maledesm/gpr/redaccion/tesis_gpr_fmcw.pdf

## [Universidad]

### [Facultad / Departamento]

### Ingeniería Electrónica / Telecomunicaciones

## Procesamiento de Señales para Radar de Penetración Terrestre (GPR)

### Trabajo Final de Grado

Autor: [Nombre del Autor]

Director: [Nombre del Director]

2025

# Índice general

1. Fundamentos Teóricos | 1
2. Señal IF y Frecuencia de Batido | 4
2.5.2. Predicción teórica de f

∗

3. Arquitectura del Sistema | 12

i

ii | Índice general
4. Banco de Pruebas | 15
5. Caracterización del VCO | 18
6. Generador de Triangular Analógico | 35

Índice general | iii
7. Filtro Pasabajos | 49
7.3. Comparación normalizada: separar el efecto de la ganancia del efecto de la

### 8. Cables de RF: Retardo Eléctrico, Pérdidas y Calibración de Distancia 52

9. Procesamiento de la Señal de Batido | 67

iv | Índice general

Índice general | v
A. Valores de componentes: series comerciales, tolerancias y combinaciones 90
B. La transformada chirp-Z (CZT) — trabajo futuro | 93

vi | Índice general

# Índice de figuras

3.1. Diagrama en bloques del GPR FMCW, versión de un solo canal (alcance
de esta tesis). El PCM1808 es estéreo, así que el camino de hardware para
un segundo canal en cuadratura (mezclador IQ) ya existe y queda como
ampliación posible, sin implementar | 13
3.2. Principio de funcionamiento del FMCW para un blanco estático, sin efecto Doppler (script docs/principio_fmcw.py). Los valores de τ , Tm y B usados en la figura son adimensionales y se eligieron para que el dibujo se
lea bien, no para representar las magnitudes reales del sistema: en el radar real, τ/Tm es del orden de 10⁻⁷ para un blanco a 1 m, y a esa escala la

señal recibida se superpondría visualmente por completo a la transmitida. . 14

4.1. Primer banco de la cadena de RF: VCO, amplificador, atenuador y splitter
interconectados sobre una plaqueta de prueba rotulada a mano | 15
4.2. Banco de mediciones: fuente DC, generador de funciones, cadena de RF y
notebook con el software de análisis | 16
4.3. Banco de mediciones, vista general del puesto de trabajo | 17
5.1. Curva de sintonía medida del VCO: frecuencia de salida en función de la tensión de control Vin (antes del mapeo a la tensión real de sintonía Vosc, más alta, que entrega el amplificador que ataca al VCO). El rango sombreado indica los 0–3,00 V que efectivamente se usan para generar la rampa del
radar | 18
5.2. Linealización del barrido del VCO mediante predistorsión (script VCO/analisis_vco.py). Arriba: curva de sintonía medida con ajuste PCHIP (izq.) y sensibilidad
dF/dV punto a punto sin suavizar (der.). Abajo: rampa de tensión del DAC
con y sin predistorsión (izq.) y frecuencia resultante en función del tiempo
normalizado, comparada con la recta ideal (der.) | 21

vii

viii | Índice de figuras
5.3. Salida del DAC MCP4725 (rampa de sintonía del VCO), con y sin predistorsión, a PRF de 50 ms y 5 ms. Se indica el desvío RMS de cada rampa
respecto de la recta ideal | 22
5.4. Pantalla del analizador de espectro (Siglent SSA3032X, Max Hold, 0,8 a
3 GHz, RBW 1 MHz) con el VCO barrido por la triangular. De ∼ 1 a
∼2 GHz está la fundamental, el barrido útil del radar. A partir de ∼2 GHz aparece el segundo armónico, unos 8 dB por debajo. Medición del 2026-11-02. 24
5.5. Las tres trazas exportadas del analizador. En azul, la captura más llena.
Se marcan la banda de la fundamental, la del segundo armónico y la franja
de 15 MHz en la que se superponen. Las líneas punteadas son los extremos
que predice la curva estática del VCO para la triangular medida con el
osciloscopio | 25
5.6. (a) Frecuencia instantánea de la fundamental y de los armónicos 2 y 3 a lo largo de un período de la triangular, con la banda medida en Max Hold.
Es esquemática (barrido dibujado lineal entre los extremos medidos). En trazo grueso, el tramo cercano a los vértices de abajo donde el segundo armónico cae dentro de la banda útil. (b) Lo que llega a banda base para
la placa a 1 m: el batido y sus fantasmas en 2fb y 3fb. Niveles estimados
con una simulación del radar completo (mezclador multiplicador, segundo
armónico del Max Hold, tercero supuesto a −15 dBc) | 29
6.1. Estructura del generador. El oscilador entrega una triangular de 3,06 Vpp centrada en la referencia de 6 V; el restador la baja al rango 0–3 V que pide el VCO; el zener D1 protege al VCO ante una falla y el buffer de sync reduce la cuadrada del comparador a un nivel que tolera el ESP32-C3. Todo
el circuito se alimenta de una única rama de 12 V | 37
6.2. Esquemático completo (GPRv2/docs/PWM/pcb/triangular.kicad_sch). Las cinco unidades usadas se reparten entre dos TLC2274: U1 lleva el oscilador
y el sync, U2 la referencia y el restador. Las tres unidades sobrantes (U1D,
U2C y U2D) quedan como seguidores con la entrada no inversora a masa. . 37
6.3. Salida y sincronismo del generador con el modelo real del TLC2272, en tres
posiciones del potenciómetro (script GPRv2/docs/PWM/simulacion/graficar_triangular3.py). Izquierda: la triangular de salida junto con la cuadrada de sync, con los niveles extremos indicados. Derecha: el espectro de dos lados de la salida
—cada raya es un armónico, y la del centro es la componente continua—
comparado con la envolvente 1/f ² que corresponde a los armónicos impares
de una triangular ideal | 42

Índice de figuras | ix
6.4. Efecto de cada zener sobre la operación normal (scripts GPRv2/docs/PWM/simulacion/simular_zener.py y graficar_zener.py). Izquierda: el vértice superior de la triangular sin
zener, con el 1N4729A y con el 1N4728A. Derecha: la curva de conducción
inversa de los dos modelos, con la corriente que toma cada uno al pico de
la triangular | 44
6.5. Falla simulada: R9 abierta. Sin zener la salida se va a 10,06 V, con lo que
el amplificador satura contra sus 20 V de alimentación y el VCO queda 2 V
por encima de su máximo. Con el 1N4729A la salida se clava en 3,31 V,
que corresponden a 16,4 V en el VCO | 45
6.6. Placa del generador, 93 × 63 mm, una sola capa. Las dos vistas están en la misma orientación, mirando desde el lado de los componentes. En el cobre,
el negro es cobre y el blanco es el aislamiento: casi toda la superficie libre
es plano de masa | 46
6.7. Vista tridimensional de la placa (kicad-cli pcb render). Faltan los modelos 3D de la llave de encendido SW1 y del puente de cable JP1, cuyas huellas se dibujaron para este proyecto; el resto de los componentes se
muestra completo | 46
7.1. Respuesta en frecuencia del filtro activo, barrido senoidal con Vin = 3,11 Vpp,
en las dos posiciones del potenciómetro de ganancia. Arriba: respuesta absoluta, con las frecuencias de corte indicadas; el trazo se vuelve punteado
a partir de la zona con distorsión. Abajo: diferencia entre ambas curvas
normalizadas a su propia banda de paso | 50
8.1. Los dos caminos que llegan al mezclador. El del LO es corto y fijo —en este banco, una conexión directa de ≈ 5 cm—; el de RF incluye los cables
a las antenas más el trayecto por el aire. El mezclador solo puede medir la diferencia de retardo entre ambos, no el retardo absoluto de ninguno. . . . 53
8.2. Pérdida de inserción medida con el VNA. Izquierda: pérdida total |S21| tal como se mide, cable más sus dos conectores; el rizado fino es la interferencia entre los dos conectores. Derecha: atenuación por metro ajustada como a

√
f
por el origen, con los valores de catálogo superpuestos en punteado. Los
dos RG-213 y el RG-58 de 3 m caen sobre sus referencias de catálogo; el RG-58 de 2,6 m queda al doble y, a la izquierda, se curva hacia abajo en
vez de seguir la raíz | 59

x | Índice de figuras
8.3. Pérdida de retorno. Izquierda: |S11| en todo el barrido, con la escala de VSWR equivalente a la derecha y la banda del radar sombreada. Derecha: zoom de 1400 a 1600 MHz. El rizado no es ruido: es la interferencia entre
las reflexiones de los dos conectores, y su período vale ∆f = 1/(2τ ), con τ
el retardo medido de la fase. A cable más largo, rizado más apretado. . . . 60
8.4. Izquierda: respuesta al impulso de S11 complejo, en dB respecto del pico mayor. Cada pico es una reflexión, ubicada en su tiempo de ida y vuelta;
el triángulo marca 2τ tomado de la pendiente de fase de S21, y coincide con el eco del extremo en los cuatro cables. El RG-58 de 2,6 m (naranja) muestra además un pico a mitad de camino, en 12,6 ns. Derecha: retardo
de una vía contra el largo nominal. Los símbolos llenos son la pendiente de fase y los huecos, el rizado de |S11|; la recta es el VF 0,66 de catálogo. . . . 61
8.5. Lo que el cableado le cuesta al radar. Izquierda: offset de distancia doffset =
D/(2 VF) con el VF 0,66 de catálogo, según el coaxil neto D, con los dos juegos de cables marcados. Derecha: pérdida de un par de cables (TX más
RX) en el centro de la banda, 1462 MHz, en función del largo de cada uno,
con la atenuación por metro medida en cada cable. La recta del RG-58 de
2,6 m es la del cable dañado (Sección 8.6.5), no la de un RG-58 | 63
9.1. Cadena de procesamiento completa. En naranja lo que corre en la placa; en azul lo que corre en la PC. A la derecha de cada bloque, la sección donde
se describe | 69
9.2. Diezmado ×8 en tres etapas de semibanda. Cada etapa elimina todo lo que
se plegaría en la división por dos siguiente | 71
9.3. Sincronismo reconstruido. Los puntos son las lecturas de la triangular (sólo
∼ 19 por período); el triángulo continuo es el modelo ajustado, del que salen
los límites de rampa. Cada rampa de batido de 300 muestras se procesa
por separado, y las bajadas se invierten en el tiempo | 75
9.4. Coherente contra incoherente, en un bin con blanco (arriba) y en un bin
de ruido (abajo). En azul la señal de cada rampa; en rojo el ruido. En el promedio coherente el ruido se cancela parcialmente y el piso baja; en el incoherente las magnitudes son siempre positivas y el piso queda donde
estaba | 81
9.5. Espectro de una fila de N = 8 rampas con un blanco débil en 498 Hz (SNR
de −12 dB por muestra en cada rampa), según el criterio de promedio. La línea roja es el piso medio. Una realización; los valores de los títulos varían
entre corridas | 82

Índice de figuras | xi
9.6. Piso de ruido en función de la cantidad de rampas promediadas, sobre
300 realizaciones de ruido puro. Izquierda: nivel medio, referido al de una
rampa. Derecha: desvío del piso en dB a lo largo del espectro | 83
9.7. Formación de las filas del radargrama a partir de los perfiles de cada rampa.
En azul las subidas, en verde las bajadas invertidas; cada fila mezcla las dos. 84
9.8. Captura de vivo_rapido.py con una placa metálica a 90 cm, fondo conge-
lado, N = 8 rampas por fila (28/09/2026) | 88

# Índice de cuadros

1.1. Parámetros principales del sistema FMCW GPR (valores de referencia to-
mados de Huang2022) | | 2
1.2. Permitividad relativa de materiales constructivos típicos | | 3
2.1. Frecuencia de batido teórica f

∗
en aire libre (B = 1 GHz) para tres períodos de triangular. Recordar que Tc es el período completo: cada rampa dura
Tc/2 | 9
5.1. Caracterización medida del VCO: tensión de entrada Vin y frecuencia de
salida, 34 puntos cada 100 mV | 19
5.2. Predistorsión de la rampa contra remuestreo de la señal | 23
5.3. Lo medido en la salida del VCO en Max Hold (2026-11-02) | 25
5.4. Atenuación mínima del filtro en 2f, según la ecuación (5.13), con H2 =
−8 dBc | 32
5.5. Lo que se cuela por el borde de la rampa, según la frecuencia fs en la que
el filtro alcanza su atenuación. Banda medida, 988 a 1991 MHz. La cuarta
y la quinta columna son el nivel de esa parte del fantasma respecto del pico
del blanco | 33
6.1. Período en función de la posición del potenciómetro: la ecuación (6.2) contra la simulación del circuito completo con el modelo real del operacional. . 38
6.2. Candidatos considerados para los cinco operacionales | 40
6.3. Densidad de ruido de tensión de entrada de los modelos SPICE, en nV/

√
Hz,
comparada con el ruido térmico de las resistencias del lazo | 40
6.4. Períodos, niveles y contenido armónico simulados, en las tres posiciones del
potenciómetro | 43

xii

Índice de cuadros | xiii
7.1. Parámetros medidos del filtro activo en las dos posiciones del potenciómetro de ganancia (banda de paso: mediana entre 200 y 1750 Hz, puntos sin
distorsión) | 50
8.1. Factor de velocidad nominal según el dieléctrico del cable coaxil (valores de catálogo típicos). Los medidos en los cables del banco están en la Tabla 8.5. 54
8.2. Frecuencia de batido esperada para un blanco a d = 1 m, con y sin el aporte de los cables originales (D = 5,55 m, VF = 0,66). doffset = 4,20 m es constante; lo que cambia con Tc es a cuántos Hz equivale. La fila de 100 ms
es el Tc con el que mide el banco: 50 ms de subida y 50 de bajada | 55
8.3. Offset de distancia esperado con los cables nuevos (LTX = LRX = 1 m,
VF = 0,66 nominal) según la longitud que se elija para el cable al LO. . . . 57
8.4. Atenuación medida y de catálogo en la banda del radar. Los dos RG-213 difieren entre sí un 8 % y quedan a menos de un 15 % del catálogo con los conectores incluidos. El cable de 2,6 m atenúa el doble que su gemelo de
3 m, siendo el mismo tipo de cable | 59
8.5. Retardo medido de la pendiente de fase de S21. Las columnas de L y VF son
dos lecturas del mismo dato: fijando el VF de catálogo se despeja el largo eléctrico, y fijando el largo nominal se despeja el VF. La última columna
es el desvío rms de la fase respecto de un retardo puro | 61
8.6. Resumen comparativo entre el valor teórico (predicho por las ecuaciones
de este capítulo, a partir de las longitudes nominales y el VF de catálogo)
y el valor medido con el VNA a partir de la fase de S21, para ambos juegos
de cables | 64
9.1. Parámetros de la cadena de procesamiento en el banco de laboratorio (generador con Tc = 100 ms). Los valores medidos salen del encabezado de la
captura de la placa a 90 cm del 28/09/2026 | 68
9.2. Atenuación de los tonos que se pliegan sobre cada frecuencia de la salida,
a 48 kHz con M = 8 | 71
9.3. Etapas del procesamiento, con su ecuación y su implementación | 89

A.1. Rango que puede cubrir la salida del generador según la tolerancia de los resistores. El Monte Carlo (200 000 muestras, distribución uniforme dentro
de la banda) es lo que cabe esperar al armar placas; el peor caso recorre
las 2

12 esquinas y es la cota que no se puede superar. El valor nominal es

0,030 a 3,094 V | 91

xiv | Índice de cuadros

A.2. Desplazamiento del extremo superior de la salida por un error del 1 % en
cada resistencia, de a una por vez | 91
A.3. Valores que no existen en la serie E12 y cómo se armaron | 92
B.1. Parámetros de la CZT y su cálculo desde fstart, fend y fs | 95
B.2. Cálculo de los parámetros CZT para el ejemplo de referencia | 96

B.3. Resolución CZT para distintos valores de M (rango de zoom de 12 Hz). . . 96

B.4. Resumen del flujo de procesamiento GPR FMCW con CZT, propuesto para
cuando se implemente | 97

# Capítulo 1

# Fundamentos Teóricos

## 1.1. Principios de operación del GPR

El GPR es un sistema de teledetección electromagnética que emite energía de radiofrecuencia hacia el subsuelo y registra las reflexiones producidas en las interfases entre materiales de distinta permitividad eléctrica εr. La profundidad de penetración y la resolución en rango dependen de la frecuencia central y el ancho de banda del sistema.

### 1.1.1. Configuraciones de operación

Los radares GPR pueden clasificarse según su forma de modulación:

GPR de impulso: emite pulsos muy cortos de banda ultra ancha (UWB). Resolución en rango determinada por el ancho del pulso.

SFCW (Stepped-Frequency Continuous-Wave): barre el espectro en pasos discretos de frecuencia.

FMCW (Frequency-Modulated Continuous-Wave): barre el espectro de forma continua y lineal (chirp).

## 1.2. Sistema FMCW: parámetros fundamentales

Un sistema FMCW emite una señal cuya frecuencia instantánea varía linealmente en el tiempo, denominada chirp. Los parámetros principales se resumen en la Tabla 1.1.

1

2 | Capítulo 1. Fundamentos Teóricos

Cuadro 1.1: Parámetros principales del sistema FMCW GPR (valores de referencia tomados de Huang2022).

Símbolo Nombre | Definición | Valor de ref.
Tc | Período del chirp | — | 0,3 s
B | Ancho de banda | fmax − fmin | 1 GHz
fc | Frecuencia central | (fmax + fmin)/2 | 1,5 GHz
S | Tasa de barrido | B/Tc (diente de sierra) 3,33 GHz/s
c | Velocidad de la luz | — | 3 × 10⁸ m/s
εr | Permitividad relativa — | Dep. del material

La frecuencia instantánea transmitida es:

ftx(t) = fc −

B
2
+ S t, | 0 ≤ t ≤ Tc. | (1.1)

Advertencia sobre la convención de S y Tc. La ecuación (1.1) y la Tabla 1.1 corresponden a un chirp de diente de sierra, que es la modulación del sistema de referencia Huang2022: la frecuencia recorre todo el ancho de banda B en el período completo Tc, y por lo tanto S = B/Tc.

El sistema desarrollado en esta tesis usa en cambio modulación triangular, y mantiene a Tc como el período completo de la triangular. Cada rampa dura entonces Tc/2 y la tasa de barrido es el doble: S = 2B/Tc (se deduce en la ecuación (2.2)). De acá en adelante rige esa convención, y todas las expresiones del Capítulo 2 están escritas con ella. Es la fuente de error más fácil al comparar contra la bibliografía: un factor 2 en la frecuencia de batido y en el espesor estimado.

## 1.3. Propagación en medios estratificados

La velocidad de propagación de la onda electromagnética en un medio con permitividad relativa εr es:

v =

c
√
εr
. | (1.2)

Para los materiales de mayor interés práctico se indican valores típicos de εr en la Tabla 1.2.

1.3. Propagación en medios estratificados | 3

Cuadro 1.2: Permitividad relativa de materiales constructivos típicos.

Material | εr

√εr

Aire | 1,0 | 1,000
Asfalto seco | 4 − 7 | 2,00 − 2,65
Asfalto húmedo | 6 − 9 | 2,45 − 3,00
Concreto | 8 − 12 2,83 − 3,46
Pared (cemento) | 5 − 6 | 2,24 − 2,45
Hielo | 3,2 | 1,79

# Capítulo 2

# Señal IF y Frecuencia de Batido

## 2.1. Señal transmitida y frecuencia instantánea

La señal transmitida es un coseno cuya fase instantánea ϕ(t) está determinada por la frecuencia instantánea f(t):

stx(t) = A cos
ϕ(t)
, ϕ(t) = 2π

Z t

0

f(t

′

) dt′
. | (2.1)

En el radar FMCW con modulación triangular, la frecuencia instantánea varía linealmente en forma de diente triangular: asciende de fc − B/2 a fc + B/2 durante el primer semiperíodo Tc/2, y desciende simétricamente durante el segundo. La tasa de barrido (en módulo) es la misma en ambas ramas:

S =

B
Tc/2

=

2B
Tc
. | (2.2)

La frecuencia instantánea es, por tanto:

f(t) =

fc −

B
2
+ S t, | 0 ≤ t ≤

Tc
2

,

fc +

B
2

− S

t −

Tc
2
,
| Tc
| 2 < t ≤ Tc.

(2.3)

Dado que las dos ramas son simétricas y producen la misma frecuencia de batido (véase la Sección 2.4), el desarrollo analítico se realiza sobre la rampa ascendente (0 ≤ t ≤ Tc/2); los resultados son directamente aplicables a la rampa descendente por simetría.

Sustituyendo la rama ascendente de (2.3) en (2.1):

4

2.2. Señal recibida | 5

ϕ(t) = 2π

Z t

0

fc −

B
2

+ S t′

dt′ = 2π

fc −

B
2
t +

S
2

t

2

. | (2.4)

La señal transmitida durante la rampa ascendente es, entonces:

stx(t) = A cos
2π

fc −

B
2
t +

B
Tc

t

2

, 0 ≤ t ≤

Tc
2
. | (2.5)

Esta expresión muestra que la señal es un chirp lineal que parte de la frecuencia fc − B/2 y llega a fc + B/2 al cabo del semiperíodo.

## 2.2. Señal recibida

Un obstáculo ubicado a distancia d del radar produce una señal reflejada con retardo τd = 2d/c, donde c es la velocidad de propagación en el medio. Durante la rampa ascendente, la señal recibida es una réplica de (2.5) retrasada τd segundos. Definiendo τd ≪ Tc/2 (condición habitualmente satisfecha en GPR), la señal recibida válida en el intervalo τd ≤ t ≤ Tc/2 es:

Γ(t) = A

′

cos
2π

fc −

B
2

(t − τd) + B
Tc

(t − τd)

2

− θ
, | (2.6)

donde A′ absorbe la atenuación de propagación y θ una fase inicial arbitraria. La señal (2.6)

es estructuralmente idéntica a stx(t), pero con el argumento temporal desplazado por τd = 2d/c.

## 2.3. Proceso de desrampa (dechirp / mixing)

Al multiplicar stx(t) (ec. (2.5)) por Γ(t) (ec. (2.6)) y aplicar un filtro pasa-bajos, se obtiene la señal IF o señal de batido. Usando la identidad trigonométrica:

cos x · cos y =

1/2 h
cos(x − y) + cos(x + y)

i
, | (2.7)

el producto stx(t) · Γ(t) genera dos términos: uno de diferencia de fases (baja frecuencia, conservado por el filtro pasa-bajos) y uno de suma (alta frecuencia, eliminado). Definiendo τd = 2d/c por brevedad, las fases instantáneas son:

6 | Capítulo 2. Señal IF y Frecuencia de Batido

ψtx(t) = 2π

## hfc −

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
, | (2.8)

ψrx(t) = 2π

## hfc −

B
2
(t − τd) + B
Tc

(t − τd)

2

i
− θ. | (2.9)

El término de diferencia, tras el filtrado pasa-bajos, es:

x

′
(t) = A

∗

cosh
ψtx(t) − ψrx(t)

i
. | (2.10)

Calculando la diferencia de fases:

ψtx − ψrx = 2π

fc −

B
2
τd +

2πB
Tc

h
t

2 − (t − τd)

2

i
+ θ. | (2.11)

Desarrollando el binomio (t − τd)

2 = t

2 − 2τdt + τ

2
d

:

t

2 − (t − τd)

2 = 2τd t − τ

2
d
, | (2.12)

con lo que:

ψtx − ψrx = 2π

fc −

B
2
τd +

2B
Tc

τd t −

B
Tc

τ

2
d
+ θ. | (2.13)

La señal IF resultante es, por tanto:

x

′
(t) = A

∗

cos
2π

2B
Tc

τd t + 2π

fc −

B
2
τd −

2πB
Tc

τ

2
d − θ
, τd ≤ t ≤

Tc
2

. (2.14)

## 2.4. Frecuencia de batido

Identificando en (2.14) el coeficiente lineal en t, la frecuencia de batido de la rampa ascendente es:

f

+
b =

2B
Tc

τd =

2B
Tc

·

2d
c

=

4Bd
c Tc
. | (2.15)

Los términos restantes de (2.14) son puramente de fase (constantes respecto de t); agrupándolos en φ

∗
:

2.5. Prueba de validación con reflector metálico | 7

φ

∗ = 2π

fc −

B
2
τd −

2πB
Tc

τ

2
d + θ, | (2.16)

la señal IF adopta la forma compacta de tono sinusoidal puro:

x

′
(t) = A

∗

cos
2πf ⁺
b

t + φ

∗

, τd ≤ t ≤

Tc
2
. | (2.17)

### Rampa descendente: simetría del resultado

Durante la rampa descendente la tasa de barrido es −S = −2B/Tc. Repitiendo el mismo desarrollo con f(t) = fc + B/2−S(t−Tc/2) se obtiene una frecuencia de batido f

−
b = f

+
b
(el signo de S cancela con el cambio de signo del retardo relativo). En consecuencia, ambas ramas producen la misma frecuencia de batido en módulo:

f

∗ = f
+
b = f

−
b =

4Bd
c Tc
. | (2.18)

Cada semiperíodo puede procesarse de forma independiente con la FFT, y los espectros resultantes son equivalentes. En la práctica se puede promediar la magnitud de ambos para mejorar la relación señal a ruido. El signo negativo del coeficiente lineal en la rampa descendente no altera la frecuencia observable: para una señal real, cos(−2πf0t) y cos(2πf0t) producen el mismo pico espectral en |f0|. La diferencia de signo se absorbe en la fase inicial y no afecta la estimación de distancia.

## 2.5. Prueba de validación con reflector metálico

Antes de abordar escenarios con múltiples capas y materiales de permitividad desconocida, resulta conveniente realizar una prueba de validación en condiciones controladas. El caso más simple consiste en apuntar el radar a una plancha metálica plana ubicada a una distancia d conocida en aire libre.

### 2.5.1. Por qué es un caso ideal

Un metal conductor actúa como un reflector casi perfecto: su coeficiente de reflexión en módulo es |Γ| ≈ 1. Esto implica tres ventajas para la validación:

1. Reflexión única. Solo existe una interfase (aire–metal), por lo que la señal IF contiene una única frecuencia de batido f

∗
, sin ambigüedad.

8 | Capítulo 2. Señal IF y Frecuencia de Batido
2. Sin incertidumbre en εr. La propagación ocurre íntegramente en aire (εr = 1,
| cmedio = c), eliminando una variable desconocida.
3. Resultado verificable a priori. Conocida d, el valor teórico de f

∗
se puede
calcular antes de la medición y comparar directamente con el pico observado en el espectro.

### 2.5.2. Predicción teórica de f

∗

En aire libre (εr = 1), la ecuación (2.18) se simplifica a:

f

∗ =

4Bd
c Tc
, | (2.19)

e inversamente, la distancia estimada a partir de la frecuencia medida ˆf
∗
es:

ˆd =

c Tc

ˆf
∗
4B
. | (2.20)

El error absoluto de distancia queda:

∆d =

ˆd − d

. | (2.21)

### 2.5.3. Parámetros del sistema y frecuencias esperadas

El sistema opera con B = 1 GHz (barrido de 1 GHz a 2 GHz). El período de la triangular Tc, en cambio, no es un valor fijo del sistema: es un parámetro de la medición, que se ajusta según la profundidad de interés y las condiciones del ensayo, y que el firmware configura por consola. La constante del radar es, por lo tanto, función de Tc:

f

∗
d

=

4B
c Tc

=

4 × 10⁹
3 × 10⁸ Tc

=

13,3
Tc
[Hz/m], | Tc en segundos. | (2.22)

La Tabla 2.1 evalúa esa constante para tres valores representativos de Tc y para distancias típicas de un banco de prueba en interiores.

2.5. Prueba de validación con reflector metálico | 9

Cuadro 2.1: Frecuencia de batido teórica f

∗
en aire libre (B = 1 GHz) para tres períodos de triangular. Recordar que Tc es el período completo: cada rampa dura Tc/2.

f

∗
[Hz]

d [m] Tc = 10 ms Tc = 50 ms Tc = 300 ms

0,10 | 133 | 27 | 4,4
0,20 | 267 | 53 | 8,9
0,50 | 667 | 133 | 22,2
1,00 | 1333 | 267 | 44,4

Dos condiciones acotan la elección de Tc, una por arriba y otra por abajo:

Barridos lentos (Tc grande). La señal de batido tiene que quedar por encima del pasa-altos no desactivable del ADC PCM1808, cuyo corte combinado es de ≈ 1,2 Hz. Ya con Tc = 300 ms un blanco a 0,10 m cae en 4,4 Hz, sobre el faldón del filtro; con barridos de segundos el blanco cercano se pierde adentro del filtro y su fase queda distorsionada.

Barridos rápidos (Tc chico). Hace falta fs > 2f

∗
(Nyquist). Con Tc = 10 ms
y fs = 48 kHz el alcance máximo sin aliasing es de 18 m. Pero la señal no sale a 48 kHz: se diezma a 6000 sps, con banda limpia hasta 2400 Hz (Sección 9.2). A Tc = 10 ms eso son apenas 1,7 m aparentes, menos que el offset de los propios cables (Capítulo 8). Además, el sincronismo por software, que se reconstruye leyendo la triangular, no funciona por debajo de Tc ≈ 12 ms (Sección 9.3). Por eso el banco trabaja con Tc = 100 ms.

### 2.5.4. Procedimiento experimental propuesto

1. Colocar la antena del radar frente a la plancha metálica, con separación d medida con cinta métrica.
2. Verificar que no haya otros objetos reflectores en el campo de visión del radar (paredes, mesas, superficies metálicas laterales) para evitar reflexiones espurias.
3. Adquirir la señal IF durante al menos un período completo de la triangular Tc, muestreando a fs > 2f

∗
4. Calcular f

∗
teo con la ecuación (2.19) usando la d medida.
5. Aplicar la FFT sobre las muestras adquiridas e identificar el pico de mayor amplitud.
6. Calcular ˆd con la ecuación (2.20) y obtener ∆d con la ecuación (2.21).

10 | Capítulo 2. Señal IF y Frecuencia de Batido

### 2.5.5. Criterio de éxito

La resolución en rango teórica del sistema, determinada por el ancho de banda, es:

δd =

c
2B

=

3 × 10⁸
2 × 10⁹
= 0,15 m. | (2.23)

La prueba se considera exitosa si:

∆d < δd = 15 cm. | (2.24)

Aplicado sobre la ˆd cruda, este criterio falla por varios metros en el banco: los cables

coaxiles suman un retardo constante que la ecuación (2.19) no contempla. El Capítulo 8 deduce ese término, lo mide y muestra cómo se calibra. El criterio se aplica sobre la distancia ya calibrada.

## 2.6. Las dos reflexiones y el espesor de capa

Para una capa de material con espesor h y permitividad εr, existen dos reflexiones:

R1: reflexión en la superficie superior → retardo τ1 → frecuencia IF f1 = S τ1.

R2: reflexión en la superficie inferior → retardo τ2 → frecuencia IF f2 = S τ2.

El tiempo extra que tarda la onda en atravesar la capa (ida y vuelta) es:

τextra =

2h

√
εr
c
. | (2.25)

Combinando con fIF = S τ y la tasa de barrido de la triangular, S = 2B/Tc (ec. (2.2)):

∆f = f2 − f1 =

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
4B h√
εr
Tc c
. | (2.26)

Despejando h:

h =

Tc ∆f · c
4

√
εr · B

(2.27)

2.6. Las dos reflexiones y el espesor de capa | 11

### 2.6.1. Ejemplo numérico

Para Tc = 0,3 s, B = 1 GHz, un asfalto húmedo (√ | εr = 2,449) y un valor ∆f = 4,00 Hz

(valor de ejemplo):

h =

0,3 × 4,0 × 3 × 10⁸
4 × 2,449 × 1 × 10⁹

≈ 36,7 mm.

### 2.6.2. Corrección por separación de antenas

Cuando las antenas Tx y Rx están separadas una distancia D, la corrección geométrica es:

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
, | (2.28)

donde L es la distancia total dentro del material calculada con la ecuación (2.27). Si D = 0 se recupera h = L/2.

# Capítulo 3

# Arquitectura del Sistema

Antes de describir el banco de pruebas físico (Capítulo 4), se presenta la arquitectura completa del sistema implementado y se repasa, sobre un caso concreto de blanco estático, cómo los principios expuestos en el Capítulo 2 se traducen en la señal que efectivamente entrega el mezclador.

## 3.1. Diagrama en bloques

La Figura 3.1 resume la cadena completa, de un solo canal, que es el alcance de esta tesis.

La rampa de sintonía es una triangular de 0 a 3 V generada fuera del microcontrolador: hoy, un generador de funciones de laboratorio (Siglent SDG830); más adelante, la placa del generador analógico del Capítulo 6. En una primera versión la rampa la generaba el propio ESP32-C3 con un DAC MCP4725 por I²C, con una tabla de predistorsión para linearizar el VCO (Secciones 5.3 y 5.4). Esa solución se abandonó. La no linealidad del VCO se corrige ahora en el procesamiento (Sección 9.5).

El ESP32-C3 digitaliza la señal de batido por I²S, desde el PCM1808, y además lee la triangular por una entrada analógica (GPIO3, a través de un divisor ÷2). Con esas lecturas la PC reconstruye por software el sincronismo entre el barrido y el muestreo: el período y la fase de la triangular, y con ellos dónde empieza cada rampa (Sección 9.3). No hace falta una señal de sincronismo del generador.

En la rama de transmisión, la triangular se amplifica, sintoniza el VCO (banda 1–2 GHz), se atenúa 3 dB y se divide en un splitter: una salida excita la antena transmisora y la otra actúa como oscilador local (LO) del mezclador. En la rama de recepción, el eco captado por la antena receptora se amplifica con un LNA y se mezcla con el LO. El mezclador entrega, además de la señal de batido fbeat buscada, un término de suma en torno a 2fc

12

3.2. Principio de funcionamiento: FMCW sin efecto Doppler | 13

(varios GHz); el pasa-bajos que sigue rechaza ese término de suma¹ y la señal resultante

se digitaliza en el PCM1808.

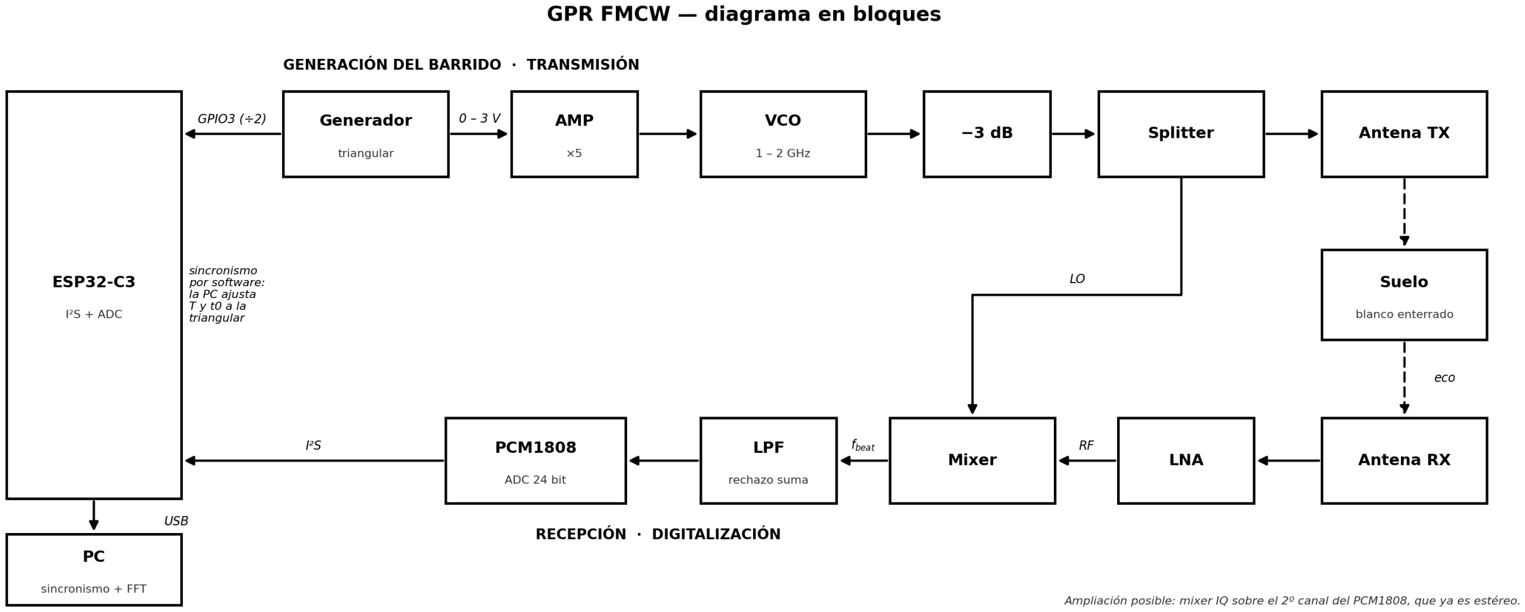
[picture p13: figure]

Figura 3.1: Diagrama en bloques del GPR FMCW, versión de un solo canal (alcance de esta tesis). El PCM1808 es estéreo, así que el camino de hardware para un segundo canal en cuadratura (mezclador IQ) ya existe y queda como ampliación posible, sin implementar.

## 3.2. Principio de funcionamiento: FMCW sin efecto

## Doppler

El GPR no se desplaza respecto del suelo durante una medición, por lo que, a diferencia del radar automotriz, no hay efecto Doppler que desplace en frecuencia la señal recibida. Como se estableció en la Sección 2.4, esto tiene una consecuencia directa: las ramas ascendente y descendente de la triangular producen la misma frecuencia de batido, así que una sola rampa alcanza para estimar distancia (no hace falta la asimetría subida/bajada que en radar automotriz se usa para despejar velocidad).

La Figura 3.2 ilustra este principio en tres paneles alineados en el tiempo: (a) la frecuencia instantánea transmitida y recibida, con el retardo τ y la frecuencia de batido fbeat marcados; (b) la diferencia de frecuencias entre ambas señales, mostrando que vale lo mismo en el tramo de subida que en el de bajada; y (c) la tensión a la salida del mezclador, que oscila a fbeat salvo en los vértices de la triangular, donde el retardo hace que ftx y frx crucen y la diferencia caiga momentáneamente a cero.

1No debe confundirse con el filtro antialiasing del muestreo: ese ya está resuelto internamente por

el PCM1808 (filtro analógico interno a 1,3 MHz más el sobremuestreo 64× de su modulador ∆Σ), ver docs/PCM1808_hardware.md.

14 | Capítulo 3. Arquitectura del Sistema


Figura 3.2: Principio de funcionamiento del FMCW para un blanco estático, sin efecto Doppler (script docs/principio_fmcw.py). Los valores de τ , Tm y B usados en la figura son adimensionales y se eligieron para que el dibujo se lea bien, no para representar las magnitudes reales del sistema: en el radar real, τ/Tm es del orden de 10⁻⁷ para un blanco a 1 m, y a esa escala la señal recibida se superpondría visualmente por completo a la transmitida.

# Capítulo 4

# Banco de Pruebas

## 4.1. Cadena de RF

La Figura 4.1 muestra la primera versión armada de la cadena de RF sobre una plaqueta de prueba, con los bloques rotulados a mano: VCO, amplificador, atenuador, splitter y la etapa de mezcla hacia la antena transmisora.


Figura 4.1: Primer banco de la cadena de RF: VCO, amplificador, atenuador y splitter interconectados sobre una plaqueta de prueba rotulada a mano.

15

16 | Capítulo 4. Banco de Pruebas

## 4.2. Banco de mediciones

Las Figuras 4.2 y 4.3 muestran el banco completo de mediciones: fuente DC, generador de funciones, la cadena de RF de la Figura 4.1 y la notebook corriendo el software de adquisición/análisis (el trazo verde es la señal capturada y el azul su espectro).

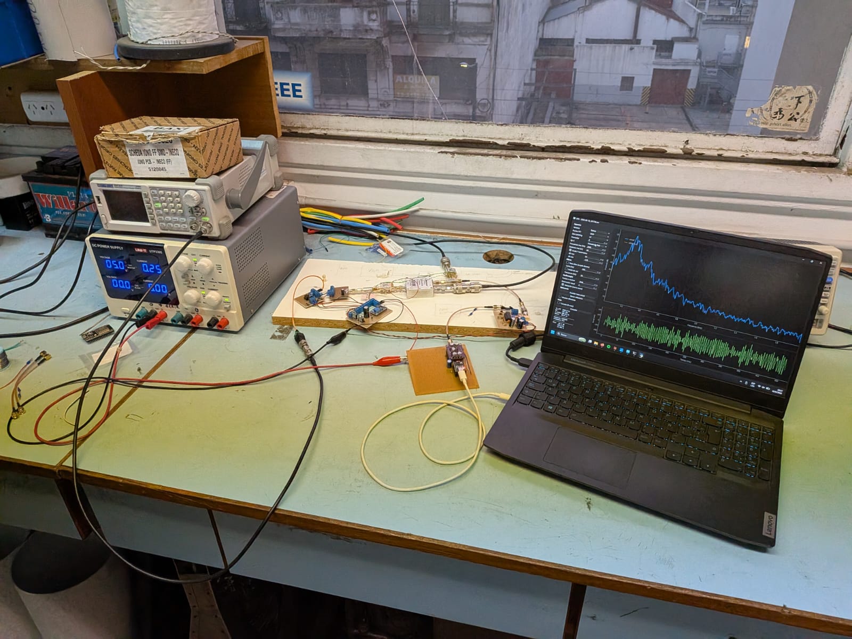
[picture p14: figure]

Figura 4.2: Banco de mediciones: fuente DC, generador de funciones, cadena de RF y notebook con el software de análisis.

4.2. Banco de mediciones | 17

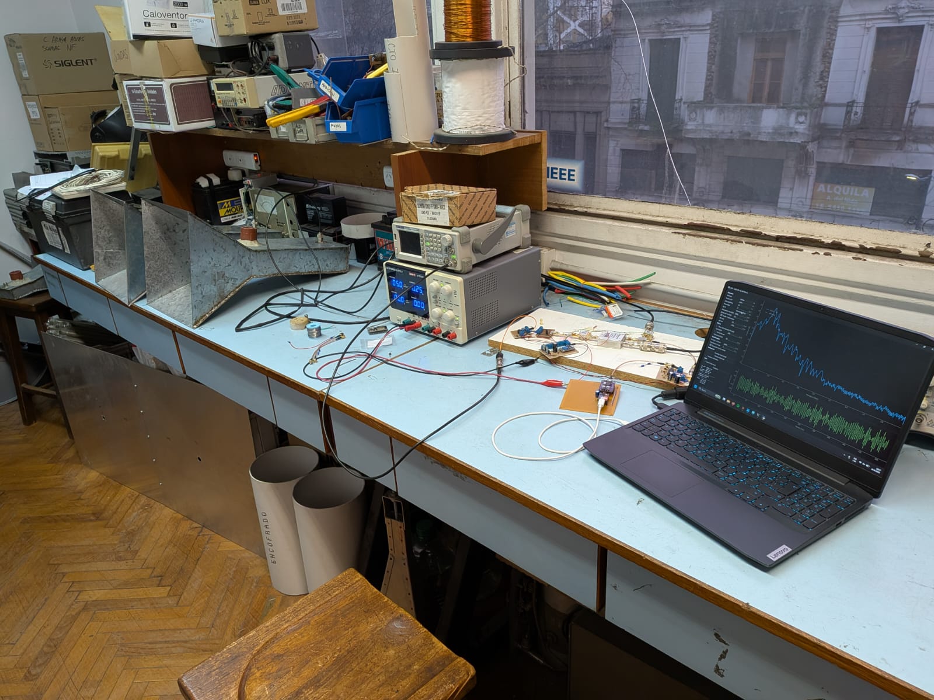
[picture p15: figure]

Figura 4.3: Banco de mediciones, vista general del puesto de trabajo.

# Capítulo 5

# Caracterización del VCO

## 5.1. Curva de sintonía del VCO

El VCO se caracterizó punto a punto, barriendo la tensión de control Vin de 0 a 3,321 V en pasos de 100 mV (34 puntos) y midiendo la frecuencia de salida con un analizador de espectro (precisión de 1 MHz). La Figura 5.1 muestra la curva resultante junto con la sensibilidad dF/dV .


Figura 5.1: Curva de sintonía medida del VCO: frecuencia de salida en función de la tensión de control Vin (antes del mapeo a la tensión real de sintonía Vosc, más alta, que entrega el amplificador que ataca al VCO). El rango sombreado indica los 0–3,00 V que efectivamente se usan para generar la rampa del radar.

En el rango medido completo (0,002 a 3,321 V) la frecuencia va de 943 a 2042 MHz. La

18

5.2. Tabla de valores medidos | 19

sensibilidad dF/dV no es constante: varía entre 167 y 468 MHz/V (relación 2,8 a 1 entre el extremo más y menos sensible), lo cual es la razón por la que una rampa de tensión lineal no produce una rampa de frecuencia lineal. Cómo se corrige se trata en la Sección 5.5.

Para no exceder el rango seguro de operación del VCO ni del amplificador, el rango de tensión que efectivamente se usa para generar la rampa del radar se acotó a Vin ∈ [0,00, 3,00] V, lo que corresponde a una banda de 943 a 1982 MHz (BW = 1039 MHz).

## 5.2. Tabla de valores medidos

La Tabla 5.1 lista los 34 puntos medidos.

Cuadro 5.1: Caracterización medida del VCO: tensión de entrada Vin y frecuencia de salida, 34 puntos cada 100 mV.

Vin [V] f [MHz] | Vin [V] f [MHz]
0,002 | 943 | 1,710 | 1609
0,101 | 987 | 1,811 | 1650
0,201 | 1028 | 1,912 | 1688
0,303 | 1066 | 2,018 | 1725
0,403 | 1102 | 2,120 | 1757
0,502 | 1138 | 2,222 | 1787
0,604 | 1175 | 2,325 | 1815
0,705 | 1215 | 2,426 | 1842
0,807 | 1259 | 2,528 | 1868
0,908 | 1299 | 2,628 | 1893
1,007 | 1335 | 2,730 | 1917
1,105 | 1373 | 2,828 | 1941
1,206 | 1409 | 2,926 | 1964
1,309 | 1448 | 3,024 | 1987
1,410 | 1487 | 3,123 | 2006
1,510 | 1526 | 3,221 | 2025
1,611 | 1569 | 3,321 | 2042

Para el último punto del barrido (Vin = 3,321 V) se midió una tensión de 16,490 V a la entrada del VCO (tras el amplificador que ataca al VCO), que se encuentra dentro del rango de funcionamiento del dispositivo (hasta 20 V).

20 | Capítulo 5. Caracterización del VCO

## 5.3. Primera solución: predistorsión con DAC (en desuso)

Esta sección y la siguiente documentan una solución que ya no se usa. En la primera versión del banco, el propio ESP32-C3 generaba la rampa de sintonía con un DAC MCP4725 por I²C, y la no linealidad del VCO se compensaba en esa rampa. El banco actual sintoniza el VCO con una triangular externa, lineal en tensión, y corrige la no linealidad en el procesamiento (Sección 5.5). Se conservan porque la inversión de la curva medida y su verificación siguen siendo válidas, y porque explican la elección de la solución actual.

Como se señaló en la Sección 5.1, la sensibilidad dF/dV del VCO no es constante. En un radar FMCW la frecuencia de batido es proporcional a dF/dt, de modo que si la rampa de tensión es lineal en el tiempo pero dF/dV no lo es, la frecuencia tampoco barre linealmente: el eco de un único blanco puntual queda repartido sobre todo el rango de pendientes en lugar de concentrarse en una única frecuencia de batido, y el pico de distancia se ensancha.

Para corregirlo se invierte la curva medida: en vez de recorrer la tensión linealmente, se recorre la frecuencia linealmente y se calcula, para cada instante, qué tensión hace falta. La inversión se hace ajustando la curva de 34 puntos (Tabla 5.1) con un interpolador PCHIP (Piecewise Cubic Hermite Interpolating Polynomial) tanto en el sentido V →F como en su inversa F →V ; se eligió PCHIP en lugar de un spline cúbico porque preserva la monotonía de los datos medidos sin generar oscilaciones entre puntos que no están respaldadas por una medición. La tabla resultante (1024 entradas, cuantizadas a los 12 bits del DAC MCP4725) se calcula una única vez de forma offline con el script VCO/analisis_vco.py y se vuelca al firmware como tabla_vco.h, de modo que el ESP32-C3 solo indexa la tabla en tiempo de ejecución sin necesidad de punto flotante.

La Figura 5.2 resume el procedimiento y su resultado: arriba a la izquierda, la curva medida con el ajuste PCHIP superpuesto y el rango efectivamente usado (0 a 3 V) sombreado; arriba a la derecha, la sensibilidad punto a punto dF/dV ; abajo a la izquierda, la rampa de tensión que efectivamente entrega el DAC con y sin predistorsión; abajo a la derecha, la frecuencia resultante en función del tiempo, comparada con la recta ideal.

5.3. Primera solución: predistorsión con DAC (en desuso) | 21

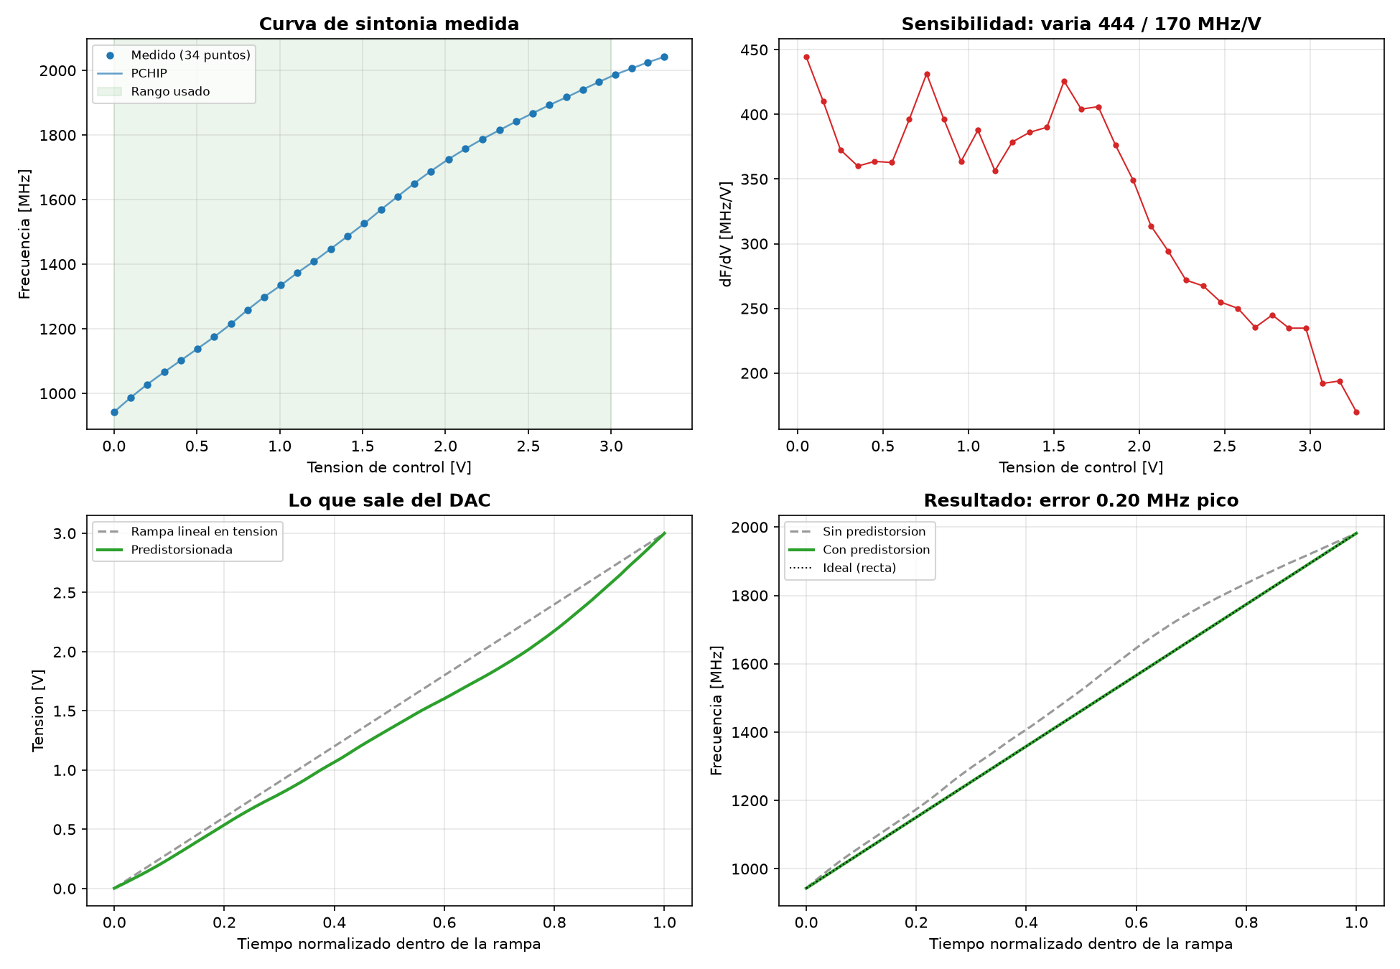
[picture p16: figure]

Figura 5.2: Linealización del barrido del VCO mediante predistorsión (script VCO/analisis_vco.py). Arriba: curva de sintonía medida con ajuste PCHIP (izq.) y sensibilidad dF/dV punto a punto sin suavizar (der.). Abajo: rampa de tensión del DAC con y sin predistorsión (izq.) y frecuencia resultante en función del tiempo normalizado, comparada con la recta ideal (der.).

Sobre el rango útil Vin ∈ [0,002, 3,000] V (943 a 1982 MHz, BW = 1039 MHz, consistente con la Sección 5.1), sin predistorsión la pendiente dF/dt varía entre 0,68 y 1,29 veces su valor medio: un blanco puntual a 1 m se desparramaría, por este efecto, entre aproximadamente 0,68 y 1,29 m. Con predistorsión, dF/dt queda acotado entre 0,991 y 1,010 veces el promedio (variación de apenas ±1 %), con un error de frecuencia residual de 0,20 MHz pico (0,08 MHz rms), equivalente al 0,020 % del ancho de banda. El escalón de tensión del DAC de 12 bits (3,300 V/4095 ≈ 0,806 mV) equivale típicamente a 0,27 MHz, valor que fija el piso de resolución de la tabla.

Nota sobre la sensibilidad graficada: el panel superior derecho de la Figura 5.2 usa la derivada cruda punto a punto (444 a 170 MHz/V), distinta de la sensibilidad ya reportada en la Sección 5.1 (167 a 468 MHz/V), que se calculó suavizando con un filtro Savitzky– Golay sobre la curva PCHIP (script VCO/grafico_vco.py). La derivada cruda arrastra la cuantización de la medición (frecuencia redondeada a 1 MHz, pasos de 100 mV) y por eso exagera el rango de sensibilidad; ambos cálculos coinciden en lo cualitativo (la sensibilidad varía fuertemente y no es constante), pero difieren en el valor puntual según el método de derivación utilizado.

22 | Capítulo 5. Caracterización del VCO

## 5.4. Rampa del DAC medida, con y sin predistorsión

## (en desuso)

Se capturó con el osciloscopio la salida real del DAC MCP4725 (la rampa de sintonía del VCO), con la predistorsión activada y desactivada, y a dos frecuencias de repetición de la rampa (PRF) de 50 ms y 5 ms. La Figura 5.3 muestra las cuatro capturas.

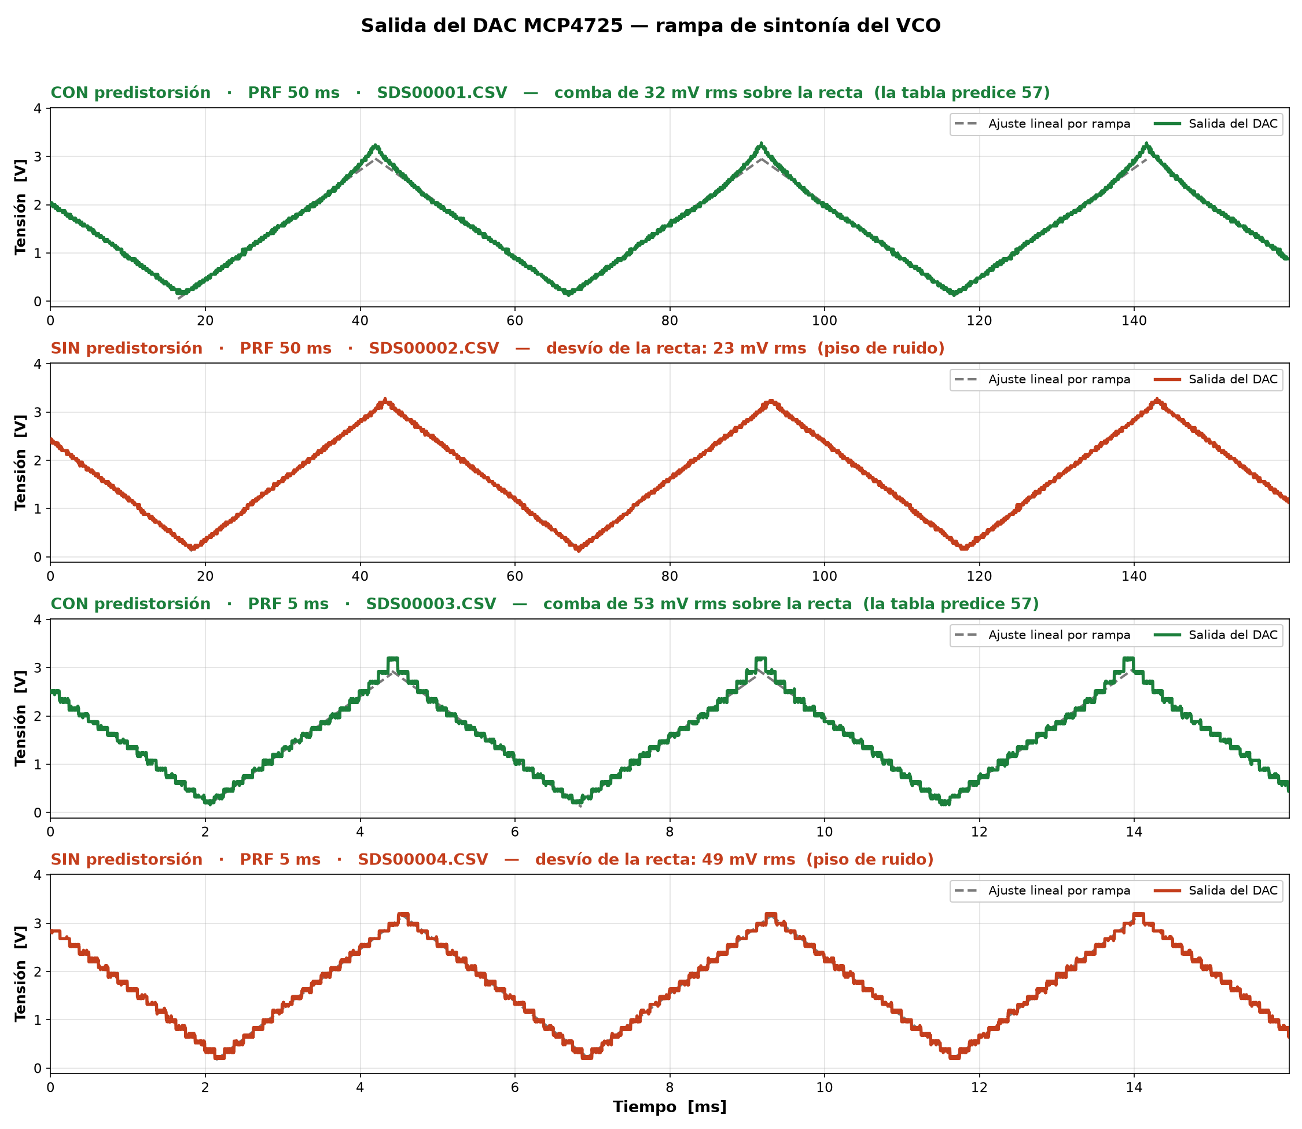
[picture p17: figure]

Figura 5.3: Salida del DAC MCP4725 (rampa de sintonía del VCO), con y sin predistorsión, a PRF de 50 ms y 5 ms. Se indica el desvío RMS de cada rampa respecto de la recta ideal.

Sin predistorsión, la rampa de tensión es lineal por construcción pero —dado que dF/dV no es constante— produce una rampa de frecuencia no lineal. Con predistorsión, la tabla invertida (tabla_vco.h, generada por VCO/analisis_vco.py) corrige esto, y la comba resultante sobre la rampa de tensión (los 32–53 mV rms medidos según la captura) es consistente con lo que predice la tabla (57 mV rms), dentro del ruido de cuantización del osciloscopio.

5.5. Solución actual: corrección en el procesamiento | 23

## 5.5. Solución actual: corrección en el procesamiento

Hay dos formas de que el eco de un blanco puntual caiga en una única frecuencia de batido a pesar de la curva del VCO:

1. Linealizar el barrido (predistorsión): deformar la rampa de tensión para que la frecuencia transmitida crezca linealmente con el tiempo. Es lo que hacía el DAC de las secciones anteriores.
2. Linealizar el muestreo (remuestreo): dejar que el barrido sea no lineal, con una rampa de tensión lineal, y tomar las muestras del batido a intervalos iguales de frecuencia en lugar de intervalos iguales de tiempo. Se hace en la PC, interpolando la señal digitalizada sobre la variable θ(t) =

f(t) − f(0)
/α0.

Las dos usan la misma curva medida de la Tabla 5.1, y en las dos el resultado es un tono puro de frecuencia α0τ (Sección 9.5). El banco actual usa la segunda. La Tabla 5.2 resume por qué.

Cuadro 5.2: Predistorsión de la rampa contra remuestreo de la señal.

Predistorsión (DAC) | Remuestreo en θ (actual)
Dónde se corrige | en el hardware, antes de
transmitir

en el software, después de digitalizar
Quién genera la
rampa

el ESP32-C3, escalón por
escalón por I²C

cualquier generador de
triangular
Resolución de la
rampa

escalones de 0,8 mV
(∼ 0,27 MHz) y tasa limitada por el bus

continua, sin escalones

Carga del
microcontrolador
genera la rampa y digitaliza | sólo digitaliza (y lee la triangular)

Cambiar la curva
del VCO

regenerar la tabla y reflashear cambiar el archivo de la curva en la PC

Supuesto
principal
la tabla invertida es exacta | la rampa de tensión es lineal y va de 0 a 3 V

El supuesto del remuestreo es una rampa de tensión lineal con el rango completo de 0 a 3 V. Si la triangular se recorta o no llega a los extremos, el mapa θ ya no corresponde al barrido real y las distancias salen escaladas. Por eso el programa de adquisición vigila en todo momento la fracción de lecturas de la triangular que tocan los rieles del ADC. Ese chequeo detectó una vez una resistencia suelta del divisor de GPIO3.

24 | Capítulo 5. Caracterización del VCO

## 5.6. Distorsión armónica del VCO

Todo lo anterior trata al VCO como una fuente de un solo tono cuya frecuencia sigue la curva F(V ). Un oscilador real no entrega una sinusoide pura: su salida trae además componentes en el doble, el triple, etc. de la frecuencia instantánea. Esta sección mide esos armónicos, desarrolla qué producen a la salida del mezclador y en qué frecuencia de batido aparecen, y de ahí saca los requisitos de un filtro de RF que los elimine antes de que lleguen al mezclador. El diseño de ese filtro queda para una sección posterior.

### 5.6.1. Medición con el analizador de espectro

Se observó la salida del VCO barrido por el generador de triangular propio (Capítulo 6, versión con LM324, Tc ≈ 100 ms) con un analizador de espectro Siglent SSA3032X, de 0,8 a 3 GHz, con RBW de 1 MHz, atenuador interno de 50 dB y la traza en Max Hold. La Figura 5.4 es la pantalla del analizador y la Figura 5.5, las trazas exportadas y procesadas.

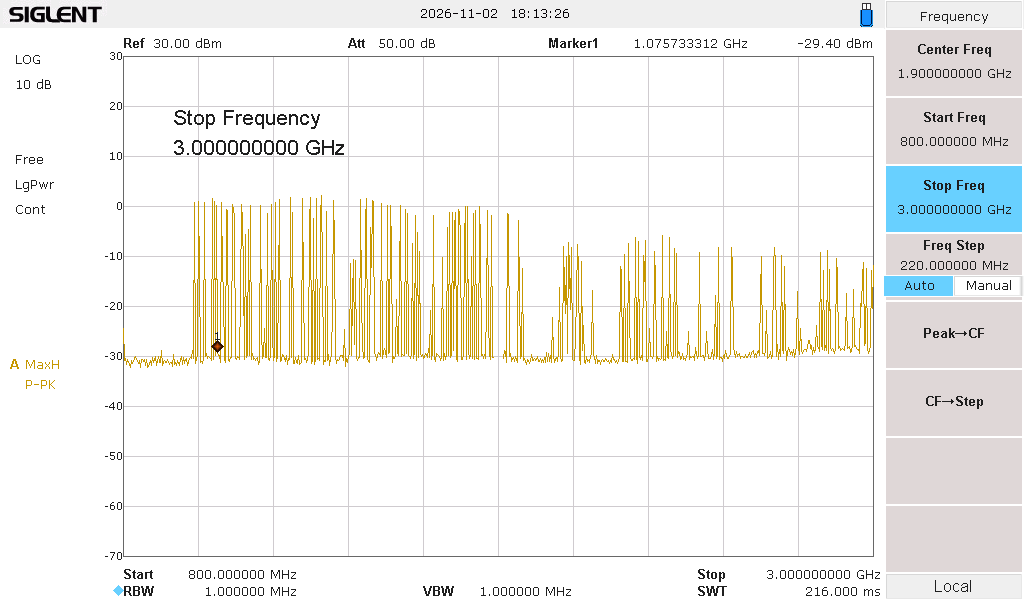
[picture p18: figure]

Figura 5.4: Pantalla del analizador de espectro (Siglent SSA3032X, Max Hold, 0,8 a 3 GHz, RBW 1 MHz) con el VCO barrido por la triangular. De ∼1 a ∼2 GHz está la fundamental, el barrido útil del radar. A partir de ∼2 GHz aparece el segundo armónico, unos 8 dB por debajo. Medición del 2026-11-02.

5.6. Distorsión armónica del VCO | 25

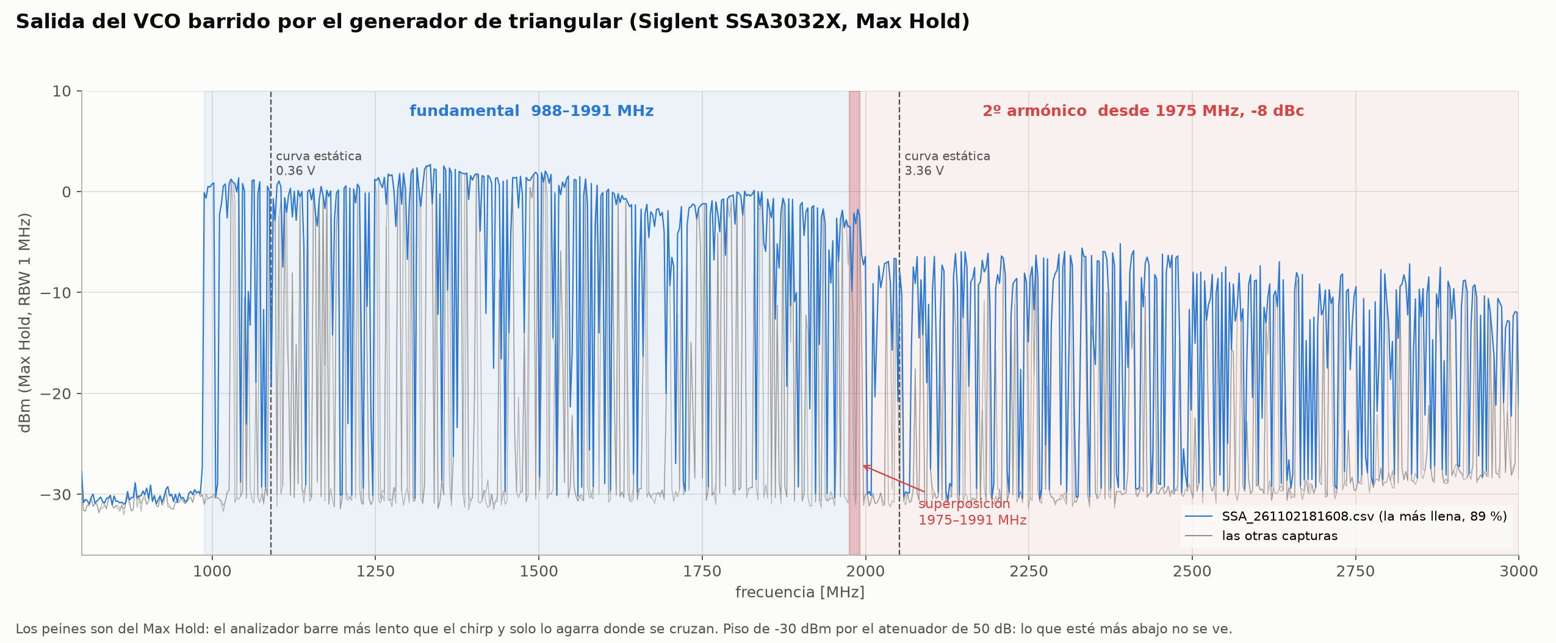
[picture p19: figure]

Figura 5.5: Las tres trazas exportadas del analizador. En azul, la captura más llena. Se marcan la banda de la fundamental, la del segundo armónico y la franja de 15 MHz en la que se superponen. Las líneas punteadas son los extremos que predice la curva estática del VCO para la triangular medida con el osciloscopio.

Cómo leer el Max Hold. El analizador barre 2,2 GHz en 216 ms y el VCO barre 1 GHz en 50 ms. En cada barrido el analizador encuentra al chirp sólo en los puntos donde los dos barridos se cruzan, y el Max Hold va acumulando esos cruces. Por eso la traza tiene forma de peine y se va llenando de a poco. Lo que muestra es la envolvente de todo lo que el VCO emitió a lo largo de muchos períodos, no lo que emite en un instante. Esto importa en la Sección 5.6.5.

Los resultados se resumen en la Tabla 5.3.

Cuadro 5.3: Lo medido en la salida del VCO en Max Hold (2026-11-02).

Fundamental | fmin = 988 a fmax = 1991 MHz en la captura más
| llena (1029 a 1991 en las otras dos), ∼0 a
| +2 dBm en pantalla
Segundo armónico | desde 2fmin = 1976 MHz, a −8/−9 dBc (−6 a
| −12 según la frecuencia)
Superposición | 2fmin < fmax por 15 MHz en la captura más llena;
| en las otras dos, 2fmin = 2058 MHz y no se
| superponen
Tercer armónico | 3f(t) va de 2,96 a 5,97 GHz: fuera del span, sin
| medir
Piso de la medición | −30 dBm (por el atenuador de 50 dB): lo que esté
| por debajo de ∼−32 dBc no se ve

La banda medida es más baja y más angosta que la que predice la curva estática para la triangular medida con el osciloscopio (0,36 a 3,36 V → 1089 a 2052 MHz). Arriba la frecuencia se planta en 1991 MHz, que en la curva estática corresponde a 3,02 V: lo más

26 | Capítulo 5. Caracterización del VCO

probable es que sature el amplificador que ataca al VCO. Esa diferencia no cambia el análisis que sigue, pero sí los números del filtro, que dependen de fmin y fmax.

### 5.6.2. La señal del VCO con armónicos

Con la fase instantánea ψ(t) = 2π

R t
0

f(u) du de la Sección 9.5, la salida del VCO se escribe como una suma de armónicos:

sVCO(t) = X

n≥1

an cos
n ψ(t) + βn
, | (5.1)

donde an es la amplitud del armónico n y βn una fase fija. Se define el nivel relativo de cada armónico respecto de la fundamental,

Hn = 20 log10

an
a1
[dBc], | (5.2)

que según la Tabla 5.3 vale H2 ≈ −8 dBc.

La frecuencia instantánea del armónico n es la derivada de su fase:

fn(t) = 1
2π

d
dt

h
n ψ(t)

i
= n f(t). | (5.3)

Cada armónico es otro chirp: arranca en nfmin, termina en nfmax y barre con una pendiente n veces mayor. Es decir, si en un instante el VCO está en una frecuencia f, en ese mismo instante emite también 2f, 3f, etc. Mientras la fundamental barre de ∼ 1 a ∼2 GHz:

el segundo armónico barre de ∼ 2 a ∼ 4 GHz (con la banda medida, de 1976 a 3982 MHz);

el tercer armónico barre de ∼3 a ∼6 GHz (de 2964 a 5973 MHz).

Por ejemplo, cuando la fundamental pasa por 1,5 GHz, el VCO emite a la vez 3 GHz y 4,5 GHz. La Figura 5.6a dibuja los tres chirps a lo largo de un período de la triangular.

Como el splitter divide la señal después del VCO, el LO y la antena transmisora llevan los mismos armónicos. El eco que vuelve de un blanco con retardo total τ (aire más cables, ecuación (8.1)) es
sRX(t) = X

n≥1

gn an cos
n ψ(t − τ ) + βn + γn
, | (5.4)

donde gn y γn son la ganancia y la fase de todo el camino de recepción (cables, bocinas, blanco, LNA) evaluados en la frecuencia del armónico n. No hay motivo para que gn sea

5.6. Distorsión armónica del VCO | 27

igual a g1: las bocinas, los cables y el LNA están pensados para la banda de 1 a 2 GHz, no para 2 a 6 GHz.

### 5.6.3. Qué sale del mezclador

Se modela el mezclador como un multiplicador ideal: su salida es el producto del LO por la señal de RF. Con (5.1) en el LO y (5.4) en RF, el producto es una doble suma: cada armónico m del LO se multiplica con cada armónico n del eco,

sLO(t) sRX(t) = X

m≥1

X

n≥1

am gn an
2
cos

m ψ(t) − n ψ(t − τ ) + . . .

+ cos

m ψ(t) + n ψ(t − τ ) + . . .

,

(5.5)

donde los puntos suspensivos agrupan las fases fijas βm, βn y γn. Para ver qué término llega a la señal digitalizada alcanza con mirar la frecuencia instantánea de cada uno. Usando f(t − τ ) ≈ f(t) − f

′
(t) τ (porque τ , decenas de nanosegundos, es despreciable frente a la escala en que cambia f):

Términos de suma. Frecuencia mf(t) + nf(t − τ ) ≈ (m + n)f(t): de 2 a varios GHz. Los elimina el pasabajos que sigue al mezclador (Capítulo 7), igual que el término de suma de la fundamental en la Sección 2.3.

Términos de diferencia con m ̸= n. Frecuencia

mf(t) − nf(t − τ ) ≈ (m − n) f(t) + n f ′
(t) τ. | (5.6)

Como f(t) ≥ fmin ≈ 1 GHz, esto vale al menos |m−n| ×1 GHz: también los elimina el pasabajos. Para que un término cruzado cayera en banda base haría falta que mf(t) ≈ nf(t − τ ), por ejemplo que la frecuencia del eco fuese el doble que la del LO. Con la banda medida eso exige un retardo de medio barrido (∼25 ms, miles de kilómetros): no ocurre.

Términos de diferencia con m = n. Acá la parte en f(t) se cancela y queda

n f(t) − n f(t − τ ) ≈ n f′
(t) τ. | (5.7)

Es n veces el batido de la fundamental. Cae en banda base, pasa el pasabajos y el PCM1808 lo digitaliza junto con la señal buscada.

La conclusión es que el único producto de los armónicos que llega a la señal digitalizada es el de cada armónico del LO con el mismo armónico del eco: el

28 | Capítulo 5. Caracterización del VCO

segundo con el segundo, el tercero con el tercero. Ninguna mezcla cruzada (la fundamental de uno con el armónico del otro) sobrevive.

### 5.6.4. Dónde cae: el fantasma en nfb

Con la notación de la Sección 9.5, la fase del término m = n es n veces la del batido de la fundamental, ecuación (9.16):

∆ψn(t) = n ψ(t) − n ψ(t − τ ) ≈ n · 2π τ f(t). | (5.8)

Al remuestrear en θ, con f(t) = f(0) + α0θ, queda

xn(θ) = a

2
n

gn
2

cos
2π n α0τ θ + φn
, | fb,n = n fb = n α0τ. | (5.9)

Tres consecuencias:

1. Frecuencia. Cada eco deja, además de su pico en fb, un pico en 2fb, otro en 3fb, etc. Como fb es proporcional al retardo total, el fantasma del armónico n es indistinguible de un blanco real con retardo nτ . En distancia, con el offset de los cables de la ecuación (8.4), un blanco en d deja un fantasma en
ˆdn = n (d + doffset) − doffset, | (5.10)

o sea, el offset de los cables también se multiplica por n.

2. Forma. El remuestreo en θ corrige al fantasma igual que a la fundamental: si la curva del VCO es la correcta, el fantasma es un tono puro y da un pico angosto. No se desparrama por la banda, sino que aparece como un blanco más. Si la curva tiene error, el error de fase del fantasma es n veces el de la fundamental y el pico se ensancha más.
3. Nivel. Respecto del batido de la fundamental, la amplitud del fantasma es (an/a1)

2
(gn/g1).
En dB:
Rn = 2Hn + ∆Gn, ∆Gn = 20 log10

gn
g1
. | (5.11)

El armónico cuenta dos veces, porque está en el LO y en el eco. Con H2 = −8 dBc el fantasma del segundo armónico queda en −16 dB + ∆G2.

Ejemplo numérico. En las mediciones de la placa del 2026-09-28 (Tc = 100 ms, 138,5 Hz/m), la placa a 1 m da su batido en fb ≈ 509 Hz, que corresponde a 3,68 m de distancia aparente

5.6. Distorsión armónica del VCO | 29

sin calibrar (1 m de aire más ∼2,7 m de cables, bocinas y retardo interno). Su fantasma del segundo armónico cae en 2fb ≈ 1018 Hz (7,35 m aparentes, o ∼4,7 m ya calibrado según la ecuación (5.10)), y el del tercero, en 3fb ≈ 1527 Hz. Los dos caen dentro de la banda que el firmware digitaliza limpia (0 a 2400 Hz, Sección 9.2). La Figura 5.6 resume las dos caras del problema: en (a), dónde están los armónicos en RF; en (b), dónde aparecen después del mezclador.

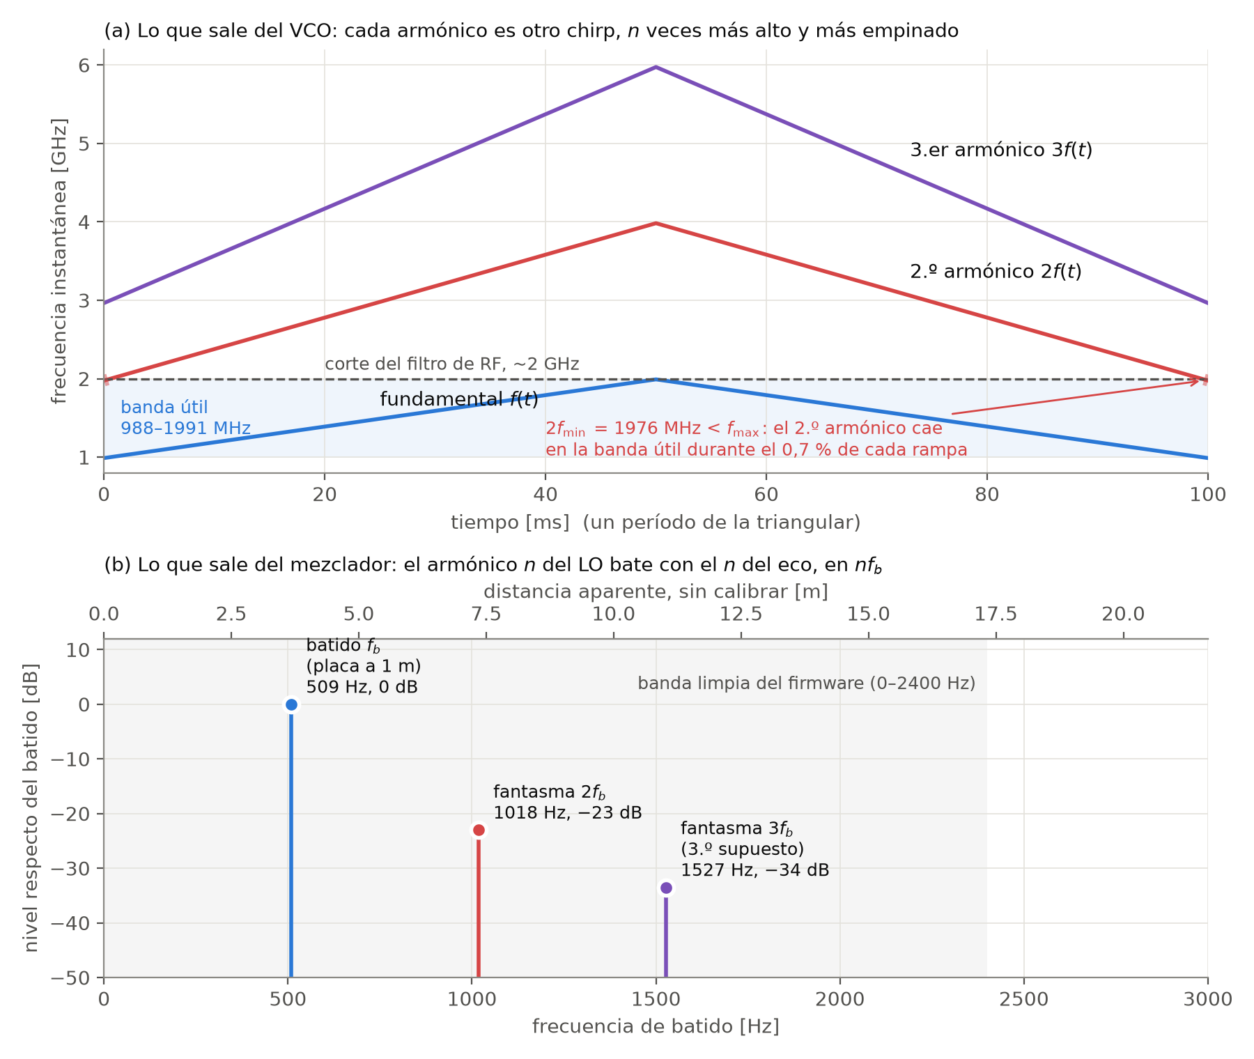
[picture p20: figure]

Figura 5.6: (a) Frecuencia instantánea de la fundamental y de los armónicos 2 y 3 a lo largo de un período de la triangular, con la banda medida en Max Hold. Es esquemática (barrido dibujado lineal entre los extremos medidos). En trazo grueso, el tramo cercano a los vértices de abajo donde el segundo armónico cae dentro de la banda útil. (b) Lo que llega a banda base para la placa a 1 m: el batido y sus fantasmas en 2fb y 3fb. Niveles estimados con una simulación del radar completo (mezclador multiplicador, segundo armónico del Max Hold, tercero supuesto a −15 dBc).

### 5.6.5. Que se superpongan en el espectro no es el problema

Mirando la Figura 5.4 es tentador pensar que el problema está en la franja de ∼ 2 GHz donde el segundo armónico “pisa” la fundamental. Pero el Max Hold muestra la envolvente

30 | Capítulo 5. Caracterización del VCO

de muchos períodos, no un instante. En la franja de superposición, el segundo armónico corresponde al vértice de abajo de la triangular (f(t) ≈ fmin, principio y final de cada rampa) y la fundamental, al vértice de arriba (f(t) ≈ fmax, mitad del período). Ocurren en instantes distintos, separados medio período, y por la Sección 5.6.3 su producto (m = 1, n = 2) no cae en banda base.

El fantasma existe aunque no haya ninguna superposición: aparece siempre que el LO y el eco lleven el mismo armónico. Bajar la banda para que 2fmin quede por encima de fmax no lo saca. Lo que la superposición sí determina es si un filtro puede separar la fundamental de su armónico (Sección 5.6.7).

### 5.6.6. Por qué no se puede corregir en banda base

El fantasma de un eco en fb cae en 2fb, que es justamente la frecuencia de un blanco real al doble de retardo. Un filtro en banda base no puede separarlos, porque están en la misma banda: quitar 2fb es quitar también los blancos que estén ahí. En un GPR esto es especialmente grave. El eco más fuerte suele ser el acoplamiento directo entre antenas o la reflexión en la superficie del suelo. Su fantasma aparece, 20 a 25 dB por debajo, como una interfase enterrada que no existe, y puede tapar o imitar un eco real a esa profundidad.

Restarlo por software es posible en principio, porque su posición se conoce (ecuación (5.10)). Su nivel y su fase, en cambio, dependen de gn y γn, que cambian con el blanco y con el armado. La salida limpia es que los armónicos no lleguen al mezclador: un filtro pasabajos de RF que corte a partir de ∼2 GHz.

### 5.6.7. Requisitos del filtro de RF

Dónde va. Antes del splitter, a la salida del VCO (o del amplificador de RF, si éste genera sus propios armónicos), de manera que el LO y la antena transmisora reciban la señal ya filtrada. Hay dos razones:

Su retardo se cancela. Un filtro cerca de su corte tiene un retardo de grupo τg(f) de varios nanosegundos que cambia con la frecuencia. Antes del splitter ese retardo es común a los dos caminos, y el mezclador sólo ve la diferencia: lo que sobrevive es 2π τg(f) f

′

(t) τ , del orden de 10⁻⁵
rad. Si el filtro estuviera sólo en el camino de transmisión, τg(f(t)) se sumaría al retardo de los cables, el retardo total variaría a lo largo del barrido y el pico se ensancharía.

Cuenta dos veces. Con el filtro antes del splitter, el armónico se atenúa en el LO

5.6. Distorsión armónica del VCO | 31

y en el eco. Si An es la atenuación del filtro en nf, la ecuación (5.11) pasa a

Rn = 2 (Hn − An) + ∆Gn. | (5.12)

Alcanza con que uno de los dos lados esté limpio. Por la Sección 5.6.3, el producto que molesta exige el armónico n en el LO y en el eco. Un mezclador conmutado genera internamente armónicos de su LO aunque el LO sea puro, pero éstos no tienen con qué batir en banda base si el eco no trae armónicos.

Cuánto tiene que atenuar. El punto de partida es el nivel del fantasma con el filtro puesto, que se acaba de escribir:

R2 = 2 (H2 − A2) + ∆G2.

Hay tres datos que entran en esa cuenta, y no todos tienen el mismo respaldo:

H2 = −8 dBc: el nivel del segundo armónico a la salida del VCO. Medido (Tabla 5.3).

∆G2: cuánto mejor o peor que a f pasa la señal a 2f por el camino de recepción (cables, bocinas, blanco, LNA). No está medido. Lo más pesimista es ∆G2 = 0, o sea que el camino trate a 2f igual que a f. Una simulación del radar completo da ∆G2 ≈ −7 dB, pendiente de verificar.

Robj: hasta dónde se quiere bajar el fantasma. Es una elección, no un dato. Se usan dos referencias: el piso de ruido de las capturas actuales, ∼ −45 dB respecto del pico (más abajo el fantasma ya no se distingue del ruido), y −60 dB, un margen pensado para cuando el eco más fuerte sea la superficie del suelo y haya que ver ecos enterrados mucho más débiles.

Sin filtro (A2 = 0), el fantasma queda en R2 = 2(−8) + ∆G2 = −16 dB + ∆G2. Lo que falta para llegar a Robj lo tiene que poner el filtro, y como su atenuación cuenta dos veces, alcanza con la mitad. Pidiendo R2 ≤ Robj y despejando:

A2 ≥

(2H2 + ∆G2) − Robj
2

= H2 +

∆G2 − Robj
2
. | (5.13)

Por ejemplo, con ∆G2 = −7 dB y Robj = −60 dB: sin filtro el fantasma está en −23 dB, faltan 37 dB, y el filtro tiene que poner la mitad, 18,5 dB. La Tabla 5.4 da los cuatro casos.

32 | Capítulo 5. Caracterización del VCO

Cuadro 5.4: Atenuación mínima del filtro en 2f, según la ecuación (5.13), con H2 = −8 dBc.

| Robj = −45 dB | Robj = −60 dB
(piso de las capturas) (margen para GPR)
∆G2 = 0 (pesimista) | 14,5 dB | 22 dB
∆G2 = −7 dB (simulación) | 11 dB | 18,5 dB

Cada dB de error en ∆G2 mueve el requisito sólo medio dB, porque el filtro cuenta dos veces. Diseñando para el caso pesimista, ∼20 a 22 dB en 2f cubren los dos objetivos. El tercer armónico arranca en 2,96 GHz, una vez y media el corte: atenuarlo es fácil, pero su nivel no está medido y hay que medirlo para cerrar este número.

La banda de transición. El filtro tiene que dejar pasar hasta fmax y rechazar desde 2fmin. Con la banda medida, 2fmin = 1976 MHz está por debajo de fmax = 1991 MHz: no hay banda de transición, sino 15 MHz de superposición. Ningún filtro separa del todo la fundamental de su segundo armónico con este barrido.

Correr la banda (subir fmin hasta que 2fmin quede por encima de fmax) no es una opción práctica: el VCO, el splitter, las bocinas y el resto de la cadena de RF están elegidos para la banda de 1 a 2 GHz, y achicarla cuesta resolución en distancia (c/2B). Lo más sencillo es aceptar un tramo contaminado de la rampa, y se puede, porque ese tramo cae donde la ventana de Hann casi no pesa.

Paso 1: qué tramo de la rampa queda contaminado. Ningún filtro real pasa de “deja pasar todo” a “atenúa A2” de golpe: necesita un margen de frecuencia para caer. Se llama fs a la frecuencia en la que el filtro ya alcanzó la atenuación A2 que pide la Tabla 5.4. El segundo armónico está en 2f(t), así que el filtro lo atenúa lo suficiente sólo cuando 2f(t) ≥ fs. Mientras f(t) < fs/2, el armónico pasa sin atenuar del todo. Eso ocurre únicamente al principio de la rampa, cuando el VCO está en la parte baja del barrido, y dura una fracción de la rampa

xs =

fs/2 − fmin
B
. | (5.14)

Por ejemplo, si el filtro llega a su atenuación en fs = 2,2 GHz, el armónico pasa mientras f(t) < 1,1 GHz, y la fracción es (1100 − 988)/1003 ≈ 11 % de la rampa.

Paso 2: cuánto pesa ese tramo. Antes de la FFT, cada rampa se multiplica por la ventana de Hann (Sección 9.6), que vale cero en los bordes y uno en el centro. El tramo contaminado está justo en un borde, donde la ventana casi anula la señal. Además,

5.6. Distorsión armónica del VCO | 33

la ventana se aplica sobre θ, que es lineal en la frecuencia, así que la fracción xs en frecuencia es exactamente la fracción de la ventana. La parte de la amplitud del fantasma que aporta ese tramo es el área de la ventana sobre él, dividida por el área total:

ρ(xs) =

R xs
0

sin²
(πu) du
R 1
0

sin²
(πu) du

= xs −

sin(2πxs)
2π
. | (5.15)

Con fs = 2,2 GHz da ρ ≈ 0,009, o sea −41 dB: el 11 % de la rampa aporta menos del 1 % del fantasma, porque en ese tramo la ventana vale entre 0 y 0,1. La cuenta es pesimista, porque supone que ese tramo no tiene ninguna atenuación, cuando en realidad el filtro ya lo está atenuando en parte.

Paso 3: dónde queda el fantasma. Lo que se cuela por el borde está ρ por debajo del fantasma sin filtro, que es 2H2 + ∆G2: −23 dB con la simulación y −16 dB en el caso pesimista. Con fs = 2,2 GHz queda en −23 − 41 = −64 dB, o −16 − 41 = −57 dB. La Tabla 5.5 repite la cuenta para varios fs.

Cuadro 5.5: Lo que se cuela por el borde de la rampa, según la frecuencia fs en la que el filtro alcanza su atenuación. Banda medida, 988 a 1991 MHz. La cuarta y la quinta columna son el nivel de esa parte del fantasma respecto del pico del blanco.

fs | tramo sin peso con Hann | fantasma | fantasma
atenuar | 20 log10 ρ | (∆G2 = −7 dB) (∆G2 = 0)
2,0 GHz (ideal) | 1 % | −111 dB | — | —
2,1 GHz | 6 % | −56 dB | −79 dB | −72 dB
2,2 GHz | 11 % | −41 dB | −64 dB | −57 dB
2,3 GHz | 16 % | −32 dB | −55 dB | −48 dB
2,5 GHz | 26 % | −20 dB | −43 dB | −36 dB

Cuanto más lento cae el filtro, más rampa queda contaminada y más fantasma se cuela. Para el objetivo de −60 dB, el filtro tiene que alcanzar su atenuación en ∼2,2 GHz con el ∆G2 de la simulación, o en ∼2,15 GHz en el caso pesimista.

Resumen: lo que se le pide al filtro. El fantasma que queda tiene dos partes: la del cuerpo de la rampa, que el filtro atenúa A2 (Tabla 5.4), y la del borde, que se cuela pero pesa poco (Tabla 5.5). Se pide que cada una quede, por separado, debajo del objetivo. Redondeando hacia el lado seguro:

pasabajos de RF que deje pasar hasta 2 GHz y atenúe al menos 22 dB a partir de 2,15 GHz.

Es una transición de un 8 % (2,15/1,99 ≈ 1,08): pide un filtro empinado, pero realizable,

34 | Capítulo 5. Caracterización del VCO

y gracias a la ventana de Hann no hace falta resignar ancho de banda. El diseño se trata aparte.

Para el diseño quedan además estos requisitos:

Banda de paso plana. Un rizado de amplitud en la banda de paso es una modulación de amplitud de la rampa y sube los lóbulos laterales del pico. La simulación muestra que los ±2 dB de rizado de la propia fundamental ya los llevan de −31 a −23 dB.

Pérdida de inserción baja, porque el filtro está antes del splitter y su pérdida se resta a la potencia transmitida y al nivel de LO que necesita el mezclador.

Adaptación a 50 Ω en la banda de paso, para no agregar reflexiones entre el VCO y el splitter.

Una advertencia: no todo 2fb viene de la RF. Una alinealidad en banda base (el amplificador del pasabajos post-mezclador, que en el Capítulo 7 ya mostró distorsión a amplitudes altas, o el propio PCM1808) también genera armónicos del batido en 2fb, 3fb, y el filtro de RF no los saca. Se distinguen atenuando el camino de recepción: el fantasma que viene de la RF mantiene su nivel relativo (la ecuación (5.11) no depende de la amplitud del eco), mientras que el de una alinealidad de segundo orden baja 1 dB por cada dB de atenuación. Para lo mismo sirve conectar la salida de TX con la entrada de RX por un cable y un atenuador, sin antenas. Así hay un único retardo, y todo pico en 2fb o 3fb es un fantasma puro.

Lo que falta medir para cerrar los números de esta sección: el segundo y el tercer armónico hasta ∼6 GHz, a la salida del VCO, del amplificador de RF y en la entrada LO del mezclador, con un atenuador externo para bajar el piso de −32 dBc. Eso reemplaza el ∆G2 estimado y el tercer armónico supuesto por valores medidos.

# Capítulo 6

# Generador de Triangular Analógico

La rampa de tensión que sintoniza el VCO (Capítulo 5) la venía entregando un generador de funciones de laboratorio. Este capítulo describe el circuito analógico que lo reemplaza: un oscilador de onda triangular construido con dos operacionales cuádruples, con el período ajustable mediante un potenciómetro de precisión, salida acotada al rango 0–3 V que admite el VCO y una onda cuadrada de sincronismo para el ESP32-C3. Se documentan el diseño, la elección de los componentes, la verificación por simulación y la placa impresa. Al cierre de este capítulo la placa está diseñada y verificada, pero todavía no armada: las mediciones sobre el circuito físico quedan pendientes (Sección 6.7).

## 6.1. Motivación y requisitos

El generador de funciones empleado hasta ahora (Siglent SDG830) impone dos limitaciones sobre el banco, y la segunda pesa tanto como la primera.

La primera es que no entrega una señal de sincronismo: su salida de sincronismo no funciona en este banco. Sin una referencia que marque dónde empieza cada rampa no se sabe qué tramo de la señal digitalizada corresponde a cada barrido, y eso hace falta para cortar las rampas y para la corrección de no linealidad del VCO. Mientras tanto, el problema se resolvió por software: el ESP32-C3 lee la propia triangular por GPIO3 y la PC ajusta su período y su fase (Sección 9.3). Ese camino funciona, pero depende de un ajuste estadístico sobre ∼ 19 lecturas por período y del ADC del microcontrolador, que tiene un offset alternante sin resolver. Una onda cuadrada de sincronismo da la misma información de forma directa, flanco por flanco.

La segunda es que ata el banco a la red eléctrica. Un GPR que no puede salir del laboratorio no sirve para medir sobre un terreno. El objetivo es que todo el instrumento se alimente de un powerbank, a través de una fuente elevadora seguida de un regulador

35

36 | Capítulo 6. Generador de Triangular Analógico

lineal que deja disponibles los 12 V de este generador y los 20 V del amplificador que ataca al VCO.

Sobre esa base, los requisitos del generador son:

Salida triangular de 0 a 3 V, con una tolerancia de ±50 mV en los extremos, que es el rango de tensión de control útil del VCO establecido en la Sección 5.1.

Período de repetición (Tprf) ajustable entre 20 y 200 ms, con un potenciómetro de precisión montado en el panel.

Siempre triangular: la forma de onda no debe cambiar al mover la frecuencia, a diferencia de un generador de funciones donde es fácil dejar seleccionada otra.

Onda cuadrada de sincronismo en fase con la triangular, compatible con una entrada digital del ESP32-C3.

Cuando estos requisitos entran en conflicto, el orden de prioridades es: linealidad de la rampa (es lo que determina que el eco de un blanco puntual caiga en una única frecuencia de batido), luego ruido, luego vértices bien definidos, luego estabilidad de la amplitud y por último rango de frecuencia.

## 6.2. Topología

El circuito parte de la topología clásica de oscilador de triangular —comparador de Schmitt realimentando un integrador— adaptada a alimentación simple de 12 V, y le agrega dos etapas de acondicionamiento. La Figura 6.1 resume la estructura y la Figura 6.2 es el esquemático completo.

6.2. Topología | 37

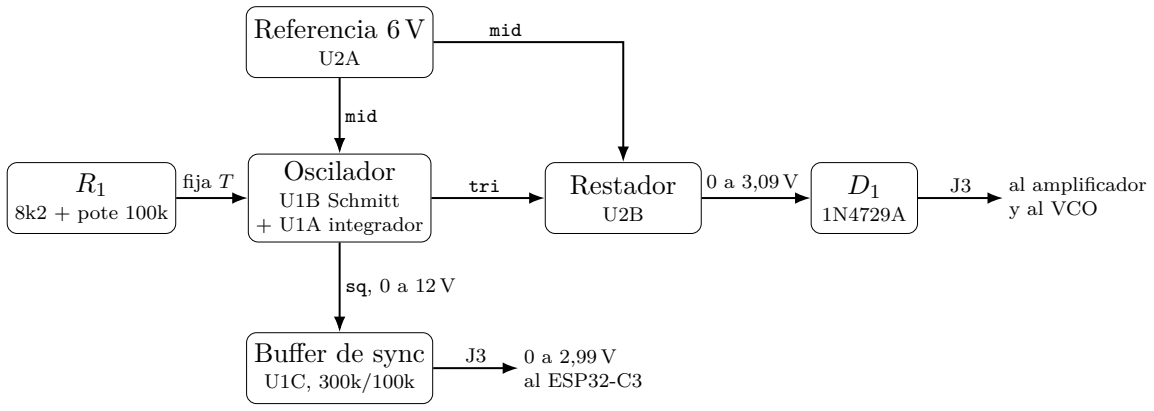
[picture p21: figure]
8k2 + pote 100k; Oscilador; U1B Schmitt + U1A integrador; Restador; Referencia 6 V; Buffer de sync; fija T; tri; al amplificador; y al VCO; mid; al ESP32-C3

Figura 6.1: Estructura del generador. El oscilador entrega una triangular de 3,06 Vpp centrada en la referencia de 6 V; el restador la baja al rango 0–3 V que pide el VCO; el zener D1 protege al VCO ante una falla y el buffer de sync reduce la cuadrada del comparador a un nivel que tolera el ESP32-C3. Todo el circuito se alimenta de una única
rama de 12 V. 1 | 2 | 3 | 4 | 5 | 6
1 | 2 | 3 | 4 | 5 | 6

AB

C

D

AB

C

D Date:

KiCad E.D.A. 10.0.6

Size: A4 | Rev: Id: 1/1

Title: Generador de triangular 4-53 Hz

File: triangular.kicad_sch

Sheet: /

FIUBA - Tesis GPRv2

Circuito de GPRv2/docs/PWM/triangular3.asc, con TLC2274 ⁺¹²V | 1

2

J2
12 V GND

R1

8k2

1
2
3

J3
Salida +

12 -

13

14 U1D

# TLC2274 +12VC2

10u 25V R15

6k8 R2

47k | GND
GND | GND

R3

12k | 1
2

3 RV1
100k lineal | JP1 Puente R9
100k | 8 -

9 +

10 U2C

TLC2274 ⁺

5 -

6

7 U1B

TLC2274

1

2

3

SW1
LP-SW-213CI | GND | +

12 -

13

14 U2D

TLC2274 GND

D1

1N4729A R14

82k R4

100k ⁺12V | R7
100k | GND

C4
100n GND
GND | +12V C3

100n 1
2
3

J1Pote 100k (Bourns 3590) 1 -

2 +

3 | U1A
TLC2274 | +12V GNDV+

4 V- 11 U1E

TLC2274 | V+ 4 V- 11 U2E
TLC2274 ⁺12V | GND ⁺12V | GND +

5 -

6

7 U2B

TLC2274 | +12V R6
100k | D2 LED rojo 5x5 R17
2k2 +12V C1
2.2u | GND

R8

100k R10

680k 1 -

2 +

3 U2A

TLC2274 R5
100k GND

R13
15k GND

R16

150k | 8 -

9 +

10 U1C

TLC2274 R11

150k | R12
| 100k
inv | pote

tri

inv mid

sq

pote | mid
tri | mid

salida

sync

sq

salida

tri mid

sync Referencia de 6 V: U2A

Alimentacion 12 V y desacople

Oscilador: U1B Schmitt + U1A integrador | RV1 o J1, no los dos: RV1 para probar, J1 + Bourns 3590S con cables en la caja
Sync para el ESP32: U1C (12 V -> 3 V) | C3 pegado a U1 y C4 pegado a U2, entre la pata 4 y la 11. Salida al amplificador del VCO y al ESP32

U1D, U2C y U2D sobran: seguidores con la + a GND

GPRv2 - Generador de triangular 4-53 Hz, 0 a 3,1 V (triangular3.asc) Resistencias: pelicula metalica 1 %, todas de la serie E12. Con 5 % la salida puede

ir de -0,65 a 3,67 V; con 1 %, de -0,10 a 3,22 V. Combinaciones en serie: R9+R13 = 115k, R10+R14+R15 = 768k8, R11+R16 = 300k. J1: 1 = extremo del pote, 2 = cursor, 3 = otro extremo (2 y 3 unidos en la placa).

U1, U2: TLC2274 DIP-14 (el simbolo es el del cuadruple estandar, mismo patillaje). Los sobrantes van
como seguidor con la + a GND: el rango de entrada del TLC227x incluye GND y la salida queda en 0 V. D1 (1N4729A, 3,6 V): protege al VCO (18 V max; amplificador x4,95 alimentado con 20 V). En falla limita la

salida a ~3,3 V (16,4 V en el VCO). A 3,09 V toma 0,24 mA. NO usar el 1N4728A: recorta la punta. SW1: llave palanca SPDT (LP-SW-213CI), encendido: comun (medio) a J2, un extremo a +12V. Patas a 4 mm

(confirmar con la pieza). D2 + R17: LED rojo de encendido, 2k2 -> ~4,5 mA. | Restador: U2B. salida = tri - 6 V + 1,56 V

R4

100k ⁺12V | +12V GND | U1E

TLC2274 V+

4 V- 11 U2E
TLC2274 V+

4 V- 11 +12V GND +12VD2

LED rojo 5x5 R17

2k2 | C4
100n GND | +12V C3
100n +12V | GND ⁺12VC2

10u 25V GND

R15

6k8 ⁺12V | GND

R5
100k GND

R13
15k GND

R16

150k R12

100k GND

D1
1N4729A GND

Figura 6.2: Esquemático completo (GPRv2/docs/PWM/pcb/triangular.kicad_sch). Las cinco unidades usadas se reparten entre dos TLC2274: U1 lleva el oscilador y el sync, U2 la referencia y el restador. Las tres unidades sobrantes (U1D, U2C y U2D) quedan como seguidores con la entrada no inversora a masa.

38 | Capítulo 6. Generador de Triangular Analógico

### 6.2.1. El oscilador

U1B funciona como comparador con histéresis: su entrada no inversora recibe la triangular a través de R3 y su propia salida a través de R2, y conmuta cuando esa suma cruza la referencia mid. U1A integra la salida cuadrada de U1B sobre C1 con la corriente que fija R1.

Igualando a cero la corriente en la entrada no inversora de U1B se obtienen los dos umbrales de conmutación, y de ahí la amplitud de la triangular:

Vpp =

R3
R2

Vcc =

12 kΩ
47 kΩ
- 12 V = 3,064 V. | (6.1)

La corriente que carga a C1 es (Vcc/2)/R1, constante, de modo que la rampa es lineal por construcción. Combinando la pendiente resultante con la amplitud de la ecuación (6.1), el período queda:

T = 4

R3
R2
R1C1. | (6.2)

Dos observaciones sobre la ecuación (6.2). La primera es que T no depende de la tensión de alimentación: Vcc fija la amplitud y la corriente de carga en la misma proporción, y se cancela. La segunda es que T es proporcional a R1, así que el período es lineal con la posición del potenciómetro, que es la propiedad que hace cómodo el ajuste de panel.

Con R1 = 8,2 kΩ+ potenciómetro de 100 kΩ y C1 = 2,2 µF, la Tabla 6.1 compara la ecuación (6.2) con la simulación del circuito completo. El acuerdo es mejor que el 1 % en todo el recorrido, y el rango 18,6–243,5 ms cubre con holgura los 20 a 200 ms pedidos.

Cuadro 6.1: Período en función de la posición del potenciómetro: la ecuación (6.2) contra la simulación del circuito completo con el modelo real del operacional.

Posición | R1 | T calculado T simulado | Desvío
0 | 8,2 kΩ | 18,42 ms | 18,58 ms | −0,85 %
0,5 | 58,2 kΩ | 130,76 ms | 131,08 ms | −0,24 %
1 | 108,2 kΩ | 243,10 ms | 243,46 ms | −0,15 %

C1 es de película metálica, no electrolítico. Con la alimentación simple, la tensión sobre C1 se invierte en cada semiperíodo (±1,5 V), lo que ya descarta un electrolítico polarizado; y con el potenciómetro al máximo la corriente de carga es de apenas (Vcc/2)/R1 = 55,5 µA, comparable a la corriente de fuga de un electrolítico, que se sumaría a la de carga y curvaría la rampa.

6.3. Elección del operacional | 39

### 6.2.2. El restador

La triangular del oscilador queda centrada en 6 V, y el VCO pide 0 a 3 V. U2B resuelve las dos cosas a la vez: resta la referencia y suma un offset fijo, de modo que

Vsal = Vtri − 6 V + 1,56 V. | (6.3)

El detalle importante es de dónde sale ese offset de 1,56 V: no de una referencia de tensión aparte, sino de los mismos 12 V de alimentación, a través de R′
10. Como la amplitud de
la triangular (ecuación (6.1)) y la referencia de 6 V también son proporcionales a Vcc, toda la salida escala con la alimentación: una fuente que esté un 5 % baja corre los extremos un 5 %, pero no descentra la señal ni la saca de forma. Para una fuente elevadora alimentada por batería, cuya tensión de salida no es de precisión, esa propiedad vale más que un offset absolutamente estable.

Imponer ganancia unitaria sobre Vtri y el offset buscado fija dos combinaciones de resis-
tencias que no existen en la serie E12 y se arman en serie: R′ | 9 = R9 + R13 = 115 kΩ y
R′
10 = R10 + R14 + R15 = 768,8 kΩ. Las dos quedan a menos del 0,05 % del valor ideal. El criterio completo, junto con el análisis de tolerancias que justifica usar resistencias al 1 %, está en el Apéndice A.

### 6.2.3. El sincronismo

La salida del comparador U1B conmuta entre los rieles, es decir entre 0 y casi 12 V, que el ESP32-C3 no tolera en ningún pin. U1C la toma a través de un divisor R′
11/R12 =
300 kΩ/100 kΩ, que la reduce a un cuarto, y la repite con impedancia baja. La carga total sobre el comparador es de 400 kΩ, suficientemente alta como para no alterar los umbrales de la ecuación (6.1).

El nivel alto resultante es de 2,99 V en la simulación, cómodo frente al umbral de entrada en alto del GPIO, que la hoja de datos del ESP32-C3 ubica en 0,75 VDD = 2,48 V.

## 6.3. Elección del operacional

El circuito necesita cinco unidades con salida rail-to-rail —la triangular tiene que llegar a 3 V desde una alimentación simple, y la cuadrada de sync debe bajar a 0 V—, alimentación simple de 12 V y encapsulado DIP, para poder montarlo sobre zócalos en una placa de una sola capa. La Tabla 6.2 resume los candidatos evaluados.

40 | Capítulo 6. Generador de Triangular Analógico

Cuadro 6.2: Candidatos considerados para los cinco operacionales.

Operacional Encapsulado Rail-to-rail Resolución

TL072 | DIP-8 | no | Descartado: no llega a los rieles
LMC6482 | DIP-8 | sí | Descartado: el modelo no converge
OPA2171 | solo SOIC | sí | Descartado: no se consigue en DIP
TLC2262 | DIP-8 | sí | Descartado: más ruidoso (ver abajo)
TLC2274 | DIP-14 | sí | Elegido

El TLC2274 es la versión cuádruple del TLC2272: mismo operacional, mismo modelo SPICE. Dos integrados cubren las cinco unidades necesarias, y las tres que sobran se dejan como seguidores con la entrada no inversora a masa; como el rango de entrada en modo común del TLC227x incluye masa, esas salidas quedan en 0 V y no hace falta llevarles la referencia de 6 V, lo que evita cruzar la placa con una pista más.

El reparto de unidades entre los dos integrados no es arbitrario: U1 lleva el oscilador y el sync, U2 la referencia y el restador. Agrupar por función mantiene cortas las conexiones de cada lazo y es lo que hace posible rutear todo el circuito en una sola capa (Sección 6.6).

### 6.3.1. Ruido: por qué no el TLC2262

El TLC2262 cumple todos los requisitos formales, así que la comparación se resolvió por ruido. En lugar de citar las hojas de datos se midió la densidad de ruido de entrada de cada modelo SPICE, con un análisis .noise sobre un seguidor de ganancia unitaria alimentado con los mismos 12 V del circuito (script GPRv2/docs/PWM/simulacion/ruido_opamp.py). Los resultados están en la Tabla 6.3.

Cuadro 6.3: Densidad de ruido de tensión de entrada de los modelos SPICE, en nV/

√
Hz,
comparada con el ruido térmico de las resistencias del lazo.

10 Hz 50 Hz 100 Hz 1 kHz 10 kHz

TLC2272 / TLC2274 | 51,0 | 24,0 | 17,9 | 9,7 | 8,4
TLC2262 | 41,8 | 22,9 | 19,2 | 15,2 | 14,7
√
4kT R, R = 100 kΩ 40,7 (independiente de la frecuencia)

A 1 kHz la diferencia es clara y favorece al TLC2274, que es 1,6 veces menos ruidoso, y esa es la razón por la que se lo eligió sobre el TLC2262. Conviene, sin embargo, ser explícito sobre el alcance real de esa ventaja: en la banda en la que trabaja este circuito (4 a 54 Hz de fundamental, y sus primeros armónicos) los dos modelos quedan a menos del 10 % uno del otro, y ambos son del mismo orden que el ruido térmico de las resistencias de 100 kΩ del lazo, que es lo que en la práctica domina. La elección del TLC2274 está bien

6.4. Resultados de simulación | 41

hecha, pero lo que la vuelve decisiva es el encapsulado cuádruple en DIP, no el margen de ruido.

## 6.4. Resultados de simulación

El circuito se simuló en LTspice en tres etapas sucesivas, una por archivo: primero la topología desnuda (triangular.asc), después con la salida acondicionada y el sync usando un operacional ideal (triangular2.asc), y finalmente con el modelo real del TLC2272 (triangular3.asc). Ese modelo del fabricante sólo converge en este lazo con integración gear y arranque en rampa de las fuentes (.options method=gear y la opción startup

del .tran).

Además, el script pcb/simular_kicad.py exporta el netlist del esquemático de KiCad con kicad-cli y lo simula en LTspice, de modo que lo que se verifica es el circuito que efectivamente está dibujado en la placa y no una copia aparte que podría haber quedado desactualizada. Los números de esta sección salen de esa corrida.

42 | Capítulo 6. Generador de Triangular Analógico

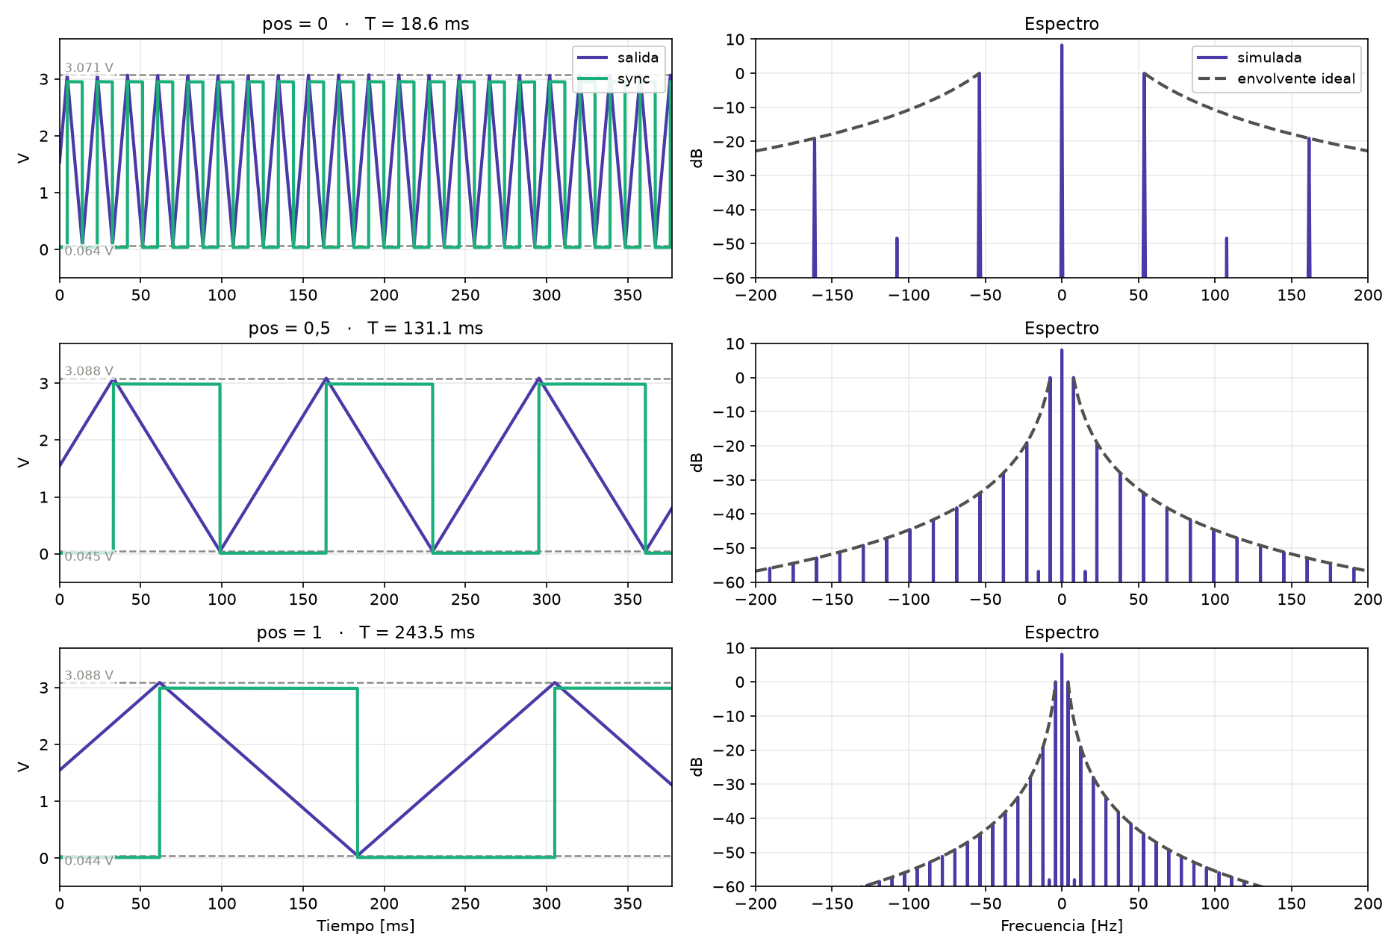
[picture p22: figure]

Figura | 6.3: | Salida | y | sincronismo | del | generador | con | el | mode-
lo | real | del | TLC2272, | en | tres | posiciones | del | potenciómetro | (script
GPRv2/docs/PWM/simulacion/graficar_triangular3.py). Izquierda: la triangular de salida junto con la cuadrada de sync, con los niveles extremos indicados. Derecha: el espectro de dos lados de la salida —cada raya es un armónico, y la del centro es la componente continua— comparado con la envolvente 1/f ² que corresponde a los armónicos impares de una triangular ideal.

La Tabla 6.4 reúne los valores medidos sobre la simulación. La salida cubre el rango pedido en las tres posiciones y los extremos se mantienen dentro de la tolerancia de ±50 mV respecto de 0 y 3 V.

6.5. Protección del VCO | 43

Cuadro 6.4: Períodos, niveles y contenido armónico simulados, en las tres posiciones del potenciómetro.

Posición del potenciómetro | 0 | 0,5 | 1
Período | 18,58 ms | 131,08 ms 243,46 ms
Frecuencia | 53,82 Hz | 7,63 Hz | 4,11 Hz
Salida, mínimo | 0,062 V | 0,041 V | 0,040 V
Salida, máximo | 3,078 V | 3,089 V | 3,090 V
Sync, nivel bajo | 0,036 V | 0,010 V | 0,009 V
Sync, nivel alto | 2,952 V | 2,987 V | 2,989 V

2

o armónico | −48,3 dB −56,8 dB | −58,0 dB
3
er armónico | −19,1 dB −19,1 dB | −19,1 dB
5
o armónico | −28,0 dB −28,0 dB | −28,0 dB

Los armónicos impares valen exactamente lo que predice una triangular ideal (1/9 = −19,08 dB y 1/25 = −27,96 dB), lo cual confirma que la rampa es lineal: cualquier curvatura apreciable se manifestaría como una desviación en esos valores.

Los armónicos pares, en cambio, son el indicador interesante, porque en una triangular perfectamente simétrica valen cero. Con el operacional ideal el segundo armónico queda en −93,7 dB, es decir en el piso numérico; con el modelo real del TLC2272 sube a −48,3 dB en la posición más rápida. Esa asimetría es el efecto del slew rate y del retardo finitos del operacional en los vértices, y se atenúa al bajar la frecuencia: −58,0 dB en la posición más lenta, donde los vértices ocupan una fracción mucho menor del período. Como el radar opera en la zona lenta del rango, el efecto es despreciable.

## 6.5. Protección del VCO

El VCO admite hasta 18 V en su entrada de sintonía, y el amplificador intermedio, caracterizado en la Sección 5.1 como Vosc = 4,949 Vin + 0,055, se alimenta con 20 V. La salida del generador no puede entonces superar

Vin,máx =

18 − 0,055
4,949
= 3,63 V, | (6.4)

contra los 3,09 V de operación normal. El margen es de apenas medio volt, y una sola resistencia abierta alcanza para perderlo: el diodo zener D1, conectado entre la salida y masa, es la protección.

La elección del zener es más delicada de lo que parece, porque el codo de conducción de un zener de baja tensión es blando. La Figura 6.4 compara los dos candidatos.

44 | Capítulo 6. Generador de Triangular Analógico

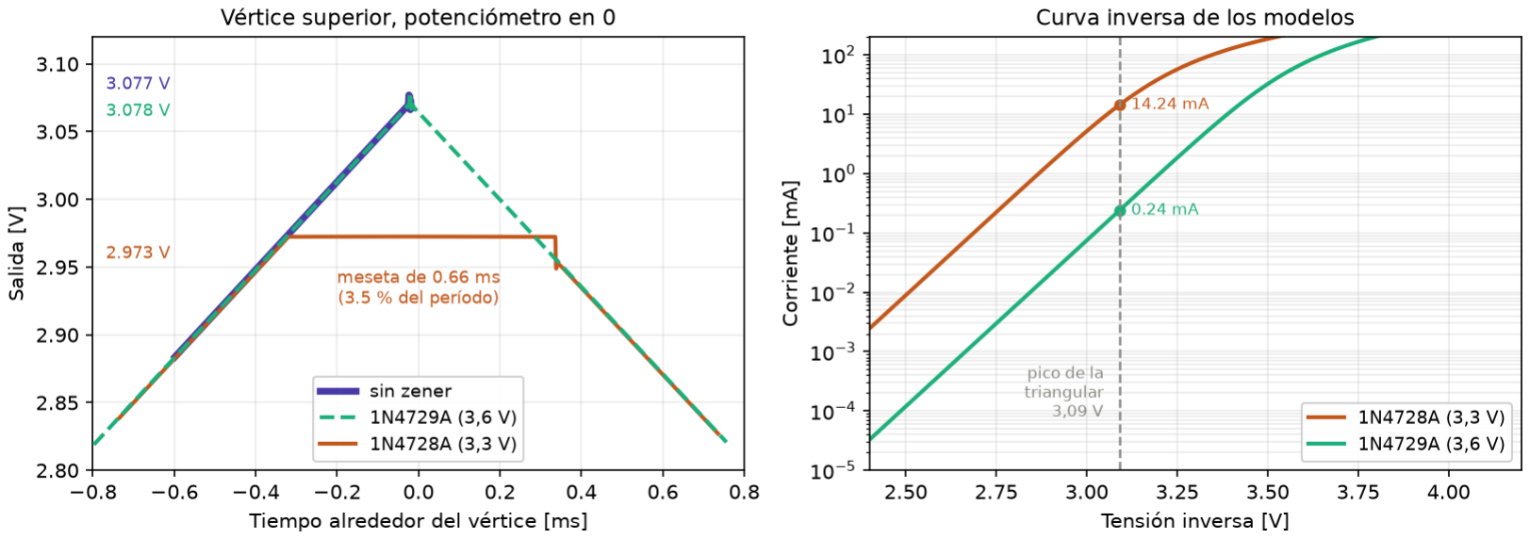
[picture p23: figure]

Figura | 6.4: | Efecto | de | cada | zener | sobre | la | operación | normal | (scripts
GPRv2/docs/PWM/simulacion/simular_zener.py | y graficar_zener.py). Izquier-
da: el vértice superior de la triangular sin zener, con el 1N4729A y con el 1N4728A. Derecha: la curva de conducción inversa de los dos modelos, con la corriente que toma cada uno al pico de la triangular.

El 1N4728A (3,3 V nominales) no sirve. A los 3,09 V del pico ya conduce 14,2 mA, y en la simulación recorta el vértice: lo achata a 2,973 V, es decir 104,5 mV por debajo del pico real, y deja una meseta de 0,66 ms que ocupa el 3,5 % del período. Sobre la prioridad número uno del circuito, que es la linealidad de la rampa, eso es inaceptable.

El 1N4729A (3,6 V) toma 0,24 mA al mismo pico y no altera la señal: la diferencia entre la corrida con zener y la corrida sin zener es de menos de 2 mV, dentro del ruido numérico de la simulación.

La Figura 6.5 muestra que, pese a esa suavidad, el 1N4729A cumple su función. La falla simulada es la apertura de R9, que suelta el divisor de la entrada no inversora del restador.

6.6. Implementación en placa impresa | 45

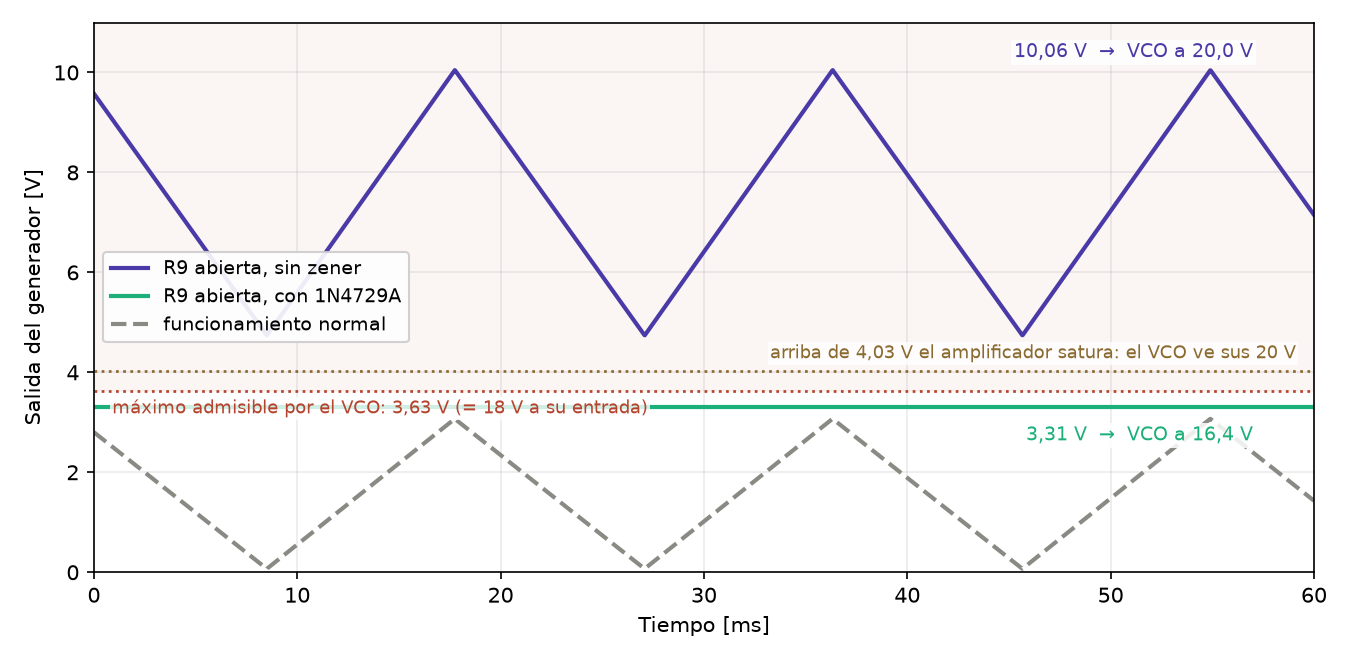
[picture p24: figure]

Figura 6.5: Falla simulada: R9 abierta. Sin zener la salida se va a 10,06 V, con lo que el amplificador satura contra sus 20 V de alimentación y el VCO queda 2 V por encima de su máximo. Con el 1N4729A la salida se clava en 3,31 V, que corresponden a 16,4 V en el VCO.

Sin protección, la salida pasa a oscilar entre 4,73 y 10,06 V; el amplificador satura contra su alimentación y el VCO recibe los 20 V completos, por encima de los 18 V que tolera. Con el 1N4729A la salida se clava en 3,31 V —equivalentes a 16,4 V en el VCO— porque el operacional no puede entregar más de 3,71 mA contra el zener en conducción. Considerando la tolerancia del ±5 % de la tensión de zener, el nivel de sujeción va de 15,6 a 17,2 V en el VCO: siempre por debajo del límite.

## 6.6. Implementación en placa impresa

La placa se diseñó en KiCad 10, de una sola capa de cobre (B.Cu) y 93 × 63 mm, para poder fabricarla por métodos caseros. Las Figuras 6.6 y 6.7 muestran el resultado.

46 | Capítulo 6. Generador de Triangular Analógico

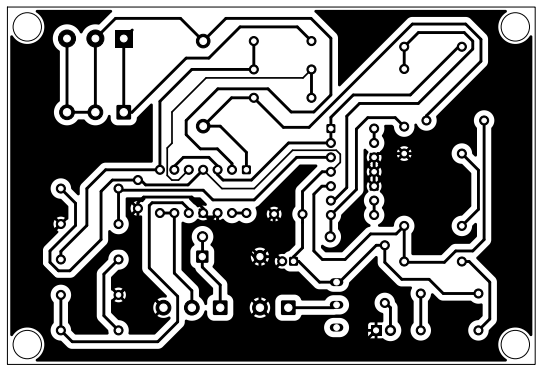
[picture p25: figure]
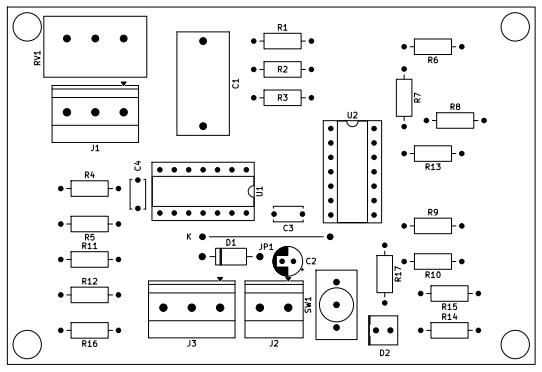
[picture p26: figure]
SW¹

(a) Cobre (B.Cu) y contorno. | C4 | R9 R1
(b) Serigrafía y contorno.

Figura 6.6: Placa del generador, 93 × 63 mm, una sola capa. Las dos vistas están en la misma orientación, mirando desde el lado de los componentes. En el cobre, el negro es cobre y el blanco es el aislamiento: casi toda la superficie libre es plano de masa.

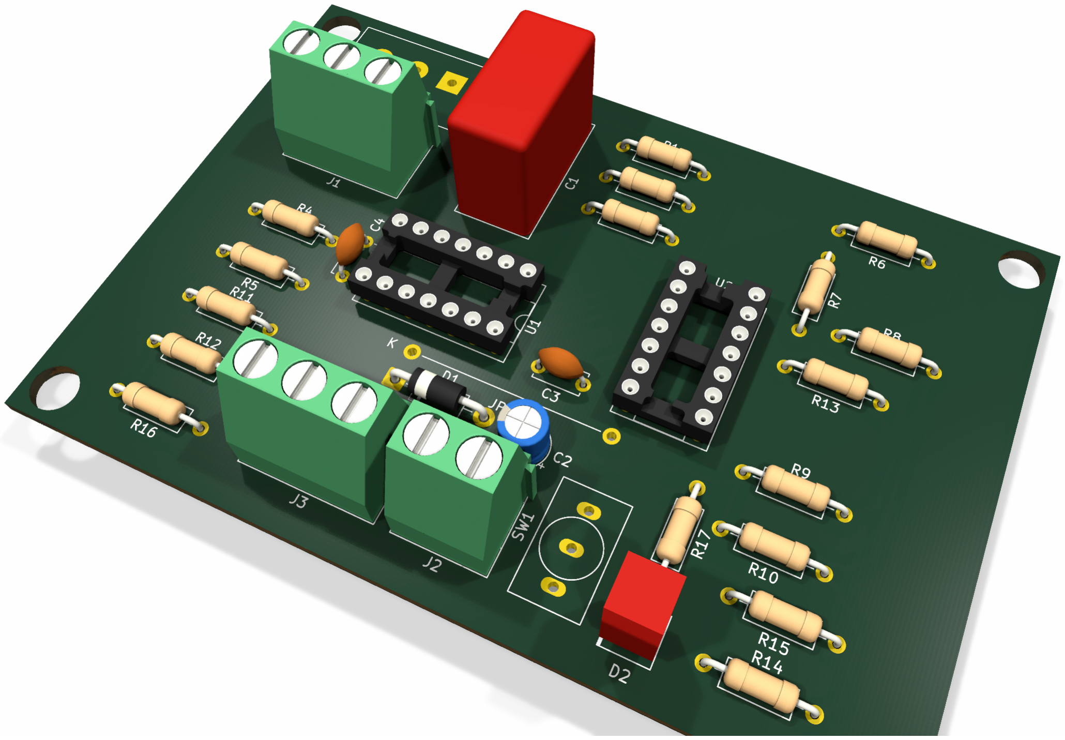
[picture p27: figure]

Figura 6.7: Vista tridimensional de la placa (kicad-cli pcb render). Faltan los modelos 3D de la llave de encendido SW1 y del puente de cable JP1, cuyas huellas se dibujaron para este proyecto; el resto de los componentes se muestra completo.

Las pistas son de 0,508 mm (20 mil) salvo dieciséis tramos de 0,3 mm que pasan entre patas de los zócalos; suman 1279 mm de cobre, sin ninguna vía. La superficie restante es un plano de masa con 1 mm de separación a los pads, alivios térmicos y ancho mínimo de relleno de 0,5 mm. JP1 es un puente de cable de 22,5 mm que resuelve el único cruce que no se pudo evitar, y va en la salida, antes del zener. Las conexiones al exterior salen por tres borneras: J1 al potenciómetro de panel, J2 a los 12 V y J3 a la salida, el sync y masa.

6.6. Implementación en placa impresa | 47

El encendido corta los 12 V con una llave de palanca SPDT y un LED rojo en serie con 2,2 kΩ (≈ 4,7 mA) como indicador. Se evaluó la alternativa de cortar la salida y el sync con una llave de dos circuitos, y se descartó: cortando la alimentación, cualquier patillaje de la llave deja el circuito en un estado seguro, lo cual importa porque las llaves disponibles no tienen hoja de datos confiable.

### 6.6.1. Verificación

El diseño se verificó por cuatro caminos independientes:

ERC y DRC de KiCad: sin errores, sin conexiones faltantes y sin discrepancias de paridad contra el esquemático. La única advertencia que queda es que la huella del potenciómetro RV1 difiere de la copia en la biblioteca, porque se la editó a propósito para que el eje quede fuera del borde de la placa.

Comparación automática contra el netlist de LTspice: se contrastó componente a componente el PCB contra triangular3.asc, y los 19 elementos encontraron su par exacto. El procedimiento se validó introduciendo errores a propósito y comprobando que los detectara.

Simulación del esquemático de KiCad (simular_kicad.py), que reproduce los mismos períodos y niveles de la Tabla 6.4.

Revisión de las redes de los pads, una por una, contra el circuito.

Quedan dos limitaciones conocidas, ambas aceptadas a conciencia. La primera es que la separación mínima entre cobre de redes distintas es de 0,304 mm, en dos lugares (junto al pad 6 de U1 y al pad 3 de U2); supera la regla de diseño de 0,2 mm, pero es ajustada para fabricación casera. La segunda es que los capacitores de desacople no quedaron pegados a las patas de alimentación: C4 está a 11,6 mm de la de U1 y C3 a 9,0 mm de la de U2. No se pudo mejorar sin agregar una segunda capa, y a las frecuencias de este circuito, con un ancho de banda de ganancia unitaria de 2,2 MHz, no debería tener consecuencias.

Vale registrar un error de diseño que el flujo de verificación sí atrapó: un relleno de zona que había quedado sin recalcular después de mover una pista dejó el plano de masa tocando una pista de +12 V, es decir un cortocircuito franco de la alimentación. El DRC no lo reportó hasta que se volvió a rellenar la zona. La lección operativa es que el DRC se corre sobre el relleno actualizado, no sobre el dibujo.

Por último, una advertencia sobre el alcance de todo lo anterior: el modelo del TLC2272 usa la tensión de offset típica (0,17 mV), no la máxima de hoja de datos (2,5 mV). Los

48 | Capítulo 6. Generador de Triangular Analógico

niveles simulados de la Tabla 6.4 son, en ese sentido, optimistas, y es una de las cosas que la medición sobre la placa armada tiene que confirmar.

## 6.7. Mediciones pendientes

La placa está diseñada y verificada, pero no construida. Las mediciones que restan, y que completarán este capítulo, son:

Período en función de la posición del potenciómetro, para confirmar tanto el rango 18,6–243,5 ms como la linealidad que predice la ecuación (6.2).

Niveles extremos de la salida y del sync, contra la Tabla 6.4, con atención al corrimiento que puede introducir la tensión de offset real de los operacionales.

Linealidad de la rampa, midiendo la desviación respecto de la recta ideal, que es el parámetro de mayor prioridad del circuito.

Espectro de la salida, para contrastar el contenido armónico medido con el simulado, en particular los armónicos pares.

Separación entre patas de la llave de encendido, que se tomó de un modelo parecido y hay que confirmar con la pieza en mano antes de fabricar la placa.

# Capítulo 7

# Filtro Pasabajos

## 7.1. Objetivo y método de medición

Como ejercicio de práctica independiente del resto de la cadena de RF, se caracterizó un filtro activo pasabajos con una etapa de ganancia ajustable mediante potenciómetro, barriendo con un generador de funciones senoidal y midiendo la tensión pico a pico de entrada y de salida en dos posiciones del potenciómetro (G = 1 y G = 2) a lo largo de un barrido logarítmico en frecuencia. La excitación de entrada se mantuvo aproximadamente constante en 3,113 ± 0,045 Vpp (1,5 % de dispersión) a lo largo de todo el barrido. Se registraron 52 puntos para G = 2 y 24 para G = 1.

En cada punto el operador anotó el nivel de distorsión observado en el osciloscopio (sin distorsión / poca distorsión / mucha distorsión / ruido), porque la tensión pico a pico de una onda distorsionada no es la amplitud de su componente fundamental: un punto con distorsión visible no representa la función transferencia lineal del filtro y debe excluirse del ajuste cuantitativo. Con este criterio, los datos se consideran válidos (sin distorsión) hasta 1750 Hz; por encima de esa frecuencia (zona sombreada y trazo punteado en la Figura 7.1) las mediciones existen pero no deben leerse como respuesta lineal del filtro.

## 7.2. Respuesta en frecuencia

La ganancia en banda de paso se calculó como la mediana de 20 log10(Vpp,out/Vpp,in) sobre los puntos válidos entre 200 y 1750 Hz; las frecuencias de corte a −3 dB se obtuvieron interpolando en escala logarítmica de frecuencia el cruce con (ganancia de banda de paso −3 dB). Los resultados se resumen en la Tabla 7.1 y en la Figura 7.1.

49

50 | Capítulo 7. Filtro Pasabajos

Cuadro 7.1: Parámetros medidos del filtro activo en las dos posiciones del potenciómetro de ganancia (banda de paso: mediana entre 200 y 1750 Hz, puntos sin distorsión).

| G = 1 | G = 2

Ganancia en banda de paso −0,17 dB (×0,981) +6,51 dB (×2,115)
Corte inferior (−3 dB) | 19,3 Hz | 18,6 Hz
Corte superior (−3 dB)* | 20,3 kHz | 17,5 kHz

*Ambos valores de corte superior caen dentro de la zona confirmada sin distorsión solo

hasta 1750 Hz (Sección 7.1); como se discute en la Sección 7.3, deben interpretarse como cota inferior del ancho de banda real del filtro y no como su valor exacto.

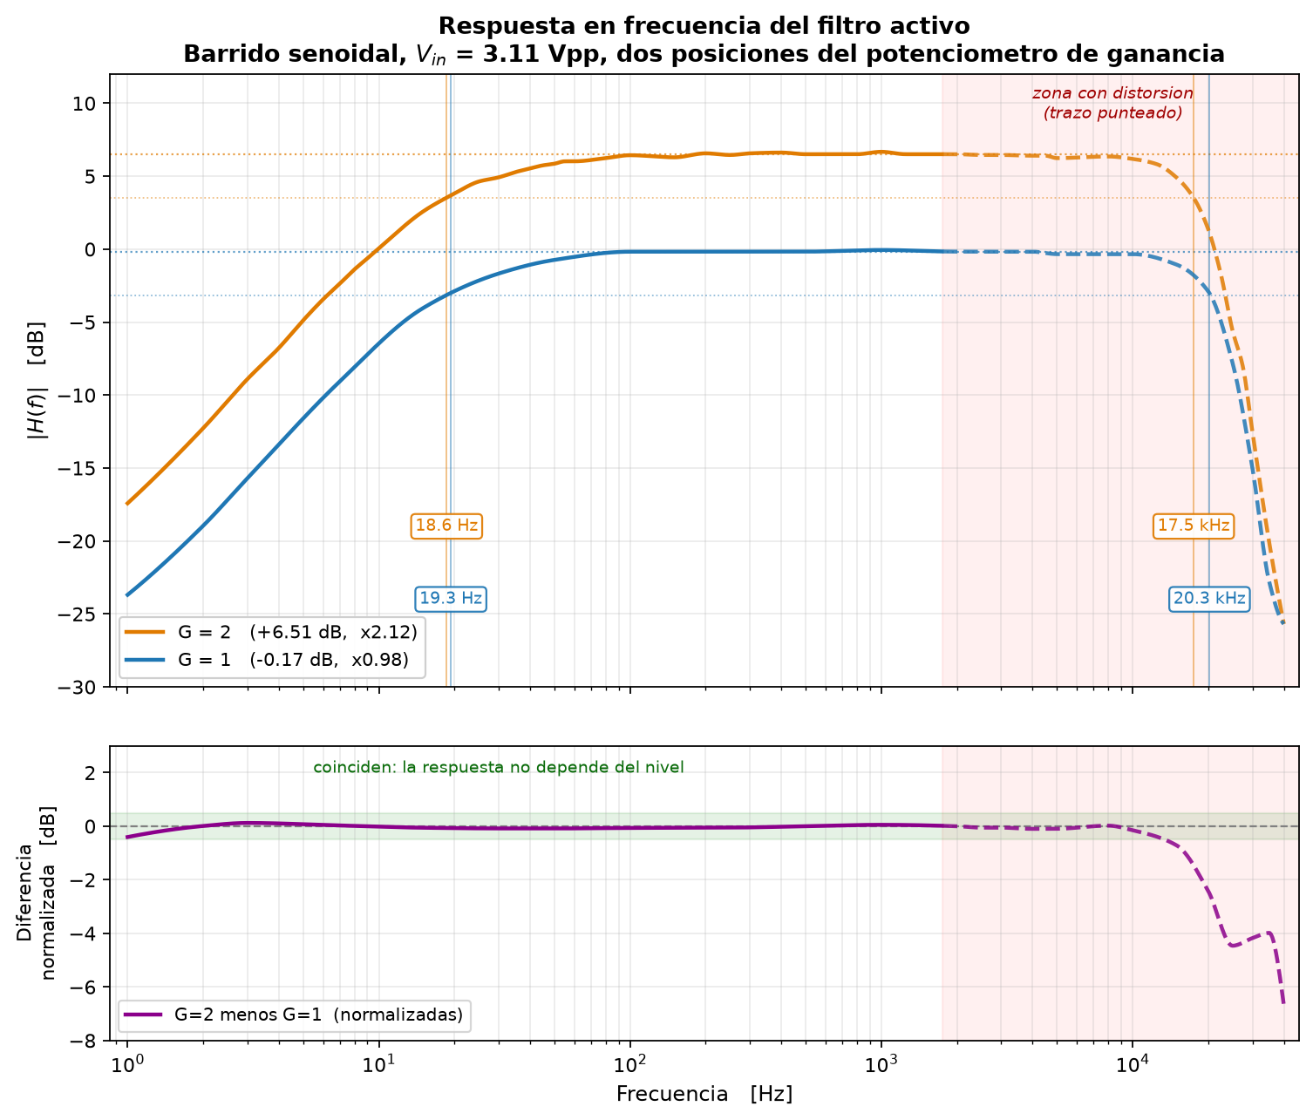
[picture p28: figure]

Figura 7.1: Respuesta en frecuencia del filtro activo, barrido senoidal con Vin = 3,11 Vpp, en las dos posiciones del potenciómetro de ganancia. Arriba: respuesta absoluta, con las frecuencias de corte indicadas; el trazo se vuelve punteado a partir de la zona con distorsión. Abajo: diferencia entre ambas curvas normalizadas a su propia banda de paso.

La ganancia adicional que aporta el potenciómetro entre las posiciones G = 1 y G = 2 es de 6,68 dB (×2,157).

7.3. Comparación normalizada: separar el efecto de la ganancia del efecto de la amplitud51

## 7.3. Comparación normalizada: separar el efecto de

## la ganancia del efecto de la amplitud

Si el filtro fuese lineal, normalizar cada curva a su propia banda de paso debería hacer que ambas coincidan exactamente: el potenciómetro escala la ganancia global pero no debería mover la posición de los polos del filtro. El panel inferior de la Figura 7.1 muestra que, en efecto, entre 1 Hz y 10 kHz ambas curvas normalizadas coinciden dentro de 0,40 dB.

Por encima de 15 kHz, sin embargo, divergen hasta 6,68 dB —exactamente la ganancia que aporta el potenciómetro—. Esta divergencia ocurre precisamente en la zona ya identificada como distorsionada (por encima de 1750 Hz, Sección 7.1), donde la tensión pico a pico medida deja de representar la amplitud de la componente fundamental. La interpretación consistente con los datos es que ese flanco superior depende del nivel de señal (la posición G = 2, con más del doble de amplitud de salida, entra antes en una zona no lineal del circuito o de la medición) y no de la respuesta propia del filtro. En consecuencia, el ancho de banda real del filtro es mayor que los ∼20 kHz medidos en G = 1, que a su vez ya es, por lo dicho arriba, una cota inferior.

# Capítulo 8

Cables de RF: Retardo Eléctrico,

# Pérdidas y Calibración de Distancia

En una prueba de banco con un blanco metálico a una distancia d conocida (Sección 2.5), la frecuencia de batido medida resultó sistemáticamente mayor que la predicha por la ecuación (2.19): un blanco a 1 m producía una f

∗
compatible con un blanco a varios metros. Este capítulo muestra que el desvío no es un error del modelo de la Sección 2.4 sino un término que faltaba: el retardo eléctrico de los cables coaxiles que conectan el splitter con las antenas. Se deduce ese término a partir de la misma ecuación de propagación ya usada en la Sección 1.2 (ecuación (1.2)), se cuantifica su efecto sobre la distancia estimada y el alcance no ambiguo, y se compara el juego de cables original contra uno nuevo, más corto, caracterizando ambos con un analizador de redes.

## 8.1. El mezclador ve una diferencia de retardo, no

## una distancia

El mezclador de un radar FMCW homodino no tiene forma de saber cuánto del retardo que ve entre sus dos entradas (RF y LO) proviene del trayecto por el aire hacia el blanco y cuánto proviene del cableado que llega hasta él. Ambos caminos comparten el mismo splitter de salida del VCO, pero después divergen:

Camino del LO (corto): splitter → cable de longitud LLO → entrada LO del mezclador. En el banco de esta tesis ese tramo no es un cable: el splitter y el mezclador van conectados directamente, con unos 5 cm de unión, de modo que LLO ≈ 0 (Sección 8.3.1).

Camino de RF (largo): splitter → cable de longitud LTX → antena transmisora

52

8.2. Velocidad de propagación en el cable: el factor de velocidad | 53

→ trayecto por el aire (ida y vuelta 2d) → antena receptora → cable de longitud LRX → LNA → entrada RF del mezclador.

Se conserva LLO en la formulación aunque en este montaje valga casi cero, porque es el término sobre el que se actúa si se quiere cancelar el offset por diseño (Sección 8.6).

La Figura 8.1 esquematiza ambos caminos. El retardo total que ve el mezclador es la suma del retardo eléctrico en los cables más el retardo de propagación por el aire:

τtotal =

LTX + LRX − LLO
vp
| | {z | }
| τcables

+

2d
c
|{z}
τblanco
, | (8.1)

donde vp es la velocidad de propagación dentro del dieléctrico del cable coaxil. Conviene definir el desbalance neto de cableado

D = LTX + LRX − LLO, | (8.2)

que es la magnitud relevante: no importan las longitudes absolutas de cada tramo, sino cuánto más largo es el camino de RF que el del LO. Si D = 0 (cables perfectamente balanceados) el término de cables desaparece y el mezclador mide únicamente τblanco, que es la situación que asume implícitamente la ecuación (2.19).

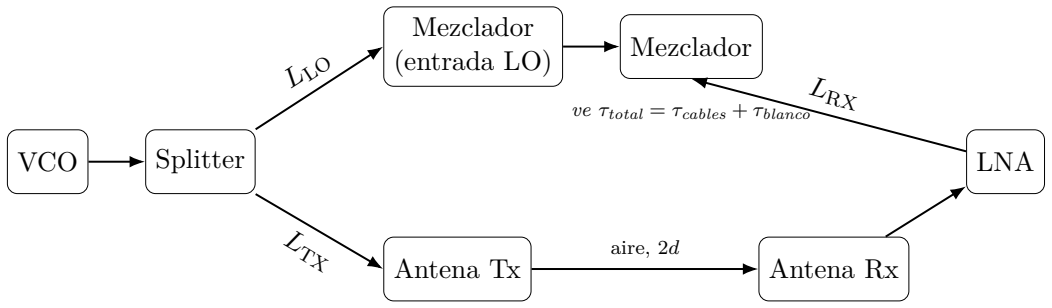
[picture p29: figure]
VCO; Splitter; Mezclador (entrada LO); Antena Tx; Antena Rx; LNA; Mezclador; LLO; LTX; aire, 2d; LRX; ve τtotal = τcables + τblanco

Figura 8.1: Los dos caminos que llegan al mezclador. El del LO es corto y fijo —en este banco, una conexión directa de ≈ 5 cm—; el de RF incluye los cables a las antenas más el trayecto por el aire. El mezclador solo puede medir la diferencia de retardo entre ambos, no el retardo absoluto de ninguno.

## 8.2. Velocidad de propagación en el cable: el factor

## de velocidad

La ecuación (1.2), ya usada para la propagación en el suelo, se aplica sin cambios al dieléctrico interno del cable coaxil: vp = c/√εr,cable. En cables de RF esta razón se expresa

54 Capítulo 8. Cables de RF: Retardo Eléctrico, Pérdidas y Calibración de Distancia

habitualmente como el factor de velocidad VF = vp/c = 1/

| √εr,cable, que el fabricante

especifica en la hoja de datos. La Tabla 8.1 resume valores nominales típicos según el dieléctrico.

Cuadro 8.1: Factor de velocidad nominal según el dieléctrico del cable coaxil (valores de catálogo típicos). Los medidos en los cables del banco están en la Tabla 8.5.

Dieléctrico | Cables típicos | VF
Polietileno sólido | RG-58, RG-213 ≈ 0,66
PTFE (teflón) sólido | Semirrígido | ≈ 0,70
Polietileno espumado | RG-8X espuma | ≈ 0,78

El cable es más lento que el aire. Con VF = 0,66, un metro de cable tarda lo mismo que 1/0,66 ≈ 1,52 m de aire: es la razón por la que el retardo de los cables pesa más de lo que la intuición geométrica sugiere.

## 8.3. Retardo neto y distancia aparente

Identificando en la ecuación (8.1) el término de cables y sustituyéndolo en la ecuación (2.18) (usando S = 2B/Tc, Sección 1.2), la frecuencia de batido medida es

f

∗
medido = S τtotal =

4Bd
c Tc
| {z }
f

∗(d), ec. (2.19)

+

2B
Tc

·

D
VF · c
| | {z | }
| foffset
. | (8.3)

Aplicando la inversión de la ecuación (2.20) a f

∗
medido, el offset en frecuencia se traduce en un offset constante en la distancia estimada, independiente de Tc y de d:
ˆd = d + doffset, | doffset =

D
2 VF
. | (8.4)

Es un corrimiento aditivo, no un factor de escala: la pendiente de ˆd respecto de d sigue

siendo 1. Esto explica una observación del banco que a primera vista resulta contraintuitiva: al acercar o alejar el blanco, la frecuencia de batido bajaba o subía exactamente como predice la ecuación (2.19) —el sistema medía bien— pero el valor absoluto de ˆd estaba

corrido por una constante ajena al blanco.

8.3. Retardo neto y distancia aparente | 55

### 8.3.1. Ejemplo numérico

Con los cables originales del banco —dos RG-58 desparejos, LTX = 3 m y LRX = 2,6 m— y VF = 0,66 (polietileno sólido, Tabla 8.1).

En este montaje el camino del LO no lleva cable: el splitter y el mezclador van conectados directamente, con unos 5 cm de unión. Ese tramo aporta 0,25 ns, es decir 3,8 cm de distancia aparente —bastante menos que la resolución de 14,4 cm del radar—, así que LLO es despreciable y D ≈ LTX + LRX = 5,55 m:

doffset =

5,55
2 × 0,66

≈ 4,20 m.

Que LLO sea despreciable es una mala noticia, no una simplificación afortunada: es el único término de la ecuación (8.2) que resta, y no está restando nada. Todo el cable de antena se paga entero.

Nótese además que esa ecuación solo pide la suma LTX +LRX: que los dos cables de antena sean de distinto largo no agrega ningún término. El desbalance que importa es el que hay entre el camino de RF y el del LO, no el que hay entre TX y RX.

Este offset es constante en distancia pero, al pasar por foffset = S D/(VF c), depende de Tc porque S depende de Tc. La Tabla 8.2 evalúa foffset y la f

∗
medido total esperada para un blanco a d = 1 m, con B = 1 GHz.

Cuadro 8.2: Frecuencia de batido esperada para un blanco a d = 1 m, con y sin el aporte de los cables originales (D = 5,55 m, VF = 0,66). doffset = 4,20 m es constante; lo que cambia con Tc es a cuántos Hz equivale. La fila de 100 ms es el Tc con el que mide el banco: 50 ms de subida y 50 de bajada.

Tc f

∗
(d = 1 m) | foffset | f

∗
medido
80 ms | 167 Hz | 701 Hz 868 Hz
100 ms | 133 Hz | 561 Hz 694 Hz
160 ms | 83 Hz | 351 Hz 434 Hz

La fila de Tc = 80 ms es la que se comparó contra el banco: el modelo predice 868 Hz para un blanco a 1 m, y lo observado en la medición superaba los 800 Hz. El acuerdo no debe leerse como más fino de lo que es: la tabla usa el VF de catálogo, y con el retardo medido con el analizador de redes el offset de este juego baja a 3,86 m (Sección 8.6.7). Pero deja el orden de magnitud fuera de discusión: el aporte de los cables es varias veces el del blanco.

56 Capítulo 8. Cables de RF: Retardo Eléctrico, Pérdidas y Calibración de Distancia

## 8.4. Corrección: calibración con un punto de distan-

## cia conocida

Como doffset es un corrido de origen y no una escala, alcanza con un único punto de calibración: colocar un blanco a una distancia dreal conocida, medir la ˆd cruda que entrega

el sistema, y restar:

d

medido

offset | = ˆd − dreal. | (8.5)

Con dos o más puntos a distancias distintas puede además ajustarse por cuadrados mínimos una recta ˆd = a dreal +b, lo que sirve como verificación: si el modelo de este capítulo

es correcto, a debe dar ≈ 1 y b debe coincidir con el doffset predicho por la ecuación (8.4) a partir de las longitudes de cable medidas físicamente. Un valor de a alejado de 1 señala que el problema no está en los cables sino en otro parámetro del sistema (por ejemplo, un Tc mal configurado respecto del que efectivamente entrega el generador).

## 8.5. Pérdidas de inserción: lo que los cables cuestan

## aparte del retardo

El retardo de los cables puede anularse por diseño, agregándole al camino del LO tanto cable como suman LTX + LRX para que D = 0 en la ecuación (8.2). La atenuación de los cables, en cambio, no se cancela nunca: cada tramo atenúa la señal que lo atraviesa sin importar cuánto midan los otros —y esa maniobra, de hecho, agrega atenuación en el LO en vez de quitarla. Un coaxil atenúa más cuanto:

más alta es la frecuencia (la pérdida por efecto pelicular en el conductor crece aproximadamente con √
f, y la pérdida en el dieléctrico crece aproximadamente en forma lineal con f);

más largo es el tramo (la atenuación en dB es proporcional a la longitud);

menor es el diámetro del conductor central y peor el dieléctrico (por eso el RG-213, con un conductor más grueso que el RG-58, atenúa menos por metro a igual frecuencia).

Esta pérdida golpea al sistema en dos lugares distintos de la cadena de la Figura 8.1: la atenuación de LTX resta potencia efectivamente radiada, y la de LRX resta señal a la entrada del LNA antes de que se amplifique, empeorando directamente la figura de ruido

8.6. Caracterización: cables originales vs. cables nuevos | 57

de toda la cadena. Acortar los cables reduce el retardo (Sección 8.3) y la atenuación al mismo tiempo: a diferencia de la elección de Tc (Capítulo 2), acá no hay dos efectos en sentidos opuestos que haya que balancear. El valor exacto de atenuación en la banda de 943 a 1982 MHz depende del cable concreto y se mide, no se supone: está en la Sección 8.6.2.

## 8.6. Caracterización: cables originales vs. cables nue-

## vos

Se armó un segundo juego de dos cables de 1 m en RG-213 para reemplazar los originales (RG-58 de 3 m y 2,6 m).

Por qué 1 m y no menos. El retardo mejora cuanto más corto sea el cable, así que el largo lo termina fijando un límite mecánico, no eléctrico: el RG-213 tiene 10 mm de diámetro y un radio de curvatura mínimo del orden de 75 mm, y por debajo de 1 m el tramo deja de tener juego suficiente para llegar a las antenas sin forzar los conectores ni tironear del montaje al mover el banco. Un cable más fino admitiría tramos más cortos, pero atenúa el doble por metro (Sección 8.6.2): 1 m de RG-213 es el punto donde las dos exigencias se cruzan.

Con Dnuevo = 2 × 1,0 − LLO, el offset de distancia cae de los 4,20 m del juego original a 1,48 m. La Tabla 8.3 muestra cuánto más se podría bajar interviniendo el camino del LO, que hoy es una conexión directa (LLO ≈ 5 cm) y es el único grado de libertad que queda una vez fijado el largo de los cables de antena.

Cuadro 8.3: Offset de distancia esperado con los cables nuevos (LTX = LRX = 1 m, VF = 0,66 nominal) según la longitud que se elija para el cable al LO.

LLO | Dnuevo | doffset

0,05 m (hoy) 1,95 m 1,48 m
0,5 m | 1,50 m 1,14 m
1,0 m | 1,00 m 0,76 m
2,0 m | 0 | 0

La última fila es la única que anula el offset de raíz, y no exige cables cortos sino emparejados: alcanza con darle al LO tanto cable como suman TX y RX. El costo es la atenuación que ese tramo le agrega al LO —unos 0,7 dB a 1,5 GHz con RG-213—, que el mezclador puede necesitar para conmutar bien.

Ojo con el signo si se toma ese camino. Alargar el LO es la única maniobra de este capítulo que puede pasarse de largo: si LLO terminara siendo mayor que LTX + LRX, D se vuelve negativo y con él doffset, y un blanco aparecería más cerca de lo que está en

58 Capítulo 8. Cables de RF: Retardo Eléctrico, Pérdidas y Calibración de Distancia

realidad en vez de más lejos. El error no es más grave que el actual —sigue siendo un offset constante, corregible con un punto de calibración— pero es mucho más confuso de diagnosticar, porque contradice la intuición de que “los cables alejan”. Conviene entonces cortar ese tramo con medida y no de más.

### 8.6.1. Procedimiento

1. Pérdida de inserción (S21) con el VNA. Hecho — Sección 8.6.2, Figura 8.2. Se barrió de 500 MHz a 2,5 GHz, más ancho que la banda del radar, para poder ajustar el modelo de atenuación sobre un tramo largo.
2. Retardo de grupo con el VNA. Hecho — Sección 8.6.4, Figura 8.4. El retardo sale de la pendiente de la fase de S21, con los cuatro parámetros S guardados en Touchstone (.s2p). Los largos físicos, medidos con cinta, coinciden aproximadamente con los nominales.
3. Calibración de un punto en el radar. Pendiente, ver Sección 8.6.8.
4. Espectro de batido, mismo blanco, los dos juegos de cables. Pendiente, ver Sección 8.6.8.

Los dos primeros pasos caracterizan los cables solos, con el analizador de redes, y son los que se reportan en lo que sigue. Los dos últimos miden el efecto de los cables sobre el radar completo.

### 8.6.2. Resultados: pérdida de inserción (VNA)

Se midieron los cuatro cables con un analizador de redes Agilent N9923A (FieldFox), de 500 a 2500 MHz en 801 puntos: los dos RG-58 del juego original (3 m y 2,6 m, uno por antena) y los dos RG-213 nuevos de 1 m, que se llaman A y B en lo que sigue. El equipo se calibró en dos puertos completos con QuickCal (IFBW = 1 kHz, promedio de 4 barridos) y cada cable se guardó con sus cuatro parámetros S en magnitud y fase. Una primera tanda de mediciones había exportado solo magnitud; con ella se estimó el retardo a partir del rizado de |S11|, y ese valor se conserva en la Figura 8.4 para comparar los dos métodos.

Los cables son recíprocos dentro de la medición: |S21| y |S12| difieren menos de 0,02 dB en los cuatro, que es una verificación de la calibración.

La Figura 8.2 muestra la pérdida de inserción. El panel izquierdo es lo que entrega el equipo: la pérdida total del conjunto cable más sus dos conectores. El derecho la normaliza por el largo, ajustando el modelo α(f) = a

√
f forzado por el origen, que es la forma que impone la pérdida por efecto pelicular descrita en la Sección 8.5.

8.6. Caracterización: cables originales vs. cables nuevos | 59

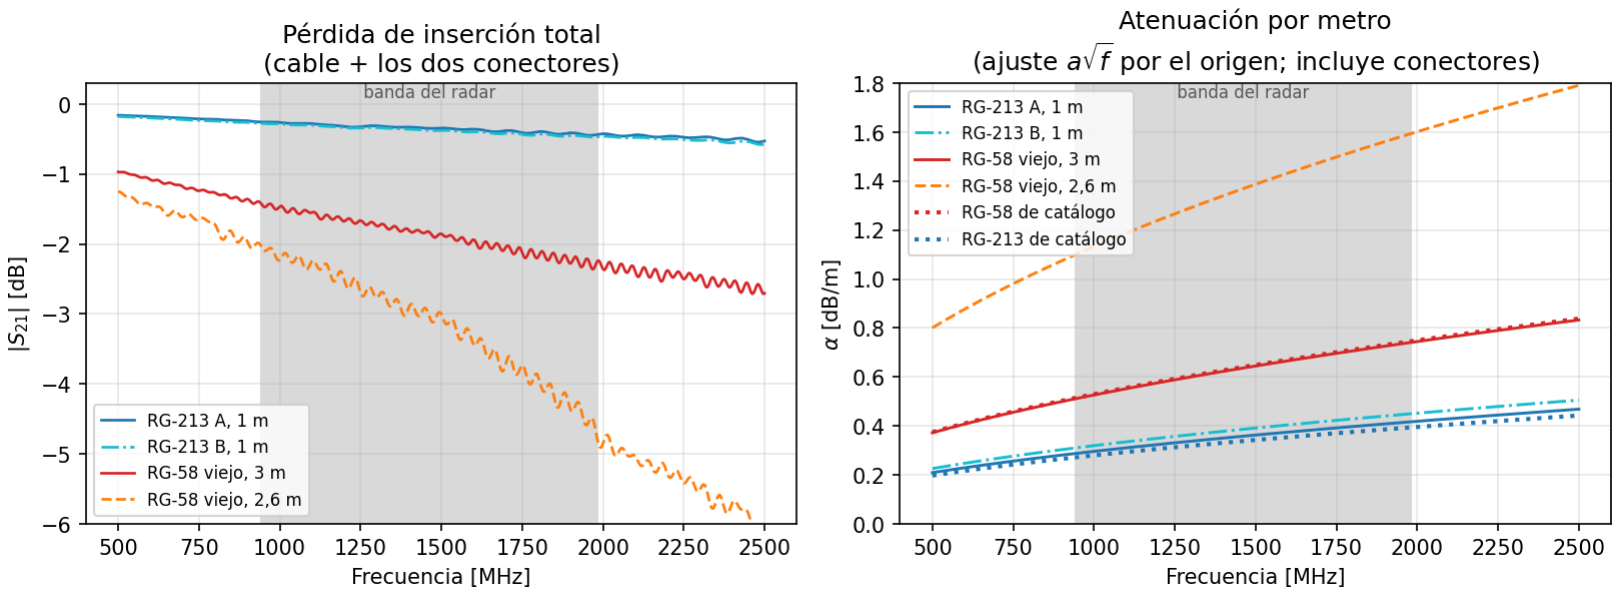
[picture p30: figure]

Figura 8.2: Pérdida de inserción medida con el VNA. Izquierda: pérdida total |S21| tal como se mide, cable más sus dos conectores; el rizado fino es la interferencia entre los dos conectores. Derecha: atenuación por metro ajustada como a

√
f por el origen, con los
valores de catálogo superpuestos en punteado. Los dos RG-213 y el RG-58 de 3 m caen sobre sus referencias de catálogo; el RG-58 de 2,6 m queda al doble y, a la izquierda, se curva hacia abajo en vez de seguir la raíz.

Por qué el ajuste se fuerza por el origen. Se probó primero con a

√
f + b, esperando
que el término constante b se quedara con lo que no depende del largo: los dos conectores y el desadaptado. No funciona. En una banda de apenas 500 a 2500 MHz, √
f y la constante
están demasiado correlacionadas para separarse, y b salió negativo en los cuatro cables (−0,15 en los dos RG-213, −0,48 en el RG-58 de 3 m y −3,43 dB en el de 2,6 m), lo que como pérdida de conector no existe: lo que hacía era absorber la desviación respecto de la raíz e inflarle a al cable. Forzado por el origen los números caen sobre el catálogo, como se ve en la figura. Queda dicho lo que el ajuste no hace: la pérdida de los conectores sigue adentro de α, repartida en el largo del cable. Separarla exige medir dos largos del mismo tipo de cable y restar.

Cuadro 8.4: Atenuación medida y de catálogo en la banda del radar. Los dos RG-213 difieren entre sí un 8 % y quedan a menos de un 15 % del catálogo con los conectores incluidos. El cable de 2,6 m atenúa el doble que su gemelo de 3 m, siendo el mismo tipo de cable.

Cable | α @ 1 GHz | Catálogo | α @ 1,46 GHz Total @ 1,46 GHz
RG-213 A, 1 m | 0,296 dB/m 0,28 dB/m | 0,358 dB/m | 0,36 dB
RG-213 B, 1 m | 0,320 dB/m 0,28 dB/m | 0,387 dB/m | 0,39 dB
RG-58 viejo, 3 m | 0,527 dB/m 0,53 dB/m | 0,637 dB/m | 1,91 dB
RG-58 viejo, 2,6 m 1,132 dB/m 0,53 dB/m | 1,369 dB/m | 3,56 dB

El cable de 2,6 m se supone en mal estado, por las tres razones que se reúnen en la Sección 8.6.5. Se lo grafica porque es uno de los dos cables que efectivamente estuvieron

60 Capítulo 8. Cables de RF: Retardo Eléctrico, Pérdidas y Calibración de Distancia

en el banco, pero no se lo usa para caracterizar al RG-58: para eso sirve el de 3 m, que sí se comporta como su hoja de datos.

### 8.6.3. Resultados: adaptación y pérdida de retorno

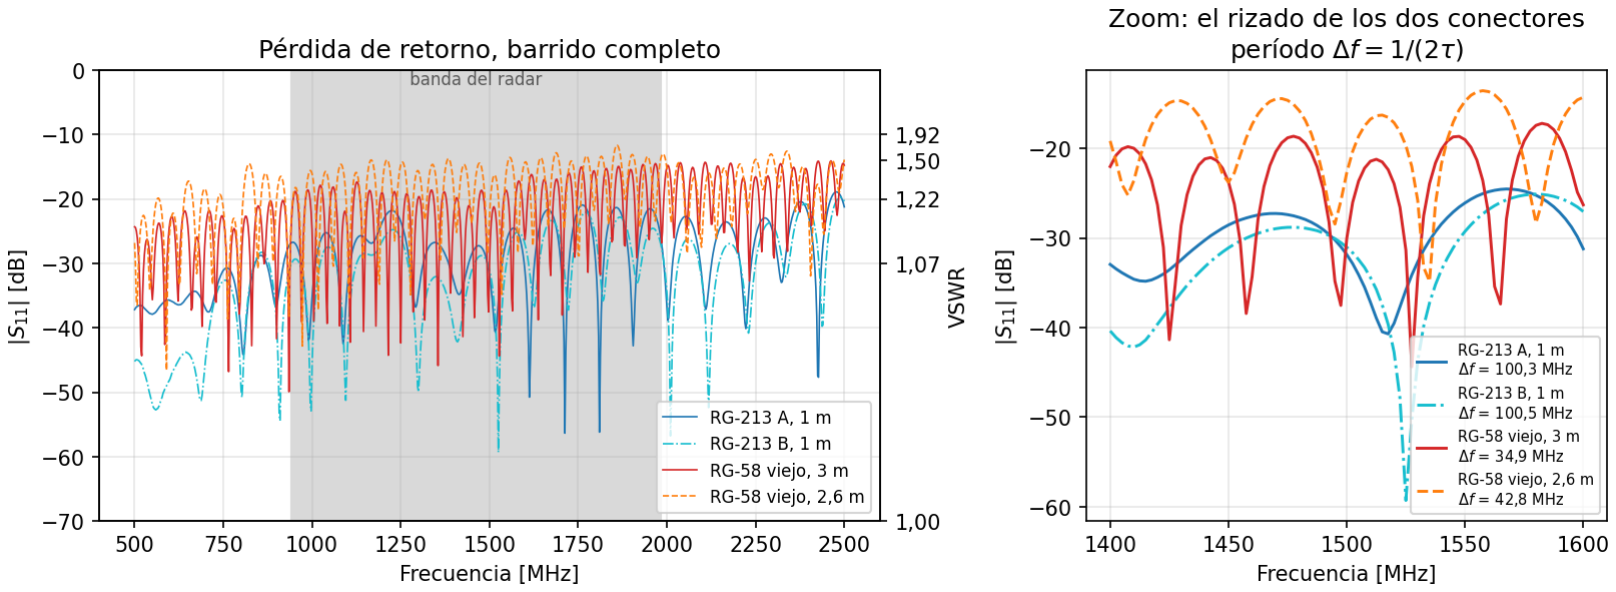
[picture p31: figure]

Figura 8.3: Pérdida de retorno. Izquierda: |S11| en todo el barrido, con la escala de VSWR equivalente a la derecha y la banda del radar sombreada. Derecha: zoom de 1400 a 1600 MHz. El rizado no es ruido: es la interferencia entre las reflexiones de los dos conectores, y su período vale ∆f = 1/(2τ ), con τ el retardo medido de la fase. A cable más largo, rizado más apretado.

Los dos RG-213 quedan por debajo de VSWR 1,20 en toda la banda del radar, y el RG-58 de 3 m por debajo de 1,46. El de 2,6 m llega a 1,71 (|S11| = −11,7 dB): es el peor de los cuatro, aunque sigue sin ser un desadaptado grave.

Los períodos del zoom cierran con el retardo que se mide por otro camino en la sección siguiente: 100 MHz en los cables de 1 m corresponden a τ = 5,0 ns, y 34,9 MHz en el de 3 m a 14,3 ns. El rizado contiene el retardo, y fue lo que permitió estimarlo en la primera tanda de mediciones, cuando todavía no se tenía la fase.

### 8.6.4. Resultados: retardo y VF real

Con la fase de S21 el retardo se mide directo: un cable ideal es un retardo puro, S21 = |S21| e

−jωτ , así que la fase desenrollada es una recta en ω y su pendiente, cambiada de

signo, es τ . Se ajustó esa recta sobre todo el barrido, de 500 a 2500 MHz. El desvío rms de la fase respecto de la recta indica cuánto se aparta el cable de un retardo puro, y resulta útil para diagnosticarlo.

Con S11 en magnitud y fase se puede además calcular la respuesta al impulso del cable: la transformada inversa de S11(f) muestra cada discontinuidad como un pico en su tiempo

8.6. Caracterización: cables originales vs. cables nuevos | 61

de ida y vuelta. Es el modo “dominio del tiempo” de un VNA, hecho fuera del equipo. Como el barrido es de banda pasante (500 a 2500 MHz) y se aplica ventana de Hann, la resolución es de un poco más de 1/BW = 0,5 ns de ida y vuelta.

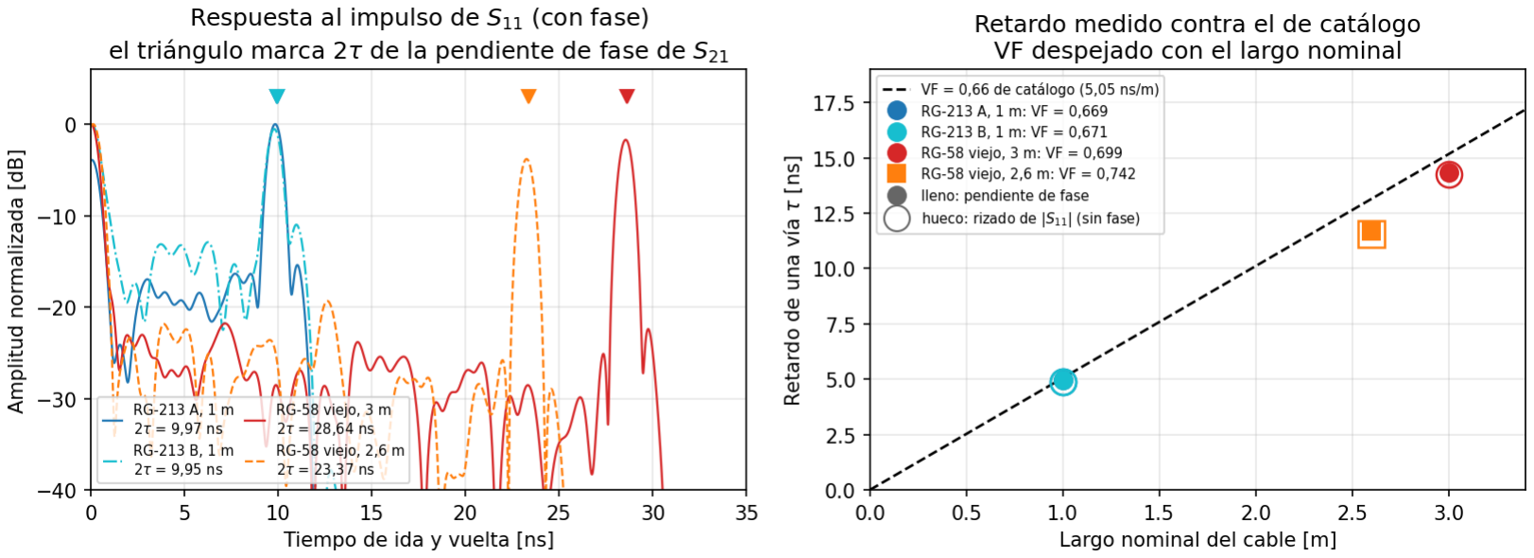
[picture p32: figure]

Figura 8.4: Izquierda: respuesta al impulso de S11 complejo, en dB respecto del pico mayor. Cada pico es una reflexión, ubicada en su tiempo de ida y vuelta; el triángulo marca 2τ tomado de la pendiente de fase de S21, y coincide con el eco del extremo en los cuatro cables. El RG-58 de 2,6 m (naranja) muestra además un pico a mitad de camino, en 12,6 ns. Derecha: retardo de una vía contra el largo nominal. Los símbolos llenos son la pendiente de fase y los huecos, el rizado de |S11|; la recta es el VF 0,66 de catálogo.

Los dos métodos coinciden. El eco del extremo cae exactamente donde lo pone la pendiente de fase, obtenida de otro parámetro (S21 y no S11), y el retardo del rizado difiere del de fase entre 0,05 y 0,12 ns, siempre dentro de la resolución de ±0,25 ns que se le había asignado a ese método. La diferencia está en la precisión: el ajuste de fase usa las 801 muestras y no depende de dónde cae un bin de la FFT.

Cuadro 8.5: Retardo medido de la pendiente de fase de S21. Las columnas de L y VF son dos lecturas del mismo dato: fijando el VF de catálogo se despeja el largo eléctrico, y fijando el largo nominal se despeja el VF. La última columna es el desvío rms de la fase respecto de un retardo puro.

Cable | τ | ns/m L si VF = 0,66 VF si L nominal Desvío de fase
RG-213 A, 1 m | 4,983 ns | 4,98 | 0,99 m | 0,669 | 0,09◦
RG-213 B, 1 m | 4,975 ns | 4,98 | 0,98 m | 0,671 | 0,08◦
RG-58 viejo, 3 m | 14,319 ns | 4,77 | 2,83 m | 0,699 | 0,37◦
RG-58 viejo, 2,6 m 11,686 ns | 4,49 | 2,31 m | 0,742 | 1,78◦

Los RG-213 confirman el catálogo. Los dos dan VF 0,67, a 1,5 % del 0,66 nominal, y difieren entre sí apenas 8 ps. Una diferencia de 1,5 % en un cable de 1 m son 1,5 cm de largo, que es del orden del error de medir el cable con cinta y de dónde se toma el plano de referencia de los conectores. Con fase, el primer valor que se había despejado del rizado (0,684) resulta ser error del método.

62 Capítulo 8. Cables de RF: Retardo Eléctrico, Pérdidas y Calibración de Distancia

Los RG-58 viejos dan más rápidos: 0,699 el de 3 m y 0,742 el de 2,6 m. Medidos con cinta, los dos cables tienen aproximadamente su largo nominal, así que la diferencia no se explica por el largo: para ajustarse al catálogo, el de 3 m tendría que medir unos 17 cm menos. En ese cable es probable que el dieléctrico no sea exactamente el del RG-58 de catálogo. El valor del de 2,6 m no es físico para polietileno sólido y se trata en la sección siguiente. Aun así, todos los cálculos de diseño de este capítulo siguen usando el VF nominal 0,66: es el valor que se conoce sin medir, y el offset real del banco se corrige igual con la calibración de la Sección 8.4.

### 8.6.5. El cable de 2,6 m: por qué se lo supone en mal estado

El cable de 2,6 m es uno de los dos que estuvieron en el banco, del lado de RX, y se sospechaba de él antes de medirlo. Las mediciones muestran tres indicios independientes, cada uno en un parámetro distinto:

1. Atenúa el doble de lo que le corresponde, y no con la forma de un cable. Da 1,13 dB/m a 1 GHz contra los 0,53 del catálogo y los 0,527 que midió su gemelo de 3 m (Tabla 8.4). Aun siendo 40 cm más corto, pierde 3,56 dB en el centro de la banda contra 1,91. Además, la pérdida no crece como √
f: en la Figura 8.2 la
curva se dobla hacia abajo, y el ajuste libre a

√
f + b necesita un término constante de −3,43 dB para seguirla, siete veces el del RG-58 sano. El efecto pelicular y el dieléctrico por sí solos no dan esa forma.
2. Es el peor adaptado de los cuatro. |S11| llega a −11,7 dB (VSWR 1,71) en la banda del radar, contra −14,5 dB del RG-58 de 3 m y −21 dB de los RG-213 (Figura 8.3). Refleja más en sus extremos, que es lo que se espera de un conector mal armado o flojo.
3. Su retardo no es el de un cable sano. La fase de S21 se aparta 1,78◦
rms de un
retardo puro, cinco veces más que el RG-58 de 3 m y veinte veces más que los RG-213 (Tabla 8.5). El VF que se despeja, 0,742, no es posible en polietileno sólido. Y en la respuesta al impulso (Figura 8.4) aparece una reflexión dentro del cable, unos 15 dB por debajo del eco del extremo. Esa reflexión se ve desde los dos puertos: en 12,63 ns desde el puerto 1 y en 10,77 ns desde el puerto 2. Las dos lecturas suman 23,40 ns, igual a los 2τ = 23,37 ns del cable, así que no es un artefacto de la transformada: es un punto físico, a unos 1,4 m de un extremo y 1,2 m del otro.

Los dos primeros indicios son compatibles con un conector en mal estado, que era la hipótesis inicial. El tercero sugiere que el daño no está solo en los extremos: una discontinuidad a mitad del cable puede ser un aplastamiento, un doblez por debajo del radio mínimo o

8.6. Caracterización: cables originales vs. cables nuevos | 63

un empalme. Conviene no sobreinterpretarlo. El RG-58 de 3 m, que en todo lo demás se comporta bien, muestra un par de reflexiones internas del mismo tipo, unos 5 dB más débiles respecto de su propio eco del extremo. Además, una reflexión chica no alcanza para explicar por sí sola los 1,9 dB que pierde de más en el centro de la banda: un daño con pérdida puede reflejar poco.

La conclusión práctica es la misma en cualquier caso: el cable de 2,6 m no representa al RG-58 y no conviene volver a usarlo en el banco. Que el defecto esté en un conector o en el cable solo decide si vale la pena rearmarlo.

### 8.6.6. Consecuencias para el radar

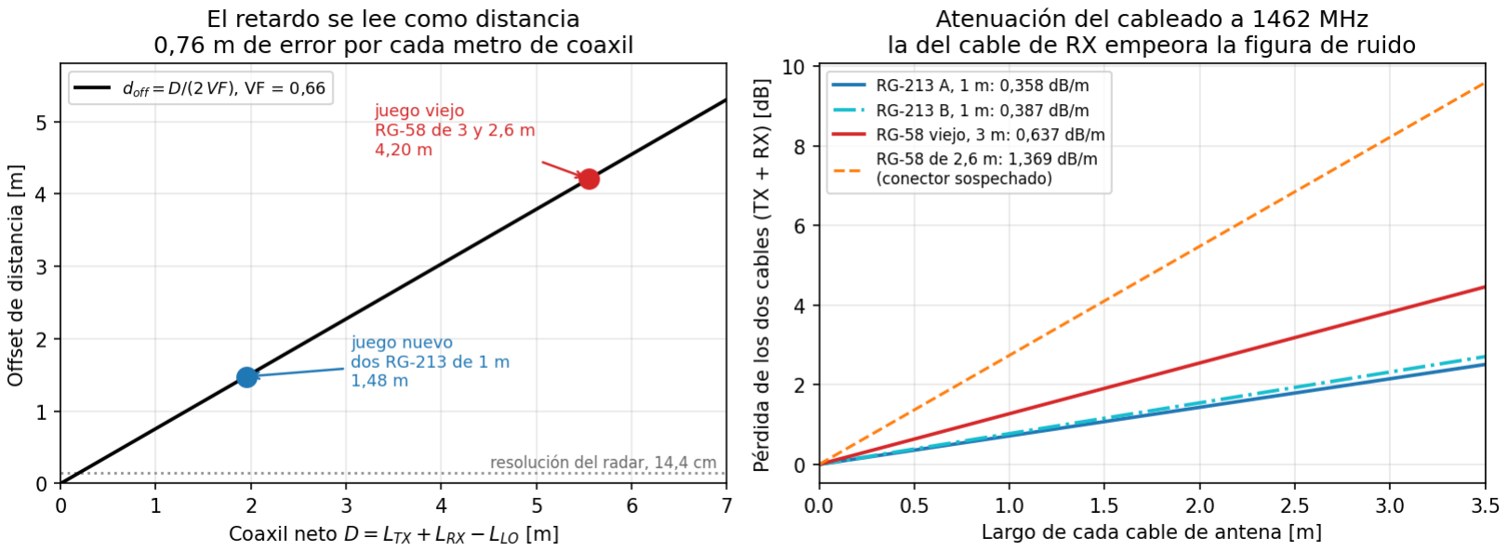
[picture p33: figure]

Figura 8.5: Lo que el cableado le cuesta al radar. Izquierda: offset de distancia doffset = D/(2 VF) con el VF 0,66 de catálogo, según el coaxil neto D, con los dos juegos de cables marcados. Derecha: pérdida de un par de cables (TX más RX) en el centro de la banda, 1462 MHz, en función del largo de cada uno, con la atenuación por metro medida en cada cable. La recta del RG-58 de 2,6 m es la del cable dañado (Sección 8.6.5), no la de un RG-58.

Los dos costos se leen por separado. En retardo, cambiar los RG-58 de 3 y 2,6 m por los dos RG-213 de 1 m baja el offset de 4,20 m a 1,48 m con los valores de catálogo, o de 3,86 m a 1,45 m con los retardos medidos (Tabla 8.6). Sigue siendo diez veces la resolución de 14,4 cm, así que acortar los cables no reemplaza a la calibración de la Sección 8.4: solo la vuelve una corrección más chica. Lo único que anula el offset de raíz es emparejar el LO (Tabla 8.3).

En atenuación, el par original costaba 5,5 dB a 1,46 GHz contra los 0,75 dB del par nuevo. De esos 4,7 dB recuperados, sin embargo, solo una parte es mérito del RG-213: dos RG-58 sanos de esos largos habrían costado 3,6 dB, así que 1,9 dB los estaba perdiendo el cable de 2,6 m en mal estado y se habrían recuperado con solo reemplazarlo. La mitad de la mejora cae delante del LNA, donde se descuenta uno a uno de la figura de ruido de

64 Capítulo 8. Cables de RF: Retardo Eléctrico, Pérdidas y Calibración de Distancia

toda la cadena.

### 8.6.7. Comparación teoría vs. práctica: tabla resumen

Cuadro 8.6: Resumen comparativo entre el valor teórico (predicho por las ecuaciones de este capítulo, a partir de las longitudes nominales y el VF de catálogo) y el valor medido con el VNA a partir de la fase de S21, para ambos juegos de cables.

Juego original (2 RG-58) Juego nuevo (2 RG-213)

| Teoría | Medido | Teoría | Medido
VF | 0,66* | 0,70 / 0,74† | 0,66* | 0,67†
τTX + τRX [ns] | 28,3 | 26,0 | 10,1 | 9,96
LTX + LRX [m] | 5,60 | 5,15 | 2,00 | 1,97
doffset [m]§ | 4,20 | 3,86 | 1,48 | 1,45
Pérdida del par @ 1,46 GHz [dB] 3,59 | 5,47‡ | 0,68 | 0,75

*Valor nominal de catálogo (Tabla 8.1), que es el que se usa en todos los cálculos de diseño de

este capítulo.
†Despejado del retardo de fase suponiendo el largo nominal de cada cable, que coincide aproxi-

madamente con el medido con cinta; en el juego original, 3 m y 2,6 m por separado. Para diseño se sigue usando el nominal — ver Sección 8.6.4.
‡
Incluye el cable de 2,6 m en mal estado (Sección 8.6.5), que por sí solo aporta 3,56 dB de los 5,47. Dos RG-58 sanos de esos largos habrían costado 3,6 dB, extrapolando el α medido del cable de 3 m.
§El camino del LO es una conexión directa de ≈ 5 cm, que aporta 0,25 ns: se lo resta en las

dos columnas, pero equivale a 3,8 cm y no cambia ninguna conclusión. La columna “medido” no depende, entonces, de ningún valor supuesto.

El offset medido no depende de suponer nada, y eso lo hace el número más sólido de la tabla: sale de multiplicar el retardo de fase por c0/2, sin pasar por el factor de velocidad ni por el largo de cinta métrica. En el juego nuevo da 1,45 m contra 1,48 m de la ecuación (8.4), un 2 % de diferencia. En el original da 3,86 m contra 4,20, un 8 % menos.

El del juego original cierra además con una estimación completamente independiente, hecha en el banco antes de tener el VNA: con Tc = 80 ms, una placa a 1 m daba algo más de 800 Hz, de donde el offset resultaba ≈ 3,6 m. Tres caminos que no comparten ni el instrumento ni el método —la ecuación, el VNA y el propio radar— caen dentro de un 15 %, con los dos valores experimentales por debajo del teórico y a un 7 % entre sí.

La diferencia entre los dos juegos está en los cables, no en la ecuación. Los RG-213 miden el VF de catálogo (Tabla 8.5), y con ellos teoría y medición coinciden. Los RG-58 viejos miden más rápidos que el nominal, y el de 2,6 m bastante más, por el daño descripto en la Sección 8.6.5. Por eso con ese juego la teoría queda alta. El largo no es la causa: medidos con cinta, los cables tienen aproximadamente su largo nominal.

8.7. Conclusiones del capítulo | 65

### 8.6.8. Mediciones pendientes con el radar

Todo lo anterior caracteriza los cables solos, con el analizador de redes. Faltan los dos pasos del procedimiento que miden su efecto sobre el radar completo, y que requieren el banco armado con cada juego de cables:

Calibración de un punto con cada juego. Repetir el procedimiento de la Sección 8.4 con un blanco a distancia conocida, con los cables originales y con los nuevos, y comparar el d

medido
offset contra la columna “medido” de la Tabla 8.6. Con dos puntos a distancias distintas, verificar además que la pendiente dé ≈ 1.

Espectro de batido con el mismo blanco. Con un blanco fijo a la misma distancia, capturar el espectro con cada juego de cables y reportar la posición del pico, su ancho a −3 dB y el piso de ruido.

En esa segunda comparación se superponen dos efectos que conviene no confundir. Acortar el cable corre el pico, por el menor retardo (Sección 8.3). Y al reducir la atenuación puede subir la relación señal a ruido, por la menor pérdida antes del LNA (Sección 8.5). El primero se lee en el eje de frecuencia y el segundo en el de amplitud, así que la comparación debe reportarlos por separado y no como un único número. Con los valores medidos, se espera que el pico se corra unos 2,4 m de distancia aparente y que la señal suba del orden de 4,7 dB, de los cuales 1,9 se deben a haber sacado el cable dañado.

## 8.7. Conclusiones del capítulo

Un radar FMCW mide diferencias de retardo, no distancias. Los cables de antena se suman al retardo del blanco como un offset constante, doffset = D/(2 VF), que no cambia la pendiente ni la resolución. Es lo que explica el desvío observado en la prueba de validación.

El offset está medido sin suponer nada. Con la fase de S21 da 3,86 m para el juego original y 1,45 m para el nuevo, a menos de un 8 % y un 2 % del modelo con valores de catálogo.

Los cables nuevos mejoran las dos cosas a la vez. Bajan el offset de 3,86 a 1,45 m y recuperan 4,7 dB de pérdida, la mitad delante del LNA.

Acortar no alcanza para dejar de calibrar. El offset de los cables nuevos sigue siendo diez veces la resolución. Hace falta un punto de calibración, o emparejar el camino del LO para anularlo de raíz.

66 Capítulo 8. Cables de RF: Retardo Eléctrico, Pérdidas y Calibración de Distancia

El RG-58 de 2,6 m está dañado y no debe volver al banco. Solo ese cable explicaba 1,9 dB de pérdida.

# Capítulo 9

# Procesamiento de la Señal de Batido

Los capítulos anteriores llegan hasta la salida del mezclador: una tensión que, para cada blanco, oscila a una frecuencia de batido proporcional a su distancia (ecuación (2.18)). Este capítulo describe todo lo que pasa desde que esa tensión se digitaliza hasta que aparece como una fila del radargrama y una distancia en pantalla. Es el núcleo del procesamiento del sistema.

La cadena está repartida en dos lugares. En el microcontrolador (firmware/adquisicion/ adquisicion.ino) se muestrea, se filtra y se diezma la señal, y se lee la triangular del

generador. En la PC (analisis/vivo_rapido.py y analisis/proceso_rapido.py) se reconstruye el sincronismo, se cortan las rampas, se corrige la no linealidad del VCO, se calcula el espectro de cada rampa y se promedian varias rampas para formar cada fila.

Cada etapa se presenta con su fundamento matemático, su implementación y lo que se verificó de ella. La Tabla 9.1 reúne los valores numéricos que se usan a lo largo del capítulo.

67

68 | Capítulo 9. Procesamiento de la Señal de Batido

Cuadro 9.1: Parámetros de la cadena de procesamiento en el banco de laboratorio (generador con Tc = 100 ms). Los valores medidos salen del encabezado de la captura de la placa a 90 cm del 28/09/2026.

Símbolo | Magnitud | Valor
Tc | Período de la triangular (medido) | 99,986 ms
Tr = Tc/2 | Duración de una rampa | 49,993 ms
FADC | Muestreo del PCM1808 | 48 000 sps
M | Factor de diezmado | 8
Fs | Muestreo de salida | 6000 sps
n | Muestras por rampa (TrFs) | 300
NFFT | Largo de la FFT (relleno ×8) | 2400
B | Ancho de banda barrido (curva del VCO) | 1039,6 MHz
α0 = B/Tr | Pendiente del barrido | 2,079 × 10¹⁰ Hz/s
2α0/c | Frecuencia de batido por metro | 138,6 Hz/m
δd = c/(2B) Resolución en distancia | 14,4 cm
dmax | Alcance no ambiguo (Fs/2) | 21,6 m aparentes
N | Rampas por fila (por defecto) | 8 (0,4 s)

La pendiente α0 es la misma tasa de barrido S = 2B/Tc del Capítulo 2: como cada rampa dura Tr = Tc/2, α0 = B/Tr = 2B/Tc. En el código se la llama alpha0, y así se la nombra en este capítulo.

## 9.1. Visión general de la cadena

La Figura 9.1 muestra la cadena completa. Hay dos flujos de datos que viajan juntos por el mismo puerto USB:

El batido: 6000 muestras por segundo, ya filtradas y diezmadas en la placa. Es la señal que se mide.

La triangular: una lectura del ADC del ESP32-C3 por cada bloque de DMA, unas 187,5 por segundo. No se mide nada con ella: sirve para saber dónde empieza cada rampa, o sea para reconstruir el sincronismo.

En la PC, un hilo dedicado vacía el puerto y separa los dos flujos. El hilo del gráfico, cada 200 ms, toma todas las rampas completas que llegaron, las procesa en lote y redibuja.

9.1. Visión general de la cadena | 69

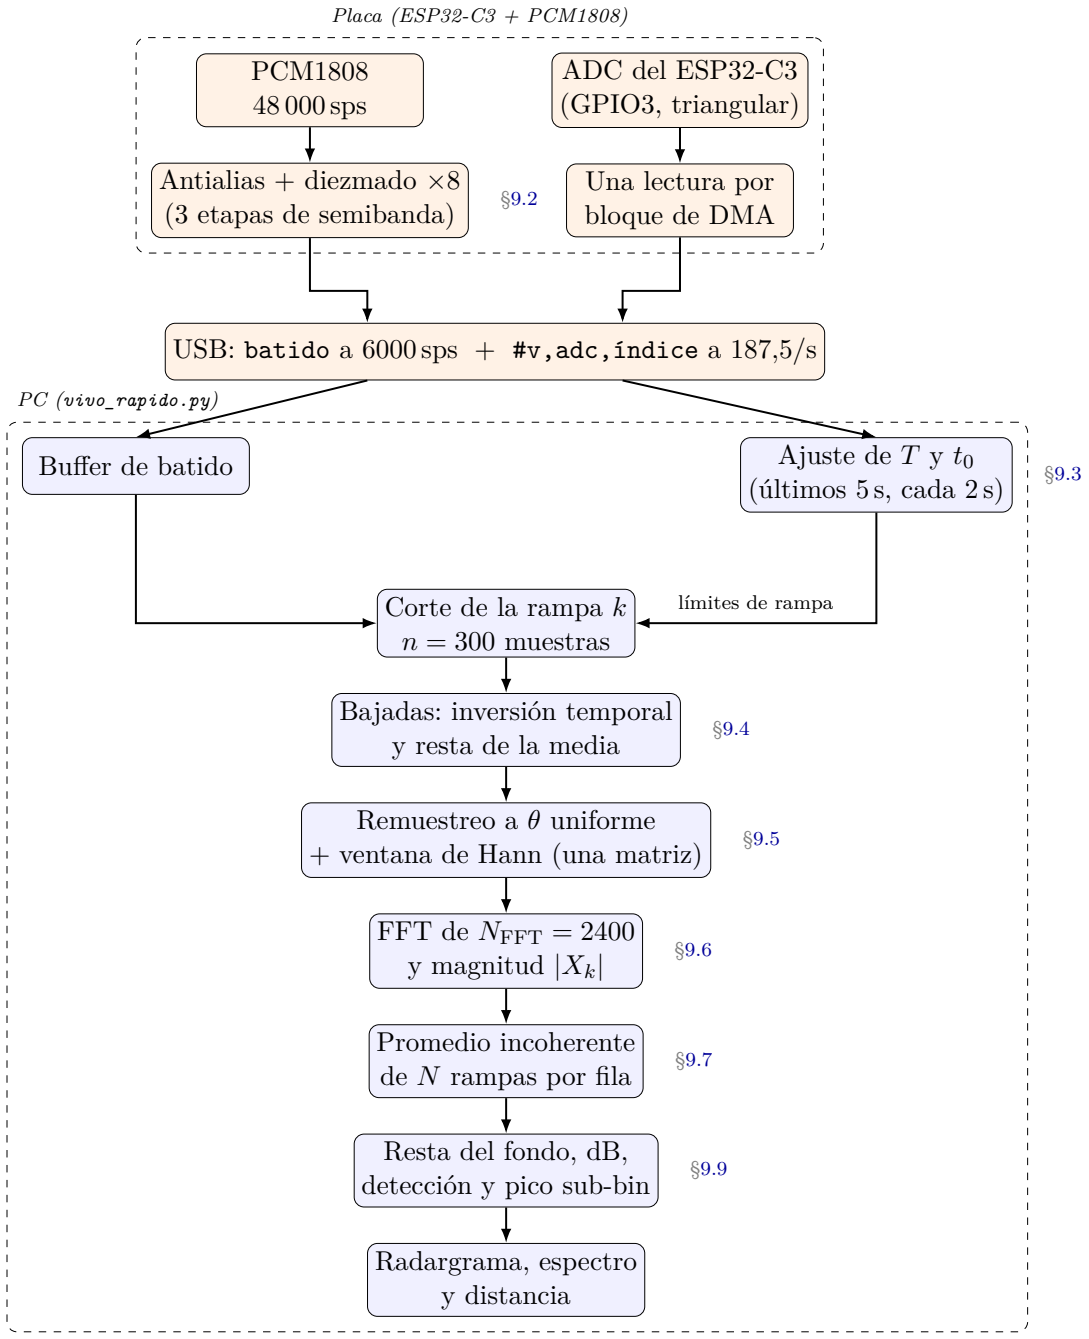
[picture p34: figure]
PCM1808 48 000 sps; Antialias + diezmado ×8 (3 etapas de semibanda); ADC del ESP32-C3 (GPIO3, triangular); Una lectura por bloque de DMA; Buffer de batido; Ajuste de T y t0; (últimos 5 s, cada 2 s); Corte de la rampa k n = 300 muestras; límites de rampa; Bajadas: inversión temporal y resta de la media; Remuestreo a θ uniforme + ventana de Hann (una matriz); FFT de NFFT = 2400 y magnitud |Xk|; Promedio incoherente de N rampas por fila; Resta del fondo, dB, detección y pico sub-bin; Radargrama, espectro y distancia; Placa (ESP32-C3 + PCM1808); PC (vivo_rapido.py)

USB: batido a 6000 sps + #v,adc,índice a 187,5/s

Figura 9.1: Cadena de procesamiento completa. En naranja lo que corre en la placa; en azul lo que corre en la PC. A la derecha de cada bloque, la sección donde se describe.

70 | Capítulo 9. Procesamiento de la Señal de Batido

## 9.2. Adquisición: sobremuestreo y diezmado

### 9.2.1. El problema del aliasing

Muestrear a Fs sólo representa sin ambigüedad las frecuencias por debajo de Fs/2. Cualquier componente por encima se pliega: una frecuencia f > Fs/2 aparece en |f − kFs| para el k que la lleva a [0, Fs/2]. En un radar FMCW eso es especialmente grave, porque la frecuencia es la distancia: un tono plegado se ve exactamente igual que un blanco real a una distancia que no existe.

Para una rampa de 50 ms alcanza con Fs = 6000 sps: con 138,6 Hz/m, el Nyquist de 3000 Hz corresponde a 21,6 m aparentes, holgadamente más allá de cualquier blanco del banco. Pero muestrear directamente a 6000 sps exigiría un filtro antialias analógico que dejara pasar hasta ∼ 2,5 kHz y eliminara todo por encima de 3 kHz: una transición de pocos cientos de hertz, que en analógico es cara, sensible a tolerancias y con mucha distorsión de fase.

### 9.2.2. La solución: muestrear rápido y filtrar en digital

El PCM1808 muestrea a FADC = 48 000 sps, ocho veces más de lo necesario (sobremuestreo). A esa tasa el Nyquist está en 24 kHz y el antialias analógico es trivial; de hecho ya lo resuelve internamente el propio PCM1808, con su filtro analógico y el sobremuestreo 64× de su modulador ∆Σ (Sección 3.1). Después, el ESP32-C3 hace en digital el filtrado abrupto que en analógico era difícil y recién entonces reduce la tasa (diezmado).

Diezmar por M es quedarse con una de cada M muestras de la señal ya filtrada:

y[m] = X

i

h[i] x[Mm − i], | (9.1)

y su espectro es la suma de M copias desplazadas del espectro filtrado Crochiere1983, Proakis2006:

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
j(ω−2πk)/M
X
e

j(ω−2πk)/M
. | (9.2)

Las copias con k ̸= 0 son el aliasing. Desaparecen sólo si H(e jω) ≈ 0 para |ω| > π/M: el

filtro h es el antialias, y su calidad decide cuánto se pliega.

### 9.2.3. Por qué el promedio simple no alcanza

La primera versión del firmware diezmaba promediando M muestras, que es un filtro h[i] = 1/M de respuesta |H(e

jω)| = |sin(Mω/2)/(M sin(ω/2))|. Sus lóbulos laterales caen

9.2. Adquisición: sobremuestreo y diezmado | 71

muy despacio: un tono de 5 kHz se plegaba sobre 1 kHz de la salida atenuado apenas 14 dB. En la captura del banco había energía hasta el Nyquist mismo, que es justamente la firma de algo plegándose.

### 9.2.4. Cascada de filtros de semibanda

El firmware actual divide por 8 en tres etapas de ×2 (Figura 9.2), cada una con un filtro de semibanda de L = 31 coeficientes. Un filtro de semibanda es un FIR simétrico que corta exactamente en la mitad de su Nyquist y cuya respuesta cumple

H

e

jω
+ H
e

j(π−ω)

= 1 | (9.3)

(en fase cero). En el dominio del tiempo eso equivale a que el coeficiente central vale 1/2 y todos los coeficientes pares respecto del centro son cero, salvo el central: de los 31, 14 son ceros exactos Crochiere1983. Además, como cada etapa descarta la mitad de sus salidas, sólo se calculan las que se conservan. El costo total es de ∼ 1,3 millones de multiplicaciones por segundo, alrededor del 7 % del microcontrolador.

x[n] | Hsb | ↓ 2 | Hsb | ↓ 2 | Hsb | ↓ 2 | y[m]

48 k

24 k | 12 k
| | | | | | | 6 k

Figura 9.2: Diezmado ×8 en tres etapas de semibanda. Cada etapa elimina todo lo que se plegaría en la división por dos siguiente.

La Tabla 9.2 compara el rechazo de las dos soluciones para tonos que caerían plegados sobre la banda útil.

Cuadro 9.2: Atenuación de los tonos que se pliegan sobre cada frecuencia de la salida, a 48 kHz con M = 8.

Frecuencia de salida Promedio de 8 Cascada de semibanda

500 Hz | −20,7 dB | −90,5 dB
1000 Hz | −14,2 dB | −87,4 dB
2000 Hz | −7,6 dB | −71,1 dB

Por encima de 2400 Hz el rechazo se degrada: es la banda de transición de la última etapa, simétrica alrededor de 3000 Hz por la propiedad (9.3). La banda limpia va de 0 a 2400 Hz, que a 138,6 Hz/m son 17,3 m aparentes. El rizado en esa banda es de 0,004 dB y la ganancia en continua es exactamente 1: los coeficientes están en formato Q30 y suman 2

30 exacto. El código del filtro se verificó compilándolo con gcc contra una referencia en

Python, con coincidencia bit a bit.

72 | Capítulo 9. Procesamiento de la Señal de Batido

### 9.2.5. Ganancia de relación señal a ruido

El sobremuestreo tiene además un beneficio de ruido. Si el ruido que llega al ADC es blanco hasta 24 kHz, su potencia se reparte en FADC/2; el filtro conserva sólo Fs/2 de ese ancho y descarta el resto en lugar de plegarlo sobre la banda. La mejora es

∆SNR = 10 log10

FADC
Fs
= 10 log10 8 ≈ 9 dB. | (9.4)

Esta cuenta vale para el ruido de banda ancha. El ruido que ya está dentro de la banda útil no cambia.

### 9.2.6. El precio: retardo de grupo

Un FIR simétrico de L coeficientes retrasa la señal (L − 1)/2 muestras de su propia entrada. Referido a 48 kHz, la cascada retrasa

τFIR = 15 (1 + 2 + 4) = 15 (M − 1) = 105 muestras = 2,19 ms ≈ 13 muestras de salida. (9.5)
Eso importa para el sincronismo: la triangular se lee en tiempo real, pero la muestra de batido que sale en ese instante corresponde a 2,2 ms antes. Sin compensarlo, los límites de rampa quedan corridos un 4,4 % de una rampa de 50 ms. El firmware suma ese retardo al índice que emite con cada lectura de la triangular y lo informa con la línea # retardo

= 13 muestras.

## 9.3. Sincronismo a partir de la triangular

### 9.3.1. Qué hace falta y qué hay

La FFT de la Sección 9.6 se aplica a una rampa por vez. Para cortarlas hay que saber en qué muestra de batido empieza cada una: eso es el sincronismo. El generador de laboratorio tiene una salida de sincronismo, pero no entrega señal en este banco. En su lugar, la propia triangular que sintoniza el VCO se lleva, a través de un divisor 4,7 kΩ/4,7 kΩ, al ADC del ESP32-C3 en GPIO3.

El firmware lee ese pin una vez por bloque de DMA, de 256 muestras a 48 kHz, o sea 187,5 lecturas por segundo, y emite #v,<adc>,<índice>. El índice es la muestra de batido que corresponde a ese instante, ya corregida por el retardo del filtro. Así las dos señales quedan en la misma escala de tiempo.

Con Tc = 100 ms eso da apenas ∼ 19 lecturas por período: muy pocas para ubicar cada

9.3. Sincronismo a partir de la triangular | 73

vértice de forma individual. Por eso el sincronismo no se detecta vértice por vértice, sino que se ajusta un modelo a muchos períodos a la vez.

### 9.3.2. Modelo y ajuste

Se modela la triangular leída como

v(t) = A Λ

t − t0
T
+ ¯v + ruido, | (9.6)

donde Λ(u) es la onda triangular de período 1 con mínimo en u = 0, T es el período completo y t0 el instante de un mínimo, o sea el comienzo de una subida. Λ es par, y su serie de Fourier tiene sólo armónicos impares:

Λ(u) = 1
2

−

4
π

2

X

k impar

cos(2πku)
k

2

. | (9.7)

El ajuste tiene dos pasos.

### 1. Búsqueda gruesa del período, sin suponer nada. Las lecturas se interpolan a

una grilla uniforme, se les resta la media y se calcula su FFT con ventana de Hann. El período es la inversa del máximo espectral entre 1/200 ms y 1/12 ms (buscar_periodo()). No hay riesgo de engancharse en un armónico: por (9.7) la triangular no tiene segundo armónico y el tercero tiene 1/9 de la amplitud del primero.

Este paso existe por un error que ya ocurrió. Una versión anterior buscaba sólo ±25 % alrededor del período nominal; el período real quedaba afuera y el ajuste devolvía un submúltiplo estable, preciso y falso.

### 2. Refinamiento del período y la fase. Se maximiza la magnitud del primer armónico

S(T) = X

i

vi − v¯
e
−j2πti/T | (9.8)

sobre las lecturas (ti

, vi) de los últimos 5 s, unos 50 períodos. El período que maximiza |S(T)| es el que pone en fase a todos los períodos de la ventana a la vez. Primero se recorre una grilla de ±1 % alrededor del valor anterior (±10 % alrededor de la búsqueda gruesa, la primera vez), con cuatro puntos por lóbulo principal; el lóbulo mide ∼ 1/Nper en valor relativo. Después se refina con sección áurea dentro de ±1 paso de la grilla.

Con el período fijado, la fase sale del argumento de S. Reemplazando el modelo (9.6)

74 | Capítulo 9. Procesamiento de la Señal de Batido

en (9.8) y conservando el primer armónico de (9.7):

S(T) ≈

Nlect
2

A c1 e

−j2πt0/T , | c1 = −

4
π

2

< 0, | (9.9)

y como c1 es negativo,

arg S = π −

2πt0
T

=⇒ t0 =

T
2π
π − arg S
m´od T. | (9.10)

El signo importa. Invertirlo devuelve T − t0 en lugar de t0, o sea toma la bajada por subida, y no se nota en ningún otro número porque el período sale bien igual.

Por qué un ajuste global. Ajustar un solo período a 50 períodos usa toda la ventana como brazo de palanca: el error de T se reparte entre todas las lecturas en vez de depender de un vértice. Sobre triangulares sintéticas a 100 ms, el período sale con un error de ∼ 17 ppm y el vértice con ∼ 12 µs, contra 167 µs de una muestra de batido. El ajuste vectorizado tarda 4 ms contra 105 ms de la versión original, y da el mismo período dentro de 5 ppm.

Por qué se rehace cada 2 s. El inicio de la rampa k se calcula multiplicando el período por k, así que un error residual δT produce un error de límite que crece linealmente desde el último ajuste:

δtk = δt0 + k

δT
2
. | (9.11)

Medido con 200 ppm de deriva de reloj, el error de límite es de 9 µs (0,05 % de la rampa) con reajuste cada 2 s, y de 1095 µs (5,4 %) a los 60 s sin reajuste.

### 9.3.3. Límites de rampa

Con T y t0, la rampa k empieza en la muestra

mk = roundt0 + k

T
2
Fs

, n = round

T
2

Fs

= 300, | (9.12)

con k par para las subidas y k impar para las bajadas (Figura 9.3). El largo n tiene histéresis: se cambia sólo si T Fs/2 se aleja más de 0,6 muestras del valor vigente, para que todos los perfiles tengan el mismo largo.

9.4. Formación de cada rampa | 75

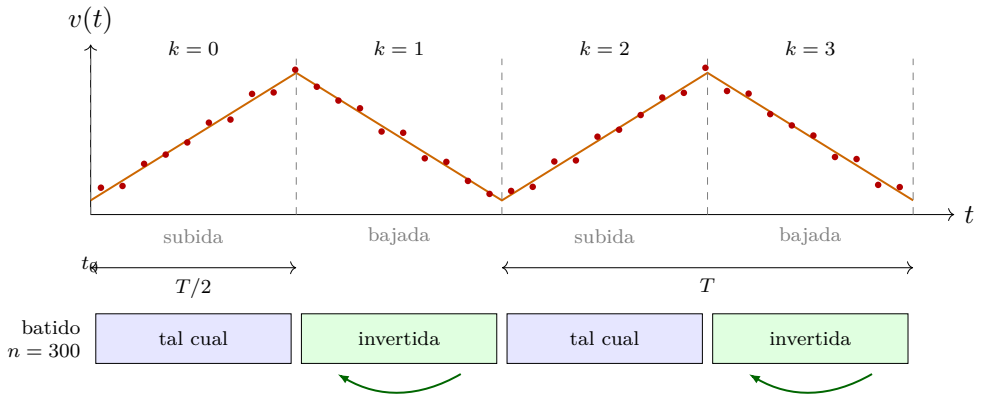
[picture p35: figure]
subida; bajada; tal cual; invertida; invertida batido

Figura 9.3: Sincronismo reconstruido. Los puntos son las lecturas de la triangular (sólo ∼ 19 por período); el triángulo continuo es el modelo ajustado, del que salen los límites de rampa. Cada rampa de batido de 300 muestras se procesa por separado, y las bajadas se invierten en el tiempo.

### 9.3.4. Un defecto del ADC que no afecta

Las lecturas de la triangular muestran un offset aditivo de ±390 cuentas que alterna al azar entre dos estados: en la vista plegada del programa se ven dos triángulos paralelos. Se investigó y se descartó que fuera un error de sincronismo. Para el ajuste es tolerable: el offset es simétrico, así que no sesga la fase de (9.10), y sólo infla la amplitud pico a pico que informa el panel.

## 9.4. Formación de cada rampa

Para cada k se toman las n = 300 muestras xk[m] = x[mk + m], m = 0, . . . , n − 1, del buffer de batido.

### 9.4.1. Inversión de las bajadas

En la bajada la frecuencia del VCO recorre la banda al revés. Leída hacia atrás en el tiempo,
xk[m] ← xk[n − 1 − m] | (k impar), | (9.13)

la bajada se convierte en una subida: la frecuencia instantánea vuelve a crecer con m y se le puede aplicar la misma corrección del VCO (Sección 9.5). Como se mostró en la Sección 2.4, la frecuencia de batido de la bajada es la misma que la de la subida, f

−
| | b = f + b .

Invertir el tiempo no la cambia: sólo cambia la fase inicial del tono, que en el promedio incoherente se descarta.

76 | Capítulo 9. Procesamiento de la Señal de Batido

Aprovechar las dos mitades del triángulo duplica la cantidad de rampas útiles: 20 por segundo en lugar de 10.

Esta operación supone que el VCO barre la misma curva al subir y al bajar, es decir, que no tiene histéresis. No se verificó en forma independiente; una forma de hacerlo es comparar el espectro promediado sólo de subidas con el promediado sólo de bajadas.

### 9.4.2. Resta de la media

A cada rampa se le resta su valor medio:

x˜k[m] = xk[m] −

1
n

nX⁻¹

i=0

xk[i]. | (9.14)

La continua (offset del PCM1808 y del mezclador) es mucho mayor que el batido. Sin restarla, después de la ventana aparece como un pico enorme en 0 Hz cuyos lóbulos tapan los primeros bins. La resta se hace en doble precisión: el PCM1808 entrega 24 bits, y restar una continua grande en simple precisión se comería los bits menos significativos del batido.

## 9.5. Corrección de la no linealidad del VCO

### 9.5.1. Por qué hace falta

La ecuación (2.18) supone que la frecuencia transmitida crece linealmente con el tiempo. El VCO no es lineal: su curva frecuencia contra tensión F(V ), medida en el Capítulo 5, es curva. Con una rampa de tensión lineal,

V (t) = Vmin + (Vmax − Vmin)

t
Tr

, f(t) = F

V (t)
, | (9.15)

la frecuencia transmitida f(t) no es una recta.

Para ver qué le hace eso al batido, conviene escribir la fase de la señal transmitida, ψ(t) = 2π

R t
0

f(u) du. El mezclador entrega la diferencia entre la fase de la señal y la de su eco retrasado τ :

∆ψ(t) = ψ(t) − ψ(t − τ ) = 2π

Z t

t−τ

f(u) du ≈ 2π τ f(t), | (9.16)

donde la aproximación vale porque τ (decenas de nanosegundos) es despreciable frente a la escala en que cambia f(t) (milisegundos). La frecuencia instantánea del batido es

9.5. Corrección de la no linealidad del VCO | 77

entonces
fbeat(t) = 1
2π

d∆ψ
dt = τ f′
| (t). | (9.17)

Si f

′
(t) fuera constante e igual a α0, el batido sería un tono puro de frecuencia α0τ . Con un VCO no lineal, f

′
(t) cambia a lo largo de la rampa: el batido es él mismo un chirp, su energía se reparte en varios bins y el pico se ensancha y se corre.

### 9.5.2. El cambio de variable θ

La ecuación (9.16) sugiere la solución: el batido es lineal en f(t), no en t. Se define una nueva variable

θ(t) = f(t) − f(0)
α0

, α0 =

B
Tr
= | F(Vmax) − F(Vmin)
| Tr
| , | (9.18)

que tiene unidades de tiempo y recorre [0, Tr] como t, pero avanza al ritmo de la frecuencia real. Despejando f(t) = f(0) + α0θ y reemplazando en (9.16):

x(θ) = A cos
2π α0τ θ + φ
| | (9.19)

En la variable θ, el batido vuelve a ser un tono puro de frecuencia fb = α0τ , la misma de (2.15), sea cual sea la forma de la curva del VCO. Ésta es la idea de las técnicas de

corrección por remuestreo de la literatura de FMCW Stove1992, HALFMCWnolin.

### 9.5.3. Remuestreo

Las muestras llegan equiespaciadas en t, o sea no equiespaciadas en θ. Como la curva del VCO y la rampa de tensión son conocidas, el mapa θ(tm) se calcula una sola vez, y la señal se interpola a una grilla uniforme de n puntos:

¯θj = θ0 + j ∆θ, ∆θ =

θn−1 − θ0
n − 1
, | j = 0, . . . , n − 1. | (9.20)

La frecuencia de muestreo efectiva en θ es

Fθ =

1
∆θ

=

n − 1

θn−1 − θ0

≈ 5993,4 sps, | (9.21)

distinta de Fs porque θ no termina exactamente en Tr. Usar Fs, o n/(θn−1 − θ0), en lugar de (9.21) escalaba todas las distancias un 0,27 % y un 0,83 %, respectivamente.

La interpolación es un spline cúbico con condición not-a-knot. Se probaron otros interpoladores (lineal, gaussiano, Lanczos) sobre señal limpia y el error contra el resultado analítico fue el mismo, de −8,2 a −8,4 dB: con pocas muestras por rampa el límite es la

78 | Capítulo 9. Procesamiento de la Señal de Batido

información disponible, no el método. Los interpoladores que suavizan mejoran la relación pico/piso pero pueden perder blancos, así que se conservó el cúbico, que es el que menos filtra.

### 9.5.4. El remuestreo como una matriz

La grilla θ no cambia de una rampa a otra. Un spline cúbico sobre nodos fijos es una operación lineal sobre los valores de la señal, así que existe una matriz M ∈ R

n×n
tal que
yk = Mx˜k. | (9.22)
La columna i de M es el spline que interpola el vector canónico ei | , así que la matriz
se obtiene interpolando la identidad. Se calcula una vez por cada largo de rampa. La ventana de la FFT (Sección 9.6), que es multiplicar cada muestra de salida por w[j], se pliega adentro: Mw = diag(w)M. Todas las rampas de un refresco se apilan como filas de una matriz y el remuestreo con ventana es un solo producto de matrices. El resultado coincide con el de scipy.interpolate.interp1d con error relativo de 6 × 10⁻¹⁶, y es 22

veces más rápido.

## 9.6. Ventana y transformada de Fourier

### 9.6.1. La transformada de cada rampa

Cada rampa remuestreada se ventanea y se transforma:

Xk[ℓ] =

nX⁻¹

j=0

w[j] yk[j] e

−j2πℓj/NFFT , ℓ = 0, . . . ,

NFFT
2
, | (9.23)

con NFFT = 2400 ≥ 8n (relleno con ceros ×8) y la ventana de Hann de n puntos,

w[j] = 1
2

1 − cos

2πj
n − 1
. | (9.24)

La FFT se hace sobre una sola rampa de 50 ms: una subida, o una bajada ya invertida. Nunca sobre el período completo de 100 ms. Hay tres razones:

1. La resolución en distancia no depende de la duración de la ventana sino del ancho de banda barrido (ver más abajo). Un período completo barre la misma banda dos veces, no el doble de banda.

9.6. Ventana y transformada de Fourier | 79
2. En el vértice la fase del batido no continúa suavemente; una FFT que cruza el vértice mezcla dos tramos y genera lóbulos espurios.
3. El mapa θ está definido para un único barrido de Vmin a Vmax.

Lo que sí se aprovecha de las dos mitades es su promedio (Sección 9.7).

### 9.6.2. Eje de frecuencia y de distancia

El bin ℓ corresponde a la frecuencia y a la distancia aparente

fℓ = ℓ

Fθ

NFFT

, dℓ =

c fℓ
2α0
, | (9.25)

que es la inversa de (2.15). Con los valores de la Tabla 9.1, el paso de la grilla es de 2,5 Hz = 1,8 cm.

### 9.6.3. Resolución y relleno con ceros

Ese paso de 1,8 cm no es la resolución. Sin relleno, los bins estarían separados Fθ/n ≈ 20 Hz, que en distancia es

δd =

c
2α0

·

Fθ
n

≈

c
2α0Tr

=

c
2B
= 14,4 cm. | (9.26)

La resolución la fija sólo el ancho de banda barrido. El relleno con ceros evalúa la misma transformada de tiempo discreto en más puntos: interpola, pero no separa dos blancos que estén más cerca que δd. Se usa porque con 300 muestras el espectro sin relleno sale en escalones gruesos y no se ve la forma de los picos. Por la misma razón, diezmar a 6000 sps no cuesta resolución: sólo fija el alcance no ambiguo.

### 9.6.4. La ventana de Hann

Una rampa cortada abruptamente equivale a multiplicar el tono por un rectángulo, cuyo espectro tiene lóbulos laterales a sólo −13 dB: el eco fuerte del acoplamiento directo entre antenas taparía a un blanco débil cercano. La ventana de Hann baja el primer lóbulo lateral a −31 dB, y los siguientes caen a razón de 18 dB por octava. A cambio ensancha el lóbulo principal (ancho de banda equivalente de ruido de 1,5 bins) Harris1978.

80 | Capítulo 9. Procesamiento de la Señal de Batido

### 9.6.5. Se conserva la magnitud

De cada rampa se guarda sólo
| Pk[ℓ] =
Xk[ℓ]
, | (9.27)

un vector de 1201 números al que se llama perfil: cuánta señal vuelve desde cada distancia en esa rampa. La fase de Xk[ℓ] se calcula pero se descarta. Esa decisión define el tipo de promedio de la sección siguiente.

## 9.7. Integración de rampas: promedio incoherente

Una rampa sola es ruidosa: en la Figura 9.5 (arriba) el pico de un blanco débil apenas se distingue del ruido. Para estabilizar el espectro se combinan varias rampas. Hay dos formas de hacerlo, y la diferencia está en cuándo se descarta la fase.

### 9.7.1. Definiciones

Sean Kr las N rampas consecutivas que forman la fila r del radargrama. El promedio incoherente, que es el que usa el sistema, promedia las magnitudes:

Rr[ℓ] = 1
N

X

k∈Kr

Xk[ℓ]

| (9.28)

El promedio coherente, en cambio, promedia los complejos y saca la magnitud al final:

Cr[ℓ] =

1
N

X

k∈Kr

Xk[ℓ]

. | (9.29)

Por linealidad de la FFT, (9.29) es lo mismo que promediar las rampas en el tiempo antes de transformar (el stacking de la literatura de GPR Daniels2004).

### 9.7.2. Modelo estadístico

En el bin del blanco, la FFT de la rampa k es la suma de un fasor de señal y uno de ruido:

Xk = s ejϕk + ηk, | ηk ∼ CN (0, σ²
), | (9.30)

con ηk independiente entre rampas. En un bin sin blanco sólo está ηk.

9.7. Integración de rampas: promedio incoherente | 81

Coherente. Si la fase ϕk se repite de una rampa a otra, los fasores de señal apuntan todos igual y se suman en amplitud; los de ruido apuntan al azar y se suman en potencia (Figura 9.4, izquierda):

1
N

X

k

Xk = s ejϕ + ¯η, Var(¯η) = σ

2
N
. | (9.31)

La señal queda igual y la potencia del ruido baja N veces: la relación señal a ruido mejora un factor N, 10 log10 N dB Richards2014, Skolnik2001. El piso de ruido baja.

Incoherente. Al tomar el módulo de cada rampa antes de sumar, el ruido ya no puede cancelarse: todos los términos son positivos (Figura 9.4, derecha). En un bin de ruido, |ηk| sigue una distribución de Rayleigh con

E|η| = σ

√
π
2

, Var|η| = σ

2

1 −

π
4
, | (9.32)

y el promedio de N valores conserva la media y divide el desvío por √
N. El piso de ruido
no baja: queda al mismo nivel, pero se vuelve más parejo. Como lo que decide si un pico se distingue es cuánto sobresale de las fluctuaciones del piso, la detectabilidad igual mejora, aunque menos que con la integración coherente: del orden de √
N para valores
grandes de N Richards2014.

Coherente
se suman complejos

bin con blanco: la señal suma ×N

bin de ruido: se cancela
en parte, crece como √
N

Incoherente
se suman magnitudes

bin con blanco: suma ×N

bin de ruido: no se cancela, también suma ×N

Figura 9.4: Coherente contra incoherente, en un bin con blanco (arriba) y en un bin de ruido (abajo). En azul la señal de cada rampa; en rojo el ruido. En el promedio coherente el ruido se cancela parcialmente y el piso baja; en el incoherente las magnitudes son siempre positivas y el piso queda donde estaba.

### 9.7.3. Verificación numérica

Las dos figuras siguientes salen de una simulación de Monte Carlo con la misma cadena de la Sección 9.6: 300 muestras, Hann, NFFT = 2400, y un tono de 498 Hz (el de la placa a 90 cm) con ruido blanco gaussiano. Las genera docs/promedio_rampas.py.

La Figura 9.5 muestra una fila de N = 8 rampas con los distintos criterios, todo referido

82 | Capítulo 9. Procesamiento de la Señal de Batido

al piso de ruido de una rampa. El promedio incoherente deja el piso en ∼ 0 dB y reduce su dispersión de 5,3 a 1,5 dB: el pico, que en una rampa sola compite con fluctuaciones de ruido de altura parecida, queda claramente aislado. El coherente baja el piso 9 dB, pero el piso que queda fluctúa igual que el de una rampa.

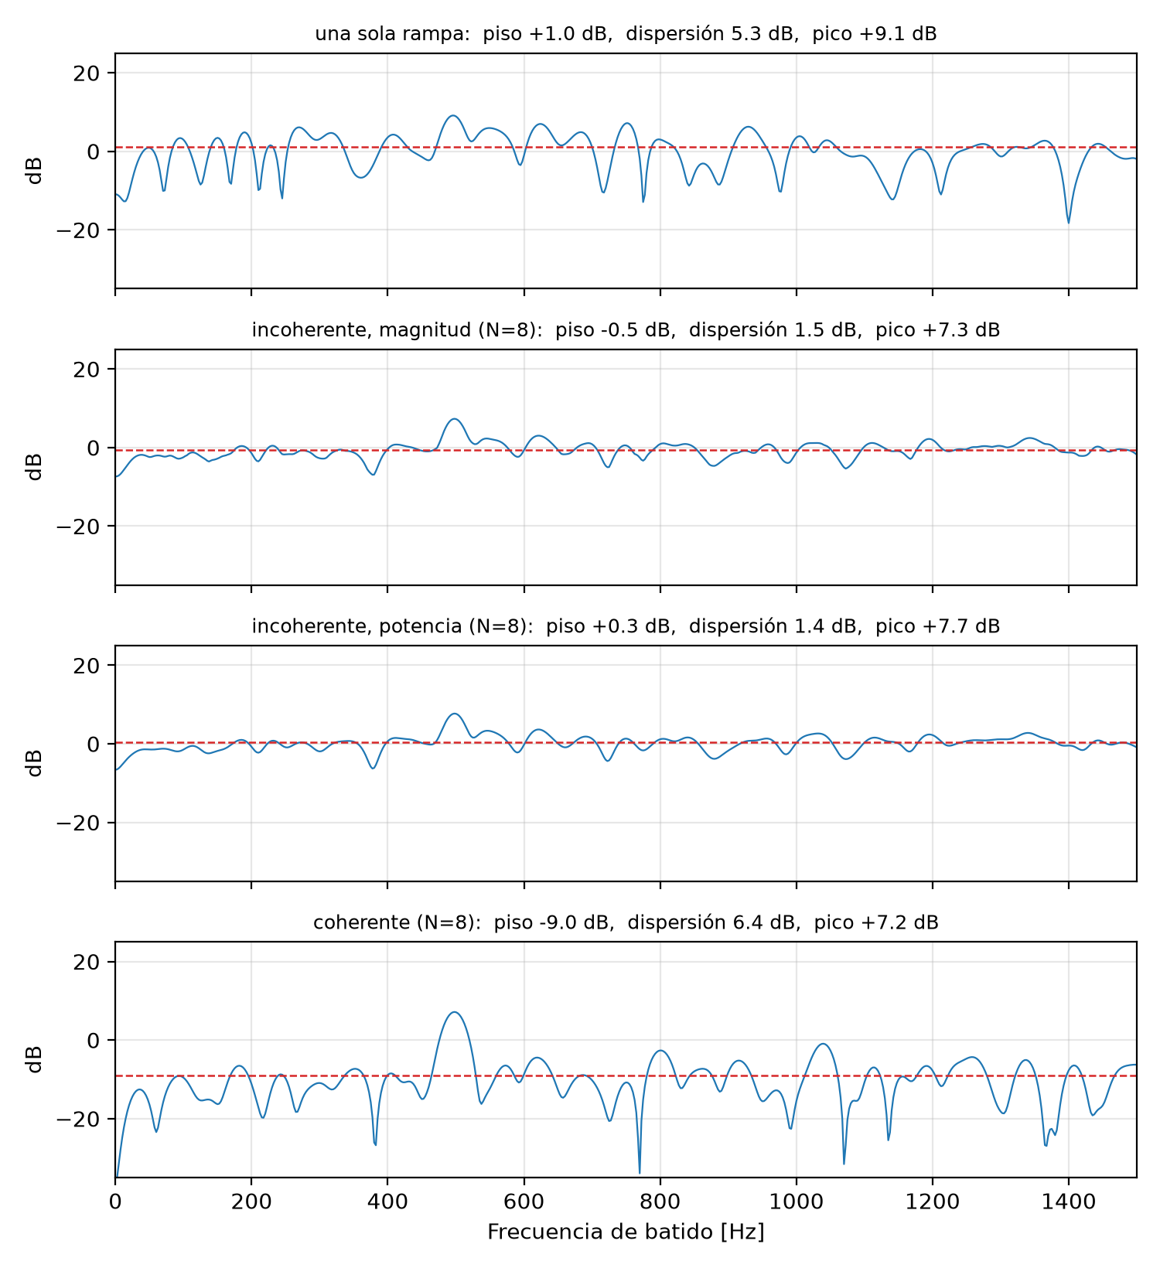
[picture p36: figure]

Figura 9.5: Espectro de una fila de N = 8 rampas con un blanco débil en 498 Hz (SNR de −12 dB por muestra en cada rampa), según el criterio de promedio. La línea roja es el piso medio. Una realización; los valores de los títulos varían entre corridas.

La Figura 9.6 separa las dos cosas que cambian con N: el nivel medio del piso y su dispersión. El coherente sigue exactamente la recta −10 log10 N y no reduce la dispersión; el incoherente reduce la dispersión como 1/

√
N y no mueve el nivel, salvo un sesgo de hasta −1,05 dB cuando se promedia magnitud (Sección 9.8).

9.7. Integración de rampas: promedio incoherente | 83

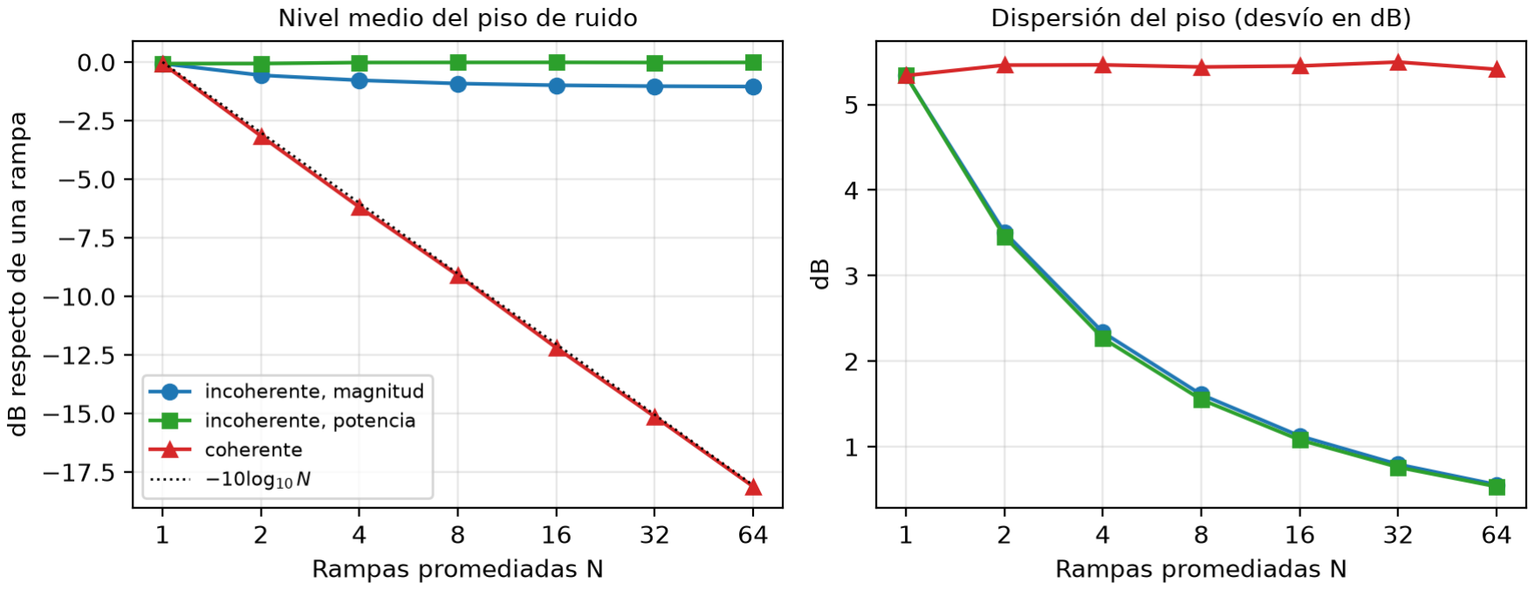
[picture p37: figure]

Figura 9.6: Piso de ruido en función de la cantidad de rampas promediadas, sobre 300 realizaciones de ruido puro. Izquierda: nivel medio, referido al de una rampa. Derecha: desvío del piso en dB a lo largo del espectro.

### 9.7.4. Por qué el sistema usa el promedio incoherente

La integración coherente rinde más, pero exige que la fase del eco se repita de una rampa a otra, y en este banco eso no está garantizado:

El sincronismo se reconstruye por software (Sección 9.3). Su error, de ∼ 10 µs, equivale a ∼ 2

- de fase a 500 Hz: pequeño, pero no medido sobre el banco real.

La repetibilidad del VCO entre barridos no está medida. La fase del batido es 2πf(0)τ + . . . (ecuación (9.16)): una variación de f(0) de una rampa a otra, por ruido de la triangular o deriva térmica del VCO, rota la fase del eco.

Subidas y bajadas tienen distinta fase. Al invertir la bajada, el tono conserva la frecuencia pero no la fase. Un promedio coherente debería hacerse por separado para cada dirección.

Robustez. Si la fase no se repite, el promedio coherente pierde señal: en el límite de fases al azar, el eco también se cancela. El incoherente nunca pierde la señal.

Por eso se adopta el promedio incoherente: es el método estándar cuando no se puede asegurar la coherencia de fase entre barridos Richards2014, y el que ya se anticipaba en la Sección 2.4 para combinar subidas y bajadas. Verificar la estabilidad de fase sobre una captura cruda y, si se confirma, pasar a un promedio coherente por dirección, queda como trabajo futuro: se ganarían ∼ 9 dB de piso con N = 8.

84 | Capítulo 9. Procesamiento de la Señal de Batido

### 9.7.5. Dónde se promedia

El promedio (9.28) se usa en dos lugares, con dos N distintos:

| Cada fila del radargrama: N rampas consecutivas. N lo elige el usuario en el
| cuadro rampas/col; vale 8 por defecto, una fila cada 0,4 s. El radargrama tiene la
| fila más nueva abajo y el tiempo hacia arriba (Figura 9.7). El espectro de la captura
CSV es la última fila.
| El perfil para el pico y la calibración: las rampas de los últimos 2 s, unas 40.

En memoria se guardan los perfiles de una rampa, no las filas, así que cambiar N reagrupa todo lo que está en pantalla. Si la ventana pide más de 900 filas, que no entrarían en los píxeles del gráfico, N se agranda automáticamente y el panel lo informa como agrupado efectivo.

P0 | P1 | P2 | P3 | P4 | P5 | P6 | P7 | P8 | P9 | P10 | P11 | P12 | P13 | P14 | P15

R0 = 1
8

P7
k=0 Pk | R1 = 1
| 8

P15
k=8 Pk
- · · perfiles de una rampa

cada fila: N = 8 rampas,
0,4 s
(4 subidas y 4 bajadas)

Figura 9.7: Formación de las filas del radargrama a partir de los perfiles de cada rampa. En azul las subidas, en verde las bajadas invertidas; cada fila mezcla las dos.

## 9.8. Magnitud o potencia

Dentro del promedio incoherente queda una elección: qué se promedia. Hay tres opciones habituales:

lineal (magnitud): 1
N

P
k
|Xk|, | (9.33)
cuadrática (potencia): | 1
N

P
k

|Xk|

2
, | (9.34)
logarítmica: | 1
N

P

k 20 log10|Xk|. | (9.35)

El sistema usa la lineal y convierte a decibeles después del promedio, con 20 log10. Los criterios para elegir dependen de para qué se usa el resultado.

### 9.8.1. Para detectar y ubicar el pico, da lo mismo

En la teoría de detección con integración incoherente, el detector lineal (suma de |Xk|) y el cuadrático (suma de |Xk|

2
) difieren normalmente en menos de 0,2 dB de rendimiento. El cuadrático es algo mejor con relación señal a ruido baja y el lineal con relación alta

9.8. Magnitud o potencia | 85

Richards2014, Skolnik2001. Además, la posición del máximo es la misma con cualquiera de los tres criterios, porque las tres operaciones son monótonas. Para la función principal del radar, estimar distancias, la elección no pesa.

### 9.8.2. Para medir niveles, la potencia es la correcta

Cuando lo que interesa es un nivel (el piso de ruido, la energía de la puerta de detección, la comparación con la simulación o entre capturas), los tres criterios no dan lo mismo.

La potencia es el estimador sin sesgo. Promediar |Xk|

2
es el periodograma promediado de Bartlett y Welch, el estimador estándar de la densidad espectral de potencia Welch1967, Proakis2006: su valor esperado es la potencia verdadera, y su varianza baja aproximadamente N veces.

La magnitud subestima el ruido. Por (9.32), para un bin de ruido
E|η|

2

E|η|

2

=

π
4

=⇒ 10 log10

π
4
= −1,05 dB. | (9.36)

Un tono fuerte casi no fluctúa y no sufre ese sesgo. El resultado es que, promediando magnitudes, la relación pico/piso sale hasta 1,05 dB más optimista que la real. El sesgo crece con N: es nulo con una rampa, porque |X|

2 de una sola rampa ya es potencia, y vale −0,92 dB con N = 8 (Figura 9.6).

El promedio en decibeles subestima más. Promediar en escala logarítmica subestima la potencia del ruido en 10 log10(e) γ = 2,51 dB, con γ la constante de Euler. Es el error clásico de los analizadores de espectro con promedio de video en escala logarítmica KeysightAN150. El sistema no promedia en decibeles.

La potencia es aditiva. Para señal y ruido no correlacionados, E|s + η|

2 = |s|

2 + σ

2
Esa propiedad es la que da sentido estadístico a restar un fondo, o un piso de ruido, de un espectro promediado. Las magnitudes no se suman así.

Los tres sesgos se verificaron con la simulación de Monte Carlo: dio −1,05 dB y −2,50 dB, contra −1,05 y −2,51 dB teóricos.

86 | Capítulo 9. Procesamiento de la Señal de Batido

### 9.8.3. Qué implica para el sistema

Las distancias no se ven afectadas. El pico, la traza del radargrama y la calibración no cambian con el criterio.

Los niveles de ruido en pantalla están ∼ 1 dB por debajo de su valor verdadero, y la relación pico/piso ∼ 1 dB por encima.

La puerta de detección mezcla los criterios: calcula la energía como suma de cuadrados (Sección 9.9), pero de magnitudes ya promediadas en lineal.

La comparación con la simulación se hace sobre curvas normalizadas a su propio máximo (columna db_norm de la CSV de captura), y un sesgo constante del piso no cambia la posición ni la forma de los picos.

Pasar a un promedio de potencia, mostrado con 10 log10, es un cambio menor en el código que dejaría todos los niveles sin sesgo. Mientras no se haga, los niveles absolutos de ruido que se informen deben corregirse por el sesgo (9.36).

## 9.9. Sustracción del fondo y detección

### 9.9.1. Fondo congelado

Sin ningún blanco, la pantalla no queda vacía: el acoplamiento directo entre antenas, la pared del laboratorio y el resto de la sala producen ecos fijos. Con la sala vacía, el botón medir fondo promedia 3 s de perfiles y guarda

F[ℓ] = 1
K

X

k

Pk[ℓ]. | (9.37)

Desde ese momento, a cada fila se le resta el fondo, con piso en cero:

Dr[ℓ] = m´ax
Rr[ℓ] − F[ℓ], 0
. | (9.38)

La referencia de 0 dB pasa a ser el pico del fondo en la zona útil, fija, en vez del máximo de la pantalla. Esto evita que, sin blanco, el propio fondo suba a 0 dB y aparezca un pico donde no hay nada.

La resta (9.38) es entre magnitudes, porque es lo único que se guarda. Una resta de complejos cancelaría un eco fijo de forma exacta; una resta de magnitudes lo atenúa, pero no puede separar un blanco del fondo cuando caen en el mismo bin con fases que se restan. Es una limitación aceptada de la integración incoherente.

9.9. Sustracción del fondo y detección | 87

### 9.9.2. Puerta de detección

Se declara que hay un blanco sólo si la energía actual, en la zona por encima de la distancia mínima dign, supera a la del fondo en un margen:

E =

X

ℓ≥ℓ0

R[ℓ]

2
, 10 log10

E
EF
≥ margen (6 dB). | (9.39)

Si no se cumple, el programa informa sin blanco en vez de una distancia. Antes de agregar la puerta, con la sala vacía el sistema informaba igual la distancia del eco más fuerte del fondo.

### 9.9.3. Fondo automático (MTI)

Como alternativa, el fondo puede estimarse de forma continua con un promedio exponencial:
F ← F + a
P¯ − F
, | a = 1 − e
−∆t/τMTI , | τMTI = 30 s, | (9.40)

donde P¯ es el promedio de las rampas del último refresco y ∆t su duración. Es un filtro

pasaaltos en el tiempo lento: lo que no se mueve termina adentro de F y desaparece, y lo que aparece o se mueve resalta durante ∼ τMTI. Con el fondo automático la puerta compara la energía del residuo m´ax(R−F, 0) contra la del fondo, porque la energía cruda coincide con la del fondo por construcción.

### 9.9.4. Distancia del pico

El pico se busca en el perfil de los últimos 2 s, con el fondo ya restado, a partir de dign (0,3 m): por debajo está el acoplamiento directo, que es lo más fuerte de todo el espectro. Sobre el bin del máximo, ℓ

∗
, y sus dos vecinos se ajusta una parábola en decibeles Jacobsen2007:
δ =

1
2

a − c
a − 2b + c

,

ˆd = dℓ
∗ + δ ∆d, | (9.41)

con a, b, c los niveles en dB de los bins ℓ

∗ − 1, ℓ

∗ y ℓ

∗ + 1, ∆d el paso de la grilla y

|δ| ≤ 1/2. Se usa la escala en dB porque, cerca del máximo, el lóbulo principal de la ventana de Hann es casi una parábola en dB. Sobre tonos sintéticos, el error de posición baja de 0,22 bins a prácticamente cero. Esto no cambia la resolución, que sigue siendo c/(2B): mejora la precisión con que se ubica el centro de un pico ya resuelto, que es lo que hace repetible un punto de calibración.

Finalmente, la distancia aparente se lleva a distancia real con la calibración afín del Capítulo 8, dreal = a

ˆd + b, donde b es el offset de los cables y a debe dar ≈ 1.

88 | Capítulo 9. Procesamiento de la Señal de Batido

## 9.10. Ejemplo: placa a 90 cm

La Figura 9.8 es una captura del programa con una placa metálica a 90 cm y el fondo congelado. Arriba, el radargrama: 50 filas de N = 8 rampas (0,4 s cada una) que cubren 20 s, con la frecuencia de batido en el eje horizontal. La traza roja es el pico de cada fila. Abajo, el espectro de la última fila en dB sobre el fondo; el pico está en 498 Hz, que por (9.25) son 3,59 m aparentes: 0,9 m de aire más el offset de cables y bocinas. La energía supera al fondo en 8,2 dB, por encima del margen de 6 dB, así que la puerta declara blanco. A la derecha, el panel con el estado completo de la cadena (período ajustado, Fθ, B, α0, resolución) y la triangular plegada sobre el período ajustado.

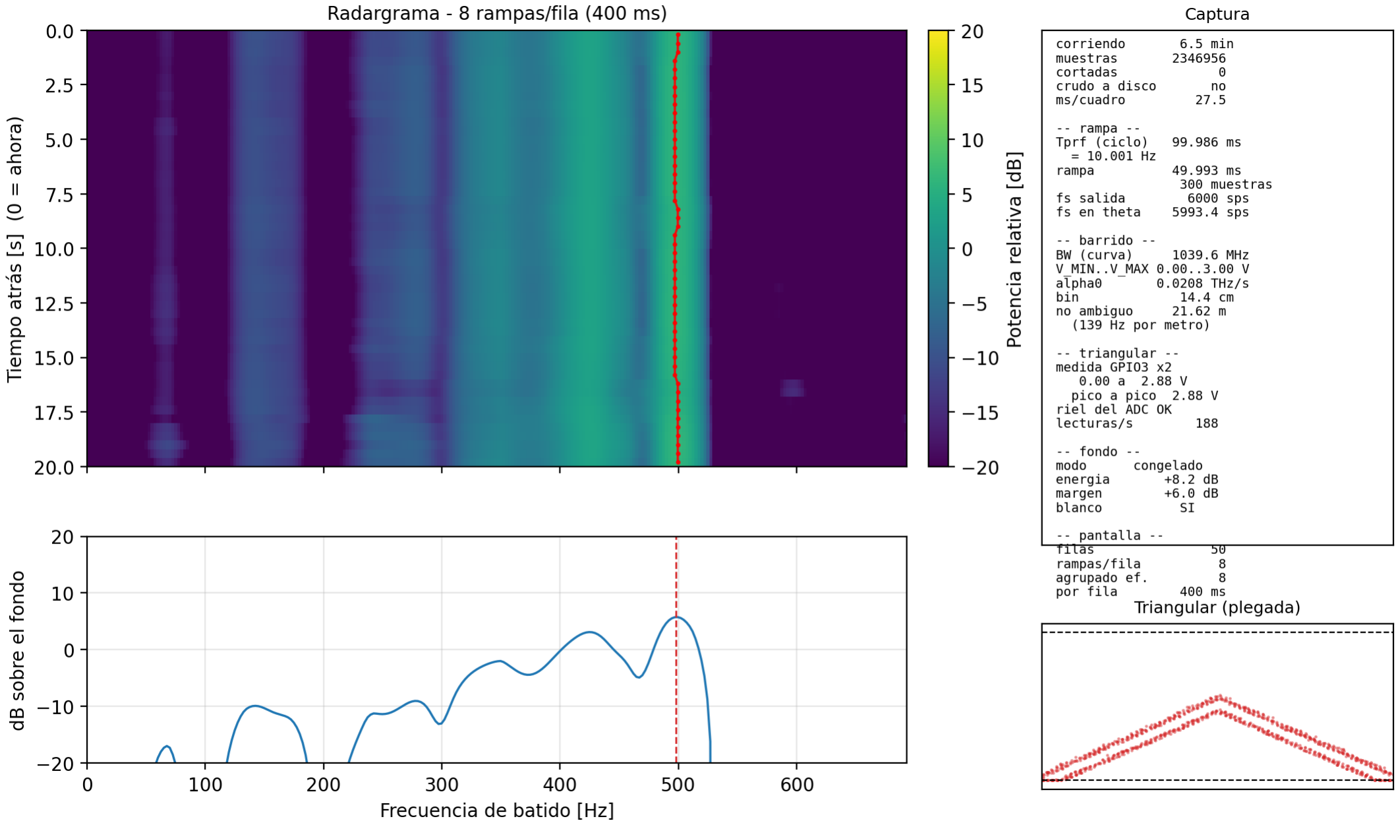
[picture p38: figure]

Figura 9.8: Captura de vivo_rapido.py con una placa metálica a 90 cm, fondo congelado, N = 8 rampas por fila (28/09/2026).

9.11. Resumen de la cadena | 89

## 9.11. Resumen de la cadena

Cuadro 9.3: Etapas del procesamiento, con su ecuación y su implementación.

Etapa | Operación | Dónde
Diezmado | semibanda ×3, 48 k → 6 k, ec. (9.1) | adquisicion.ino (firmware)
Sincronismo | máx. de |S(T)| y fase,
| ecs. (9.8)–(9.10) | ajustar_triangular_
| | rapido()
Corte de rampas | ec. (9.12), bajadas invertidas | Vivo.procesar()
Resta de la media | x˜ = x − x¯ | Vivo.procesar()
Corrección del VCO | remuestreo a θ uniforme,
| ecs. (9.18)–(9.21) | Remuestreador
Ventana y FFT | Hann, NFFT = 2400, ec. (9.23) | espectros()
Perfil | Pk = |Xk|, ec. (9.27) | espectros()
Promedio | incoherente, en magnitud,
| ec. (9.28) | Vivo.matriz()
Fondo | ec. (9.38) o MTI | Vivo.matriz()
Pico | parábola en dB, ec. (9.41) | pico_parabolico()
Distancia | ec. (9.25) y calibración afín | Calibracion

## 9.12. Conclusiones del capítulo

El sincronismo existe y es de software. Se reconstruye ajustando un período y una fase a ∼ 50 períodos de la triangular leída por GPIO3. El error en el límite de rampa queda en ∼ 10 µs, menos de una décima de muestra.

Cada FFT es de una sola rampa de 50 ms, subida o bajada invertida. Las dos mitades del triángulo duplican las rampas útiles, 20 por segundo.

El remuestreo en θ convierte el batido de un VCO no lineal en un tono puro (ec. (9.19)), y es el que permite que el pico tenga el ancho que le corresponde por la resolución, c/(2B) = 14,4 cm.

Las rampas se integran de forma incoherente. El piso de ruido no baja, pero su dispersión cae como 1/

√
N (de 5,3 a 1,6 dB con N = 8). Se eligió así porque la coherencia de fase entre barridos no está garantizada en este banco. El promedio coherente rendiría ∼ 9 dB más con N = 8, y queda como trabajo futuro una vez verificada la estabilidad de fase.

Se promedia magnitud, no potencia. Para ubicar picos es indistinto (diferencia menor a 0,2 dB en detección y ninguna en posición); para medir niveles, el piso queda ∼ 1 dB subestimado.

# Apéndice A

# Valores de componentes: series

# comerciales, tolerancias y

# combinaciones

Este apéndice reúne, circuito por circuito, cómo se eligieron los valores de resistencias y capacitores: qué serie comercial se usó, qué tolerancia hace falta y por qué, y cómo se armaron los valores que no existen en catálogo. Se irá completando a medida que se construyan las demás etapas del instrumento.

## A.1. Generador de triangular

El circuito del Capítulo 6 se armó íntegramente con la serie E12 (los doce valores por década de las resistencias comunes), en película metálica al 1 %. Esta sección justifica esa tolerancia y detalla las tres combinaciones en serie que hicieron falta.

### A.1.1. Por qué el 1 %

Las tolerancias de los resistores se propagan a la salida por tres caminos a la vez: la amplitud de la triangular depende de R3/R2, la referencia de R5/(R4 +R5), y la ganancia y el offset del restador de las cinco resistencias que lo rodean. Para cuantificar el efecto conjunto se propagó la tolerancia de cada resistencia física —las de las combinaciones en serie por separado, que es como están en la placa— por las ecuaciones del circuito, sin intervención del operacional (script GPRv2/docs/PWM/simulacion/tolerancias.py). Los resultados están en la Tabla A.1.

90

A.1. Generador de triangular | 91

Cuadro A.1: Rango que puede cubrir la salida del generador según la tolerancia de los resistores. El Monte Carlo (200 000 muestras, distribución uniforme dentro de la banda) es lo que cabe esperar al armar placas; el peor caso recorre las 2

12 esquinas y es la cota
que no se puede superar. El valor nominal es 0,030 a 3,094 V.
| Tolerancia 5 % | Tolerancia 1 %
Monte Carlo | −0,57 a +3,67 V −0,09 a +3,22 V
Peor caso | −0,78 a +3,88 V −0,13 a +3,25 V
Placas con el extremo inferior bajo 0 V | 43 % | 19 %

Con resistores al 5 % la salida puede llegar a 3,88 V en el peor caso, por encima de los 3,63 V que tolera el VCO (ecuación (6.4)): la protección del zener dejaría de ser un seguro contra fallas para pasar a actuar en operación normal, recortando la rampa. Al 1 % el peor caso queda en 3,25 V, con margen suficiente.

Obsérvese que en ninguna de las dos variantes se evita que el extremo inferior caiga por debajo de 0 V en una fracción apreciable de las placas. Esto no es un problema: la salida no puede ser negativa porque el operacional no lo permite —simplemente se apoya en el riel—, y el efecto es un achatamiento de algunos milivoltios en el vértice inferior, en una zona del rango del VCO que de todos modos no se usa. El extremo que importa es el superior, y es el que la tolerancia del 1 % protege.

La Tabla A.2 muestra cuánto mueve el extremo superior cada resistencia por separado. R9 y R8, las dos que fijan la ganancia del restador, concentran el efecto: entre las dos explican más de la mitad de la dispersión.

Cuadro A.2: Desplazamiento del extremo superior de la salida por un error del 1 % en cada resistencia, de a una por vez.

| R9 | R8 | R2 | R3 | R6 | R7

Desplazamiento 34,6 30,0 15,5 15,3 14,7 14,5 mV

| R10 | R4 | R5 | R13 | R14 | R15
Desplazamiento | 8,6 | 7,7 | 7,7 | 5,2 | 1,0 | 0,1 mV
A.1.2. | Combinaciones en serie

Tres de los valores que pide el diseño no existen en la serie E12 y se armaron sumando resistencias en serie. La Tabla A.3 las lista con su desvío respecto del valor ideal; las tres quedan muy por debajo de la tolerancia del 1 % de los propios componentes, de modo que la aproximación no agrega error apreciable.

92 Apéndice A. Valores de componentes: series comerciales, tolerancias y combinaciones

Cuadro A.3: Valores que no existen en la serie E12 y cómo se armaron.

| Combinación | Resultado | Ideal | Desvío

R′
9 | R9 + R13 = 100k + 15k | 115 kΩ | 114,96 kΩ +0,04 %
R′
10 | R10 + R14 + R15 = 680k + 82k + 6k8 | 768,8 kΩ | 768,5 kΩ | +0,04 %
R′
11 | R11 + R16 = 150k + 150k | 300 kΩ | 300 kΩ | exacto

Los dos primeros salen de imponer simultáneamente ganancia unitaria sobre la triangular y el offset de la ecuación (6.3), lo que para R8 = 100 kΩ da

R

′
10 =

Vcc R8

Voff

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
. | (A.1)

El tercero, R′
11, es el brazo alto del divisor del sincronismo, y sale de pedir que la cuadrada de 12 V se reduzca a un cuarto sin cargar apreciablemente al comparador.

### A.1.3. Capacitores

C1, el capacitor del integrador, es de 2,2 µF de película metálica. La razón es doble y está desarrollada en la Sección 6.2.1: la tensión sobre él se invierte en cada semiperíodo, lo que descarta un electrolítico polarizado; y la corriente de carga baja hasta 55,5 µA con el potenciómetro al máximo, del mismo orden que la corriente de fuga de un electrolítico, que se sumaría a la de carga y curvaría la rampa justo en la posición donde más importa.

El desacople es convencional: C2 de 10 µF electrolítico a la entrada de alimentación, más C3 y C4 de 100 nF cerámicos, uno por cada integrado.

# Apéndice B

# La transformada chirp-Z (CZT) —

# trabajo futuro

Este capítulo queda como apéndice de referencia teórica para una etapa posterior de la tesis. Todavía no se implementó ni se validó experimentalmente sobre el banco de pruebas: la separación de reflexiones cercanas (espesor de capa) se está resolviendo por ahora con la

FFT estándar. Se deja documentado acá porque es la técnica que se evaluará más adelante para mejorar esa resolución, no porque el resto de la tesis dependa de ella.

## B.1. Limitación de resolución del FFT

La resolución frecuencial de la DFT calculada sobre N muestras a frecuencia de muestreo fs es:

∆fFFT =

fs
N
[Hz]. | (B.1)

En el sistema de referencia Huang2022: fs = 100 Hz, N = fs · Tc = 30 muestras, lo que da:

∆fFFT =

100
30

≈ 3,33 Hz/bin.

Si la diferencia real entre los picos es ∆f = 4 Hz, el FFT apenas puede distinguirla, con un error de espesor que puede superar los 20 mm.

Aumentar N exigiría una mayor frecuencia de muestreo (hardware más costoso), sin beneficio real dado que las frecuencias IF son bajas (< 60 Hz). La CZT es una alternativa para resolver este problema sin modificar el hardware, a evaluar más adelante.

93

94 | Apéndice B. La transformada chirp-Z (CZT) — trabajo futuro
B.2. | Conceptos fundamentales de la CZT

La transformada-Z de una secuencia x[n] de longitud N, evaluada en M puntos dispuestos sobre un arco del plano complejo, es:

XCZT[k] =

N

X⁻¹

n=0

x[n] z

−n
k
, | k = 0, 1, . . . , M − 1, | (B.2)

con los puntos de evaluación:

zk = A0 W⁻k
0
, | (B.3)

donde:

A0 = e

j ωstart = e

j 2πfstart/fs
, | (B.4)

W0 = e

−j ∆ω = e

−j 2π(fend−fstart)/(fs(M−1))
. | (B.5)

La resolución espectral resultante es:

∆fCZT =

fend − fstart
M − 1
[Hz]. | (B.6)

### Caso especial: CZT ≡ DFT

Si A0 = 1 y W0 = e

−j2π/N , la CZT cubre el círculo unitario completo con N puntos

igualmente espaciados y su resultado es idéntico al DFT estándar. El FFT convencional es un caso particular de la CZT.

B.3. Tabla de parámetros CZT | 95
B.3. | Tabla de parámetros CZT

Cuadro B.1: Parámetros de la CZT y su cálculo desde fstart, fend y fs.

Símbolo Significado | Cálculo
A0 | Punto de inicio en el
| plano z | A0 = e j 2πfstart/fs
W0 | Paso entre muestras (mó-
| dulo 1) | W0 = e −j 2π(fend−fstart)/(fs(M−1))
∆ω | Paso angular | ∆ω = 2π(fend−fstart)/(fs(M−1))
M | Número de puntos del
| zoom | Elegido por el usuario (potencia
| | de 2 recomendada)
k | Índice de salida | k = 0, 1, . . . , M − 1
B.4. | Implementación eficiente: algoritmo de Blues-

## tein

El cálculo directo de la ecuación (B.2) tiene complejidad O(N · M). El algoritmo de Bluestein reduce esto a O((N + M) log(N + M)) mediante la identidad algebraica:

k · n =

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
(k − n)

2
2
, | (B.7)

que convierte la suma del CZT en una convolución implementable con FFT. Los pasos son los siguientes:

1. Pre-multiplicación: y[n] = x[n] · A

−n
0
- W

n

2/2
0

2. Definición del filtro:

h[k] = W

−k

2/2
0
, | k = 0, . . . , M − 1; | h[L − N + 1 . . . L − 1] = W

−(N−k)

2/2
| | 0

3. Convolución vía FFT:

G = IFFT
FFT(y, L) · FFT(h, L)
,

donde L es la potencia de 2 más próxima superior a M + N − 1.

4. Post-multiplicación: XCZT[k] = G[k] · W

k

2/2
0

, k = 0, . . . , M − 1.

5. Eje de frecuencias:

f[k] = fstart + k ·

fend − fstart
M − 1
. | (B.8)

96 | Apéndice B. La transformada chirp-Z (CZT) — trabajo futuro
B.4.1. | Ejemplo numérico

N = 30 muestras, fs = 100 Hz, zoom: fstart = 3 Hz, fend = 15 Hz, M = 512 puntos.

Cuadro B.2: Cálculo de los parámetros CZT para el ejemplo de referencia.

Cálculo Resultado

ωstart | 2π × 3/100 = 0,18850 rad
ωend | 2π × 15/100 = 0,94248 rad
∆ω | (0,94248 − 0,18850)/511 = 0,001476 rad/muestra
∆fCZT | (15 − 3)/511 ≈ 0,0235 Hz/bin
∆fFFT | 100/30 ≈ 3,33 Hz/bin (142× peor)
A0 | cos(0,18850) + j sin(0,18850)
W0 | e

−j 0,001476
L | 2

⌈log2

(512+30−1)⌉ = 2¹⁰ = 1024

B.5. | Guía de selección de parámetros
B.5.1. | Rango de zoom [fstart, fend]
1. Calcular el FFT completo para identificar la región de interés.
2. Estimar el rango esperado de ∆f con la inversa de la ecuación (2.27):

∆fmax =

4

√
εr B hmax
Tc c

, ∆fmin =

4

√
εr B hmin
Tc c
. | (B.9)
3. Agregar un margen del 30–50 % a cada lado.

### B.5.2. Número de puntos M

Cuadro B.3: Resolución CZT para distintos valores de M (rango de zoom de 12 Hz).

M | ∆fCZT | Uso recomendado
128 | ≈ 0,094 Hz | Exploración rápida, capas gruesas (> 15 cm)
512 | ≈ 0,024 Hz | Balance calidad/velocidad, uso general
2048 | ≈ 0,006 Hz | Alta precisión, capas delgadas (< 5 cm)
8192 ≈ 0,0015 Hz Máxima resolución, verificación crítica

Regla práctica: ∆fCZT < ∆freal/5.

B.6. Flujo completo del algoritmo (a futuro) | 97
B.6. | Flujo completo del algoritmo (a futuro)

Cuadro B.4: Resumen del flujo de procesamiento GPR FMCW con CZT, propuesto para cuando se implemente.

# Etapa | Descripción

1 | Emisión del chirp | El radar barre de fc − B/2 a fc + B/2
| | en tiempo Tc/2 (media triangular).
2 | Reflexiones | R1 y R2 llegan con retardos τ1, τ2.
3 | Mezcla (mixer) | stx×srx + LPF → señal IF con f1 = Sτ1
| | y f2 = Sτ2.
4 | Muestreo IF | Se digitaliza la señal IF con N muestras
| | a fs Hz.
5 | FFT (referencia) | Espectro de baja resolución; puede no
| | separar f1 de f2.
6 | Definir zoom CZT | Elegir [fstart, fend] y M.
7 | Calcular A0, W0, ∆ω Ec. (B.4)–(B.5).
8 | Bluestein | Pre-mult. → convolución FFT → post-
| | mult. → magnitud.
9 | Detección de picos | Identificar f1 y f2 en el espectro CZT.
10 Calcular espesor | ∆f = f2 − f1 → ec. (2.27).
