maledesm/gpr/redaccion/figuras/software/bloques_firmware.pdf

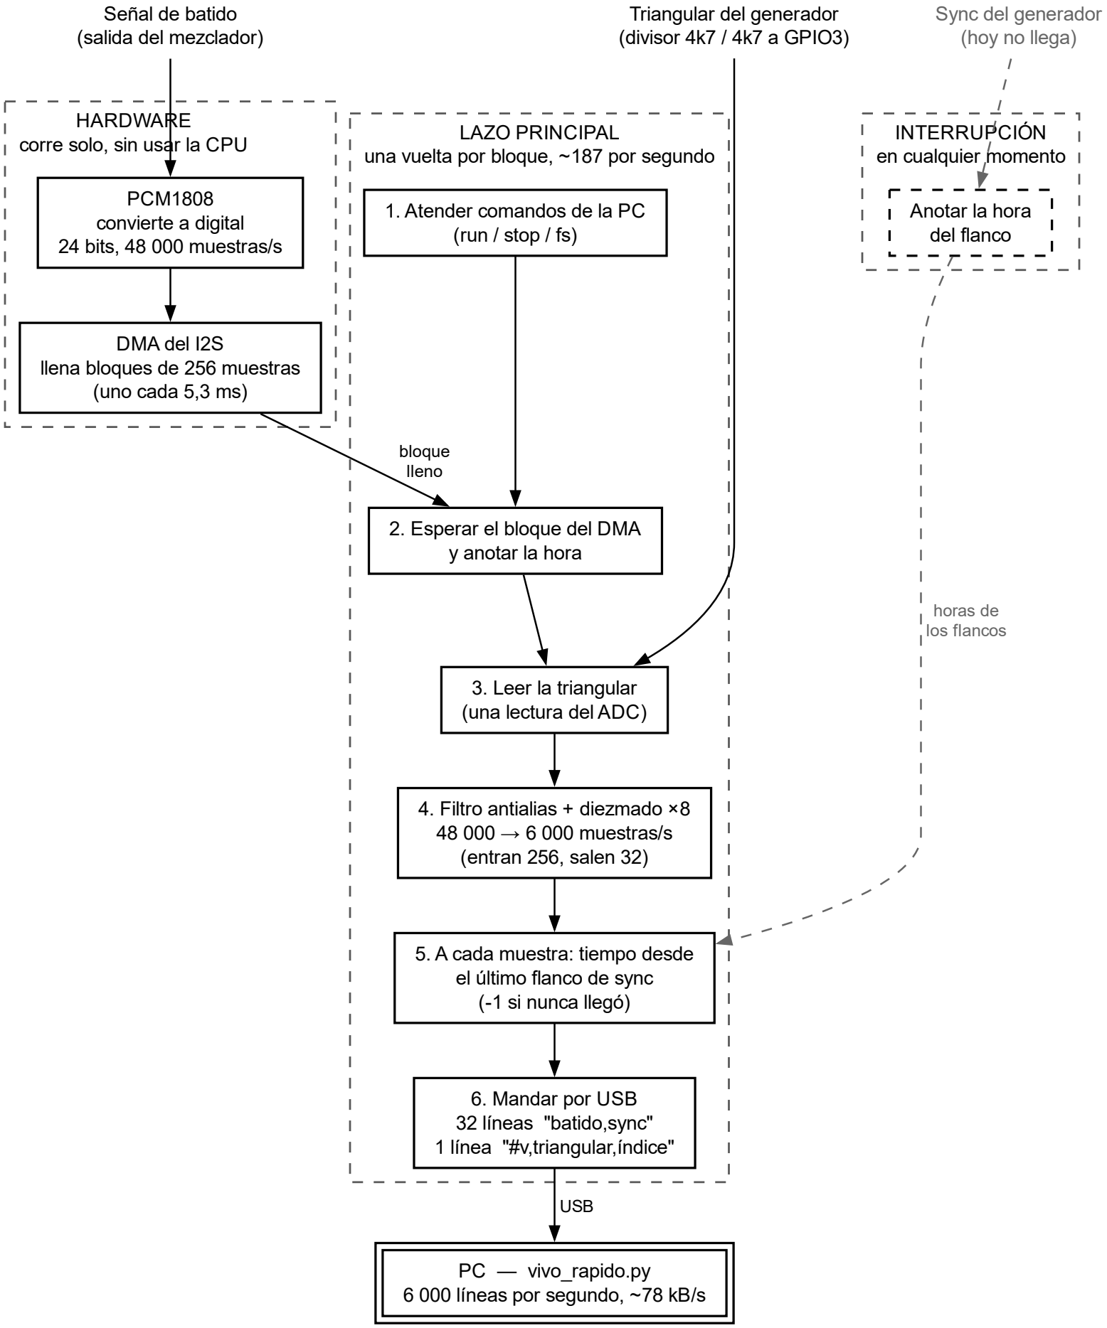
[picture p39: figure]
HARDWARE; una vuelta por bloque, ~187 por segundo; INTERRUPCIÓN en cualquier momento; Señal de batido (salida del mezclador); PCM1808 convierte a digital 24 bits, 48 000 muestras/s; Triangular del generador (divisor 4k7 / 4k7 a GPIO3); 3. Leer la triangular (una lectura del ADC); Sync del generador (hoy no llega); Anotar la hora del flanco; DMA del I2S llena bloques de 256 muestras (uno cada 5,3 ms); 2. Esperar el bloque del DMA y anotar la hora; bloque lleno; 1. Atender comandos de la PC (run / stop / fs); 4. Filtro antialias + diezmado ×8 48 000 → 6 000 muestras/s (entran 256, salen 32)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

corre solo, sin usar la CPU | LAZO PRINCIPAL
