maledesm/gpr/redaccion/tesis_gpr_fmcw.tex

%============================================================
%  TESIS DE GRADO EN INGENIERÍA ELECTRÓNICA / TELECOMUNICACIONES
%  Título provisional: Procesamiento de señales para radar de
%  penetración terrestre (GPR) tipo FMCW
%============================================================

\documentclass[12pt, a4paper, twoside]{report}

%------------------------------------------------------------
% PAQUETES
%------------------------------------------------------------
\usepackage[utf8]{inputenc}
\usepackage[T1]{fontenc}
\usepackage[spanish]{babel}
\usepackage{lmodern}

% Márgenes (IRAM / normas universitarias argentinas)
\usepackage[
  top=2.5cm, bottom=2.5cm,
  inner=3.0cm, outer=2.0cm
]{geometry}

% Matemáticas
\usepackage{amsmath, amssymb, amsfonts}
\usepackage{bm}           % vectores en negrita

% Tablas
\usepackage{booktabs}
\usepackage{array}
\usepackage{longtable}
\usepackage{multirow}

% Figuras
\usepackage{graphicx}
\usepackage{float}
\usepackage{caption}
\usepackage{subcaption}
\usepackage{tikz}
\usetikzlibrary{arrows.meta, positioning, fit, calc, decorations.pathreplacing, babel}

% Colores y código fuente
\usepackage{xcolor}
\usepackage{listings}

% Hipervínculos (debe ir casi al final)
\usepackage[
  colorlinks=true,
  linkcolor=blue!60!black,
  citecolor=green!50!black,
  urlcolor=blue!70!black
]{hyperref}

% Bibliografía
\usepackage[
  backend=biber,
  style=ieee,
  sorting=none
]{biblatex}
\addbibresource{referencias.bib}

% Encabezados y pies de página
\usepackage{fancyhdr}
\pagestyle{fancy}
\fancyhf{}
\fancyhead[LE,RO]{\thepage}
\fancyhead[RE]{\nouppercase{\leftmark}}
\fancyhead[LO]{\nouppercase{\rightmark}}
\renewcommand{\headrulewidth}{0.4pt}

% Espaciado
\usepackage{setspace}
\onehalfspacing

% Párrafos sin sangría, con espacio entre ellos
\setlength{\parindent}{0pt}
\setlength{\parskip}{6pt}

%------------------------------------------------------------
% DATOS DE LA TESIS  (modificar según corresponda)
%------------------------------------------------------------
\newcommand{\TituloTesis}{Procesamiento de Señales para Radar de
Penetración Terrestre (GPR)}
\newcommand{\Autor}{[Nombre del Autor]}
\newcommand{\Director}{[Nombre del Director]}
\newcommand{\Institucion}{[Universidad]}
\newcommand{\Facultad}{[Facultad / Departamento]}
\newcommand{\Carrera}{Ingeniería Electrónica / Telecomunicaciones}
\newcommand{\AnioTesis}{2025}

%------------------------------------------------------------
% CONFIGURACIÓN DE LISTINGS (código MATLAB/Python)
%------------------------------------------------------------
\lstset{
  basicstyle=\ttfamily\small,
  keywordstyle=\color{blue}\bfseries,
  commentstyle=\color{gray}\itshape,
  stringstyle=\color{orange!70!black},
  numbers=left,
  numberstyle=\tiny\color{gray},
  stepnumber=1,
  numbersep=8pt,
  frame=single,
  rulecolor=\color{black!30},
  breaklines=true,
  captionpos=b,
  tabsize=4
}

%============================================================
\begin{document}

%============================================================
%  PORTADA
%============================================================
\begin{titlepage}
  \centering
  \vspace*{1.5cm}

  {\Large \textbf{\Institucion}}\\[0.4cm]
  {\large \Facultad}\\[0.4cm]
  {\large \Carrera}

  \vspace{1.5cm}
  \rule{\linewidth}{0.5pt}\\[0.4cm]
  {\LARGE \textbf{\TituloTesis}}\\[0.2cm]
  \rule{\linewidth}{0.5pt}

  \vspace{1.5cm}
  {\large Trabajo Final de Grado}

  \vfill

  \begin{tabular}{rl}
    \textbf{Autor:}    & \Autor    \\[4pt]
    \textbf{Director:} & \Director \\
  \end{tabular}

  \vspace{1.5cm}
  {\large \AnioTesis}
\end{titlepage}

%============================================================
%  PÁGINAS PRELIMINARES
%============================================================
\pagenumbering{roman}

%------------------------------------------------------------
% Índices
%------------------------------------------------------------
\tableofcontents
\clearpage
\listoffigures
\clearpage
\listoftables
\clearpage

%============================================================
%  CUERPO PRINCIPAL
%============================================================
\pagenumbering{arabic}

%============================================================
\chapter{Fundamentos Teóricos}
\label{ch:fundamentos}
%============================================================

\section{Principios de operación del GPR}

El GPR es un sistema de teledetección electromagnética que emite
energía de radiofrecuencia hacia el subsuelo y registra las reflexiones
producidas en las interfases entre materiales de distinta permitividad
eléctrica $\varepsilon_r$. La profundidad de penetración y la resolución
en rango dependen de la frecuencia central y el ancho de banda del sistema.

\subsection{Configuraciones de operación}

Los radares GPR pueden clasificarse según su forma de modulación:

\begin{itemize}
  \item \textbf{GPR de impulso:} emite pulsos muy cortos de banda ultra
    ancha (UWB). Resolución en rango determinada por el ancho del
    pulso.
  \item \textbf{SFCW} (\textit{Stepped-Frequency Continuous-Wave}): barre
    el espectro en pasos discretos de frecuencia.
  \item \textbf{FMCW} (\textit{Frequency-Modulated Continuous-Wave}): barre
    el espectro de forma continua y lineal (chirp).
\end{itemize}

\section{Sistema FMCW: parámetros fundamentales}
\label{sec:parametros_fmcw}

Un sistema FMCW emite una señal cuya frecuencia instantánea varía
linealmente en el tiempo, denominada \textit{chirp}. Los parámetros
principales se resumen en la Tabla~\ref{tab:parametros}.

\begin{table}[H]
  \centering
  \caption{Parámetros principales del sistema FMCW GPR
  (valores de referencia tomados de~\cite{Huang2022}).}
  \label{tab:parametros}
  \begin{tabular}{clll}
    \toprule
    \textbf{Símbolo} & \textbf{Nombre} & \textbf{Definición} & \textbf{Valor de ref.}\\
    \midrule
    $T_c$  & Período del chirp     & —                      & $0{,}3\,\text{s}$          \\
    $B$    & Ancho de banda        & $f_\text{max} - f_\text{min}$ & $1\,\text{GHz}$      \\
    $f_c$  & Frecuencia central    & $(f_\text{max}+f_\text{min})/2$ & $1{,}5\,\text{GHz}$\\
    $S$    & Tasa de barrido       & $B/T_c$ (diente de sierra) & $3{,}33\,\text{GHz/s}$ \\
    $c$    & Velocidad de la luz   & —                      & $3\times10^8\,\text{m/s}$  \\
    $\varepsilon_r$ & Permitividad relativa & — & Dep.\ del material        \\
    \bottomrule
  \end{tabular}
\end{table}

La frecuencia instantánea transmitida es:

\begin{equation}
  f_\text{tx}(t) = f_c - \frac{B}{2} + S\,t,
  \qquad 0 \leq t \leq T_c.
  \label{eq:f_tx}
\end{equation}

\paragraph{Advertencia sobre la convención de $S$ y $T_c$.}
La ecuación~\eqref{eq:f_tx} y la Tabla~\ref{tab:parametros} corresponden a un
chirp de \textbf{diente de sierra}, que es la modulación del sistema de
referencia~\cite{Huang2022}: la frecuencia recorre todo el ancho de banda $B$
en el período completo $T_c$, y por lo tanto $S = B/T_c$.

El sistema desarrollado en esta tesis usa en cambio modulación
\textbf{triangular}, y mantiene a $T_c$ como el \emph{período completo} de la
triangular. Cada rampa dura entonces $T_c/2$ y la tasa de barrido es el doble:
$S = 2B/T_c$ (se deduce en la ecuación~\eqref{eq:sweep_rate}). \textbf{De acá en
adelante rige esa convención}, y todas las expresiones del
Capítulo~\ref{ch:senal_if} están escritas con ella. Es la fuente de error más
fácil al comparar contra la bibliografía: un factor 2 en la frecuencia de batido
y en el espesor estimado.

\section{Propagación en medios estratificados}

La velocidad de propagación de la onda electromagnética en un medio
con permitividad relativa $\varepsilon_r$ es:

\begin{equation}
  v = \frac{c}{\sqrt{\varepsilon_r}}.
  \label{eq:velocidad_medio}
\end{equation}

Para los materiales de mayor interés práctico se indican valores
típicos de $\varepsilon_r$ en la Tabla~\ref{tab:epsilon}.

\begin{table}[H]
  \centering
  \caption{Permitividad relativa de materiales constructivos típicos.}
  \label{tab:epsilon}
  \begin{tabular}{lcc}
    \toprule
    \textbf{Material}    & $\boldsymbol{\varepsilon_r}$ & $\boldsymbol{\sqrt{\varepsilon_r}}$ \\
    \midrule
    Aire                 & $1{,}0$       & $1{,}000$ \\
    Asfalto seco         & $4 - 7$       & $2{,}00 - 2{,}65$ \\
    Asfalto húmedo       & $6 - 9$       & $2{,}45 - 3{,}00$ \\
    Concreto             & $8 - 12$      & $2{,}83 - 3{,}46$ \\
    Pared (cemento)      & $5 - 6$       & $2{,}24 - 2{,}45$ \\
    Hielo                & $3{,}2$       & $1{,}79$ \\
    \bottomrule
  \end{tabular}
\end{table}

%============================================================
\chapter{Señal IF y Frecuencia de Batido}
\label{ch:senal_if}
%============================================================

\section{Señal transmitida y frecuencia instantánea}
\label{sec:fi_inst}

La señal transmitida es un coseno cuya fase instantánea $\phi(t)$
está determinada por la frecuencia instantánea $f(t)$:

\begin{equation}
  s_\text{tx}(t) = A\cos\!\bigl(\phi(t)\bigr),
  \qquad
  \phi(t) = 2\pi\int_0^t f(t')\,dt'.
  \label{eq:stx_general}
\end{equation}

En el radar FMCW con modulación triangular, la frecuencia
instantánea varía linealmente en forma de diente triangular: asciende
de $f_c - B/2$ a $f_c + B/2$ durante el primer semiperíodo
$T_c/2$, y desciende simétricamente durante el segundo. La tasa de
barrido (en módulo) es la misma en ambas ramas:

\begin{equation}
  S \;=\; \frac{B}{T_c/2} \;=\; \frac{2B}{T_c}.
  \label{eq:sweep_rate}
\end{equation}

La frecuencia instantánea es, por tanto:

\begin{equation}
  f(t) =
  \begin{cases}
    \displaystyle f_c - \frac{B}{2} + S\,t,
    & 0 \leq t \leq \dfrac{T_c}{2}, \\[10pt]
    \displaystyle f_c + \frac{B}{2} - S\!\left(t - \frac{T_c}{2}\right),
    & \dfrac{T_c}{2} < t \leq T_c.
  \end{cases}
  \label{eq:f_inst}
\end{equation}

Dado que las dos ramas son simétricas y producen la misma frecuencia
de batido (véase la Sección~\ref{sec:beat_freq}), el desarrollo
analítico se realiza sobre la \textbf{rampa ascendente}
($0 \leq t \leq T_c/2$); los resultados son directamente aplicables
a la rampa descendente por simetría.

Sustituyendo la rama ascendente de~\eqref{eq:f_inst}
en~\eqref{eq:stx_general}:

\begin{equation}
  \phi(t) = 2\pi\int_0^t \!\left(f_c - \frac{B}{2} + S\,t'\right)dt'
  = 2\pi\left[\left(f_c - \frac{B}{2}\right)t + \frac{S}{2}\,t^2\right].
\end{equation}

La señal transmitida durante la rampa ascendente es, entonces:

\begin{equation}
  \boxed{
    s_\text{tx}(t) = A\cos\!\left(
      2\pi\left[\left(f_c - \frac{B}{2}\right)t + \frac{B}{T_c}\,t^2\right]
    \right),
    \qquad 0 \leq t \leq \frac{T_c}{2}.
  }
  \label{eq:stx}
\end{equation}

Esta expresión muestra que la señal es un chirp lineal que parte
de la frecuencia $f_c - B/2$ y llega a $f_c + B/2$ al cabo del
semiperíodo.

\section{Señal recibida}
\label{sec:senal_rx}

Un obstáculo ubicado a distancia $d$ del radar produce una señal
reflejada con retardo $\tau_d = 2d/c$, donde $c$ es la velocidad de
propagación en el medio. Durante la rampa ascendente, la señal
recibida es una réplica de~\eqref{eq:stx} retrasada $\tau_d$ segundos.
Definiendo $\tau_d \ll T_c/2$ (condición habitualmente satisfecha en
GPR), la señal recibida válida en el intervalo
$\tau_d \leq t \leq T_c/2$ es:

\begin{equation}
  \Gamma(t) = A' \cos\!\left(
    2\pi\left[\left(f_c - \frac{B}{2}\right)(t-\tau_d)
    + \frac{B}{T_c}(t-\tau_d)^2\right] - \theta
  \right),
  \label{eq:gamma}
\end{equation}

donde $A'$ absorbe la atenuación de propagación y $\theta$ una fase
inicial arbitraria. La señal~\eqref{eq:gamma} es estructuralmente
idéntica a $s_\text{tx}(t)$, pero con el argumento temporal
desplazado por $\tau_d = 2d/c$.

\section{Proceso de desrampa (\textit{dechirp} / \textit{mixing})}
\label{sec:mixing}

Al multiplicar $s_\text{tx}(t)$ (ec.~\eqref{eq:stx}) por $\Gamma(t)$
(ec.~\eqref{eq:gamma}) y aplicar un filtro pasa-bajos, se obtiene la
\textbf{señal IF} o señal de batido. Usando la identidad trigonométrica:

\begin{equation}
  \cos x \cdot \cos y = \tfrac{1}{2}\bigl[\cos(x - y) + \cos(x + y)\bigr],
\end{equation}

el producto $s_\text{tx}(t)\cdot\Gamma(t)$ genera dos términos: uno de
diferencia de fases (baja frecuencia, conservado por el filtro
pasa-bajos) y uno de suma (alta frecuencia, eliminado). Definiendo
$\tau_d = 2d/c$ por brevedad, las fases instantáneas son:

\begin{align}
  \psi_\text{tx}(t) &= 2\pi\left[\left(f_c-\tfrac{B}{2}\right)t
  + \tfrac{B}{T_c}\,t^2\right], \\
  \psi_\text{rx}(t) &= 2\pi\left[\left(f_c-\tfrac{B}{2}\right)(t-\tau_d)
  + \tfrac{B}{T_c}(t-\tau_d)^2\right] - \theta.
\end{align}

El término de diferencia, tras el filtrado pasa-bajos, es:

\begin{equation}
  x'(t) = A^*\cos\!\bigl[\psi_\text{tx}(t) - \psi_\text{rx}(t)\bigr].
\end{equation}

Calculando la diferencia de fases:

\begin{align}
  \psi_\text{tx} - \psi_\text{rx}
  &= 2\pi\left(f_c - \frac{B}{2}\right)\tau_d
  + \frac{2\pi B}{T_c}\!\left[t^2 - (t-\tau_d)^2\right] + \theta.
\end{align}

Desarrollando el binomio $(t-\tau_d)^2 = t^2 - 2\tau_d t + \tau_d^2$:

\begin{equation}
  t^2 - (t-\tau_d)^2 = 2\tau_d\,t - \tau_d^2,
\end{equation}

con lo que:

\begin{align}
  \psi_\text{tx} - \psi_\text{rx}
  &= 2\pi\left[\left(f_c-\frac{B}{2}\right)\tau_d
    + \frac{2B}{T_c}\tau_d\,t
  - \frac{B}{T_c}\tau_d^2\right] + \theta.
  \label{eq:diff_phase}
\end{align}

La señal IF resultante es, por tanto:

\begin{equation}
  x'(t) = A^*\cos\!\left[
    2\pi\frac{2B}{T_c}\tau_d\,t
    + 2\pi\!\left(f_c-\frac{B}{2}\right)\!\tau_d
    - \frac{2\pi B}{T_c}\tau_d^2 - \theta
  \right],
  \quad \tau_d \leq t \leq \frac{T_c}{2}.
  \label{eq:xIF}
\end{equation}

\section{Frecuencia de batido}
\label{sec:beat_freq}

Identificando en~\eqref{eq:xIF} el coeficiente lineal en $t$,
la \textbf{frecuencia de batido} de la rampa ascendente es:

\begin{equation}
  f_b^+ = \frac{2B}{T_c}\,\tau_d = \frac{2B}{T_c}\cdot\frac{2d}{c}
  = \frac{4Bd}{c\,T_c}.
  \label{eq:fb_up}
\end{equation}

Los términos restantes de~\eqref{eq:xIF} son puramente de fase
(constantes respecto de $t$); agrupándolos en $\varphi^*$:

\begin{equation}
  \varphi^* = 2\pi\!\left(f_c - \frac{B}{2}\right)\!\tau_d
  - \frac{2\pi B}{T_c}\tau_d^2 + \theta,
\end{equation}

la señal IF adopta la forma compacta de tono sinusoidal puro:

\begin{equation}
  \boxed{
    x'(t) = A^*\cos\!\bigl(2\pi f_b^+\, t + \varphi^*\bigr),
    \qquad \tau_d \leq t \leq \frac{T_c}{2}.
  }
  \label{eq:xIF_compact}
\end{equation}

\subsection*{Rampa descendente: simetría del resultado}

Durante la rampa descendente la tasa de barrido es $-S = -2B/T_c$.
Repitiendo el mismo desarrollo con $f(t) = f_c + B/2 - S(t-T_c/2)$
se obtiene una frecuencia de batido $f_b^- = f_b^+$ (el signo de $S$
cancela con el cambio de signo del retardo relativo). En consecuencia,
\textbf{ambas ramas producen la misma frecuencia de batido en módulo}:

\begin{equation}
  \boxed{
    f^* \;=\; f_b^+ \;=\; f_b^- \;=\; \frac{4Bd}{c\,T_c}.
  }
  \label{eq:beat_freq}
\end{equation}

Cada semiperíodo puede procesarse de forma independiente con
la FFT, y los espectros resultantes son equivalentes.
En la práctica se puede promediar la magnitud de ambos para
mejorar la relación señal a ruido.
El signo negativo del coeficiente lineal en la rampa descendente no altera la frecuencia observable: para una señal real, $\cos(-2\pi f_0 t)$ y $\cos(2\pi f_0 t)$ producen el mismo pico espectral en $\lvert f_0 \rvert$. La diferencia de signo se absorbe en la fase inicial y no afecta la estimación de distancia.

\section{Prueba de validación con reflector metálico}
\label{sec:prueba_metalica}

Antes de abordar escenarios con múltiples capas y materiales de
permitividad desconocida, resulta conveniente realizar una prueba
de validación en condiciones controladas. El caso más simple consiste
en apuntar el radar a una \textbf{plancha metálica plana} ubicada a
una distancia $d$ conocida en aire libre.

\subsection{Por qué es un caso ideal}

Un metal conductor actúa como un reflector casi perfecto: su
coeficiente de reflexión en módulo es $|\Gamma| \approx 1$. Esto
implica tres ventajas para la validación:

\begin{enumerate}
  \item \textbf{Reflexión única.} Solo existe una interfase
    (aire--metal), por lo que la señal IF contiene una única
    frecuencia de batido $f^*$, sin ambigüedad.
  \item \textbf{Sin incertidumbre en $\varepsilon_r$.} La propagación
    ocurre íntegramente en aire ($\varepsilon_r = 1$,
    $c_\text{medio} = c$), eliminando una variable desconocida.
  \item \textbf{Resultado verificable \textit{a priori}.} Conocida $d$,
    el valor teórico de $f^*$ se puede calcular antes de la medición
    y comparar directamente con el pico observado en el espectro.
\end{enumerate}

\subsection{Predicción teórica de $f^*$}

En aire libre ($\varepsilon_r = 1$), la ecuación~\eqref{eq:beat_freq}
se simplifica a:

\begin{equation}
  f^* = \frac{4Bd}{c\,T_c},
  \label{eq:beat_freq_aire}
\end{equation}

e inversamente, la distancia estimada a partir de la frecuencia
medida $\hat{f}^*$ es:

\begin{equation}
  \hat{d} = \frac{c\,T_c\,\hat{f}^*}{4B}.
  \label{eq:d_estimada}
\end{equation}

El error absoluto de distancia queda:

\begin{equation}
  \Delta d = \left|\hat{d} - d\right|.
  \label{eq:error_d}
\end{equation}

\subsection{Parámetros del sistema y frecuencias esperadas}

El sistema opera con $B = 1\,\text{GHz}$ (barrido de $1\,\text{GHz}$ a
$2\,\text{GHz}$). El período de la triangular $T_c$, en cambio, \textbf{no es un
valor fijo del sistema}: es un parámetro de la medición, que se ajusta según la
profundidad de interés y las condiciones del ensayo, y que el firmware configura
por consola. La constante del radar es, por lo tanto, función de $T_c$:

\begin{equation}
  \frac{f^*}{d} = \frac{4B}{c\,T_c}
  = \frac{4\times10^9}{3\times10^8\;T_c}
  = \frac{13{,}3}{T_c}\ \ \text{[Hz/m]},
  \qquad T_c\ \text{en segundos}.
  \label{eq:constante_radar}
\end{equation}

La Tabla~\ref{tab:prueba_metalica} evalúa esa constante para tres valores
representativos de $T_c$ y para distancias típicas de un banco de prueba en
interiores.

\begin{table}[H]
  \centering
  \caption{Frecuencia de batido teórica $f^*$ en aire libre
    ($B = 1\,\text{GHz}$) para tres períodos de triangular. Recordar que
  $T_c$ es el período completo: cada rampa dura $T_c/2$.}
  \label{tab:prueba_metalica}
  \begin{tabular}{cccc}
    \toprule
    & \multicolumn{3}{c}{$f^*\,\textnormal{[Hz]}$} \\
    \cmidrule(l){2-4}
    $d\,\textnormal{[m]}$ & $T_c = 10\,\text{ms}$ & $T_c = 50\,\text{ms}$
    & $T_c = 300\,\text{ms}$ \\
    \midrule
    0{,}10 &  133 &  27 &  4{,}4 \\
    0{,}20 &  267 &  53 &  8{,}9 \\
    0{,}50 &  667 & 133 & 22{,}2 \\
    1{,}00 & 1333 & 267 & 44{,}4 \\
    \bottomrule
  \end{tabular}
\end{table}

Dos condiciones acotan la elección de $T_c$, una por arriba y otra por abajo:

\begin{itemize}
  \item \textbf{Barridos lentos ($T_c$ grande).} La señal de batido tiene que
    quedar por encima del pasa-altos no desactivable del ADC PCM1808, cuyo corte
    combinado es de $\approx 1{,}2\,\text{Hz}$. Ya con
    $T_c = 300\,\text{ms}$ un blanco a $0{,}10\,\text{m}$ cae en
    $4{,}4\,\text{Hz}$, sobre el faldón del filtro; con barridos de segundos el
    blanco cercano se pierde adentro del filtro y su fase queda distorsionada.
  \item \textbf{Barridos rápidos ($T_c$ chico).} Hace falta $f_s > 2f^*$
    (Nyquist). Con $T_c = 10\,\text{ms}$ y $f_s = 48\,\text{kHz}$ el alcance
    máximo sin \textit{aliasing} es de $18\,\text{m}$. Pero la señal no sale
    a $48\,\text{kHz}$: se diezma a $6000\,\text{sps}$, con banda limpia
    hasta $2400\,\text{Hz}$ (Sección~\ref{sec:proc_diezmado}). A
    $T_c = 10\,\text{ms}$ eso son apenas $1{,}7\,\text{m}$ aparentes, menos
    que el offset de los propios cables (Capítulo~\ref{ch:cables}). Además,
    el sincronismo por software, que se reconstruye leyendo la triangular,
    no funciona por debajo de $T_c \approx 12\,\text{ms}$
    (Sección~\ref{sec:proc_sincronismo}). Por eso el banco trabaja con
    $T_c = 100\,\text{ms}$.
\end{itemize}

\subsection{Procedimiento experimental propuesto}

\begin{enumerate}
  \item Colocar la antena del radar frente a la plancha metálica,
    con separación $d$ medida con cinta métrica.
  \item Verificar que no haya otros objetos reflectores en el campo
    de visión del radar (paredes, mesas, superficies metálicas
    laterales) para evitar reflexiones espurias.
  \item Adquirir la señal IF durante al menos un período completo de la
    triangular $T_c$, muestreando a $f_s > 2f^*$.
  \item Calcular $f^*_\text{teo}$ con la
    ecuación~\eqref{eq:beat_freq_aire} usando la $d$ medida.
  \item Aplicar la FFT sobre las muestras adquiridas e identificar
    el pico de mayor amplitud.
  \item Calcular $\hat{d}$ con la ecuación~\eqref{eq:d_estimada} y
    obtener $\Delta d$ con la ecuación~\eqref{eq:error_d}.
\end{enumerate}

\subsection{Criterio de éxito}

La resolución en rango teórica del sistema, determinada por el ancho
de banda, es:

\begin{equation}
  \delta d = \frac{c}{2B} = \frac{3\times10^8}{2\times10^9} = 0{,}15\,\text{m}.
  \label{eq:resolucion_rango}
\end{equation}

La prueba se considera exitosa si:

\begin{equation}
  \Delta d < \delta d = 15\,\text{cm}.
  \label{eq:criterio}
\end{equation}

Aplicado sobre la $\hat d$ cruda, este criterio falla por varios metros
en el banco: los cables coaxiles suman un retardo constante que la
ecuación~\eqref{eq:beat_freq_aire} no contempla. El
Capítulo~\ref{ch:cables} deduce ese término, lo mide y muestra cómo se
calibra. El criterio se aplica sobre la distancia ya calibrada.

\section{Las dos reflexiones y el espesor de capa}
\label{sec:dos_reflexiones}

Para una capa de material con espesor $h$ y permitividad $\varepsilon_r$,
existen dos reflexiones:

\begin{itemize}
  \item $R_1$: reflexión en la superficie superior → retardo $\tau_1$
    → frecuencia IF $f_1 = S\,\tau_1$.
  \item $R_2$: reflexión en la superficie inferior → retardo $\tau_2$
    → frecuencia IF $f_2 = S\,\tau_2$.
\end{itemize}

El tiempo extra que tarda la onda en atravesar la capa (ida y vuelta) es:

\begin{equation}
  \tau_\text{extra} = \frac{2h\sqrt{\varepsilon_r}}{c}.
\end{equation}

Combinando con $f_\text{IF} = S\,\tau$ y la tasa de barrido de la triangular,
$S = 2B/T_c$ (ec.~\eqref{eq:sweep_rate}):

\begin{equation}
  \Delta f = f_2 - f_1 = \frac{2B}{T_c}\cdot\frac{2h\sqrt{\varepsilon_r}}{c}
  = \frac{4B\,h\sqrt{\varepsilon_r}}{T_c\,c}.
\end{equation}

Despejando $h$:

\begin{equation}
  \boxed{
    h = \frac{T_c\,\Delta f\cdot c}{4\,\sqrt{\varepsilon_r}\cdot B}
  }
  \label{eq:espesor}
\end{equation}

\subsection{Ejemplo numérico}

Para $T_c = 0{,}3\,\text{s}$, $B = 1\,\text{GHz}$, un asfalto húmedo
($\sqrt{\varepsilon_r} = 2{,}449$) y un valor $\Delta f = 4{,}00\,\text{Hz}$
(valor de ejemplo):

\begin{equation*}
  h = \frac{0{,}3 \times 4{,}0 \times 3\times10^8}
  {4 \times 2{,}449 \times 1\times10^9}
  \approx 36{,}7\,\text{mm}.
\end{equation*}

\subsection{Corrección por separación de antenas}
\label{sub:correccion_antenas}

Cuando las antenas Tx y Rx están separadas una distancia $D$, la
corrección geométrica es:

\begin{equation}
  h = \sqrt{\!\left(\frac{L}{2}\right)^{\!2} - \left(\frac{D}{2}\right)^{\!2}},
  \label{eq:correccion_D}
\end{equation}

donde $L$ es la distancia total dentro del material calculada con la
ecuación~\eqref{eq:espesor}. Si $D = 0$ se recupera $h = L/2$.

%============================================================
\chapter{Arquitectura del Sistema}
\label{ch:arquitectura}
%============================================================

Antes de describir el banco de pruebas físico (Capítulo~\ref{ch:banco}), se
presenta la arquitectura completa del sistema implementado y se repasa,
sobre un caso concreto de blanco estático, cómo los principios expuestos en
el Capítulo~\ref{ch:senal_if} se traducen en la señal que efectivamente
entrega el mezclador.

\section{Diagrama en bloques}
\label{sec:diagrama_bloques}

La Figura~\ref{fig:diagrama_bloques} resume la cadena completa, de un solo
canal, que es el alcance de esta tesis.

La rampa de sintonía es una \textbf{triangular de $0$ a $3\,\text{V}$}
generada fuera del microcontrolador: hoy, un generador de funciones de
laboratorio (Siglent SDG830); más adelante, la placa del generador analógico
del Capítulo~\ref{ch:triangular}. En una primera versión la rampa la
generaba el propio ESP32-C3 con un DAC MCP4725 por I²C, con una tabla de
predistorsión para linearizar el VCO (Secciones~\ref{sec:predistorsion_pchip}
y~\ref{sec:rampa_dac}). Esa solución se abandonó. La no linealidad del VCO se
corrige ahora en el procesamiento (Sección~\ref{sec:proc_theta}).

El ESP32-C3 digitaliza la señal de batido por I²S, desde el PCM1808, y
además lee la triangular por una entrada analógica (GPIO3, a través de un
divisor $\div 2$). Con esas lecturas la PC reconstruye por software el
sincronismo entre el barrido y el muestreo: el período y la fase de la
triangular, y con ellos dónde empieza cada rampa
(Sección~\ref{sec:proc_sincronismo}). No hace falta una señal de sincronismo
del generador.

En la rama de transmisión, la triangular se amplifica, sintoniza
el VCO (banda $1$--$2\,\text{GHz}$), se atenúa $3\,\text{dB}$ y se divide en
un splitter: una salida excita la antena transmisora y la otra actúa como
oscilador local (LO) del mezclador. En la rama de recepción, el eco captado
por la antena receptora se amplifica con un LNA y se mezcla con el LO. El
mezclador entrega, además de la señal de batido $f_\text{beat}$ buscada, un
término de suma en torno a $2f_c$ (varios GHz); el pasa-bajos que sigue
rechaza ese término de suma\footnote{No debe confundirse con el filtro
antialiasing del muestreo: ese ya está resuelto internamente por el
PCM1808 (filtro analógico interno a $1{,}3\,\text{MHz}$ más el
sobremuestreo $64\times$ de su modulador $\Delta\Sigma$), ver
\texttt{docs/PCM1808\_hardware.md}.} y la señal resultante se digitaliza en
el PCM1808.

\begin{figure}[H]
  \centering
  
  \caption{Diagrama en bloques del GPR FMCW, versión de un solo canal
  (alcance de esta tesis). El PCM1808 es estéreo, así que el camino de
  hardware para un segundo canal en cuadratura (mezclador IQ) ya existe y
  queda como ampliación posible, sin implementar.}
  \label{fig:diagrama_bloques}
\end{figure}

\section{Principio de funcionamiento: FMCW sin efecto Doppler}
\label{sec:principio_fmcw_sin_doppler}

El GPR no se desplaza respecto del suelo durante una medición, por lo que,
a diferencia del radar automotriz, no hay efecto Doppler que desplace en
frecuencia la señal recibida. Como se estableció en la
Sección~\ref{sec:beat_freq}, esto tiene una consecuencia directa: las ramas
ascendente y descendente de la triangular producen la \textbf{misma}
frecuencia de batido, así que una sola rampa alcanza para estimar distancia
(no hace falta la asimetría subida/bajada que en radar automotriz se usa
para despejar velocidad).

La Figura~\ref{fig:principio_fmcw} ilustra este principio en tres paneles
alineados en el tiempo: (a) la frecuencia instantánea transmitida y recibida,
con el retardo $\tau$ y la frecuencia de batido $f_\text{beat}$ marcados;
(b) la diferencia de frecuencias entre ambas señales, mostrando que vale lo
mismo en el tramo de subida que en el de bajada; y (c) la tensión a la
salida del mezclador, que oscila a $f_\text{beat}$ salvo en los vértices de
la triangular, donde el retardo hace que $f_\text{tx}$ y $f_\text{rx}$
crucen y la diferencia caiga momentáneamente a cero.

\begin{figure}[H]
  \centering
  
  \caption{Principio de funcionamiento del FMCW para un blanco estático, sin
  efecto Doppler (script \texttt{docs/principio\_fmcw.py}). Los valores de
  $\tau$, $T_m$ y $B$ usados en la figura son adimensionales y se eligieron
  para que el dibujo se lea bien, no para representar las magnitudes reales
  del sistema: en el radar real, $\tau/T_m$ es del orden de $10^{-7}$ para un
  blanco a $1\,\text{m}$, y a esa escala la señal recibida se superpondría
  visualmente por completo a la transmitida.}
  \label{fig:principio_fmcw}
\end{figure}

%============================================================
\chapter{Banco de Pruebas}
\label{ch:banco}
%============================================================

\section{Cadena de RF}
\label{sec:banco_rf}

La Figura~\ref{fig:banco_rf} muestra la primera versión armada de la
cadena de RF sobre una plaqueta de prueba, con los bloques rotulados a
mano: VCO, amplificador, atenuador, splitter y la etapa de mezcla hacia
la antena transmisora.

\begin{figure}[H]
  \centering
  
  \caption{Primer banco de la cadena de RF: VCO, amplificador,
  atenuador y splitter interconectados sobre una plaqueta de prueba
  rotulada a mano.}
  \label{fig:banco_rf}
\end{figure}

\section{Banco de mediciones}
\label{sec:banco_completo}

Las Figuras~\ref{fig:banco_completo1} y~\ref{fig:banco_completo2}
muestran el banco completo de mediciones: fuente DC, generador de
funciones, la cadena de RF de la Figura~\ref{fig:banco_rf} y la
notebook corriendo el software de adquisición/análisis (el trazo verde
es la señal capturada y el azul su espectro).

\begin{figure}[H]
  \centering
  
  \caption{Banco de mediciones: fuente DC, generador de funciones,
  cadena de RF y notebook con el software de análisis.}
  \label{fig:banco_completo1}
\end{figure}

\begin{figure}[H]
  \centering
  
  \caption{Banco de mediciones, vista general del puesto de trabajo.}
  \label{fig:banco_completo2}
\end{figure}

%============================================================
\chapter{Caracterización del VCO}
\label{ch:vco}
%============================================================

\section{Curva de sintonía del VCO}
\label{sec:curva_vco}

El VCO se caracterizó punto a punto, barriendo la tensión de control
$V_\text{in}$ de $0$ a $3{,}321\,\text{V}$ en pasos de $100\,\text{mV}$
(34 puntos) y midiendo la frecuencia de salida con un analizador de
espectro (precisión de $1\,\text{MHz}$). La Figura~\ref{fig:curva_vco}
muestra la curva resultante junto con la sensibilidad $dF/dV$.

\begin{figure}[H]
  \centering
  
  \caption{Curva de sintonía medida del VCO: frecuencia de salida en
  función de la tensión de control $V_\text{in}$ (antes del mapeo a la
  tensión real de sintonía $V_\text{osc}$, más alta, que entrega el
  amplificador que ataca al VCO). El rango sombreado indica los
  $0$--$3{,}00\,\text{V}$ que efectivamente se usan para generar la
  rampa del radar.}
  \label{fig:curva_vco}
\end{figure}

En el rango medido completo ($0{,}002$ a $3{,}321\,\text{V}$) la
frecuencia va de $943$ a $2042\,\text{MHz}$. La sensibilidad $dF/dV$
no es constante: varía entre $167$ y $468\,\text{MHz/V}$ (relación
$2{,}8$ a $1$ entre el extremo más y menos sensible), lo cual es la
razón por la que una rampa de tensión lineal no produce una rampa de
frecuencia lineal. Cómo se corrige se trata en la
Sección~\ref{sec:vco_correccion_actual}.

Para no exceder el rango seguro de operación del VCO ni del amplificador, el
rango de tensión que efectivamente se usa para generar la rampa del
radar se acotó a $V_\text{in} \in [0{,}00,\ 3{,}00]\,\text{V}$, lo que
corresponde a una banda de $943$ a $1982\,\text{MHz}$
($BW = 1039\,\text{MHz}$).

\section{Tabla de valores medidos}
\label{sec:tabla_vco}

La Tabla~\ref{tab:vco_completa} lista los 34 puntos medidos.

\input{tabla_vco.tex}

Para el último punto del barrido ($V_\text{in} = 3{,}321\,\text{V}$) se
midió una tensión de $16{,}490\,\text{V}$ a la entrada del VCO (tras el
amplificador que ataca al VCO), que se encuentra dentro del rango
de funcionamiento del dispositivo (hasta $20\,\text{V}$).

\section{Primera solución: predistorsión con DAC (en desuso)}
\label{sec:predistorsion_pchip}

\textbf{Esta sección y la siguiente documentan una solución que ya no se
usa.} En la primera versión del banco, el propio ESP32-C3 generaba la rampa
de sintonía con un DAC MCP4725 por I²C, y la no linealidad del VCO se
compensaba en esa rampa. El banco actual sintoniza el VCO con una triangular
externa, lineal en tensión, y corrige la no linealidad en el procesamiento
(Sección~\ref{sec:vco_correccion_actual}). Se conservan porque la inversión
de la curva medida y su verificación siguen siendo válidas, y porque
explican la elección de la solución actual.

Como se señaló en la Sección~\ref{sec:curva_vco}, la sensibilidad
$dF/dV$ del VCO no es constante. En un radar FMCW la frecuencia de
batido es proporcional a $dF/dt$, de modo que si la rampa de tensión
es lineal en el tiempo pero $dF/dV$ no lo es, la frecuencia tampoco
barre linealmente: el eco de un único blanco puntual queda repartido
sobre todo el rango de pendientes en lugar de concentrarse en una
única frecuencia de batido, y el pico de distancia se ensancha.

Para corregirlo se invierte la curva medida: en vez de recorrer la
tensión linealmente, se recorre la \emph{frecuencia} linealmente y se
calcula, para cada instante, qué tensión hace falta. La inversión se
hace ajustando la curva de 34 puntos (Tabla~\ref{tab:vco_completa})
con un interpolador PCHIP (\textit{Piecewise Cubic Hermite
Interpolating Polynomial}) tanto en el sentido $V\!\to\!F$ como en su
inversa $F\!\to\!V$; se eligió PCHIP en lugar de un spline cúbico
porque preserva la monotonía de los datos medidos sin generar
oscilaciones entre puntos que no están respaldadas por una medición.
La tabla resultante (1024 entradas, cuantizadas a los 12~bits del DAC
MCP4725) se calcula una única vez de forma offline con el script
\texttt{VCO/analisis\_vco.py} y se vuelca al firmware como
\texttt{tabla\_vco.h}, de modo que el ESP32-C3 solo indexa la tabla en
tiempo de ejecución sin necesidad de punto flotante.

La Figura~\ref{fig:curva_vco_completa} resume el procedimiento y su
resultado: arriba a la izquierda, la curva medida con el ajuste PCHIP
superpuesto y el rango efectivamente usado ($0$ a $3\,\text{V}$)
sombreado; arriba a la derecha, la sensibilidad punto a punto
$dF/dV$; abajo a la izquierda, la rampa de tensión que efectivamente
entrega el DAC con y sin predistorsión; abajo a la derecha, la
frecuencia resultante en función del tiempo, comparada con la recta
ideal.

\begin{figure}[H]
  \centering
  
  \caption{Linealización del barrido del VCO mediante predistorsión
  (script \texttt{VCO/analisis\_vco.py}). Arriba: curva de sintonía
  medida con ajuste PCHIP (izq.) y sensibilidad $dF/dV$ punto a punto
  sin suavizar (der.). Abajo: rampa de tensión del DAC con y sin
  predistorsión (izq.) y frecuencia resultante en función del tiempo
  normalizado, comparada con la recta ideal (der.).}
  \label{fig:curva_vco_completa}
\end{figure}

Sobre el rango útil $V_\text{in} \in [0{,}002,\ 3{,}000]\,\text{V}$
($943$ a $1982\,\text{MHz}$, $BW = 1039\,\text{MHz}$, consistente con
la Sección~\ref{sec:curva_vco}), \textbf{sin predistorsión} la
pendiente $dF/dt$ varía entre $0{,}68$ y $1{,}29$ veces su valor
medio: un blanco puntual a $1\,\text{m}$ se desparramaría, por este
efecto, entre aproximadamente $0{,}68$ y $1{,}29\,\text{m}$.
\textbf{Con predistorsión}, $dF/dt$ queda acotado entre $0{,}991$ y
$1{,}010$ veces el promedio (variación de apenas $\pm 1\%$), con un
error de frecuencia residual de $0{,}20\,\text{MHz}$ pico
($0{,}08\,\text{MHz}$ rms), equivalente al $0{,}020\%$ del ancho de
banda. El escalón de tensión del DAC de 12~bits
($3{,}300\,\text{V}/4095 \approx 0{,}806\,\text{mV}$) equivale
típicamente a $0{,}27\,\text{MHz}$, valor que fija el piso de
resolución de la tabla.

\textit{Nota sobre la sensibilidad graficada:} el panel superior
derecho de la Figura~\ref{fig:curva_vco_completa} usa la derivada
cruda punto a punto ($444$ a $170\,\text{MHz/V}$), distinta de la
sensibilidad ya reportada en la Sección~\ref{sec:curva_vco} ($167$ a
$468\,\text{MHz/V}$), que se calculó suavizando con un filtro
Savitzky--Golay sobre la curva PCHIP (script
\texttt{VCO/grafico\_vco.py}). La derivada cruda arrastra la
cuantización de la medición (frecuencia redondeada a $1\,\text{MHz}$,
pasos de $100\,\text{mV}$) y por eso exagera el rango de
sensibilidad; ambos cálculos coinciden en lo cualitativo (la
sensibilidad varía fuertemente y no es constante), pero difieren en
el valor puntual según el método de derivación utilizado.

\section{Rampa del DAC medida, con y sin predistorsión (en desuso)}
\label{sec:rampa_dac}

Se capturó con el osciloscopio la salida real del DAC MCP4725 (la
rampa de sintonía del VCO), con la predistorsión activada y
desactivada, y a dos frecuencias de repetición de la rampa (PRF) de
$50\,\text{ms}$ y $5\,\text{ms}$. La Figura~\ref{fig:capturas_dac}
muestra las cuatro capturas.

\begin{figure}[H]
  \centering
  
  \caption{Salida del DAC MCP4725 (rampa de sintonía del VCO), con y sin
  predistorsión, a PRF de $50\,\text{ms}$ y $5\,\text{ms}$. Se indica el
  desvío RMS de cada rampa respecto de la recta ideal.}
  \label{fig:capturas_dac}
\end{figure}

Sin predistorsión, la rampa de tensión es lineal por construcción pero
—dado que $dF/dV$ no es constante— produce una rampa de frecuencia no
lineal. Con predistorsión, la tabla invertida (\texttt{tabla\_vco.h},
generada por \texttt{VCO/analisis\_vco.py}) corrige esto, y la comba
resultante sobre la rampa de tensión (los $32$--$53\,\text{mV}$~rms
medidos según la captura) es consistente con lo que predice la tabla
($57\,\text{mV}$~rms), dentro del ruido de cuantización del
osciloscopio.

\section{Solución actual: corrección en el procesamiento}
\label{sec:vco_correccion_actual}

Hay dos formas de que el eco de un blanco puntual caiga en una única
frecuencia de batido a pesar de la curva del VCO:
\begin{enumerate}
  \item \textbf{Linealizar el barrido} (predistorsión): deformar la rampa de
    tensión para que la \emph{frecuencia} transmitida crezca linealmente con
    el tiempo. Es lo que hacía el DAC de las secciones anteriores.
  \item \textbf{Linealizar el muestreo} (remuestreo): dejar que el barrido
    sea no lineal, con una rampa de tensión lineal, y tomar las muestras del
    batido a intervalos iguales de \emph{frecuencia} en lugar de intervalos
    iguales de tiempo. Se hace en la PC, interpolando la señal digitalizada
    sobre la variable $\theta(t) = \bigl(f(t) - f(0)\bigr)/\alpha_0$.
\end{enumerate}
Las dos usan la misma curva medida de la Tabla~\ref{tab:vco_completa}, y en
las dos el resultado es un tono puro de frecuencia
$\alpha_0\tau$ (Sección~\ref{sec:proc_theta}). El banco actual usa la
segunda. La Tabla~\ref{tab:vco_comparacion} resume por qué.

\begin{table}[H]
  \centering
  \caption{Predistorsión de la rampa contra remuestreo de la señal.}
  \label{tab:vco_comparacion}
  \small
  \begin{tabular}{>{\raggedright\arraybackslash}p{3.0cm}
                  >{\raggedright\arraybackslash}p{5.4cm}
                  >{\raggedright\arraybackslash}p{5.4cm}}
    \toprule
    & \textbf{Predistorsión (DAC)} & \textbf{Remuestreo en $\theta$ (actual)} \\
    \midrule
    Dónde se corrige & en el hardware, antes de transmitir
      & en el software, después de digitalizar \\
    Quién genera la rampa & el ESP32-C3, escalón por escalón por I²C
      & cualquier generador de triangular \\
    Resolución de la rampa & escalones de $0{,}8\,\text{mV}$
      ($\sim 0{,}27\,\text{MHz}$) y tasa limitada por el bus
      & continua, sin escalones \\
    Carga del microcontrolador & genera la rampa y digitaliza
      & sólo digitaliza (y lee la triangular) \\
    Cambiar la curva del VCO & regenerar la tabla y reflashear
      & cambiar el archivo de la curva en la PC \\
    Supuesto principal & la tabla invertida es exacta
      & la rampa de tensión es lineal y va de $0$ a $3\,\text{V}$ \\
    \bottomrule
  \end{tabular}
\end{table}

El supuesto del remuestreo es una rampa de tensión \emph{lineal} con el
rango completo de $0$ a $3\,\text{V}$. Si la triangular se recorta o no
llega a los extremos, el mapa $\theta$ ya no corresponde al barrido real y
las distancias salen escaladas. Por eso el programa de adquisición vigila
en todo momento la fracción de lecturas de la triangular que tocan los
rieles del ADC. Ese chequeo detectó una vez una resistencia suelta del
divisor de GPIO3.

\section{Distorsión armónica del VCO}
\label{sec:vco_armonicos}

Todo lo anterior trata al VCO como una fuente de \emph{un solo} tono cuya
frecuencia sigue la curva $F(V)$. Un oscilador real no entrega una sinusoide
pura: su salida trae además componentes en el doble, el triple, etc.\ de la
frecuencia instantánea. Esta sección mide esos armónicos, desarrolla qué
producen a la salida del mezclador y en qué frecuencia de batido aparecen, y
de ahí saca los requisitos de un filtro de RF que los elimine antes de que
lleguen al mezclador. El diseño de ese filtro queda para una sección
posterior.

\subsection{Medición con el analizador de espectro}
\label{sub:armonicos_medicion}

Se observó la salida del VCO barrido por el generador de triangular propio
(Capítulo~\ref{ch:triangular}, versión con LM324, $T_c \approx 100\,\text{ms}$)
con un analizador de espectro Siglent SSA3032X, de $0{,}8$ a $3\,\text{GHz}$,
con RBW de $1\,\text{MHz}$, atenuador interno de $50\,\text{dB}$ y la traza en
\textit{Max Hold}. La Figura~\ref{fig:ssa_maxhold} es la pantalla del
analizador y la Figura~\ref{fig:vco_maxhold}, las trazas exportadas y
procesadas.

\begin{figure}[H]
  \centering
  
  \caption{Pantalla del analizador de espectro (Siglent SSA3032X, Max Hold,
  $0{,}8$ a $3\,\text{GHz}$, RBW $1\,\text{MHz}$) con el VCO barrido por la
  triangular. De $\sim\!1$ a $\sim\!2\,\text{GHz}$ está la fundamental, el
  barrido útil del radar. A partir de $\sim\!2\,\text{GHz}$ aparece el segundo
  armónico, unos $8\,\text{dB}$ por debajo. Medición del 2026-11-02.}
  \label{fig:ssa_maxhold}
\end{figure}

\begin{figure}[H]
  \centering
  
  \caption{Las tres trazas exportadas del analizador. En azul, la captura
  más llena. Se marcan la banda de la fundamental, la del segundo armónico y
  la franja de $15\,\text{MHz}$ en la que se superponen. Las líneas
  punteadas son los extremos que predice la curva estática del VCO para la
  triangular medida con el osciloscopio.}
  \label{fig:vco_maxhold}
\end{figure}

\textbf{Cómo leer el Max Hold.} El analizador barre $2{,}2\,\text{GHz}$ en
$216\,\text{ms}$ y el VCO barre $1\,\text{GHz}$ en $50\,\text{ms}$. En cada
barrido el analizador encuentra al chirp sólo en los puntos donde los dos
barridos se cruzan, y el Max Hold va acumulando esos cruces. Por eso la traza
tiene forma de peine y se va llenando de a poco. Lo que muestra es la
\emph{envolvente} de todo lo que el VCO emitió a lo largo de muchos períodos,
no lo que emite en un instante. Esto importa en la
Sección~\ref{sub:armonicos_superposicion}.

Los resultados se resumen en la Tabla~\ref{tab:armonicos_medidos}.

\begin{table}[H]
  \centering
  \caption{Lo medido en la salida del VCO en Max Hold (2026-11-02).}
  \label{tab:armonicos_medidos}
  \begin{tabular}{>{\raggedright\arraybackslash}p{4.2cm}
                  >{\raggedright\arraybackslash}p{9.0cm}}
    \toprule
    Fundamental & $f_\text{min} = 988$ a $f_\text{max} = 1991\,\text{MHz}$
      en la captura más llena ($1029$ a $1991$ en las otras dos),
      $\sim\!0$ a $+2\,\text{dBm}$ en pantalla \\
    Segundo armónico & desde $2f_\text{min} = 1976\,\text{MHz}$, a
      $-8$/$-9\,\text{dBc}$ ($-6$ a $-12$ según la frecuencia) \\
    Superposición & $2f_\text{min} < f_\text{max}$ por $15\,\text{MHz}$ en
      la captura más llena; en las otras dos, $2f_\text{min} =
      2058\,\text{MHz}$ y no se superponen \\
    Tercer armónico & $3f(t)$ va de $2{,}96$ a $5{,}97\,\text{GHz}$: fuera
      del span, sin medir \\
    Piso de la medición & $-30\,\text{dBm}$ (por el atenuador de
      $50\,\text{dB}$): lo que esté por debajo de $\sim\!-32\,\text{dBc}$ no
      se ve \\
    \bottomrule
  \end{tabular}
\end{table}

La banda medida es más baja y más angosta que la que predice la curva
estática para la triangular medida con el osciloscopio ($0{,}36$ a
$3{,}36\,\text{V} \to 1089$ a $2052\,\text{MHz}$). Arriba la frecuencia se
planta en $1991\,\text{MHz}$, que en la curva estática corresponde a
$3{,}02\,\text{V}$: lo más probable es que sature el amplificador que ataca
al VCO. Esa diferencia no cambia el análisis que sigue, pero sí los números
del filtro, que dependen de $f_\text{min}$ y $f_\text{max}$.

\subsection{La señal del VCO con armónicos}
\label{sub:armonicos_modelo}

Con la fase instantánea $\psi(t) = 2\pi\int_0^t f(u)\,du$ de la
Sección~\ref{sec:proc_theta}, la salida del VCO se escribe como una suma de
armónicos:
\begin{equation}
  s_\text{VCO}(t) = \sum_{n\geq 1} a_n \cos\!\bigl(n\,\psi(t) + \beta_n\bigr),
  \label{eq:vco_armonicos}
\end{equation}
donde $a_n$ es la amplitud del armónico $n$ y $\beta_n$ una fase fija. Se
define el nivel relativo de cada armónico respecto de la fundamental,
\begin{equation}
  H_n = 20\log_{10}\frac{a_n}{a_1}\quad[\text{dBc}],
\end{equation}
que según la Tabla~\ref{tab:armonicos_medidos} vale $H_2 \approx
-8\,\text{dBc}$.

La frecuencia instantánea del armónico $n$ es la derivada de su fase:
\begin{equation}
  f_n(t) = \frac{1}{2\pi}\frac{d}{dt}\bigl[n\,\psi(t)\bigr] = n\,f(t).
\end{equation}
\textbf{Cada armónico es otro chirp}: arranca en $n f_\text{min}$, termina en
$n f_\text{max}$ y barre con una pendiente $n$ veces mayor. Es decir, si en
un instante el VCO está en una frecuencia $f$, en ese mismo instante emite
también $2f$, $3f$, etc. Mientras la fundamental barre de $\sim\!1$ a
$\sim\!2\,\text{GHz}$:
\begin{itemize}
  \item el \textbf{segundo armónico} barre de $\sim\!2$ a
    $\sim\!4\,\text{GHz}$ (con la banda medida, de $1976$ a
    $3982\,\text{MHz}$);
  \item el \textbf{tercer armónico} barre de $\sim\!3$ a
    $\sim\!6\,\text{GHz}$ (de $2964$ a $5973\,\text{MHz}$).
\end{itemize}
Por ejemplo, cuando la fundamental pasa por $1{,}5\,\text{GHz}$, el VCO
emite a la vez $3\,\text{GHz}$ y $4{,}5\,\text{GHz}$. La
Figura~\ref{fig:armonicos_fantasmas}a dibuja los tres chirps a lo largo de un
período de la triangular.

Como el splitter divide la señal \emph{después} del VCO, el LO y la antena
transmisora llevan los mismos armónicos. El eco que vuelve de un blanco
con retardo total $\tau$ (aire más cables, ecuación~\eqref{eq:tau_total}) es
\begin{equation}
  s_\text{RX}(t) = \sum_{n\geq 1} g_n\,a_n
    \cos\!\bigl(n\,\psi(t-\tau) + \beta_n + \gamma_n\bigr),
  \label{eq:rx_armonicos}
\end{equation}
donde $g_n$ y $\gamma_n$ son la ganancia y la fase de todo el camino de
recepción (cables, bocinas, blanco, LNA) evaluados en la frecuencia del
armónico $n$. No hay motivo para que $g_n$ sea igual a $g_1$: las bocinas,
los cables y el LNA están pensados para la banda de $1$ a $2\,\text{GHz}$, no
para $2$ a $6\,\text{GHz}$.

\subsection{Qué sale del mezclador}
\label{sub:armonicos_mezclador}

Se modela el mezclador como un multiplicador ideal: su salida es el producto
del LO por la señal de RF. Con~\eqref{eq:vco_armonicos} en el LO
y~\eqref{eq:rx_armonicos} en RF, el producto es una doble suma: cada
armónico $m$ del LO se multiplica con cada armónico $n$ del eco,
\begin{equation}
  \begin{split}
  s_\text{LO}(t)\,s_\text{RX}(t) = \sum_{m\geq 1}\sum_{n\geq 1}
  \frac{a_m\,g_n\,a_n}{2}\Bigl[
    &\cos\!\bigl(m\,\psi(t) - n\,\psi(t-\tau) + \dots\bigr) \\
  + &\cos\!\bigl(m\,\psi(t) + n\,\psi(t-\tau) + \dots\bigr)
  \Bigr],
  \end{split}
  \label{eq:producto_armonicos}
\end{equation}
donde los puntos suspensivos agrupan las fases fijas $\beta_m$, $\beta_n$ y
$\gamma_n$. Para ver qué término llega a la señal digitalizada alcanza con
mirar la frecuencia instantánea de cada uno. Usando
$f(t-\tau) \approx f(t) - f'(t)\,\tau$ (porque $\tau$, decenas de
nanosegundos, es despreciable frente a la escala en que cambia $f$):

\begin{itemize}
  \item \textbf{Términos de suma.} Frecuencia $m f(t) + n f(t-\tau) \approx
    (m+n) f(t)$: de $2$ a varios GHz. Los elimina el pasabajos que sigue al
    mezclador (Capítulo~\ref{ch:filtro}), igual que el término de suma de la
    fundamental en la Sección~\ref{sec:mixing}.
  \item \textbf{Términos de diferencia con $m \neq n$.} Frecuencia
    \begin{equation}
      m f(t) - n f(t-\tau) \approx (m-n)\,f(t) + n\,f'(t)\,\tau .
    \end{equation}
    Como $f(t) \geq f_\text{min} \approx 1\,\text{GHz}$, esto vale al menos
    $|m-n| \times 1\,\text{GHz}$: también los elimina el pasabajos. Para que
    un término cruzado cayera en banda base haría falta que $m f(t) \approx n
    f(t-\tau)$, por ejemplo que la frecuencia del eco fuese el doble que la
    del LO. Con la banda medida eso exige un retardo de medio barrido
    ($\sim\!25\,\text{ms}$, miles de kilómetros): no ocurre.
  \item \textbf{Términos de diferencia con $m = n$.} Acá la parte en
    $f(t)$ se cancela y queda
    \begin{equation}
      n\,f(t) - n\,f(t-\tau) \approx n\,f'(t)\,\tau .
    \end{equation}
    Es \textbf{$n$ veces el batido de la fundamental}. Cae en banda base,
    pasa el pasabajos y el PCM1808 lo digitaliza junto con la señal buscada.
\end{itemize}

\textbf{La conclusión es que el único producto de los armónicos que llega a la
señal digitalizada es el de cada armónico del LO con el mismo armónico del
eco}: el segundo con el segundo, el tercero con el tercero. Ninguna mezcla
cruzada (la fundamental de uno con el armónico del otro) sobrevive.

\subsection{Dónde cae: el fantasma en $n f_b$}
\label{sub:armonicos_fantasma}

Con la notación de la Sección~\ref{sec:proc_theta}, la fase del término
$m=n$ es $n$ veces la del batido de la fundamental,
ecuación~\eqref{eq:proc_fase_batido}:
\begin{equation}
  \Delta\psi_n(t) = n\,\psi(t) - n\,\psi(t-\tau) \approx n \cdot 2\pi\,\tau\,f(t).
\end{equation}
Al remuestrear en $\theta$, con $f(t) = f(0) + \alpha_0\theta$, queda
\begin{equation}
  \boxed{\;
  x_n(\theta) = \frac{a_n^2\,g_n}{2}
  \cos\!\bigl(2\pi\,n\,\alpha_0\tau\,\theta + \varphi_n\bigr),
  \qquad f_{b,n} = n\,f_b = n\,\alpha_0\tau .
  \;}
  \label{eq:fantasma}
\end{equation}

Tres consecuencias:

\begin{enumerate}
  \item \textbf{Frecuencia.} Cada eco deja, además de su pico en $f_b$, un
    pico en $2f_b$, otro en $3f_b$, etc. Como $f_b$ es proporcional al
    retardo total, el fantasma del armónico $n$ es indistinguible de un
    blanco real con retardo $n\tau$. En distancia, con el offset de los
    cables de la ecuación~\eqref{eq:d_offset}, un blanco en $d$ deja un
    fantasma en
    \begin{equation}
      \hat d_n = n\,(d + d_\text{offset}) - d_\text{offset},
      \label{eq:d_fantasma}
    \end{equation}
    o sea, el offset de los cables también se multiplica por $n$.
  \item \textbf{Forma.} El remuestreo en $\theta$ corrige al fantasma igual
    que a la fundamental: si la curva del VCO es la correcta, el fantasma es
    un tono puro y da un pico angosto. No se desparrama por la banda, sino que
    aparece como un blanco más. Si la curva tiene error, el error de fase del
    fantasma es $n$ veces el de la fundamental y el pico se ensancha más.
  \item \textbf{Nivel.} Respecto del batido de la fundamental, la amplitud
    del fantasma es $(a_n/a_1)^2\,(g_n/g_1)$. En dB:
    \begin{equation}
      R_n = 2H_n + \Delta G_n,
      \qquad \Delta G_n = 20\log_{10}\frac{g_n}{g_1}.
      \label{eq:nivel_fantasma}
    \end{equation}
    El armónico cuenta \emph{dos veces}, porque está en el LO y en el eco.
    Con $H_2 = -8\,\text{dBc}$ el fantasma del segundo armónico queda en
    $-16\,\text{dB} + \Delta G_2$.
\end{enumerate}

\textbf{Ejemplo numérico.} En las mediciones de la placa del 2026-09-28
($T_c = 100\,\text{ms}$, $138{,}5\,\text{Hz/m}$), la placa a $1\,\text{m}$
da su batido en $f_b \approx 509\,\text{Hz}$, que corresponde a
$3{,}68\,\text{m}$ de distancia aparente sin calibrar ($1\,\text{m}$ de aire
más $\sim\!2{,}7\,\text{m}$ de cables, bocinas y retardo interno). Su
fantasma del segundo armónico cae en $2f_b \approx 1018\,\text{Hz}$
($7{,}35\,\text{m}$ aparentes, o $\sim\!4{,}7\,\text{m}$ ya calibrado según
la ecuación~\eqref{eq:d_fantasma}), y el del tercero, en
$3f_b \approx 1527\,\text{Hz}$. Los dos caen dentro de la banda que
el firmware digitaliza limpia ($0$ a $2400\,\text{Hz}$,
Sección~\ref{sec:proc_diezmado}). La Figura~\ref{fig:armonicos_fantasmas}
resume las dos caras del problema: en (a), dónde están los armónicos en RF;
en (b), dónde aparecen después del mezclador.

\begin{figure}[H]
  \centering
  
  \caption{(a) Frecuencia instantánea de la fundamental y de los armónicos
  $2$ y $3$ a lo largo de un período de la triangular, con la banda medida
  en Max Hold. Es esquemática (barrido dibujado lineal entre los extremos
  medidos). En trazo grueso, el tramo cercano a los vértices de abajo donde
  el segundo armónico cae dentro de la banda útil. (b) Lo que llega a banda
  base para la placa a $1\,\text{m}$: el batido y sus fantasmas en $2f_b$ y
  $3f_b$. Niveles estimados con una simulación del radar completo
  (mezclador multiplicador, segundo armónico del Max Hold, tercero supuesto
  a $-15\,\text{dBc}$).}
  \label{fig:armonicos_fantasmas}
\end{figure}

% TODO: contraste con lo medido. Falta revisarlo antes de incluirlo; los
% datos son de GPRv2/simulaciones_meep/armonicos/ (LEEME.md y
% figuras/adaptada/resumen.txt):
% - la simulacion de punta a punta (MEEP + Max Hold + mismo procesado) da el
%   fantasma 2f_b de un blanco puntual en R_2 ~ -23 dB, o sea Delta G_2 ~ -7 dB;
% - en las capturas reales de la placa (0,7 a 1,2 m, 2026-09-28) el espectro
%   tiene en 2f_b entre -22 y -28 dB respecto del pico, pero ahi puede haber
%   otros ecos: no aisla el fantasma;
% - la energia de esas capturas entre 650 y 1400 Hz (-25,8 dB de potencia
%   media) la reproduce la simulacion solo con el 2o armonico.
% Para cerrarlo: medicion con TX y RX unidos por cable y atenuador (un solo
% retardo, todo pico en 2f_b es fantasma).

\subsection{Que se superpongan en el espectro no es el problema}
\label{sub:armonicos_superposicion}

Mirando la Figura~\ref{fig:ssa_maxhold} es tentador pensar que el problema
está en la franja de $\sim\!2\,\text{GHz}$ donde el segundo armónico
``pisa'' la fundamental. Pero el Max Hold muestra la envolvente de muchos
períodos, no un instante. En la franja de superposición, el segundo armónico
corresponde al vértice de abajo de la triangular ($f(t)\approx
f_\text{min}$, principio y final de cada rampa) y la fundamental, al
vértice de arriba ($f(t)\approx f_\text{max}$, mitad del período). Ocurren en
\emph{instantes distintos}, separados medio período, y por la
Sección~\ref{sub:armonicos_mezclador} su producto ($m=1$, $n=2$) no cae en
banda base.

\textbf{El fantasma existe aunque no haya ninguna superposición}: aparece
siempre que el LO y el eco lleven el mismo armónico. Bajar la banda para que
$2f_\text{min}$ quede por encima de $f_\text{max}$ no lo saca. Lo que la
superposición sí determina es si un \emph{filtro} puede separar la
fundamental de su armónico (Sección~\ref{sub:armonicos_requisitos}).

\subsection{Por qué no se puede corregir en banda base}
\label{sub:armonicos_banda_base}

El fantasma de un eco en $f_b$ cae en $2f_b$, que es justamente la
frecuencia de un blanco real al doble de retardo. Un filtro en banda base no
puede separarlos, porque están en la misma banda: quitar $2f_b$ es quitar
también los blancos que estén ahí. En un GPR esto es especialmente grave. El
eco más fuerte suele ser el acoplamiento directo entre antenas o la
reflexión en la superficie del suelo. Su fantasma aparece, $20$ a
$25\,\text{dB}$ por debajo, como una \emph{interfase enterrada} que no
existe, y puede tapar o imitar un eco real a esa profundidad.

Restarlo por software es posible en principio, porque su posición se conoce
(ecuación~\eqref{eq:d_fantasma}). Su nivel y su fase, en cambio, dependen de
$g_n$ y $\gamma_n$, que cambian con el blanco y con el armado. La salida
limpia es que los armónicos no lleguen al mezclador: \textbf{un filtro
pasabajos de RF que corte a partir de $\sim\!2\,\text{GHz}$}.

\subsection{Requisitos del filtro de RF}
\label{sub:armonicos_requisitos}

\paragraph{Dónde va.} Antes del splitter, a la salida del VCO (o del
amplificador de RF, si éste genera sus propios armónicos), de manera que el
LO y la antena transmisora reciban la señal ya filtrada. Hay dos razones:

\begin{itemize}
  \item \textbf{Su retardo se cancela.} Un filtro cerca de su corte tiene un
    retardo de grupo $\tau_g(f)$ de varios nanosegundos que cambia con la
    frecuencia. Antes del splitter ese retardo es común a los dos caminos, y
    el mezclador sólo ve la diferencia: lo que sobrevive es
    $2\pi\,\tau_g(f)\,f'(t)\,\tau$, del orden de $10^{-5}\,\text{rad}$. Si el
    filtro estuviera sólo en el camino de transmisión, $\tau_g(f(t))$ se
    sumaría al retardo de los cables, el retardo total variaría a lo largo
    del barrido y el pico se ensancharía.
  \item \textbf{Cuenta dos veces.} Con el filtro antes del splitter, el
    armónico se atenúa en el LO y en el eco. Si $A_n$ es la atenuación del
    filtro en $n f$, la ecuación~\eqref{eq:nivel_fantasma} pasa a
    \begin{equation}
      R_n = 2\,(H_n - A_n) + \Delta G_n .
    \end{equation}
\end{itemize}

Alcanza con que uno de los dos lados esté limpio. Por la
Sección~\ref{sub:armonicos_mezclador}, el producto que molesta exige el
armónico $n$ en el LO \emph{y} en el eco. Un mezclador conmutado genera
internamente armónicos de su LO aunque el LO sea puro, pero éstos no tienen
con qué batir en banda base si el eco no trae armónicos.

\paragraph{Cuánto tiene que atenuar.} El punto de partida es el nivel del
fantasma con el filtro puesto, que se acaba de escribir:
\begin{equation*}
  R_2 = 2\,(H_2 - A_2) + \Delta G_2 .
\end{equation*}
Hay tres datos que entran en esa cuenta, y no todos tienen el mismo
respaldo:
\begin{itemize}
  \item $H_2 = -8\,\text{dBc}$: el nivel del segundo armónico a la salida
    del VCO. \textbf{Medido} (Tabla~\ref{tab:armonicos_medidos}).
  \item $\Delta G_2$: cuánto mejor o peor que a $f$ pasa la señal a $2f$ por
    el camino de recepción (cables, bocinas, blanco, LNA). \textbf{No está
    medido.} Lo más pesimista es $\Delta G_2 = 0$, o sea que el camino trate
    a $2f$ igual que a $f$. Una simulación del radar completo da
    $\Delta G_2 \approx -7\,\text{dB}$, pendiente de verificar.
  \item $R_\text{obj}$: hasta dónde se quiere bajar el fantasma. \textbf{Es
    una elección}, no un dato. Se usan dos referencias: el piso de ruido de
    las capturas actuales, $\sim\!-45\,\text{dB}$ respecto del pico (más
    abajo el fantasma ya no se distingue del ruido), y $-60\,\text{dB}$,
    un margen pensado para cuando el eco más fuerte sea la superficie del
    suelo y haya que ver ecos enterrados mucho más débiles.
\end{itemize}

Sin filtro ($A_2 = 0$), el fantasma queda en $R_2 = 2(-8) + \Delta G_2 =
-16\,\text{dB} + \Delta G_2$. Lo que falta para llegar a $R_\text{obj}$ lo
tiene que poner el filtro, y como su atenuación cuenta dos veces, alcanza con
la mitad. Pidiendo $R_2 \leq R_\text{obj}$ y despejando:
\begin{equation}
  A_2 \;\geq\; \frac{(2H_2 + \Delta G_2) - R_\text{obj}}{2}
  \;=\; H_2 + \frac{\Delta G_2 - R_\text{obj}}{2}.
  \label{eq:atenuacion_filtro}
\end{equation}
Por ejemplo, con $\Delta G_2 = -7\,\text{dB}$ y $R_\text{obj} =
-60\,\text{dB}$: sin filtro el fantasma está en $-23\,\text{dB}$, faltan
$37\,\text{dB}$, y el filtro tiene que poner la mitad, $18{,}5\,\text{dB}$.
La Tabla~\ref{tab:atenuacion_filtro} da los cuatro casos.

\begin{table}[H]
  \centering
  \caption{Atenuación mínima del filtro en $2f$, según la
  ecuación~\eqref{eq:atenuacion_filtro}, con $H_2 = -8\,\text{dBc}$.}
  \label{tab:atenuacion_filtro}
  \begin{tabular}{lcc}
    \toprule
    & $R_\text{obj} = -45\,\text{dB}$ & $R_\text{obj} = -60\,\text{dB}$ \\
    & (piso de las capturas) & (margen para GPR) \\
    \midrule
    $\Delta G_2 = 0$ (pesimista) & $14{,}5\,\text{dB}$ & $22\,\text{dB}$ \\
    $\Delta G_2 = -7\,\text{dB}$ (simulación) & $11\,\text{dB}$ &
      $18{,}5\,\text{dB}$ \\
    \bottomrule
  \end{tabular}
\end{table}

Cada dB de error en $\Delta G_2$ mueve el requisito sólo medio dB, porque el
filtro cuenta dos veces. Diseñando para el caso pesimista, $\sim\!20$ a
$22\,\text{dB}$ en $2f$ cubren los dos objetivos. El tercer armónico arranca
en $2{,}96\,\text{GHz}$, una vez y media el corte: atenuarlo es fácil, pero
su nivel no está medido y hay que medirlo para cerrar este número.

\paragraph{La banda de transición.} El filtro tiene que dejar pasar hasta
$f_\text{max}$ y rechazar desde $2f_\text{min}$. Con la banda medida,
$2f_\text{min} = 1976\,\text{MHz}$ está \emph{por debajo} de $f_\text{max} =
1991\,\text{MHz}$: no hay banda de transición, sino $15\,\text{MHz}$ de
superposición. Ningún filtro separa del todo la fundamental de su segundo
armónico con este barrido.

Correr la banda (subir $f_\text{min}$ hasta que $2f_\text{min}$ quede por
encima de $f_\text{max}$) no es una opción práctica: el VCO, el splitter,
las bocinas y el resto de la cadena de RF están elegidos para la banda de
$1$ a $2\,\text{GHz}$, y achicarla cuesta resolución en distancia ($c/2B$).
Lo más sencillo es \textbf{aceptar un tramo contaminado de la rampa}, y se
puede, porque ese tramo cae donde la ventana de Hann casi no pesa.

\subparagraph{Paso 1: qué tramo de la rampa queda contaminado.} Ningún
filtro real pasa de ``deja pasar todo'' a ``atenúa $A_2$'' de golpe: necesita
un margen de frecuencia para caer. Se llama $f_s$ a la frecuencia en la que el
filtro ya alcanzó la atenuación $A_2$ que pide la
Tabla~\ref{tab:atenuacion_filtro}. El segundo armónico está en $2f(t)$, así
que el filtro lo atenúa lo suficiente sólo cuando $2f(t) \geq f_s$. Mientras
$f(t) < f_s/2$, el armónico pasa sin atenuar del todo. Eso ocurre únicamente
al principio de la rampa, cuando el VCO está en la parte baja del barrido, y
dura una fracción de la rampa
\begin{equation}
  x_s = \frac{f_s/2 - f_\text{min}}{B}.
\end{equation}
Por ejemplo, si el filtro llega a su atenuación en $f_s = 2{,}2\,\text{GHz}$,
el armónico pasa mientras $f(t) < 1{,}1\,\text{GHz}$, y la fracción es
$(1100 - 988)/1003 \approx 11$\,\% de la rampa.

\subparagraph{Paso 2: cuánto pesa ese tramo.} Antes de la FFT, cada rampa
se multiplica por la ventana de Hann (Sección~\ref{sec:proc_fft}), que vale
cero en los bordes y uno en el centro. El tramo contaminado está justo en un
borde, donde la ventana casi anula la señal. Además, la ventana se aplica
sobre $\theta$, que es lineal en la frecuencia, así que la fracción $x_s$ en
frecuencia es exactamente la fracción de la ventana. La parte de la amplitud
del fantasma que aporta ese tramo es el área de la ventana sobre él,
dividida por el área total:
\begin{equation}
  \rho(x_s) = \frac{\int_0^{x_s} \sin^2(\pi u)\,du}{\int_0^{1}
  \sin^2(\pi u)\,du} = x_s - \frac{\sin(2\pi x_s)}{2\pi}.
\end{equation}
Con $f_s = 2{,}2\,\text{GHz}$ da $\rho \approx 0{,}009$, o sea
$-41\,\text{dB}$: el $11$\,\% de la rampa aporta menos del $1$\,\% del
fantasma, porque en ese tramo la ventana vale entre $0$ y $0{,}1$. La cuenta
es pesimista, porque supone que ese tramo no tiene \emph{ninguna}
atenuación, cuando en realidad el filtro ya lo está atenuando en parte.

\subparagraph{Paso 3: dónde queda el fantasma.} Lo que se cuela por el
borde está $\rho$ por debajo del fantasma sin filtro, que es $2H_2 + \Delta
G_2$: $-23\,\text{dB}$ con la simulación y $-16\,\text{dB}$ en el caso
pesimista. Con $f_s = 2{,}2\,\text{GHz}$ queda en
$-23 - 41 = -64\,\text{dB}$, o $-16 - 41 = -57\,\text{dB}$. La
Tabla~\ref{tab:filtro_transicion} repite la cuenta para varios $f_s$.

\begin{table}[H]
  \centering
  \caption{Lo que se cuela por el borde de la rampa, según la frecuencia
  $f_s$ en la que el filtro alcanza su atenuación. Banda medida, $988$ a
  $1991\,\text{MHz}$. La cuarta y la quinta columna son el nivel de esa parte
  del fantasma respecto del pico del blanco.}
  \label{tab:filtro_transicion}
  \begin{tabular}{ccccc}
    \toprule
    $f_s$ & tramo sin & peso con Hann & fantasma & fantasma \\
    & atenuar & $20\log_{10}\rho$ & ($\Delta G_2 = -7\,\text{dB}$)
      & ($\Delta G_2 = 0$) \\
    \midrule
    $2{,}0\,\text{GHz}$ (ideal) & $1$\,\% & $-111\,\text{dB}$ & ---
      & --- \\
    $2{,}1\,\text{GHz}$ & $6$\,\%  & $-56\,\text{dB}$ & $-79\,\text{dB}$
      & $-72\,\text{dB}$ \\
    $2{,}2\,\text{GHz}$ & $11$\,\% & $-41\,\text{dB}$ & $-64\,\text{dB}$
      & $-57\,\text{dB}$ \\
    $2{,}3\,\text{GHz}$ & $16$\,\% & $-32\,\text{dB}$ & $-55\,\text{dB}$
      & $-48\,\text{dB}$ \\
    $2{,}5\,\text{GHz}$ & $26$\,\% & $-20\,\text{dB}$ & $-43\,\text{dB}$
      & $-36\,\text{dB}$ \\
    \bottomrule
  \end{tabular}
\end{table}

Cuanto más lento cae el filtro, más rampa queda contaminada y más fantasma se
cuela. Para el objetivo de $-60\,\text{dB}$, el filtro tiene que alcanzar su
atenuación en $\sim\!2{,}2\,\text{GHz}$ con el $\Delta G_2$ de la
simulación, o en $\sim\!2{,}15\,\text{GHz}$ en el caso pesimista.

\subparagraph{Resumen: lo que se le pide al filtro.} El fantasma que queda
tiene dos partes: la del cuerpo de la rampa, que el filtro atenúa $A_2$
(Tabla~\ref{tab:atenuacion_filtro}), y la del borde, que se cuela pero pesa
poco (Tabla~\ref{tab:filtro_transicion}). Se pide que cada una quede, por
separado, debajo del objetivo. Redondeando hacia el lado seguro:
\begin{center}
  \fbox{\begin{minipage}{0.85\linewidth}
  \centering
  pasabajos de RF que deje pasar hasta $2\,\text{GHz}$\\
  y atenúe al menos $22\,\text{dB}$ a partir de $2{,}15\,\text{GHz}$.
  \end{minipage}}
\end{center}
Es una transición de un $8$\,\% ($2{,}15/1{,}99 \approx 1{,}08$): pide un
filtro empinado, pero realizable, y \textbf{gracias a la ventana de Hann no
hace falta resignar ancho de banda}. El diseño se trata aparte.

Para el diseño quedan además estos requisitos:
\begin{itemize}
  \item \textbf{Banda de paso plana.} Un rizado de amplitud en la banda de
    paso es una modulación de amplitud de la rampa y sube los lóbulos
    laterales del pico. La simulación muestra que los $\pm 2\,\text{dB}$ de
    rizado de la propia fundamental ya los llevan de $-31$ a $-23\,\text{dB}$.
  \item \textbf{Pérdida de inserción baja}, porque el filtro está antes del
    splitter y su pérdida se resta a la potencia transmitida y al nivel de LO
    que necesita el mezclador.
  \item \textbf{Adaptación} a $50\,\Omega$ en la banda de paso, para no
    agregar reflexiones entre el VCO y el splitter.
\end{itemize}

\paragraph{Una advertencia: no todo $2f_b$ viene de la RF.} Una alinealidad
en banda base (el amplificador del pasabajos post-mezclador, que en el
Capítulo~\ref{ch:filtro} ya mostró distorsión a amplitudes altas, o el
propio PCM1808) también genera armónicos del batido en $2f_b$, $3f_b$, y el
filtro de RF no los saca. Se distinguen atenuando el camino de recepción:
el fantasma que viene de la RF mantiene su nivel \emph{relativo} (la
ecuación~\eqref{eq:nivel_fantasma} no depende de la amplitud del eco),
mientras que el de una alinealidad de segundo orden baja $1\,\text{dB}$ por
cada dB de atenuación. Para lo mismo sirve conectar la salida de TX con la
entrada de RX por un cable y un atenuador, sin antenas. Así hay un único
retardo, y todo pico en $2f_b$ o $3f_b$ es un fantasma puro.

\paragraph{Lo que falta medir} para cerrar los números de esta sección:
el segundo y el tercer armónico hasta $\sim\!6\,\text{GHz}$, a la salida del
VCO, del amplificador de RF y en la entrada LO del mezclador, con un
atenuador externo para bajar el piso de $-32\,\text{dBc}$. Eso reemplaza el
$\Delta G_2$ estimado y el tercer armónico supuesto por valores medidos.

%============================================================
\chapter{Generador de Triangular Analógico}
\label{ch:triangular}
%============================================================

La rampa de tensión que sintoniza el VCO (Capítulo~\ref{ch:vco}) la venía
entregando un generador de funciones de laboratorio. Este capítulo describe
el circuito analógico que lo reemplaza: un oscilador de onda triangular
construido con dos operacionales cuádruples, con el período ajustable
mediante un potenciómetro de precisión, salida acotada al rango
$0$--$3\,\text{V}$ que admite el VCO y una onda cuadrada de sincronismo para
el ESP32-C3. Se documentan el diseño, la elección de los componentes, la
verificación por simulación y la placa impresa. Al cierre de este capítulo
la placa está diseñada y verificada, pero todavía no armada: las mediciones
sobre el circuito físico quedan pendientes
(Sección~\ref{sec:tri_pendiente}).

\section{Motivación y requisitos}
\label{sec:tri_requisitos}

El generador de funciones empleado hasta ahora (Siglent SDG830) impone dos
limitaciones sobre el banco, y la segunda pesa tanto como la primera.

La primera es que \textbf{no entrega una señal de sincronismo}: su salida
de sincronismo no funciona en este banco. Sin una referencia que marque
dónde empieza cada rampa no se sabe qué tramo de la señal digitalizada
corresponde a cada barrido, y eso hace falta para cortar las rampas y para
la corrección de no linealidad del VCO. Mientras tanto, el problema se
resolvió por software: el ESP32-C3 lee la propia triangular por GPIO3 y la
PC ajusta su período y su fase (Sección~\ref{sec:proc_sincronismo}). Ese
camino funciona, pero depende de un ajuste estadístico sobre $\sim 19$
lecturas por período y del ADC del microcontrolador, que tiene un offset
alternante sin resolver. Una onda cuadrada de sincronismo da la misma
información de forma directa, flanco por flanco.

La segunda es que \textbf{ata el banco a la red eléctrica}. Un GPR que no
puede salir del laboratorio no sirve para medir sobre un terreno. El
objetivo es que todo el instrumento se alimente de un \textit{powerbank}, a
través de una fuente elevadora seguida de un regulador lineal que deja
disponibles los $12\,\text{V}$ de este generador y los $20\,\text{V}$ del
amplificador que ataca al VCO.

Sobre esa base, los requisitos del generador son:

\begin{itemize}
  \item \textbf{Salida triangular de $0$ a $3\,\text{V}$}, con una
    tolerancia de $\pm 50\,\text{mV}$ en los extremos, que es el rango de
    tensión de control útil del VCO establecido en la
    Sección~\ref{sec:curva_vco}.
  \item \textbf{Período de repetición ($T_\text{prf}$) ajustable entre
    $20$ y $200\,\text{ms}$}, con un potenciómetro de precisión montado en
    el panel.
  \item \textbf{Siempre triangular}: la forma de onda no debe cambiar al
    mover la frecuencia, a diferencia de un generador de funciones donde
    es fácil dejar seleccionada otra.
  \item \textbf{Onda cuadrada de sincronismo} en fase con la triangular,
    compatible con una entrada digital del ESP32-C3.
\end{itemize}

Cuando estos requisitos entran en conflicto, el orden de prioridades es:
\textbf{linealidad de la rampa} (es lo que determina que el eco de un blanco
puntual caiga en una única frecuencia de batido), luego \textbf{ruido},
luego \textbf{vértices bien definidos}, luego \textbf{estabilidad de la
amplitud} y por último \textbf{rango de frecuencia}.

\section{Topología}
\label{sec:tri_topologia}

El circuito parte de la topología clásica de oscilador de triangular
---comparador de Schmitt realimentando un integrador--- adaptada a
alimentación simple de $12\,\text{V}$, y le agrega dos etapas de
acondicionamiento. La Figura~\ref{fig:tri_bloques} resume la estructura y la
Figura~\ref{fig:tri_esquematico} es el esquemático completo.

\begin{figure}[H]
  \centering
  \begin{tikzpicture}[
      font=\small,
      box/.style={draw, rounded corners, minimum height=1.0cm,
        minimum width=2.2cm, align=center, inner sep=3pt},
      arr/.style={-{Latex[length=2.2mm]}, thick},
      etq/.style={font=\scriptsize, align=center, inner sep=2pt}
    ]
    \node[box, minimum width=1.7cm] (pot) at (-3.5,0)
      {$R_1$\\[-3pt]\scriptsize 8k2 + pote 100k};
    \node[box] (osc) at (0,0)
      {Oscilador\\[-3pt]\scriptsize U1B Schmitt\\[-4pt]\scriptsize + U1A integrador};
    \node[box] (res) at (4.0,0) {Restador\\[-3pt]\scriptsize U2B};
    \node[box, minimum width=1.5cm] (zen) at (7.4,0) {$D_1$\\[-3pt]\scriptsize 1N4729A};

    \node[box] (ref) at (0,2.2) {Referencia 6\,V\\[-3pt]\scriptsize U2A};
    \node[box] (syn) at (0,-2.4) {Buffer de sync\\[-3pt]\scriptsize U1C, 300k/100k};

    \draw[arr] (pot) -- node[etq, above]{fija $T$} (osc);
    \draw[arr] (osc) -- node[etq, above]{\texttt{tri}} (res);
    \draw[arr] (res) -- node[etq, above]{0 a $3{,}09\,$V} (zen);
    \draw[arr] (zen.east) -- ++(1.2,0) node[etq, above, midway]{J3}
      node[etq, right, align=left]{al amplificador\\y al VCO};

    \draw[arr] (ref) -- node[etq, right]{\texttt{mid}} (osc);
    \draw[arr] (ref.east) -| node[etq, above, pos=0.2]{\texttt{mid}} (res.north);
    \draw[arr] (osc) -- node[etq, right]{\texttt{sq}, 0 a 12\,V} (syn);
    \draw[arr] (syn.east) -- ++(1.2,0) node[etq, above, midway]{J3}
      node[etq, right, align=left]{0 a $2{,}99\,$V\\al ESP32-C3};
  \end{tikzpicture}
  \caption{Estructura del generador. El oscilador entrega una triangular de
  $3{,}06\,\text{V}_{pp}$ centrada en la referencia de $6\,\text{V}$; el
  restador la baja al rango $0$--$3\,\text{V}$ que pide el VCO; el zener
  $D_1$ protege al VCO ante una falla y el buffer de sync reduce la cuadrada
  del comparador a un nivel que tolera el ESP32-C3. Todo el circuito se
  alimenta de una única rama de $12\,\text{V}$.}
  \label{fig:tri_bloques}
\end{figure}

\begin{figure}[H]
  \centering
  
  \caption{Esquemático completo (\texttt{GPRv2/docs/PWM/pcb/\allowbreak
  triangular.kicad\_sch}). Las cinco unidades usadas se reparten entre dos
  TLC2274: U1 lleva el oscilador y el sync, U2 la referencia y el restador.
  Las tres unidades sobrantes (U1D, U2C y U2D) quedan como seguidores con la
  entrada no inversora a masa.}
  \label{fig:tri_esquematico}
\end{figure}

\subsection{El oscilador}
\label{sub:tri_oscilador}

U1B funciona como comparador con histéresis: su entrada no inversora recibe
la triangular a través de $R_3$ y su propia salida a través de $R_2$, y
conmuta cuando esa suma cruza la referencia \texttt{mid}. U1A integra la
salida cuadrada de U1B sobre $C_1$ con la corriente que fija $R_1$.

Igualando a cero la corriente en la entrada no inversora de U1B se obtienen
los dos umbrales de conmutación, y de ahí la amplitud de la triangular:

\begin{equation}
  V_{pp} = \frac{R_3}{R_2}\, V_{cc}
  = \frac{12\,\text{k}\Omega}{47\,\text{k}\Omega}\cdot 12\,\text{V}
  = 3{,}064\,\text{V}.
  \label{eq:tri_vpp}
\end{equation}

La corriente que carga a $C_1$ es $(V_{cc}/2)/R_1$, constante, de modo que
la rampa es lineal por construcción. Combinando la pendiente resultante con
la amplitud de la ecuación~\eqref{eq:tri_vpp}, el período queda:

\begin{equation}
  T = 4\,\frac{R_3}{R_2}\, R_1 C_1.
  \label{eq:tri_periodo}
\end{equation}

Dos observaciones sobre la ecuación~\eqref{eq:tri_periodo}. La primera es
que \textbf{$T$ no depende de la tensión de alimentación}: $V_{cc}$ fija la
amplitud y la corriente de carga en la misma proporción, y se cancela. La
segunda es que $T$ es \textbf{proporcional a $R_1$}, así que el período es
lineal con la posición del potenciómetro, que es la propiedad que hace
cómodo el ajuste de panel.

Con $R_1 = 8{,}2\,\text{k}\Omega + $ potenciómetro de $100\,\text{k}\Omega$
y $C_1 = 2{,}2\,\mu\text{F}$, la Tabla~\ref{tab:tri_periodo} compara la
ecuación~\eqref{eq:tri_periodo} con la simulación del circuito completo. El
acuerdo es mejor que el $1$\,\% en todo el recorrido, y el rango
$18{,}6$--$243{,}5\,\text{ms}$ cubre con holgura los $20$ a
$200\,\text{ms}$ pedidos.

\begin{table}[H]
  \centering
  \caption{Período en función de la posición del potenciómetro: la
  ecuación~\eqref{eq:tri_periodo} contra la simulación del circuito
  completo con el modelo real del operacional.}
  \label{tab:tri_periodo}
  \begin{tabular}{ccccc}
    \toprule
    Posición & $R_1$ & $T$ calculado & $T$ simulado & Desvío \\
    \midrule
    $0$    & $8{,}2\,\text{k}\Omega$   & $18{,}42\,\text{ms}$  & $18{,}58\,\text{ms}$  & $-0{,}85$\,\% \\
    $0{,}5$& $58{,}2\,\text{k}\Omega$  & $130{,}76\,\text{ms}$ & $131{,}08\,\text{ms}$ & $-0{,}24$\,\% \\
    $1$    & $108{,}2\,\text{k}\Omega$ & $243{,}10\,\text{ms}$ & $243{,}46\,\text{ms}$ & $-0{,}15$\,\% \\
    \bottomrule
  \end{tabular}
\end{table}

$C_1$ es de \textbf{película metálica, no electrolítico}. Con la
alimentación simple, la tensión sobre $C_1$ se invierte en cada
semiperíodo ($\pm 1{,}5\,\text{V}$), lo que ya descarta un electrolítico
polarizado; y con el potenciómetro al máximo la corriente de carga es de
apenas $(V_{cc}/2)/R_1 = 55{,}5\,\mu\text{A}$, comparable a la corriente de
fuga de un electrolítico, que se sumaría a la de carga y curvaría la rampa.

\subsection{El restador}
\label{sub:tri_restador}

La triangular del oscilador queda centrada en $6\,\text{V}$, y el VCO pide
$0$ a $3\,\text{V}$. U2B resuelve las dos cosas a la vez: resta la
referencia y suma un offset fijo, de modo que

\begin{equation}
  V_\text{sal} = V_\text{tri} - 6\,\text{V} + 1{,}56\,\text{V}.
  \label{eq:tri_restador}
\end{equation}

El detalle importante es de dónde sale ese offset de $1{,}56\,\text{V}$: no
de una referencia de tensión aparte, sino de los mismos $12\,\text{V}$ de
alimentación, a través de $R_{10}'$. Como la amplitud de la triangular
(ecuación~\eqref{eq:tri_vpp}) y la referencia de $6\,\text{V}$ también son
proporcionales a $V_{cc}$, \textbf{toda la salida escala con la
alimentación}: una fuente que esté un $5$\,\% baja corre los extremos un
$5$\,\%, pero no descentra la señal ni la saca de forma. Para una fuente
elevadora alimentada por batería, cuya tensión de salida no es de
precisión, esa propiedad vale más que un offset absolutamente estable.

Imponer ganancia unitaria sobre $V_\text{tri}$ y el offset buscado fija dos
combinaciones de resistencias que no existen en la serie E12 y se arman en
serie: $R_9' = R_9 + R_{13} = 115\,\text{k}\Omega$ y $R_{10}' = R_{10} +
R_{14} + R_{15} = 768{,}8\,\text{k}\Omega$. Las dos quedan a menos del
$0{,}05$\,\% del valor ideal. El criterio completo, junto con el análisis de
tolerancias que justifica usar resistencias al $1$\,\%, está en el
Apéndice~\ref{ap:valores}.

\subsection{El sincronismo}
\label{sub:tri_sync}

La salida del comparador U1B conmuta entre los rieles, es decir entre $0$ y
casi $12\,\text{V}$, que el ESP32-C3 no tolera en ningún pin. U1C la toma a
través de un divisor $R_{11}'/R_{12} = 300\,\text{k}\Omega/100\,\text{k}\Omega$,
que la reduce a un cuarto, y la repite con impedancia baja. La carga total
sobre el comparador es de $400\,\text{k}\Omega$, suficientemente alta como
para no alterar los umbrales de la ecuación~\eqref{eq:tri_vpp}.

El nivel alto resultante es de $2{,}99\,\text{V}$ en la simulación, cómodo
frente al umbral de entrada en alto del GPIO, que la hoja de datos del
ESP32-C3 ubica en $0{,}75\,V_{DD} = 2{,}48\,\text{V}$.

\section{Elección del operacional}
\label{sec:tri_opamp}

El circuito necesita cinco unidades con salida \textit{rail-to-rail} ---la
triangular tiene que llegar a $3\,\text{V}$ desde una alimentación simple, y
la cuadrada de sync debe bajar a $0\,\text{V}$---, alimentación simple de
$12\,\text{V}$ y encapsulado DIP, para poder montarlo sobre zócalos en una
placa de una sola capa. La Tabla~\ref{tab:tri_opamp} resume los candidatos
evaluados.

\begin{table}[H]
  \centering
  \caption{Candidatos considerados para los cinco operacionales.}
  \label{tab:tri_opamp}
  \begin{tabular}{llll}
    \toprule
    Operacional & Encapsulado & \textit{Rail-to-rail} & Resolución \\
    \midrule
    TL072    & DIP-8            & no  & Descartado: no llega a los rieles \\
    LMC6482  & DIP-8            & sí  & Descartado: el modelo no converge \\
    OPA2171  & solo SOIC        & sí  & Descartado: no se consigue en DIP \\
    TLC2262  & DIP-8            & sí  & Descartado: más ruidoso (ver abajo) \\
    \textbf{TLC2274} & \textbf{DIP-14} & \textbf{sí} & \textbf{Elegido} \\
    \bottomrule
  \end{tabular}
\end{table}

El TLC2274 es la versión cuádruple del TLC2272: mismo operacional, mismo
modelo SPICE. Dos integrados cubren las cinco unidades necesarias, y las
tres que sobran se dejan como seguidores con la entrada no inversora a masa;
como el rango de entrada en modo común del TLC227x incluye masa, esas
salidas quedan en $0\,\text{V}$ y no hace falta llevarles la referencia de
$6\,\text{V}$, lo que evita cruzar la placa con una pista más.

El reparto de unidades entre los dos integrados no es arbitrario: U1 lleva
el oscilador y el sync, U2 la referencia y el restador. Agrupar por función
mantiene cortas las conexiones de cada lazo y es lo que hace posible rutear
todo el circuito en una sola capa (Sección~\ref{sec:tri_pcb}).

\subsection{Ruido: por qué no el TLC2262}
\label{sub:tri_ruido}

El TLC2262 cumple todos los requisitos formales, así que la comparación se
resolvió por ruido. En lugar de citar las hojas de datos se midió la
densidad de ruido de entrada de cada modelo SPICE, con un análisis
\texttt{.noise} sobre un seguidor de ganancia unitaria alimentado con los
mismos $12\,\text{V}$ del circuito (script
\texttt{GPRv2/docs/PWM/simulacion/ruido\_opamp.py}). Los resultados están en la
Tabla~\ref{tab:tri_ruido}.

\begin{table}[H]
  \centering
  \caption{Densidad de ruido de tensión de entrada de los modelos SPICE, en
  $\text{nV}/\sqrt{\text{Hz}}$, comparada con el ruido térmico de las
  resistencias del lazo.}
  \label{tab:tri_ruido}
  \begin{tabular}{lccccc}
    \toprule
    & $10\,\text{Hz}$ & $50\,\text{Hz}$ & $100\,\text{Hz}$
    & $1\,\text{kHz}$ & $10\,\text{kHz}$ \\
    \midrule
    TLC2272 / TLC2274 & $51{,}0$ & $24{,}0$ & $17{,}9$ & $9{,}7$  & $8{,}4$  \\
    TLC2262           & $41{,}8$ & $22{,}9$ & $19{,}2$ & $15{,}2$ & $14{,}7$ \\
    \midrule
    $\sqrt{4kTR}$, $R = 100\,\text{k}\Omega$
      & \multicolumn{5}{c}{$40{,}7$ (independiente de la frecuencia)} \\
    \bottomrule
  \end{tabular}
\end{table}

A $1\,\text{kHz}$ la diferencia es clara y favorece al TLC2274, que es
$1{,}6$ veces menos ruidoso, y esa es la razón por la que se lo eligió sobre
el TLC2262. Conviene, sin embargo, ser explícito sobre el alcance real de
esa ventaja: \textbf{en la banda en la que trabaja este circuito}
($4$ a $54\,\text{Hz}$ de fundamental, y sus primeros armónicos) los dos
modelos quedan a menos del $10$\,\% uno del otro, y ambos son del mismo
orden que el ruido térmico de las resistencias de $100\,\text{k}\Omega$ del
lazo, que es lo que en la práctica domina. La elección del TLC2274 está
bien hecha, pero lo que la vuelve decisiva es el encapsulado cuádruple en
DIP, no el margen de ruido.

\section{Resultados de simulación}
\label{sec:tri_simulacion}

El circuito se simuló en LTspice en tres etapas sucesivas, una por archivo:
primero la topología desnuda (\texttt{triangular.asc}), después con la
salida acondicionada y el sync usando un operacional ideal
(\texttt{triangular2.asc}), y finalmente con el modelo real del TLC2272
(\texttt{triangular3.asc}). Ese modelo del fabricante sólo converge en este
lazo con integración \textit{gear} y arranque en rampa de las fuentes
(\texttt{.options method=gear} y la opción \texttt{startup} del
\texttt{.tran}).

Además, el script
\texttt{pcb/simular\_kicad.py} exporta
el \textit{netlist} del esquemático de KiCad con \texttt{kicad-cli} y lo
simula en LTspice, de modo que lo que se verifica es el circuito que
efectivamente está dibujado en la placa y no una copia aparte que podría
haber quedado desactualizada. Los números de esta sección salen de esa
corrida.

\begin{figure}[H]
  \centering
  
  \caption{Salida y sincronismo del generador con el modelo real del
  TLC2272, en tres posiciones del potenciómetro (script
  \texttt{GPRv2/docs/PWM/simulacion/graficar\_triangular3.py}). Izquierda: la
  triangular de salida junto con la cuadrada de sync, con los niveles
  extremos indicados. Derecha: el espectro de dos lados de la salida
  ---cada raya es un armónico, y la del centro es la componente continua---
  comparado con la envolvente $1/f^2$ que corresponde a los armónicos
  impares de una triangular ideal.}
  \label{fig:tri_ondas}
\end{figure}

La Tabla~\ref{tab:tri_niveles} reúne los valores medidos sobre la
simulación. La salida cubre el rango pedido en las tres posiciones y los
extremos se mantienen dentro de la tolerancia de $\pm 50\,\text{mV}$
respecto de $0$ y $3\,\text{V}$.

\begin{table}[H]
  \centering
  \caption{Períodos, niveles y contenido armónico simulados, en las tres
  posiciones del potenciómetro.}
  \label{tab:tri_niveles}
  \begin{tabular}{lccc}
    \toprule
    Posición del potenciómetro & $0$ & $0{,}5$ & $1$ \\
    \midrule
    Período                  & $18{,}58\,\text{ms}$ & $131{,}08\,\text{ms}$ & $243{,}46\,\text{ms}$ \\
    Frecuencia               & $53{,}82\,\text{Hz}$ & $7{,}63\,\text{Hz}$   & $4{,}11\,\text{Hz}$ \\
    Salida, mínimo           & $0{,}062\,\text{V}$  & $0{,}041\,\text{V}$   & $0{,}040\,\text{V}$ \\
    Salida, máximo           & $3{,}078\,\text{V}$  & $3{,}089\,\text{V}$   & $3{,}090\,\text{V}$ \\
    Sync, nivel bajo         & $0{,}036\,\text{V}$  & $0{,}010\,\text{V}$   & $0{,}009\,\text{V}$ \\
    Sync, nivel alto         & $2{,}952\,\text{V}$  & $2{,}987\,\text{V}$   & $2{,}989\,\text{V}$ \\
    \midrule
    2\textsuperscript{o} armónico & $-48{,}3\,\text{dB}$ & $-56{,}8\,\text{dB}$ & $-58{,}0\,\text{dB}$ \\
    3\textsuperscript{er} armónico & $-19{,}1\,\text{dB}$ & $-19{,}1\,\text{dB}$ & $-19{,}1\,\text{dB}$ \\
    5\textsuperscript{o} armónico & $-28{,}0\,\text{dB}$ & $-28{,}0\,\text{dB}$ & $-28{,}0\,\text{dB}$ \\
    \bottomrule
  \end{tabular}
\end{table}

Los armónicos impares valen exactamente lo que predice una triangular
ideal ($1/9 = -19{,}08\,\text{dB}$ y $1/25 = -27{,}96\,\text{dB}$), lo cual
confirma que la rampa es lineal: cualquier curvatura apreciable se
manifestaría como una desviación en esos valores.

Los armónicos \emph{pares}, en cambio, son el indicador interesante, porque
en una triangular perfectamente simétrica valen cero. Con el operacional
ideal el segundo armónico queda en $-93{,}7\,\text{dB}$, es decir en el piso
numérico; con el modelo real del TLC2272 sube a $-48{,}3\,\text{dB}$ en la
posición más rápida. Esa asimetría es el efecto del \textit{slew rate} y del
retardo finitos del operacional en los vértices, y se atenúa al bajar la
frecuencia: $-58{,}0\,\text{dB}$ en la posición más lenta, donde los
vértices ocupan una fracción mucho menor del período. Como el radar opera en
la zona lenta del rango, el efecto es despreciable.

\section{Protección del VCO}
\label{sec:tri_zener}

El VCO admite hasta $18\,\text{V}$ en su entrada de sintonía, y el
amplificador intermedio, caracterizado en la Sección~\ref{sec:curva_vco}
como $V_\text{osc} = 4{,}949\,V_\text{in} + 0{,}055$, se alimenta con
$20\,\text{V}$. La salida del generador no puede entonces superar

\begin{equation}
  V_\text{in,máx} = \frac{18 - 0{,}055}{4{,}949} = 3{,}63\,\text{V},
  \label{eq:tri_limite}
\end{equation}

contra los $3{,}09\,\text{V}$ de operación normal. El margen es de apenas
medio volt, y una sola resistencia abierta alcanza para perderlo: el
diodo zener $D_1$, conectado entre la salida y masa, es la protección.

La elección del zener es más delicada de lo que parece, porque el codo de
conducción de un zener de baja tensión es blando. La
Figura~\ref{fig:tri_zener_vertice} compara los dos candidatos.

\begin{figure}[H]
  \centering
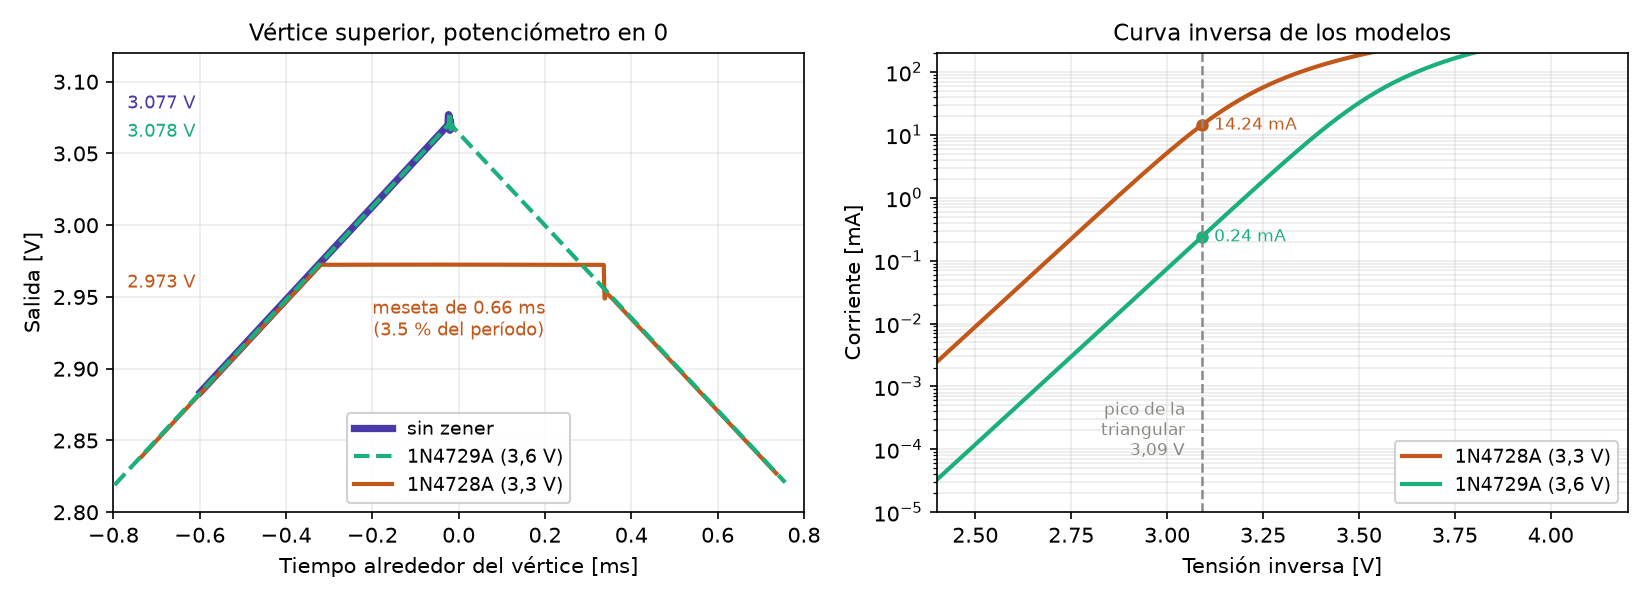
[picture p40: redaccion/figuras/triangular/zener_vertice.png]
  
  \caption{Efecto de cada zener sobre la operación normal (scripts
  \texttt{GPRv2/docs/PWM/simulacion/simular\_zener.py} y \texttt{graficar\_zener.py}).
  Izquierda: el vértice superior de la triangular sin zener, con el 1N4729A
  y con el 1N4728A. Derecha: la curva de conducción inversa de los dos
  modelos, con la corriente que toma cada uno al pico de la triangular.}
  \label{fig:tri_zener_vertice}
\end{figure}

El \textbf{1N4728A} ($3{,}3\,\text{V}$ nominales) no sirve. A los
$3{,}09\,\text{V}$ del pico ya conduce $14{,}2\,\text{mA}$, y en la
simulación recorta el vértice: lo achata a $2{,}973\,\text{V}$, es decir
$104{,}5\,\text{mV}$ por debajo del pico real, y deja una meseta de
$0{,}66\,\text{ms}$ que ocupa el $3{,}5$\,\% del período. Sobre la
prioridad número uno del circuito, que es la linealidad de la rampa, eso es
inaceptable.

El \textbf{1N4729A} ($3{,}6\,\text{V}$) toma $0{,}24\,\text{mA}$ al mismo
pico y no altera la señal: la diferencia entre la corrida con zener y la
corrida sin zener es de menos de $2\,\text{mV}$, dentro del ruido numérico
de la simulación.

La Figura~\ref{fig:tri_zener_falla} muestra que, pese a esa suavidad, el
1N4729A cumple su función. La falla simulada es la apertura de $R_9$, que
suelta el divisor de la entrada no inversora del restador.

\begin{figure}[H]
  \centering
  
  \caption{Falla simulada: $R_9$ abierta. Sin zener la salida se va a
  $10{,}06\,\text{V}$, con lo que el amplificador satura contra sus
  $20\,\text{V}$ de alimentación y el VCO queda $2\,\text{V}$ por encima de
  su máximo. Con el 1N4729A la salida se clava en $3{,}31\,\text{V}$, que
  corresponden a $16{,}4\,\text{V}$ en el VCO.}
  \label{fig:tri_zener_falla}
\end{figure}

Sin protección, la salida pasa a oscilar entre $4{,}73$ y
$10{,}06\,\text{V}$; el amplificador satura contra su alimentación y el VCO
recibe los $20\,\text{V}$ completos, por encima de los $18\,\text{V}$ que
tolera. Con el 1N4729A la salida se clava en $3{,}31\,\text{V}$
---equivalentes a $16{,}4\,\text{V}$ en el VCO--- porque el operacional no
puede entregar más de $3{,}71\,\text{mA}$ contra el zener en conducción.
Considerando la tolerancia del $\pm 5$\,\% de la tensión de zener, el nivel
de sujeción va de $15{,}6$ a $17{,}2\,\text{V}$ en el VCO: siempre por
debajo del límite.

\section{Implementación en placa impresa}
\label{sec:tri_pcb}

La placa se diseñó en KiCad 10, de \textbf{una sola capa de cobre}
(\texttt{B.Cu}) y $93 \times 63\,\text{mm}$, para poder fabricarla por
métodos caseros. Las Figuras~\ref{fig:tri_pcb} y~\ref{fig:tri_pcb3d}
muestran el resultado.

\begin{figure}[H]
  \centering
  \begin{subfigure}[b]{0.48\linewidth}
    \centering
    
    \caption{Cobre (\texttt{B.Cu}) y contorno.}
    \label{fig:tri_pcb_cobre}
  \end{subfigure}
  \hfill
  \begin{subfigure}[b]{0.48\linewidth}
    \centering
    
    \caption{Serigrafía y contorno.}
    \label{fig:tri_pcb_serig}
  \end{subfigure}
  \caption{Placa del generador, $93 \times 63\,\text{mm}$, una sola capa.
  Las dos vistas están en la misma orientación, mirando desde el lado de
  los componentes. En el cobre, el negro es cobre y el blanco es el
  aislamiento: casi toda la superficie libre es plano de masa.}
  \label{fig:tri_pcb}
\end{figure}

\begin{figure}[H]
  \centering
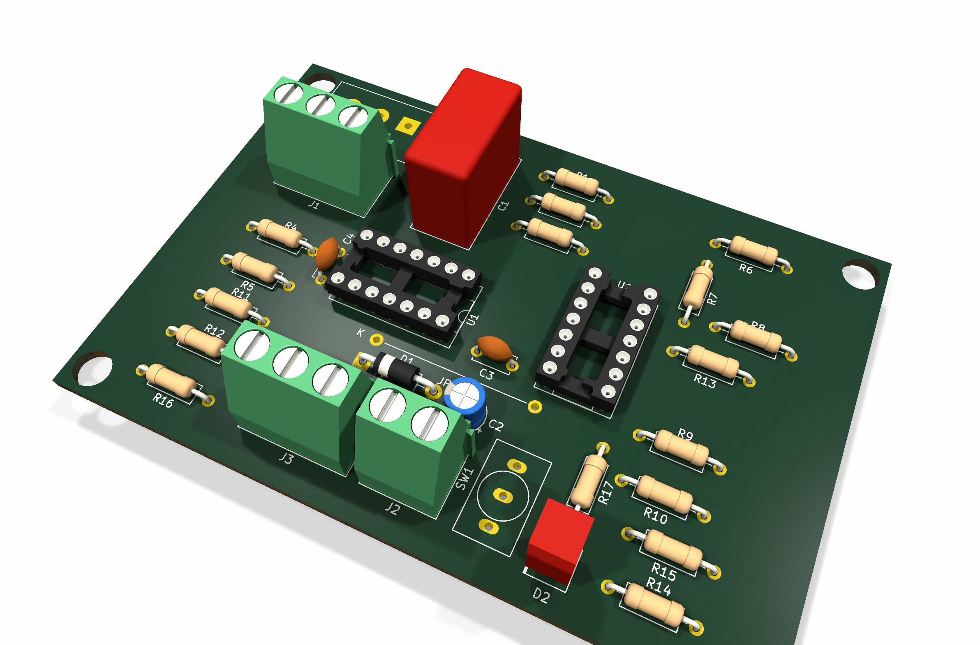
[picture p41: redaccion/figuras/triangular/pcb_3d.png]
  
  \caption{Vista tridimensional de la placa (\texttt{kicad-cli pcb
  render}). Faltan los modelos 3D de la llave de encendido SW1 y del puente
  de cable JP1, cuyas huellas se dibujaron para este proyecto; el resto de
  los componentes se muestra completo.}
  \label{fig:tri_pcb3d}
\end{figure}

Las pistas son de $0{,}508\,\text{mm}$ ($20\,\text{mil}$) salvo dieciséis
tramos de $0{,}3\,\text{mm}$ que pasan entre patas de los zócalos; suman
$1279\,\text{mm}$ de cobre, sin ninguna vía. La superficie restante es un
plano de masa con $1\,\text{mm}$ de separación a los pads, alivios térmicos
y ancho mínimo de relleno de $0{,}5\,\text{mm}$. JP1 es un puente de cable
de $22{,}5\,\text{mm}$ que resuelve el único cruce que no se pudo evitar, y
va en la salida, antes del zener. Las conexiones al exterior salen por tres
borneras: J1 al potenciómetro de panel, J2 a los $12\,\text{V}$ y J3 a la
salida, el sync y masa.

El encendido corta los $12\,\text{V}$ con una llave de palanca SPDT y un
LED rojo en serie con $2{,}2\,\text{k}\Omega$ ($\approx 4{,}7\,\text{mA}$)
como indicador. Se evaluó la alternativa de cortar la salida y el sync con
una llave de dos circuitos, y se descartó: cortando la alimentación,
cualquier patillaje de la llave deja el circuito en un estado seguro, lo
cual importa porque las llaves disponibles no tienen hoja de datos
confiable.

\subsection{Verificación}
\label{sub:tri_verificacion}

El diseño se verificó por cuatro caminos independientes:

\begin{itemize}
  \item \textbf{ERC y DRC de KiCad}: sin errores, sin conexiones faltantes
    y sin discrepancias de paridad contra el esquemático. La única
    advertencia que queda es que la huella del potenciómetro RV1 difiere de
    la copia en la biblioteca, porque se la editó a propósito para que el
    eje quede fuera del borde de la placa.
  \item \textbf{Comparación automática contra el netlist de LTspice}: se
    contrastó componente a componente el PCB contra
    \texttt{triangular3.asc}, y los 19 elementos encontraron su par exacto.
    El procedimiento se validó introduciendo errores a propósito y
    comprobando que los detectara.
  \item \textbf{Simulación del esquemático de KiCad}
    (\texttt{simular\_kicad.py}), que reproduce los mismos períodos y
    niveles de la Tabla~\ref{tab:tri_niveles}.
  \item \textbf{Revisión de las redes de los pads}, una por una, contra el
    circuito.
\end{itemize}

Quedan dos limitaciones conocidas, ambas aceptadas a conciencia. La
primera es que la separación mínima entre cobre de redes distintas es de
$0{,}304\,\text{mm}$, en dos lugares (junto al pad 6 de U1 y al pad 3 de
U2); supera la regla de diseño de $0{,}2\,\text{mm}$, pero es ajustada para
fabricación casera. La segunda es que los capacitores de desacople no
quedaron pegados a las patas de alimentación: C4 está a $11{,}6\,\text{mm}$
de la de U1 y C3 a $9{,}0\,\text{mm}$ de la de U2. No se pudo mejorar sin
agregar una segunda capa, y a las frecuencias de este circuito, con un
ancho de banda de ganancia unitaria de $2{,}2\,\text{MHz}$, no debería
tener consecuencias.

Vale registrar un error de diseño que el flujo de verificación sí atrapó: un
relleno de zona que había quedado sin recalcular después de mover una pista
dejó el plano de masa tocando una pista de $+12\,\text{V}$, es decir un
cortocircuito franco de la alimentación. El DRC no lo reportó hasta que se
volvió a rellenar la zona. La lección operativa es que \textbf{el DRC se
corre sobre el relleno actualizado, no sobre el dibujo}.

Por último, una advertencia sobre el alcance de todo lo anterior: el modelo
del TLC2272 usa la tensión de \textit{offset} \emph{típica}
($0{,}17\,\text{mV}$), no la máxima de hoja de datos
($2{,}5\,\text{mV}$). Los niveles simulados de la
Tabla~\ref{tab:tri_niveles} son, en ese sentido, optimistas, y es una de
las cosas que la medición sobre la placa armada tiene que confirmar.

\section{Mediciones pendientes}
\label{sec:tri_pendiente}

La placa está diseñada y verificada, pero no construida. Las mediciones
que restan, y que completarán este capítulo, son:

\begin{itemize}
  \item \textbf{Período en función de la posición del potenciómetro}, para
    confirmar tanto el rango $18{,}6$--$243{,}5\,\text{ms}$ como la
    linealidad que predice la ecuación~\eqref{eq:tri_periodo}.
  \item \textbf{Niveles extremos de la salida y del sync}, contra la
    Tabla~\ref{tab:tri_niveles}, con atención al corrimiento que puede
    introducir la tensión de \textit{offset} real de los operacionales.
  \item \textbf{Linealidad de la rampa}, midiendo la desviación respecto de
    la recta ideal, que es el parámetro de mayor prioridad del circuito.
  \item \textbf{Espectro de la salida}, para contrastar el contenido
    armónico medido con el simulado, en particular los armónicos pares.
  \item \textbf{Separación entre patas de la llave de encendido}, que se
    tomó de un modelo parecido y hay que confirmar con la pieza en mano
    antes de fabricar la placa.
\end{itemize}

%============================================================
\chapter{Filtro Pasabajos}
\label{ch:filtro}
%============================================================

\section{Objetivo y método de medición}
\label{sec:filtro_metodo}

Como ejercicio de práctica independiente del resto de la cadena de
RF, se caracterizó un filtro activo pasabajos con una etapa de
ganancia ajustable mediante potenciómetro, barriendo con un generador
de funciones senoidal y midiendo la tensión pico a pico de entrada y
de salida en dos posiciones del potenciómetro ($G=1$ y $G=2$) a lo
largo de un barrido logarítmico en frecuencia. La excitación de
entrada se mantuvo aproximadamente constante en
$3{,}113 \pm 0{,}045\,\text{V}_{pp}$ ($1{,}5\%$ de dispersión) a lo
largo de todo el barrido. Se registraron $52$ puntos para $G=2$ y
$24$ para $G=1$.

En cada punto el operador anotó el nivel de distorsión observado en
el osciloscopio (sin distorsión / poca distorsión / mucha distorsión
/ ruido), porque la tensión pico a pico de una onda distorsionada no
es la amplitud de su componente fundamental: un punto con distorsión
visible no representa la función transferencia lineal del filtro y
debe excluirse del ajuste cuantitativo. Con este criterio, los datos
se consideran válidos (sin distorsión) hasta $1750\,\text{Hz}$; por
encima de esa frecuencia (zona sombreada y trazo punteado en la
Figura~\ref{fig:respuesta_filtro}) las mediciones existen pero no
deben leerse como respuesta lineal del filtro.

\section{Respuesta en frecuencia}
\label{sec:filtro_respuesta}

La ganancia en banda de paso se calculó como la mediana de
$20\log_{10}(V_{pp,\text{out}}/V_{pp,\text{in}})$ sobre los puntos
válidos entre $200$ y $1750\,\text{Hz}$; las frecuencias de corte a
$-3\,\text{dB}$ se obtuvieron interpolando en escala logarítmica de
frecuencia el cruce con (ganancia de banda de paso $-3\,\text{dB}$).
Los resultados se resumen en la Tabla~\ref{tab:filtro_parametros} y
en la Figura~\ref{fig:respuesta_filtro}.

\begin{table}[H]
  \centering
  \caption{Parámetros medidos del filtro activo en las dos
  posiciones del potenciómetro de ganancia (banda de paso: mediana
  entre $200$ y $1750\,\text{Hz}$, puntos sin distorsión).}
  \label{tab:filtro_parametros}
  \begin{tabular}{lcc}
    \toprule
     & $G = 1$ & $G = 2$ \\
    \midrule
    Ganancia en banda de paso &
      $-0{,}17\,\text{dB}$ ($\times 0{,}981$) &
      $+6{,}51\,\text{dB}$ ($\times 2{,}115$) \\
    Corte inferior ($-3\,\text{dB}$) &
      $19{,}3\,\text{Hz}$ & $18{,}6\,\text{Hz}$ \\
    Corte superior ($-3\,\text{dB}$)\textsuperscript{*} &
      $20{,}3\,\text{kHz}$ & $17{,}5\,\text{kHz}$ \\
    \bottomrule
  \end{tabular}
\end{table}

\textsuperscript{*}Ambos valores de corte superior caen dentro de la
zona confirmada sin distorsión solo hasta $1750\,\text{Hz}$
(Sección~\ref{sec:filtro_metodo}); como se discute en la
Sección~\ref{sec:filtro_normalizada}, deben interpretarse como
\textbf{cota inferior} del ancho de banda real del filtro y no como
su valor exacto.

\begin{figure}[H]
  \centering
  
  \caption{Respuesta en frecuencia del filtro activo, barrido
  senoidal con $V_{in} = 3{,}11\,\text{Vpp}$, en las dos posiciones
  del potenciómetro de ganancia. Arriba: respuesta absoluta, con las
  frecuencias de corte indicadas; el trazo se vuelve punteado a
  partir de la zona con distorsión. Abajo: diferencia entre ambas
  curvas normalizadas a su propia banda de paso.}
  \label{fig:respuesta_filtro}
\end{figure}

La ganancia adicional que aporta el potenciómetro entre las
posiciones $G=1$ y $G=2$ es de $6{,}68\,\text{dB}$ ($\times 2{,}157$).

\section{Comparación normalizada: separar el efecto de la ganancia
del efecto de la amplitud}
\label{sec:filtro_normalizada}

Si el filtro fuese lineal, normalizar cada curva a su propia banda de
paso debería hacer que ambas coincidan exactamente: el potenciómetro
escala la ganancia global pero no debería mover la posición de los
polos del filtro. El panel inferior de la
Figura~\ref{fig:respuesta_filtro} muestra que, en efecto, entre
$1\,\text{Hz}$ y $10\,\text{kHz}$ ambas curvas normalizadas coinciden
dentro de $0{,}40\,\text{dB}$.

Por encima de $15\,\text{kHz}$, sin embargo, divergen hasta
$6{,}68\,\text{dB}$ —exactamente la ganancia que aporta el
potenciómetro—. Esta divergencia ocurre precisamente en la zona ya
identificada como distorsionada (por encima de $1750\,\text{Hz}$,
Sección~\ref{sec:filtro_metodo}), donde la tensión pico a pico
medida deja de representar la amplitud de la componente fundamental.
La interpretación consistente con los datos es que ese flanco
superior depende del nivel de señal (la posición $G=2$, con más del
doble de amplitud de salida, entra antes en una zona no lineal del
circuito o de la medición) y no de la respuesta propia del filtro. En
consecuencia, el ancho de banda real del filtro es mayor que los
$\sim\!20\,\text{kHz}$ medidos en $G=1$, que a su vez ya es, por lo
dicho arriba, una cota inferior.

%============================================================
\chapter{Cables de RF: Retardo Eléctrico, Pérdidas y Calibración
  de Distancia}
\label{ch:cables}
%============================================================

En una prueba de banco con un blanco metálico a una distancia $d$
conocida (Sección~\ref{sec:prueba_metalica}), la frecuencia de batido
medida resultó sistemáticamente mayor que la predicha por la
ecuación~\eqref{eq:beat_freq_aire}: un blanco a $1\,\text{m}$ producía
una $f^*$ compatible con un blanco a varios metros. Este capítulo
muestra que el desvío no es un error del modelo de la
Sección~\ref{sec:beat_freq} sino un término que faltaba: \textbf{el
retardo eléctrico de los cables coaxiles} que conectan el splitter con
las antenas. Se deduce ese
término a partir de la misma ecuación de propagación ya usada en la
Sección~\ref{sec:parametros_fmcw}
(ecuación~\eqref{eq:velocidad_medio}), se cuantifica su efecto sobre la
distancia estimada y el alcance no ambiguo, y se compara el juego de
cables original contra uno nuevo, más corto, caracterizando ambos con
un analizador de redes.

\section{El mezclador ve una diferencia de retardo, no una distancia}
\label{sec:cables_diferencia_retardo}

El mezclador de un radar FMCW homodino no tiene forma de saber cuánto
del retardo que ve entre sus dos entradas (RF y LO) proviene del
trayecto por el aire hacia el blanco y cuánto proviene del cableado que
llega hasta él. Ambos caminos comparten el mismo splitter de salida del
VCO, pero después divergen:

\begin{itemize}
  \item \textbf{Camino del LO} (corto): splitter $\to$ cable de
    longitud $L_\text{LO}$ $\to$ entrada LO del mezclador. En el banco
    de esta tesis ese tramo \emph{no es un cable}: el splitter y el
    mezclador van conectados directamente, con unos $5\,\text{cm}$ de
    unión, de modo que $L_\text{LO} \approx 0$
    (Sección~\ref{sub:cables_ejemplo}).
  \item \textbf{Camino de RF} (largo): splitter $\to$ cable de longitud
    $L_\text{TX}$ $\to$ antena transmisora $\to$ trayecto por el aire
    (ida y vuelta $2d$) $\to$ antena receptora $\to$ cable de longitud
    $L_\text{RX}$ $\to$ LNA $\to$ entrada RF del mezclador.
\end{itemize}

Se conserva $L_\text{LO}$ en la formulación aunque en este montaje
valga casi cero, porque es el término sobre el que se actúa si se
quiere cancelar el offset por diseño
(Sección~\ref{sec:cables_plantilla}).

La Figura~\ref{fig:cables_diagrama} esquematiza ambos caminos. El
retardo total que ve el mezclador es la suma del retardo eléctrico en
los cables más el retardo de propagación por el aire:

\begin{equation}
  \tau_\text{total} = \underbrace{\frac{L_\text{TX} + L_\text{RX}
  - L_\text{LO}}{v_p}}_{\displaystyle \tau_\text{cables}}
  \;+\; \underbrace{\frac{2d}{c}}_{\displaystyle \tau_\text{blanco}},
  \label{eq:tau_total}
\end{equation}

donde $v_p$ es la velocidad de propagación dentro del dieléctrico del
cable coaxil. Conviene definir el \textbf{desbalance neto de cableado}

\begin{equation}
  D \;=\; L_\text{TX} + L_\text{RX} - L_\text{LO},
  \label{eq:D_neto}
\end{equation}

que es la magnitud relevante: no importan las longitudes absolutas de
cada tramo, sino cuánto más largo es el camino de RF que el del LO. Si
$D = 0$ (cables perfectamente balanceados) el término de cables
desaparece y el mezclador mide únicamente $\tau_\text{blanco}$, que es
la situación que asume implícitamente la
ecuación~\eqref{eq:beat_freq_aire}.

\begin{figure}[H]
  \centering
  \begin{tikzpicture}[
      font=\small,
      box/.style={draw, rounded corners, minimum height=0.9cm,
        align=center, inner sep=4pt},
      arr/.style={-{Latex[length=2.2mm]}, thick},
      node distance=10mm and 8mm
    ]
    \node[box] (vco) {VCO};
    \node[box, right=of vco] (split) {Splitter};

    \node[box, above right=6mm and 18mm of split] (lo) {Mezclador\\(entrada LO)};
    \node[box, below right=6mm and 18mm of split] (tx) {Antena Tx};
    \node[box, right=32mm of tx] (rx) {Antena Rx};
    \node[box, above right=6mm and 8mm of rx] (lna) {LNA};
    \node[box, right=8mm of lo] (mix) {Mezclador};

    \draw[arr] (vco) -- (split);
    \draw[arr] (split.north east) -- node[above, sloped]{$L_\text{LO}$} (lo.west);
    \draw[arr] (split.south east) -- node[below, sloped]{$L_\text{TX}$} (tx.west);
    \draw[arr] (tx) -- node[above, font=\scriptsize]{aire, $2d$} (rx);
    \draw[arr] (rx) -- (lna);
    \draw[arr] (lna) -- node[above, sloped]{$L_\text{RX}$} (mix.south);
    \draw[arr] (lo) -- (mix);

    \node[align=center, below=2mm of mix, font=\scriptsize\itshape]
      {ve $\tau_\text{total} = \tau_\text{cables} + \tau_\text{blanco}$};
  \end{tikzpicture}
  \caption{Los dos caminos que llegan al mezclador. El del LO es corto
    y fijo ---en este banco, una conexión directa de $\approx
    5\,\text{cm}$---; el de RF incluye los cables a las antenas más el
    trayecto por el aire. El mezclador solo puede medir la diferencia
    de retardo entre ambos, no el retardo absoluto de ninguno.}
  \label{fig:cables_diagrama}
\end{figure}

\section{Velocidad de propagación en el cable: el factor de velocidad}
\label{sec:cables_vf}

La ecuación~\eqref{eq:velocidad_medio}, ya usada para la propagación en
el suelo, se aplica sin cambios al dieléctrico interno del cable
coaxil: $v_p = c/\sqrt{\varepsilon_{r,\text{cable}}}$. En cables de RF
esta razón se expresa habitualmente como el \textbf{factor de
velocidad} $\text{VF} = v_p/c = 1/\sqrt{\varepsilon_{r,\text{cable}}}$,
que el fabricante especifica en la hoja de datos. La
Tabla~\ref{tab:vf_cables} resume valores nominales típicos según el
dieléctrico.

\begin{table}[H]
  \centering
  \caption{Factor de velocidad nominal según el dieléctrico del cable
    coaxil (valores de catálogo típicos). Los medidos en los cables del
    banco están en la Tabla~\ref{tab:cables_retardo}.}
  \label{tab:vf_cables}
  \begin{tabular}{lcc}
    \toprule
    \textbf{Dieléctrico} & \textbf{Cables típicos} & \textbf{VF} \\
    \midrule
    Polietileno sólido      & RG-58, RG-213 & $\approx 0{,}66$ \\
    PTFE (teflón) sólido    & Semirrígido   & $\approx 0{,}70$ \\
    Polietileno espumado    & RG-8X espuma  & $\approx 0{,}78$ \\
    \bottomrule
  \end{tabular}
\end{table}

\textbf{El cable es más lento que el aire.} Con $\text{VF} = 0{,}66$,
un metro de cable tarda lo mismo que $1/0{,}66 \approx 1{,}52\,\text{m}$
de aire: es la razón por la que el retardo de los cables pesa más de
lo que la intuición geométrica sugiere.

\section{Retardo neto y distancia aparente}
\label{sec:cables_offset}

Identificando en la ecuación~\eqref{eq:tau_total} el término de cables
y sustituyéndolo en la ecuación~\eqref{eq:beat_freq} (usando
$S = 2B/T_c$, Sección~\ref{sec:parametros_fmcw}), la frecuencia de
batido medida es

\begin{equation}
  f^*_\text{medido} = S\,\tau_\text{total}
  = \underbrace{\frac{4Bd}{c\,T_c}}_{f^*(d),\ \text{ec.}~\eqref{eq:beat_freq_aire}}
  \;+\; \underbrace{\frac{2B}{T_c}\cdot\frac{D}{\text{VF}\cdot c}}_{f_\text{offset}}.
  \label{eq:f_offset}
\end{equation}

Aplicando la inversión de la ecuación~\eqref{eq:d_estimada} a
$f^*_\text{medido}$, el offset en frecuencia se traduce en un offset
constante en la distancia estimada, \textbf{independiente de $T_c$ y
de $d$}:

\begin{equation}
  \boxed{
    \hat{d} = d + d_\text{offset},
    \qquad
    d_\text{offset} = \frac{D}{2\,\text{VF}}.
  }
  \label{eq:d_offset}
\end{equation}

Es un corrimiento aditivo, no un factor de escala: la pendiente de
$\hat d$ respecto de $d$ sigue siendo $1$. Esto explica una observación
del banco que a primera vista resulta contraintuitiva: al acercar o
alejar el blanco, la frecuencia de batido bajaba o subía exactamente
como predice la ecuación~\eqref{eq:beat_freq_aire} —el sistema
\emph{medía bien}— pero el valor absoluto de $\hat d$ estaba corrido
por una constante ajena al blanco.

\subsection{Ejemplo numérico}
\label{sub:cables_ejemplo}

Con los cables originales del banco ---dos RG-58 desparejos,
$L_\text{TX} = 3\,\text{m}$ y $L_\text{RX} = 2{,}6\,\text{m}$--- y
$\text{VF} = 0{,}66$ (polietileno sólido, Tabla~\ref{tab:vf_cables}).

\textbf{En este montaje el camino del LO no lleva cable}: el splitter y
el mezclador van conectados directamente, con unos $5\,\text{cm}$ de
unión. Ese tramo aporta $0{,}25\,\text{ns}$, es decir $3{,}8\,\text{cm}$
de distancia aparente ---bastante menos que la resolución de
$14{,}4\,\text{cm}$ del radar---, así que $L_\text{LO}$ es despreciable
y $D \approx L_\text{TX} + L_\text{RX} = 5{,}55\,\text{m}$:

\begin{equation*}
  d_\text{offset} = \frac{5{,}55}{2 \times 0{,}66} \approx 4{,}20\,\text{m}.
\end{equation*}

Que $L_\text{LO}$ sea despreciable es una \emph{mala} noticia, no una
simplificación afortunada: es el único término de la
ecuación~\eqref{eq:D_neto} que resta, y no está restando nada. Todo el
cable de antena se paga entero.

Nótese además que esa ecuación solo pide la \emph{suma} $L_\text{TX} +
L_\text{RX}$: que los dos cables de antena sean de distinto largo no
agrega ningún término. El desbalance que importa es el que hay entre el
camino de RF y el del LO, no el que hay entre TX y RX.

Este offset es constante en distancia pero, al pasar por
$f_\text{offset} = S\,D/(\text{VF}\,c)$, depende de $T_c$ porque $S$
depende de $T_c$. La Tabla~\ref{tab:cables_ejemplo} evalúa
$f_\text{offset}$ y la $f^*_\text{medido}$ total esperada para un
blanco a $d = 1\,\text{m}$, con $B = 1\,\text{GHz}$.

\begin{table}[H]
  \centering
  \caption{Frecuencia de batido esperada para un blanco a
    $d = 1\,\text{m}$, con y sin el aporte de los cables originales
    ($D = 5{,}55\,\text{m}$, $\text{VF} = 0{,}66$). $d_\text{offset}
    = 4{,}20\,\text{m}$ es constante; lo que cambia con $T_c$ es a
    cuántos Hz equivale. La fila de $100\,\text{ms}$ es el $T_c$ con el
    que mide el banco: $50\,\text{ms}$ de subida y $50$ de bajada.}
  \label{tab:cables_ejemplo}
  \begin{tabular}{cccc}
    \toprule
    $T_c$ & $f^*(d=1\,\text{m})$ & $f_\text{offset}$
      & $f^*_\text{medido}$ \\
    \midrule
    $80\,\text{ms}$  &  $167\,\text{Hz}$ &  $701\,\text{Hz}$ &  $868\,\text{Hz}$ \\
    $100\,\text{ms}$ &  $133\,\text{Hz}$ &  $561\,\text{Hz}$ &  $694\,\text{Hz}$ \\
    $160\,\text{ms}$ &   $83\,\text{Hz}$ &  $351\,\text{Hz}$ &  $434\,\text{Hz}$ \\
    \bottomrule
  \end{tabular}
\end{table}

La fila de $T_c = 80\,\text{ms}$ es la que se comparó contra el banco:
el modelo predice $868\,\text{Hz}$ para un blanco a $1\,\text{m}$, y lo
observado en la medición superaba los $800\,\text{Hz}$. El acuerdo no
debe leerse como más fino de lo que es: la tabla usa el $\text{VF}$ de
catálogo, y con el retardo medido con el analizador de redes el offset
de este juego baja a $3{,}86\,\text{m}$
(Sección~\ref{sub:cables_comparacion}). Pero deja el orden de magnitud
fuera de discusión: el aporte de los cables es varias veces el del
blanco.

\section{Corrección: calibración con un punto de distancia conocida}
\label{sec:cables_calibracion}

Como $d_\text{offset}$ es un corrido de origen y no una escala, alcanza
con \textbf{un único} punto de calibración: colocar un blanco a una
distancia $d_\text{real}$ conocida, medir la $\hat d$ cruda que entrega
el sistema, y restar:

\begin{equation}
  d_\text{offset}^\text{medido} = \hat d - d_\text{real}.
  \label{eq:offset_medido}
\end{equation}

Con dos o más puntos a distancias distintas puede además ajustarse por
cuadrados mínimos una recta $\hat d = a\,d_\text{real} + b$, lo que
sirve como \textbf{verificación}: si el modelo de este capítulo es
correcto, $a$ debe dar $\approx 1$ y $b$ debe coincidir con el
$d_\text{offset}$ predicho por la
ecuación~\eqref{eq:d_offset} a partir de las longitudes de cable
medidas físicamente. Un valor de $a$ alejado de $1$ señala que el
problema no está en los cables sino en otro parámetro del sistema (por
ejemplo, un $T_c$ mal configurado respecto del que efectivamente
entrega el generador).

\section{Pérdidas de inserción: lo que los cables cuestan aparte del retardo}
\label{sec:cables_perdidas}

El retardo de los cables puede anularse por diseño, agregándole al
camino del LO tanto cable como suman $L_\text{TX} + L_\text{RX}$ para
que $D = 0$ en la ecuación~\eqref{eq:D_neto}. La \textbf{atenuación} de
los cables, en cambio, no se cancela nunca: cada tramo atenúa la señal
que lo atraviesa sin importar cuánto midan los otros ---y esa maniobra,
de hecho, \emph{agrega} atenuación en el LO en vez de quitarla. Un
coaxil atenúa más cuanto:

\begin{itemize}
  \item más alta es la frecuencia (la pérdida por efecto pelicular en
    el conductor crece aproximadamente con $\sqrt{f}$, y la pérdida en
    el dieléctrico crece aproximadamente en forma lineal con $f$);
  \item más largo es el tramo (la atenuación en dB es proporcional a la
    longitud);
  \item menor es el diámetro del conductor central y peor el
    dieléctrico (por eso el RG-213, con un conductor más grueso que el
    RG-58, atenúa menos por metro a igual frecuencia).
\end{itemize}

Esta pérdida golpea al sistema en dos lugares distintos de la cadena
de la Figura~\ref{fig:cables_diagrama}: la atenuación de
$L_\text{TX}$ resta potencia efectivamente radiada, y la de
$L_\text{RX}$ resta señal a la entrada del LNA \emph{antes} de que se
amplifique, empeorando directamente la figura de ruido de toda la
cadena. Acortar los cables reduce el retardo (Sección~\ref{sec:cables_offset})
\textbf{y} la atenuación al mismo tiempo: a diferencia de la elección
de $T_c$ (Capítulo~\ref{ch:senal_if}), acá no hay dos efectos en
sentidos opuestos que haya que balancear. El valor exacto de
atenuación en la banda de $943$ a $1982\,\text{MHz}$ depende del cable
concreto y se mide, no se supone: está en la
Sección~\ref{sub:cables_s21_medido}.

\section{Caracterización: cables originales vs. cables nuevos}
\label{sec:cables_plantilla}

Se armó un segundo juego de dos cables de $1\,\text{m}$ en RG-213 para
reemplazar los originales (RG-58 de $3\,\text{m}$ y $2{,}6\,\text{m}$).

\textbf{Por qué $1\,\text{m}$ y no menos.} El retardo mejora cuanto más
corto sea el cable, así que el largo lo termina fijando un límite
mecánico, no eléctrico: el RG-213 tiene $10\,\text{mm}$ de diámetro y
un radio de curvatura mínimo del orden de $75\,\text{mm}$, y por debajo
de $1\,\text{m}$ el tramo deja de tener juego suficiente para llegar a
las antenas sin forzar los conectores ni tironear del montaje al mover
el banco. Un cable más fino admitiría tramos más cortos, pero atenúa el
doble por metro (Sección~\ref{sub:cables_s21_medido}): $1\,\text{m}$ de
RG-213 es el punto donde las dos exigencias se cruzan.

Con $D_\text{nuevo} = 2\times1{,}0 - L_\text{LO}$, el offset de
distancia cae de los $4{,}20\,\text{m}$ del juego original a
$1{,}48\,\text{m}$. La Tabla~\ref{tab:cables_nuevo_offset} muestra
cuánto más se podría bajar interviniendo el camino del LO, que hoy es
una conexión directa ($L_\text{LO} \approx 5\,\text{cm}$) y es el único
grado de libertad que queda una vez fijado el largo de los cables de
antena.

\begin{table}[H]
  \centering
  \caption{Offset de distancia esperado con los cables nuevos
    ($L_\text{TX} = L_\text{RX} = 1\,\text{m}$, $\text{VF} = 0{,}66$
    nominal) según la longitud que se elija para el cable al LO.}
  \label{tab:cables_nuevo_offset}
  \begin{tabular}{ccc}
    \toprule
    $L_\text{LO}$ & $D_\text{nuevo}$ & $d_\text{offset}$ \\
    \midrule
    $0{,}05\,\text{m}$ (hoy) & $1{,}95\,\text{m}$ & $1{,}48\,\text{m}$ \\
    $0{,}5\,\text{m}$        & $1{,}50\,\text{m}$ & $1{,}14\,\text{m}$ \\
    $1{,}0\,\text{m}$        & $1{,}00\,\text{m}$ & $0{,}76\,\text{m}$ \\
    $2{,}0\,\text{m}$        & $0$                & $0$ \\
    \bottomrule
  \end{tabular}
\end{table}

\textbf{La última fila es la única que anula el offset de raíz}, y no
exige cables cortos sino \emph{emparejados}: alcanza con darle al LO
tanto cable como suman TX y RX. El costo es la atenuación que ese tramo
le agrega al LO ---unos $0{,}7\,\text{dB}$ a $1{,}5\,\text{GHz}$ con
RG-213---, que el mezclador puede necesitar para conmutar bien.

\textbf{Ojo con el signo si se toma ese camino.} Alargar el LO es la
única maniobra de este capítulo que puede \emph{pasarse} de largo: si
$L_\text{LO}$ terminara siendo mayor que $L_\text{TX} + L_\text{RX}$,
$D$ se vuelve negativo y con él $d_\text{offset}$, y un blanco
aparecería más \emph{cerca} de lo que está en realidad en vez de más
lejos. El error no es más grave que el actual ---sigue siendo un
offset constante, corregible con un punto de calibración--- pero es
mucho más confuso de diagnosticar, porque contradice la intuición de
que ``los cables alejan''. Conviene entonces cortar ese tramo con
medida y no de más.

\subsection{Procedimiento}
\label{sub:cables_procedimiento}

\begin{enumerate}
  \item \textbf{Pérdida de inserción ($S_{21}$) con el VNA.}
    \emph{Hecho} --- Sección~\ref{sub:cables_s21_medido},
    Figura~\ref{fig:cables_s21}. Se barrió de $500\,\text{MHz}$ a
    $2{,}5\,\text{GHz}$, más ancho que la banda del radar, para poder
    ajustar el modelo de atenuación sobre un tramo largo.
  \item \textbf{Retardo de grupo con el VNA.} \emph{Hecho} ---
    Sección~\ref{sub:cables_retardo_medido},
    Figura~\ref{fig:cables_tiempo}. El retardo sale de la pendiente de
    la fase de $S_{21}$, con los cuatro parámetros $S$ guardados en
    Touchstone (\texttt{.s2p}). Los largos físicos, medidos con cinta,
    coinciden aproximadamente con los nominales.
  \item \textbf{Calibración de un punto en el radar.} \emph{Pendiente},
    ver Sección~\ref{sub:cables_pendiente}.
  \item \textbf{Espectro de batido, mismo blanco, los dos juegos de
    cables.} \emph{Pendiente}, ver Sección~\ref{sub:cables_pendiente}.
\end{enumerate}

Los dos primeros pasos caracterizan los cables solos, con el analizador
de redes, y son los que se reportan en lo que sigue. Los dos últimos
miden el efecto de los cables sobre el radar completo.

\subsection{Resultados: pérdida de inserción (VNA)}
\label{sub:cables_s21_medido}

Se midieron los cuatro cables con un analizador de redes Agilent
N9923A (FieldFox), de $500$ a $2500\,\text{MHz}$ en $801$ puntos: los
dos RG-58 del juego original ($3\,\text{m}$ y $2{,}6\,\text{m}$, uno
por antena) y los dos RG-213 nuevos de $1\,\text{m}$, que se llaman A
y B en lo que sigue. El equipo se calibró en dos puertos completos con
QuickCal ($\text{IFBW} = 1\,\text{kHz}$, promedio de $4$ barridos) y
cada cable se guardó con sus cuatro parámetros $S$ en magnitud y fase.
Una primera tanda de mediciones había exportado solo magnitud; con
ella se estimó el retardo a partir del rizado de $|S_{11}|$, y ese
valor se conserva en la Figura~\ref{fig:cables_tiempo} para comparar
los dos métodos.

Los cables son recíprocos dentro de la medición: $|S_{21}|$ y
$|S_{12}|$ difieren menos de $0{,}02\,\text{dB}$ en los cuatro, que es
una verificación de la calibración.

La Figura~\ref{fig:cables_s21} muestra la pérdida de inserción. El
panel izquierdo es lo que entrega el equipo: la pérdida total del
conjunto cable más sus dos conectores. El derecho la normaliza por el
largo, ajustando el modelo $\alpha(f) = a\sqrt{f}$ \emph{forzado por el
origen}, que es la forma que impone la pérdida por efecto pelicular
descrita en la Sección~\ref{sec:cables_perdidas}.

\begin{figure}[H]
  \centering
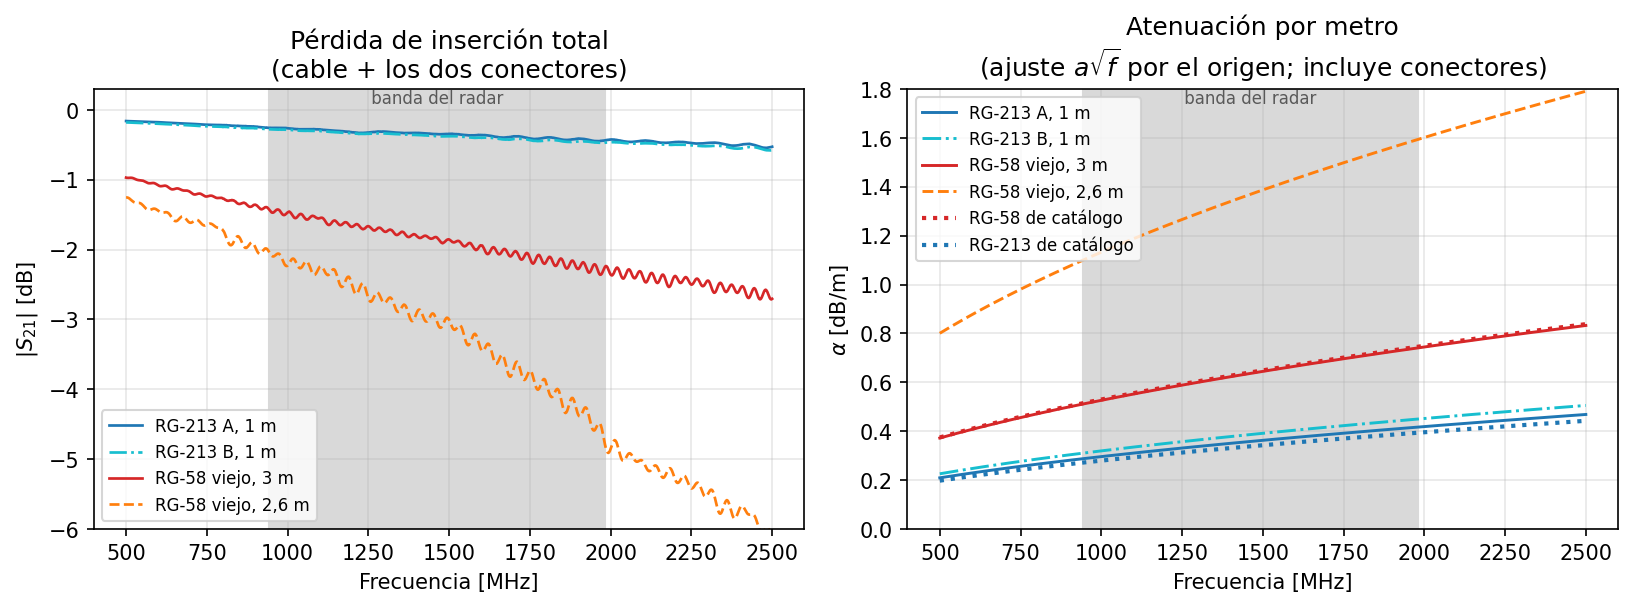
[picture p42: redaccion/figuras/cables/cables_insercion.png]
  
  \caption{Pérdida de inserción medida con el VNA. Izquierda: pérdida
    total $|S_{21}|$ tal como se mide, cable más sus dos conectores; el
    rizado fino es la interferencia entre los dos conectores. Derecha:
    atenuación por metro ajustada como $a\sqrt{f}$ por el origen, con
    los valores de catálogo superpuestos en punteado. Los dos RG-213 y
    el RG-58 de $3\,\text{m}$ caen sobre sus referencias de catálogo;
    el RG-58 de $2{,}6\,\text{m}$ queda al doble y, a la izquierda, se
    curva hacia abajo en vez de seguir la raíz.}
  \label{fig:cables_s21}
\end{figure}

\textbf{Por qué el ajuste se fuerza por el origen.} Se probó primero
con $a\sqrt{f} + b$, esperando que el término constante $b$ se quedara
con lo que no depende del largo: los dos conectores y el desadaptado.
No funciona. En una banda de apenas $500$ a $2500\,\text{MHz}$,
$\sqrt{f}$ y la constante están demasiado correlacionadas para
separarse, y $b$ salió \emph{negativo} en los cuatro cables
($-0{,}15$ en los dos RG-213, $-0{,}48$ en el RG-58 de $3\,\text{m}$ y
$-3{,}43\,\text{dB}$ en el de $2{,}6\,\text{m}$), lo que como pérdida de conector no
existe: lo que hacía era absorber la desviación respecto de la raíz e
inflarle $a$ al cable. Forzado por el origen los números caen sobre el
catálogo, como se ve en la figura. Queda dicho lo que el ajuste
\textbf{no} hace: la pérdida de los conectores sigue adentro de
$\alpha$, repartida en el largo del cable. Separarla exige medir dos
largos del mismo tipo de cable y restar.

\begin{table}[H]
  \centering
  \caption{Atenuación medida y de catálogo en la banda del radar. Los
    dos RG-213 difieren entre sí un $8$\,\% y quedan a menos de un
    $15$\,\% del catálogo con los conectores incluidos. El cable de
    $2{,}6\,\text{m}$ atenúa el doble que su gemelo de $3\,\text{m}$,
    siendo el mismo tipo de cable.}
  \label{tab:cables_alfa}
  \begin{tabular}{lcccc}
    \toprule
    \textbf{Cable} & $\bm{\alpha}$ \textbf{@} $\bm{1\,}$\textbf{GHz}
    & \textbf{Catálogo} & $\bm{\alpha}$ \textbf{@} $\bm{1{,}46\,}$\textbf{GHz}
    & \textbf{Total @} $\bm{1{,}46\,}$\textbf{GHz} \\
    \midrule
    RG-213 A, $1\,\text{m}$          & $0{,}296$ dB/m & $0{,}28$ dB/m & $0{,}358$ dB/m & $0{,}36$ dB \\
    RG-213 B, $1\,\text{m}$          & $0{,}320$ dB/m & $0{,}28$ dB/m & $0{,}387$ dB/m & $0{,}39$ dB \\
    RG-58 viejo, $3\,\text{m}$       & $0{,}527$ dB/m & $0{,}53$ dB/m & $0{,}637$ dB/m & $1{,}91$ dB \\
    RG-58 viejo, $2{,}6\,\text{m}$   & $1{,}132$ dB/m & $0{,}53$ dB/m & $1{,}369$ dB/m & $3{,}56$ dB \\
    \bottomrule
  \end{tabular}
\end{table}

\textbf{El cable de $2{,}6\,\text{m}$ se supone en mal estado}, por las
tres razones que se reúnen en la Sección~\ref{sub:cables_defectuoso}.
Se lo grafica porque es uno de los dos cables que efectivamente
estuvieron en el banco, pero no se lo usa para caracterizar al RG-58:
para eso sirve el de $3\,\text{m}$, que sí se comporta como su hoja de
datos.

\subsection{Resultados: adaptación y pérdida de retorno}
\label{sub:cables_s11_medido}

\begin{figure}[H]
  \centering
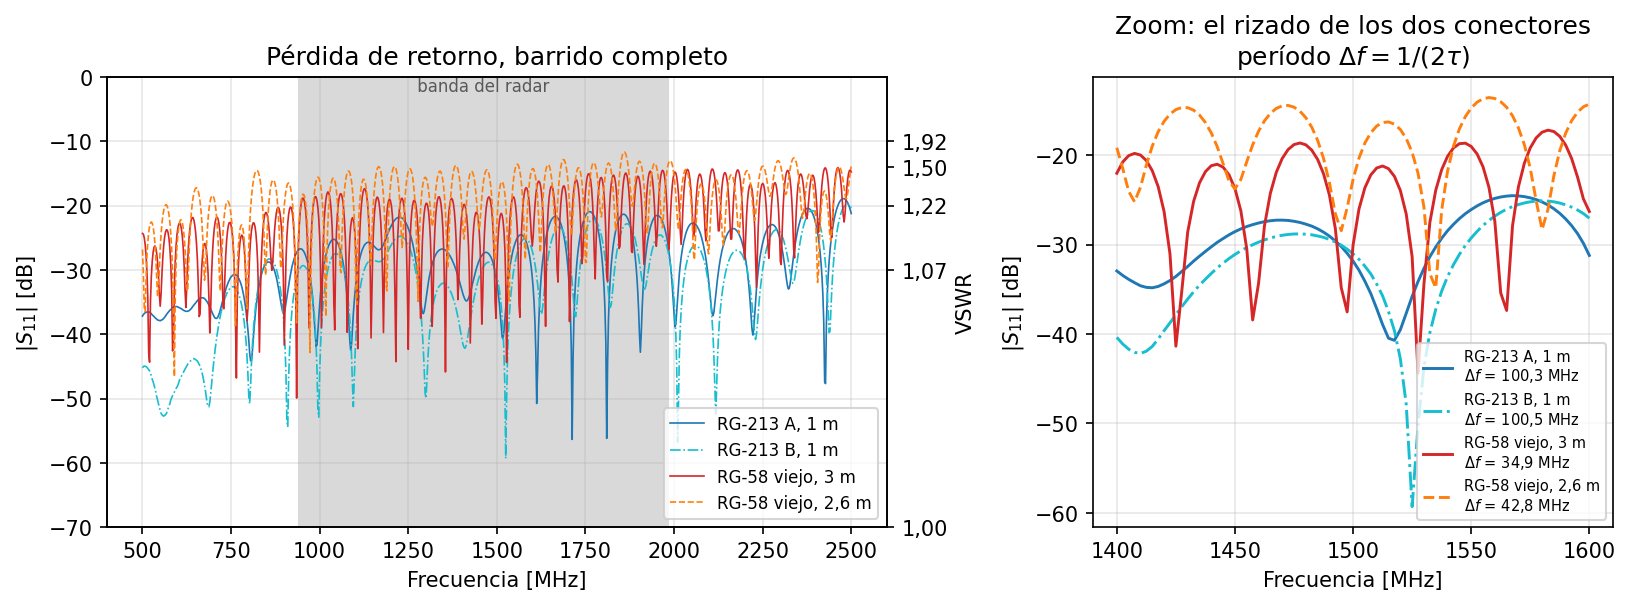
[picture p43: redaccion/figuras/cables/cables_retorno.png]
  
  \caption{Pérdida de retorno. Izquierda: $|S_{11}|$ en todo el
    barrido, con la escala de VSWR equivalente a la derecha y la banda
    del radar sombreada. Derecha: zoom de $1400$ a $1600\,\text{MHz}$.
    El rizado no es ruido: es la interferencia entre las reflexiones de
    los dos conectores, y su período vale $\Delta f = 1/(2\tau)$, con
    $\tau$ el retardo medido de la fase. A cable más largo, rizado más
    apretado.}
  \label{fig:cables_s11}
\end{figure}

Los dos RG-213 quedan por debajo de VSWR $1{,}20$ en toda la banda del
radar, y el RG-58 de $3\,\text{m}$ por debajo de $1{,}46$. El de
$2{,}6\,\text{m}$ llega a $1{,}71$ ($|S_{11}| = -11{,}7\,\text{dB}$):
es el peor de los cuatro, aunque sigue sin ser un desadaptado grave.

Los períodos del zoom cierran con el retardo que se mide por otro
camino en la sección siguiente: $100\,\text{MHz}$ en los cables de
$1\,\text{m}$ corresponden a $\tau = 5{,}0\,\text{ns}$, y
$34{,}9\,\text{MHz}$ en el de $3\,\text{m}$ a $14{,}3\,\text{ns}$.
\textbf{El rizado contiene el retardo}, y fue lo que permitió estimarlo
en la primera tanda de mediciones, cuando todavía no se tenía la fase.

\subsection{Resultados: retardo y VF real}
\label{sub:cables_retardo_medido}

Con la fase de $S_{21}$ el retardo se mide directo: un cable ideal es
un retardo puro, $S_{21} = |S_{21}|\,e^{-j\omega\tau}$, así que la
fase desenrollada es una recta en $\omega$ y su pendiente, cambiada de
signo, es $\tau$. Se ajustó esa recta sobre todo el barrido, de $500$ a
$2500\,\text{MHz}$. El desvío rms de la fase respecto de la recta
indica cuánto se aparta el cable de un retardo puro, y resulta útil
para diagnosticarlo.

Con $S_{11}$ en magnitud y fase se puede además calcular la
\textbf{respuesta al impulso} del cable: la transformada inversa de
$S_{11}(f)$ muestra cada discontinuidad como un pico en su tiempo de
ida y vuelta. Es el modo ``dominio del tiempo'' de un VNA, hecho
fuera del equipo. Como el barrido es de banda pasante ($500$ a
$2500\,\text{MHz}$) y se aplica ventana de Hann, la resolución es de
un poco más de $1/BW = 0{,}5\,\text{ns}$ de ida y vuelta.

\begin{figure}[H]
  \centering
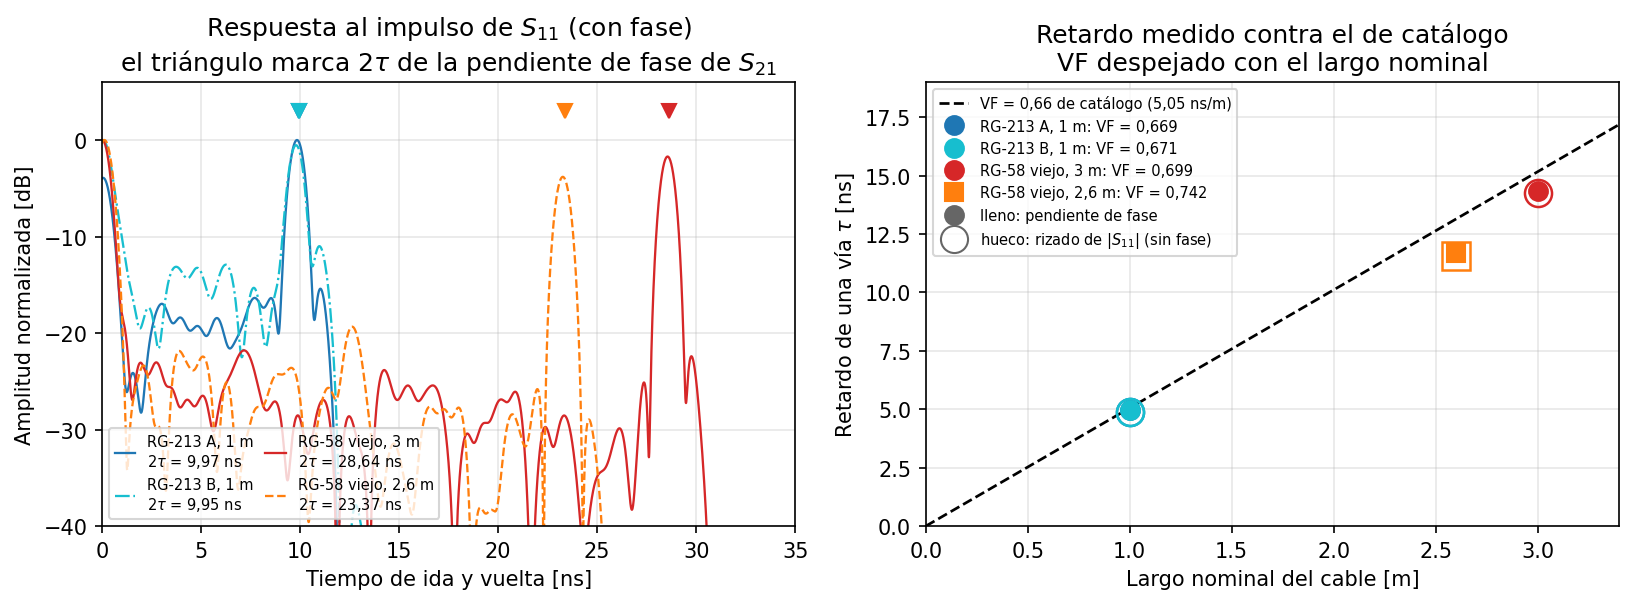
[picture p44: redaccion/figuras/cables/cables_tiempo.png]
  
  \caption{Izquierda: respuesta al impulso de $S_{11}$ complejo, en
    dB respecto del pico mayor. Cada pico es una reflexión, ubicada en
    su tiempo de ida y vuelta; el triángulo marca $2\tau$ tomado de la
    pendiente de fase de $S_{21}$, y coincide con el eco del extremo en
    los cuatro cables. El RG-58 de $2{,}6\,\text{m}$ (naranja) muestra
    además un pico a mitad de camino, en $12{,}6\,\text{ns}$.
    Derecha: retardo de una vía contra el largo nominal. Los símbolos
    llenos son la pendiente de fase y los huecos, el rizado de
    $|S_{11}|$; la recta es el VF $0{,}66$ de catálogo.}
  \label{fig:cables_tiempo}
\end{figure}

\textbf{Los dos métodos coinciden.} El eco del extremo cae exactamente
donde lo pone la pendiente de fase, obtenida de otro parámetro
($S_{21}$ y no $S_{11}$), y el retardo del rizado difiere del de fase
entre $0{,}05$ y $0{,}12\,\text{ns}$, siempre dentro de la resolución
de $\pm0{,}25\,\text{ns}$ que se le había asignado a ese método. La
diferencia está en la precisión: el ajuste de fase usa las $801$
muestras y no depende de dónde cae un bin de la FFT.

\begin{table}[H]
  \centering
  \caption{Retardo medido de la pendiente de fase de $S_{21}$. Las
    columnas de $L$ y VF son dos lecturas del mismo dato: fijando el VF
    de catálogo se despeja el largo eléctrico, y fijando el largo
    nominal se despeja el VF. La última columna es el desvío rms de la
    fase respecto de un retardo puro.}
  \label{tab:cables_retardo}
  \small\setlength{\tabcolsep}{4pt}
  \begin{tabular}{lccccc}
    \toprule
    \textbf{Cable} & $\bm{\tau}$ & \textbf{ns/m}
    & $\bm{L}$ \textbf{si VF} $\bm{=0{,}66}$ & \textbf{VF si} $\bm{L}$ \textbf{nominal}
    & \textbf{Desvío de fase} \\
    \midrule
    RG-213 A, $1\,\text{m}$        & $4{,}983$ ns  & $4{,}98$ & $0{,}99$ m & $0{,}669$ & $0{,}09^\circ$ \\
    RG-213 B, $1\,\text{m}$        & $4{,}975$ ns  & $4{,}98$ & $0{,}98$ m & $0{,}671$ & $0{,}08^\circ$ \\
    RG-58 viejo, $3\,\text{m}$     & $14{,}319$ ns & $4{,}77$ & $2{,}83$ m & $0{,}699$ & $0{,}37^\circ$ \\
    RG-58 viejo, $2{,}6\,\text{m}$ & $11{,}686$ ns & $4{,}49$ & $2{,}31$ m & $0{,}742$ & $1{,}78^\circ$ \\
    \bottomrule
  \end{tabular}
\end{table}

\textbf{Los RG-213 confirman el catálogo.} Los dos dan VF $0{,}67$, a
$1{,}5$\,\% del $0{,}66$ nominal, y difieren entre sí apenas
$8\,\text{ps}$. Una diferencia de $1{,}5$\,\% en un cable de
$1\,\text{m}$ son $1{,}5\,\text{cm}$ de largo, que es del orden del
error de medir el cable con cinta y de dónde se toma el plano de
referencia de los conectores. Con fase, el primer valor que se había
despejado del rizado ($0{,}684$) resulta ser error del método.

\textbf{Los RG-58 viejos dan más rápidos}: $0{,}699$ el de
$3\,\text{m}$ y $0{,}742$ el de $2{,}6\,\text{m}$. Medidos con cinta,
los dos cables tienen aproximadamente su largo nominal, así que la
diferencia no se explica por el largo: para ajustarse al catálogo, el
de $3\,\text{m}$ tendría que medir unos $17\,\text{cm}$ menos. En ese
cable es probable que el dieléctrico no sea exactamente el del RG-58
de catálogo. El
valor del de $2{,}6\,\text{m}$ no es físico para polietileno sólido y
se trata en la sección siguiente. Aun así, \textbf{todos los cálculos
de diseño de este capítulo siguen usando el VF nominal $0{,}66$}: es
el valor que se conoce sin medir, y el offset real del banco se corrige
igual con la calibración de la Sección~\ref{sec:cables_calibracion}.

\subsection{El cable de $2{,}6\,\text{m}$: por qué se lo supone en mal estado}
\label{sub:cables_defectuoso}

El cable de $2{,}6\,\text{m}$ es uno de los dos que estuvieron en el
banco, del lado de RX, y se sospechaba de él antes de medirlo. Las
mediciones muestran tres indicios independientes, cada uno en un
parámetro distinto:

\begin{enumerate}
  \item \textbf{Atenúa el doble de lo que le corresponde, y no con la
    forma de un cable.} Da $1{,}13\,\text{dB/m}$ a $1\,\text{GHz}$
    contra los $0{,}53$ del catálogo y los $0{,}527$ que midió su
    gemelo de $3\,\text{m}$ (Tabla~\ref{tab:cables_alfa}). Aun siendo
    $40\,\text{cm}$ más corto, pierde $3{,}56\,\text{dB}$ en el centro
    de la banda contra $1{,}91$. Además, la pérdida no crece como
    $\sqrt{f}$: en la Figura~\ref{fig:cables_s21} la curva se dobla
    hacia abajo, y el ajuste libre $a\sqrt{f}+b$ necesita un término
    constante de $-3{,}43\,\text{dB}$ para seguirla, siete veces el del
    RG-58 sano. El efecto pelicular y el dieléctrico por sí solos
    no dan esa forma.
  \item \textbf{Es el peor adaptado de los cuatro.} $|S_{11}|$ llega a
    $-11{,}7\,\text{dB}$ (VSWR $1{,}71$) en la banda del radar, contra
    $-14{,}5\,\text{dB}$ del RG-58 de $3\,\text{m}$ y
    $-21\,\text{dB}$ de los RG-213 (Figura~\ref{fig:cables_s11}).
    Refleja más en sus extremos, que es lo que se espera de un conector
    mal armado o flojo.
  \item \textbf{Su retardo no es el de un cable sano.} La fase de
    $S_{21}$ se aparta $1{,}78^\circ$ rms de un retardo puro, cinco
    veces más que el RG-58 de $3\,\text{m}$ y veinte veces más que los
    RG-213 (Tabla~\ref{tab:cables_retardo}). El VF que se despeja,
    $0{,}742$, no es posible en polietileno sólido. Y en la respuesta
    al impulso (Figura~\ref{fig:cables_tiempo}) aparece una reflexión
    \emph{dentro} del cable, unos $15\,\text{dB}$ por debajo del eco
    del extremo. Esa reflexión se ve desde los dos puertos: en
    $12{,}63\,\text{ns}$ desde el puerto~1 y en $10{,}77\,\text{ns}$
    desde el puerto~2. Las dos lecturas suman $23{,}40\,\text{ns}$,
    igual a los $2\tau = 23{,}37\,\text{ns}$ del cable, así que no es
    un artefacto de la transformada: es un punto físico, a unos
    $1{,}4\,\text{m}$ de un extremo y $1{,}2\,\text{m}$ del otro.
\end{enumerate}

Los dos primeros indicios son compatibles con un conector en mal
estado, que era la hipótesis inicial. El tercero sugiere que el daño
no está solo en los extremos: una discontinuidad a mitad del cable
puede ser un aplastamiento, un doblez por debajo del radio mínimo o un
empalme. Conviene no sobreinterpretarlo. El RG-58 de $3\,\text{m}$,
que en todo lo demás se comporta bien, muestra un par de reflexiones
internas del mismo tipo, unos $5\,\text{dB}$ más débiles respecto de su
propio eco del extremo. Además, una reflexión chica no alcanza para
explicar por sí sola los $1{,}9\,\text{dB}$ que pierde de más en el
centro de la banda: un daño con pérdida puede reflejar poco.

La conclusión práctica es la misma en cualquier caso: \textbf{el cable
de $2{,}6\,\text{m}$ no representa al RG-58} y no conviene volver a
usarlo en el banco. Que el defecto esté en un conector o en el cable
solo decide si vale la pena rearmarlo.

\subsection{Consecuencias para el radar}
\label{sub:cables_impacto}

\begin{figure}[H]
  \centering
  
  \caption{Lo que el cableado le cuesta al radar. Izquierda: offset de
    distancia $d_\text{offset} = D/(2\,\text{VF})$ con el VF $0{,}66$
    de catálogo, según el coaxil neto $D$, con los dos juegos de cables
    marcados. Derecha: pérdida de un par de cables (TX más RX) en el
    centro de la banda, $1462\,\text{MHz}$, en función del largo de
    cada uno, con la atenuación por metro medida en cada cable. La
    recta del RG-58 de $2{,}6\,\text{m}$ es la del cable dañado
    (Sección~\ref{sub:cables_defectuoso}), no la de un RG-58.}
  \label{fig:cables_impacto}
\end{figure}

Los dos costos se leen por separado. En \textbf{retardo}, cambiar los
RG-58 de $3$ y $2{,}6\,\text{m}$ por los dos RG-213 de $1\,\text{m}$
baja el offset de $4{,}20\,\text{m}$ a $1{,}48\,\text{m}$ con los
valores de catálogo, o de $3{,}86\,\text{m}$ a $1{,}45\,\text{m}$ con
los retardos medidos (Tabla~\ref{tab:cables_teoria_practica}). Sigue siendo
diez veces la resolución de $14{,}4\,\text{cm}$, así que \textbf{acortar
los cables no reemplaza a la calibración} de la
Sección~\ref{sec:cables_calibracion}: solo la vuelve una corrección más
chica. Lo único que anula el offset de raíz es emparejar el LO
(Tabla~\ref{tab:cables_nuevo_offset}).

En \textbf{atenuación}, el par original costaba $5{,}5\,\text{dB}$ a
$1{,}46\,\text{GHz}$ contra los $0{,}75\,\text{dB}$ del par nuevo. De
esos $4{,}7\,\text{dB}$ recuperados, sin embargo, solo una parte es
mérito del RG-213: dos RG-58 sanos de esos largos habrían costado
$3{,}6\,\text{dB}$, así que $1{,}9\,\text{dB}$ los estaba perdiendo el
cable de $2{,}6\,\text{m}$ en mal estado y se habrían recuperado con
solo reemplazarlo. La mitad de la mejora cae delante del
LNA, donde se descuenta uno a uno de la figura de ruido de toda la
cadena.

\subsection{Comparación teoría vs.\ práctica: tabla resumen}
\label{sub:cables_comparacion}

\begin{table}[H]
  \centering
  \caption{Resumen comparativo entre el valor teórico (predicho por las
    ecuaciones de este capítulo, a partir de las longitudes nominales
    y el $\text{VF}$ de catálogo) y el valor medido con el VNA a partir
    de la fase de $S_{21}$, para ambos juegos de cables.}
  \label{tab:cables_teoria_practica}
  \small\setlength{\tabcolsep}{3pt}
  \begin{tabular}{lcccc}
    \toprule
    & \multicolumn{2}{c}{\textbf{Juego original (2 RG-58)}}
    & \multicolumn{2}{c}{\textbf{Juego nuevo (2 RG-213)}} \\
    \cmidrule(lr){2-3}\cmidrule(lr){4-5}
    & Teoría & Medido & Teoría & Medido \\
    \midrule
    VF                                        & $0{,}66$\textsuperscript{*} & $0{,}70$ / $0{,}74$\textsuperscript{\dag} & $0{,}66$\textsuperscript{*} & $0{,}67$\textsuperscript{\dag} \\
    $\tau_\text{TX}+\tau_\text{RX}$ {[}ns{]}  & $28{,}3$ & $26{,}0$ & $10{,}1$ & $9{,}96$ \\
    $L_\text{TX}+L_\text{RX}$ {[}m{]}         & $5{,}60$ & $5{,}15$ & $2{,}00$ & $1{,}97$ \\
    $d_\text{offset}$ {[}m{]}\textsuperscript{\S} & $4{,}20$ & $\bm{3{,}86}$ & $1{,}48$ & $\bm{1{,}45}$ \\
    Pérdida del par @ $1{,}46\,\text{GHz}$ {[}dB{]} & $3{,}59$ & $5{,}47$\textsuperscript{\ddag} & $0{,}68$ & $0{,}75$ \\
    \bottomrule
  \end{tabular}

  \vspace{4pt}
  \begin{minipage}{0.92\linewidth}\footnotesize
    \textsuperscript{*}Valor nominal de catálogo
    (Tabla~\ref{tab:vf_cables}), que es el que se usa en todos los
    cálculos de diseño de este capítulo.

    \textsuperscript{\dag}Despejado del retardo de fase suponiendo el
    largo nominal de cada cable, que coincide aproximadamente con el
    medido con cinta; en el juego original, $3\,\text{m}$ y
    $2{,}6\,\text{m}$ por separado. Para diseño se sigue usando el
    nominal --- ver Sección~\ref{sub:cables_retardo_medido}.

    \textsuperscript{\ddag}Incluye el cable de $2{,}6\,\text{m}$ en mal
    estado (Sección~\ref{sub:cables_defectuoso}), que por sí solo
    aporta $3{,}56\,\text{dB}$ de los $5{,}47$. Dos RG-58 sanos de esos
    largos habrían costado $3{,}6\,\text{dB}$, extrapolando el $\alpha$
    medido del cable de $3\,\text{m}$.

    \textsuperscript{\S}El camino del LO es una conexión directa de
    $\approx 5\,\text{cm}$, que aporta $0{,}25\,\text{ns}$: se lo resta
    en las dos columnas, pero equivale a $3{,}8\,\text{cm}$ y no cambia
    ninguna conclusión. La columna ``medido'' no depende, entonces, de
    ningún valor supuesto.
  \end{minipage}
\end{table}

\textbf{El offset medido no depende de suponer nada}, y eso lo hace el
número más sólido de la tabla: sale de multiplicar el retardo de fase
por $c_0/2$, sin pasar por el factor de velocidad ni por el largo de
cinta métrica. En el juego nuevo da $1{,}45\,\text{m}$ contra
$1{,}48\,\text{m}$ de la ecuación~\eqref{eq:d_offset}, un $2$\,\% de
diferencia. En el original da $3{,}86\,\text{m}$ contra $4{,}20$, un
$8$\,\% menos.

El del juego original cierra además con una estimación completamente
independiente, hecha en el banco antes de tener el VNA: con
$T_c = 80\,\text{ms}$, una placa a $1\,\text{m}$ daba algo más de
$800\,\text{Hz}$, de donde el offset resultaba
$\approx 3{,}6\,\text{m}$. Tres caminos que no comparten ni el
instrumento ni el método ---la ecuación, el VNA y el propio radar---
caen dentro de un $15$\,\%, con los dos valores experimentales por
debajo del teórico y a un $7$\,\% entre sí.

La diferencia entre los dos juegos está en los cables, no en la
ecuación. Los RG-213 miden el VF de catálogo
(Tabla~\ref{tab:cables_retardo}), y con ellos teoría y medición
coinciden. Los RG-58 viejos miden más rápidos que el nominal, y el de
$2{,}6\,\text{m}$ bastante más, por el daño descripto en la
Sección~\ref{sub:cables_defectuoso}. Por eso con ese juego la teoría
queda alta. El largo no es la causa: medidos con cinta, los cables
tienen aproximadamente su largo nominal.

\subsection{Mediciones pendientes con el radar}
\label{sub:cables_pendiente}

Todo lo anterior caracteriza los cables solos, con el analizador de
redes. Faltan los dos pasos del procedimiento que miden su efecto sobre
el radar completo, y que requieren el banco armado con cada juego de
cables:

\begin{itemize}
  \item \textbf{Calibración de un punto con cada juego.} Repetir el
    procedimiento de la Sección~\ref{sec:cables_calibracion} con un
    blanco a distancia conocida, con los cables originales y con los
    nuevos, y comparar el $d_\text{offset}^\text{medido}$ contra la
    columna ``medido'' de la Tabla~\ref{tab:cables_teoria_practica}.
    Con dos puntos a distancias distintas, verificar además que la
    pendiente dé $\approx 1$.
  \item \textbf{Espectro de batido con el mismo blanco.} Con un blanco
    fijo a la misma distancia, capturar el espectro con cada juego de
    cables y reportar la posición del pico, su ancho a
    $-3\,\text{dB}$ y el piso de ruido.
\end{itemize}

En esa segunda comparación se superponen dos efectos que conviene no
confundir. Acortar el cable \textbf{corre el pico}, por el menor
retardo (Sección~\ref{sec:cables_offset}). Y al reducir la atenuación
\textbf{puede subir la relación señal a ruido}, por la menor pérdida
antes del LNA (Sección~\ref{sec:cables_perdidas}). El primero se lee en
el eje de frecuencia y el segundo en el de amplitud, así que la
comparación debe reportarlos por separado y no como un único número.
Con los valores medidos, se espera que el pico se corra unos
$2{,}4\,\text{m}$ de distancia aparente y que la señal suba del orden de
$4{,}7\,\text{dB}$, de los cuales $1{,}9$ se deben a haber sacado el
cable dañado.

% Plantilla para cuando esten las capturas (vivo_rapido.py, boton
% "guardar captura PNG"): mismo blanco y misma distancia, una con cada
% juego de cables.
% \begin{figure}[H]
%   \centering
%   \includegraphics[width=0.48\linewidth]{figuras/cables/espectro_cable_original.png}
%   \hfill
%   \includegraphics[width=0.48\linewidth]{figuras/cables/espectro_cable_nuevo.png}
%   \caption{Espectro de batido con el mismo blanco y la misma distancia.
%     Izquierda: cables originales. Derecha: cables nuevos.}
%   \label{fig:cables_espectro}
% \end{figure}

\section{Conclusiones del capítulo}
\label{sec:cables_conclusiones}

\begin{itemize}
  \item \textbf{Un radar FMCW mide diferencias de retardo, no
    distancias.} Los cables de antena se suman al retardo del blanco
    como un offset constante, $d_\text{offset} = D/(2\,\text{VF})$,
    que no cambia la pendiente ni la resolución. Es lo que explica el
    desvío observado en la prueba de validación.
  \item \textbf{El offset está medido sin suponer nada.} Con la fase
    de $S_{21}$ da $3{,}86\,\text{m}$ para el juego original y
    $1{,}45\,\text{m}$ para el nuevo, a menos de un $8$\,\% y un
    $2$\,\% del modelo con valores de catálogo.
  \item \textbf{Los cables nuevos mejoran las dos cosas a la vez.}
    Bajan el offset de $3{,}86$ a $1{,}45\,\text{m}$ y recuperan
    $4{,}7\,\text{dB}$ de pérdida, la mitad delante del LNA.
  \item \textbf{Acortar no alcanza para dejar de calibrar.} El offset
    de los cables nuevos sigue siendo diez veces la resolución. Hace
    falta un punto de calibración, o emparejar el camino del LO para
    anularlo de raíz.
  \item \textbf{El RG-58 de $2{,}6\,\text{m}$ está dañado} y no debe
    volver al banco. Solo ese cable explicaba $1{,}9\,\text{dB}$ de
    pérdida.
\end{itemize}

\input{procesamiento.tex}

%============================================================
%  APÉNDICES
%============================================================
\appendix

%============================================================
\chapter{Valores de componentes: series comerciales, tolerancias
  y combinaciones}
\label{ap:valores}
%============================================================

\textit{Este apéndice reúne, circuito por circuito, cómo se eligieron los
valores de resistencias y capacitores: qué serie comercial se usó, qué
tolerancia hace falta y por qué, y cómo se armaron los valores que no
existen en catálogo. Se irá completando a medida que se construyan las
demás etapas del instrumento.}

\section{Generador de triangular}
\label{sec:val_triangular}

El circuito del Capítulo~\ref{ch:triangular} se armó íntegramente con la
\textbf{serie E12} (los doce valores por década de las resistencias
comunes), en \textbf{película metálica al $1$\,\%}. Esta sección justifica
esa tolerancia y detalla las tres combinaciones en serie que hicieron falta.

\subsection{Por qué el $1$\,\%}
\label{sub:val_tolerancia}

Las tolerancias de los resistores se propagan a la salida por tres caminos
a la vez: la amplitud de la triangular depende de $R_3/R_2$, la referencia
de $R_5/(R_4+R_5)$, y la ganancia y el offset del restador de las cinco
resistencias que lo rodean. Para cuantificar el efecto conjunto se propagó
la tolerancia de \emph{cada resistencia física} ---las de las combinaciones
en serie por separado, que es como están en la placa--- por las ecuaciones
del circuito, sin intervención del operacional (script
\texttt{GPRv2/docs/PWM/simulacion/tolerancias.py}). Los resultados están en la
Tabla~\ref{tab:val_tolerancias}.

\begin{table}[H]
  \centering
  \caption{Rango que puede cubrir la salida del generador según la
  tolerancia de los resistores. El Monte Carlo (200\,000 muestras,
  distribución uniforme dentro de la banda) es lo que cabe esperar al armar
  placas; el peor caso recorre las $2^{12}$ esquinas y es la cota que no se
  puede superar. El valor nominal es $0{,}030$ a $3{,}094\,\text{V}$.}
  \label{tab:val_tolerancias}
  \begin{tabular}{lcc}
    \toprule
    & Tolerancia $5$\,\% & Tolerancia $1$\,\% \\
    \midrule
    Monte Carlo & $-0{,}57$ a $+3{,}67\,\text{V}$ & $-0{,}09$ a $+3{,}22\,\text{V}$ \\
    Peor caso   & $-0{,}78$ a $+3{,}88\,\text{V}$ & $-0{,}13$ a $+3{,}25\,\text{V}$ \\
    \midrule
    Placas con el extremo inferior bajo $0\,\text{V}$ & $43$\,\% & $19$\,\% \\
    \bottomrule
  \end{tabular}
\end{table}

Con resistores al $5$\,\% la salida puede llegar a $3{,}88\,\text{V}$ en el
peor caso, por encima de los $3{,}63\,\text{V}$ que tolera el VCO
(ecuación~\eqref{eq:tri_limite}): la protección del zener dejaría de ser un
seguro contra fallas para pasar a actuar en operación normal, recortando la
rampa. Al $1$\,\% el peor caso queda en $3{,}25\,\text{V}$, con margen
suficiente.

Obsérvese que en ninguna de las dos variantes se evita que el extremo
inferior caiga por debajo de $0\,\text{V}$ en una fracción apreciable de las
placas. Esto \emph{no} es un problema: la salida no puede ser negativa
porque el operacional no lo permite ---simplemente se apoya en el riel---, y
el efecto es un achatamiento de algunos milivoltios en el vértice inferior,
en una zona del rango del VCO que de todos modos no se usa. El extremo que
importa es el superior, y es el que la tolerancia del $1$\,\% protege.

La Tabla~\ref{tab:val_sensibilidad} muestra cuánto mueve el extremo superior
cada resistencia por separado. $R_9$ y $R_8$, las dos que fijan la ganancia
del restador, concentran el efecto: entre las dos explican más de la mitad
de la dispersión.

\begin{table}[H]
  \centering
  \caption{Desplazamiento del extremo superior de la salida por un error
  del $1$\,\% en cada resistencia, de a una por vez.}
  \label{tab:val_sensibilidad}
  \begin{tabular}{lcccccc}
    \toprule
    & $R_9$ & $R_8$ & $R_2$ & $R_3$ & $R_6$ & $R_7$ \\
    \midrule
    Desplazamiento & $34{,}6$ & $30{,}0$ & $15{,}5$ & $15{,}3$
      & $14{,}7$ & $14{,}5\,\text{mV}$ \\
    \midrule
    & $R_{10}$ & $R_4$ & $R_5$ & $R_{13}$ & $R_{14}$ & $R_{15}$ \\
    \midrule
    Desplazamiento & $8{,}6$ & $7{,}7$ & $7{,}7$ & $5{,}2$
      & $1{,}0$ & $0{,}1\,\text{mV}$ \\
    \bottomrule
  \end{tabular}
\end{table}

\subsection{Combinaciones en serie}
\label{sub:val_combinaciones}

Tres de los valores que pide el diseño no existen en la serie E12 y se
armaron sumando resistencias en serie. La Tabla~\ref{tab:val_combinaciones}
las lista con su desvío respecto del valor ideal; las tres quedan muy por
debajo de la tolerancia del $1$\,\% de los propios componentes, de modo que
la aproximación no agrega error apreciable.

\begin{table}[H]
  \centering
  \caption{Valores que no existen en la serie E12 y cómo se armaron.}
  \label{tab:val_combinaciones}
  \begin{tabular}{llccl}
    \toprule
    & Combinación & Resultado & Ideal & Desvío \\
    \midrule
    $R_9'$    & $R_9 + R_{13} = 100\text{k} + 15\text{k}$
              & $115\,\text{k}\Omega$ & $114{,}96\,\text{k}\Omega$ & $+0{,}04$\,\% \\
    $R_{10}'$ & $R_{10} + R_{14} + R_{15} = 680\text{k} + 82\text{k} + 6\text{k}8$
              & $768{,}8\,\text{k}\Omega$ & $768{,}5\,\text{k}\Omega$ & $+0{,}04$\,\% \\
    $R_{11}'$ & $R_{11} + R_{16} = 150\text{k} + 150\text{k}$
              & $300\,\text{k}\Omega$ & $300\,\text{k}\Omega$ & exacto \\
    \bottomrule
  \end{tabular}
\end{table}

Los dos primeros salen de imponer simultáneamente ganancia unitaria sobre
la triangular y el offset de la ecuación~\eqref{eq:tri_restador}, lo que
para $R_8 = 100\,\text{k}\Omega$ da

\begin{equation}
  R_{10}' = \frac{V_{cc}\,R_8}{V_\text{off}}, \qquad
  \frac{1}{R_9'} = \frac{1}{R_8} - \frac{1}{R_{10}'} .
  \label{eq:val_restador}
\end{equation}

El tercero, $R_{11}'$, es el brazo alto del divisor del sincronismo, y sale
de pedir que la cuadrada de $12\,\text{V}$ se reduzca a un cuarto sin
cargar apreciablemente al comparador.

\subsection{Capacitores}
\label{sub:val_capacitores}

$C_1$, el capacitor del integrador, es de $2{,}2\,\mu\text{F}$ de
\textbf{película metálica}. La razón es doble y está desarrollada en la
Sección~\ref{sub:tri_oscilador}: la tensión sobre él se invierte en cada
semiperíodo, lo que descarta un electrolítico polarizado; y la corriente de
carga baja hasta $55{,}5\,\mu\text{A}$ con el potenciómetro al máximo, del
mismo orden que la corriente de fuga de un electrolítico, que se sumaría a
la de carga y curvaría la rampa justo en la posición donde más importa.

El desacople es convencional: $C_2$ de $10\,\mu\text{F}$ electrolítico a la
entrada de alimentación, más $C_3$ y $C_4$ de $100\,\text{nF}$ cerámicos,
uno por cada integrado.

%============================================================
\chapter{La transformada chirp-Z (CZT) — trabajo futuro}
\label{ap:czt}
%============================================================

\textit{Este capítulo queda como apéndice de referencia teórica para
una etapa posterior de la tesis. Todavía no se implementó ni se
validó experimentalmente sobre el banco de pruebas: la separación de
reflexiones cercanas (espesor de capa) se está resolviendo por ahora
con la FFT estándar. Se deja documentado acá porque es la técnica que
se evaluará más adelante para mejorar esa resolución, no porque el
resto de la tesis dependa de ella.}

\section{Limitación de resolución del FFT}
\label{sec:limitacion_fft}

La resolución frecuencial de la DFT calculada sobre $N$ muestras a
frecuencia de muestreo $f_s$ es:

\begin{equation}
  \Delta f_\text{FFT} = \frac{f_s}{N}\quad[\text{Hz}].
  \label{eq:res_fft}
\end{equation}

En el sistema de referencia~\cite{Huang2022}: $f_s = 100\,\text{Hz}$,
$N = f_s \cdot T_c = 30$ muestras, lo que da:

\begin{equation*}
  \Delta f_\text{FFT} = \frac{100}{30} \approx 3{,}33\,\text{Hz/bin}.
\end{equation*}

Si la diferencia real entre los picos es $\Delta f = 4\,\text{Hz}$,
el FFT apenas puede distinguirla, con un error de espesor que puede
superar los $20\,\text{mm}$.

Aumentar $N$ exigiría una mayor frecuencia de muestreo (hardware más
costoso), sin beneficio real dado que las frecuencias IF son bajas
($< 60\,\text{Hz}$). La CZT es una alternativa para resolver este
problema sin modificar el hardware, a evaluar más adelante.

\section{Conceptos fundamentales de la CZT}
\label{sec:czt_teoria}

La transformada-Z de una secuencia $x[n]$ de longitud $N$, evaluada en
$M$ puntos dispuestos sobre un arco del plano complejo, es:

\begin{equation}
  X_\text{CZT}[k] = \sum_{n=0}^{N-1} x[n]\, z_k^{-n},
  \qquad k = 0, 1, \ldots, M-1,
  \label{eq:czt_def}
\end{equation}

con los puntos de evaluación:

\begin{equation}
  z_k = A_0\, W_0^{-k},
  \label{eq:zk}
\end{equation}

donde:

\begin{align}
  A_0 &= e^{\,j\,\omega_\text{start}} = e^{\,j\,2\pi f_\text{start}/f_s}, \label{eq:A0}\\
  W_0 &= e^{-j\,\Delta\omega} = e^{-j\,2\pi(f_\text{end}-f_\text{start})/(f_s(M-1))}. \label{eq:W0}
\end{align}

La resolución espectral resultante es:

\begin{equation}
  \Delta f_\text{CZT} = \frac{f_\text{end} - f_\text{start}}{M-1}\quad[\text{Hz}].
  \label{eq:res_czt}
\end{equation}

\subsection*{Caso especial: CZT $\equiv$ DFT}

Si $A_0 = 1$ y $W_0 = e^{-j2\pi/N}$, la CZT cubre el círculo unitario
completo con $N$ puntos igualmente espaciados y su resultado es
idéntico al DFT estándar. El FFT convencional es un caso particular
de la CZT.

\section{Tabla de parámetros CZT}
\label{sec:tabla_czt}

\begin{table}[H]
  \centering
  \caption{Parámetros de la CZT y su cálculo desde $f_\text{start}$,
  $f_\text{end}$ y $f_s$.}
  \label{tab:czt_params}
  \begin{tabular}{p{1.5cm}p{4.5cm}p{6cm}}
    \toprule
    \textbf{Símbolo} & \textbf{Significado} & \textbf{Cálculo} \\
    \midrule
    $A_0$ & Punto de inicio en el plano $z$
    & $A_0 = e^{\,j\,2\pi f_\text{start}/f_s}$ \\[4pt]
    $W_0$ & Paso entre muestras (módulo~1)
    & $W_0 = e^{-j\,2\pi(f_\text{end}-f_\text{start})/(f_s(M-1))}$ \\[4pt]
    $\Delta\omega$ & Paso angular
    & $\Delta\omega = 2\pi(f_\text{end}-f_\text{start})/(f_s(M-1))$ \\[4pt]
    $M$   & Número de puntos del zoom
    & Elegido por el usuario (potencia de~2 recomendada) \\[4pt]
    $k$   & Índice de salida
    & $k = 0, 1, \ldots, M-1$ \\
    \bottomrule
  \end{tabular}
\end{table}

\section{Implementación eficiente: algoritmo de Bluestein}
\label{sec:bluestein}

El cálculo directo de la ecuación~\eqref{eq:czt_def} tiene complejidad
$\mathcal{O}(N\cdot M)$. El algoritmo de Bluestein reduce esto a
$\mathcal{O}((N+M)\log(N+M))$ mediante la identidad algebraica:

\begin{equation}
  k\cdot n = \frac{n^2}{2} + \frac{k^2}{2} - \frac{(k-n)^2}{2},
\end{equation}

que convierte la suma del CZT en una convolución implementable con FFT.
Los pasos son los siguientes:

\begin{enumerate}
  \item \textbf{Pre-multiplicación:}
    $y[n] = x[n]\cdot A_0^{-n}\cdot W_0^{n^2/2}$.

  \item \textbf{Definición del filtro:}
    \begin{equation*}
      h[k] = W_0^{-k^2/2}, \quad k = 0,\ldots,M-1; \quad
      h[L-N+1\,\ldots\,L-1] = W_0^{-(N-k)^2/2}.
    \end{equation*}

  \item \textbf{Convolución vía FFT:}
    \begin{equation*}
      G = \text{IFFT}\!\bigl(\text{FFT}(y,L)\cdot\text{FFT}(h,L)\bigr),
    \end{equation*}
    donde $L$ es la potencia de 2 más próxima superior a $M+N-1$.

  \item \textbf{Post-multiplicación:}
    $X_\text{CZT}[k] = G[k]\cdot W_0^{k^2/2}$, \quad $k=0,\ldots,M-1$.

  \item \textbf{Eje de frecuencias:}
    \begin{equation}
      f[k] = f_\text{start} + k\cdot\frac{f_\text{end}-f_\text{start}}{M-1}.
      \label{eq:eje_f}
    \end{equation}
\end{enumerate}

\subsection{Ejemplo numérico}
\label{sub:ejemplo_czt}

$N = 30$ muestras, $f_s = 100\,\text{Hz}$, zoom: $f_\text{start}=3\,\text{Hz}$,
$f_\text{end}=15\,\text{Hz}$, $M=512$ puntos.

\begin{table}[H]
  \centering
  \caption{Cálculo de los parámetros CZT para el ejemplo de referencia.}
  \label{tab:ejemplo_czt}
  \begin{tabular}{ll}
    \toprule
    \textbf{Cálculo} & \textbf{Resultado} \\
    \midrule
    $\omega_\text{start}$ & $2\pi\times3/100 = 0{,}18850\,\text{rad}$ \\
    $\omega_\text{end}$   & $2\pi\times15/100 = 0{,}94248\,\text{rad}$ \\
    $\Delta\omega$         & $(0{,}94248-0{,}18850)/511 = 0{,}001476\,\text{rad/muestra}$ \\
    $\Delta f_\text{CZT}$ & $(15-3)/511 \approx 0{,}0235\,\text{Hz/bin}$ \\
    $\Delta f_\text{FFT}$ & $100/30 \approx 3{,}33\,\text{Hz/bin}$ (142$\times$ peor) \\
    $A_0$                 & $\cos(0{,}18850)+j\sin(0{,}18850)$ \\
    $W_0$                 & $e^{-j\,0{,}001476}$ \\
    $L$                   & $2^{\lceil\log_2(512+30-1)\rceil} = 2^{10} = 1024$ \\
    \bottomrule
  \end{tabular}
\end{table}

\section{Guía de selección de parámetros}
\label{sec:guia_params}

\subsection{Rango de zoom [$f_\text{start}$, $f_\text{end}$]}

\begin{enumerate}
  \item Calcular el FFT completo para identificar la región de interés.
  \item Estimar el rango esperado de $\Delta f$ con la inversa de la
    ecuación~\eqref{eq:espesor}:
    \begin{equation}
      \Delta f_\text{max} = \frac{4\sqrt{\varepsilon_r}\,B\,h_\text{max}}{T_c\,c},
      \quad
      \Delta f_\text{min} = \frac{4\sqrt{\varepsilon_r}\,B\,h_\text{min}}{T_c\,c}.
    \end{equation}
  \item Agregar un margen del 30–50\% a cada lado.
\end{enumerate}

\subsection{Número de puntos $M$}

\begin{table}[H]
  \centering
  \caption{Resolución CZT para distintos valores de $M$ (rango de
  zoom de 12\,Hz).}
  \label{tab:M_resolucion}
  \begin{tabular}{ccl}
    \toprule
    $M$ & $\Delta f_\text{CZT}$ & \textbf{Uso recomendado} \\
    \midrule
    128  & $\approx 0{,}094\,\text{Hz}$ & Exploración rápida, capas gruesas ($>15\,\text{cm}$) \\
    512  & $\approx 0{,}024\,\text{Hz}$ & Balance calidad/velocidad, uso general \\
    2048 & $\approx 0{,}006\,\text{Hz}$ & Alta precisión, capas delgadas ($<5\,\text{cm}$) \\
    8192 & $\approx 0{,}0015\,\text{Hz}$ & Máxima resolución, verificación crítica \\
    \bottomrule
  \end{tabular}
\end{table}

\textit{Regla práctica:} $\Delta f_\text{CZT} < \Delta f_\text{real}/5$.

\section{Flujo completo del algoritmo (a futuro)}
\label{sec:flujo_czt}

\begin{table}[H]
  \centering
  \caption{Resumen del flujo de procesamiento GPR FMCW con CZT, propuesto para cuando se implemente.}
  \label{tab:flujo}
  \begin{tabular}{clp{7cm}}
    \toprule
    \textbf{\#} & \textbf{Etapa} & \textbf{Descripción} \\
    \midrule
    1 & Emisión del chirp
    & El radar barre de $f_c - B/2$ a $f_c + B/2$ en tiempo $T_c/2$
    (media triangular). \\
    2 & Reflexiones
    & $R_1$ y $R_2$ llegan con retardos $\tau_1$, $\tau_2$. \\
    3 & Mezcla (\textit{mixer})
    & $s_\text{tx}\times s_\text{rx}$ + LPF $\rightarrow$ señal IF con
    $f_1 = S\tau_1$ y $f_2 = S\tau_2$. \\
    4 & Muestreo IF
    & Se digitaliza la señal IF con $N$ muestras a $f_s\,\text{Hz}$. \\
    5 & FFT (referencia)
    & Espectro de baja resolución; puede no separar $f_1$ de $f_2$. \\
    6 & Definir zoom CZT
    & Elegir $[f_\text{start}, f_\text{end}]$ y $M$. \\
    7 & Calcular $A_0$, $W_0$, $\Delta\omega$
    & Ec.~\eqref{eq:A0}--\eqref{eq:W0}. \\
    8 & Bluestein
    & Pre-mult. $\to$ convolución FFT $\to$ post-mult. $\to$ magnitud. \\
    9 & Detección de picos
    & Identificar $f_1$ y $f_2$ en el espectro CZT. \\
    10 & Calcular espesor
    & $\Delta f = f_2 - f_1$ $\rightarrow$ ec.~\eqref{eq:espesor}. \\
    \bottomrule
  \end{tabular}
\end{table}

%============================================================
%  BIBLIOGRAFÍA
%============================================================
\printbibliography[heading=bibintoc, title={Referencias}]

\end{document}
