maledesm/gpr/redaccion/plan_tpp/plan_tpp.tex

%============================================================
%  PLAN DE TRABAJO PROFESIONAL DE INGENIERÍA ELECTRÓNICA
%  Radar FMCW de 1 a 2 GHz (GPR) — Martín y Santiago
%
%  Esqueleto para escribir a mano. Cada sección tiene un
%  \cartel{tipo de texto}{de qué tiene que tratar}: un recuadro rojo
%  que se reemplaza por el texto. Los datos sueltos que faltan están
%  marcados con \pendiente{...}. Antes de presentarlo: buscar
%  "\cartel" y "\pendiente" y no tiene que quedar ninguno.
%
%  Compilar con compilar.bat (pdflatex + biber + pdflatex x2).
%============================================================

\documentclass[11pt, a4paper, oneside]{article}

%------------------------------------------------------------
% PAQUETES
%------------------------------------------------------------
\usepackage[utf8]{inputenc}
\usepackage[T1]{fontenc}
\usepackage[spanish, es-tabla, es-noshorthands]{babel}
\usepackage{lmodern}
\usepackage{microtype}

% Márgenes amplios y aire entre líneas
\usepackage[
  top=3.0cm, bottom=3.0cm,
  left=3.0cm, right=2.5cm,
  headheight=14pt, headsep=1.0cm, footskip=1.4cm
]{geometry}
\linespread{1.2}
\setlength{\parindent}{0pt}
\setlength{\parskip}{0.7em}

\usepackage{amsmath}
\usepackage[table]{xcolor}
\usepackage{graphicx}
\usepackage{adjustbox}
\usepackage{booktabs}
\usepackage{tabularx}
\usepackage{array}
\usepackage{caption}
\captionsetup{font=small, labelfont=bf, margin=0.5cm}
\usepackage{enumitem}
\setlist{itemsep=0.35em, topsep=0.4em, parsep=0pt}
\setlist[itemize]{leftmargin=1.6em}
\setlist[enumerate]{leftmargin=1.8em}
\usepackage{tikz}
\usetikzlibrary{arrows.meta, positioning, calc, babel}

% Celeste institucional de FIUBA
\definecolor{fiuba}{RGB}{0,162,227}

% Títulos de sección: número con punto, en celeste, con aire
\usepackage{titlesec}
\titleformat{\section}{\Large\bfseries}{\textcolor{fiuba}{\thesection.}}{0.6em}{}
\titleformat{\subsection}{\large\bfseries}{\textcolor{fiuba}{\thesubsection.}}{0.6em}{}
\titleformat{\subsubsection}{\normalsize\bfseries}{\thesubsubsection.}{0.6em}{}
\titlespacing*{\section}{0pt}{2.4em}{1.0em}
\titlespacing*{\subsection}{0pt}{1.8em}{0.6em}
\titlespacing*{\subsubsection}{0pt}{1.4em}{0.4em}

% Encabezado con el nombre de la sección y pie con el número de página
\usepackage{fancyhdr}
\pagestyle{fancy}
\fancyhf{}
\fancyhead[L]{\small\textcolor{black!60}{Plan de Trabajo Profesional}}
\fancyhead[R]{\small\nouppercase{\seccionactual}}
\fancyfoot[C]{\small\thepage}
\renewcommand{\headrulewidth}{0.4pt}
\renewcommand{\sectionmark}[1]{\markboth{\thesection.\ #1}{}}
% La sección vigente al principio de la página; si no hay ninguna
% (la primera), la que arranca en ella
\makeatletter
\newcommand{\seccionactual}{%
  \protected@edef\@seccionarriba{\TopMark{2e-left}}%
  \ifx\@seccionarriba\@empty\FirstMark{2e-left}\else\@seccionarriba\fi}
\makeatother

% Carátula: solo la línea del pie con el tipo de documento
\fancypagestyle{caratula}{%
  \fancyhf{}%
  \renewcommand{\headrulewidth}{0pt}%
  \renewcommand{\footrulewidth}{0.4pt}%
  \fancyfoot[L]{\small Plan de Trabajo Profesional de Ingeniería Electrónica}%
}

\usepackage[
  colorlinks=true,
  linkcolor=black,
  citecolor=fiuba!70!black,
  urlcolor=fiuba!70!black
]{hyperref}

\usepackage{csquotes}
\usepackage[backend=biber, style=ieee, sorting=none]{biblatex}
\addbibresource{referencias_plan.bib}
\AtBeginBibliography{\small\linespread{1.1}\selectfont\setlength{\parskip}{0pt}}
\setlength{\bibitemsep}{0.45em}

%------------------------------------------------------------
% COMANDOS PROPIOS
%------------------------------------------------------------
% Lo que falta completar: en rojo, para que no se escape
\newcommand{\pendiente}[1]{\textcolor{red!75!black}{[#1]}}
% Recuadro rojo con el tipo de texto que va en ese lugar y de qué trata
\usepackage[most]{tcolorbox}
\newtcolorbox{cartelbox}[1]{
  enhanced, breakable,
  colback=red!3, colframe=red!65!black, colbacktitle=red!65!black,
  coltitle=white, fonttitle=\small\bfseries,
  title={A completar: #1},
  fontupper=\small\color{red!40!black},
  boxrule=0.6pt, arc=2pt,
  left=8pt, right=8pt, top=5pt, bottom=6pt,
  before skip=0.5em, after skip=0.9em
}
\newcommand{\cartel}[2]{\begin{cartelbox}{#1}#2\end{cartelbox}}
% Sigla con su significado al pie, la primera vez que aparece
\newcommand{\sigla}[2]{#1\footnote{#2.}}

%------------------------------------------------------------
% DATOS DEL TRABAJO
%------------------------------------------------------------
\newcommand{\Titulo}{Desarrollo y caracterización de un radar FMCW
de 1 a 2~GHz para sensado a través de medios opacos}

%============================================================
\begin{document}

%============================================================
%  CARÁTULA
%============================================================
\begin{titlepage}
  \thispagestyle{caratula}
  \centering
  \vspace*{-0.5cm}

  \adjincludegraphics[width=0.62\textwidth, trim={{.105\width} {.33\height} {.10\width} {.34\height}}, clip]{figuras/logo_fiuba.png}

  \vspace{0.9cm}
  {\large\textsc{Universidad de Buenos Aires}}\\[0.15cm]
  {\large\textsc{Facultad de Ingeniería}}\\[0.15cm]
  {\small Año 2026}

  \vspace{1.6cm}
  {\large\bfseries PLAN DE TRABAJO PROFESIONAL DE INGENIERÍA ELECTRÓNICA}

  \vspace{2.2cm}
  {\Large\linespread{1.35}\selectfont \MakeUppercase{\Titulo}\par}

  \vfill

  {\small\bfseries INTEGRANTES:}\\[0.35cm]
  Ledesma, Martín\\
  Padrón: 108068\\
  \href{mailto:maledesma@fi.uba.ar}{maledesma@fi.uba.ar}\\[0.45cm]
  Mogica, Santiago\\
  Padrón: 109026\\
  \href{mailto:smogica@fi.uba.ar}{smogica@fi.uba.ar}

  \vspace{0.9cm}
  {\small\bfseries DIRECTOR:}\\[0.35cm]
  Dr. Ing. Fano, Walter Gustavo\\
  \href{mailto:gfano@fi.uba.ar}{gfano@fi.uba.ar}

  % Si hay codirector, descomentar:
  % \vspace{0.9cm}
  % {\small\bfseries CODIRECTOR:}\\[0.35cm]
  % Apellido, Nombre\\
  % mail

  \vspace{1.2cm}
\end{titlepage}

%============================================================
%  ÍNDICE
%============================================================
\setcounter{page}{2}
{\setlength{\parskip}{0.25em}\tableofcontents}
\markboth{}{}
\clearpage

%============================================================
\section{Objeto y área del Trabajo Profesional}
%============================================================

En el presente Trabajo Profesional se completará y validará un radar de
penetración terrestre (\sigla{GPR}{\textit{Ground Penetrating Radar},
radar de penetración terrestre}) de onda continua modulada en
frecuencia (\sigla{FMCW}{\textit{Frequency Modulated Continuous Wave},
onda continua modulada en frecuencia}), tomando como punto de partida
el prototipo desarrollado por Joaquín Raña en su tesis de grado
\cite{Rana2026}. El trabajo se concentrará en completar el sistema,
corregir sus no idealidades y evaluar experimentalmente en qué
aplicaciones resulta útil.

\subsection{Objetivo general}

Desarrollar un radar GPR FMCW funcional y autónomo a partir del
prototipo existente, y evaluar experimentalmente su desempeño como
radar de distancia, como GPR y, de no resultar viable, en otras
aplicaciones de sensado a través de medios opacos.

\subsection{Objetivos particulares}

\begin{itemize}
  \item Caracterizar los componentes de la cadena de radiofrecuencia e
        identificar los fenómenos físicos que degradan la medición.
  \item Diseñar e implementar subsistemas que compensen dichos
        fenómenos.
  \item Diseñar e implementar la digitalización de la señal de batido y
        su firmware.
  \item Desarrollar el software de adquisición, procesamiento y
        visualización de la señal.
  \item Modelar y simular los escenarios de ensayo, a fin de contrastar
        las hipótesis formuladas sobre los fenómenos que degradan la
        medición.
  \item Desarrollar los subsistemas que permitan operar el radar de
        forma autónoma, sin depender del instrumental de laboratorio.
  \item Evaluar experimentalmente el alcance, la resolución y la
        capacidad de detección del sistema.
\end{itemize}

\subsection{Área del Trabajo Profesional}
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
