maledesm/gpr/redaccion/figuras/software/bloques_vivo_rapido.pdf

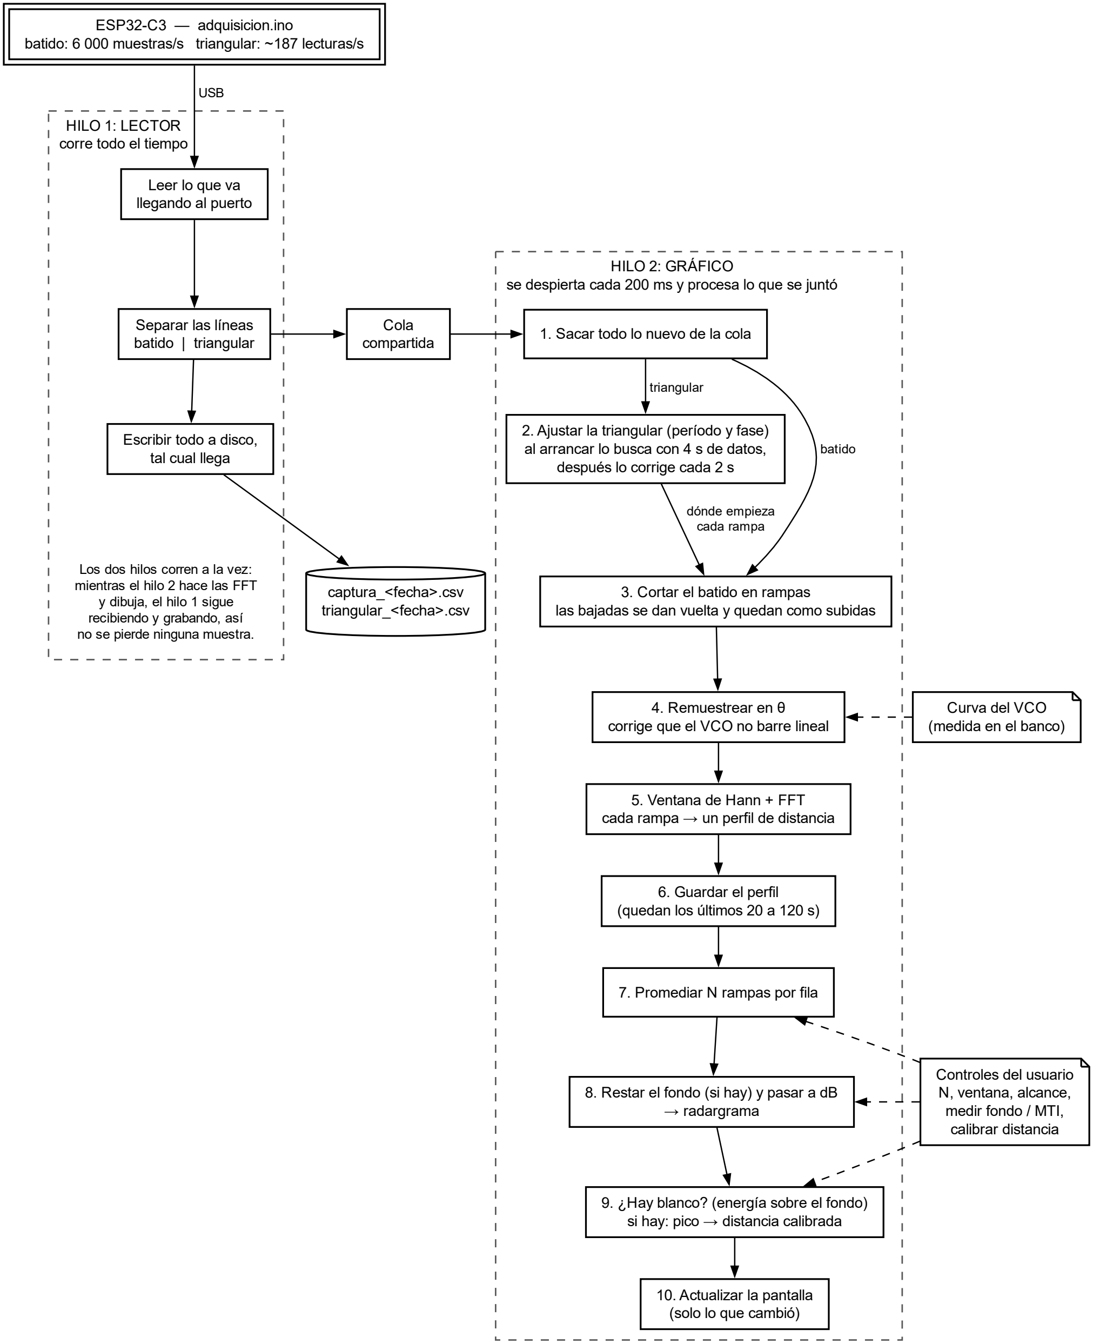
[picture p45: figure]
HILO 1: LECTOR corre todo el tiempo; HILO 2: GRÁFICO; ESP32-C3 — adquisicion.ino; Leer lo que va llegando al puerto; USB; Separar las líneas batido | triangular; Escribir todo a disco, tal cual llega; Cola compartida; Los dos hilos corren a la vez: mientras el hilo 2 hace las FFT y dibuja, el hilo 1 sigue recibiendo y grabando, así no se pierde ninguna muestra.; captura_<fecha>.csv triangular_<fecha>.csv; 1. Sacar todo lo nuevo de la cola; al arrancar lo busca con 4 s de datos, después lo
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
