maledesm/gpr/docs/mixer_iq.png

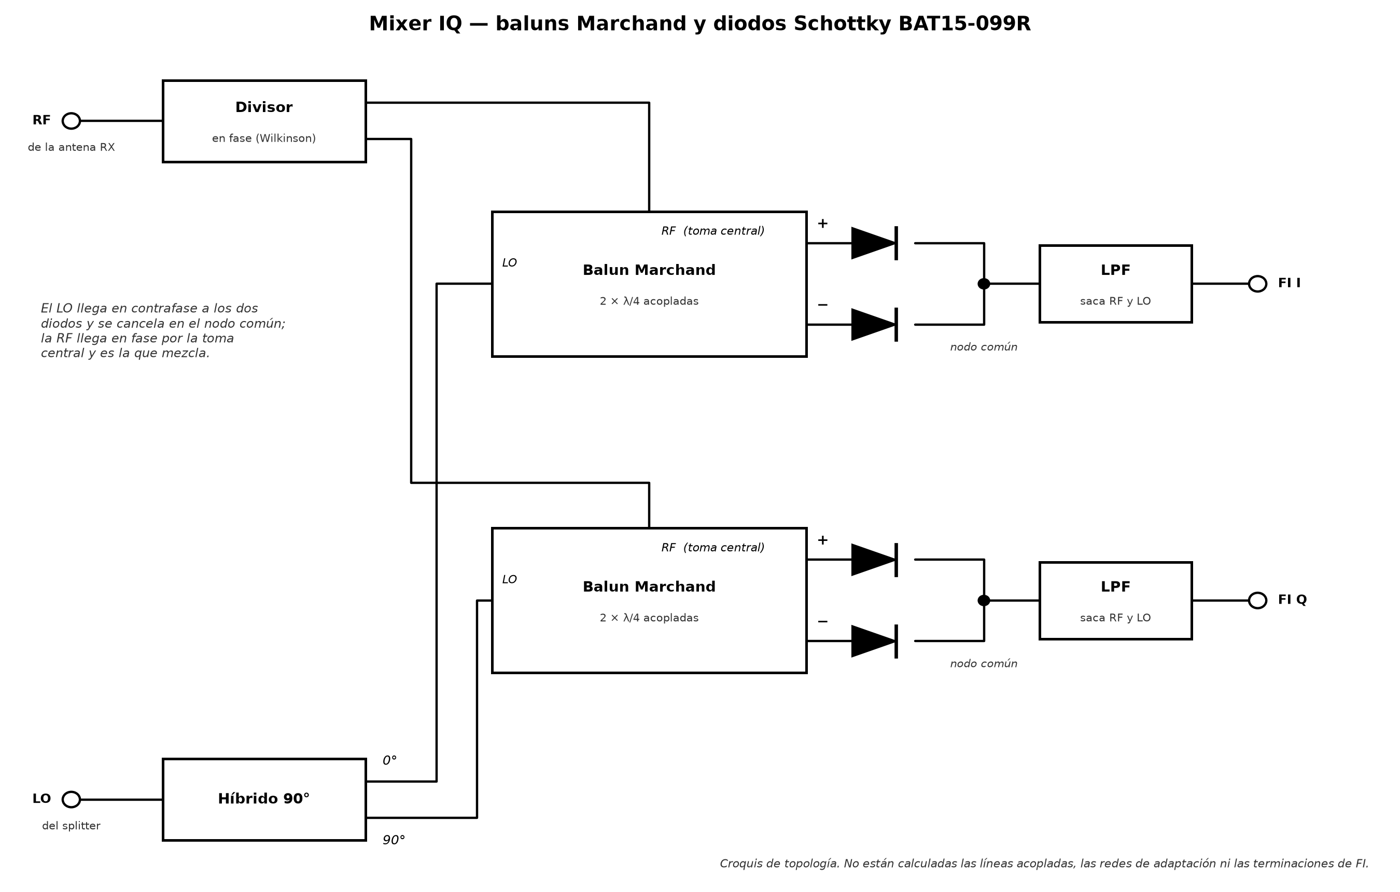
docs/mixer_iq.png
