maledesm/gpr/GPRv2/analisis/relleno_y_parabola.png

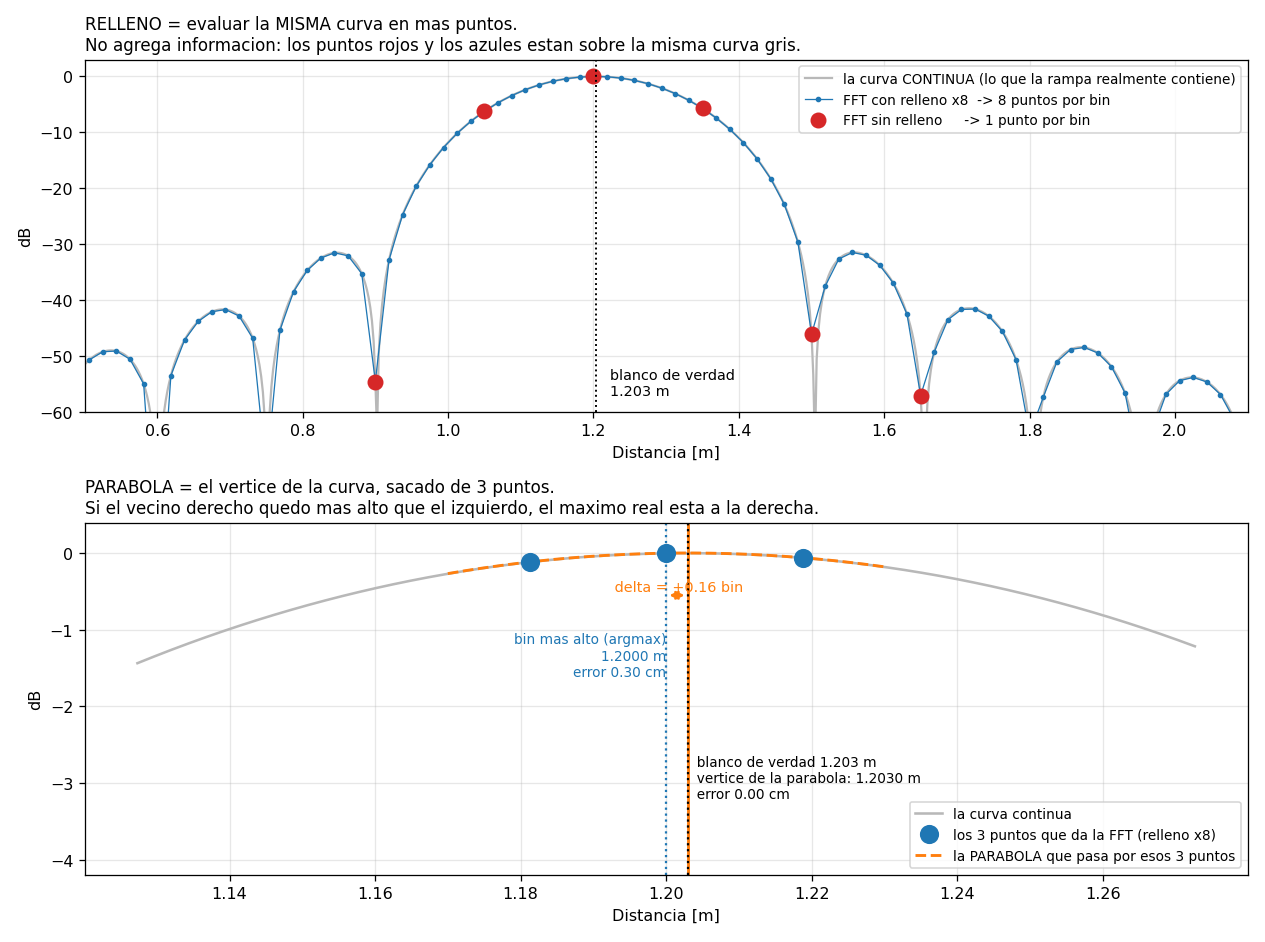
GPRv2/analisis/relleno_y_parabola.png
