maledesm/gpr/GPRv2/datos/capturas/captura_1m_cf.png

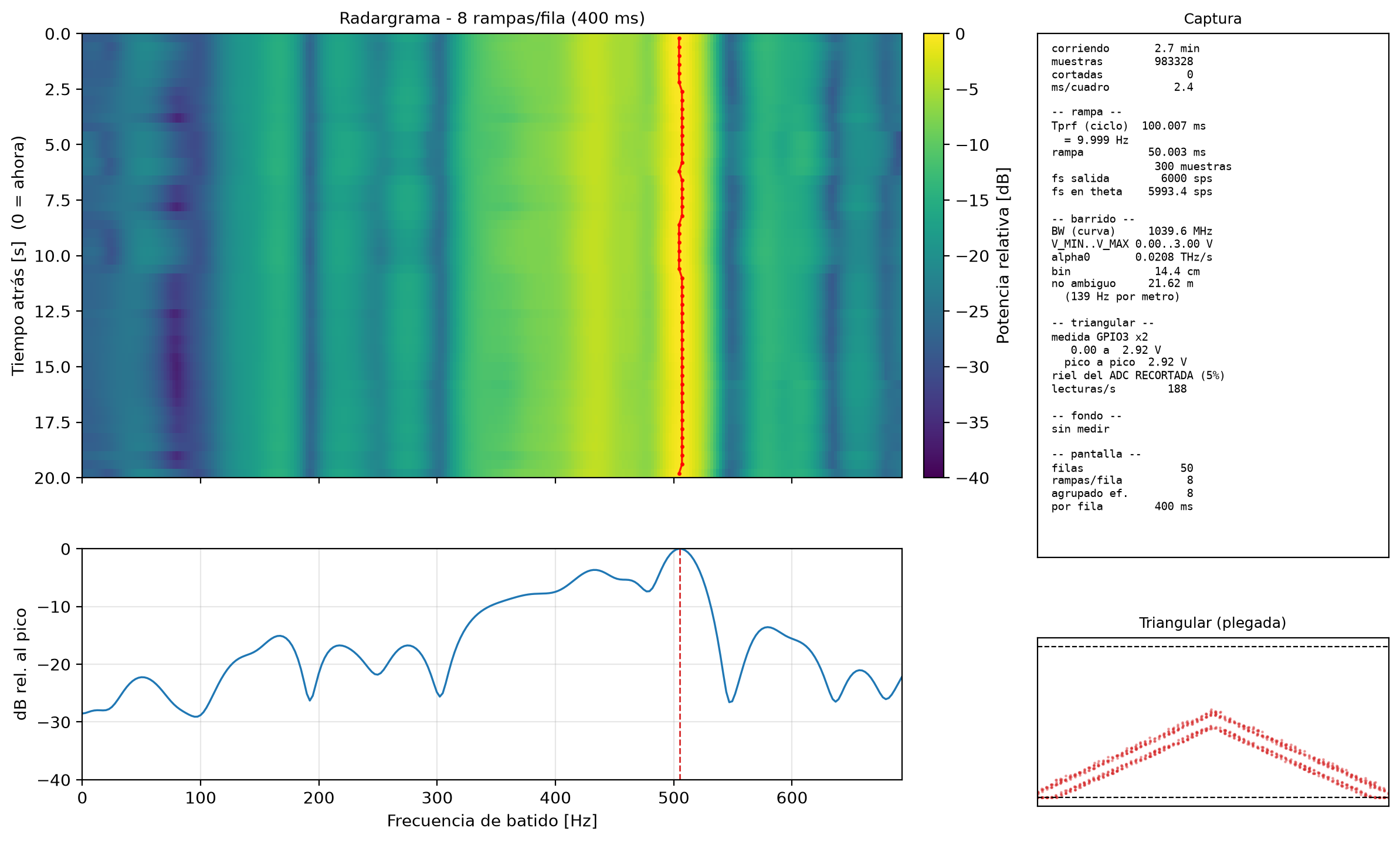
GPRv2/datos/capturas/captura_1m_cf.png
