maledesm/gpr/GPRv2/datos/capturas/captura_1m_fondo.png

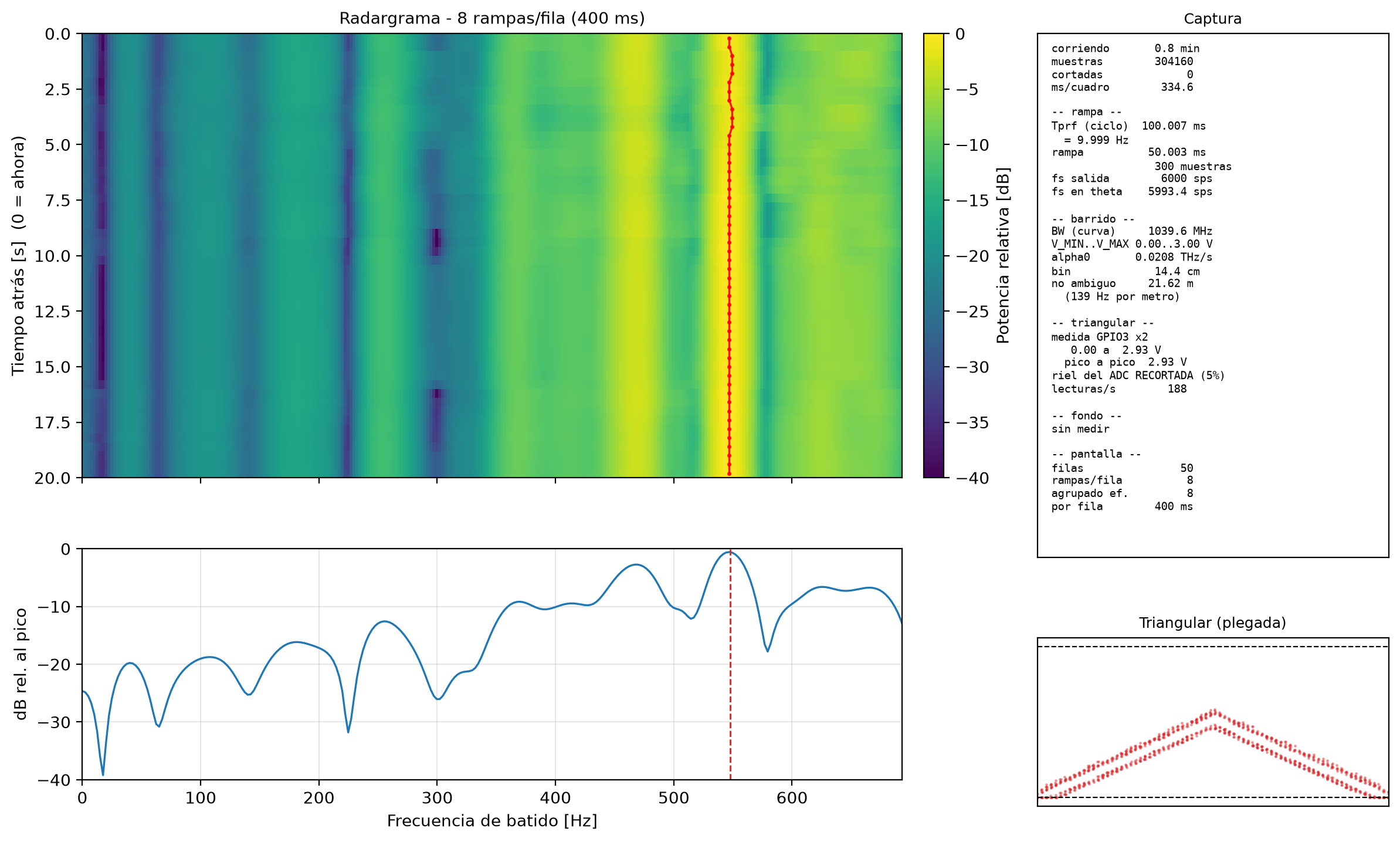
GPRv2/datos/capturas/captura_1m_fondo.png
