maledesm/gpr/GPRv2/datos/capturas/captura_1m_sf.png

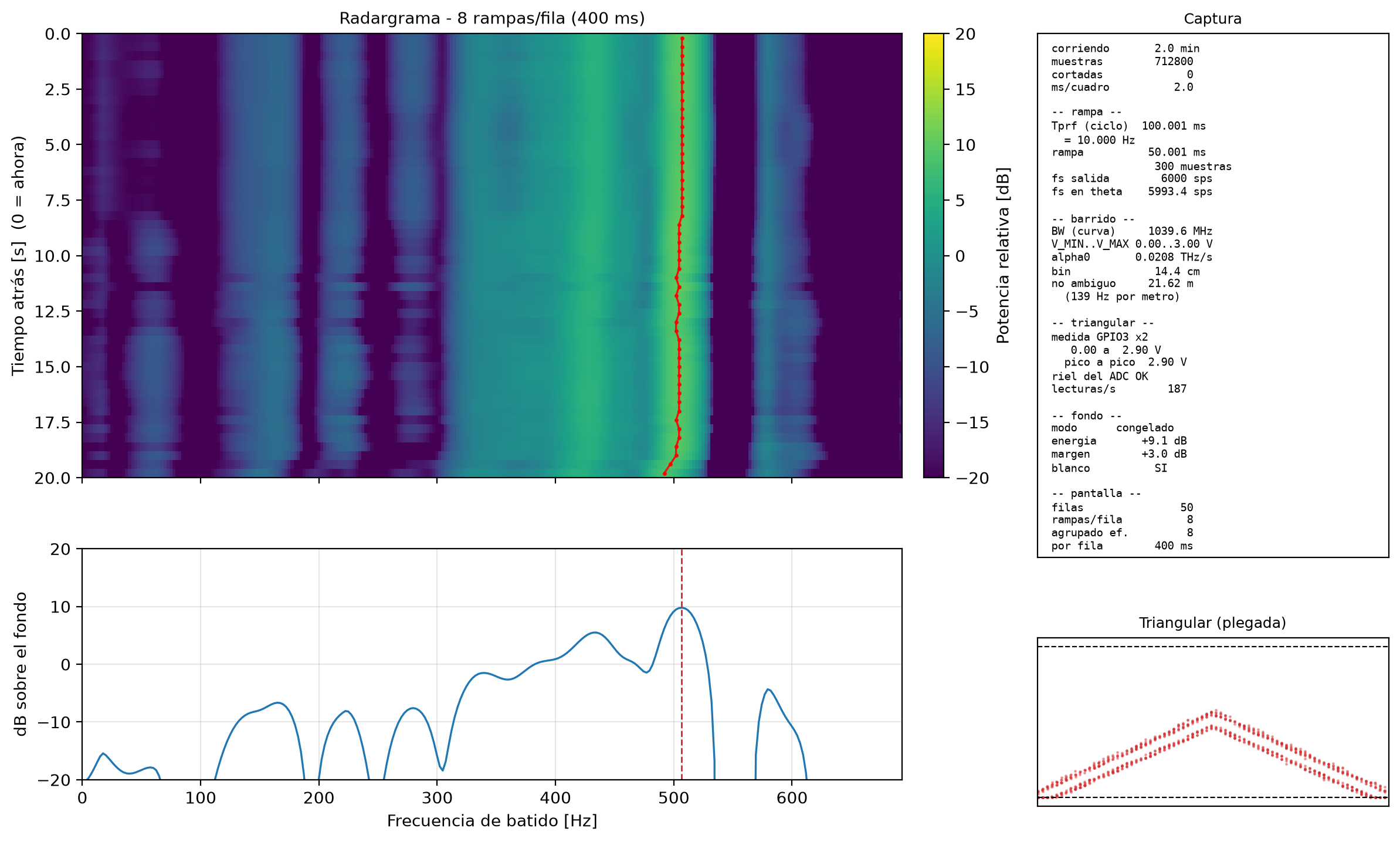
GPRv2/datos/capturas/captura_1m_sf.png
