maledesm/gpr/GPRv2/datos/capturas/captura_3m_cf.png

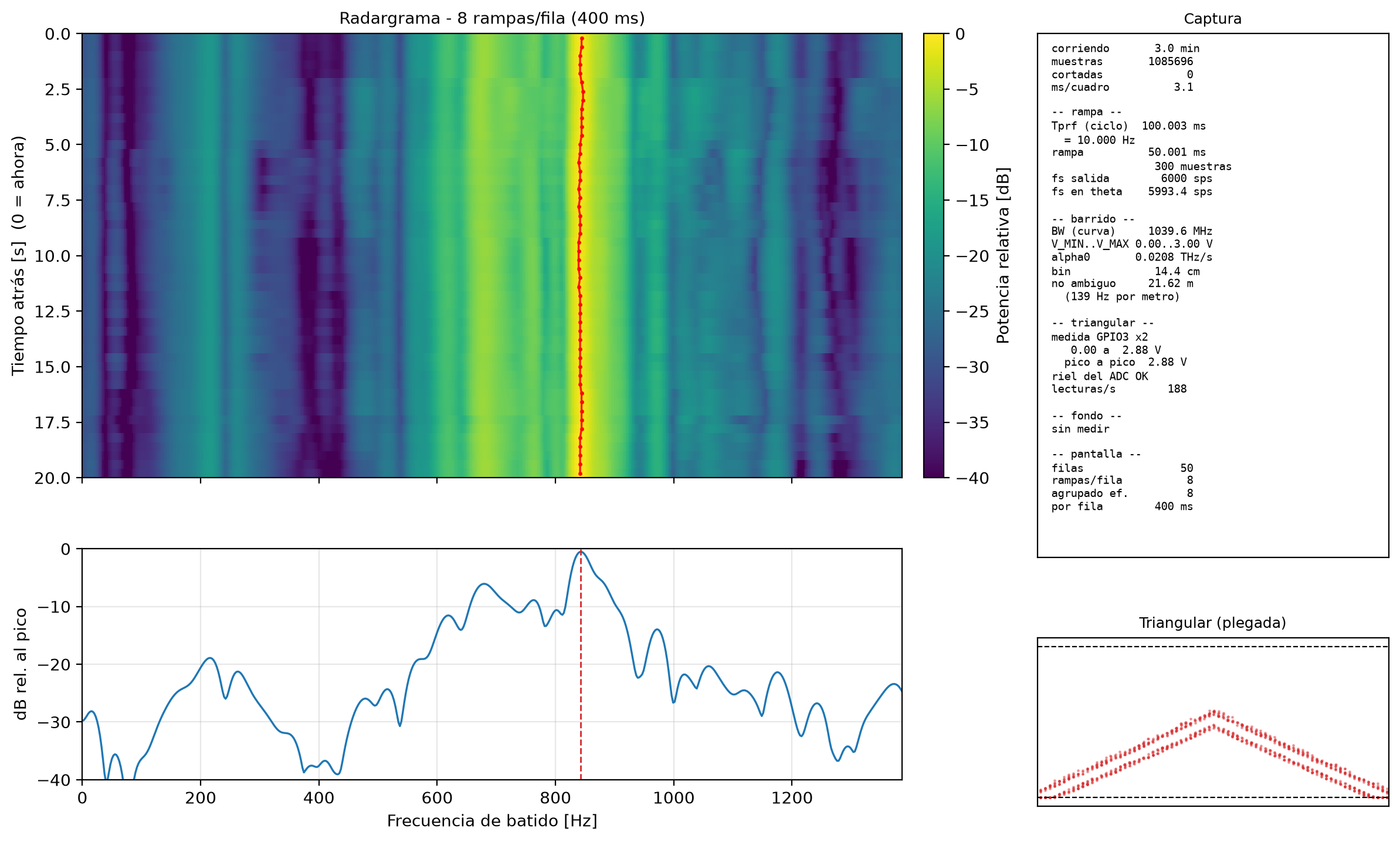
GPRv2/datos/capturas/captura_3m_cf.png
