maledesm/gpr/GPRv2/datos/capturas/captura_3m_sf.png

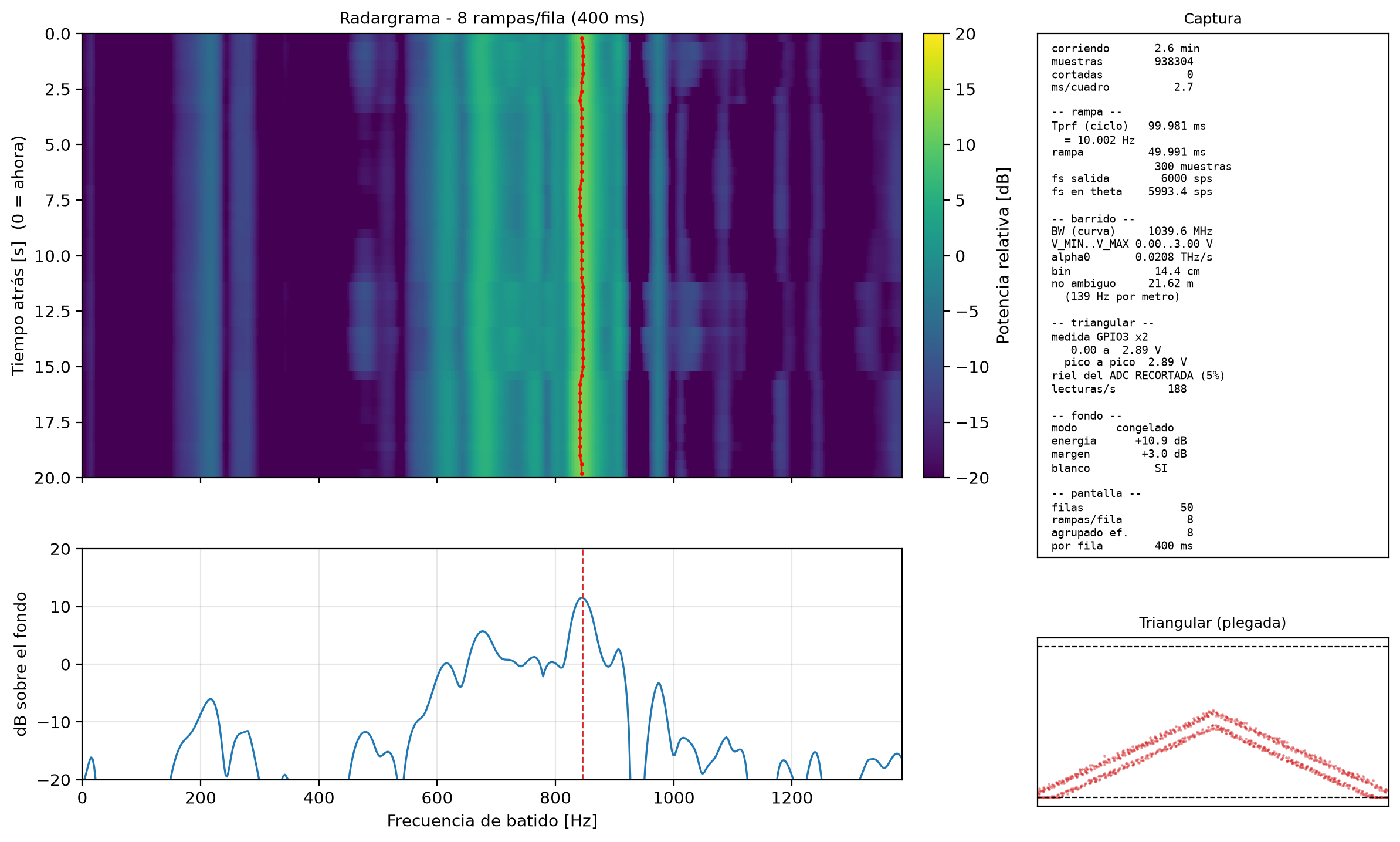
GPRv2/datos/capturas/captura_3m_sf.png
