maledesm/gpr/GPRv2/datos/capturas/placa_70cm_cf.png

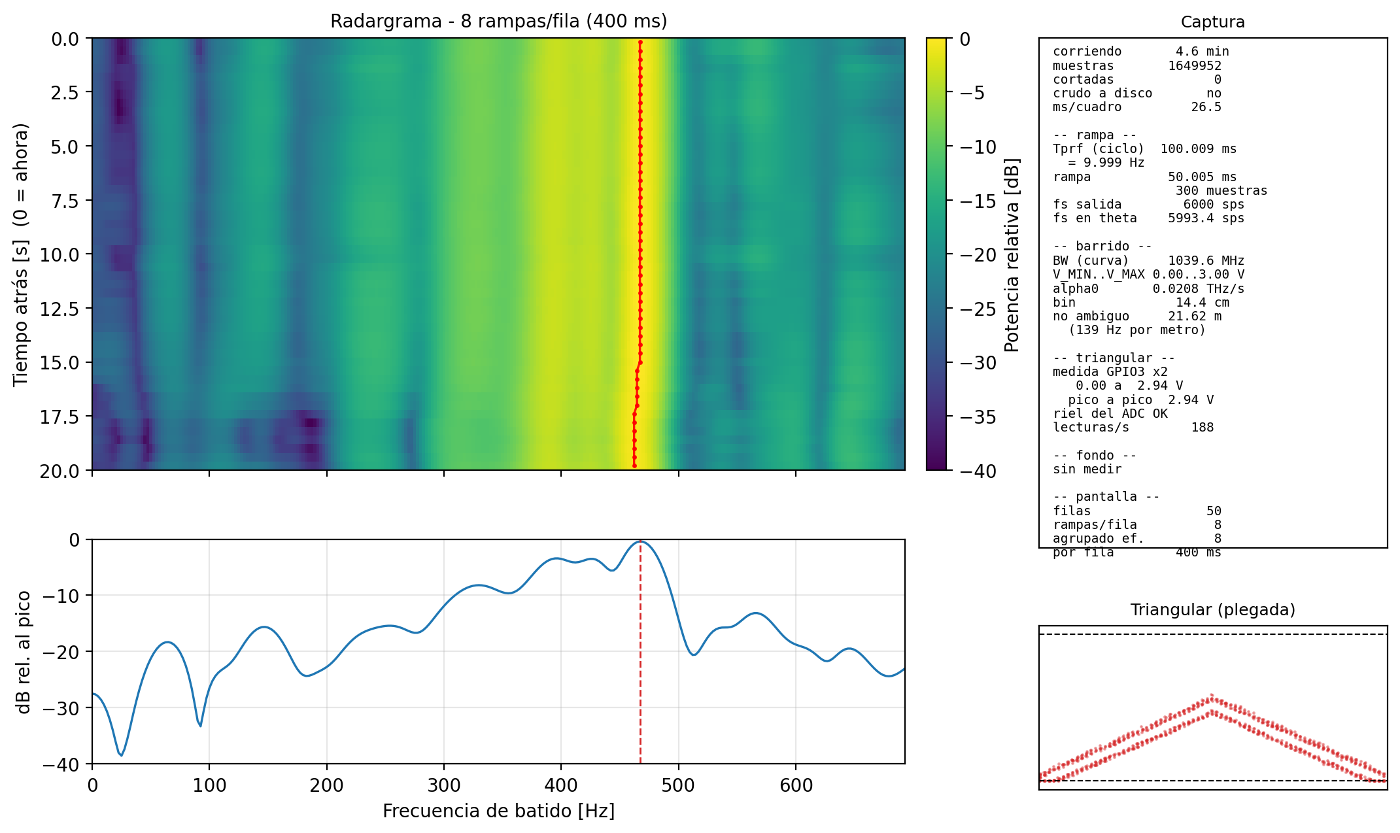
GPRv2/datos/capturas/placa_70cm_cf.png
