maledesm/gpr/GPRv2/datos/capturas/placa_70cm_sf.png

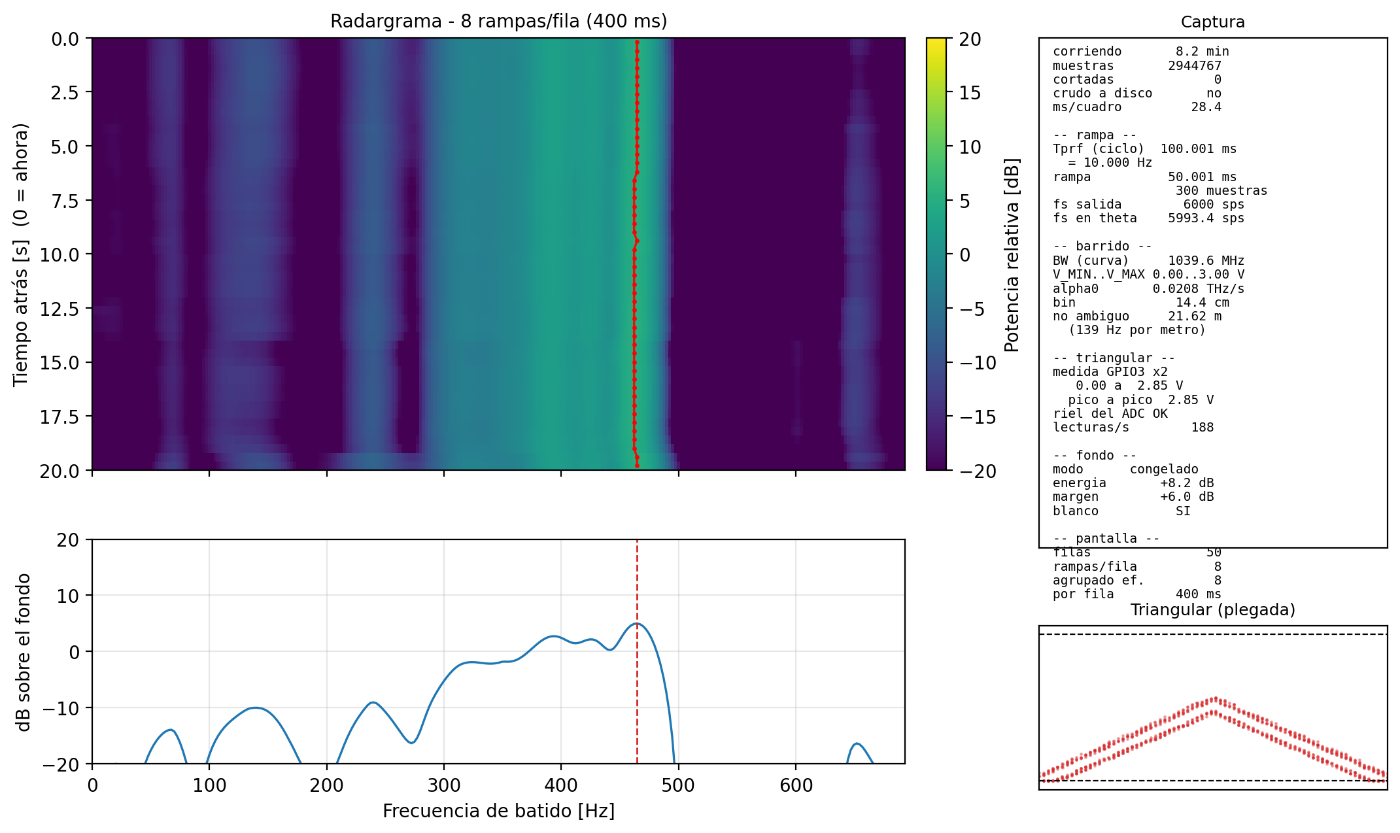
GPRv2/datos/capturas/placa_70cm_sf.png
