maledesm/gpr/GPRv2/datos/capturas/placa_80cm_sf.png

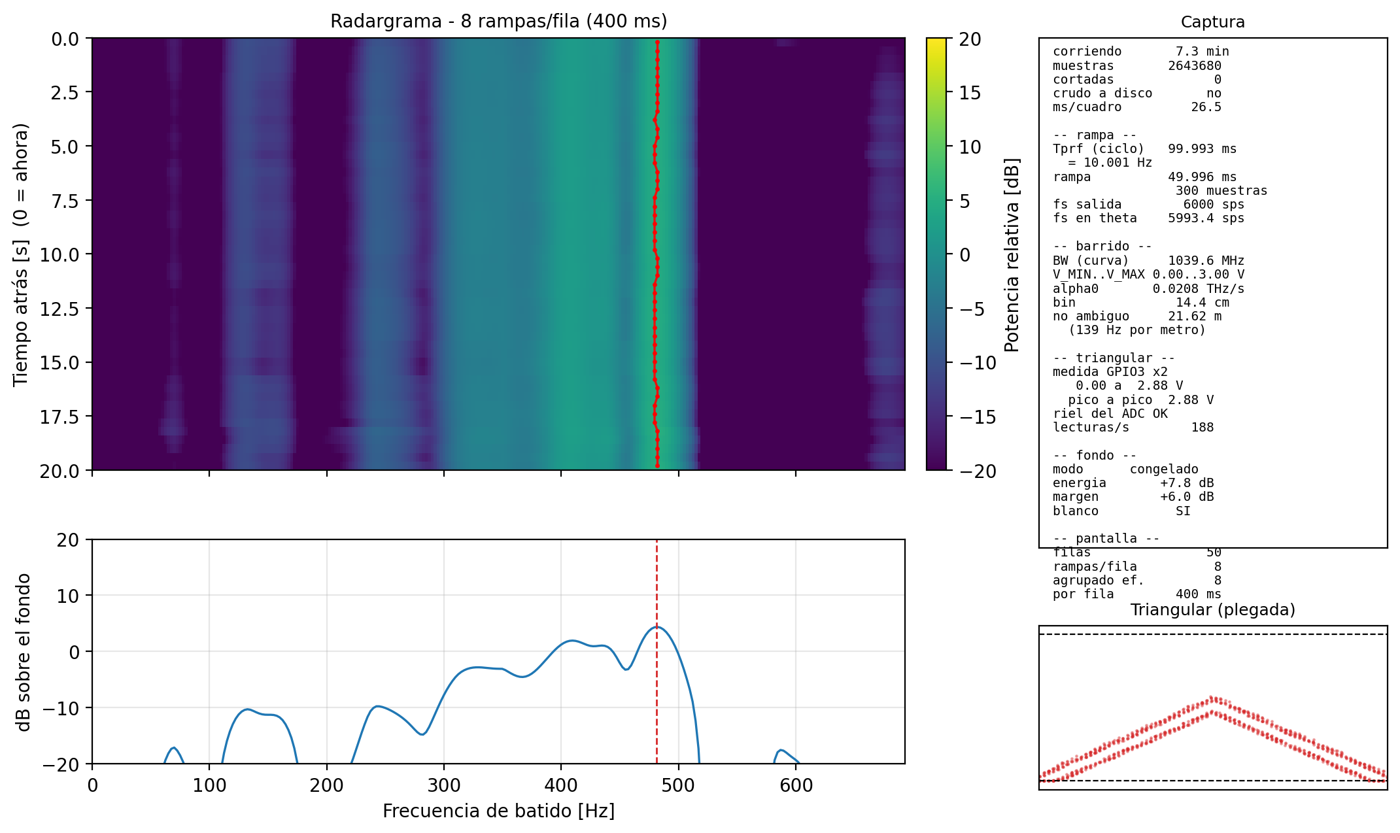
GPRv2/datos/capturas/placa_80cm_sf.png
