maledesm/gpr/GPRv2/datos/capturas/placa_100cm_cf.png

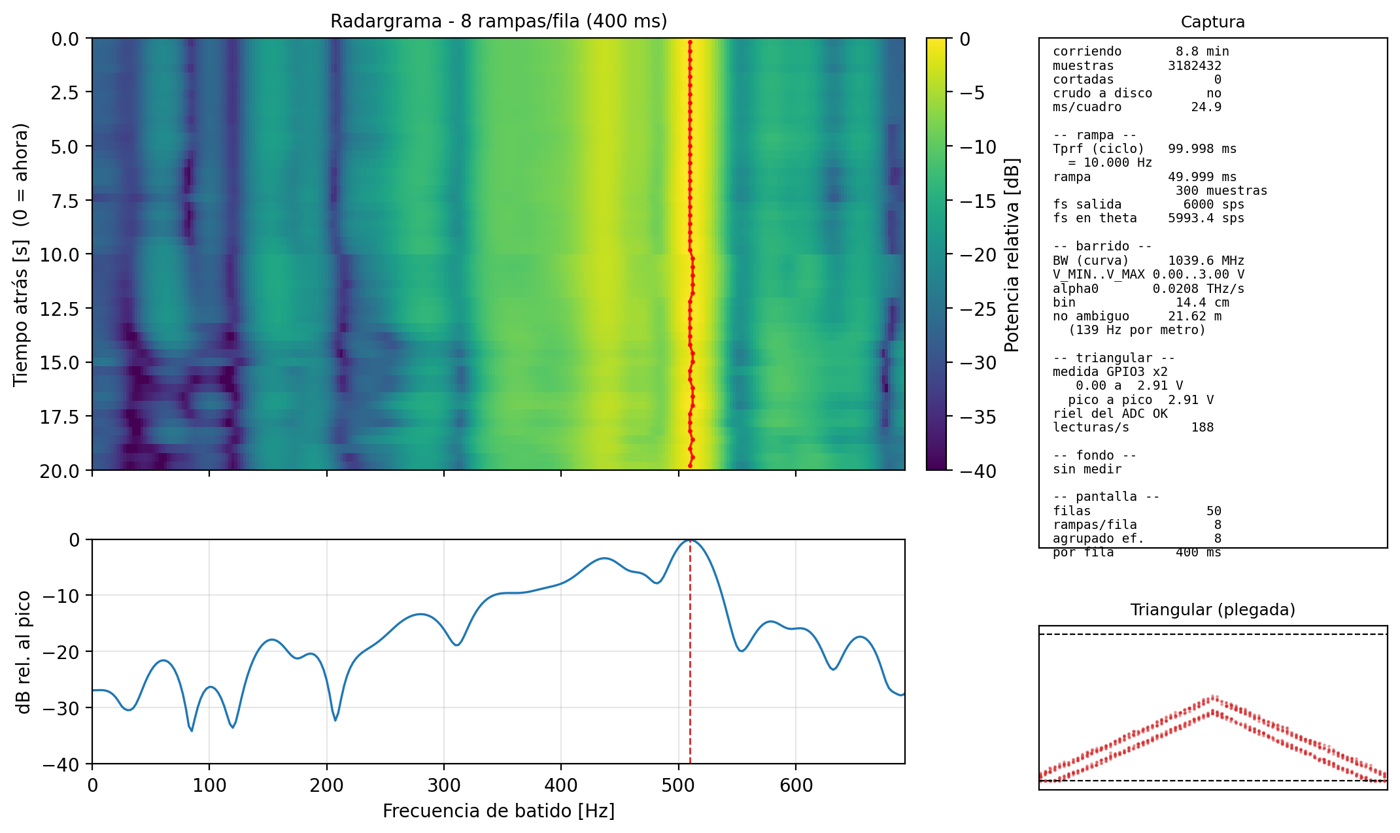
GPRv2/datos/capturas/placa_100cm_cf.png
