maledesm/gpr/GPRv2/datos/capturas/placa_100cm_sf.png

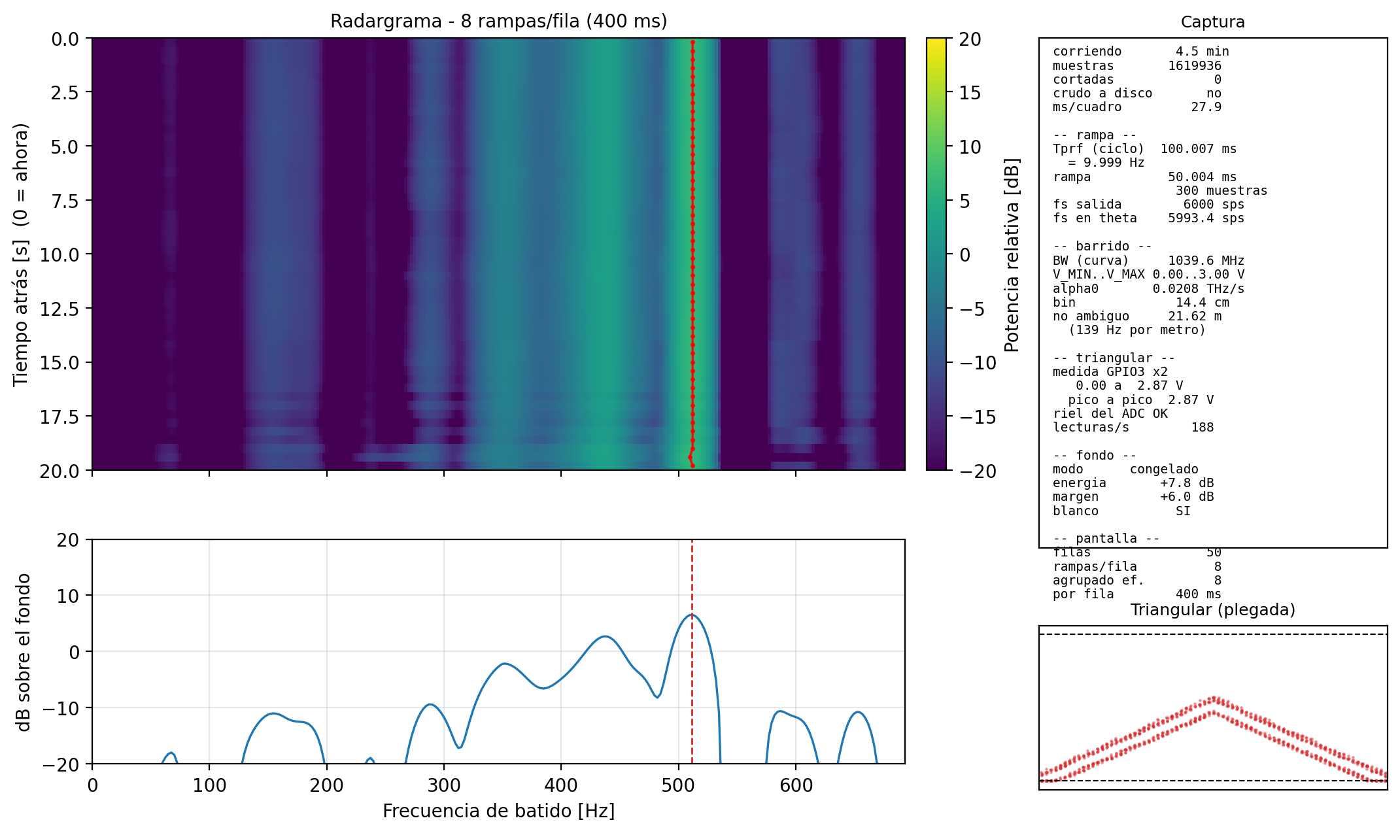
GPRv2/datos/capturas/placa_100cm_sf.png
