maledesm/gpr/GPRv2/docs/PWM/ciclo_anomalo.png

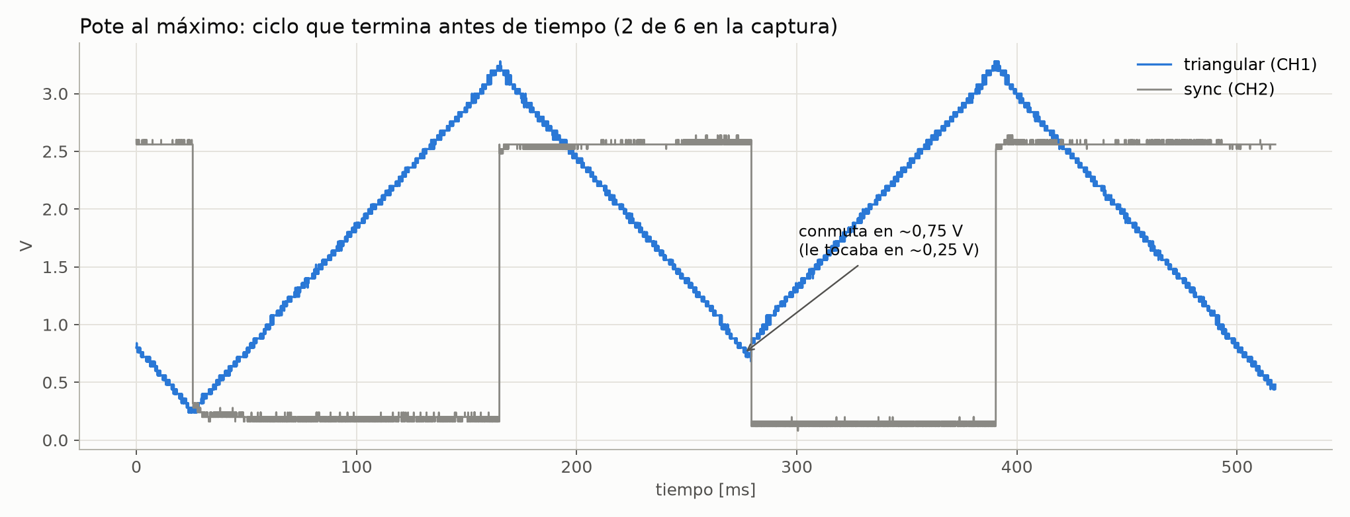
GPRv2/docs/PWM/ciclo_anomalo.png
