maledesm/gpr/GPRv2/docs/PWM/fft_medida_vs_ideal.png

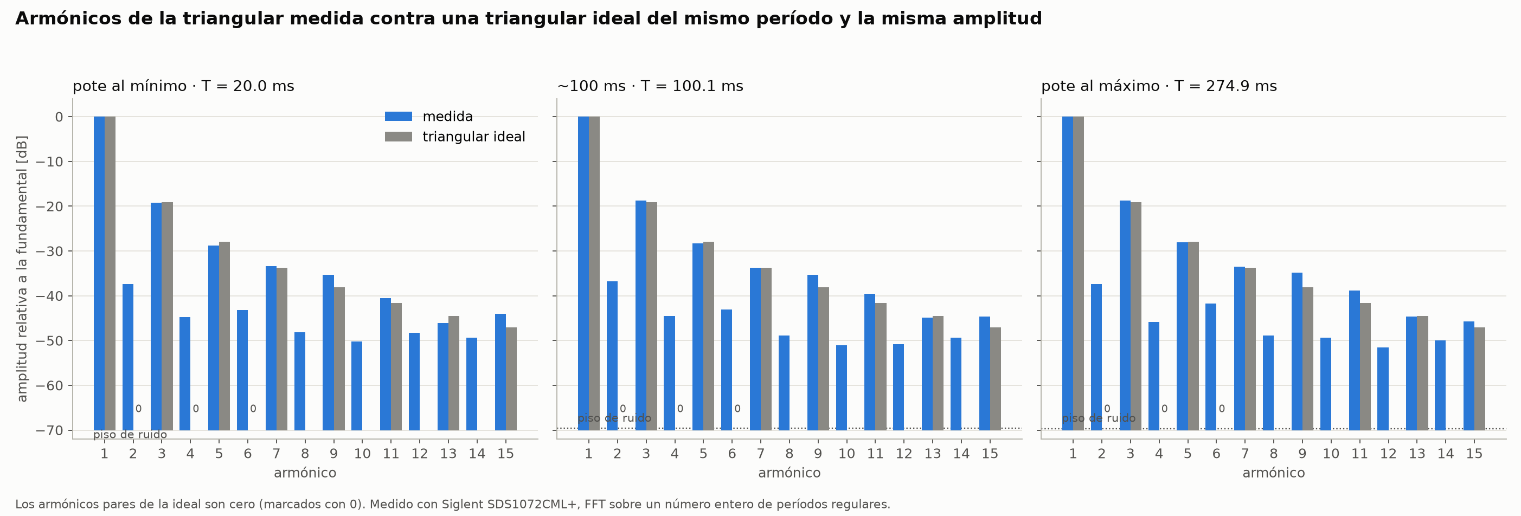
GPRv2/docs/PWM/fft_medida_vs_ideal.png
