maledesm/gpr/GPRv2/docs/PWM/forma_y_linealidad.png

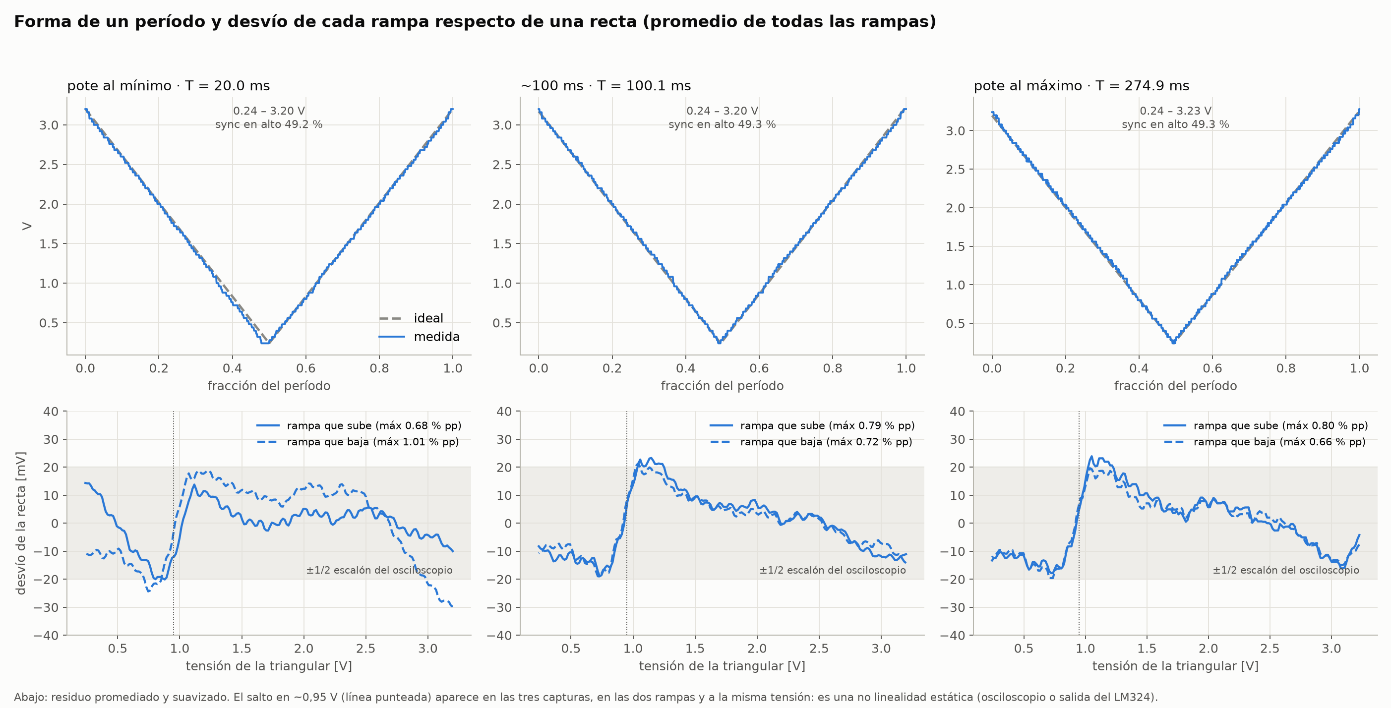
GPRv2/docs/PWM/forma_y_linealidad.png
