maledesm/gpr/GPRv2/docs/PWM/mediciones/2026-11-02_tanda2/fft_medida_vs_ideal.png

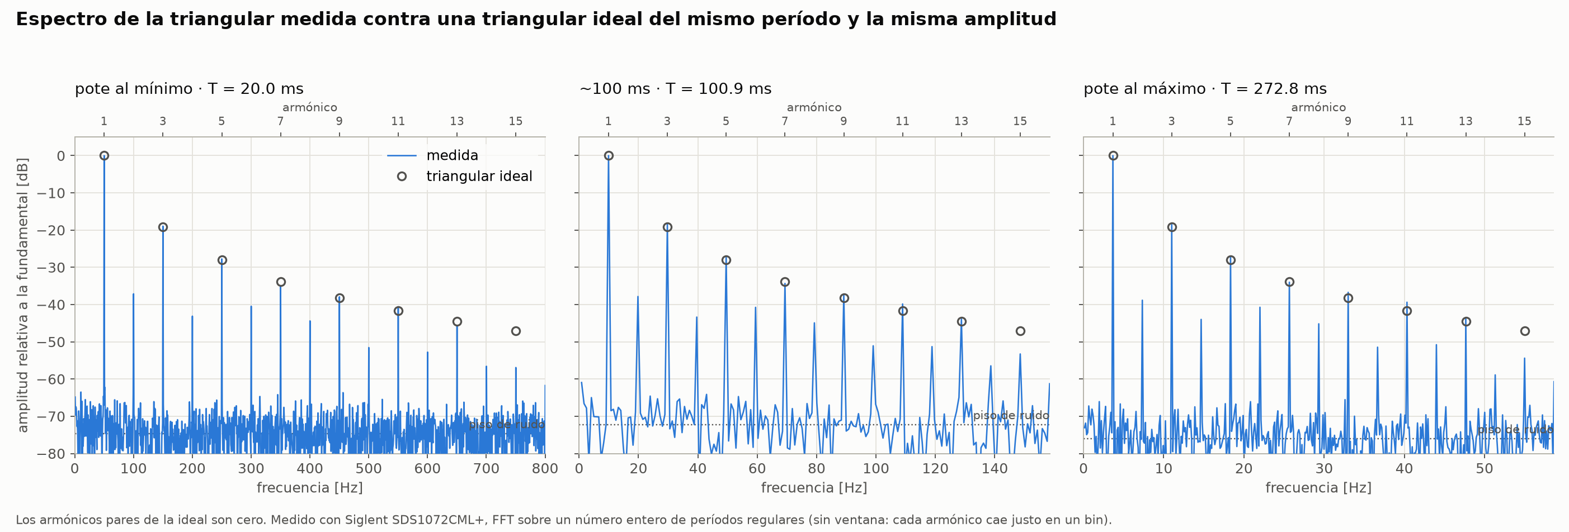
GPRv2/docs/PWM/mediciones/2026-11-02_tanda2/fft_medida_vs_ideal.png
