maledesm/gpr/GPRv2/docs/PWM/mediciones/2026-11-02_tanda2/forma_y_linealidad.png

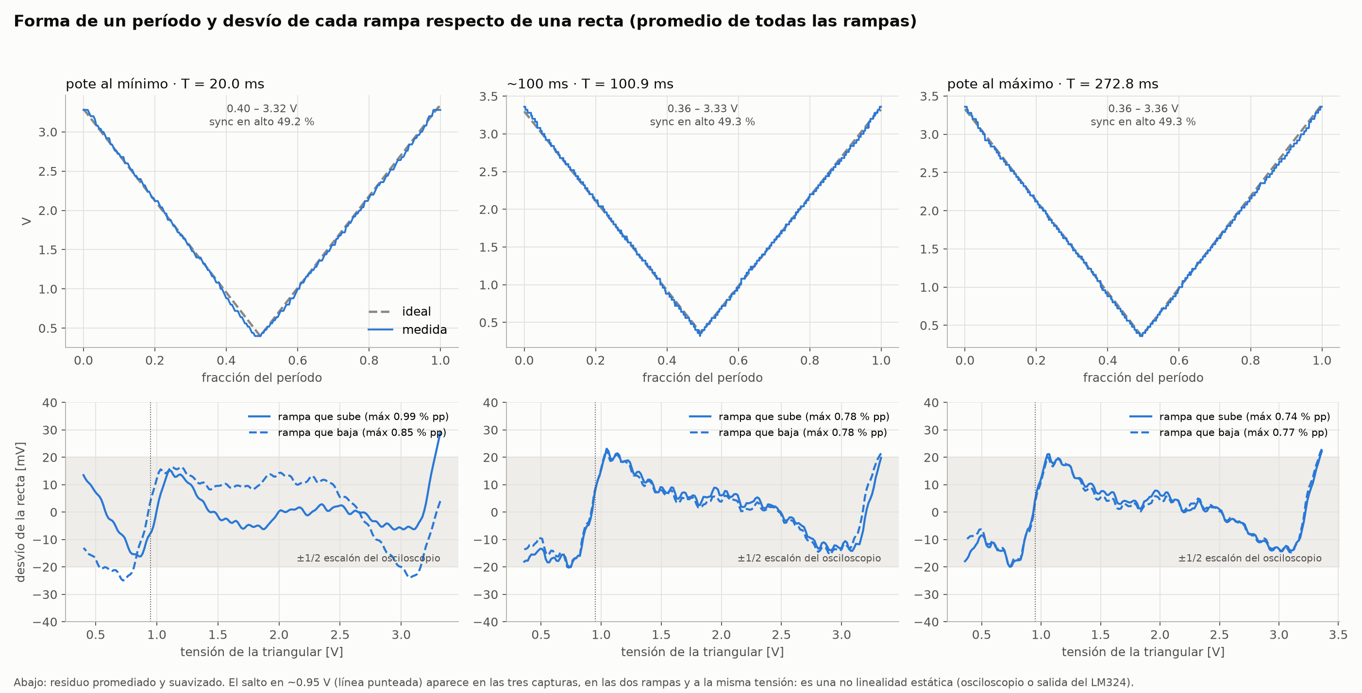
GPRv2/docs/PWM/mediciones/2026-11-02_tanda2/forma_y_linealidad.png
