maledesm/gpr/GPRv2/docs/PWM/mediciones/2026-11-02_tanda2/huecos_registro.png

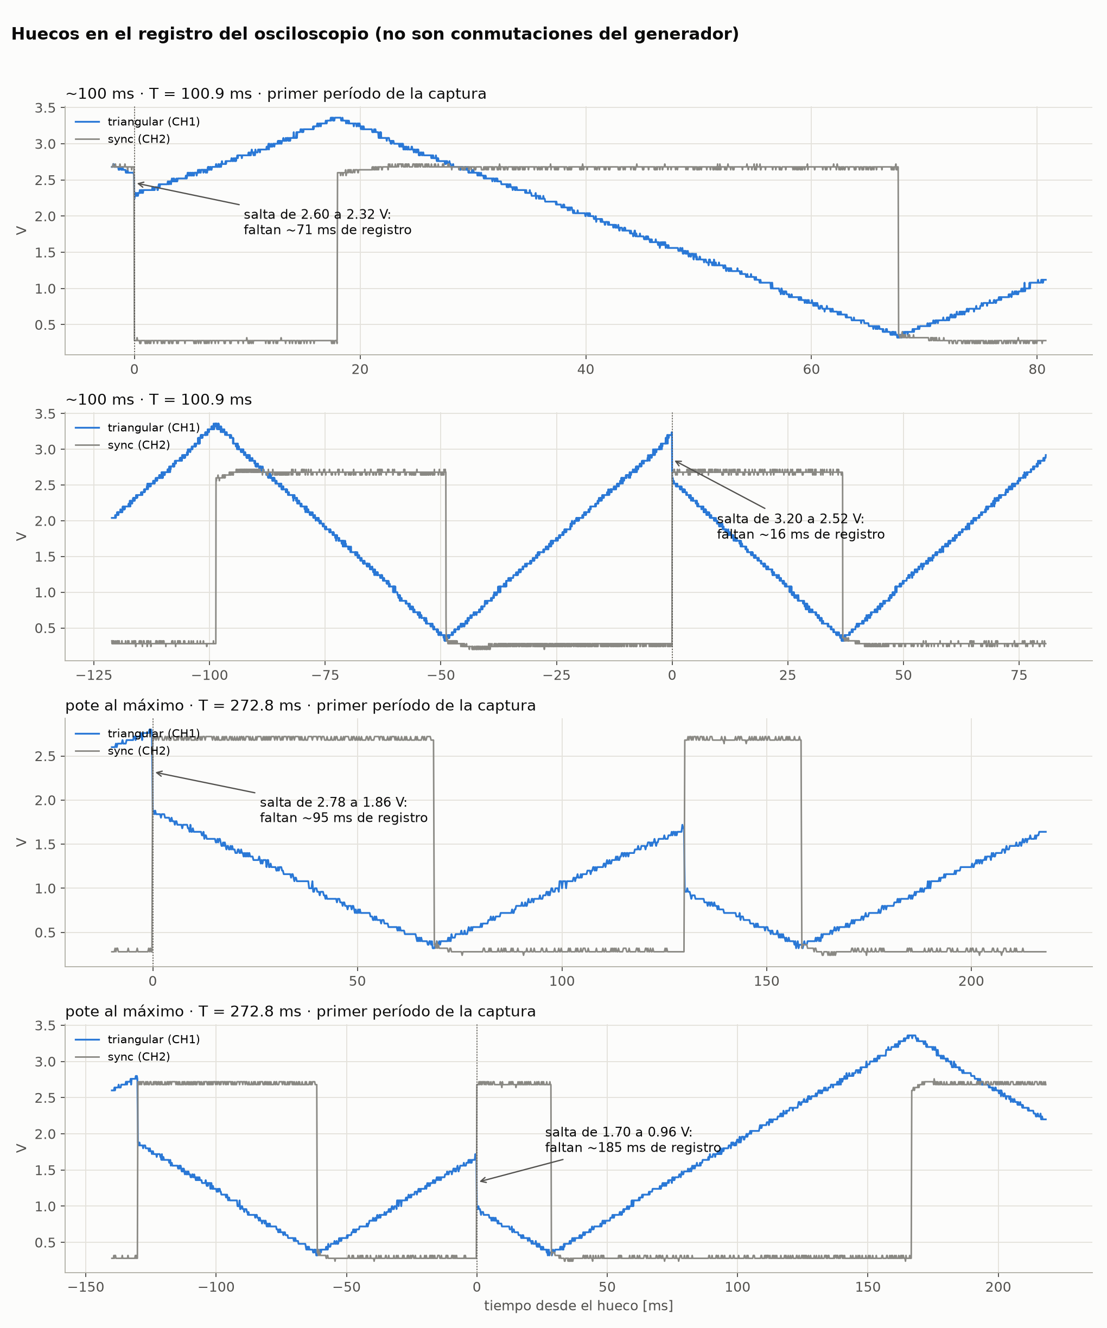
GPRv2/docs/PWM/mediciones/2026-11-02_tanda2/huecos_registro.png
