maledesm/gpr/GPRv2/docs/PWM/mediciones/2026-11-06-siglent_vco+triangular/zerospan_trazas.png

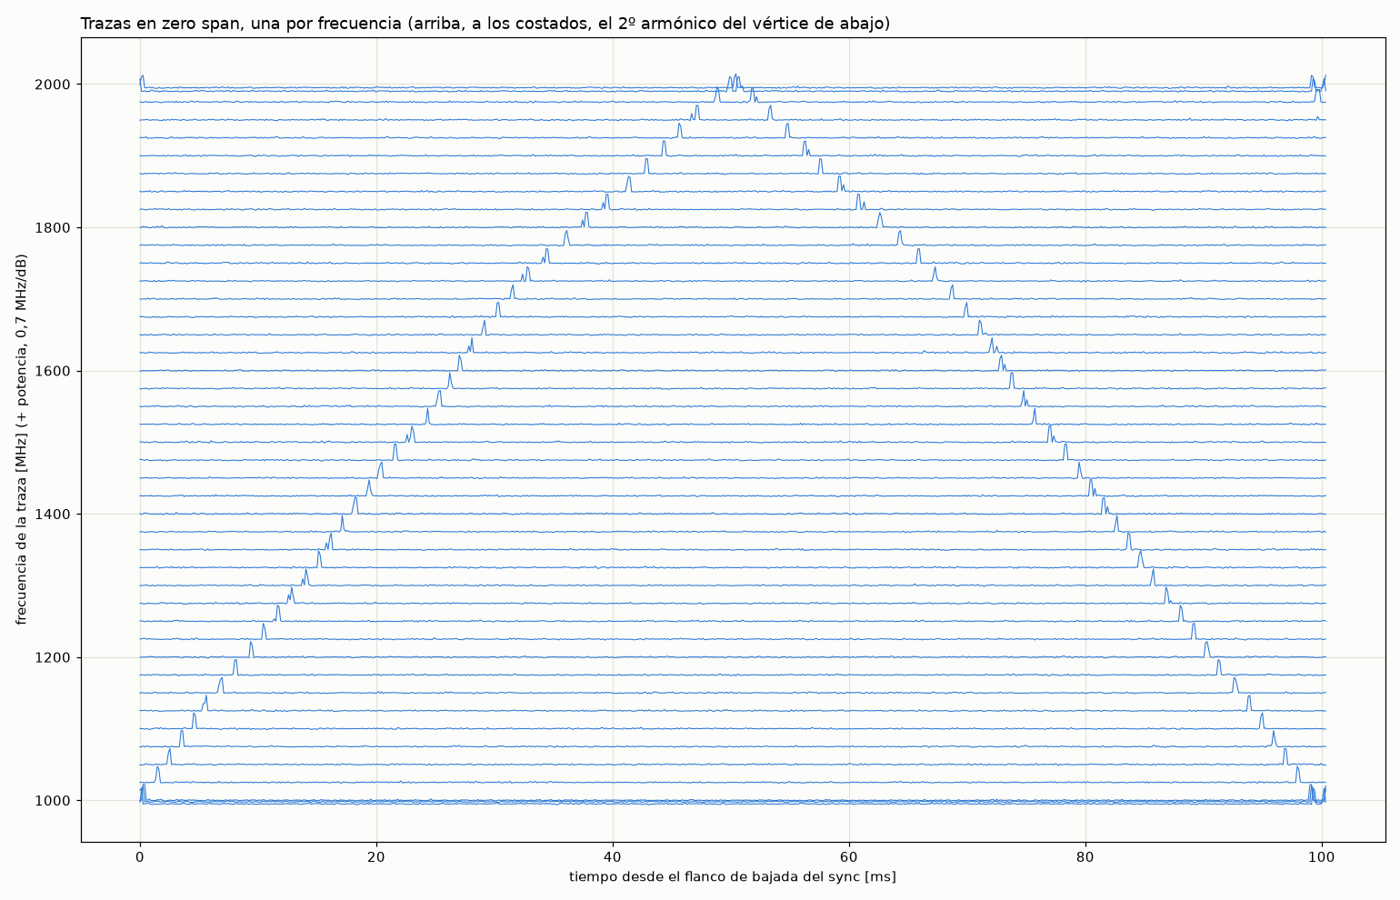
GPRv2/docs/PWM/mediciones/2026-11-06-siglent_vco+triangular/zerospan_trazas.png
