maledesm/gpr/GPRv2/docs/PWM/mediciones/2026-11-06-tektronix_triangular/ALL0000/F0000TEK.BMP

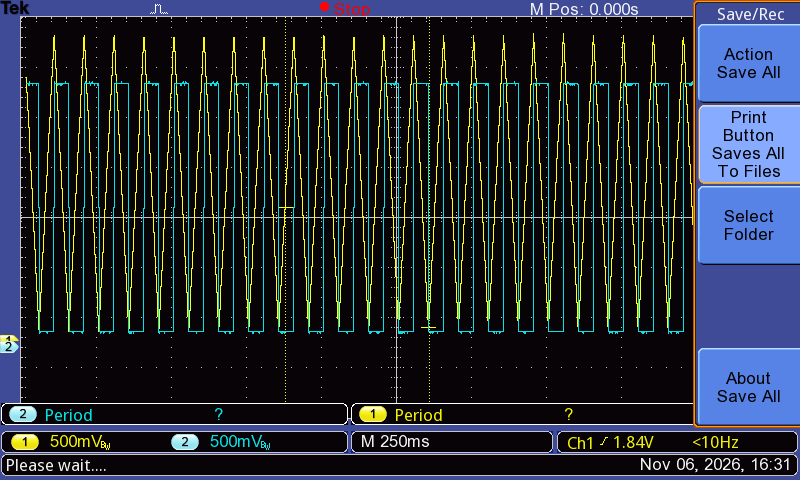
GPRv2/docs/PWM/mediciones/2026-11-06-tektronix_triangular/ALL0000/F0000TEK.BMP
