maledesm/gpr/GPRv2/docs/PWM/mediciones/2026-11-06-tektronix_triangular/ALL0001_analisis.png

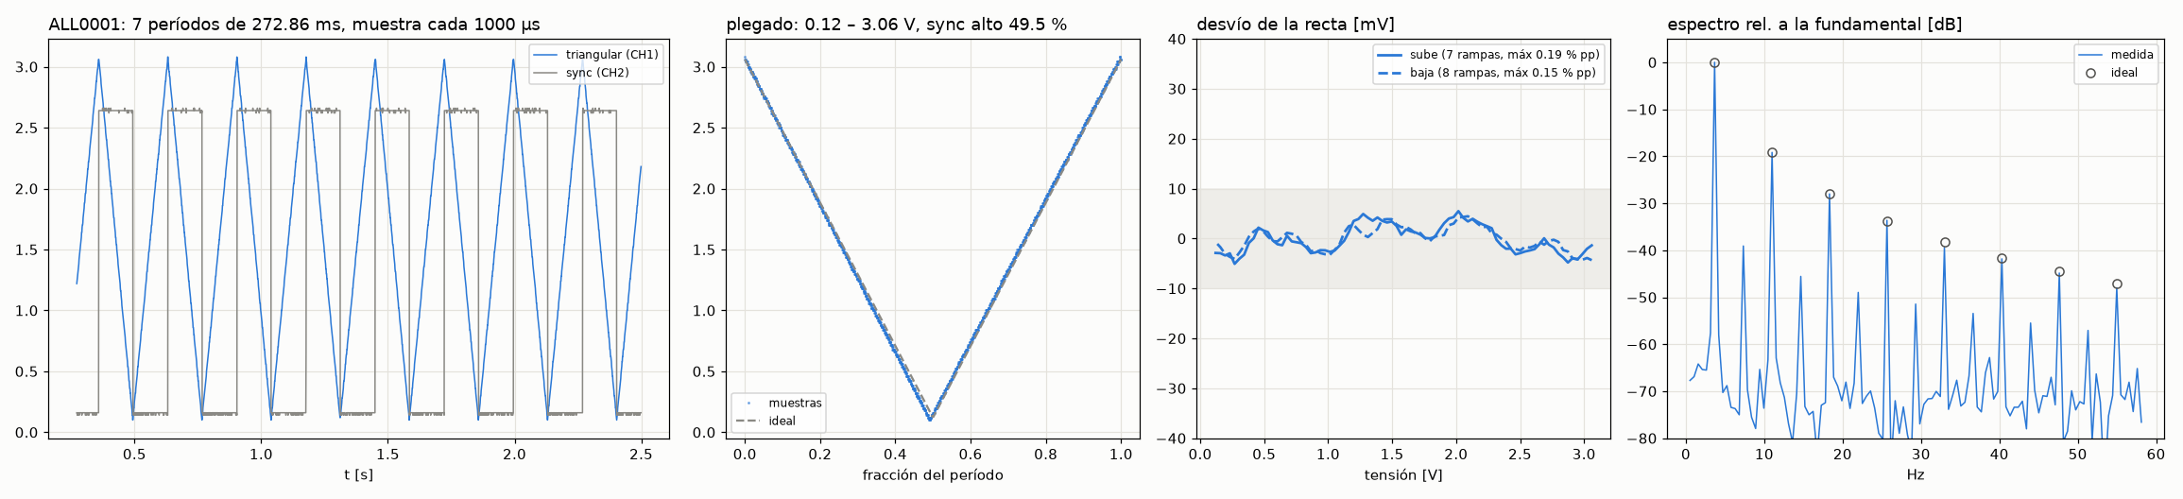
GPRv2/docs/PWM/mediciones/2026-11-06-tektronix_triangular/ALL0001_analisis.png
