maledesm/gpr/GPRv2/docs/VCC/fft_vcc.png

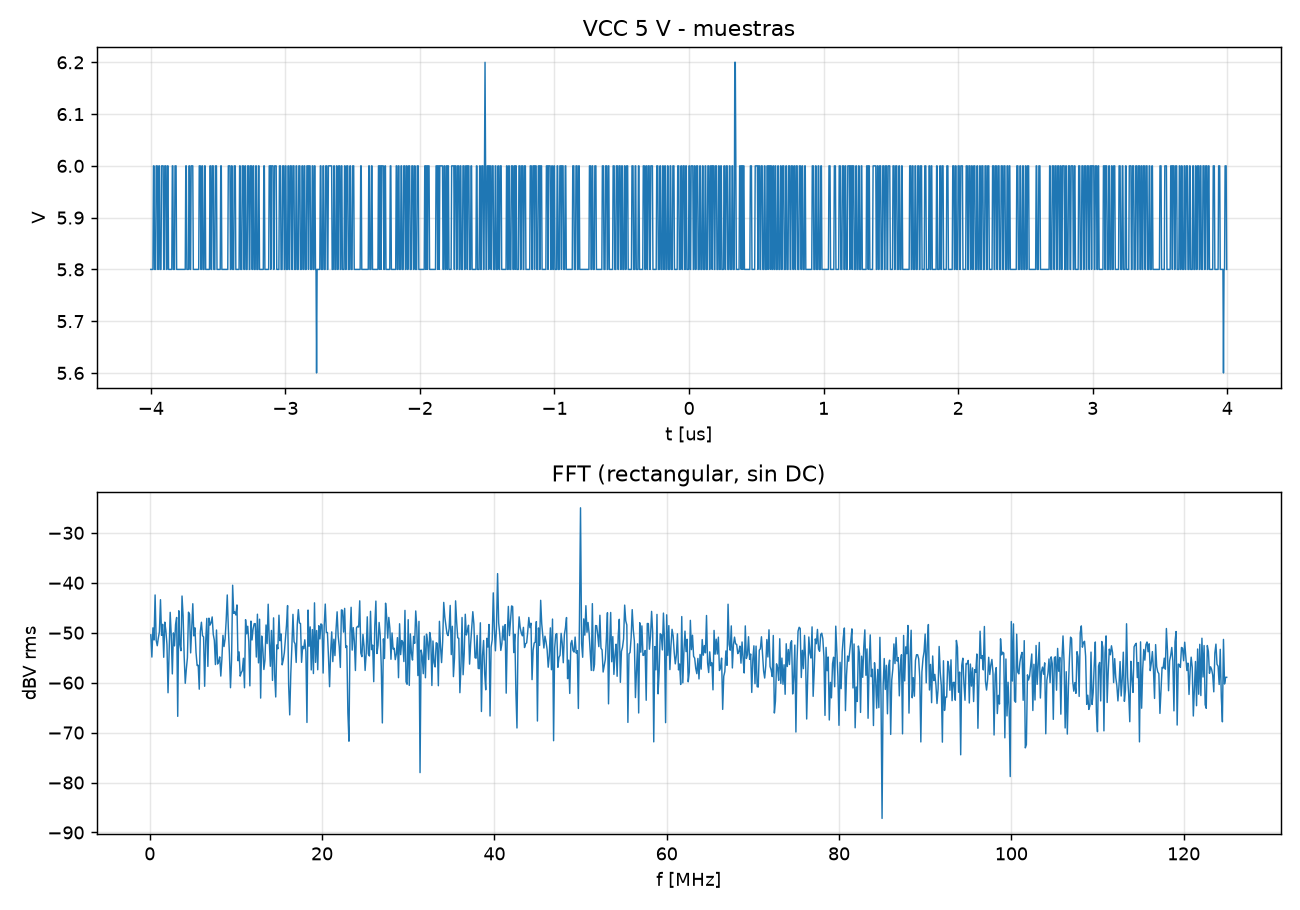
GPRv2/docs/VCC/fft_vcc.png
