maledesm/gpr/GPRv2/mediciones/mediciones_antena.png

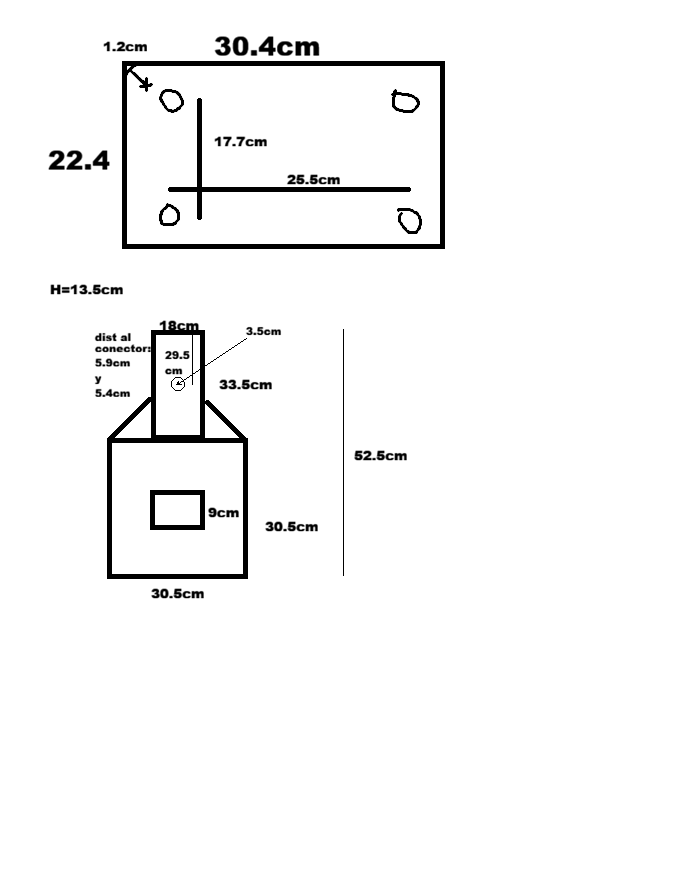
GPRv2/mediciones/mediciones_antena.png
