maledesm/gpr/GPRv2/simulaciones_meep/armonicos/figuras/adaptada/cascada_1m.png

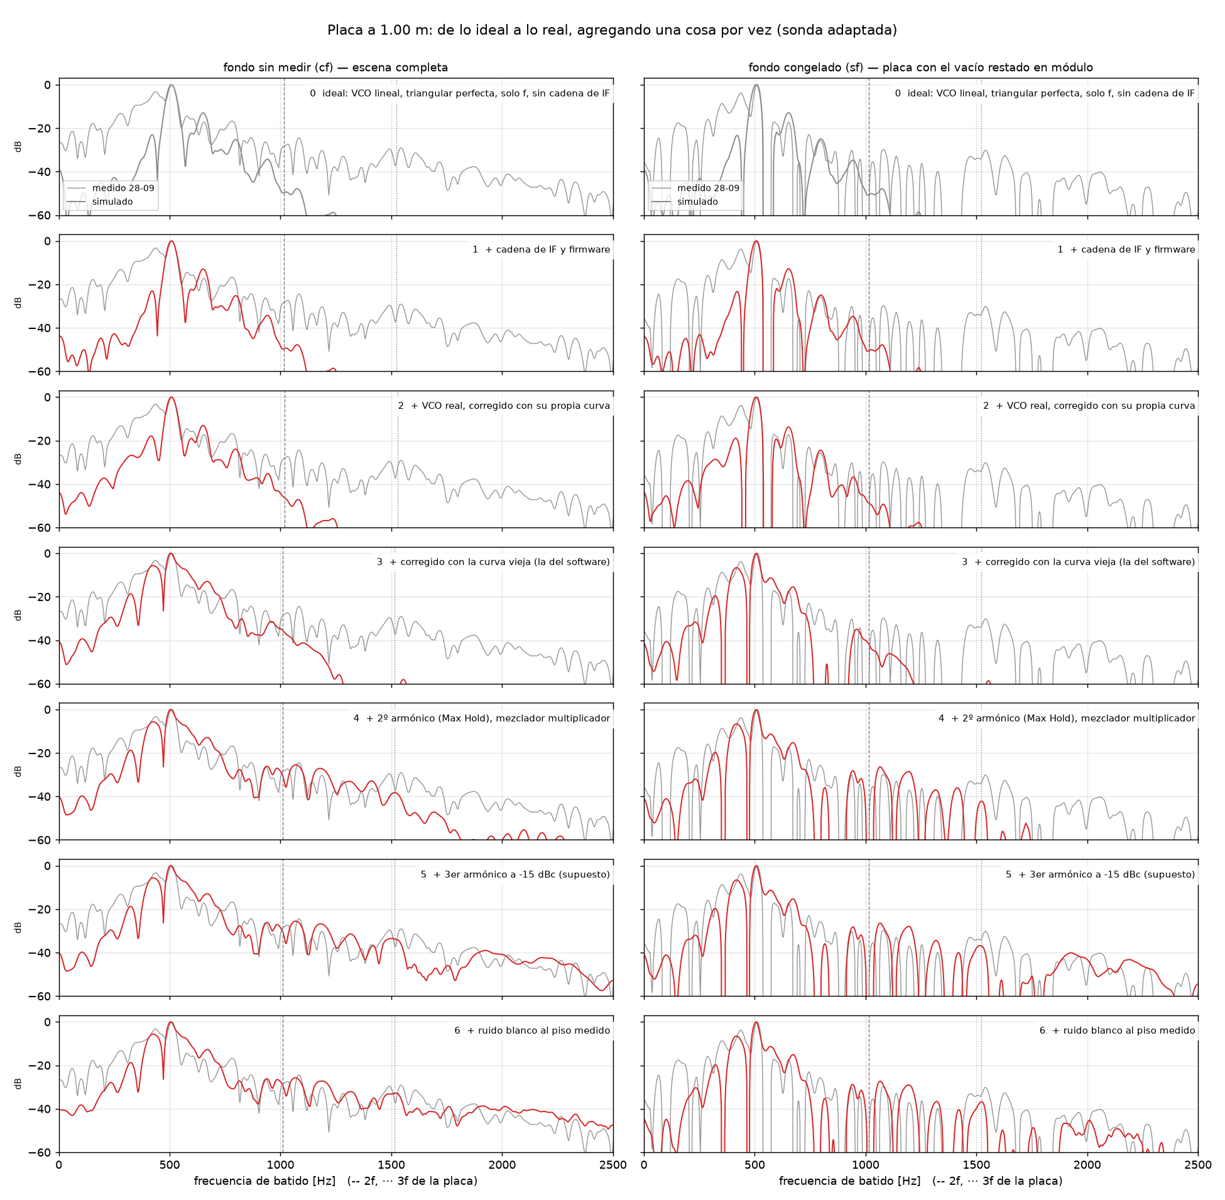
GPRv2/simulaciones_meep/armonicos/figuras/adaptada/cascada_1m.png
