maledesm/gpr/GPRv2/simulaciones_meep/armonicos/figuras/adaptada/entradas.png

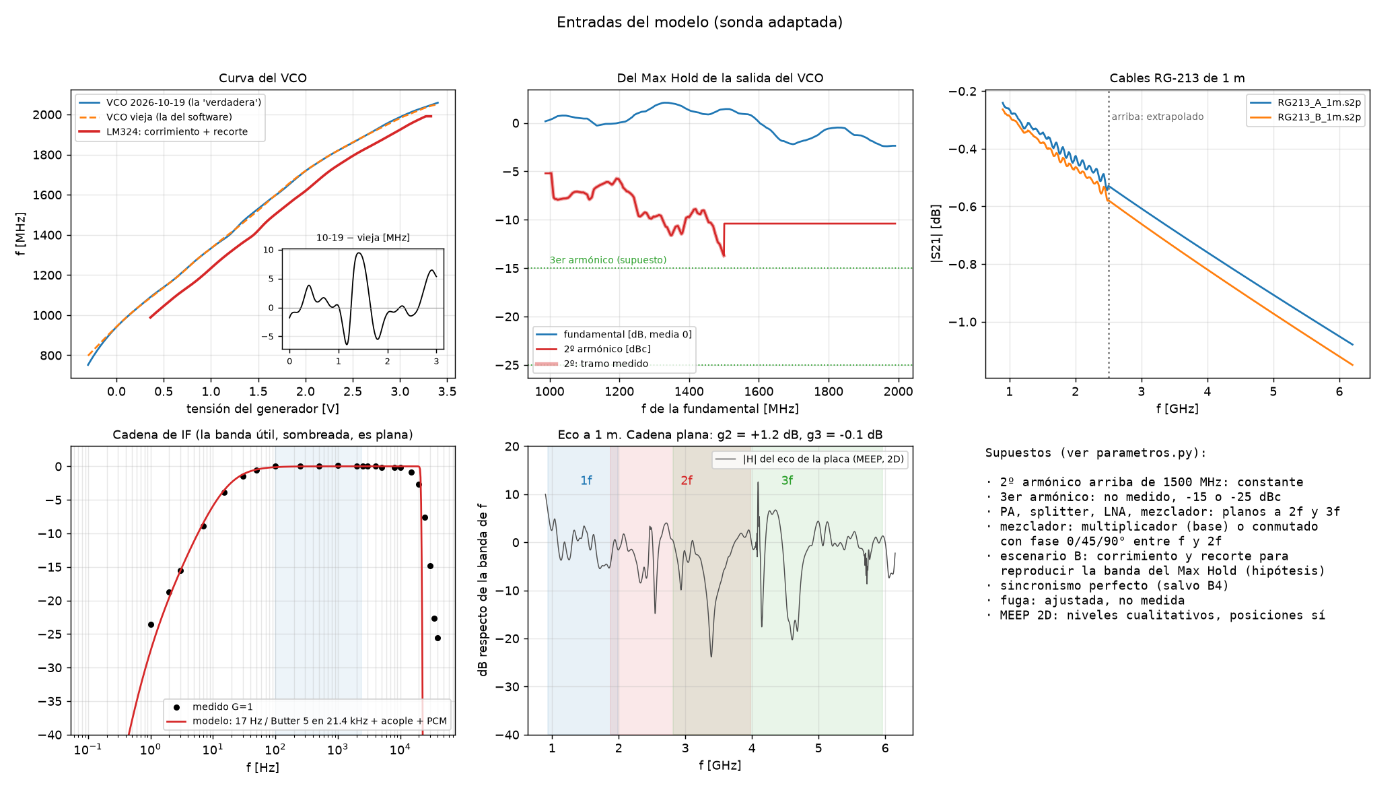
GPRv2/simulaciones_meep/armonicos/figuras/adaptada/entradas.png
