maledesm/gpr/GPRv2/simulaciones_meep/armonicos/figuras/adaptada/fantasmas.png

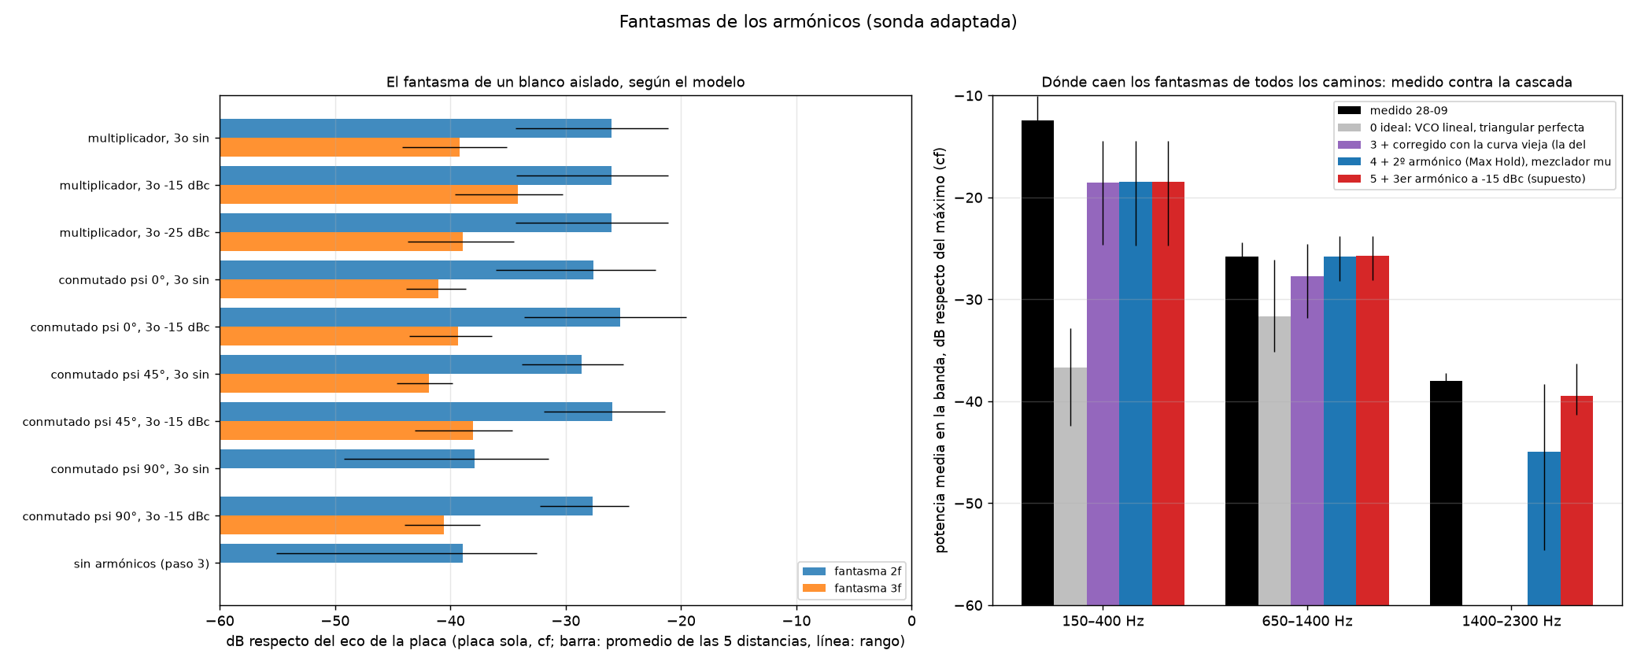
GPRv2/simulaciones_meep/armonicos/figuras/adaptada/fantasmas.png
