maledesm/gpr/GPRv2/simulaciones_meep/armonicos/figuras/adaptada/fuga.png

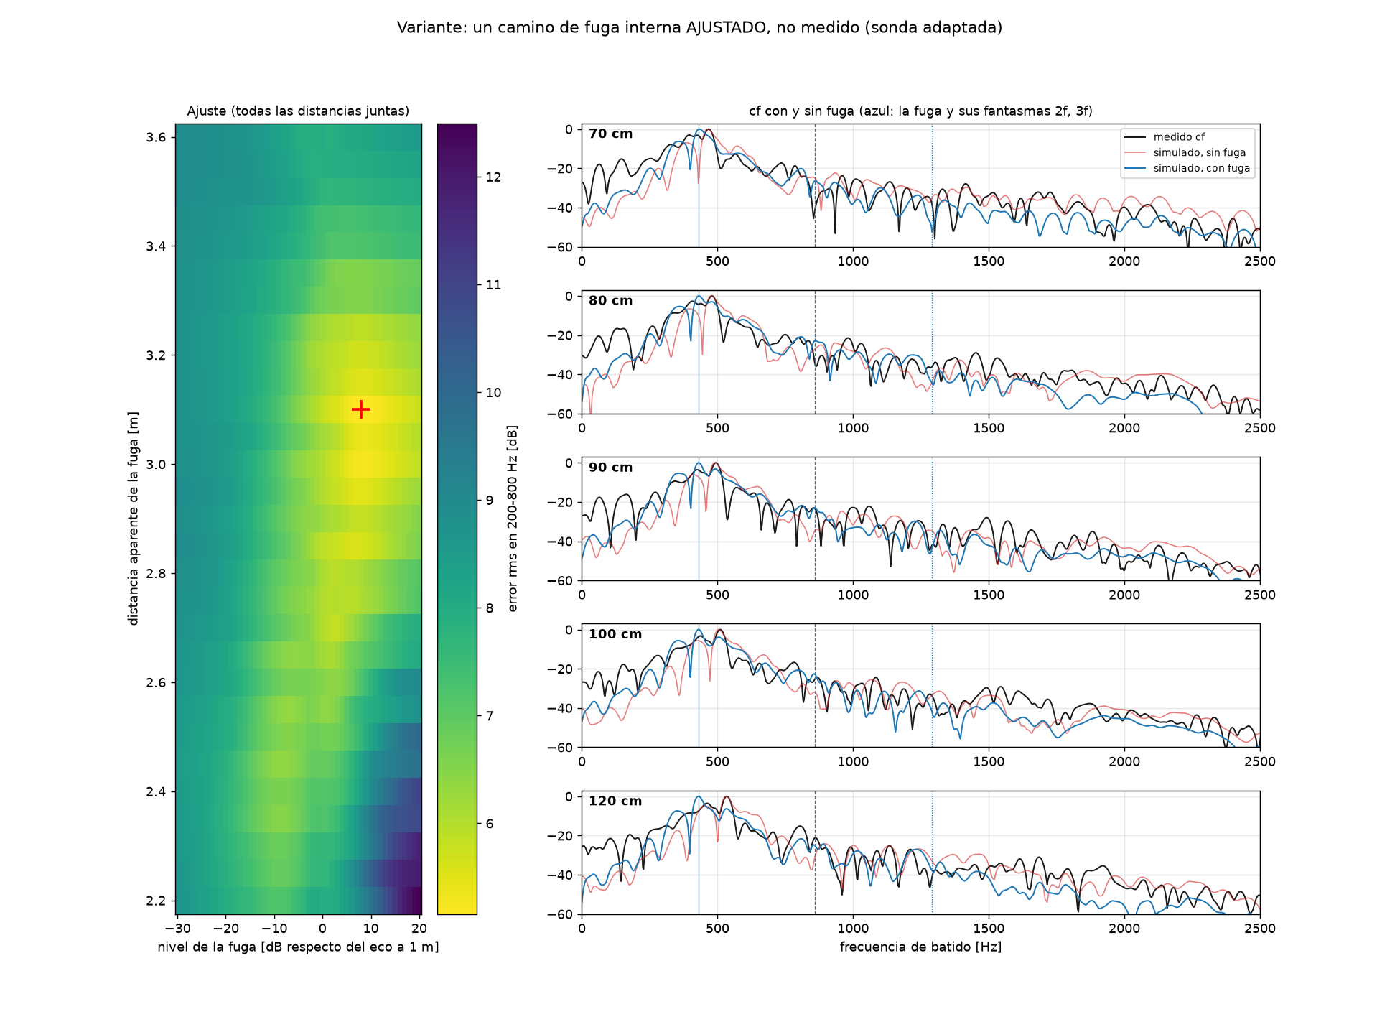
GPRv2/simulaciones_meep/armonicos/figuras/adaptada/fuga.png
