maledesm/gpr/GPRv2/simulaciones_meep/armonicos/figuras/adaptada/generador_propio.png

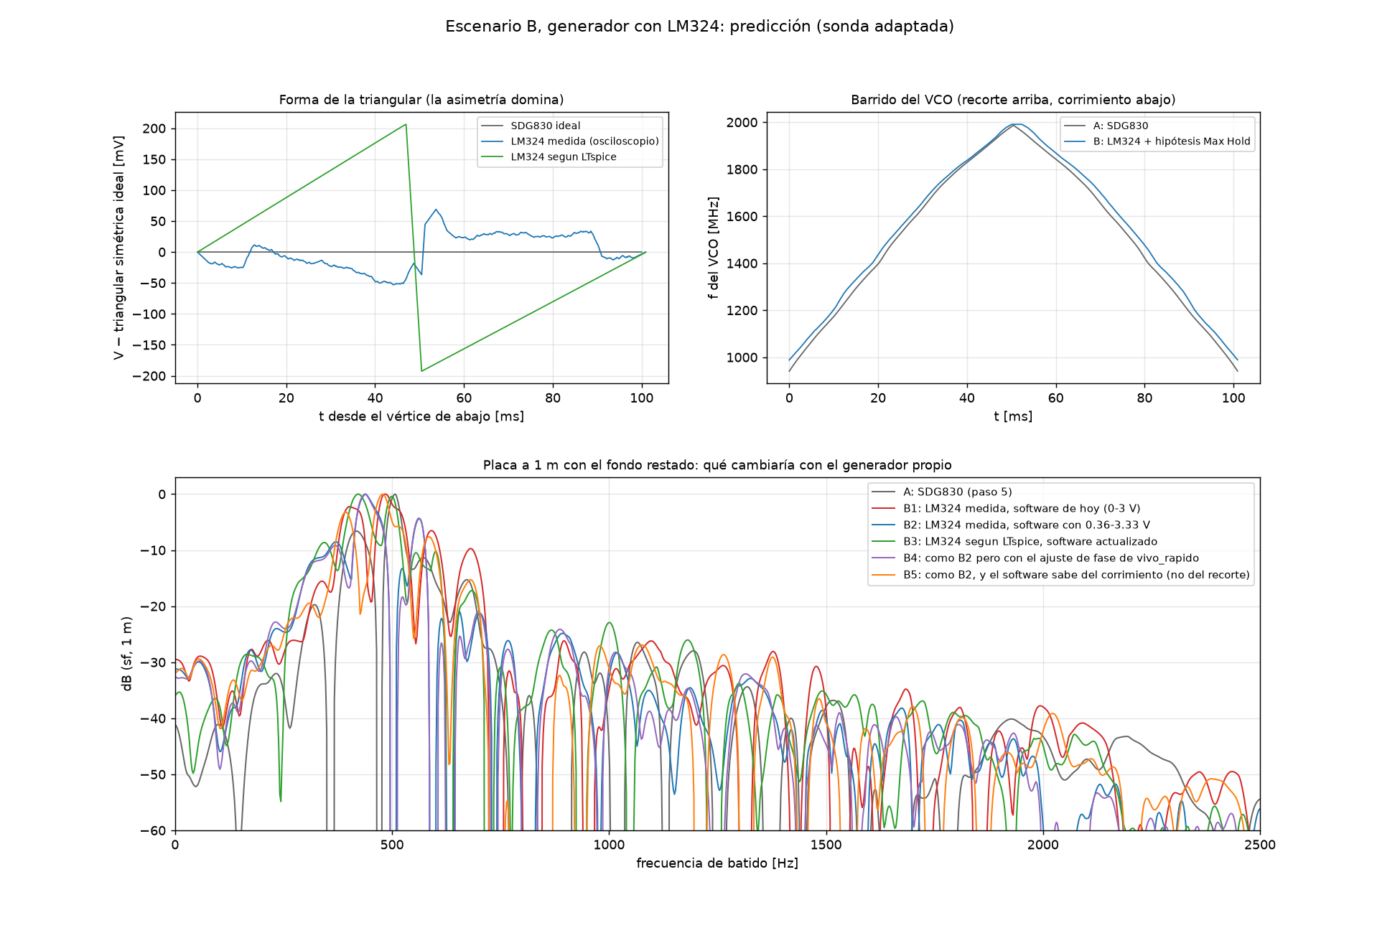
GPRv2/simulaciones_meep/armonicos/figuras/adaptada/generador_propio.png
