maledesm/gpr/GPRv2/simulaciones_meep/armonicos/figuras/adaptada/medido_vs_simulado.png

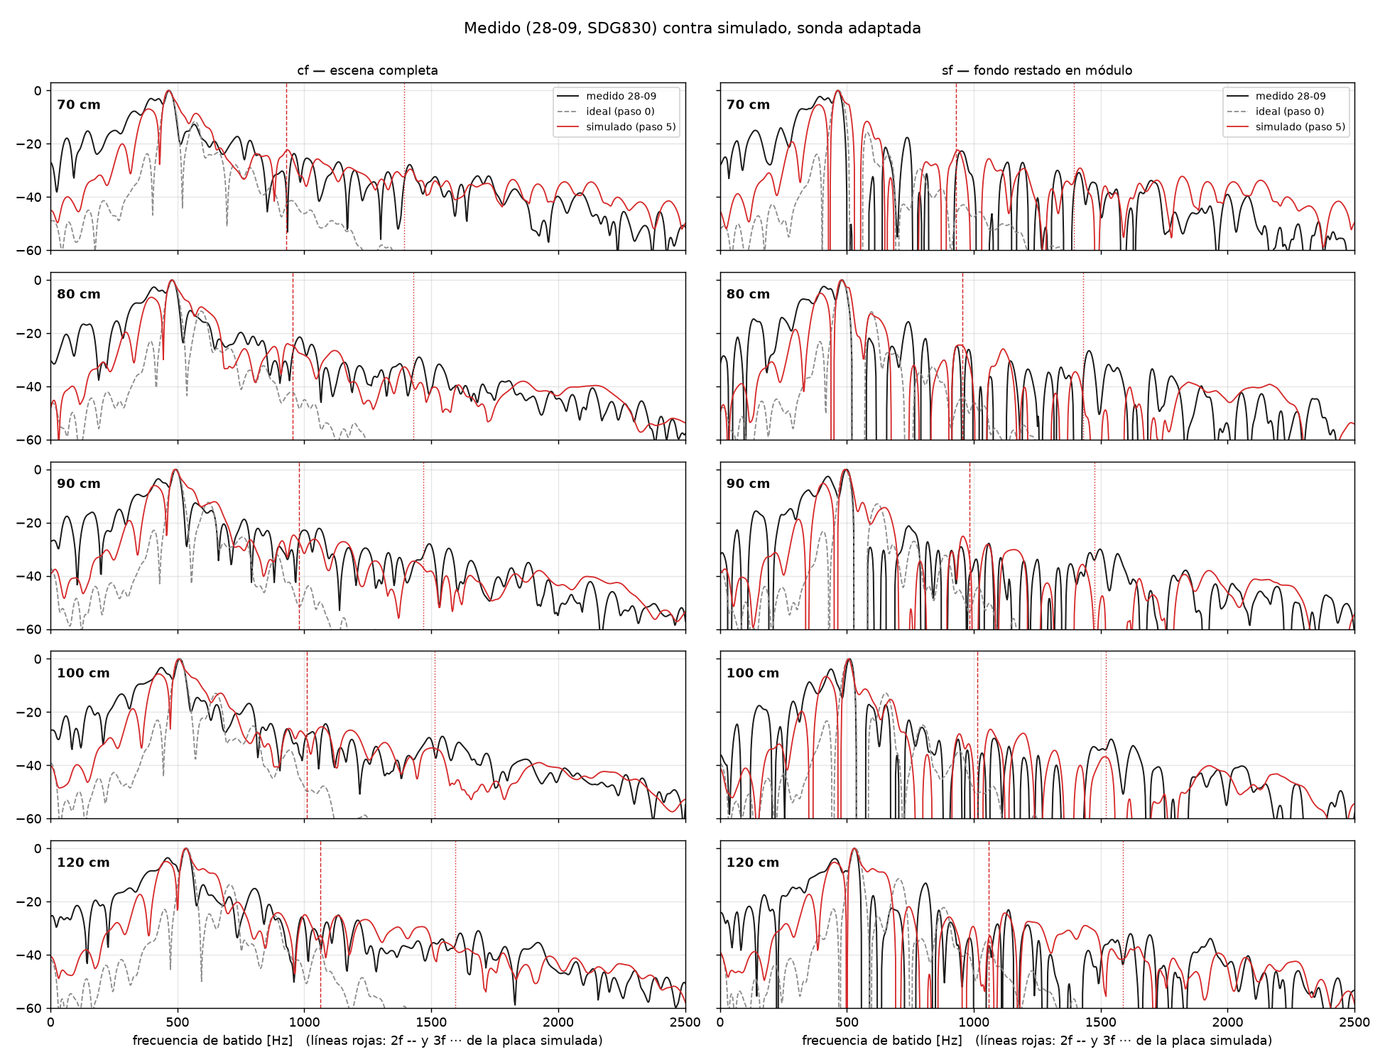
GPRv2/simulaciones_meep/armonicos/figuras/adaptada/medido_vs_simulado.png
