maledesm/gpr/GPRv2/simulaciones_meep/armonicos/figuras/corto/cascada_1m.png

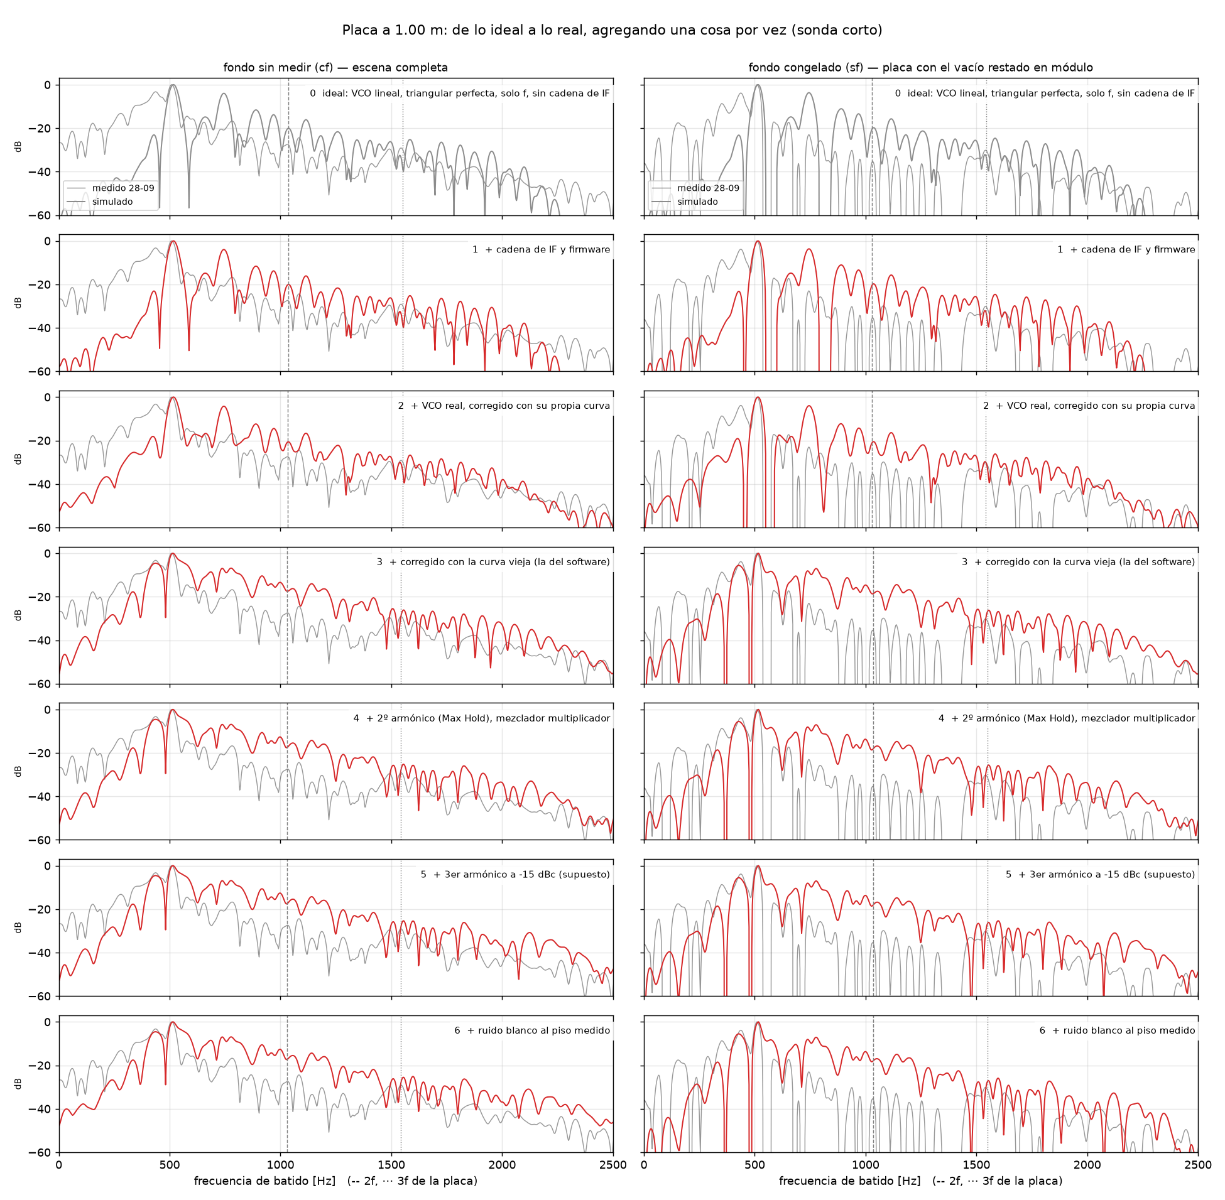
GPRv2/simulaciones_meep/armonicos/figuras/corto/cascada_1m.png
