maledesm/gpr/GPRv2/simulaciones_meep/armonicos/figuras/corto/fantasmas.png

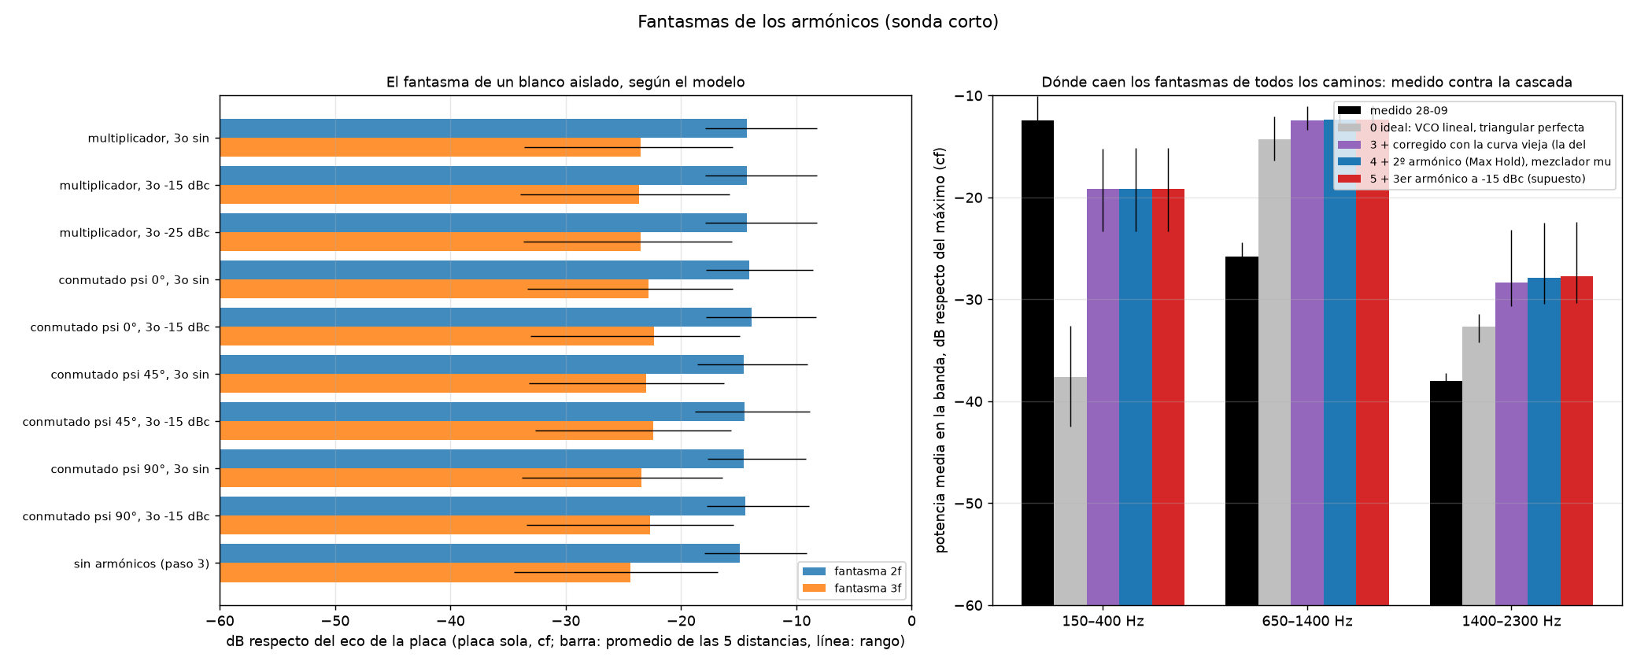
GPRv2/simulaciones_meep/armonicos/figuras/corto/fantasmas.png
