maledesm/gpr/GPRv2/simulaciones_meep/armonicos/figuras/corto/fuga.png

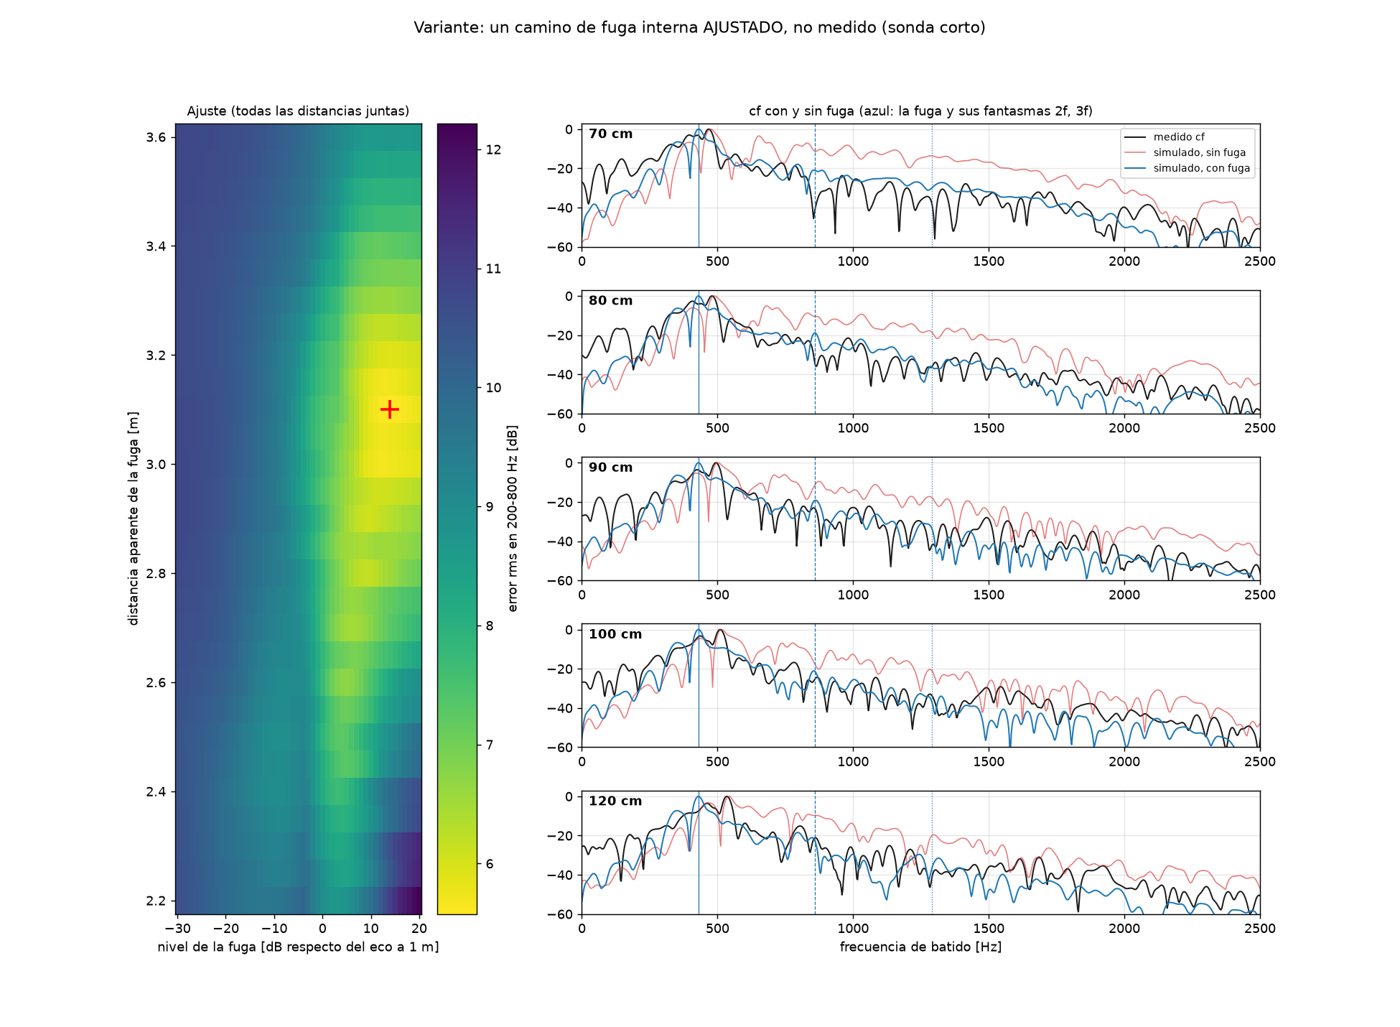
GPRv2/simulaciones_meep/armonicos/figuras/corto/fuga.png
