maledesm/gpr/GPRv2/simulaciones_meep/armonicos/figuras/corto/generador_propio.png

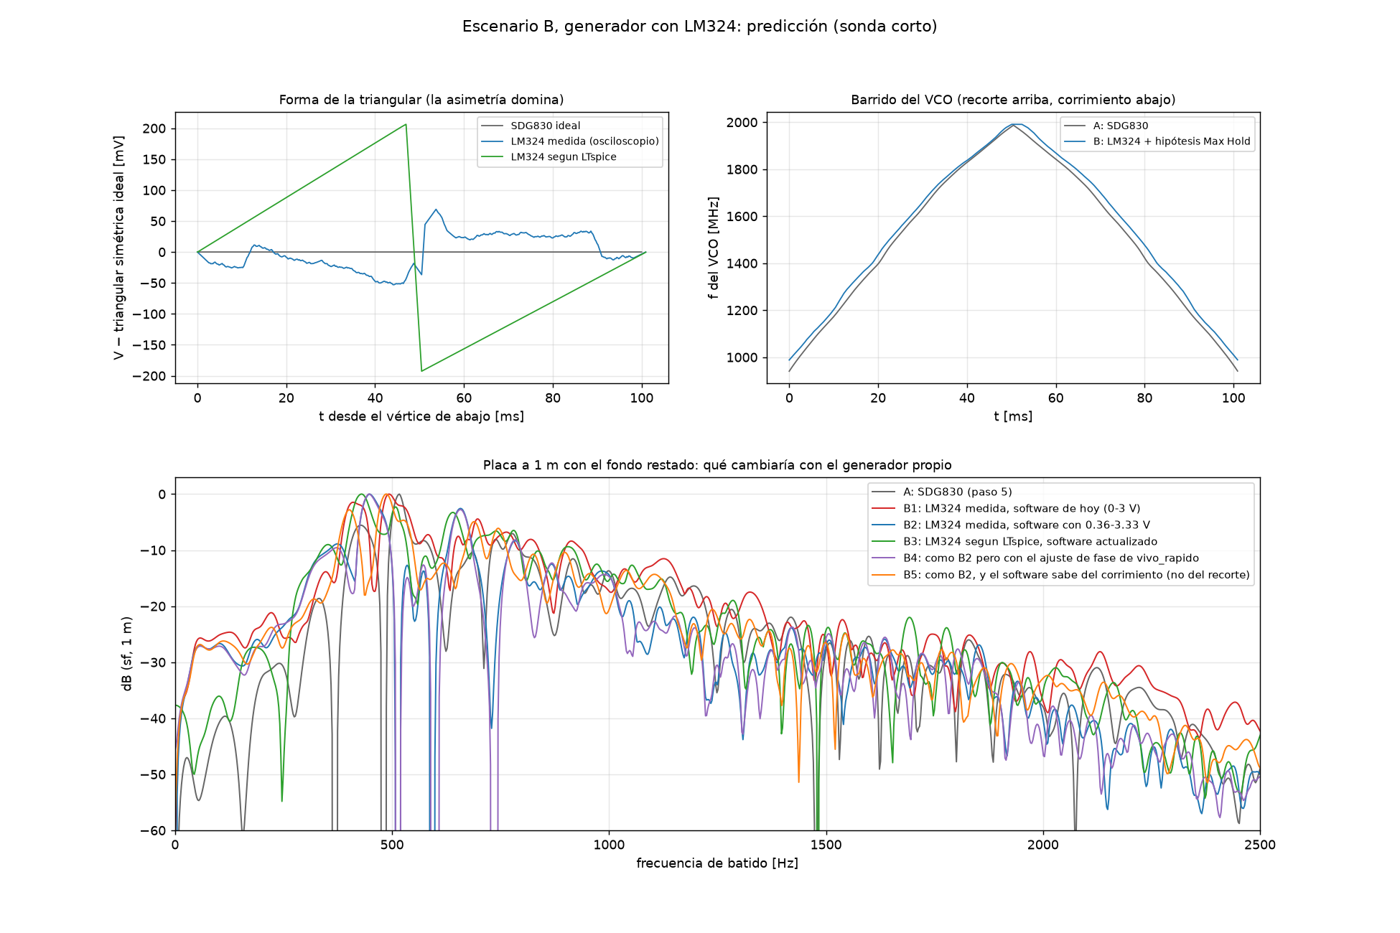
GPRv2/simulaciones_meep/armonicos/figuras/corto/generador_propio.png
