maledesm/gpr/GPRv2/simulaciones_meep/armonicos/figuras/corto/medido_vs_simulado.png

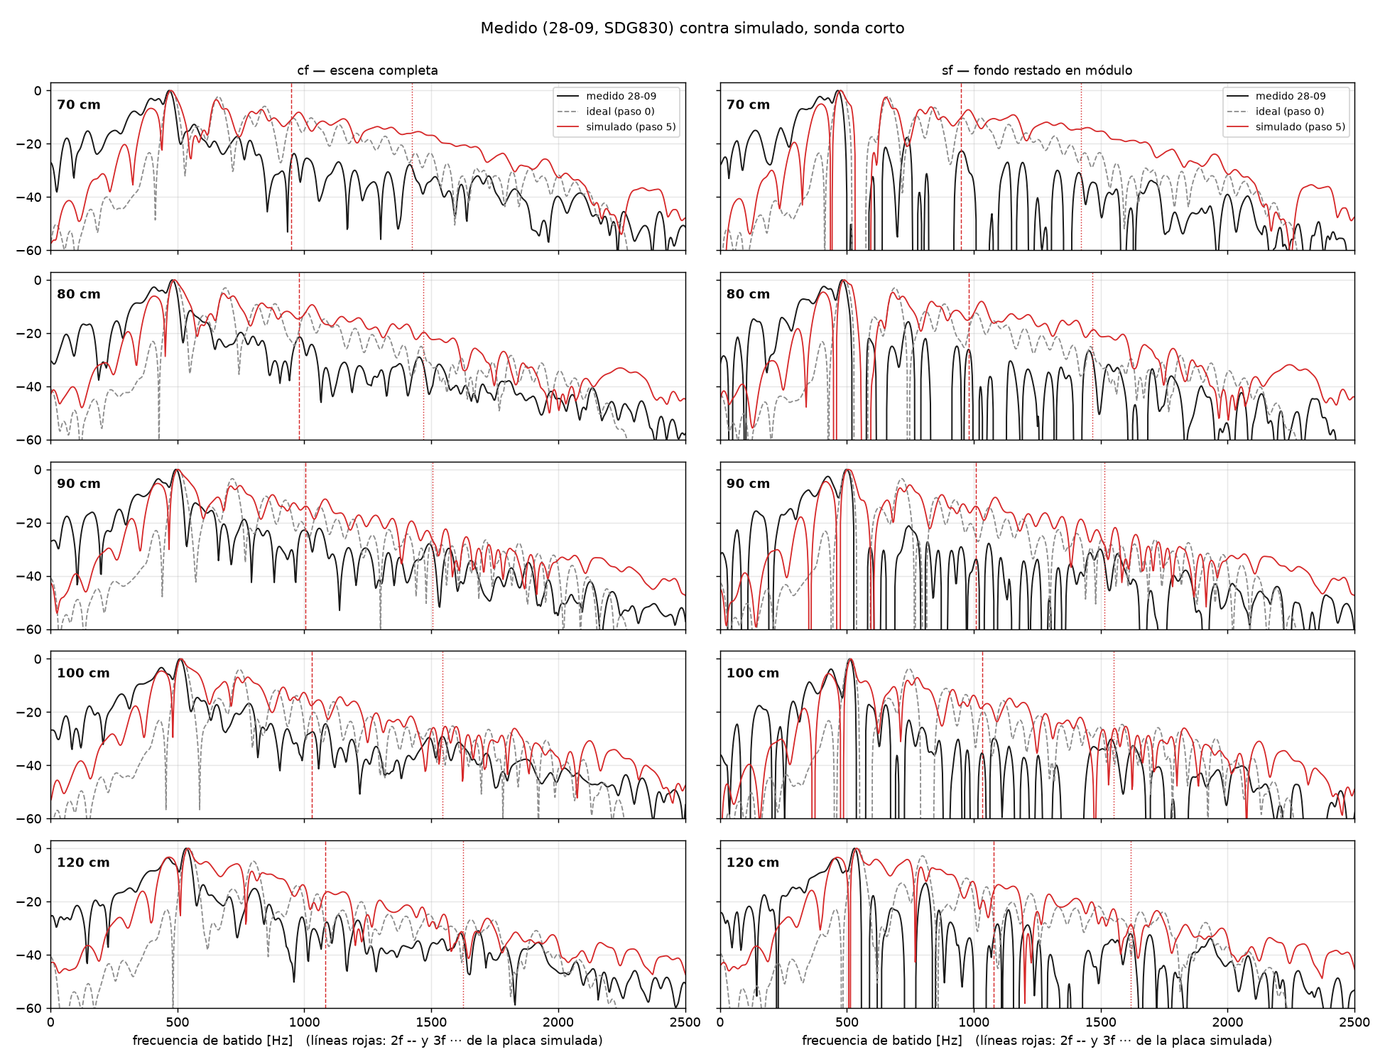
GPRv2/simulaciones_meep/armonicos/figuras/corto/medido_vs_simulado.png
