maledesm/gpr/GPRv2/simulaciones_meep/salidas/barrido_distancia.png

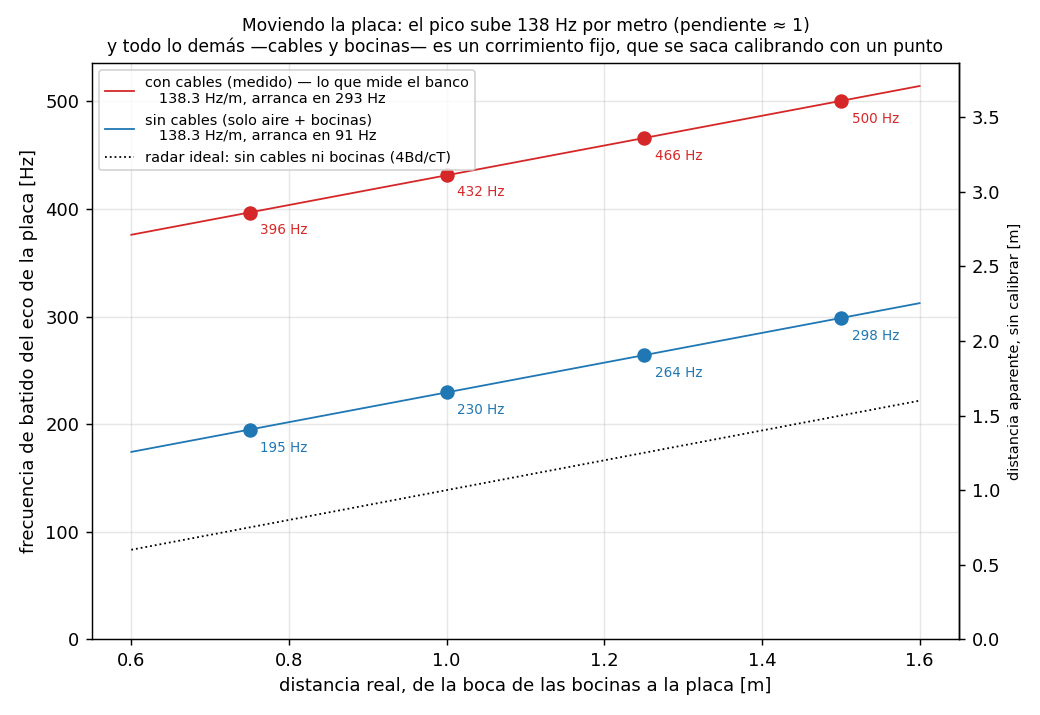
GPRv2/simulaciones_meep/salidas/barrido_distancia.png
