maledesm/gpr/GPRv2/simulaciones_meep/salidas/mediciones_2026-09-28/relevamiento_curvas.png

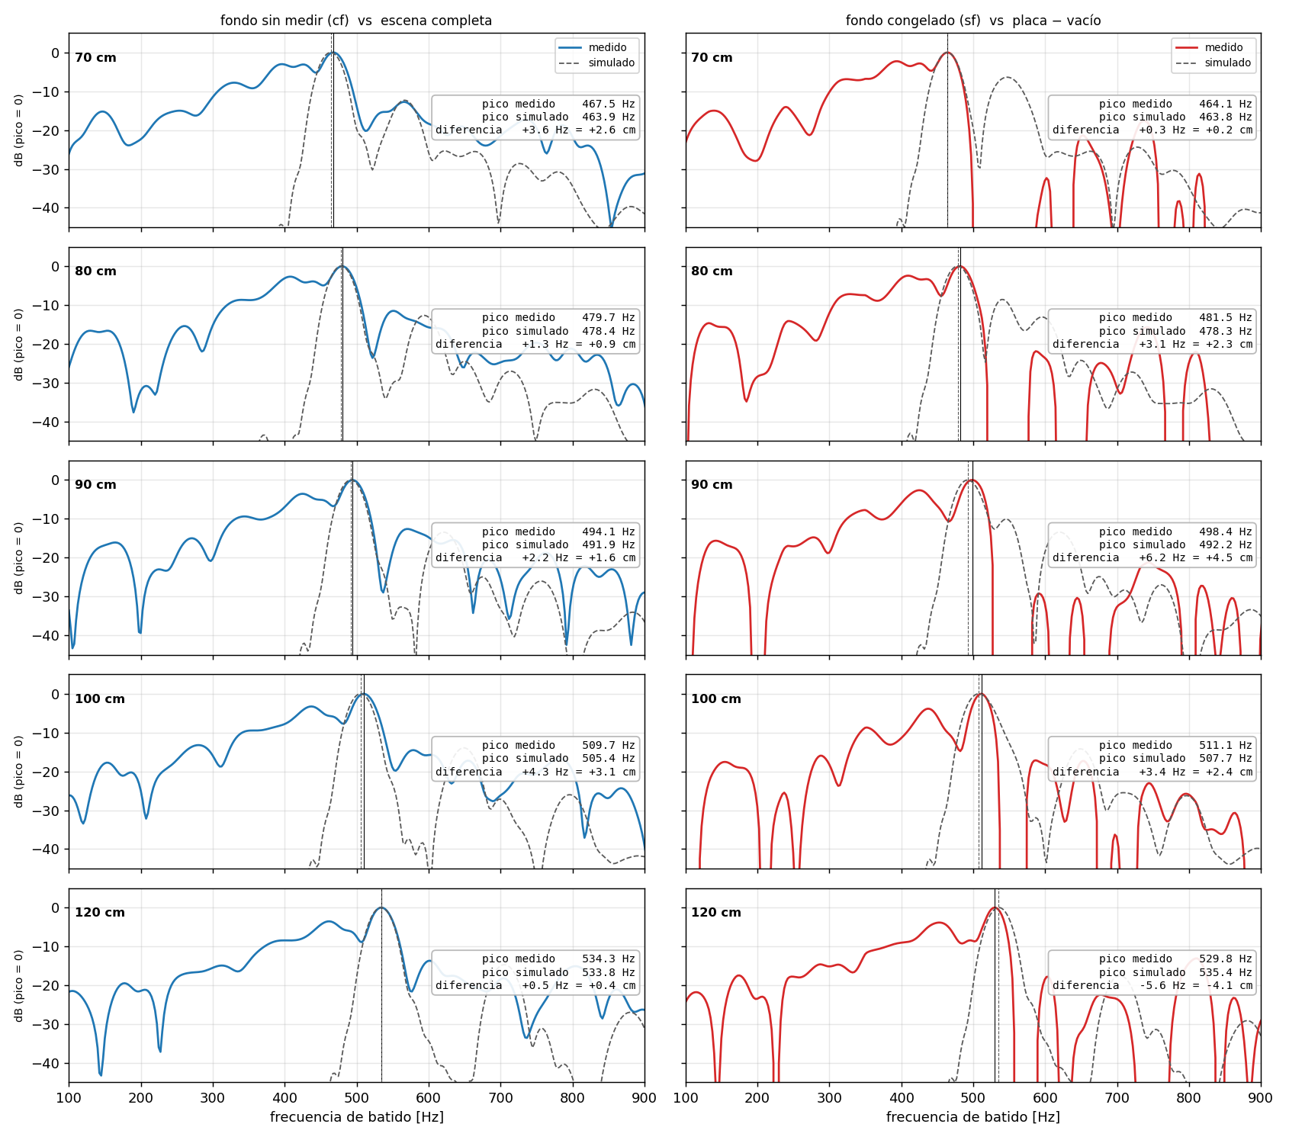
GPRv2/simulaciones_meep/salidas/mediciones_2026-09-28/relevamiento_curvas.png
