maledesm/gpr/GPRv2/simulaciones_meep/salidas/placa0.90m_hueco10cm_ancho70cm/escena.png

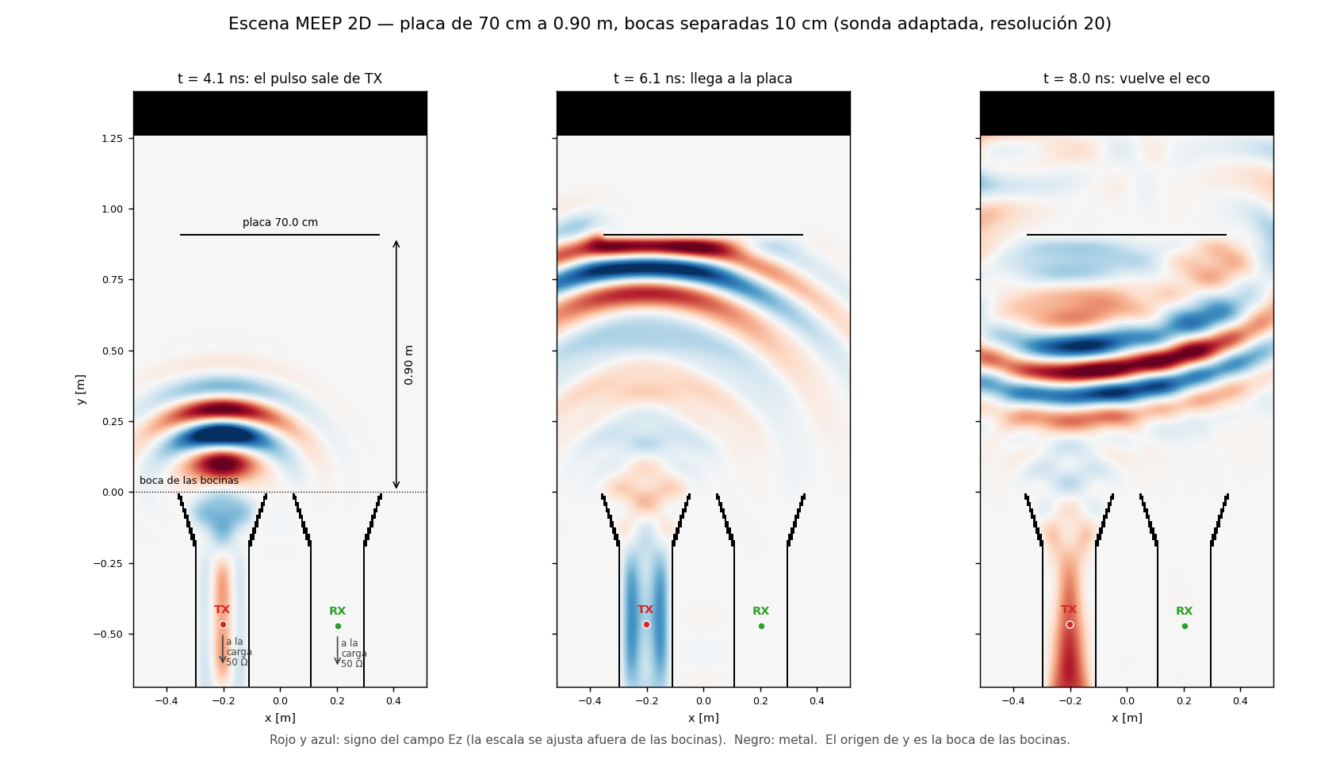
GPRv2/simulaciones_meep/salidas/placa0.90m_hueco10cm_ancho70cm/escena.png
