maledesm/gpr/GPRv2/simulaciones_meep/salidas/placa1.00m_hueco10cm_ancho70cm/barrido.png

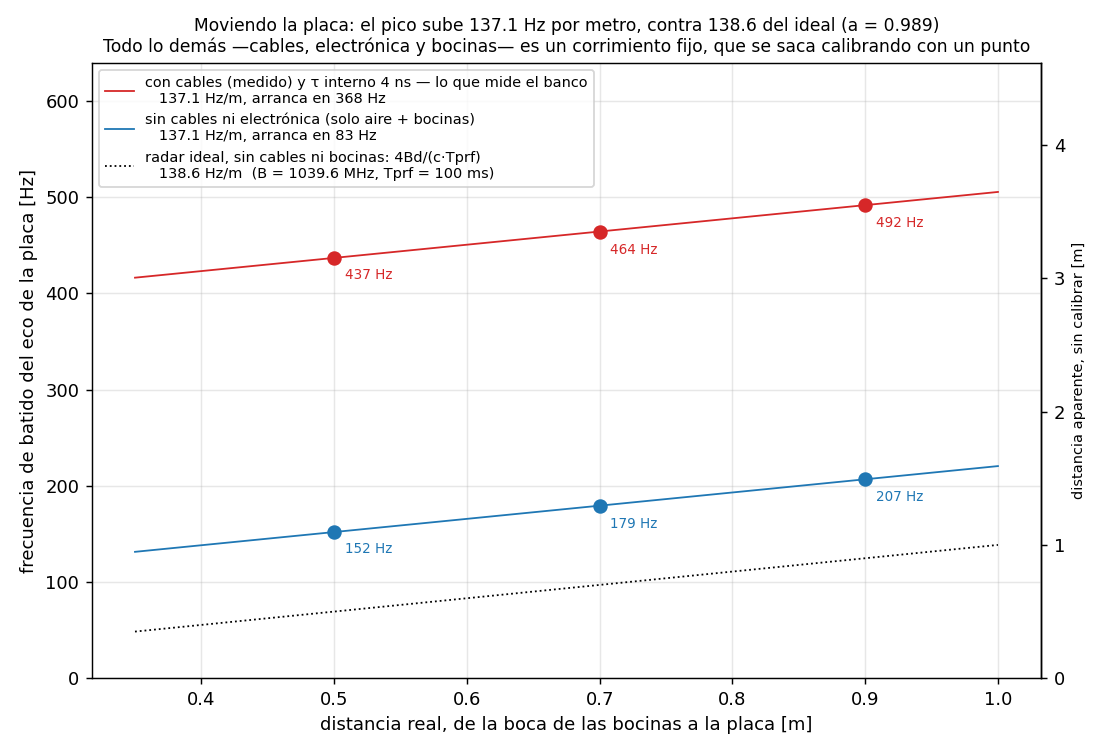
GPRv2/simulaciones_meep/salidas/placa1.00m_hueco10cm_ancho70cm/barrido.png
