maledesm/gpr/GPRv2/simulaciones_meep/salidas/placa_1.00m.png

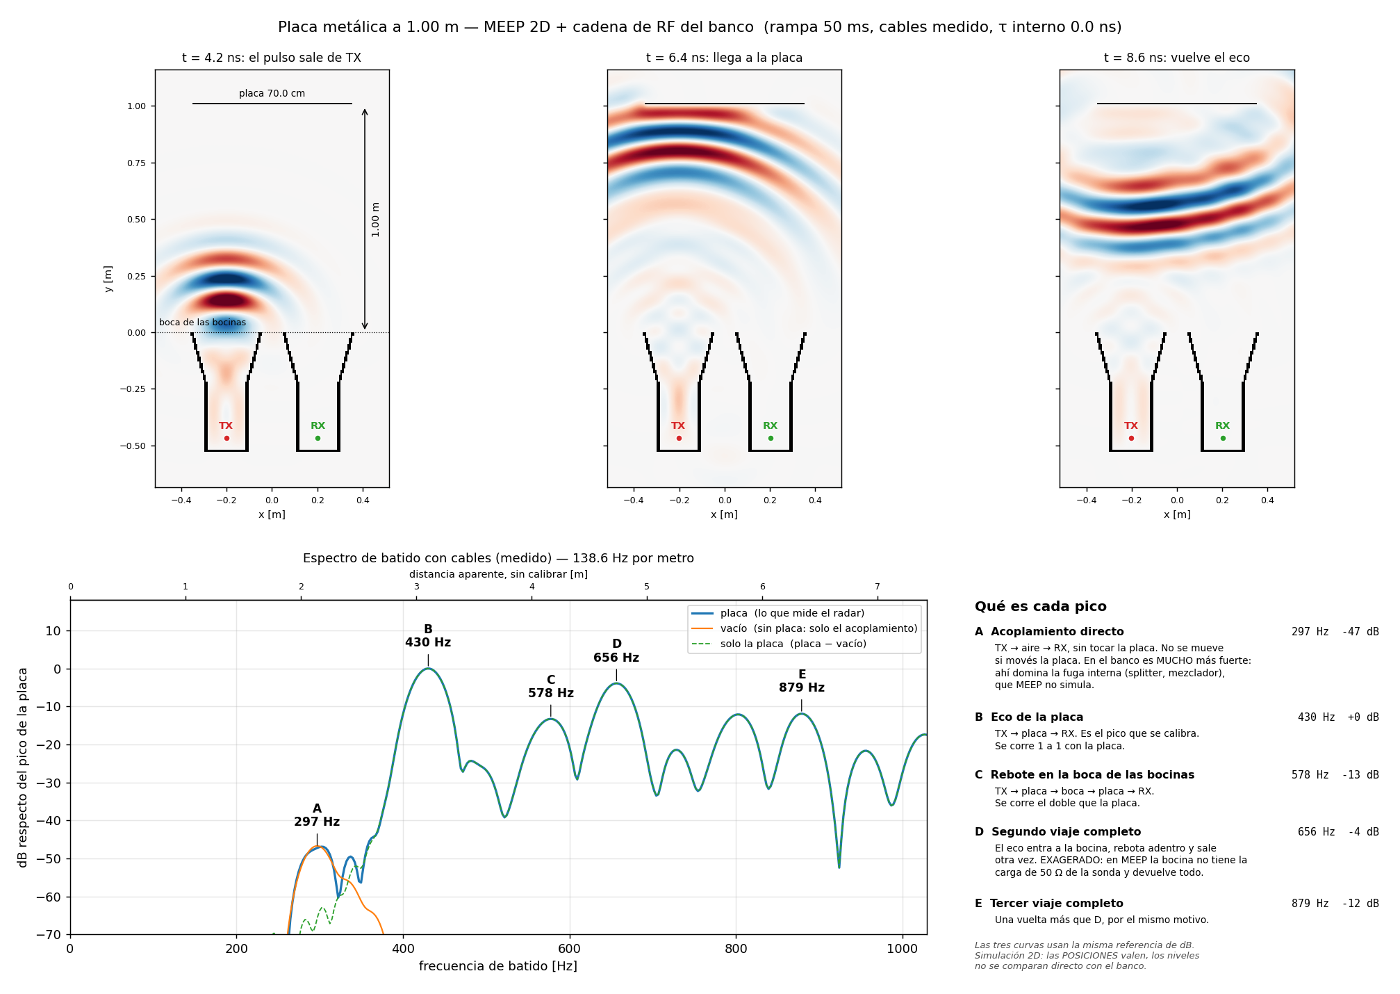
GPRv2/simulaciones_meep/salidas/placa_1.00m.png
