maledesm/gpr/VCO/comparar_vco.png

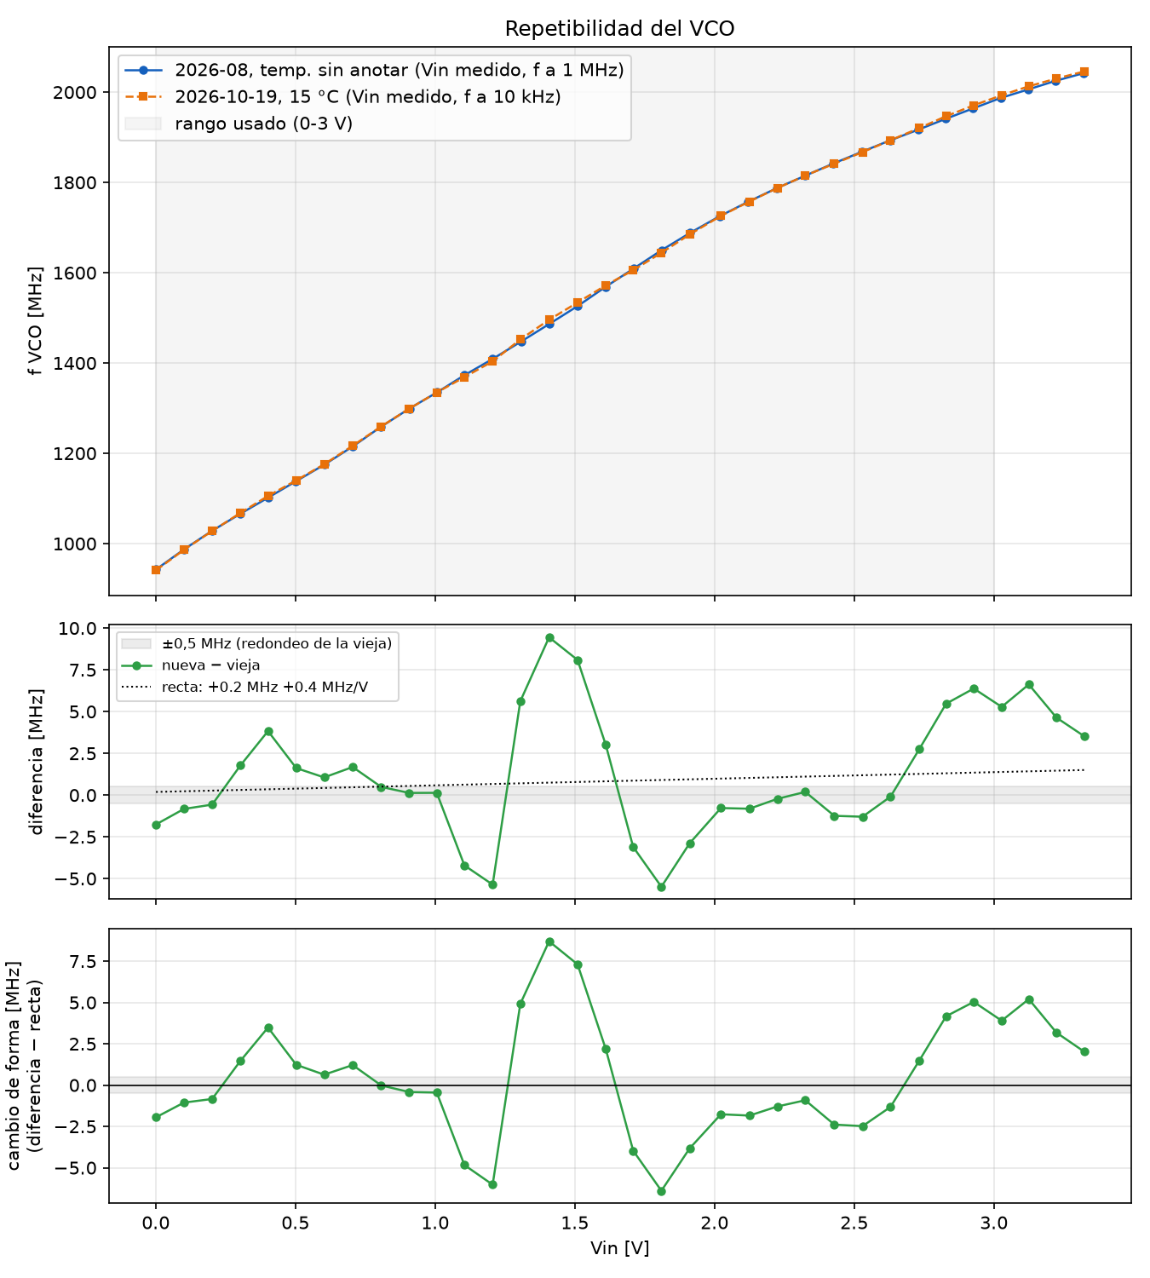
VCO/comparar_vco.png
