maledesm/gpr/VCO/Osciloscopio DAC/SDS00001.BMP

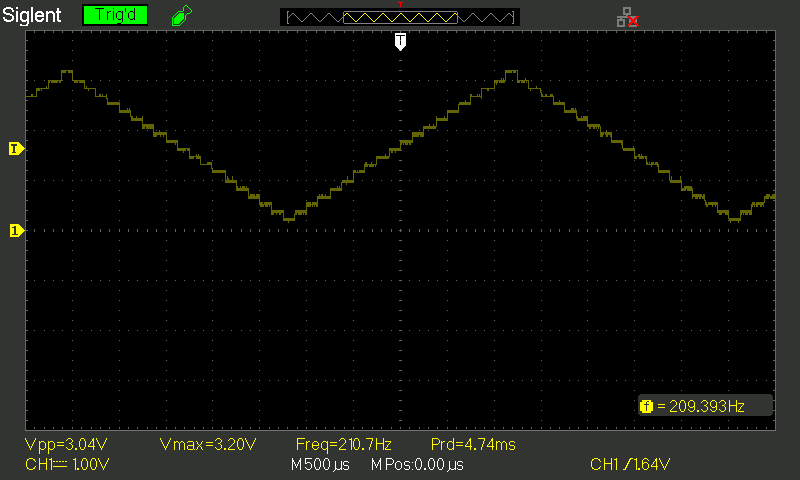
VCO/Osciloscopio DAC/SDS00001.BMP
