maledesm/gpr/redaccion/figuras/codigo/llamadas_experimento_adc3.pdf

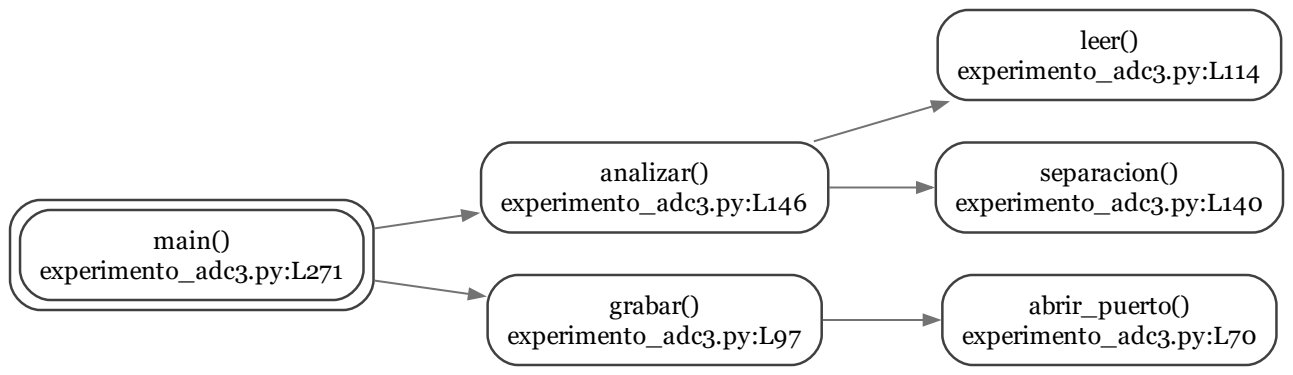
[picture p100: figure]
abrir_puerto() experimento_adc3.py:L70; analizar() experimento_adc3.py:L146; leer() experimento_adc3.py:L114; separacion() experimento_adc3.py:L140; grabar() experimento_adc3.py:L97; main() experimento_adc3.py:L271
