maledesm/gpr/GPRv2/analisis/vivo_test3.png

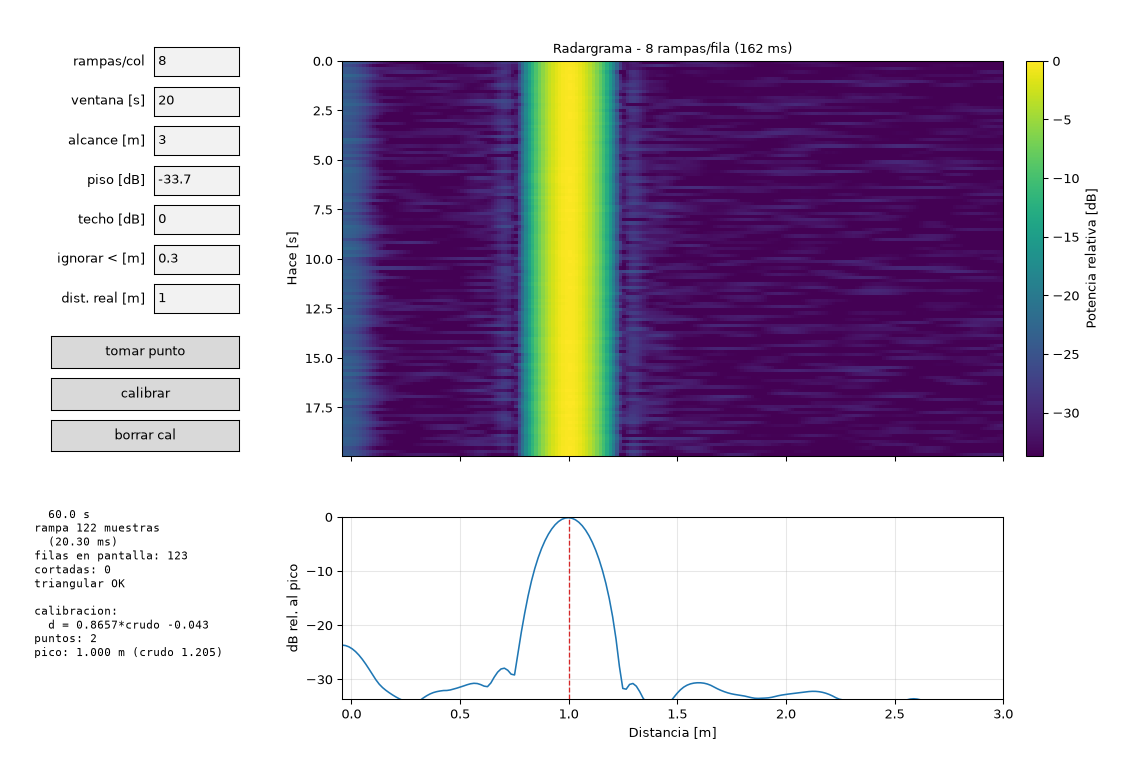
GPRv2/analisis/vivo_test3.png
