maledesm/gpr/GPRv2/docs/bitacora_vivo_rapido.html

GPRv2 · análisis · 2026-09-11

# Bitácora de vivo_rapido

Qué se cambió en el radargrama en tiempo real, por qué, cuánto ganó cada cosa y cómo se verificó que sigue midiendo exactamente lo mismo. vivo.py no se tocó.

Banco: Tprf 80 ms · 240 muestras/rampa · BW 1040 MHz · 6000 sps Máquina: Python 3.11 · numpy 1.26 · scipy 1.15 · matplotlib 3.7

Costo de un cuadro

150–206ms

antes, con 200 ms
de presupuesto

Ahora

22ms

mediana sobre 300
cuadros reales

Radargrama

7,6e−5dB

peor diferencia contra
vivo.py, sin excluir celdas

Verificación

46

comprobaciones,
todas pasan

Archivos nuevos

4

cero archivos viejos
modificados

## 01El problema, medido antes de tocar nada

No arranqué optimizando por intuición. Primero perfilé cada pieza por separado.

vivo.py redibuja cada REFRESCO_MS = 200 ms. Un cuadro costaba entre 150 y 206 ms. O sea que la ventana estaba saturada: el timer de matplotlib no llegaba, las llamadas se encimaban, y eso es exactamente lo que se ve como “va a tirones”.

Lo importante del perfilado fue la sorpresa: lo caro no era la física. El remuestreo y las FFT de todas las rampas de un cuadro sumaban ~6 ms. Los otros ~145 ms eran matplotlib repintando cosas que no cambian.

Perfilado inicial · un cuadro con ventana de 20 s

piezacosto% del cuadro

redibujar la figura entera (draw())211 ms~97 %

agrupar perfiles + pasar a dB2,5 ms1 %

remuestreo + FFT de las rampas nuevas~4 ms2 %

cada 2 s: ajuste de la triangular105 msmedio cuadro

De esos 211 ms del dibujo, ~140 son la base: los 8 cuadros de texto, los 6 botones, la colorbar, los ticks, los títulos. Nada de eso cambia entre refrescos y se repintaba entero, cinco veces por segundo. Y con la ventana en 120 s el número trepaba a 340 ms porque además hay que mapear a color una matriz de 3000×481.

El tirón periódico

ajustar_triangular() corre en el hilo del gráfico, cada REAJUSTE_S = 2 s, y cuesta 105 ms. Barre 600 períodos gruesos + 400 finos, y cada evaluación es un np.exp complejo sobre ~940 lecturas. Eso es medio refresco perdido cada dos segundos, y es el tirón regular que se nota mirando la pantalla.

## 02Los cinco cambios, ordenados por lo que aportaron

La numeración no es decorativa: es el orden real de contribución medida.

### 1 · Se dibuja sólo lo que cambia (blitting)

#### Qué pasaba

fig.canvas.draw_idle() le pide a matplotlib que repinte todo. Entre cuadro y cuadro cambian cinco cosas: la imagen del radargrama, la traza roja, la línea de la FFT, la marca del pico y dos bloques de texto. Todo lo demás —widgets, ejes, colorbar— se redibujaba idéntico.

#### Qué hice

Blitting: se esconden los artistas móviles, se dibuja una vez, se guarda una foto del fondo de cada axes con copy_from_bbox, y después cada refresco es restore_region + draw_artist + blit. La foto se vuelve a sacar sólo cuando cambia algo del fondo.

Para saber cuándo, hay dos mecanismos: _estado_estatico() devuelve una tupla con todo lo que vive en el fondo y puede cambiar (límites de ejes, clim, título, etiquetas), y se compara contra la última; y un handler de draw_event invalida la foto si cualquier otra cosa disparó un redibujado completo —por ejemplo tocar un widget o redimensionar la ventana.

Dos límites de eje tuvieron que dejar de bailar

El blitting no sirve de nada si el fondo cambia todos los cuadros, y había dos que lo hacían sin necesidad:

El eje de tiempo se fijaba en el span cargado, que crece en cada refresco mientras el buffer se llena. Ahora se fija en la ventana pedida. Lo que falta se ve como espacio vacío arriba, que es lo que realmente es. Sin este cambio no había blitting durante el primer medio minuto de cada sesión: medido, 149 ms/cuadro contra 10 ms.

El eje de la triangular se seteaba en T*1e3 con todos sus decimales, y cada reajuste mueve T unos ppm. Ahora va redondeado a 0,01 ms, así cambia sólo si T se movió de verdad.

Dibujo por cuadro

casovivo.pyrápidogano

ventana 20 s (250×481)211 ms→44 ms4,8×

ventana 120 s (3000×481)340 ms→44 ms7,7×

refotos del fondo, 300 cuadros300→20,7 %

Dónde vive: Vivo._pintar() · _sacar_fondos() · _estado_estatico() · _al_dibujar() — vivo_rapido.py:1231–1301. Si el backend no banca blit, se avisa una vez por consola y se cae solo al dibujado completo.

### 2 · No se dibujan filas ni columnas que no se ven

#### Qué pasaba

Dos derroches distintos, los dos silenciosos:

- Columnas. El eje de distancia llega hasta el Nyquist del batido —18 m con Tprf 80 ms— pero en pantalla se muestran 5. De 961 bins se dibujaban 961 y se veían ~280. El log10 y el mapeo a color se hacían sobre todos.
- Filas. Con la ventana en 120 s y rampas/fila en 1 salen 3000 filas para un radargrama de ~400 píxeles de alto. 2600 filas que no existen en la pantalla.

#### Qué hice

Se recorta a _i_alcance() antes del log10, y si las filas superan MAX_FILAS (900) se sube el agrupado —que es literalmente lo mismo que subir rampas/fila—. El panel informa el agrupado efectivo (n_ef), así que no hay magia escondida: se ve que el programa está promediando de a más.

Los dos agrupados (el que pediste vos y el de la pantalla) se hacen en un solo reshape().mean(), no en dos pasadas.

Un cambio de comportamiento, chico pero real

Sin fondo medido, el 0 dB es “el máximo de la pantalla”. Antes ese máximo se buscaba sobre todas las columnas, incluidas las que quedan más allá del alcance; ahora sólo sobre las visibles. Es más fiel a lo que dice la documentación, y en la práctica no cambia nada porque el acoplamiento directo (que suele ser el máximo) vive cerca de 0 m y siempre está adentro. Pero hay que saberlo.

Dónde vive: Vivo.matriz() — vivo_rapido.py:717. Y los índices _i_zona() / _i_alcance(), que reemplazaron a las máscaras booleanas: como eje_m_crudo es monótono, “los bins arriba de X” siempre es un tramo contiguo, así que se usan rebanadas (vistas, sin copiar) en vez de indexado booleano (que copia el array entero en cada uso).

### 3 · El remuestreo es una matriz, no un spline por rampa

#### Qué pasaba

remuestrear() arma un interp1d(kind="cubic") nuevo para cada rampa. Eso resuelve el sistema tridiagonal del spline y construye un objeto de Python, 25 o 100 veces por segundo.

#### Por qué se podía evitar

La grilla theta no cambia entre rampas: sale de eje_theta(), que sólo depende de la curva del VCO y del largo de la rampa. Y un spline cúbico con grilla de entrada y de salida fijas es un operador lineal. Si es lineal, es una matriz.

Se construye una sola vez interpolando la base canónica —o sea, pasándole la identidad a CubicSpline, que interpola por columnas—. De ahí en más cada rampa es un producto matriz-vector, y todas las rampas de un cuadro juntas son un producto de matrices que va a BLAS.

Dos cosas más entraron en el mismo producto: la ventana de Hann se pliega adentro de la matriz (ventanear es escalar cada fila) y la FFT se hace en lote con scipy.fft en float32, que a diferencia de np.fft respeta el tipo en vez de subir todo a float64.

Esto NO contradice “no cambies el interpolador”

CLAUDE.md avisa de no tocar el interpolador de remuestrear() buscando SNR. No se tocó: interp1d(kind="cubic") delega en make_interp_spline(k=3), que usa condición not-a-knot — el mismo spline que CubicSpline por defecto. Es la misma cuenta escrita de otra forma. Error relativo medido contra remuestrear(): 5,1e−16 en doble precisión, o sea el redondeo del float y nada más.

Por rampa (del script de verificación, reproducible)

piezavivo.pyrápidogano

remuestreo + FFT + ventana196 µs→17,7 µs11×

sólo el remuestreo (aislado)293 µs→13,3 µs22×

sólo la FFT (aislada)26,9 µs→5,0 µs5,4×

#### Precisión: por qué float32 no rompe nada

La matriz y la FFT van en float32, pero la resta de la media se hace en float64 y recién después se convierte. Eso importa: las muestras del PCM1808 son de 24 bits sobre una continua que puede ser grande frente al batido, y restarla en simple precisión se comería bits de la señal útil. El orden de las operaciones está elegido, no heredado.

Dónde vive: proceso_rapido.Remuestreador (proceso_rapido.py:80) · espectros() · largo_fft(). El armado en lote está en Vivo.procesar() — vivo_rapido.py:660, que también reemplazó el while por rampa: los índices de arranque se calculan de una con np.rint, las rampas se juntan con una sola indexada, y las bajadas se dan vuelta con S[impar] = S[impar, ::-1].

### 4 · El ajuste de la triangular ya no congela la ventana

#### Qué pasaba

1000 evaluaciones de |Σ v·exp(−2πi·t/T)| sobre ~940 lecturas, en el hilo del gráfico, cada 2 s. 105 ms.

#### Qué hice

Tres cosas, ninguna cambia qué se maximiza, sólo cómo se busca el máximo:

1. La pasada gruesa va vectorizada. Una matriz de fases y dos productos con cos/sin reales, en vez de 600 vueltas de intérprete con np.exp complejo. Se calcula |S|² para ahorrar la raíz —el argmax es el mismo— y va por bloques de 256 períodos para acotar la memoria.
2. La cantidad de pasos sale de los datos. El lóbulo principal en T tiene ancho relativo 1/N_períodos: a medio lóbulo, la fase del borde de la ventana ya se corrió π. Con 8·span·N_períodos puntos hay 4 puntos por lóbulo, o sea que es imposible saltearlo. Los 600 fijos derrochaban con Tprf largo y se habrían quedado cortos si alguna vez se agranda la ventana de ajuste.
3. La pasada fina es sección áurea. 32 evaluaciones en vez de 400. El intervalo de arranque es ±1 paso grueso alrededor del argmax, que es medio lóbulo, o sea unimodal por construcción. Cada vuelta lo achica 0,618, así que 32 vueltas lo dividen por 3e−7.

Ajuste de período y fase, por caso

Tprf · spanvivo.pyrápidogano

80 ms · 1 % (el reajuste normal)47,7 ms→2,5 ms19×

80 ms · 10 % (el primer ajuste)48,5 ms→2,5 ms19×

12,5 ms · 10 % (el caso más caro)47,3 ms→8,9 ms5,3×

Y lo que importa: el período coincide con el original dentro de 4,6 ppm y el vértice dentro de 11,4 µs. Una muestra a 6000 sps son 167 µs, así que el desacuerdo es 1/15 de muestra.

Dónde vive: ajustar_triangular_rapido() (proceso_rapido.py:203) · _pot_armonico() · _maximo_aureo(). El signo de la fase se copió tal cual del original, incluido el comentario: invertirlo devuelve T−t0 en vez de t0 y agarra la bajada creyendo que es la subida.

### 5 · Las cuentas no se repiten

#### Qué pasaba

_poner_estado() llamaba a pico_crudo(), hay_blanco() y energia_actual_db() varias veces cada uno, y cada uno de esos vuelve a promediar cientos de perfiles. Contando, salían nueve veces el mismo promedio por cuadro. Lo mismo con saturacion() y _volts(), que convertían la lista de la triangular a array tres veces.

#### Qué hice

Un diccionario self._cache que se vacía en la primera línea de _actualizar(). Cada cantidad derivada se calcula una vez por cuadro. _zona_util(), que era una máscara booleana recalculada en cada uso, pasó a ser un índice cacheado.

Dónde vive: perfil_actual() · energia_actual_db() · pico_crudo() · _tri_arrays(). El cache se invalida a mano en _escribir() y en los botones que cambian la zona útil o la calibración.

#### Y dos limpiezas menores del mismo tipo

- El parseo del puerto: se decodifica el bloque entero de una vez en vez de línea por línea, y se sacó la regex del camino caliente —la línea de muestra se reconoce por el primer carácter y se valida con el int() que hace falta igual—. 12,4 ms → 6,5 ms por segundo de stream. No era un cuello de botella, pero el hilo del puerto le pelea el GIL al del dibujo.
- La ventana de ajuste: se recortaba sacando de a uno del principio de una lista (pop(0), cuadrático). Ahora se busca el corte con searchsorted y se rebana de una.

## 03Lo que además se agregó

Dos cosas que no son rendimiento sino medición. Las dos son opcionales y no cambian el camino por defecto.

### Pico sub-bin

El argmax de la FFT devuelve un entero, así que la distancia informada queda cuantizada al paso de la grilla. Pero la posición verdadera del pico está escrita en su forma: si el vecino derecho quedó más alto que el izquierdo, el máximo real está corrido a la derecha, y cuánto lo dice cuánto más alto.

Por tres puntos pasa exactamente una parábola. Se toma su vértice:

δ = 0,5·(a − c) / (a − 2b + c)      a, b, c = los tres valores en dB

En dB y no en lineal porque cerca del máximo la respuesta de una ventana de Hann es casi una parábola en dB.

Relleno | Paso de grilla | SNR | Sólo argmax | + parábola
×8 (actual) | 1,80 cm | 40 dB | 0,44 cm | 0,01 cm
×8 | 1,80 cm | 20 dB | 0,45 cm | 0,09 cm
×8 | 1,80 cm | 10 dB | 0,54 cm | 0,29 cm
×4 | 3,61 cm | 20 dB | 0,92 cm | 0,09 cm
×1 | 14,42 cm | 20 dB | 3,67 cm | 0,18 cm

Mirá la última columna: con parábola, el relleno casi no importa. Con SNR de 10 dB el error se clava en 0,29 cm con cualquier relleno, porque ahí el límite es el ruido y no la grilla.

Resolución y precisión no son lo mismo

Resolución = c/(2·BW) = 14,4 cm: qué tan cerca pueden estar dos blancos y seguir siendo dos. Esto no lo cambia nada salvo más ancho de banda del VCO, y sigue siendo cierto todo lo que dice CLAUDE.md al respecto.

Precisión = con qué exactitud ubicás el centro de un blanco aislado. Eso es lo que mejora. Si hay dos blancos adentro de una celda de resolución, la parábola devuelve el centro del bulto, que no es ninguno de los dos.

Se usa sólo en pico_crudo(), o sea en el número del panel y en tomar punto. La imagen del radargrama no la toca. Donde más se nota es calibrando: como el offset de cables es un ajuste de un solo punto, todo el error de ese punto se va derecho al b de la calibración.

Un caso que hubo que blindar

Con el fondo restado, np.maximum(p − fondo, 0) puede dejar un vecino del máximo en cero exacto. Ese cero entra a la fórmula como −600 dB y empuja el pico media grilla para el otro lado. Si algún vecino se anuló, pico_parabolico() devuelve 0 y se queda con el centro del bin — que es lo que había antes de interpolar.

### Fondo automático (MTI)

Botón fondo auto o tecla f. Un promedio exponencial del perfil (τ = TAU_MTI = 30 s) que se resta solo. Es el background removal clásico de GPR, o sea un pasaaltos en tiempo lento, y no necesita sala vacía.

Dicho con precisión: al prenderlo, todo lo que hay en ese momento pasa a ser fondo y se va de la pantalla. Lo que aparece o se mueve después salta, y se desvanece de vuelta en ~τ si se queda quieto. Sirve para “mover la placa y mirar”, no para medir algo que ya estaba y no se mueve — para eso sigue estando medir fondo, que lo congela.

La puerta de detección tuvo que cambiar, y es importante

Con el fondo congelado, la puerta compara la energía cruda contra la del fondo. Eso es lo correcto ahí y está justificado en CLAUDE.md: “la energía medida supera a la del fondo por un margen” es literalmente eso.

Con el fondo automático no sirve: el fondo persigue a la señal, así que esas dos energías son la misma por construcción y el cociente daría 0 dB con blanco y sin blanco. Con MTI la puerta mide el residuo (lo que queda después de restar) contra el fondo, que es exactamente “cuánto de lo que veo es nuevo”. Ese cociente es mucho más chico, así que el margen arranca en MARGEN_MTI = −20 dB en vez de +6.

#### Probado contra una escena sintética

Eco fijo en 2,0 m siempre; placa que aparece a los 20 s en 1,20 m y se aleja hasta 2,80 m. MTI prendido a los 15 s, cuando sólo estaba el eco fijo.

t [s] | Energía del residuo | ¿Blanco? | Pico | Qué hay
15,1 | −65,8 dB | no | — | sólo el eco fijo (absorbido)
20,1 | −29,1 dB | no | — | la placa recién aparece
25,1 | −3,5 dB | SÍ | 1,20 m | placa a 1,20 m
40,1 | −11,9 dB | SÍ | 1,76 m | alejándose
55,2 | −4,2 dB | SÍ | 2,54 m | alejándose

El eco fijo de 2,0 m nunca dispara la puerta, y la traza sigue la placa aun cuando le pasa por encima.

Dónde vive: _actualizar_mti() (vivo_rapido.py:917) · _alternar_mti() · la rama de self.mti en matriz() y en energia_actual_db(). El lote entero se aplica de una: aplicar el promedio m veces con constante α equivale a aplicarlo una vez con 1 − exp(−m·Δt/τ).

### Captura PNG para el informe

Cuadro de texto captura + botón guardar captura PNG, o la tecla s. Se tipea un nombre —placa_1m, sala_vacia— se aprieta, y queda en datos/capturas/<nombre>.png.

Cuatro decisiones, cada una por un motivo:

- El nombre se lee en el momento de apretar, de caja_nombre.text, no del callback de submit. Así alcanza con tipearlo: no hace falta acordarse de apretar Enter antes del botón.
- Nunca sobrescribe. Si placa_1m.png ya existe, el siguiente sale placa_1m_2.png. Guardar dos veces con el mismo nombre pasa todo el tiempo, y perder la primera captura en silencio sería peor que tener dos archivos. Los caracteres que Windows no acepta (\ / : * ? " < > |) se reemplazan por _.
- 200 dpi sobre una figura de 14×8 pulgadas: ~2190×1509 px, ~180 KB. Entra holgado en una página de tesis sin verse pixelado.
- Se recorta la columna de controles. 9 cuadros de texto y 8 botones no pintan nada en un informe, y todo lo que importa de la configuración queda igual adentro de la imagen.

La figura se explica sola

Eso es lo que hace que la captura sirva seis meses después. Adentro del recorte quedan: la escala de color (en la colorbar), el alcance (en el eje x), y en el cuadro de la derecha el Tprf, el largo de rampa, la fs, la BW, el alpha0, la resolución de bin, el alcance no ambiguo, los Hz por metro, la amplitud de la triangular, si está recortada contra el riel del ADC, el estado del fondo y el agrupado efectivo. No hay que anotar nada aparte.

#### Dos cosas que hubo que resolver

El recorte se mide, no se hardcodea. Un rectángulo fijo cortaba el rótulo Hace [s] del radargrama. Ahora sale de la unión de los get_tightbbox() de los cinco paneles —que incluyen ticks, rótulos y títulos— más un margen. Si algún día se mueve un axes, el recorte se acomoda solo.

Los controles se esconden mientras se guarda, en vez de confiar en que el recorte los deje afuera. Un aviso largo del texto de estado (punto 1: crudo 1.199 m -> real 1.200 m) se desborda de su propio axes y se metía por el borde izquierdo de la captura. Escondidos no pueden aparecer, midan lo que midan. savefig() redibuja por su cuenta, así que basta con taparlos durante la llamada.

Dónde vive: guardar_captura() · _recorte_captura() — vivo_rapido.py. Constantes: DPI_CAPTURA, RECORTE_CAPTURA, MARGEN_CAPTURA, NOMBRE_CAPTURA_DEF. Con RECORTE_CAPTURA = None se guarda la ventana entera, controles incluidos.

#### El cuadro de información no entraba

Al agregar ms/cuadro, agrupado ef. y el modo del fondo, el panel pasó de 31 a 39 líneas y la última se salía del marco —vivo.py ya avisaba de esto en un comentario, con menos líneas—. Entre ese cuadro y la triangular había 0,14 de figura sin usar. El panel ahora baja hasta y=0.33 en vez de 0.42, a 7 pt con interlineado 1,15. No se sacó ningún dato y no hizo falta achicar la letra hasta lo ilegible.

### La FFT de cada captura, en CSV

Agregado el 2026-09-22. Junto a cada PNG se guarda datos/capturas/<nombre>.csv con la FFT que se está viendo, para poder sacar la curva y superponerla con una simulación de simulaciones_meep/ o con otra captura, sin digitalizar la figura. La simulación usa la misma cadena —Hann, relleno ×8, eje en Hz con la distancia aparente sin calibrar—, así que las columnas se comparan directo.

- Siempre en par con la PNG. Si existe cualquiera de los dos, los dos van a _2: si no, una PNG vieja podría quedar al lado de una CSV nueva con el mismo nombre y parecerían la misma captura sin serlo.
- Todo el eje, hasta el Nyquist (1201 bins con rampas de 50 ms), no sólo lo que entra en pantalla: una simulación puede querer mirar más allá del alcance.
- Sólo la curva de ese momento. No el promedio de la ventana ni el fondo: eso serían otras curvas. La que se ve, y nada más.
- Magnitud lineal además de dB, a propósito. Los dB de la pantalla están referidos a algo que cambia —el máximo de la matriz visible, o el pico del fondo—, así que dos capturas en dB de pantalla no se pueden comparar entre sí. La magnitud lineal sí, dentro del mismo banco.
- El encabezado trae el estado del banco: Tprf, muestras por rampa, nfft, BW, alpha0, Hz por metro, cuántas rampas se promediaron, calibración, fondo, qué vale 0 dB, el pico y la corrida de la que salió. El archivo se explica solo, igual que la PNG.

Columna | Qué es
f_hz | frecuencia de batido, centro del bin
d_crudo_m | distancia aparente sin calibrar — la de la simulación
d_cal_m | distancia calibrada, a·d_crudo + b
mag | |FFT| lineal de la curva que se está viendo, con el fondo ya restado si había
db_pantalla | la misma curva en dB, exactamente como se ve
db_norm | 0 dB en el máximo de la propia curva, para superponer

La fila de nombres va primero, y no es un capricho

La primera versión ponía los metadatos arriba, como es costumbre. El test la agarró: numpy.genfromtxt(names=True) toma los nombres de columna de la primera línea del archivo aunque sea un comentario, así que leía GPRv2 - FFT de una captura como nombre. Con los nombres primero y los # después se lee sin ningún parámetro raro con cualquiera de estas:

pd.read_csv(ruta, comment="#")
np.genfromtxt(ruta, delimiter=",", names=True)
np.loadtxt(ruta, delimiter=",", skiprows=1)
meta, c = proceso_rapido.leer_fft_captura(ruta)   # + los metadatos

Dónde vive: el formato, escritura y lectura juntas, en proceso_rapido.escribir_fft_captura() / leer_fft_captura() — ese módulo no importa ni serial ni widgets, así que un script de simulación lo puede usar sin arrastrar el programa en vivo. El armado de los datos, en Vivo._guardar_fft(). Entra a git con la PNG (!GPRv2/datos/capturas/*.csv en el .gitignore).

### Por defecto ya no se graba la corrida entera

Cambiado el 2026-09-28. La captura cruda son 4,1 MB por minuto y se hacía pesada en disco y en git. Con GRABAR_CRUDO = False no se crea ningún archivo de corrida —ni vacío— y de una sesión queda sólo lo que se guardó con el botón: su PNG y su CSV de FFT, que salen de los perfiles que están en memoria. El panel lo dice en la línea crudo a disco.

Lo que se pierde

Sin el crudo esa medición no se puede volver a analizar con graficar_captura.py ni waterfall.py, ni reprocesar con otro Tprf o con otra corrección. Queda la figura y la curva del momento en que se apretó, nada más. Para una sesión de la que se quiera poder volver atrás, GRABAR_CRUDO = True.

Grabar no era lo que trababa el programa

Medido antes de tocar nada: escribir un bloque cuesta 0,014 ms (p99 0,072 ms, máximo 0,15 ms), o sea el 0,01 % del tiempo — y además pasa en el hilo del puerto, no en el del gráfico, así que ni siquiera compite con el dibujo. El cambio se hizo igual porque 4,1 MB/min es mucho para el disco y para el repo, pero si la ventana se traba, el número a mirar es ms/cuadro en el panel.

### Captura con temporizador

Agregado el 2026-09-28. El cuadro esperar [s]. En 0 la captura sale en el acto, como siempre; con 5, 10 o lo que se tipee, el botón (o la tecla s) arranca una cuenta regresiva y la foto sale al final. Es para apretar, caminar hasta el blanco, y que la figura salga con uno ya fuera del camino.

- Mientras corre, un cartel rojo grande sobre el radargrama dice CAPTURA EN N s, para poder leerlo desde donde uno esté parado. Va arriba, sobre las filas más viejas: no tapa lo que está entrando.
- Apretar de nuevo cancela. Es lo primero que uno intenta cuando se arrepiente, y sin eso habría que esperar la foto o cerrar el programa.
- El cartel se apaga antes de guardar, así que no sale en el PNG.
- El disparo cae dentro de los 200 ms del refresco. Medido: +16 ms sobre 2 s pedidos.

Dos bugs que destapó el test, los dos del blitting

_sacar_fondos() volvía a prender todos los artistas móviles después de fotografiar el fondo. Con el cartel de la cuenta —que vive escondido casi siempre— eso lo dejaba pegado en la pantalla después de cada recaptura, con el texto viejo, o como un recuadro rojo vacío si nunca había contado. Ahora recuerda cómo estaba cada uno y repone eso.

Y guardar_captura() no escondía el cartel por su cuenta: llamándola con la cuenta en pantalla, el cartel salía en el PNG (84.000 píxeles rojos en la prueba). Ahora lo esconde ella también, venga de donde venga.

### Dos bugs arreglados

El aviso que nunca se veía. TextBox.set_val() dispara el callback de submit, o sea vuelve a entrar a _escribir(), que pone self.aviso = "". Por eso el mensaje de medir fondo no llegaba a la pantalla: _medir_fondo() lo escribe, llama a _refrescar_cajas() —que mueve piso y techo— y el aviso se borra antes de dibujarse. _refrescar_cajas() ahora lo guarda y lo repone. vivo.py todavía lo tiene.

Y uno que me había metido yo

matplotlib se reserva teclas sueltas para sus propios atajos: f es pantalla completa y s abre su diálogo de guardar. Cuando agregué f para el fondo automático, apretarla prendía el MTI y ponía la ventana en pantalla completa al mismo tiempo. Ahora se les saca la tecla suelta en armar_figura() y se les deja el atajo con ctrl, que sigue andando. Además, _tecla() ignora todo mientras se está tipeando en el cuadro del nombre — si no, escribir fondo_sala prendía el MTI con la f y guardaba una captura con la s.

## 04La verificación

Todo lo de arriba toca el camino de la medición. Sin una prueba de equivalencia, no vale.

verificar_rapido.py corre sin hardware. Arma un stream sintético —las mismas líneas de texto que emitiría la placa, con blancos de distancia conocida— y lo pasa por los dos programas enteros, no por funciones sueltas. Son 46 comprobaciones y tardan un minuto.

python analisis/verificar_rapido.py

Qué NO se pudo verificar, y por qué

No hay ninguna captura real del ESP32 en la máquina. Lo busqué por tres lados: GPRv2/datos/ está vacío, no hay ningún captura.csv ni triangular.csv en todo el disco, y en el historial de git nunca entró uno —están en .gitignore—. El único archivo de datos/ que sí estuvo commiteado es calibracion_distancia.json, y el commit ce8b125 lo borró justamente por ser falso: una prueba sintética lo había escrito con a=0.8657.

Así que todo lo de abajo está verificado contra streams sintéticos con blancos de distancia conocida, que es un control más estricto que una medición real (se sabe la respuesta exacta), pero no reemplaza la primera corrida en el banco. La sección 07 dice qué mirar ahí.

#### Nivel 1 · las piezas

Equivalencia numérica, pieza por pieza

qué se compararesultado

remuestreo vs remuestrear(), float645,1e−16rel.

remuestreo vs remuestrear(), float321,8e−07rel.

ventana plegada vs ventanear después1,8e−07rel.

|FFT| del lote vs una por una1,7e−07rel.

período del ajuste≤ 4,6ppm

fase (vértice) del ajuste≤ 11,4µs

muestras y lecturas que saca el lectoridénticas

#### Nivel 2 · de punta a punta, con los mismos límites de rampa

Se le imponen a los dos el mismo T y el mismo t0, o sea exactamente las mismas muestras entrando a cada FFT. Acá no queda ninguna excusa:

El resultado que importa

Peor diferencia: 7,63e−05 dB sobre las 62×280 celdas del radargrama, sin excluir ninguna. Eso es el ruido del float32, no una diferencia de método.

#### Nivel 3 · dejando que cada uno ajuste el período solo

Acá sí aparece una diferencia, y hay que entenderla bien porque a primera vista asusta. Los dos ajustes del período son estimaciones con su propio ruido, y difieren en 0,35 muestra en la posición del vértice. Un corrimiento sub-muestra del límite de rampa no mueve los picos pero sí mueve los nulos profundos de la FFT, que son celdas 40 dB debajo del pico.

Para decidir si esa diferencia es “del código nuevo” o es el ruido de estimación que los dos tienen, el test hace un control: corre vivo.py contra sí mismo con ese mismo corrimiento de vértice.

Diferencia en celdas por encima de −30 dB

comparaciónpeor dif.

rápido vs original0,641 dB

original vs SÍ MISMO, mismo corrimiento0,845 dBcontrol

El control difiere más que el código nuevo. O sea que la diferencia no es atribuible al rewrite: es el ruido del ajuste, que ya estaba.

#### Nivel 4 · el número que se informa

Blanco sintético a 1,200 m:

Distancia informada

programainformaerror

vivo.py1,2067 m0,67 cm

vivo_rapido.py (sub-bin)1,1994 m0,06 cm

#### Nivel 5 · lo que queda en disco

Los niveles anteriores comparan lo que el lector le pasa al gráfico. Esto compara lo que queda escrito, que es otra cosa y es la que importa después: los dos programas sobrescriben el mismo datos/captura.csv y datos/triangular.csv, y de ahí comen graficar_captura.py y waterfall.py. Si el formato cambiara aunque sea en un byte, las capturas nuevas no se podrían reanalizar con los scripts de siempre.

Archivos escritos por cada programa, mismo stream

archivoresultado

captura.csvidéntico1 496 156 B

triangular.csvidéntico50 903 B

Byte a byte, sin excepciones.

#### Nivel 6 · reanálisis offline de una captura del programa nuevo

Esto responde la pregunta que de verdad importa: si grabo con el programa nuevo, ¿después puedo usar la captura?

Se toma el archivo que dejó vivo_rapido.py y se corre encima la cadena vieja entera —rampas_desde_triangular(), remuestrear(), perfil_distancia(), todas de correccion_no_linealidad.py, sin tocar—. Después se llaman los dos scripts de análisis tal como están.

Blanco sintético a 1,200 m

qué correresultado

pandas lee el CSV150 000 × 2+4688 tri

la cadena vieja encuentra el blanco1,153 m624 rampas

waterfall.pycorresin errores

graficar_captura.pycorresin errores

Los 1,153 m contra 1,200 son un tercio de bin: la cadena vieja usa perfil_distancia(), que no rellena con ceros, así que su grilla va de a 14,4 cm. Es su comportamiento documentado, no un problema de la captura.

Un hallazgo lateral, que no es mío pero conviene tener anotado

waterfall.py se cae si no se lo corre parado en GPRv2/analisis/: hereda de correccion_no_linealidad.py rutas relativas al directorio actual y no al archivo, así que no encuentra la curva del VCO. Está anotado en CLAUDE.md pero la prueba lo destapó en la práctica. graficar_captura.py no tiene el problema porque usa os.path.dirname(__file__). El test entra a analisis/ antes de llamarlo, igual que haría uno a mano.

#### Nivel 7 · el botón de captura

- El cuadro de información entra en su marco en el caso de más líneas (39, con fondo medido).
- Los 17 controles no se pisan entre sí, no se salen de la figura y no tapan el texto de estado.
- Guardar dos veces con el mismo nombre da dos archivos, no uno pisado.
- Un nombre con caracteres prohibidos se sanea; uno vacío cae al nombre por defecto.
- Los cuatro PNG salen a 200 dpi, el más chico de 173 KB.

#### Nivel 8 · la FFT de la captura

Se corre con el banco actual (Tprf 100 ms, 300 muestras por rampa) y se prueba lo que haría quien use el archivo:

Blanco sintético a 1,50 m, otro a 3,20 m

qué se compruebaresultado

db_pantalla contra la curva que se ve5e−8 dBsin y con fondo

el blanco en la CSV1,495 m207 Hz

lectores: pandas, genfromtxt, loadtxt, propiolos 4sin parámetros

par PNG + CSV, saltando una CSV sueltaOK

tamaño112 KB1201 bins

Regla de trabajo

Cuando se toque cualquiera de los dos programas, correr verificar_rapido.py antes de llevarlo al banco. Es un minuto, son 46 comprobaciones y cubre todo el camino de la medición, incluido que la captura siga siendo reanalizable. Corre desde cualquier directorio.

## 05Mapa del código

Cuatro archivos nuevos. Ninguno viejo modificado, salvo CLAUDE.md, que sólo creció.

analisis/vivo_rapido.py1593 líneas El programa. Misma ventana, mismos controles, mismo CSV, mismo calibracion_distancia.json que vivo.py — una calibración tomada con uno sirve para el otro. Clases: Lector (hilo del puerto), Calibracion, Vivo (el resto).

analisis/proceso_rapido.py277 líneas Las primitivas de proceso, separadas justamente para poder testearlas contra las originales: Remuestreador, espectros(), largo_fft(), ajustar_triangular_rapido(), pico_parabolico(). No importa nada de vivo_rapido, así que waterfall.py y graficar_captura.py podrían adoptarlo después sin arrastrar nada.

analisis/verificar_rapido.py493 líneas La prueba de equivalencia y el banco de medición. Corre sin hardware. Incluye generar_stream(), que fabrica el stream sintético con la no linealidad real del VCO, y correr(), que maneja los dos programas enteros con el mismo tamaño de bloque que tendrían en vivo.

vivo_rapido.bat— Doble click, igual que vivo.bat. Busca el mismo venv gpr-win.

#### Constantes nuevas, todas al principio de vivo_rapido.py

Constante | Valor | Qué hace
MAX_FILAS | 900 | tope de filas que se le mandan a la pantalla; arriba de eso sube el agrupado
CADA_INFO | 3 | refrescos entre dos actualizaciones del cuadro de info (31 líneas de monoespaciada)
CADA_TRI | 3 | ídem para la triangular plegada (~940 puntos)
TAU_MTI | 30 s | constante de tiempo del fondo automático
MARGEN_MTI | −20 dB | margen de la puerta cuando el fondo es automático
USAR_BLIT | True | se apaga solo si el backend no lo banca
RAMPAS_POR_CUADRO | 512 | tope por cuadro, por si hubo un parate largo
capturas
DPI_CAPTURA | 200 | ~2190×1509 px; 300 si hace falta imprimir grande
RECORTE_CAPTURA | "paneles" | o None (ventana entera), o una tupla de fracciones
MARGEN_CAPTURA | 0,10 in | para que ningún rótulo quede pegado al borde
NOMBRE_CAPTURA_DEF | "captura" | si el cuadro del nombre queda vacío

#### Controles nuevos

- Cuadro de texto captura (el noveno) y botón guardar captura PNG (el primero de la columna).
- Botón fondo auto (MTI).
- Teclas: e eje, a autoescala, f fondo auto, s captura, q salir. f y s se le sacan a matplotlib en armar_figura(); los atajos con ctrl siguen andando.

#### Lo nuevo en el panel de la derecha

- ms/cuadro — si se acerca a REFRESCO_MS (200), bajar la ventana o subir rampas/fila. Antes había que adivinarlo.
- agrupado ef. — el agrupado real, que puede ser mayor que rampas/fila si entró la decimación de pantalla.
- modo en la sección de fondo — congelado o AUTO (MTI).

Son 39 líneas cuando hay fondo medido. El cuadro se agrandó hacia abajo (de y=0.42 a y=0.33) para que entren.

#### Rendimiento real, sobre 300 cuadros de una sesión simulada de 60 s

Distribución del costo de un cuadro

estadísticoms

mediana2211 % del presupuesto

percentil 95 (después del arranque)4422 %

los ~20 primeros cuadros130–188arranque

Los cuadros lentos son sólo los del arranque, mientras se arma la figura y se saca la primera foto del fondo. Después queda plano.

## 06Lo que no hice, y por qué lo propongo

Cinco cosas que quedaron identificadas pero sin implementar, ordenadas por lo que aportarían a la medición.

### 1 · Guardar perfiles complejos en vez de magnitudes

Es el cambio con más potencial y hoy está explícitamente bloqueado en CLAUDE.md: “lo que se guarda son magnitudes de FFT, no complejos, o sea que no hay cancelación coherente posible”. Guardando complex64 se habilitan dos cosas:

- Resta de fondo coherente — cancela el acoplamiento directo de verdad, en vez de restarlo en amplitud con piso en cero.
- Promediado coherente entre rampas — +3 dB por duplicación en vez de +1,5 dB. Con 8 rampas/fila eso son 4,5 dB de SNR regalados.

Cuesta el doble de memoria por perfil y hay que verificar primero que la fase repite entre rampas. Con el troceo actual debería, pero es medible antes de comprometerse: correlacionar rampas consecutivas y mirar la fase del pico.

### 2 · Ventana de Hann → Blackman-Harris, seleccionable

El acoplamiento directo TX→RX es lo más fuerte de la pantalla y vive cerca de 0 m. El primer lóbulo lateral de Hann está a −31 dB: un blanco débil a 1 o 2 m puede estar sentado adentro de ese faldón. Blackman-Harris lo baja a −92 dB a cambio de un lóbulo principal más ancho. Son tres líneas y sospecho que en el banco se nota.

### 3 · Bajar RELLENO de 8 a 4

Con el pico sub-bin, el relleno ya no compra precisión (ver la tabla de la sección 03): sólo suavidad del dibujo. Con ×4 el radargrama se sigue viendo bien y se ahorra la mitad de memoria por perfil y la mitad de FFT. Gratis.

### 4 · CFAR por bin para la traza roja

Hoy la traza marca una fila si su pico se despega TRAZA_MIN_DB = 3 dB de la mediana de esa fila. Un CFAR de promedio de celdas daría un umbral adaptativo por bin, que es lo estándar y es más robusto cuando el piso no es plano a lo largo del eje.

### 5 · Trama binaria en el firmware

El stream ASCII son ~78 kB/s a 6000 sps. Binario sería ~2,5× menos ancho de banda de USB y cero parseo. Pero cambia el formato del CSV, así que rompería graficar_captura.py, waterfall.py y todas las capturas viejas. Es el más invasivo y el que menos aporta hoy.

Mi orden

2 y 3 ya — son baratos y uno puede destapar blancos que hoy no se ven. 1 cuando quieras sacarle SNR de verdad, midiendo antes la coherencia. 4 y 5 después.

## 07Qué mirar la primera vez en el banco

Cosas que el test sintético no puede cubrir.

- Que el blitting arranque. Si el backend no lo banca, sale un aviso por consola y sigue andando con el dibujado completo. Si aparece ese aviso, el programa funciona igual pero no vas a ver la mejora.
- ms/cuadro en el panel. Debería quedar en 20–45 después de los primeros segundos. Si se queda arriba de 100, algo está forzando refotos del fondo todo el tiempo y quiero saberlo.
- El espacio vacío arriba del radargrama mientras se llena la ventana es intencional, no un bug. Antes el eje se estiraba; ahora está fijo en la ventana pedida.
- Los dos programas escriben el mismo datos/captura.csv y lo sobrescriben. No los corras a la vez.
- La primera vez, corré los dos sobre la misma escena (uno después del otro, con la placa quieta) y compará el número del pico. Tienen que dar lo mismo dentro de un bin.
- Guardá la primera captura del día con el botón, aunque no la uses. Es la forma más barata de dejar registrado el estado del banco: el Tprf que estaba puesto, la amplitud de la triangular, si estaba recortada. Todo eso queda escrito adentro del PNG y no depende de que uno se acuerde de anotarlo.
- Y guardá la captura.csv de esa corrida en algún lado fuera del repo. Hoy no hay ninguna medición real en la máquina —están en .gitignore y se perdieron— así que todo lo verificado es contra streams sintéticos. Una captura real guardada convierte a verificar_rapido.py en una prueba mucho más fuerte.

GPRv2 · analisis/ · 2026-09-11
vivo.py, correccion_no_linealidad.py y waterfall.py sin modificar · CLAUDE.md con una sección nueva
