maledesm/gpr/redaccion/figuras/codigo/llamadas_cables_vna.pdf

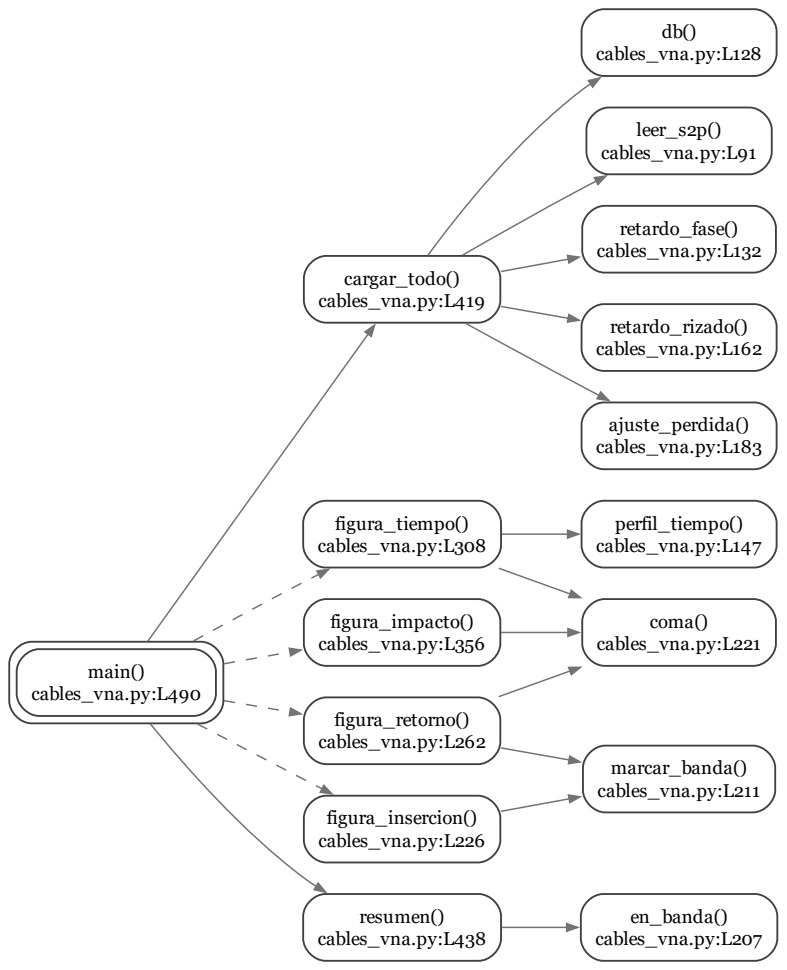
[picture p102: page 1]
ajuste_perdida() cables_vna.py:L183; cargar_todo() cables_vna.py:L419; db() cables_vna.py:L128; leer_s2p() cables_vna.py:L91; retardo_fase() cables_vna.py:L132; retardo_rizado() cables_vna.py:L162; coma() cables_vna.py:L221; en_banda() cables_vna.py:L207; figura_impacto() cables_vna.py:L356; figura_insercion() cables_vna.py:L226; marcar_banda() cables_vna.py:L211; figura_retorno() cables_vna.py:L262; figura_tiempo() cables_vna.py:L308; perfil_tiempo() cables_vna.py:L147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
