maledesm/gpr/redaccion/figuras/codigo/mapa_proyecto.pdf

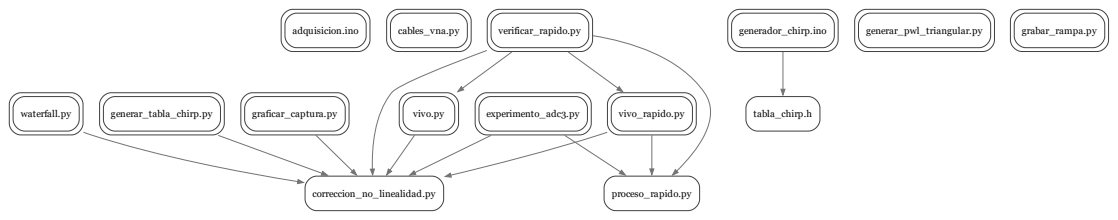
[picture p103: page 1]
adquisicion.ino; cables_vna.py; correccion_no_linealidad.py; experimento_adc3.py; proceso_rapido.py; generador_chirp.ino; tabla_chirp.h; generar_pwl_triangular.py; generar_tabla_chirp.py; grabar_rampa.py; graficar_captura.py; verificar_rapido.py; waterfall.py; vivo.py; vivo_rapido.py
