maledesm/gpr/redaccion/figuras/codigo/llamadas_verificar_rapido.pdf

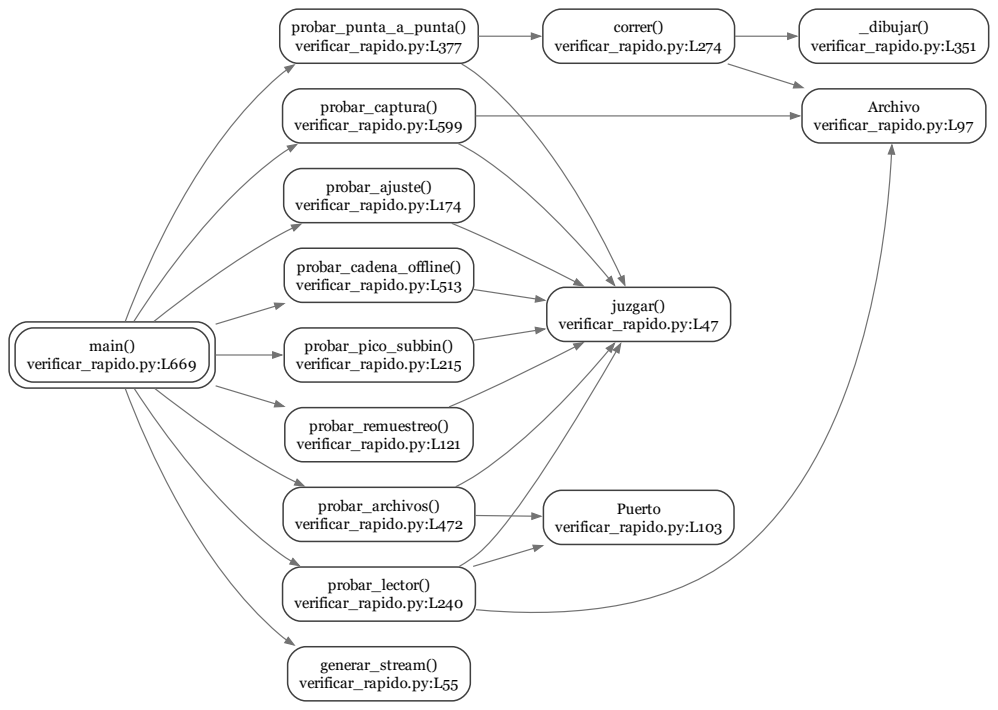
[picture p104: page 1]
Archivo verificar_rapido.py:L97; Puerto verificar_rapido.py:L103; _dibujar() verificar_rapido.py:L351; correr() verificar_rapido.py:L274; generar_stream() verificar_rapido.py:L55; juzgar() verificar_rapido.py:L47; main() verificar_rapido.py:L669; probar_ajuste() verificar_rapido.py:L174; probar_archivos() verificar_rapido.py:L472; probar_cadena_offline() verificar_rapido.py:L513; probar_captura() verificar_rapido.py:L599; probar_lector() verificar_rapido.py:L240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
