maledesm/gpr/redaccion/figuras/triangular/pcb_cobre.pdf

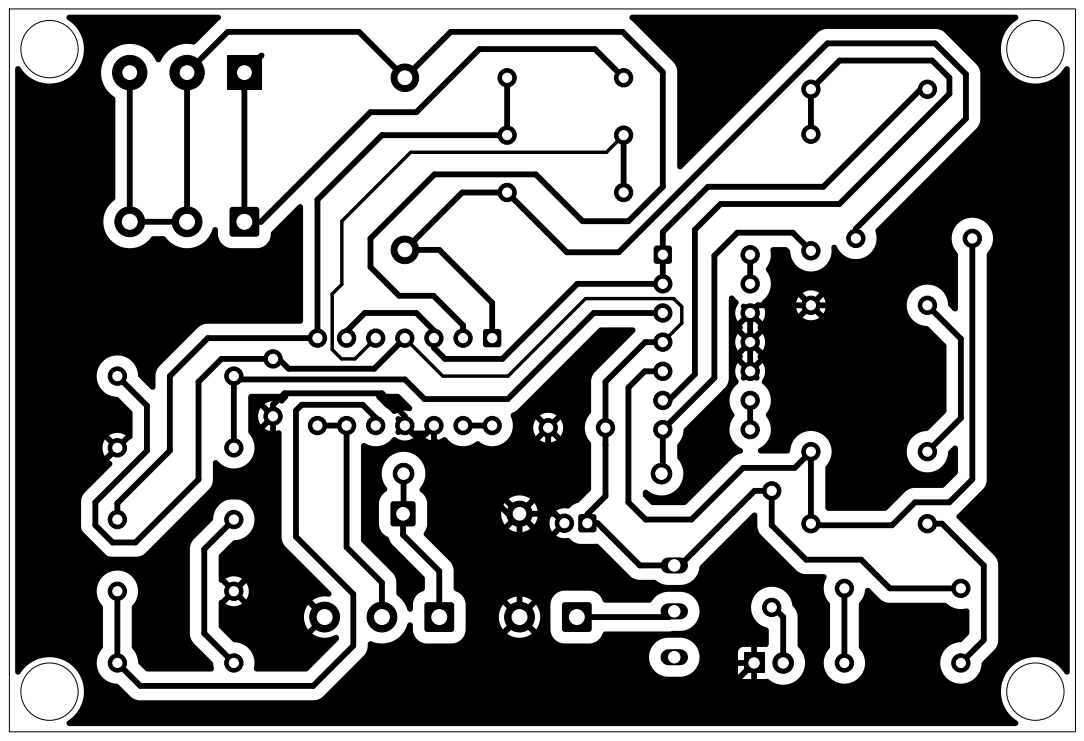
[picture p105: page 1]
