maledesm/gpr/redaccion/figuras/triangular/pcb_serigrafia.pdf

# JP1 R2

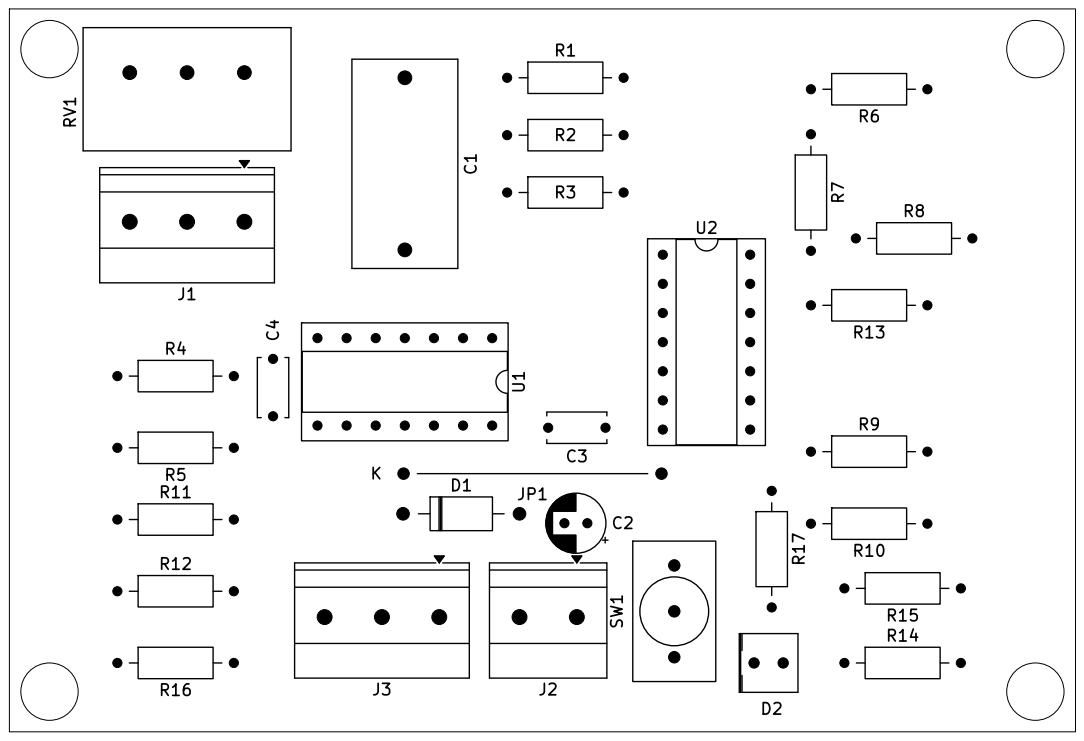
[picture p106: page 1]
