maledesm/gpr/redaccion/figuras/codigo/llamadas_adquisicion.pdf

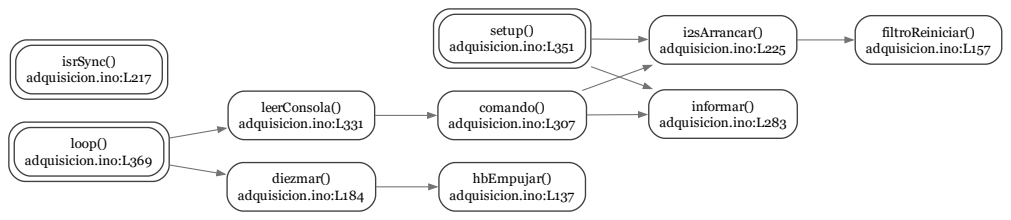
[picture p107: page 1]
comando() adquisicion.ino:L307; i2sArrancar() adquisicion.ino:L225; informar() adquisicion.ino:L283; diezmar() adquisicion.ino:L184; hbEmpujar() adquisicion.ino:L137; filtroReiniciar() adquisicion.ino:L157; isrSync() adquisicion.ino:L217; leerConsola() adquisicion.ino:L331; loop() adquisicion.ino:L369; setup() adquisicion.ino:L351
