maledesm/gpr/redaccion/figuras/codigo/llamadas_correccion_no_linealidad.pdf

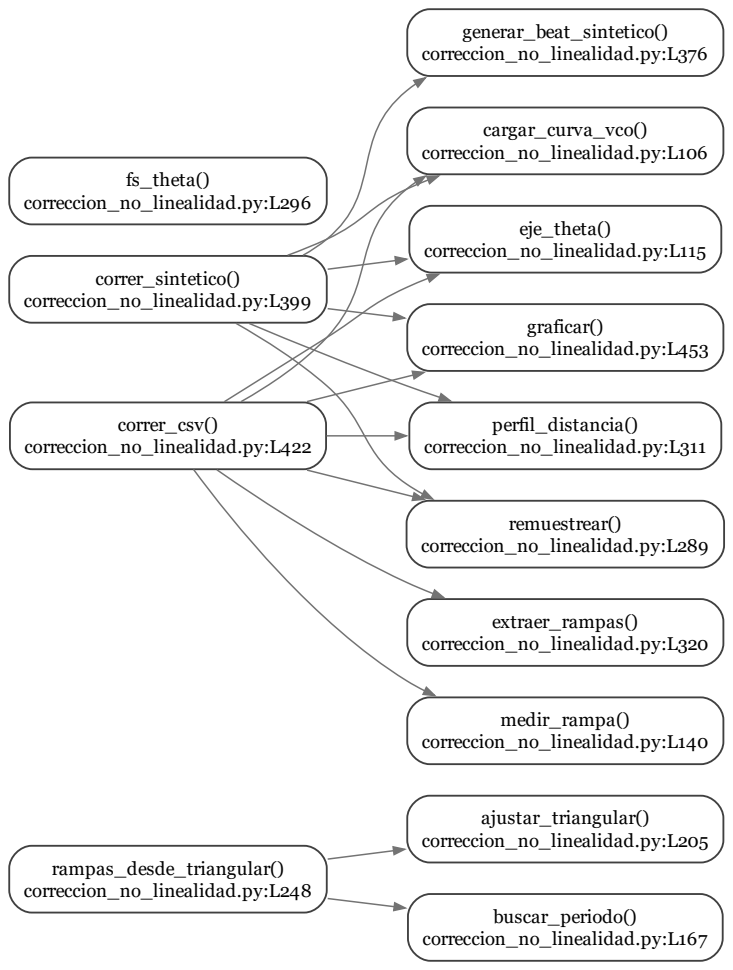
[picture p108: page 1]
ajustar_triangular() correccion_no_linealidad.py:L205; buscar_periodo() correccion_no_linealidad.py:L167; cargar_curva_vco() correccion_no_linealidad.py:L106; correr_csv() correccion_no_linealidad.py:L422; eje_theta() correccion_no_linealidad.py:L115; extraer_rampas() correccion_no_linealidad.py:L320; graficar() correccion_no_linealidad.py:L453; medir_rampa() correccion_no_linealidad.py:L140; perfil_distancia() correccion_no_linealidad.py:L311; remuestrear() correccion_no_linealidad.py:L289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
