maledesm/gpr/redaccion/figuras/codigo/llamadas_proceso_rapido.pdf

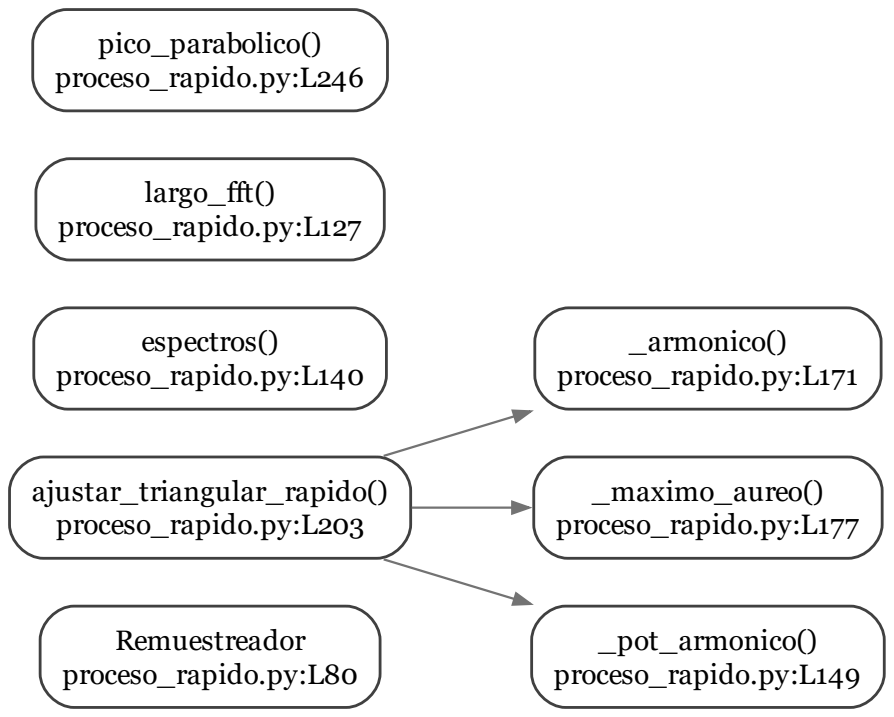
[picture p109: page 1]
Remuestreador proceso_rapido.py:L80; _armonico() proceso_rapido.py:L171; _maximo_aureo() proceso_rapido.py:L177; _pot_armonico() proceso_rapido.py:L149; ajustar_triangular_rapido() proceso_rapido.py:L203; espectros() proceso_rapido.py:L140; largo_fft() proceso_rapido.py:L127; pico_parabolico() proceso_rapido.py:L246
