maledesm/gpr/redaccion/figuras/codigo/llamadas_vivo.pdf

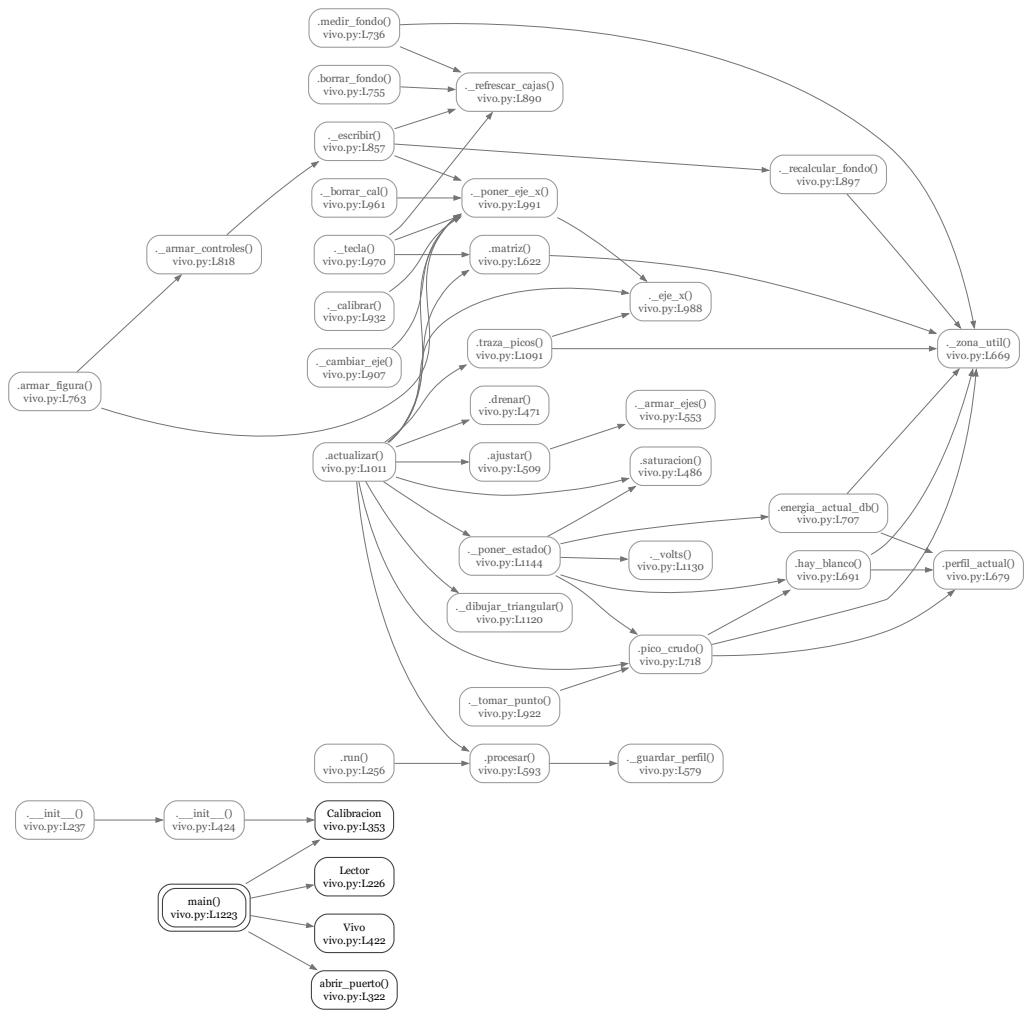
[picture p110: page 1]
.__init__() vivo.py:L237; .__init__() vivo.py:L424; Calibracion vivo.py:L353; ._armar_controles() vivo.py:L818; ._escribir() vivo.py:L857; ._armar_ejes() vivo.py:L553; ._borrar_cal() vivo.py:L961; ._poner_eje_x() vivo.py:L991; ._calibrar() vivo.py:L932; ._cambiar_eje() vivo.py:L907; ._dibujar_triangular() vivo.py:L1120; ._eje_x() vivo.py:L988; ._recalcular_fondo() vivo.py:L897; ._refrescar_cajas() vivo.py:L890; ._guardar_perfil() vivo.py:L579; ._poner_estado(); vivo.py:L1144; ._volts()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
