maledesm/gpr/redaccion/figuras/codigo/llamadas_vivo_rapido.pdf

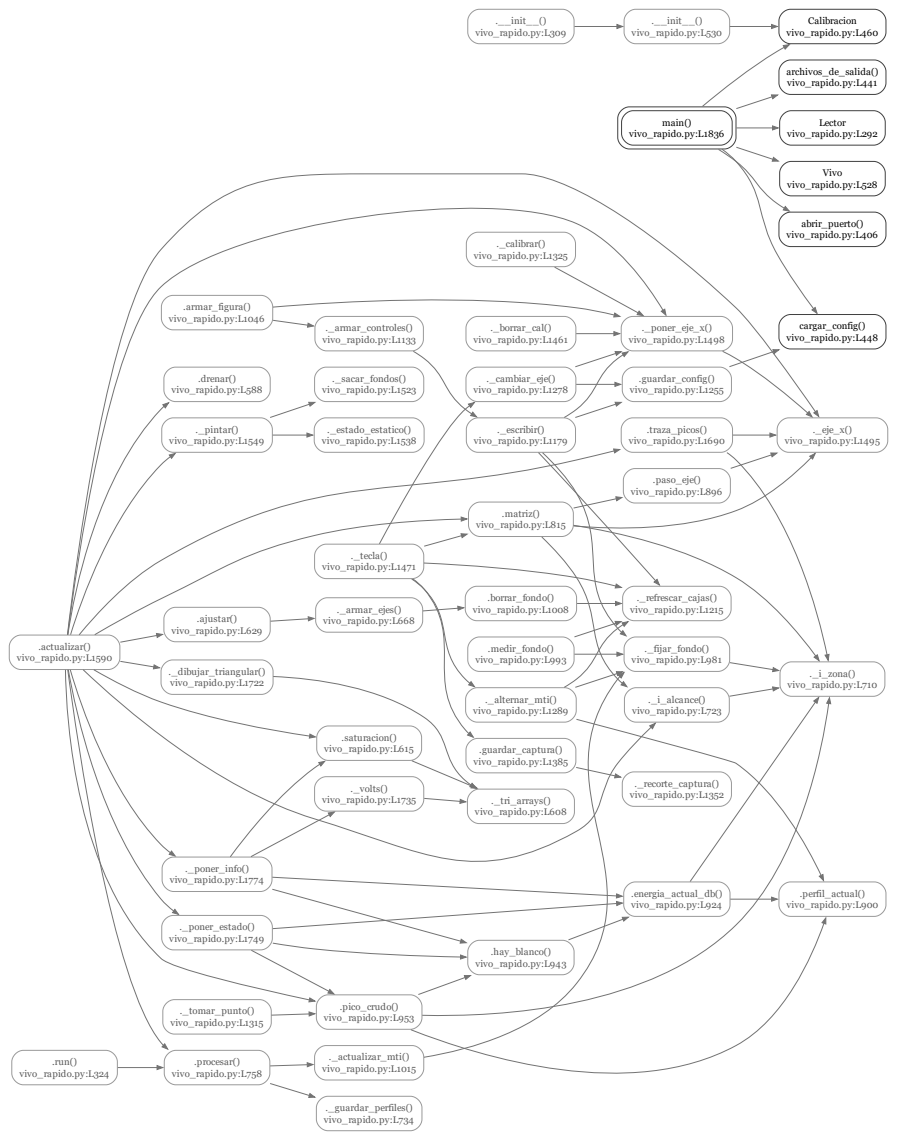
[picture p111: page 1]
.__init__() vivo_rapido.py:L309; .__init__() vivo_rapido.py:L530; Calibracion vivo_rapido.py:L460; ._actualizar_mti() vivo_rapido.py:L1015; ._fijar_fondo() vivo_rapido.py:L981; ._alternar_mti() vivo_rapido.py:L1289; ._refrescar_cajas() vivo_rapido.py:L1215; .perfil_actual() vivo_rapido.py:L900; ._armar_controles() vivo_rapido.py:L1133; ._escribir() vivo_rapido.py:L1179; ._armar_ejes() vivo_rapido.py:L668; .borrar_fondo() vivo_rapido.py:L1008; ._borrar_cal() vivo_rapido.py:L1461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
