maledesm/gpr/redaccion/figuras/codigo/modulos_vivo.pdf

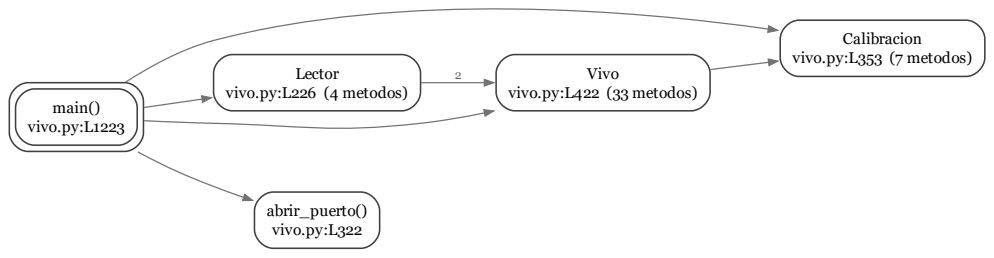
[picture p112: page 1]
Lector; Vivo; abrir_puerto() vivo.py:L322; main() vivo.py:L1223

Calibracion
vivo.py:L353 (7 metodos)

vivo.py:L422 (33 metodos)

vivo.py:L226 (4 metodos)
