maledesm/gpr/redaccion/figuras/codigo/modulos_vivo_rapido.pdf

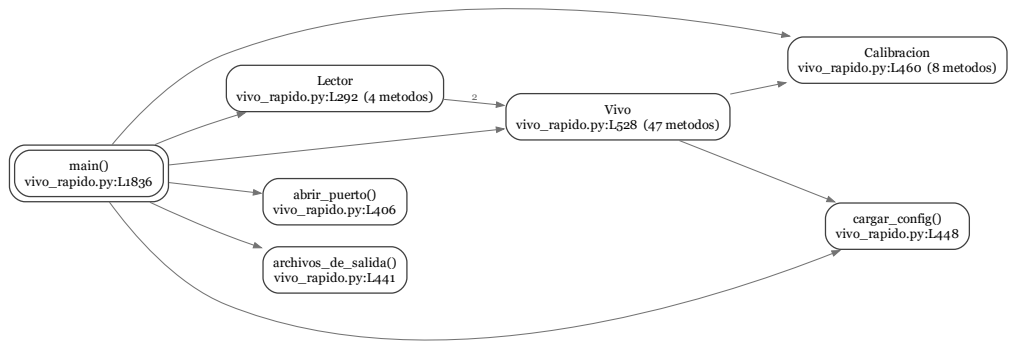
[picture p113: page 1]
Calibracion vivo_rapido.py:L460 (8 metodos); Lector vivo_rapido.py:L292 (4 metodos); Vivo vivo_rapido.py:L528 (47 metodos); cargar_config() vivo_rapido.py:L448; abrir_puerto() vivo_rapido.py:L406; archivos_de_salida() vivo_rapido.py:L441; main() vivo_rapido.py:L1836
