maledesm/gpr/GPRv2/docs/PWM/simulacion/triangular3_LM324.asc

C1: cap; 2.2u
D1: 1N4729A
R1: res; {Rs+Rpot*pos}
R2: res; 47k
R3: res; 12k
R4: res; 100k
R5: res; 100k
R6: res; 100k
R7: res; 100k
R8: res; 100k
R9: res; 115k
R10: res; 768k
R11: res; 300k
R12: res; 100k
R18: res; 330k
R19: res; 330k
U1: LM324
U3: LM324
U4: LM324
U5: LM324
U6: LM324
V1: voltage; 12
Named nets: 0, +12V, sq, np, inv, tri, mid, div, sync, salida
GPRv2 - Generador de triangular con LM324 (reemplazo de emergencia del TLC2274).

Mismo circuito que triangular3.asc, con LM324 (o LM2902, mismo chip y mismo patillaje DIP-14 que el TLC2274).
El LM324 no llega al riel de arriba: el Schmitt salta de ~0 a ~10,5 V en vez de 0 a 12 V. Se compensa con dos
resistencias de 330k soldadas en paralelo, sin desoldar nada:
  R18 (330k) paralela a R5: mid baja de 6 V a ~5,2 V, el centro del salto real -> subida y bajada simetricas.
  R19 (330k) paralela a R2: R2 pasa a 41,1k y la triangular vuelve a ~3,05 Vpp -> salida de 0 a 3,1 V.
Con TLC2274 se sacan R18 y R19 y queda el diseno original.

Resultado esperado: salida 0,04-3,08 V, 50/50 %, periodo 20,7 / 147 / 273 ms (pote 0 / 0,5 / 1), sync ~2,64 V.
Sin method=gear ni startup: con esas opciones el modelo del LM324 se traba.
.param Rs=8.2k Rpot=100k
.step param pos list 0 0.5 1
.tran 0 2 0 20u
.meas tran t1 WHEN V(sq)=6 RISE=3
.meas tran t2 WHEN V(sq)=6 RISE=4
.meas tran periodo PARAM t2-t1
.meas tran frec PARAM 1/periodo
Que mirar: V(salida) de 0 a 3 V y V(sync) de 0 a 3 V.
Un solo paso del pote: click derecho en el grafico > View > Select Steps.
Los primeros ~0,3 s de cada paso son el arranque del oscilador.
