maledesm/gpr/GPRv2/docs/PWM/simulacion/triangular3.asc

C1: cap; 2.2u
D1: 1N4729A
R1: res; {Rs+Rpot*pos}
R2: res; 47k
R3: res; 12k
R4: res; 100k
R5: res; 100k
R6: res; 100k
R7: res; 100k
R8: res; 100k
R9: res; 115k
R10: res; 768k
R11: res; 300k
R12: res; 100k
U1: TLC2272
U3: TLC2272
U4: TLC2272
U5: TLC2272
U6: TLC2272
V1: voltage; 12
Named nets: 0, +12V, sq, np, inv, tri, mid, div, sync, salida
GPRv2 - Generador de triangular, paso 3: el mismo circuito con un operacional real (TLC2272).

U3 Schmitt + U1 integrador: triangular de 3,07 Vpp alrededor de 6 V (tri). U4 da los 6 V.
U5 restador: salida = tri - 6 V + 1,56 V, o sea 0 a 3,1 V, y todo es proporcional a los 12 V.
U6 buffer del sync: R11/R12 son de alta impedancia para no cargar al Schmitt. 12 V -> 3 V.

R1 = Rs + pote (8k2 + Bourns 3590 de 100k); pos es la posicion del pote, de 0 a 1, y la barre el .step.
Las mediciones (Ctrl+L) dan solo el periodo y la frecuencia, una fila por posicion del pote.

Operacionales: TLC2272 de TI, modelo SLOJ080 de 2019 (TLC2272.lib y TLC2272.asy, al lado del .asc).
Se compra en DIP: un TLC2274 (cuadruple, DIP-14) y un TLC2272 (doble, DIP-8) para los 5 operacionales.
Salida rail-to-rail, 4,4-16 V, GBW 2,18 MHz, slew 3,6 V/us, Vos max 2,5 mV (el modelo usa el tipico, 0,17 mV).
Solo converge con method=gear y startup en el .tran (arranca con las fuentes en rampa).
Version corta para probar: solo los dos extremos del pote y 1,5 s.

D1: zener 1N4729A (3,6 V) que protege al VCO (18 V max; el amplificador x4,95 va a 20 V).
Modelo de Diodes Inc. en zener_1N472xA.lib. A 3,09 V toma 0,24 mA y no toca la triangular; con R9
abierta la salida iria a 10 V y D1 la clava en 3,31 V (16,4 V en el VCO). El 1N4728A (3,3 V) no sirve:
su codo es blando, conduce desde 2,97 V y recorta la punta.
.param Rs=8.2k Rpot=100k
.step param pos list 0 1
.tran 0 1.5 0 20u startup
.options method=gear
.meas tran t1 WHEN V(sq)=6 RISE=3
.meas tran t2 WHEN V(sq)=6 RISE=4
.meas tran periodo PARAM t2-t1
.meas tran frec PARAM 1/periodo
Que mirar: V(salida) de 0 a 3 V y V(sync) de 0 a 3 V.
Un solo paso del pote: click derecho en el grafico > View > Select Steps.
Los primeros ~0,3 s de cada paso son el arranque del oscilador.
