maledesm/gpr/GPRv2/docs/PWM/simulacion/triangular.asc

B1: bv; V=ddt(V(tri))
C1: cap; 2.2u
R1: res; {Rs+Rpot*pos}
R2: res; 47k
R3: res; 13k
R4: res; 100k
R5: res; 100k
U1: TL072
U3: TL072
U4: TL072
V1: voltage; 12
Named nets: 0, +12V, sq, np, inv, tri, mid, div, dtri
GPRv2 - Generador de triangular, paso 1: la topologia del PWM de Circuitos II llevada a ~10 Hz.
U3 Schmitt, U1 integrador, U4 = VCC/2. R1 = Rs + pote (Bourns 3590), pos = posicion del pote de 0 a 1.
B1 no es parte del circuito: da la pendiente de la triangular, para medir la linealidad.
.param Rs=8.2k Rpot=100k
.step param pos list 0 0.25 0.5 0.75 1
.tran 0 1.6 0 20u
.options plotwinsize=0
.meas tran t1 WHEN V(sq)=6 RISE=3
.meas tran t2 WHEN V(sq)=6 RISE=4
.meas tran tb WHEN V(sq)=6 FALL=1 TD=t1
.meas tran periodo PARAM t2-t1
.meas tran frec PARAM 1/periodo
.meas tran t_baja PARAM tb-t1
.meas tran t_sube PARAM t2-tb
.meas tran asimetria PARAM t_sube/t_baja
.meas tran vmax MAX V(tri) FROM t1 TO t2
.meas tran vmin MIN V(tri) FROM t1 TO t2
.meas tran vpp PARAM vmax-vmin
.meas tran vcentro PARAM (vmax+vmin)/2
.meas tran sq_alto AVG V(sq) FROM t1+0.1*t_baja TO t1+0.9*t_baja
.meas tran sq_bajo AVG V(sq) FROM tb+0.1*t_sube TO tb+0.9*t_sube
.meas tran fl_a WHEN V(sq)=2 RISE=1 TD=tb+0.5*t_sube
.meas tran fl_b WHEN V(sq)=10 RISE=1 TD=tb+0.5*t_sube
.meas tran flanco PARAM fl_b-fl_a
.meas tran ps_max MAX V(dtri) FROM tb+0.1*t_sube TO tb+0.9*t_sube
.meas tran ps_min MIN V(dtri) FROM tb+0.1*t_sube TO tb+0.9*t_sube
.meas tran ps_avg AVG V(dtri) FROM tb+0.1*t_sube TO tb+0.9*t_sube
.meas tran nolin_sube PARAM 100*(ps_max-ps_min)/ps_avg
.meas tran pb_max MAX V(dtri) FROM t1+0.1*t_baja TO t1+0.9*t_baja
.meas tran pb_min MIN V(dtri) FROM t1+0.1*t_baja TO t1+0.9*t_baja
.meas tran pb_avg AVG V(dtri) FROM t1+0.1*t_baja TO t1+0.9*t_baja
.meas tran nolin_baja PARAM 100*(pb_min-pb_max)/pb_avg
.meas tran ps_ref AVG V(dtri) FROM tb+0.1*t_sube TO tb+0.5*t_sube
.meas tran v50s FIND V(tri) AT tb+0.5*t_sube
.meas tran redondeo_arriba_mV PARAM 1000*(v50s+ps_ref*(t2-tb-0.5*t_sube)-vmax)
.meas tran pb_ref AVG V(dtri) FROM t1+0.1*t_baja TO t1+0.5*t_baja
.meas tran v50b FIND V(tri) AT t1+0.5*t_baja
.meas tran redondeo_abajo_mV PARAM 1000*(vmin-v50b-pb_ref*(tb-t1-0.5*t_baja))
Mediciones (View > SPICE Error Log, Ctrl+L), una fila por posicion del pote:
  periodo, frec     sobre la cuadrada (U3)
  asimetria         t_sube / t_baja; 1 = simetrica
  vpp, vcentro      de la triangular
  sq_alto, sq_bajo  niveles de la cuadrada
  flanco            lo que dura el flanco de la cuadrada = lo que dura el vertice
  nolin_sube/baja   variacion de la pendiente en el 80 % central de la rampa [%]
  redondeo_*_mV     cuanto le falta al vertice respecto de la recta del tramo 10-50 %
Para ver un solo paso del pote: click derecho en el grafico > View > Select Steps.
