maledesm/gpr/GPRv2/docs/PWM/simulacion/triangular2.asc

C1: cap; 2.2u
R1: res; {Rs+Rpot*pos}
R2: res; 47k
R3: res; 12k
R4: res; 100k
R5: res; 100k
R6: res; 100k
R7: res; 100k
R8: res; 100k
R9: res; 115k
R10: res; 768k
R11: res; 300k
R12: res; 100k
U1: UniversalOpAmp2; Avol=1Meg GBW=700k Slew=0.55Meg; Ilimit=10m Rail=0 Vos=0
U3: UniversalOpAmp2; Avol=1Meg GBW=700k Slew=0.55Meg; Ilimit=10m Rail=0 Vos=0
U4: UniversalOpAmp2; Avol=1Meg GBW=700k Slew=0.55Meg; Ilimit=10m Rail=0 Vos=0
U5: UniversalOpAmp2; Avol=1Meg GBW=700k Slew=0.55Meg; Ilimit=10m Rail=0 Vos=0
U6: UniversalOpAmp2; Avol=1Meg GBW=700k Slew=0.55Meg; Ilimit=10m Rail=0 Vos=0
V1: voltage; 12
Named nets: 0, +12V, sq, np, inv, tri, mid, div, sync, salida
GPRv2 - Generador de triangular, paso 2: salida de 0 a 3 V y sync para el ESP32.

U3 Schmitt + U1 integrador: triangular de 3,07 Vpp alrededor de 6 V (tri). U4 da los 6 V.
U5 restador: salida = tri - 6 V + 1,56 V, o sea 0 a 3,1 V, y todo es proporcional a los 12 V.
U6 buffer del sync: R11/R12 son de alta impedancia para no cargar al Schmitt. 12 V -> 3 V.

R1 = Rs + pote (8k2 + Bourns 3590 de 100k); pos es la posicion del pote, de 0 a 1, y la barre el .step.
Las mediciones (Ctrl+L) dan solo el periodo y la frecuencia, una fila por posicion del pote.

Operacionales: el UniversalOpAmp2 que trae LTspice, con los numeros del TLC2262 (DIP, salida
rail-to-rail, 4,4-16 V): GBW 700 kHz, slew 0,55 V/us, limite de corriente 10 mA, rieles 0 y 12 V.
Se usa este y no el macromodelo de TI porque ese es de 1993 y no converge en este lazo.
.param Rs=8.2k Rpot=100k
.step param pos list 0 0.25 0.5 0.75 1
.tran 0 6 0 20u
.meas tran t1 WHEN V(sq)=6 RISE=3
.meas tran t2 WHEN V(sq)=6 RISE=4
.meas tran periodo PARAM t2-t1
.meas tran frec PARAM 1/periodo
Que mirar: V(salida) de 0 a 3 V y V(sync) de 0 a 3 V.
Un solo paso del pote: click derecho en el grafico > View > Select Steps.
Los primeros ~0,3 s de cada paso son el arranque del oscilador.
