maledesm/gpr/GPRv2/docs/PWM/simulacion/PWM.asc

C1: cap; 4.7n
R1: res; 1k8
R2: res; 47k
R3: res; 2k2
R4: res; 100k
R5: res; 100k
R6: res; {Rup}
R7: res; {Rdown}
R8: res; 10k
R9: res; 500
R10: res; 500
U1: TL072
U2: opamp2; LM6172/NS
U3: TL072
U4: TL072
U5: opamp2; LM6172/NS
V1: voltage; 12
V2: voltage; PULSE(0.11 10.65 2.5u 1n 1n 3.7us 7.4us 0)
Named nets: 0, +12V, pwm_out, PWM_ideal_135kHz, pwm_out_inv
.tran 0 150u 0 1u
.param Pote=0.5
.param Rup=R_comp+10000*Pote Rdown=R_comp+10000*(1-Pote)
.param tmin=80u
.param tmax=120u
 
.meas TRAN nTperiod TRIG V(pwm_out)=10 RISE=5 TARG V(pwm_out)=10 RISE=10
.meas TRAN Freq PARAM {5/nTperiod}
.meas TRAN Tperiod PARAM {nTperiod/5}
 
.meas TRAN Vmax MAX V(pwm_out) FROM=tmin TO=tmax
.meas TRAN Vmin MIN V(pwm_out) FROM=tmin TO=tmax
.meas TRAN Vavg AVG V(pwm_out) FROM=tmin TO=tmax
.meas TRAN Duty PARAM (Vavg - Vmin) / (Vmax - Vmin)
.inc lm6172.lib
.step param Pote 0.3 0.6 0.1
.param R_comp=27k
slew rate
 
LM 324 0.3V/us
TL072 13V/us
LM 6172 2000 V/us
