maledesm/gpr/GPRv2/docs/PWM/pcb/triangular.kicad_pcb

## KiCad design GPRv2/docs/PWM/pcb/triangular.kicad_pcb (2026-09-25)

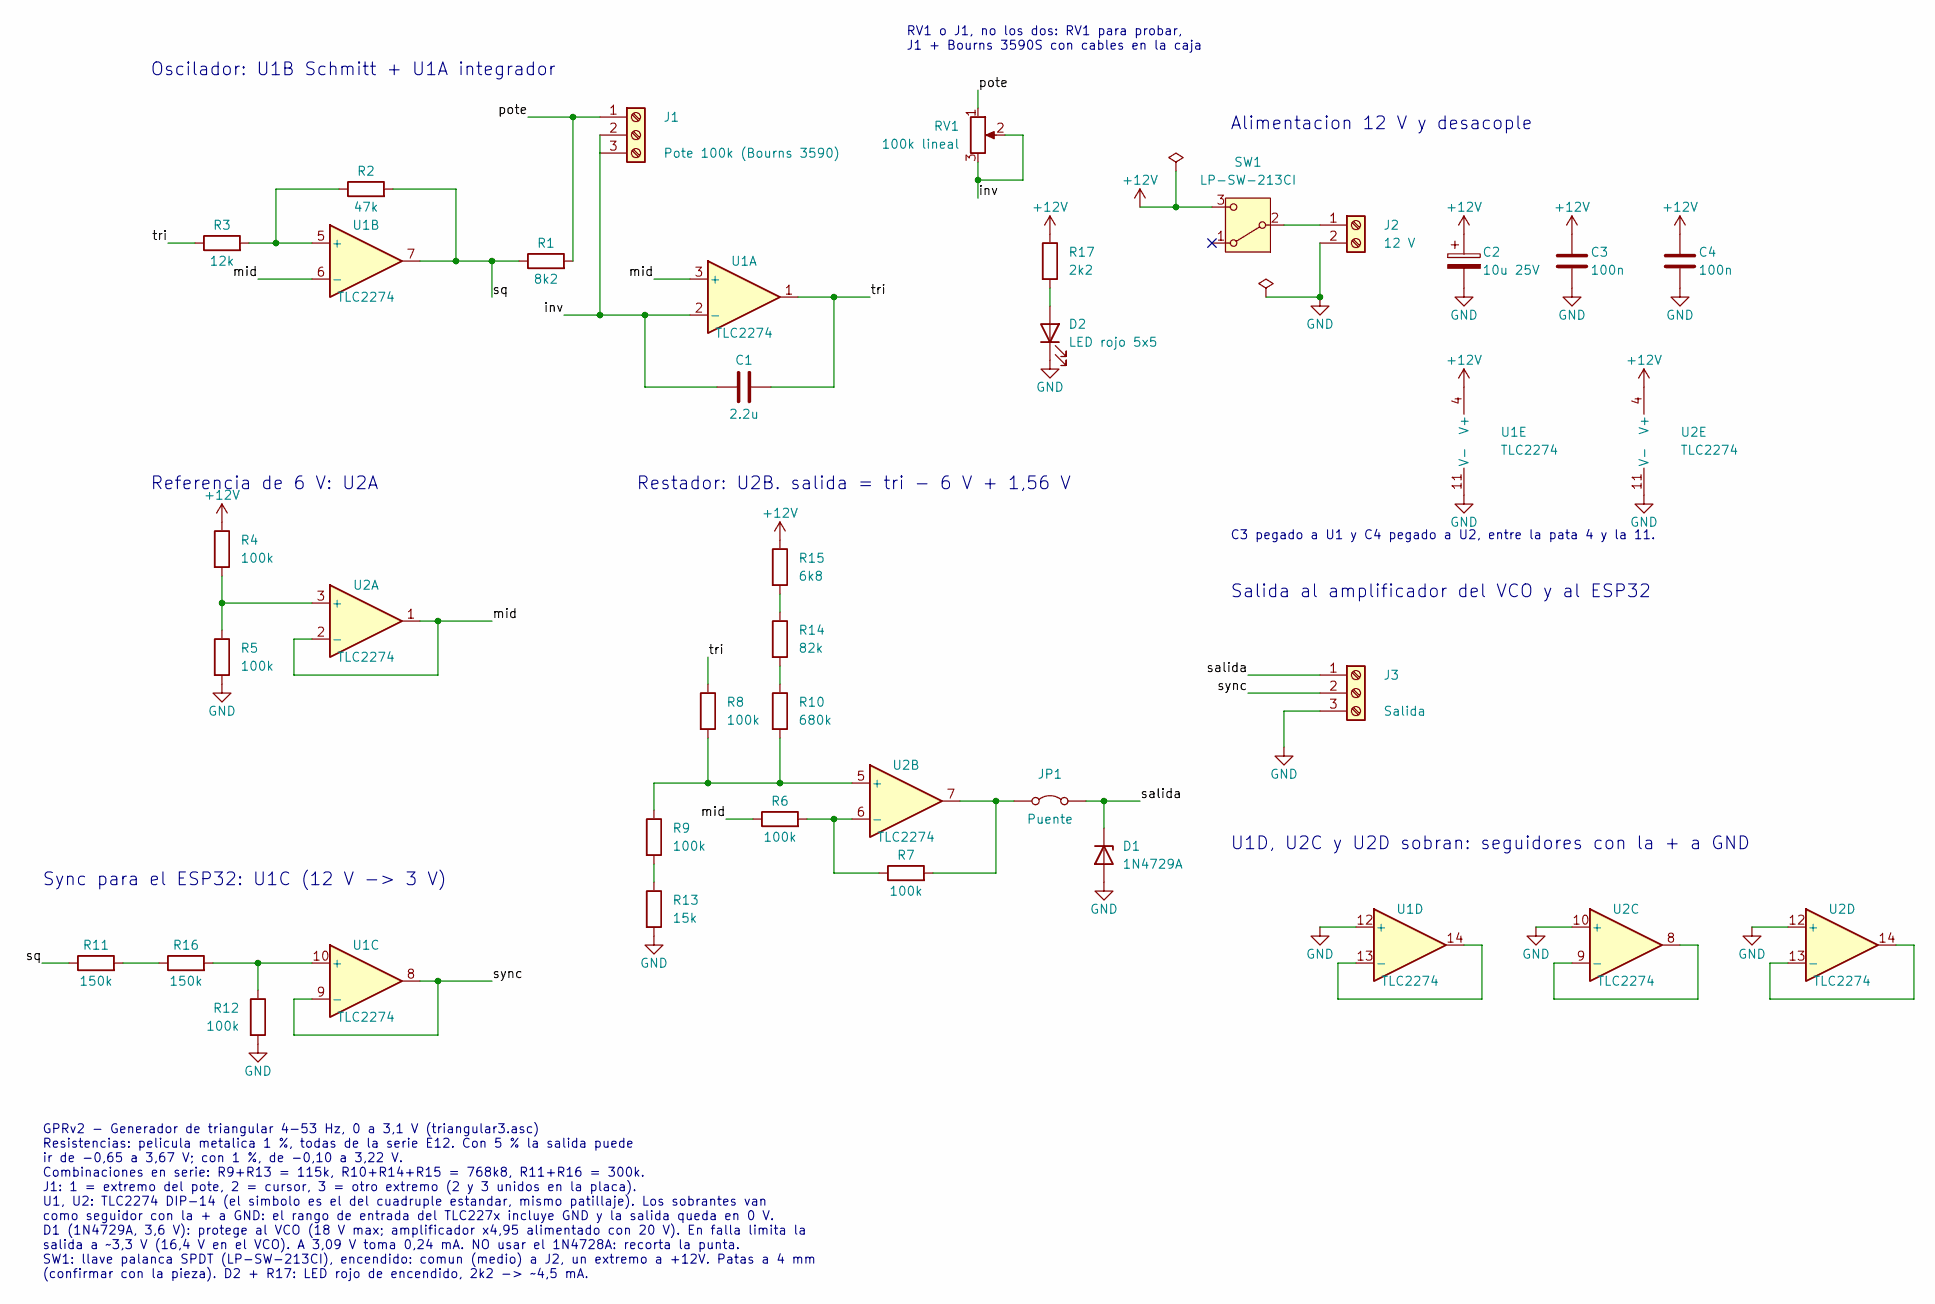
[picture p114: schematic triangular.kicad_sch, Generador de triangular 4-53 Hz]

Parts:
C1: 2.2u; C_Rect_L18.0mm_W9.0mm_P15.00mm_FKS3_FKP3
C2: 10u 25V; CP_Radial_D5.0mm_P2.00mm
C3, C4: 100n; C_Disc_D5.0mm_W2.5mm_P5.00mm
D1: 1N4729A; D_DO-41_SOD81_P10.16mm_Horizontal
D2: LED rojo 5x5; LED_Rectangular_W5.0mm_H5.0mm
J1: Pote 100k (Bourns 3590); TerminalBlock_Phoenix_MKDS-1,5-3_1x03_P5.00mm_Horizontal
J2: 12 V; TerminalBlock_Phoenix_MKDS-1,5-2_1x02_P5.00mm_Horizontal
J3: Salida; TerminalBlock_Phoenix_MKDS-1,5-3_1x03_P5.00mm_Horizontal
JP1: Puente; Puente_Cable_P22.5mm
R1: 8k2; R_Axial_DIN0207_L6.3mm_D2.5mm_P10.16mm_Horizontal
R2: 47k; R_Axial_DIN0207_L6.3mm_D2.5mm_P10.16mm_Horizontal
R3: 12k; R_Axial_DIN0207_L6.3mm_D2.5mm_P10.16mm_Horizontal
R4, R5, R6, R7, R8, R9, R12: 100k; R_Axial_DIN0207_L6.3mm_D2.5mm_P10.16mm_Horizontal
R10: 680k; R_Axial_DIN0207_L6.3mm_D2.5mm_P10.16mm_Horizontal
R11, R16: 150k; R_Axial_DIN0207_L6.3mm_D2.5mm_P10.16mm_Horizontal
R13: 15k; R_Axial_DIN0207_L6.3mm_D2.5mm_P10.16mm_Horizontal
R14: 82k; R_Axial_DIN0207_L6.3mm_D2.5mm_P10.16mm_Horizontal
R15: 6k8; R_Axial_DIN0207_L6.3mm_D2.5mm_P10.16mm_Horizontal
R17: 2k2; R_Axial_DIN0207_L6.3mm_D2.5mm_P10.16mm_Horizontal
RV1: 100k lineal; Potentiometer_Alps_RK163_Single_Horizontal
SW1: LP-SW-213CI; SW_Palanca_SPDT_P4mm
U1, U2: TLC2274; DIP-14_W7.62mm_Socket

Connections:
+12V: C2.1, C3.1, C4.1, R4.1, R15.1, R17.1, SW1.3 (C), U1.4 (V+), U2.4 (V+)
/inv: C1.1, J1.2, J1.3, RV1.2, RV1.3, U1.2 (-)
/mid: R6.1, U1.3 (+), U1.6 (-), U2.1, U2.2 (-)
/pote: J1.1, R1.2, RV1.1
/salida: D1.1 (K), J3.1, JP1.2 (B)
/sq: R1.1, R2.2, R11.1, U1.7
/sync: J3.2, U1.8, U1.9 (-)
/tri: C1.2, R3.1, R8.1, U1.1
GND: C2.2, C3.2, C4.2, D1.2 (A), D2.1 (K), J2.2, J3.3, R5.2, R12.2, R13.2, U1.11 (V-), U1.12 (+), U2.10 (+), U2.11 (V-), U2.12 (+)
unnamed: D2.2 (A), R17.2
unnamed: J2.1, SW1.2 (B)
unnamed: JP1.1 (A), R7.2, U2.7
unnamed: R10.1, R14.2
unnamed: R11.2, R16.1
unnamed: R9.2, R13.1
unnamed: R14.1, R15.2
unnamed: R2.1, R3.2, U1.5 (+)
unnamed: R12.1, R16.2, U1.10 (+)
unnamed: U1.13 (-), U1.14
unnamed: R4.2, R5.1, U2.3 (+)
unnamed: R8.2, R9.1, R10.2, U2.5 (+)
unnamed: R6.2, R7.1, U2.6 (-)
unnamed: U2.8, U2.9 (-)
unnamed: U2.13 (-), U2.14

Notes on the sheet:
Oscilador: U1B Schmitt + U1A integrador
RV1 o J1, no los dos: RV1 para probar, J1 + Bourns 3590S con cables en la caja
Referencia de 6 V: U2A
Restador: U2B. salida = tri - 6 V + 1,56 V
Sync para el ESP32: U1C (12 V -> 3 V)
Alimentacion 12 V y desacople
C3 pegado a U1 y C4 pegado a U2, entre la pata 4 y la 11.
Salida al amplificador del VCO y al ESP32
U1D, U2C y U2D sobran: seguidores con la + a GND
GPRv2 - Generador de triangular 4-53 Hz, 0 a 3,1 V (triangular3.asc) Resistencias: pelicula metalica 1 %, todas de la serie E12. Con 5 % la salida puede ir de -0,65 a 3,67 V; con 1 %, de -0,10 a 3,22 V. Combinaciones en serie: R9+R13 = 115k, R10+R14+R15 = 768k8, R11+R16 = 300k. J1: 1 = extremo del 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

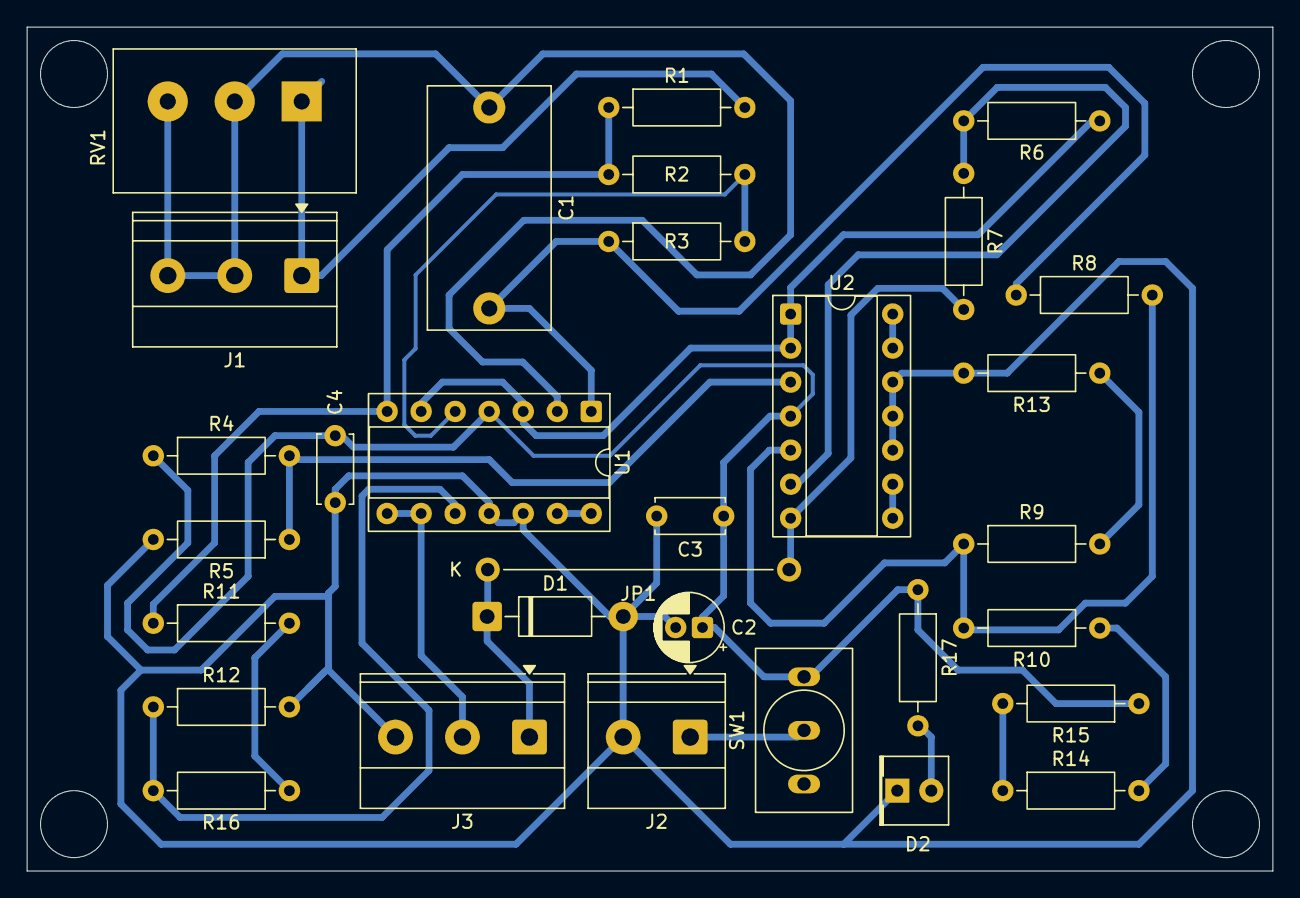
[picture p115: board triangular.kicad_pcb from above]

Board: 2 copper layers, 93.0 x 63.0 mm, 31 parts (0 on the bottom side), 24 nets.
