maledesm/gpr/firmware/gpr_barrido/tabla_vco.h

// Tabla de predistorsion del VCO -- GENERADA, no editar a mano.
//
//   Origen : VCO/Caracteristica VCO.csv (34 puntos medidos)
//   Script : VCO/analisis_vco.py
//
// Recorriendo la tabla a paso constante, la FRECUENCIA del VCO avanza
// linealmente en el tiempo. La tension no: avanza despacio donde el VCO
// es sensible y rapido donde es sordo.
//
//   VDD asumida    : 3.300 V   (si tu riel real difiere, regenerar)
//   Tension        : 0.002 a 3.000 V
//   Frecuencia     : 943 a 1982 MHz   (BW 1039 MHz)
//   Error residual : 0.20 MHz pico

#pragma once
#include <stdint.h>

#define TABLA_VCO_N        1024
#define TABLA_VCO_F0_MHZ   943.0f
#define TABLA_VCO_F1_MHZ   1981.7f
#define TABLA_VCO_BW_MHZ   1038.7f

static const uint16_t TABLA_VCO[TABLA_VCO_N] = {
     2,    5,    8,   11,   13,   16,   19,   22,   24,   27,   30,   33,
    35,   38,   41,   44,   47,   49,   52,   55,   58,   61,   64,   66,
    69,   72,   75,   78,   81,   84,   86,   89,   92,   95,   98,  101,
   104,  107,  110,  113,  116,  118,  121,  124,  127,  130,  133,  136,
   139,  142,  145,  148,  151,  154,  157,  160,  163,  166,  169,  172,
   175,  178,  181,  184,  187,  191,  194,  197,  200,  203,  206,  209,
   212,  215,  219,  222,  225,  228,  231,  234,  238,  241,  244,  247,
   250,  254,  257,  260,  263,  267,  270,  273,  277,  280,  283,  287,
   290,  293,  297,  300,  303,  307,  310,  314,  317,  320,  324,  327,
   331,  334,  338,  341,  345,  348,  351,  355,  358,  362,  365,  369,
   372,  376,  379,  382,  386,  389,  393,  396,  400,  403,  407,  410,
   414,  417,  421,  424,  428,  431,  435,  438,  442,  445,  449,  452,
   456,  459,  463,  466,  470,  473,  477,  481,  484,  488,  491,  495,
   498,  501,  505,  508,  512,  515,  519,  522,  526,  529,  533,  536,
   540,  543,  547,  550,  554,  557,  560,  564,  567,  571,  574,  578,
   581,  585,  588,  592,  595,  598,  602,  605,  609,  612,  616,  619,
   623,  626,  630,  633,  637,  640,  644,  647,  651,  654,  658,  661,
   665,  668,  672,  675,  679,  682,  686,  689,  693,  696,  700,  703,
   707,  710,  714,  717,  721,  724,  728,  731,  734,  738,  741,  745,
   748,  751,  754,  758,  761,  764,  768,  771,  774,  777,  781,  784,
   787,  790,  794,  797,  800,  803,  807,  810,  813,  816,  819,  822,
   826,  829,  832,  835,  838,  841,  844,  847,  851,  854,  857,  860,
   863,  866,  869,  872,  875,  878,  881,  884,  887,  890,  893,  896,
   899,  902,  905,  908,  911,  914,  916,  919,  922,  925,  928,  931,
   934,  937,  939,  942,  945,  948,  951,  954,  957,  959,  962,  965,
   968,  971,  974,  977,  980,  983,  986,  989,  992,  995,  998, 1001,
  1004, 1007, 1010, 1013, 1016, 1019, 1022, 1025, 1028, 1032, 1035, 1038,
  1041, 1044, 1047, 1050, 1053, 1057, 1060, 1063, 1066, 1069, 1073, 1076,
  1079, 1082, 1085, 1089, 1092, 1095, 1098, 1102, 1105, 1108, 1111, 1115,
  1118, 1121, 1125, 1128, 1131, 1135, 1138, 1141, 1145, 1148, 1152, 1155,
  1159, 1162, 1166, 1169, 1173, 1176, 1180, 1183, 1187, 1190, 1194, 1197,
  1201, 1204, 1208, 1211, 1215, 1218, 1222, 1225, 1229, 1232, 1236, 1239,
  1243, 1246, 1249, 1253, 1256, 1259, 1263, 1266, 1269, 1272, 1276, 1279,
  1282, 1285, 1289, 1292, 1295, 1298, 1301, 1305, 1308, 1311, 1314, 1317,
  1320, 1324, 1327, 1330, 1333, 1337, 1340, 1343, 1346, 1350, 1353, 1356,
  1359, 1363, 1366, 1369, 1373, 1376, 1380, 1383, 1387, 1390, 1394, 1397,
  1401, 1404, 1408, 1411, 1415, 1418, 1422, 1426, 1429, 1433, 1436, 1440,
  1444, 1447, 1451, 1454, 1458, 1462, 1465, 1469, 1472, 1476, 1479, 1483,
  1486, 1490, 1493, 1497, 1500, 1504, 1507, 1510, 1514, 1517, 1520, 1524,
  1527, 1531, 1534, 1537, 1541, 1544, 1547, 1551, 1554, 1557, 1561, 1564,
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
};
