maledesm/gpr/docs/diagrama_bloques.py

"""
Diagrama en bloques del GPR FMCW.

    python diagrama_bloques.py   ->   diagrama_bloques.png

Estilo sobrio para informe y presentacion: cajas blancas, borde negro, esquinas
vivas. Sin codigo de colores ni marcas de estado, para que se pueda imprimir en
blanco y negro y proyectar sin depender del color.

Es la version de UN canal, que es el alcance de la tesis. El mixer IQ queda
como ampliacion posible: el PCM1808 es estereo, asi que el camino para el
segundo canal ya existe en el hardware.

La rampa de sintonia la da un generador de triangular externo (hoy el Siglent
SDG830; mas adelante la placa del generador analogico). El DAC MCP4725 con
predistorsion que la generaba antes ya no se usa: la no linealidad del VCO se
corrige en la PC, remuestreando en theta.

El ESP32-C3 digitaliza el beat por I2S y ademas lee la triangular por GPIO3
(divisor 4k7/4k7). Con esas lecturas la PC reconstruye el sincronismo por
software: no hace falta ninguna senal de sync del generador.
"""

import matplotlib
matplotlib.use("Agg")
import matplotlib.pyplot as plt
from matplotlib.patches import Rectangle, FancyArrowPatch

LW_CAJA = 1.8
LW_LINEA = 1.6

# nombre -> (x, y, ancho, alto, titulo, subtitulo)
CAJAS = {
    "esp":   (1.35, 3.30, 1.80, 4.30, "ESP32-C3", "I²S + ADC"),
    "pc":    (1.35, 0.40, 1.80, 0.75, "PC", "sincronismo + FFT"),

    "gen":   (4.15, 5.00, 1.70, 0.90, "Generador", "triangular"),
    "amp":   (6.30, 5.00, 1.30, 0.90, "AMP", "×5"),
    "vco":   (8.45, 5.00, 1.70, 0.90, "VCO", "1 – 2 GHz"),
    "att":   (10.55, 5.00, 1.30, 0.90, "−3 dB", ""),
    "split": (12.55, 5.00, 1.70, 0.90, "Splitter", ""),
    "antx":  (14.85, 5.00, 1.70, 0.90, "Antena TX", ""),

    "suelo": (14.85, 3.30, 1.70, 0.95, "Suelo", "blanco enterrado"),

    "anrx":  (14.85, 1.55, 1.70, 0.90, "Antena RX", ""),
    "lna":   (12.60, 1.55, 1.40, 0.90, "LNA", ""),
    "mix":   (10.40, 1.55, 1.70, 0.90, "Mixer", ""),
    "lpf":   (8.30, 1.55, 1.40, 0.90, "LPF", "rechazo suma"),
    "pcm":   (5.90, 1.55, 1.85, 0.90, "PCM1808", "ADC 24 bit"),
}


def borde(n, lado):
    x, y, w, h = CAJAS[n][:4]
    return {"der": (x + w / 2, y), "izq": (x - w / 2, y),
            "arr": (x, y + h / 2), "aba": (x, y - h / 2)}[lado]


def flecha(ax, p1, p2, texto="", dx=0.0, dy=0.09, ls="-"):
    ax.add_patch(FancyArrowPatch(p1, p2, arrowstyle="-|>", mutation_scale=13,
                                 color="black", lw=LW_LINEA, linestyle=ls,
                                 shrinkA=2, shrinkB=2, zorder=2))
    if texto:
        ax.text((p1[0] + p2[0]) / 2 + dx, (p1[1] + p2[1]) / 2 + dy, texto,
                fontsize=8.5, ha="center", va="bottom", color="black",
                style="italic")


def ruta(ax, puntos, texto="", texto_xy=None):
    """Flecha en angulo recto: una diagonal larga cruzando el dibujo se lee
    peor que dos tramos ortogonales."""
    ax.plot([p[0] for p in puntos[:-1]], [p[1] for p in puntos[:-1]],
            color="black", lw=LW_LINEA, zorder=2, solid_capstyle="round")
    ax.add_patch(FancyArrowPatch(puntos[-2], puntos[-1], arrowstyle="-|>",
                                 mutation_scale=13, color="black", lw=LW_LINEA,
                                 shrinkA=0, shrinkB=2, zorder=2))
    if texto:
        ax.text(*texto_xy, texto, fontsize=8.5, color="black", style="italic",
                ha="center", va="bottom")
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
