maledesm/gpr/(commit log)

2026-08-07 Estructura inicial del proyecto GPR FMCW
    Firmware, análisis, simulación y mediciones del radar GPR FMCW
    de 1.0-1.75 GHz.
    - firmware/PCM1808_ESP32C3: digitalizador I2S con fs variable (8-96 kHz),
    diezmado configurable, modo osciloscopio para el Serial Plotter,
    medición automática y diagnóstico de conexión del PCM1808.
    - docs/: estudio de hardware y manual de uso.
    - analisis/: procesamiento FMCW de las capturas de osciloscopio.
    - simulacion/: antena LPDA en MEEP.
    - datos/: mediciones del Siglent SDS1072CML+.
    [SDS00001.CSV, SDS00002.CSV, SDS00003.CSV]
2026-08-08 Generador de patrones de prueba en Arduino Uno
    Señal de referencia para validar la cadena ESP32-C3 + PCM1808 sin
    el circuito de RF.
    Cuatro patrones: escalera asimétrica 1-2-3-4 ms (diagnóstico visual),
    cuadradas de 1 kHz y 100 Hz (verificación de fs) y pulso angosto
    (medición de la constante de tiempo del pasa-altos del módulo).
    Los segmentos son de milisegundos, no de segundos: por encima de esa
    escala el pasa-altos del PCM1808 diferencia la señal y los escalones
    se ven como picos que decaen en vez de mesetas planas.
2026-08-08 Simplificar el generador a un solo patrón fijo
    Se van los cuatro patrones seleccionables, la consola serie y la máquina
    de estados. Queda solo la escalera 1-2-3-4 ms, que es la que sirve para
    el diagnóstico visual.
    Sin Serial.begin() el sketch no ocupa el puerto ni mete jitter de
    interrupciones en los tiempos: se enchufa y funciona, sin nada que lo
    pueda cambiar.
    [generador_patron.ino]
2026-08-08 Hoja de conexionado del banco de prueba
    Referencia completa para armar en protoboard: I2S, pines de modo,
    filtrado de alimentación, divisor del generador y masa común.
    Incluye verificación de encendido y tabla de diagnóstico.
2026-08-08 fmt plain: separar canales con coma en vez de tabulador
    El modo CSV de Telemetry Viewer (y de la mayoría de los visores) espera
    coma. El plotter del IDE 2.x acepta ambos, así que la coma es
    estrictamente más compatible.
2026-08-09 Generador: cuadrada simétrica de 100 Hz
    Reemplaza la escalera asimétrica. 100 Hz es el punto donde no molestan
    ni el pasa-altos (techo cae 1.6%) ni la falta de armónicos (entran hasta
    el 9° con fs_eff = 2 kHz).
    Al ser simétrica hay un solo flanco de subida por período, con lo cual
    el trigger por nivel de Telemetry Viewer queda estable. Con la escalera
    había dos flancos idénticos y el disparo alternaba entre ellos.
2026-08-10 Simulador de señal de beat FMCW para la placa de sonido
    Genera un WAV con la señal que entregaría el mixer ante un conjunto de
    blancos a distintas profundidades. Se reproduce en bucle por el jack de
    auriculares hacia la entrada del PCM1808.
    La banda de beat de un FMCW con sweep rápido cae dentro del audio, así
    que la placa de sonido alcanza: 16 bits y forma de onda arbitraria,
    contra los 8 bits del PWM de un Arduino.
2026-08-14 Firmware: fork con salida binaria y captura por ráfagas
    Nuevo sketch PCM1808_ESP32C3_bin, fork del validado (que queda intacto
    como red de seguridad).
    - Modo 'bin': tramas [magic][idx:u32][n:u16][flags:u8][n×f32][crc16].
    El índice es absoluto y avanza también durante las pausas, así los
    huecos son explícitos y la PC distingue una pausa esperada de una
    pérdida del DMA.
    - Comando 'raf <on> <off>': captura N muestras, pausa M. Con M=0 la
    captura es continua, que es el mismo camino de código.
    - modoGrafico() incluye MODE_BIN: en binario una línea de texto suelta
    no desordena un gráfico, rompe el sincronismo de trama.
2026-08-15 Rescatar el procedimiento de validación de banco y cerrar dos gaps del firmware
    Del trabajo hecho en otra conversación sobre una copia vieja, se integra
    solo lo que aporta. El estudio de circuito se descarta: duplica
    docs/PCM1808_hardware.md y tiene dos errores sistemáticos (0.019% de fs
    en vez de 0.019·fs/1000, y 20 kohm de impedancia de entrada en vez de
    60 kohm) que contaminan todos sus números.
    - docs/validacion_banco.md: procedimiento de banco con generador de
    funciones, corregido y adaptado a los comandos de nuestro firmware.
    Incluye la separación de los dos pasa-altos midiendo a dos fs, y la
    demostración empírica del plegado alrededor de 64·fs.
    - Firmware: comando 'fsm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
2026-08-15 Adquisición: protocolo binario y grabador a CSV
    - protocolo.py: decodificador de tramas con resincronización y CRC, más
    el verificador de continuidad que separa las pausas de ráfaga (que
    llevan flag) de las pérdidas reales del DMA. Autoprueba con 8 casos
    que corre sin hardware: --test.
    - grabarserial.py: configuración interactiva con últimos valores como
    default, encabezado con toda la metadata (incluido el volcado de
    'info' del firmware, para que quede lo que realmente tenía y no lo
    que creíamos), escritura incremental con fsync.
    El CSV lleva columna de índice explícita: en modo ráfaga el número de
    fila no es el tiempo, y sin esa columna el eje quedaría comprimido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
2026-08-15 Firmware: arreglar tramas binarias truncadas a 256 bytes
    El buffer de transmisión del CDC son 256 bytes por defecto
    (HWCDC.cpp:422 llama a setTxBufferSize(256)). Un paquete binario son
    1035, así que Serial.write() metía lo que entraba y devolvía una cuenta
    corta; binEnviarPaquete() ignoraba ese retorno y descartaba 779 bytes de
    cada trama. Ninguna pasaba el CRC.
    El modo texto nunca se vio afectado porque cada printf son menos de
    256 bytes.
    - Serial.ampliarBufferTx(4096) en setup(), para que un paquete entero
    quepa de una vez.
    - binEnviarPaquete() reintenta hasta escribir el paquete completo, con
    tope de 250 ms y contador de tramas soltadas visible en 'stats'. Esto
    es lo que corre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
    [protocolo.py]
2026-08-15 Adquisición: módulo de DSP, graficador en tiempo real y lanzador
    - dsp.py: ventanas, espectro, promediado, filtros y conversión a
    distancia, en numpy/scipy sin nada de GUI. Autoprueba de 10 casos
    anclados a valores teóricos (scalloping de 3.90 dB medidos contra
    3.92 dB de teoría).
    Normalización de AMPLITUD, no de densidad espectral: el pico de un
    tono vale su amplitud real sin importar la ventana. Con la
    normalización por sum(w^2) el pico dependía del ancho de banda
    equivalente de la ventana, y flattop leía 5.8 dB por debajo de
    rectangular -- justo lo contrario de para qué se elige flattop.
    - graficarserial.py: sigue el CSV mientras se escribe (procesando solo
    l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
2026-08-15 Consolidar todo en un solo lugar
    Fuera del repo: se eliminaron las carpetas sueltas ESP32/ y gpr_sampler/
    de la raíz de Tesis. Cuatro de sus cinco archivos eran byte a byte
    idénticos a los del repo; el .ino difería solo en el arreglo de
    tabulador a coma, o sea que la copia del repo era la nueva. Todo está
    en git, así que nada se perdió. (CST/ no se tocó.)
    Dentro del repo, el problema de fondo era tener dos firmwares
    conviviendo, sin quedar claro cuál era el vigente:
    - firmware/PCM1808_ESP32C3_bin/ pasa a llamarse PCM1808_ESP32C3/ y el
    anterior se retira. Queda uno solo, sin ambigüedad.
    - sketch_may29a/ y gpr_sampler/ van a firmware/historico/ con un README
    que explica por qué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
    [PCM1808_ESP32C3.ino, gpr_sampler.ino, grabarserial.py, protocolo.py, sketch_may29a.ino]
2026-08-15 Accesos directos .bat en la raíz del repo
    - medir.bat graba una captura y abre el gráfico en vivo
    - graficar.bat abre la última captura sin grabar (acepta un .csv arrastrado)
    - pruebas.bat autopruebas sin hardware
    Se ubican con %~dp0 en vez de rutas fijas, así el repo se puede mover,
    renombrar o clonar en otra máquina sin tocarlos. El 'cd /d' es
    imprescindible: sin el /d, cd no cambia de unidad y el script no
    encuentra nada si se lo llama desde C:.
    Buscan el intérprete en %USERPROFILE%\venvs\gpr-win y, si no está,
    explican cómo crearlo en vez de fallar con un error críptico.
    Verificado corriendo pruebas.bat desde C:\ con salida 0.
2026-08-18 Graficador: control de límites del eje de frecuencia y de la escala en dB
    - Frecuencia máxima ajustable, con Nyquist de fs_eff como valor inicial.
    - Escala Y automática o con dB min/max fijos. Con límites fijos dos
    capturas distintas se pueden comparar de un vistazo; con autoescala
    es imposible porque el eje se mueve solo.
    - El eje X arranca en frecuencia y no en distancia: la frecuencia es lo
    que se mide directamente, mientras que la distancia depende de que BW
    y T_sweep estén bien cargados en el encabezado del CSV.
    Guarda contra dB min >= dB max, que dejaría el rango invertido.
    [caracterizacion_filtro.csv, caracterizacion_filtro_con_ganancia.csv, respuesta_filtro_procesado.csv]
2026-08-21 Sketch aislado de prueba del MCP4725
    Genera la triangular sobre el DAC, sin tocar el PCM1808 ni el I2S, para
    verificarla con el osciloscopio antes de integrarla.
    - Autodetecta la direccion del modulo (0x60..0x67).
    - Mide el tiempo real de una escritura I2C, que es lo que fija cuantos
    escalones por segundo se pueden.
    - Reporta atrasos y peor jitter cada 2 s: si el bus no da abasto, se ve.
    - Usa Fast Mode Write escrito a mano en vez de una libreria, para que
    quede a la vista que nunca se toca la EEPROM (que a 10.000 escrituras
    por segundo se destruiria en un minuto).
    [prueba_mcp4725.ino]
2026-08-21 Prueba MCP4725: duracion de rampa en microsegundos y comando prf
    Con una PRF de 5 ms cada rampa dura 2.5 ms, que con el parser entero
    anterior no se podia pedir. Ahora 't' acepta decimales y se agrega 'prf'
    como atajo para dar el periodo completo de la triangular.
    El maximo por defecto pasa a 3723 = 3.00 V con VCC de 3.3 V, que es el
    rango util para la entrada del amplificador del VCO.
2026-08-21 Prueba MCP4725: agregar la consola dual
    Le faltaba lo que ya tenia el firmware del PCM1808: si se compila con
    'USB CDC On Boot: Disabled' (el default de ESP32C3 Dev Module), Serial
    sale por GPIO20/21 y no se ve nada por USB aunque el sketch corra bien.
    Ahora escribe por los dos puertos.
    Verificado compilando con CDC habilitado y deshabilitado.
2026-08-21 Linealizar el barrido del VCO por predistorsión
    Con la curva fina medida (34 puntos cada 100 mV, 943 a 2042 MHz) la
    sensibilidad del VCO varía de 170 a 444 MHz/V: relación 2,6 a 1. Con una
    rampa lineal en tensión, dF/dt varía de 0,68x a 1,29x y el eco de un solo
    blanco a 1 m se desparrama entre 0,68 y 1,29 m.
    - VCO/analisis_vco.py invierte la curva con PCHIP (preserva monotonía, no
    inventa oscilaciones entre puntos) y genera la tabla de predistorsión.
    - firmware/prueba_mcp4725/tabla_vco.h: 1024 códigos de DAC. Recorriéndola
    a paso constante la FRECUENCIA avanza lineal en el tiempo.
    - Comando 'pre on|off' para comparar los dos modos en el osciloscopio.
    Resultado: dF/dt pasa de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
    [Caracteristica VCO.csv]
2026-08-21 Gráfico de la curva de sintonía del VCO
    Frecuencia de salida vs tensión de entrada, con dF/dV en el eje derecho:
    es la sensibilidad la que explica por qué hace falta predistorsionar.
    La derivada va suavizada con Savitzky-Golay sobre ~0.4 V. Sin suavizar,
    el gráfico muestra ondulaciones que son de la cuantización del
    instrumento (frecuencia redondeada a 1 MHz sobre pasos de 100 mV =
    +-10 MHz/V de incertidumbre en la pendiente) y no del VCO. PCHIP pasa
    por todos los puntos, así que su derivada no limpia ese ruido: lo
    amplifica.
2026-08-21 VCO: capturas de osciloscopio de la rampa del DAC
    Cuatro capturas de la salida del MCP4725, con y sin predistorsion, a PRF
    de 50 ms y 5 ms, mas el script que las grafica apiladas.
    grafico_capturas_dac.py ajusta una recta por minimos cuadrados a cada
    rampa y mide el desvio en rms. Dos detalles que valen la pena:
    - Los extremos de la triangular se buscan por PROMINENCIA, no por
    distancia. Filtrando solo por distancia, find_peaks toma maximos
    locales del ruido en mitad de la rampa y devuelve "picos" a 0.7 V y
    "valles" a 2.3 V, con lo cual las rectas de referencia quedan
    ancladas en cualquier lado.
    - El desvio se mide en rms y no como maximo: el osciloscopio digitaliza
    a 8 bits sobr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
    [SDS00001.CSV, SDS00002.CSV, SDS00003.CSV, SDS00004.CSV]
2026-08-22 Versionar las figuras finales de caracterizacion
    Quedan trackeadas las cuatro que son resultado final, para poder verlas
    en GitHub sin correr los scripts:
    Filtro Pasabajos/respuesta_filtro.png
    VCO/curva_vco.png
    VCO/vco_frecuencia_vs_tension.png
    VCO/dac_capturas_osciloscopio.png
    Se agregan con "git add -f", que es el mecanismo que el propio .gitignore
    ya documentaba: la regla *.png sigue valiendo para todo lo demas.
    Queda afuera analisis/v2/espectro_distancia.png a proposito: esa figura es
    salida de procesar una medicion concreta y cambia con cada captura, asi que
    versionarla solo generaria ruido en los diffs.
2026-08-23 docs: prompt de arranque para alinear los dos chats de Claude
    Trabajamos de a dos, cada uno con su cuenta de Claude. Este documento se
    pega entero en un chat nuevo y le da todo el contexto del proyecto:
    hardware y sus numeros, cableado, estructura del repo, firmware, orden en
    que fuimos haciendo las cosas, estado actual y trampas ya resueltas.
    La idea es que sea la unica fuente de verdad para el arranque: si algo
    cambia de fondo, se actualiza aca y se vuelve a pegar, asi los dos chats
    no se desfasan.
2026-08-23 Banda de diseno: 1.0 a 2.0 GHz (los 750 MHz eran de una prueba inicial)
    El 750 MHz / 1.75 GHz estaba desparramado en la documentacion Y en el
    codigo que calcula distancias, asi que los graficos de distancia estaban
    saliendo con la escala equivocada.
    BW pasa de 750 a 1000 MHz, con lo cual:
    resolucion 20 cm -> 15 cm en aire (5 cm en suelo con er=9)
    f_beat 5/T -> 6.67/T Hz por metro
    a T=10 ms 500 -> 666.7 Hz por metro
    a T=1.46 s 0.7-7 -> 0.9-9 Hz en la zona util de 0.2 a 2 m
    Actualizado en README, docs/PCM1808_hardware.md (incluida la tabla de
    atenuacion del pasa-altos, recalculada), docs/validacion_banco.md,
    adquisicion/{dsp,grabarserial,graficarserial}.py, a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
2026-08-24 docs: figura del principio del FMCW sin efecto Doppler
    Los tres graficos clasicos (frecuencia Tx/Rx, diferencia, salida del
    mezclador) alineados verticalmente, en variables genericas: f_min, f_max,
    B, tau, T_m.
    La version que se ve en la bibliografia es casi siempre de radar
    automotriz y trae Doppler, con lo cual f_dif de subida y de bajada salen
    distintas. Con blancos estaticos, que es nuestro caso, las dos son
    iguales y de esa simetria se sigue que una sola rampa alcanza para medir
    distancia.
    El panel (c) se construye integrando la frecuencia instantanea en vez de
    dibujar tramos de senoidal a mano, asi los intervalos donde la diferencia
    cae a cero salen solos como un estiramiento de la s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
2026-08-24 docs: estimacion de profundidad vs PRF para suelo seco y humedo
    Combina los tres limites que compiten y se queda con el minimo: atenuacion
    del suelo (contra el presupuesto de SNR, que depende del PRF via la
    ganancia de proceso), ambigüedad por los escalones del DAC, y Nyquist del
    ADC.
    Dos resultados que no eran obvios:
    - En suelo SECO a PRF 5 ms el limitante es la AMBIGÜEDAD DEL DAC (1.50 m),
    no la atenuacion (3.17 m). Es el unico caso de la tabla donde el
    instrumento corta antes que la fisica.
    - En suelo HUMEDO la atenuacion gana siempre y por lejos, asi que ahi los
    escalones del DAC no importan.
    Los parametros son SUPUESTOS, no medidos, y esta advertido arriba del
    archivo. Los d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
2026-08-24 docs: diagrama en bloques del sistema
    Version de UN canal, que es el alcance de la tesis. El mixer IQ queda como
    nota al pie: el PCM1808 ya es estereo, asi que el camino para el segundo
    canal existe en el hardware.
    El ESP32-C3 va como un unico bloque alto a la izquierda para que se vea que
    atiende las dos puntas de la cadena, genera la rampa por I2C y digitaliza
    el beat por I2S. De ahi sale marcado el sincronismo pendiente entre barrido
    y muestreo.
    Borde lleno para lo que ya funciona en el banco (ESP32, MCP4725, AMP, VCO,
    PCM1808, PC) y punteado para lo que esta en diseno (toda la cadena de RF).
2026-08-24 docs: diagrama de bloques mas compacto y en blanco y negro
    Cajas blancas con borde negro y esquinas vivas, sin codigo de colores ni
    distincion de estado. Asi se imprime en blanco y negro y se proyecta sin
    depender del color.
    Ademas se compacto: 15.5x6.2 pulgadas contra 16.5x9.4, sacando el espacio
    vertical muerto del medio, acortando las etiquetas de las flechas y bajando
    la leyenda.
    Se saco la etiqueta "1 - 2 GHz" entre el VCO y el atenuador: pisaba las dos
    cajas y ademas era redundante, el propio bloque del VCO ya la lleva adentro.
2026-08-24 docs: croquis de topologia del mixer IQ
    Mixer simplemente balanceado por canal, que es la topologia que corresponde
    a UN balun Marchand por mixer (dos en total, que es lo planeado): el LO
    entra por el puerto no balanceado del balun y la RF por la toma central,
    que es un punto de tension nula para el LO diferencial. La FI sale del nodo
    comun de los diodos.
    El balun va como bloque a proposito. Su estructura interna sale del diseno
    de las lineas acopladas, y dibujarla aca sugeriria una precision que este
    croquis no tiene.
    Es una ampliacion posible al final del proyecto, no parte del alcance de la
    tesis, que va con un solo canal.
2026-08-24 Agregar carpeta redaccion/ para el .tex de la tesis (sync manual con Prism)
    Prism no tiene conector ni API para editar el documento directo, asi que
    el flujo es: Santiago exporta el .tex de Prism y lo sube aca, se edita
    de a poco (bancos de trabajo, curvas, resultados), y lo vuelve a subir
    a Prism para compilar.
2026-08-24 Limpiar redaccion/tesis_gpr_fmcw.tex: dejar solo Fundamentos Teoricos y Senal IF/Frecuencia de Batido
    - Se sacan Dedicatoria, Agradecimientos, Resumen, Introduccion y
    Conclusiones: son placeholders vacios, prematuros para esta etapa.
    - El capitulo de la transformada chirp-Z (CZT) se mueve a un apendice
    al final, marcado explicitamente como trabajo futuro no implementado
    todavia (la separacion de reflexiones se resuelve por ahora con FFT).
    - Se sacan las menciones que daban por sentado que la tesis se basa en
    CZT (titulo provisional, paso opcional de CZT en el procedimiento de
    validacion, atribucion de un ejemplo numerico a una medicion con CZT).
    - Se agrega referencias.bib (antes s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
2026-08-24 Agregar capitulo de Banco de Pruebas y Caracterizacion del VCO a la tesis
    - Curva de sintonia medida (frecuencia vs Vin, 0 a 3,321 V), con el
    rango realmente usado (0-3,00 V -> 943-1982 MHz) marcado en la figura.
    - Tabla completa de los 34 puntos medidos (Vin, frecuencia, Vosc donde
    se midio).
    - Capturas de osciloscopio de la rampa del DAC con/sin predistorsion,
    a PRF de 50 ms y 5 ms.
    - Falta la seccion de fotos del banco/radar armado (pendiente de que
    Santiago las suba).
    - Se agregan las dos figuras nuevas con git add -f (VCO/*.png ya
    estaban listadas asi en el .gitignore; se documentan las nuevas en
    el mismo comentario).
    - Recompilado localmente (pdflatex + biber), sin referenc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
2026-08-24 Agregar fotos del primer banco y reorganizar capitulos/figuras
    - 3 fotos del primer banco de medicion (cadena de RF en la plaqueta de
    prueba, y dos vistas del banco completo con fuente DC, generador de
    funciones y notebook) en redaccion/figuras/banco/.
    - Se separa el capitulo 'Banco de Pruebas y Caracterizacion del VCO' en
    dos: Capitulo 3 'Banco de Pruebas' (fotos) y Capitulo 4
    'Caracterizacion del VCO' (curva, tabla, rampa del DAC). La idea es
    que cada subsistema que se vaya agregando (PCM1808, filtro, CZT,
    etc.) tenga su propio capitulo en vez de ir amontonando secciones.
    - Se reorganizan las figuras en subcarpetas por tema:
    redaccion/figuras/banco/ y redaccion/figuras/vco/ (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
2026-08-24 Sacar la columna Vosc de la tabla del VCO
    Se simplifica la tabla a solo Vin/frecuencia. En su lugar se deja un
    comentario puntual: en el ultimo punto del barrido (Vin=3,321V) la
    tension a la entrada del VCO tras el amplificador fue de 16,490V,
    dentro del rango de funcionamiento (hasta 20V).
2026-08-24 Agregar capitulo Filtro Pasabajos y seccion de predistorsion (PCHIP) en VCO
    - Nuevo Capitulo 5 'Filtro Pasabajos': metodo de medicion (barrido senoidal,
    dos posiciones de ganancia G=1/G=2), ganancia en banda de paso y
    frecuencias de corte -3dB, y comparacion normalizada que muestra que la
    divergencia por encima de 15 kHz es un efecto de amplitud/distorsion y no
    un cambio real en la respuesta del filtro. Numeros tomados corriendo
    Filtro Pasabajos/analisis_filtro.py sobre los CSV medidos.
    - Nueva Seccion 4.3 'Predistorsion: linealizacion mediante interpolacion
    PCHIP' en el capitulo del VCO, con la figura de 4 paneles VCO/curva_vco.png
    (curva+PCHIP, sensibilidad cruda, rampa del D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
2026-08-25 firmware: sketch nuevo que corre el DAC y el PCM1808 sincronizados
    gpr_barrido junta las dos mitades que vivian en sketches separados. Los dos
    originales quedan intactos como referencia.
    EL PROBLEMA QUE HABIA QUE RESOLVER
    No alcanzaba con pegar los dos loop(). El del PCM lee el I2S con un
    i2s_channel_read bloqueante de 256 frames: a 48 kHz son 5.33 ms sin
    ejecutar nada mas. El del DAC pacea la rampa con polling de micros(). Cada
    lectura habria congelado 5.33 ms una rampa que dura 2.5 ms.
    La salida es hacer las dos cosas en el MISMO lazo pero leyendo el I2S de a
    bloques chicos, y correr ese lazo en una tarea de FreeRTOS de prioridad 5,
    por encima del loopTask de Arduino. El loop() solo vac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
    [gpr_barrido.ino, grabarserial.py, protocolo.py, tabla_vco.h]
2026-08-25 firmware: no plantarse cuando falta el MCP4725
    El setup() quedaba en un while(true) parpadeando el LED si no encontraba el
    DAC, con lo cual sin ese modulo no habia consola y no se podia hacer nada.
    Era un error: el DAC es una de las dos mitades del sistema, no un requisito
    para arrancar.
    Ahora avisa y sigue en RAMPA EN SECO: se cuentan los escalones y se marcan
    los vertices igual que siempre, pero no se toca el bus. Eso permite probar
    toda la cadena -- segmentacion en barridos, armado de tramas, CRC y el
    software de la PC -- teniendo solo el ESP32 sobre la mesa.
    escribirDAC() sale temprano cuando no hay DAC en vez de mandar la
    transaccion: una escritura contra una direccion que nadie conte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
    [gpr_barrido.ino]
2026-08-25 firmware: arreglar la cuenta de la rampa y hacer util el reporte de jitter
    La primera medicion en el banco dio 24667 us de rampa contra 25000
    "nominales". No era jitter: era un sesgo fijo de 333 us, o sea EXACTAMENTE
    un escalon.
    Con pasos=75 hay 75 niveles, pero recorrerlos son 74 intervalos. El
    firmware hacia lo correcto; la cuenta que reportaba como nominal estaba
    mal. Se corrige en los seis lugares donde aparecia: snapPrf, prfActual,
    muestras por rampa, escalon de frecuencia y alcance no ambiguo. codigoPaso
    ya dividia por (pasos-1), asi que la rampa fisica nunca estuvo mal.
    Los "26361 escalones tarde" tambien eran artefacto propio. El umbral era
    medio periodo de escalon, pero el escalon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
    [gpr_barrido.ino]
2026-08-25 Agregar capitulo Arquitectura del Sistema (diagrama en bloques + principio FMCW sin Doppler)
    Nuevo capitulo antes de Banco de Pruebas, con las dos figuras que ya estaban
    en docs/ (diagrama_bloques.png, principio_fmcw.py) copiadas a
    redaccion/figuras/arquitectura/. Sirve de puente entre la teoria (Fundamentos
    y Senal IF) y la implementacion fisica: describe la cadena de RF completa de
    un canal (el mixer IQ del segundo canal queda como ampliacion posible, no
    implementada) y repasa sobre un caso concreto por que, sin efecto Doppler,
    una sola rampa alcanza para medir distancia (ya demostrado analiticamente en
    la Seccion de Frecuencia de Batido).
    Se aclara explicitamente en el caption de princip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
2026-08-25 Corregir referencia de capitulo equivocada en la nota al pie de Arquitectura del Sistema
    La nota decia "ver Capitulo 4" (Banco de Pruebas) como si ahi se discutiera
    el sincronismo barrido/muestreo pendiente, pero ese capitulo solo tiene
    fotos del banco fisico, no menciona ese pendiente. Se saca la referencia
    cruzada incorrecta y queda solo la explicacion en la nota al pie.
2026-08-25 Ignorar los archivos auxiliares que genera pdflatex/biber en redaccion/
    Compilar tesis_gpr_fmcw.tex localmente deja .aux/.bbl/.bcf/.blg/.log/.lof/
    .lot/.toc/.run.xml en la carpeta; son basura intermedia que se regenera en
    cada compilacion, asi que no tiene sentido versionarla (mismo criterio que
    ya se aplicaba a los .png/.pdf con git add -f para las figuras finales).
2026-08-25 Corregir rotulo del LPF post-mezclador: no es un filtro antialiasing
    El LPF entre el mixer y el PCM1808 rechaza el termino de suma que genera
    el mezclador (~2fc, del orden de GHz), no cumple la funcion de antialiasing
    del muestreo. Ese antialiasing ya esta resuelto internamente por el propio
    PCM1808 (filtro analogico interno a 1.3 MHz + sobremuestreo 64x del
    modulador Delta-Sigma, documentado en docs/PCM1808_hardware.md). Llamarlo
    "antialias" en el diagrama mezclaba dos filtros con roles distintos.
    Cambios:
    - docs/diagrama_bloques.py: subtitulo del bloque LPF de "antialias" a
    "rechazo suma"; se regenero el PNG (tambien la copia en
    redaccion/figuras/arquitectura/).
    - redaccion/tesis_gpr_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
2026-08-25 redaccion: reemplazar el flujo con Prism por compilacion local (compilar.bat)
    Ahora los dos tenemos LaTeX instalado, asi que no hace falta el ida y vuelta
    de exportar/subir el .tex a Prism para compilar: cada uno corre
    compilar.bat, que hace pdflatex + biber + pdflatex x2 (el orden que pide
    biblatex) y borra la basura intermedia (.aux .bbl .bcf .blg .log .lof .lot
    .out .run.xml .toc) al terminar, dejando solo el .pdf. Probado en esta PC:
    ~20 s por compilacion despues de la primera vez (que baja paquetes de
    MiKTeX y puede tardar varios minutos).
    README actualizado con las instrucciones y el flujo de trabajo nuevo.
2026-08-25 docs: unificar los numeros y arreglar el pasa-altos mal calculado
    Auditoria de consistencia de toda la documentacion (READMEs, docs/ y el
    LaTeX de la tesis) contra el codigo y contra el hardware medido. Se
    corrigen las inconsistencias que cambian conclusiones. Las que son solo
    estado desactualizado quedan para despues (la tesis todavia es borrador) y
    las de codigo quedan anotadas como pendientes al final.
    1. El cambio de BW 750 a 1000 MHz habia quedado a medias.
    - PCM1808_hardware.md: la tabla "T_sweep vs f_beat/m" seguia en 750 MHz
    (3.4 / 50 / 500 / 1000 / 5000 Hz/m) y se contradecia con la formula
    6.67/T_sweep tres lineas mas arriba, en el mismo archivo. Ahora
    4.6 / 67 /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
2026-08-28 adquisicion: que grabarserial hable con gpr_barrido
    Hasta ahora el grabador solo sabia hablar con PCM1808_ESP32C3, asi que
    medir.bat no servia para el radar completo: le mandaba 'off', 'dec' y
    'raf', que en gpr_barrido no existen, y arrancaba con 'bin', que en ese
    sketch solo cambia el formato de salida (la adquisicion la larga 'run').
    Con el GPR armado en el banco eso era un bloqueante.
    protocolo.py
    - configurar_barrido(): manda la secuencia que si entiende gpr_barrido
    (stop / fs / pasos / nmue / sinc / pre / ch / info). Igual que en
    configurar(), lo que se guarda en la metadata es lo que devuelve
    'info', o sea lo que el firmware realmente quedo teniendo: puede
    haber redo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
2026-08-28 Adquisicion alternativa por placa de audio (U-Phoria UMC22)
    Reemplazo TEMPORAL de la etapa de digitalizacion: en vez de PCM1808 + ESP32 por
    I2S, el beat entra por una placa de sonido USB. La cadena de RF no se toca, y
    tampoco se toca adquisicion/, firmware/ ni analisis/: para volver al PCM1808
    alcanza con correr medir.py en vez de medir_audio.py.
    El CSV que escribe grabaraudio.py tiene el formato EXACTO de grabarserial.py, a
    proposito. graficarserial.py lo abre sin cambiarle una linea, asi que espectro,
    osciloscopio y B-scan en vivo siguen andando igual. Ademas se escribe un WAV de
    16 bits con los dos canales crudos, que es el master para el analisis offline.
    Dos cosas que se descubrieron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
2026-08-28 docs: sumar el camino de la placa de audio al contexto compartido
    El documento de arranque no mencionaba adquisicion_audio/, asi que el otro chat
    arrancaba sin saber que existe un segundo camino para digitalizar el beat y
    podia tocar las mismas carpetas sin querer.
    Lo que se agrego:
    - §3, subseccion nueva: que es la UMC22, tabla comparativa contra el PCM1808,
    conexionado (entrada 2 INSTRUMENT, plug TS, divisor 10k/1k1) y las dos trampas
    que ya nos costaron tiempo (WASAPI exclusivo mintiendo la fs, y que sin
    calibrar no hay volts).
    - §4, el arbol del repo, con la aclaracion de que la carpeta no toca
    adquisicion/, firmware/ ni analisis/: para volver al PCM1808 alcanza con
    correr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
2026-08-28 adquisicion_audio: arreglar la eleccion de dispositivo y la medicion de tasa
    Tres cosas que salieron al conectar la UMC22 por primera vez. Las tres daban
    sintomas distintos pero ninguna se veia sin mirar los numeros.
    1. La eleccion automatica de dispositivo prefería la API antes que los canales.
    Windows enumera el MISMO dispositivo una vez por API y no todas ofrecen lo
    mismo: con el driver generico de clase USB, la UMC22 aparecia en WASAPI con
    1 solo canal (el formato compartido esta en mono) y en WDM-KS con 2. Como
    WASAPI esta mas arriba en la preferencia, 'auto' elegia la entrada mono y el
    stream ni abria cuando se pedia beat + sincronismo. Ahora elegir() recibe
    cuantos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
2026-08-28 adquisicion: trocear la FFT por barrido en vez de por bloque arbitrario
    Es el pendiente que veniamos arrastrando desde que el firmware aprendio a
    numerar las rampas, y hoy en el banco se volvio bloqueante: el espectro no
    mostraba absolutamente nada.
    La causa: graficarserial agarraba las ultimas N muestras del buffer (4096
    por defecto) y las transformaba sin mirar donde empieza cada rampa. Con 192
    muestras por rampa eso son ~21 barridos metidos en una sola FFT, con las
    pendientes ALTERNADAS. La subida y la bajada dan el mismo |f_beat| pero la
    fase evoluciona al reves, asi que al sumarlas el pico se destruye y queda
    el piso de ruido. Todo el trabajo de sincronismo del firmware no servia de
    na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
2026-08-28 docs: guia de puesta en marcha de la UMC22 en una maquina nueva
    Hasta ahora lo que sabiamos de la placa estaba repartido entre el README del
    modulo (que explica el diseño) y los mensajes de commit (que explican los
    tropiezos). Para dejarla andando en la otra maquina hacia falta el
    procedimiento, que es otra cosa: que instalar, como configurar Windows, que
    mirar para saber si esta bien, y que hacer cuando no.
    docs/placa_audio_umc22.md tiene eso. Lo que conviene destacar de la guia:
    - El paso de Windows que mas importa es poner el formato en 2 CANALES. Windows
    lo deja en mono por defecto y ahi la placa aparece con 1 solo canal por
    WASAPI, que no alcanza para grabar beat + sincronismo. E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
2026-08-28 docs: aclarar que la FFT por barrido no aplica al camino de audio
    Rebasando sobre 0e96136 ("trocear la FFT por barrido en vez de por bloque
    arbitrario") aparece una interaccion que conviene dejar escrita antes de que
    alguien la descubra en el banco a las tres de la mañana.
    El graficador ahora trocea por el numero de rampa que manda el firmware en una
    tercera columna del CSV. El CSV de audio no la tiene, porque de este lado no hay
    firmware que la genere: la placa de sonido no sabe nada de la rampa. La casilla
    "FFT por barrido" queda sin efecto, y con ella el promedio coherente.
    No rompe nada: el LectorCSV de 0e96136 maneja explicitamente los CSV de dos
    columnas y _troceo_por_rampa() devuel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
2026-08-29 pruebas: sketch aislado para medir la velocidad real del MCP4725
    Primer paso del rediseño: antes de escribir el firmware nuevo hay que saber
    cuanto tarda de verdad una escritura al DAC, porque de ahi sale la relacion
    entre el PRF y la cantidad de escalones, que es la restriccion que gobierna
    todo lo demas.
    Carpeta nueva pruebas/, separada de firmware/ a proposito. En firmware/ vive
    lo que va en la placa cuando el radar anda; en pruebas/ vive lo que se carga
    para contestar una pregunta concreta. Cada sketch prueba UNA sola cosa y no
    depende de nada del repo, asi que cuando algo no cierra el problema esta
    adentro de ese archivo y en ningun otro lado.
    pruebas/velocidad_dac/ mide tres cosas,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
    [velocidad_dac.ino]
2026-08-31 GPRv2: arrancar de cero la adquisicion con el PCM1808
    El firmware anterior (firmware/PCM1808_ESP32C3) llego a 1465 lineas, con mas de
    veinte comandos, Preferences, tres modos de emision y un protocolo binario con
    CRC. Funciona, pero dejo de ser algo que se pueda leer y entender de una
    sentada, y eso vuelve caro cualquier cambio. Esta carpeta empieza de nuevo con
    lo minimo.
    Ademas cambio el hardware: la rampa ya no la genera el MCP4725 sino un generador
    de funciones de laboratorio. El DAC por I2C tardaba ~125 us por escritura, asi
    que la rampa salia en 74 escalones de 14 MHz. Eso convierte al radar en un SFCW
    y le impone un alcance no ambiguo de 5,3 m que no queremos. Es una limitacion
    fisic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
2026-08-31 GPRv2: corrección de no linealidad del VCO por remuestreo + captura CSV
    Agrega la segunda mitad de Anghel et al., "Nonlinearity Correction
    Algorithm for Wideband FMCW Radars" (EUSIPCO 2013, PDF en
    referencias/papers/): el paper estima la no linealidad a ciegas con la
    HAF, pero como ya tenemos la curva medida del VCO (VCO/Caracteristica
    VCO.csv) nos salteamos esa parte y construimos el eje de tiempo
    deformado theta(t) directo de la curva. Validado con blancos sintéticos
    (no linealidad real inyectada desde la curva medida): sin corregir, los
    picos aparecen en posiciones y amplitudes incorrectas; corregidos,
    coinciden con los blancos reales dentro de una celda de resolución
    (~14 cm) y con la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
    [adquisicion.ino, correccion_no_linealidad.py, grabar_rampa.py, waterfall.py]
2026-09-01 GPRv2: sync por GPIO10 y banco de prueba sin RF
    Cierra el paso 1 del roadmap de GPRv2/CONTEXTO.md (leer el sync) y de paso
    deja el sistema entero probable en casa, sin VCO, sin mixer y sin antenas.
    Validado en el banco: los blancos sinteticos a 0.60 y 1.20 m salen corregidos
    a -1.9 cm y -3.8 cm sobre celdas de 14.4 cm, y los picos caen a menos de 2 Hz
    de los 83.2 y 166.4 Hz teoricos. Sin corregir se van 12 y 16 Hz.
    adquisicion.ino: tercera columna con las muestras transcurridas desde el
    ultimo flanco de subida en GPIO10.
    Se guarda el INSTANTE del flanco (esp_timer_get_time desde la ISR) y no un
    contador de muestras. El motivo no es obvio: el DMA entrega 256 tramas de
    golpe y el lazo las pr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
2026-09-01 GPRv2: banco extremo — rampa de 10 ms y senal 11.6 dB bajo el ruido
    Sube el banco de casa a un caso mucho mas duro, para que se parezca a lo que
    va a haber en el laboratorio. La rampa pasa de 50 a 10 ms y el ruido sube
    hasta dejar la senal ENTERRADA en el tiempo: la levantan las ~500 rampas que
    entran en 5 segundos.
    Por que 10 ms y no 250. Se habia pedido "bajar el PRF 5 veces", pero
    f_beat = 2*R*BW/(c*T_rampa) es INVERSA al tiempo de rampa: bajar el PRF baja
    el batido. Con 250 ms el blanco de 0.6 m da 17 Hz y queda debajo del corte de
    19 Hz del pasabajos post-mezclador, o sea que se estaria simulando algo que en
    el laboratorio no se puede medir. Con 10 ms da 416 Hz, comodo.
    Calibracion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
2026-09-01 GPRv2: corregir lo que dice CLAUDE.md sobre el interpolador
    El commit anterior afirmaba que el remuestreo cubico "esta perjudicando" y que
    costaba 2.3 dB frente a interpolacion lineal. Es falso, y lo dejo escrito como
    guia para la proxima sesion, asi que se corrige.
    Medido: el error contra el resultado analitico sobre senal LIMPIA es
    practicamente identico para todos los metodos.
    lineal -8.4 dB pico/piso 7.6 picos 432 / 852
    cubica -8.2 dB pico/piso 5.2 picos 432 / 852
    gauss s=0.5 -8.4 dB pico/piso 9.1 picos 432 / 852
    gauss s=0.7 -7.4 dB pico/piso 13.8 picos 432 / 852
    gauss s=1.0 -5.5 dB pico/piso 22.8 picos 432 / 611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
2026-09-01 GPRv2: anillo de flancos, y grabar.bat grafica solo
    El sync volvia a dar cuentas negativas al pasar a rampa de 10 ms: 2208 sobre
    21121 muestras, y largos de rampa entre 17 y 63 en vez de 40 fijos.
    Es el mismo arreglo anterior, que era incompleto. Se guardaban los DOS ultimos
    flancos, y eso alcanzaba mientras entrara como mucho un flanco por bloque de
    DMA. Con rampa de 50 ms era cierto: bloque de 16 ms contra periodo de 50. Con
    10 ms entran DOS flancos por bloque, el segundo pisa la referencia que
    necesitaban las muestras del principio, y vuelven los negativos.
    Ahora es un anillo de 8 timestamps y una busqueda hacia atras: a cada muestra
    le toca el ultimo flanco anterior a ella, que no tien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
    [adquisicion.ino, graficar_captura.py]
2026-09-01 GPRv2: el eje del espectro va hasta Nyquist, no hasta una constante
    F_MAX estaba clavado en 400 Hz, que era razonable con rampa de 50 ms y blancos
    en 83 y 166 Hz. Al pasar a 10 ms los blancos se fueron a 416 y 832 Hz, o sea
    los DOS afuera del grafico, y el espectro se veia perfectamente liso: parecia
    que no habia senal cuando en realidad estaba fuera de cuadro.
    Ahora F_MAX = None significa "hasta fs/2". Una constante fija esconde los picos
    en silencio cada vez que se acorta la rampa, y ese modo de fallar no avisa.
2026-09-01 GPRv2: volver al par limpio 90/25 para diagnosticar el nivel
    El sync quedo arreglado con el anillo de flancos: 0 negativos y rampas de 40 a
    41 muestras (el 41 es el resonador ceramico del Uno, +-0.5%). Pero el nivel de
    L sigue en ~750 cuentas rms contra las ~300000 que corresponden, o sea los
    mismos 63 dB de deficit, y no cambio al revisar el divisor.
    Se baja el ruido al par 90/25 (SNR crudo +10.1 dB) porque con senal grande y
    limpia el deficit se mide sin ambiguedad. El par 29/98 del caso extremo queda
    documentado en los dos archivos para volver cuando el nivel este resuelto.
    Los dos pares se anotan juntos en generar_tabla_chirp.py y en
    generador_chirp.ino: comparten el rango de 8 bits de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
    [generador_chirp.ino, generar_tabla_chirp.py, tabla_chirp.h]
2026-09-02 GPRv2: primeras mediciones reales - triangular, sync robusto y ancho de banda
    Prepara correccion_no_linealidad.py, graficar_captura.py y waterfall.py
    para las primeras mediciones con el banco real (VCO, mezclador, antenas),
    distinto del banco casero sin RF de Martin (que sigue en sus propios
    valores - ver GPRv2/CLAUDE.md).
    T_SWEEP 10ms -> 20ms: a 10ms sobraba margen frente al corte de 19 Hz del
    pasabajos post-mezclador (el acoplamiento directo a 0,15m ya daba 104 Hz);
    a 20ms el mismo acoplamiento da 52 Hz (3x el corte, comodo) y hay el doble
    de muestras por rampa para el remuestreo cubico.
    SPS_SALIDA 4000 -> 6000 (adquisicion.ino, FS_DEF 16000 -> 48000 para que
    el decimado de exacto): a 20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
2026-09-04 GPRv2: abrir el puerto sin resetear el C3, y ultimo sync mas prolijo
    grabar_rampa.py abria el puerto con serial.Serial(puerto, ...), que afirma
    DTR y RTS a la vez. En el USB nativo del ESP32-C3 esa es la combinacion de
    reset: el chip se reiniciaba, el USB se re-enumeraba y el handle quedaba
    invalido, asi que el write de 'run' fallaba con "El dispositivo no reconoce
    el comando" y la captura se quedaba 5 s leyendo un puerto mudo. Ahora se
    construye el Serial() vacio, se bajan dtr y rts, y recien ahi se abre. El
    sleep post-apertura baja de 2,0 a 0,5 s porque ya no hay arranque que
    esperar, avisa que esta grabando, y si no llego nada lo dice en vez de
    guardar un csv vacio.
    extraer_rampas(): el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
    [correccion_no_linealidad.py, grabar_rampa.py]
2026-09-04 GPRv2: medir sin sync de punta a punta, y radargrama en tiempo real
    El camino sin sync (la triangular muestreada por GPIO3) estaba escrito pero
    cortado por la mitad: grabar_rampa.py juntaba las lineas "#v,..." en una
    lista y nunca escribia datos/triangular.csv, asi que graficar_captura.py
    moria diciendo que no tenia de donde sacar los limites de rampa. Ahora:
    - grabar_rampa.py escribe triangular.csv, y si no llega ninguna linea "#v,"
    avisa (firmware viejo) y BORRA el triangular.csv anterior: dejarlo
    cortaria la captura de hoy con los vertices de ayer, en silencio.
    - Las lineas cortadas por el CDC se filtran con regex en vez de romper
    np.loadtxt despues.
    - waterfall.py tenia el mismo a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
2026-09-04 GPRv2: vivo.py se refresca solo, y sliders de ventana y alcance
    Cuatro cosas que aparecieron al usarlo contra el banco real:
    - La pantalla no avanzaba sola. El timer mutaba los artistas pero nunca
    pedia el repaint, asi que lo unico que despertaba la ventana era mover un
    slider: parecia que andaba pero la imagen se quedaba quieta. actualizar()
    ahora termina siempre en draw_idle(), en un finally para que una excepcion
    adentro del refresco no congele la ventana para siempre.
    - Muy poca resolucion en el eje. La FFT de cada rampa va con relleno x8,
    igual que graficar_captura.py: 120 muestras daban 61 bins para todo el eje
    y salia en bandas gruesas. El relleno NO agrega resolucion (e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
2026-09-04 GPRv2: CLAUDE.md al dia con los sliders nuevos de vivo.py
    El commit anterior cambio el codigo pero no la nota: quedaba describiendo un
    solo slider y sin el draw_idle() ni el relleno de la FFT.
2026-09-04 GPRv2: vivo.py con controles de texto, radargrama vertical y calibracion
    - Los sliders pasan a cuadros de texto, todos en una columna a la izquierda.
    Se tipea el valor y Enter. Lo que no se entiende como numero no se aplica y
    el cuadro vuelve a mostrar lo que de verdad quedo.
    - El radargrama pasa a vertical: distancia en x, tiempo en y, la fila mas
    nueva abajo de todo. Debajo, compartiendo el eje x, la FFT de esa ultima
    fila, para leer el perfil actual con numeros y no solo con color.
    - Calibracion del eje de distancia con dos blancos conocidos. En el banco una
    placa a 1 m aparecia en 4 m: el eje crudo sale de alpha0 = BW/T con la BW
    nominal del VCO y no da. Ahora se toman dos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
2026-09-04 GPRv2: sacar la calibracion falsa que dejo una prueba
    _calibrar() guarda en datos/calibracion_distancia.json, y una prueba
    sintetica lo corrio de verdad: quedo commiteado un a=0.8657 sacado de un
    blanco simulado. Si vivo.py levantaba ese archivo, el eje arrancaba con una
    calibracion inventada y sin decir nada.
    Va al .gitignore porque es estado de un banco y un dia concretos; la que sea
    la buena se conserva con git add -f.
2026-09-04 GPRv2: la triangular llega recortada, y vivo.py ahora lo detecta
    Medido sobre datos/triangular.csv (123 s reales): el 16 % del ciclo llega
    pegado a 4095. Plegando en fase se ve subir lineal, tocar el riel a los
    ~17,5 ms y quedarse ahi hasta los ~22,5. Extrapolando la subida, la
    triangular es de ~5,4 V pico a pico, no de los 3,00 V que asume el codigo:
    la pendiente real es por lo menos 1,8x la asumida.
    Eso descarta que el error de distancia sea la BW (esta medida y son 1 GHz,
    el VCO no puede dar 5) y lo pone donde tiene que estar: alpha0 = BW/T con
    una v(t) que no es la real.
    Importa mas de lo que parece. eje_theta() asume V_MIN..V_MAX a lo largo de
    toda la rampa; si la triangular es mas gr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
    [vivo.py]
2026-09-04 GPRv2: el recorte de la triangular era el divisor desconectado
    Se habia soltado una resistencia del divisor 4k7/4k7, asi que GPIO3 veia la
    triangular entera en vez de la mitad, y todo lo que pasaba de los ~2,5 V del
    ADC se aplastaba contra 4095. Los numeros cierran: para 3,0 V entrando sin
    dividir la saturacion predicha es 16,7 % y la medida 18,1 %.
    Eso mata la hipotesis del commit anterior. Habia calculado la amplitud en
    volts asumiendo el divisor que justamente no estaba, y me dio 5,4 Vpp y un
    factor 1,8x sobre alpha0. Recalculado sin divisor son 2,70 Vpp y 0,90x: el
    generador daba sus 3 V, el barrido es el que creemos y alpha0 esta bien.
    EL ERROR DE DISTANCIA SIGUE SIN EXPLICACION. No e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
2026-09-04 GPRv2: vivo.py con cuadro de info, traza del blanco y triangular a la vista
    Cinco cosas pedidas despues de usarlo en el banco:
    - Cuadro de informacion a la derecha: Tprf y rampa medidos, fs de salida y
    la efectiva del eje theta, BW y V_MIN..V_MAX del barrido, alpha0, ancho de
    bin, alcance no ambiguo, Hz por metro, las tensiones medidas de la
    triangular y el estado del riel del ADC.
    - Traza roja sobre el radargrama siguiendo el pico fila por fila. Las filas
    donde el pico no se despega 3 dB de la mediana salen NaN y la linea se
    corta: con la escala automatica cualquier fila de ruido tiene un maximo, y
    unirlos dibujaria un blanco que no existe. Probado con un blanco
    sintetico al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
2026-09-04 GPRv2: vivo.py mide el fondo y solo informa distancia si hay blanco
    Sin blanco el programa igual informaba una distancia: al normalizar al
    maximo de la pantalla, el eco fijo de la sala sube a 0 dB y aparece un pico
    donde no hay nada. Con la sala vacia, "medir fondo" promedia 3 s y guarda
    ese perfil, y a partir de ahi:
    1. se resta de lo que se mide, asi los ecos fijos salen de la pantalla. Es
    resta en amplitud con piso en cero: lo que se guarda son magnitudes de
    FFT, no complejos, o sea que no hay cancelacion coherente posible.
    2. la referencia de dB pasa a ser FIJA (el pico del fondo) en vez del maximo
    de la pantalla. Eso es lo que arregla la distancia inventada, y de paso
    la es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
    [vivo.py]
2026-09-04 GPRv2: el firmware diezma con filtro antialias de verdad
    Se diezmaba promediando dec muestras, que como antialias es muy pobre: a
    48 kHz con dec 8, un tono de 5 kHz se plegaba sobre 1 kHz atenuado 14 dB y
    uno de 4,5 kHz sobre 1,5 kHz atenuado 10. Todo lo que hubiera entre 3 y
    24 kHz entraba casi sin tocarse, y en la captura del banco hay energia hasta
    el Nyquist mismo, que es la firma de eso.
    Ahora va una cascada de semibandas, una por cada division por dos (48k ->
    24k -> 12k -> 6k). La mitad de los coeficientes son cero exactos y cada
    etapa calcula solo la mitad de las salidas: ~1,3 M multiplicaciones por
    segundo, ~7 % del micro. Rechazo de alias medido:
    f salida promedio de 8 ca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
2026-09-05 GPRv2: el generador estaba en Tprf 80 ms, no 40 - y exposicion de RF
    Dos cosas.
    1) EL PERIODO ESTABA MAL Y ARRASTRO TODO. Releyendo datos/triangular.csv del
    2026-09-04 se lee directo en las muestras crudas: los minimos de la
    triangular caen en 5354,50 / 5434,50 / 5514,50 ms, separados 80,00 ms
    exactos. El generador estaba en Tprf 80 ms, no 40.
    No se noto porque ajustar_triangular() buscaba +-25 % alrededor de 2*T_SWEEP
    = 40 ms. El periodo verdadero quedaba afuera del rango, asi que el ajuste se
    engancho en el SEGUNDO ARMONICO y devolvio 39,999 ms: un numero estable,
    preciso y falso, que vivo.py mostraba con tres decimales.
    Arrastro todo lo que vino despues. Se cortaban rampas de 20 ms sob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
2026-09-05 GPRv2: el desvio de distancia son los cables, y es un offset
    Un FMCW no mide la distancia al blanco: mide la diferencia de retardo entre
    las dos entradas del mezclador. El camino de RX lleva el cable a la antena
    TX, el aire, el cable de vuelta desde la antena RX y el LNA; el del LO lleva
    un cable corto. Esa diferencia se suma al retardo del blanco.
    Y el cable pesa mucho mas de lo que uno espera: un metro de coaxil de VF
    0,66 son 5,05 ns, que el radar lee como 0,76 m de distancia aparente. Con
    3 m por antena y uno corto al LO, el neto son ~5 m = 3,8 m de offset.
    Medido en el banco: con Tprf 80 ms (173 Hz/m) una placa a 1 m daba mas de
    800 Hz = 4,6 m aparentes -> offset 3,6 m -> 4,8 m de coa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
2026-09-05 GPRv2: CLAUDE.md, sacar la seccion que decia que el factor 4 no tenia explicacion
    Quedo contradiciendo a las dos secciones nuevas. Eran dos causas sumadas: el
    Tprf de 80 ms leido como 40 (alpha0 al doble y rampas mal cortadas) y el
    retardo de los cables (~4 m de offset). Este archivo esta justamente para que
    ninguna sesion trabaje con una conclusion vieja.
2026-09-05 GPRv2: documentar el retardo de los cables, con la derivacion y diagramas
    Nuevo GPRv2/docs/retardo_cables.md. Deja escrito de donde sale el offset de
    distancia, que es lo que costo dos dias entender:
    - diagrama en texto de los dos caminos (el del LO corto y el de RF con los
    dos coaxiles y el aire) y del montaje sobre la mesa;
    - la derivacion paso a paso con la notacion del cuaderno: mu = BW/T_rampa,
    D~ = (3/2)*D por el VF del coaxil, D_T = D~ + 2R, f = mu*dt_T. Con los
    numeros del banco da 1833 Hz con cables contra 333 Hz sin ellos: los 6 m
    de coaxil pesan 4,5 veces mas que el blanco;
    - por que es un OFFSET y no una escala, que es lo que explica que "se acerca
    y baja, se aleja y s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
2026-09-08 redaccion: nuevo capitulo sobre retardo y perdidas de cables de RF
    Agrega el Capitulo 7, "Cables de RF: Retardo Electrico, Perdidas y
    Calibracion de Distancia", entre "Filtro Pasabajos" y los apendices.
    Retoma en LaTeX los calculos hechos a mano y verificados en el chat:
    el mezclador ve una diferencia de retardo entre el camino del LO (corto)
    y el de RF (cables a las antenas + aire), no una distancia; ese termino
    de cables se suma directo a la frecuencia de batido y se traduce en un
    offset CONSTANTE de distancia, d_offset = D/(2*VF), reusando la misma
    ecuacion de propagacion v=c/sqrt(eps_r) que ya estaba en el Capitulo 1
    (ahora con label eq:velocidad_medio) aplicada al dielectrico del cable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
2026-09-10 GPRv2: agregar y renombrar mediciones VNA de cables RG213
    Datos crudos del N9923A para RG213 de 1, 2,6 y 3 m (S11 y S12),
    renombrados desde AutoSaveN.csv a nombres descriptivos. Se mueve
    retardo_cables.md a la misma carpeta para agrupar la doc con los datos.
    [RG213_S11_1m.csv, RG213_S11_2.6m.csv, RG213_S11_3m.csv, RG213_S12_1m.csv, RG213_S12_2.6m.csv, RG213_S12_3m.csv]
2026-09-10 GPRv2: caracterizar los cables con el VNA y meter los resultados en la tesis
    Procesa los seis barridos del N9923A de docs/CABLES/ (500-2500 MHz) y
    genera las cuatro figuras del capitulo de cables.
    El equipo exporto solo magnitud, sin fase, asi que no hay retardo de
    grupo. El retardo sale igual del rizado de |S11|: el eco del extremo
    interfiere con el del conector de entrada y ondula la magnitud con
    periodo 1/(2*tau). El cable de 3 m lo confirma solo, con el pico en
    28,53 ns y el segundo rebote en 57,05.
    La atenuacion se ajusta con a*sqrt(f) forzado por el origen. Con el
    ajuste libre el termino constante salia negativo en los tres cables, que
    como perdida de conector no existe. Forzado, los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
2026-09-10 GPRv2: el camino del LO no lleva cable, son 5 cm y se desprecian
    El splitter y el mezclador se conectan directamente. Ese tramo aporta
    0,25 ns = 3,8 cm de distancia aparente, muy por debajo de la resolucion
    de 14,4 cm, asi que L_LO se desprecia y D pasa a ser L_TX + L_RX.
    No es una simplificacion afortunada: L_LO es el unico termino que RESTA
    en D = L_TX + L_RX - L_LO, y no esta restando nada. El cable de antena
    se paga entero.
    Numeros que se movieron, con D = 5,55 m en vez de 5,1:
    d_offset teorico 3,86 -> 4,20 m
    d_offset medido 3,49 -> 3,83 m (ya no depende de ningun supuesto)
    f_offset @ 80 ms 644 -> 701 Hz
    f* total a 1 m 811 -> 868 Hz
    juego nuevo 1,14 ->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
2026-09-11 GPRv2: vivo_rapido.py, el radargrama en vivo a 4x menos costo por cuadro
    vivo.py NO se toca: queda como referencia y como red de seguridad. Los dos
    graban el mismo formato de CSV y comparten datos/calibracion_distancia.json,
    asi que una calibracion tomada con uno sirve para el otro.
    Un refresco de vivo.py costaba 150-206 ms con 200 ms de presupuesto: la
    ventana estaba saturada, el timer se atrasaba, y eso es lo que se ve como
    "va a tirones". Ahora un cuadro cuesta 22 ms de mediana sobre 300 cuadros.
    Lo caro no era la fisica. El remuestreo y las FFT de un cuadro sumaban 6 ms;
    los otros ~145 ms eran matplotlib repintando los 9 cuadros de texto, los 8
    botones, la colorbar y los ticks, que no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
2026-09-14 GPRv2: cables medidos con fase, y por que el RG-58 de 2,6 m esta danado
    Nueva tanda con el FieldFox (QuickCal 2 puertos completa, 801 puntos,
    IF BW 1 kHz, 4 promedios), guardada en Touchstone con los cuatro
    parametros S en magnitud y fase: RG213_A_1m, RG213_B_1m, RG58_3m y
    RG58_2m6.s2p. Los CSV de la tanda anterior, solo magnitud, quedan como
    registro.
    cables_vna.py ahora lee los .s2p: el retardo sale de la pendiente de
    fase de S21 y la respuesta al impulso de S11 complejo. El metodo del
    rizado se conserva para comparar, y coincide dentro de 0,05-0,12 ns.
    cable tau fase VF desvio fase alfa @1 GHz
    RG-213 A, 1 m 4,983 ns 0,669 0,09 deg 0,296 dB/m
    RG-213 B,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
2026-09-14 redaccion: versionar el PDF de la tesis
    El que cambia el .tex lo recompila con compilar.bat y commitea el PDF en el mismo commit, asi el otro lo tiene al dia sin compilar. Excepcion en .gitignore y flujo actualizado en el README. Este PDF incluye el capitulo de cables con la medicion con fase.
2026-09-19 GPRv2: vivo_rapido graba archivos nuevos por corrida y se acuerda de la configuracion
    Cuatro cambios pedidos para seguir midiendo con vivo_rapido.py, que
    dejan vivo.py sin tocar:
    - Cada corrida graba datos/captura_<dd-mm-aaaa_hh-mm-ss>.csv y su
    triangular_<mismo sello>.csv, en vez de pisar captura.csv. Los dos
    llevan el mismo sello para saber cuales van juntos. graficar_captura.py
    y waterfall.py siguen leyendo los nombres fijos: para reanalizar una
    corrida hay que apuntarlos al par que corresponda.
    - La columna de controles se guarda en datos/vivo_config.json (ignorado,
    es por maquina) al aplicar un cuadro, al cambiar el eje y al salir, y la
    corrida siguiente arranca con eso. P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
2026-09-19 GPRv2: la triangular sale con dos lineas, y es el ADC del ESP32
    En el cuadro "Triangular (plegada)" de vivo_rapido se ven dos lineas
    paralelas bien separadas. La sospecha era un problema de sincronismo al
    muestrear la triangular. No lo es.
    Analizada la triangular.csv de una corrida de 425 s (79.770 lecturas,
    ninguna perdida), el residuo contra el triangulo ajustado es bimodal: dos
    grupos a +195 y -190 cuentas. La prueba que descarta el sincronismo es el
    vertice. Una triangular corrida en el tiempo tiene el pico en otro lugar,
    y las dos lineas tendrian que cruzarse ahi. No se cruzan: a 1 ms del
    vertice la separacion sigue entera. Es un offset de valor de ~390 cuentas,
    unos 0,24 V en el pin.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
    [SDS00001.CSV]
2026-09-19 GPRv2: croquis con las medidas de la placa y de la antena
    Estaba en el disco desde hace un tiempo pero nunca entro al repo: el
    .gitignore ignora *.png y hay que agregarlo con -f.
2026-09-19 redaccion: cerrar el capitulo de cables con la medicion con fase
    El capitulo ya tenia las cuatro figuras del VNA, pero quedaban frases
    escritas antes de medir con fase y un recuadro "Pendiente" en lugar de
    una figura. Cambios:
    - Se saca el recuadro vacio del espectro de batido. Esa medicion y la
    calibracion de un punto con cada juego de cables necesitan el radar
    armado, asi que pasan a una subseccion "Mediciones pendientes con el
    radar", con lo que se espera medir: el pico corrido ~2,4 m y ~4,7 dB
    mas de senal. La figura queda como plantilla comentada en el .tex.
    - Seccion nueva "Conclusiones del capitulo", con cinco puntos.
    - Frases que habian quedado viejas: el VF "a confirmar" y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
2026-09-21 GPRv2: la rampa del banco es de 50 ms (Tprf 100 ms), no de 20
    Todas las ultimas mediciones se hicieron con el generador en Tprf 100 ms:
    50 ms de subida y 50 de bajada. T_SWEEP pasa de 20e-3 a 50e-3.
    - correccion_no_linealidad.py: T_SWEEP = 50e-3. El comentario viejo
    descartaba los 50 ms por el corte de 19 Hz del pasabajos; con los cables
    puestos todo el eje se corre 1,46 m y el acoplamiento cae en 223 Hz.
    - generar_tabla_chirp.py: tiene su propio T_RAMPA = 10e-3. Importaba el
    T_SWEEP compartido, que es del otro banco, y habria generado una tabla de
    800 valores para el Uno de Martin (que corre a 160).
    - verificar_rapido.py: casos de 100 ms. El ajuste da -17 ppm, igual que a
    80 ms.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
2026-09-21 gitignore: versionar las capturas PNG del banco
    El *.png global tapaba GPRv2/datos/capturas/, asi que las capturas de
    vivo_rapido.py (boton "guardar captura PNG") nunca se subian y las de la
    placa a 1 m quedaron solo en la PC del banco. Ahora entran; los CSV de
    las corridas siguen afuera.
2026-09-21 GPRv2: simulaciones MEEP de la placa metalica (simular.bat)
    Recrea la medicion de las bocinas contra una placa, con los cables y el
    procesamiento del banco. Doble click en GPRv2/simular.bat: los parametros
    (distancia, ancho de la placa, hueco entre bocas, cables, tau interno,
    resolucion) se cambian arriba del .bat.
    - escena.py (WSL, env meep): FDTD 2D de banda ancha de las dos bocinas y
    la placa -> H(f) sonda TX -> sonda RX, mas tres fotos del campo.
    - radar.py: H(f) + S21 medido de los RG-213 + tau interno -> batido
    1/2 Re{H(f(t))} con la rampa de 50 ms y la curva real del VCO -> el mismo
    pipeline de analisis/ que vivo_rapido.
    - correr.py: figura con la escena y el espectro en Hz, co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
2026-09-21 docs: diagramas de llamadas y de bloques del software
    Generadores (GPRv2/docs/diagrama_llamadas.py y bloques_software.py) y lo
    que producen en redaccion/figuras/codigo y redaccion/figuras/software:
    fuentes .dot y figuras ya renderizadas (.pdf/.png, agregadas con -f como el
    resto de las figuras de la tesis). Todavia no se usan en el .tex.
2026-09-22 GPRv2 simulacion: carpeta por corrida, sonda adaptada y COMO_FUNCIONA.md
    - simular.bat: NOMBRE elige la carpeta salidas\<NOMBRE>\ (vacio = nombre
    automatico con los parametros), y parametros nuevos TPRF_MS y SONDA.
    - correr.py: la escena y la FFT van en imagenes separadas (escena.png,
    espectro.png). Picos C2 y CD identificados con el barrido; el panel los
    ordena por frecuencia y solo rotula maximos locales de verdad.
    - barrido.py: la figura compara la pendiente simulada con 4B/(c*Tprf)
    (138,2 contra 138,6 Hz/m, a = 0,997).
    - SONDA = adaptada: la guia sigue sin corto hasta el PML, que hace de carga
    de 50 ohm. D cae de -4 a -30 dB; el offset de las bocinas pasa de 0,658
    a 0,588 m.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
2026-09-22 gitattributes: los .bat se sacan con CRLF
    En el repo siguen en LF, pero cmd.exe con finales LF puede errarle a los
    saltos a etiquetas (goto / call :etiqueta), que simular.bat usa.
2026-09-22 GPRv2: capturas PNG de la placa a 1 m y a 3 m
    Las seis capturas de vivo_rapido.py del 2026-09-18 (placa a 1 m y a 3 m,
    cada una con fondo medido, sin fondo y el fondo solo). Habian quedado
    solo en esta PC porque el *.png global del .gitignore las tapaba; desde
    fe67814 las capturas del banco se versionan, asi que entran ahora.
2026-09-22 gitignore: todo redaccion/ se sube siempre, PDF y figuras incluidos
    El *.png / *.pdf / *.svg global solo tenia excepcion para
    tesis_gpr_fmcw.pdf, asi que cada figura nueva de la tesis habia que
    forzarla con git add -f. Las 54 que hay estan subidas porque alguien se
    acordo de forzarlas una por una; la proxima que alguien se olvide, el .tex
    no compila en la otra maquina y nadie se entera hasta que falla.
    Ahora redaccion/**/*.png, *.pdf y *.svg tienen excepcion, y la lista de
    figuras forzadas del comentario se achica a las de afuera de redaccion/.
    redaccion/README.md y docs/contexto_para_claude.md dicen lo mismo, que era
    donde estaba escrita la regla vieja.
    De paso se ignoran las salidas de L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
2026-09-22 GPRv2: generador de triangular analogico, paso 1 en LTspice
    Primer paso para reemplazar el generador de laboratorio (SDG830) por un
    circuito propio: Schmitt + integrador, la topologia del PWM de Circuitos II
    llevada a ~10 Hz. PWM.asc es el original de esa materia, como referencia.
    triangular.asc: TL072 con 12 V y VCC/2 de referencia, R3 13k para ~3 Vpp,
    C 2,2 uF y R1 = 8k2 + pote de 100k (Bourns 3590) con .step de la
    posicion. Una fuente B con ddt(V(tri)), fuera del circuito, da la
    pendiente para medir la linealidad; los .meas informan periodo,
    asimetria, Vpp, niveles de la cuadrada, duracion del flanco, no
    linealidad y redondeo del vertice.
    Resultados con el modelo TL072 (1989): periodo d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
2026-09-22 GPRv2 simulacion: bocina con las medidas reales y retardo interno de 4 ns
    - mediciones/: carpeta nueva para las medidas fisicas del banco. El croquis
    pasa de medidas.png a mediciones/mediciones_antena.png, y el README lo lee
    cota por cota: todo medido por fuera, bocina de chapa, guia recta de
    33,5 cm y flare de 19 (el 29,5 era el soporte de PVC).
    - La bocina se simula con la cara interior en (medida - chapa): guia de
    17,8 cm por dentro (antes 17, con las paredes centradas en la cota). Cada
    sonda en su lugar (5,9 y 5,4 cm del fondo). Las medidas se cambian desde
    el bloque "La bocina" de simular.bat, en cm y por fuera.
    - TAU_INTERNO = 4 ns por defecto, ajustado contra captura_1m_cf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
2026-09-22 GPRv2: la FFT de cada captura a CSV, y todos los datos al repo
    Tres cosas que van juntas: poder sacar la curva de una captura, que los datos
    dejen de quedarse en una sola maquina, y que una corrida larga no rompa el
    push.
    1. LA FFT DE CADA CAPTURA, EN CSV
    Junto a cada PNG el boton de captura (tecla 's') guarda ahora
    datos/capturas/<nombre>.csv con la curva de la FFT que se esta viendo, para
    poder superponerla con simulaciones_meep/ (misma cadena: Hann, relleno x8,
    eje en Hz con la distancia aparente sin calibrar) o con otra captura, sin
    digitalizar la figura.
    Es SOLO la curva de ese momento: ni el promedio de la ventana ni el fondo,
    que serian otras curvas. Seis columnas -- f_hz, d_crudo_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
2026-09-23 GPRv2: el generador de triangular ya da 0 a 3 V y el sync del ESP32
    triangular2.asc agrega al oscilador las dos etapas que faltaban, y el
    esquematico pasa a estar dibujado con cables y no solo con etiquetas:
    - U5, restador: salida = tri - 6 V + 1,56 V, o sea 0 a 3,1 V. Los 1,56 V
    salen de los 12 V por R10, asi que el piso no se mueve si varia la
    fuente. R3 pasa a 12k para que la triangular interna de 3,07 Vpp.
    - U6, buffer del sync: divisor 300k/100k de alta impedancia para no
    cargar al Schmitt, y 3,00 V en alto contra los 2,48 V que pide el
    GPIO10 del C3. En bajo, 1 mV contra 0,83 V.
    - Los operacionales son el UniversalOpAmp2 de LTspice con los numeros del
    TLC2262 (DIP, salida ra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
2026-09-23 GPRv2: el espectro de la triangular, en hertz y de dos lados
    El eje iba en armonicos de f0, que servia para comparar las tres filas
    entre si pero obligaba a traducir mentalmente a frecuencia. Ahora va en
    hertz y llega al armonico 15 de cada fila, asi que la escala cambia de
    una fila a la otra (los periodos difieren 13 veces) pero los numeros son
    los de verdad.
    Y se dibuja de dos lados: la mitad negativa es la imagen de la positiva,
    asi la continua queda como una sola delta en el cero, en el medio del
    grafico, que es donde se la ve. Cada armonico ya valia A/2 en este lado,
    que es lo que le toca a cada mitad del par, asi que no hay que reescalar
    nada: la continua da 2,5 veces la fundamental y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
2026-09-23 GPRv2: el espectro vuelve a dB, con el mismo eje de frecuencia en las tres filas
    En magnitud lineal no se veia nada arriba del tercer armonico (el 5 vale
    0,04 y el 7 ya es 0,02), asi que la cola -- que es justo donde se notaria
    un defecto de la triangular -- quedaba aplastada contra el cero.
    El eje de frecuencia pasa a ser el MISMO en las tres filas, 200 Hz. Antes
    llegaba al armonico 15 de cada una, o sea que cambiaba de escala de fila
    en fila y no se podian comparar. Con 200 Hz entran el tercer armonico de
    la fila rapida (160 Hz) y 24 armonicos de la lenta, cuya cola se hunde
    abajo del piso a los 130 Hz: se ve de una que la misma banda contiene
    muchas mas rayas cuanto mas lento es el barri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
2026-09-23 datos: subir las mediciones que quedaban en esta maquina
    Con la politica nueva (587eff3, "todos los datos al repo") estos archivos
    dejaron de estar ignorados, pero seguian sueltos en la PC de Martin. Son
    266 MB:
    - GPRv2/datos/: las cinco corridas del 2026-09-18 con sus triangulares,
    la captura y la triangular de nombre fijo, el PWL del PWM y el stream
    crudo del experimento de las tres lecturas del ADC.
    - datos/: trece capturas de agosto, de la etapa anterior (adquisicion/).
    - Dos figuras sueltas: GPRv2/analisis/vivo_test3.png y
    GPRv2/docs/VCC/fft_vcc.png.
    El archivo mas grande es captura_18-09-2026_19-11-39.csv, 47 MB, abajo
    del limite de 100 MB de GitHub.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
    [2026-08-15_042442.csv, 2026-08-15_044217.csv, 2026-08-18_180500.csv, 2026-08-18_181135.csv, 2026-08-18_185759.csv, 2026-08-18_190037.csv, 2026-08-18_190338.csv, 2026-08-18_190753.csv]
2026-09-23 GPRv2: el generador de triangular con un operacional real, el TLC2272
    triangular3.asc es triangular2 con los cinco operacionales cambiados por el
    modelo de TI del TLC2272 (SLOJ080), que se consigue en DIP (TLC2274 + TLC2272).
    Solo converge con method=gear y startup en el .tran. Es la version corta: los
    dos extremos del pote y 1,5 s.
    graficar_triangular3.py arma la misma figura que la 2, sobre una corrida de
    3 posiciones x 6 s. Aparece un 2do armonico a -48 dB en pos 0 que el modelo
    ideal no tenia.
2026-09-23 GPRv2: los .raw de LTspice pasan a versionarse
    Se saca la regla *.raw del .gitignore y se suben los .raw de docs/PWM
    (triangular, triangular2, triangular3 y triangular3_figura). El mas grande,
    triangular.raw, pesa 53 MB: GitHub advierte pero lo acepta.
2026-09-24 GPRv2: esquematico y PCB en KiCad del generador de triangular, con zener de proteccion
    - pcb/triangular/: proyecto KiCad 10. Dos TLC2274 repartidos por funcion
    (U1: integrador, Schmitt y sync; U2: referencia de 6 V y restador),
    resistencias E12 al 1 % (las que faltan en E12 van en serie), RV1 comun
    de 16 mm en paralelo con J1 (bornera al Bourns 3590S) para probar.
    - simular_kicad.py/.bat: exporta el netlist del esquematico con kicad-cli
    y lo simula en LTspice con los modelos del TLC2272 y del zener.
    - D1 = 1N4729A (3,6 V) en la salida: protege al VCO (18 V max, el
    amplificador x4,95 va a 20 V). Con R9 abierta la salida iria a 10 V y D1
    la clava en 3,31 V. El 1N4728A (3,3 V) recor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
    [triangular.kicad_pcb, triangular.kicad_sch]
2026-09-25 GPRv2: PCB del generador de triangular terminado
    - Esquematico: 2 TLC2274 repartidos por funcion (U1: integrador, Schmitt y
    sync; U2: 6 V y restador); las 3 unidades que sobran van como seguidor con
    la + a GND, asi mid no cruza la placa.
    - SW1: llave palanca SPDT (LP-SW-213CI) de encendido en los 12 V, con LED
    rojo 5x5 (D2 + R17 2k2, ~4,7 mA). Se descarto el PULS-2I-RET: medido, su
    comun es un extremo de cada fila, no la pata del medio.
    - JP1: puente de cable a 22,5 mm en la salida, antes de D1.
    - triangular.pretty + fp-lib-table: huellas propias (llave a 4 mm con pads
    angostos, puente de 22,5 mm y el pulsador 8x8 por si se vuelve a usar).
    - simular_kicad.py: detecta solo los opera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
    [triangular.kicad_pcb, triangular.kicad_sch]
2026-09-25 GPRv2: PCB de la triangular, version final revisada
    - Pista de +12V separada del pad de GND de R5 (estaba a 0,2 mm) y zona GND
    recalculada: el relleno viejo tocaba esa pista (corto de 12 V a masa).
    - Zona GND con alivios termicos y ancho minimo de 0,5 mm.
    - Revisado: DRC con paridad contra el esquematico sin errores, redes de los
    pads iguales al circuito, y los 19 elementos de triangular3.asc con su par
    exacto en la placa.
    [triangular.kicad_pcb]
2026-09-25 tesis: capitulo del generador de triangular y apendice de valores
    Capitulo nuevo entre el del VCO y el del filtro (motivacion, topologia,
    eleccion del operacional, resultados de simulacion, proteccion del VCO,
    PCB y mediciones pendientes) mas un apendice de valores de componentes
    pensado para ir sumando circuitos, no solo este.
    La motivacion son dos cosas: el SDG830 no da sync, y ata el banco a la
    red. El objetivo es que todo se alimente de un powerbank, con la fuente
    boost + LDO dando los 12 V de este generador y los 20 V del amplificador
    del VCO.
    Todos los numeros del capitulo se verificaron contra el repo o se
    volvieron a simular, y tres del resumen de la sesion anterior estaban
    mal:
    -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
2026-09-28 GPRv2: vivo_rapido.bat no depende mas del venv gpr-win
    En una maquina sin ese venv el .bat moria antes de abrir el puerto, y el
    mensaje terminaba en "el ESP32 es un puerto COM y WSL 2 no lo ve": parecia un
    problema de la placa. Paso en el laboratorio el 28/09, con el ESP enchufado y
    andando.
    Ahora, si no encuentra el venv, prueba py.exe y los Python del PATH y usa el
    primero que pueda importar serial, numpy, scipy, pandas y matplotlib. Se
    prueba importandolos de verdad, que es la unica forma honesta de saber si
    sirve: en esta maquina `where python` devuelve tambien el stub de Microsoft
    Store, que no tiene nada. Probado: elige py.exe.
    El mensaje de error, si no encuentra ninguno, ahora acla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
2026-09-28 GPRv2: capturar con temporizador, con cuenta regresiva a la vista
    Cuadro `esperar [s]` nuevo en la columna de controles. En 0 la captura sale en
    el acto, como venia; con 5, 10 o lo que se tipee, el boton (o la tecla `s`)
    arranca una cuenta regresiva y la foto sale al final. Es para apretar, caminar
    hasta el blanco y que la figura salga con uno ya fuera del camino.
    - Mientras corre, un cartel rojo grande sobre el radargrama dice CAPTURA EN
    N s, para poder leerlo desde donde uno este parado, y el texto de estado
    repite cuanto falta. El cartel va ARRIBA del radargrama, o sea sobre las
    filas mas viejas: no tapa lo que esta entrando.
    - Apretar de nuevo CANCELA. Es lo primero que uno intent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
2026-09-28 GPRv2: por defecto no se graba la corrida entera, solo lo que se captura
    GRABAR_CRUDO = False. No se crea ningun archivo de corrida (ni vacio) y de una
    sesion queda solo lo que se guarda con el boton de captura: su PNG y su CSV de
    FFT, que salen de los perfiles que estan en memoria. La captura cruda son
    4,1 MB por minuto y se hacia pesada en disco y en git.
    Lo que se pierde, y esta dicho en el codigo, en CLAUDE.md y en el panel: sin
    el crudo esa medicion NO se puede volver a analizar con graficar_captura.py ni
    waterfall.py, ni reprocesar con otro Tprf. Queda la figura y la curva del
    momento en que se apreto, nada mas. Con GRABAR_CRUDO = True vuelve todo como
    estaba, partes de 90 MB incluida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
2026-10-01 GPRv2: la pared del laboratorio entra a la simulacion MEEP
    Bloque dielectrico (eps 5) a 1,26 m de la boca de las antenas, medido el
    2026-09-28, en las escenas con y sin placa: se cancela al restar el vacio.
    La simulacion no deja poner la placa contra la pared ni detras de ella.
    espectro.png rotula solo el eco de la placa y pierde el panel de texto.
2026-10-01 GPRv2: mediciones de la placa a 70, 80, 90, 100 y 120 cm (2026-09-28)
    Capturas de vivo_rapido (PNG + CSV de la FFT) con fondo sin medir (cf) y
    con fondo congelado (sf), y las corridas crudas de esa sesion.
    [captura_28-09-2026_17-37-12.csv, captura_28-09-2026_17-42-57.csv, captura_28-09-2026_17-53-18.csv, captura_28-09-2026_17-53-54.csv, placa_100cm_cf.csv, placa_100cm_sf.csv, placa_120cm_cf.csv, placa_120cm_sf.csv]
2026-10-01 GPRv2: curva distancia-frecuencia, banco contra MEEP
    comparar.py superpone una captura con la simulacion de su corrida.
    relevar.py saca el pico de cada captura de la placa, lo pone al lado del
    simulado a la misma distancia y ajusta f = m*d + f0: medido (cf) 135,7
    Hz/m y 372 Hz, simulado 139,1 Hz/m y 367 Hz, contra 138,6 Hz/m del ideal.
    El offset se muestra como cables (VNA, medido) + bocinas y electronica
    (sin separar: el retardo interno se ajusto sobre el modelo de la bocina).
    Barrido MEEP a las distancias medidas en salidas/mediciones_2026-09-28/.
    [relevamiento.csv]
2026-10-05 tesis: capitulo de procesamiento de la senal de batido, sin el DAC
    Capitulo nuevo (redaccion/procesamiento.tex): diezmado con semibanda,
    sincronismo por software a partir de la triangular, inversion de las
    bajadas, remuestreo en theta, ventana y FFT por rampa de 50 ms, promedio
    incoherente contra coherente y magnitud contra potencia, fondo, puerta
    de deteccion y pico sub-bin. Figuras de Monte Carlo generadas por
    docs/promedio_rampas.py.
    El DAC MCP4725 ya no se usa: arquitectura, fundamentos y generador de
    triangular actualizados; la predistorsion queda marcada en desuso y se
    agrega la seccion de la correccion actual por remuestreo. Diagrama en
    bloques regenerado con el generador externo y l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
2026-10-07 docs: presentacion de avances del TPP con la plantilla FIUBA
    avances_gpr.pptx (21 diapositivas): sistema, banco, procesamiento y
    resultados del 28/09 contra MEEP, con notas del orador. Se arma con
    armar_presentacion.py sobre plantilla_fiuba.pptx (las cinco diapositivas
    de formato de la facultad) y toma las figuras de la tesis y de las
    simulaciones. Marca lo que cambia con la placa del generador propio.
2026-10-19 VCO: segunda caracterizacion (2026-10-19) para ver repetibilidad
    Se volvio a medir la curva Vin -> f del VCO, de 0 a 3,3 V cada 100 mV,
    para saber si la de agosto sigue valiendo. La correccion de no linealidad
    por remuestreo depende entera de esa curva, asi que si el VCO cambio hay
    que saberlo.
    Esta vez la frecuencia sale del contador del analizador (resolucion de
    10 kHz, contra 1 MHz de redondeo en agosto) y Vin se midio con
    multimetro. Temperatura ambiente: 15 grados C (la de agosto no se
    anoto). De 0,9 a 2,0 V quedo una segunda pasada: la primera se hizo sin
    medir Vin y en esa zona la diferencia con agosto parecia error de la
    fuente; con Vin medido la diferencia sigue.
    Resultado (compar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
2026-11-02 GPRv2: mediciones del generador de triangular con LM324, analisis y simulacion
    - SDS00001-3.CSV: capturas del osciloscopio (CH1 triangular, CH2 sync) con el
    pote al minimo, a ~100 ms y al maximo. analizar_mediciones.py calcula
    periodo, simetria, no linealidad y la FFT contra una triangular ideal del
    mismo periodo y amplitud (fft_medida_vs_ideal.png, forma_y_linealidad.png,
    ciclo_anomalo.png, mediciones_triangular.json).
    Resultados: 20,0 a 274,9 ms; 0,24-3,20 V; sync 49,3 %; armonicos 1, 3, 5 y 7
    a menos de 1 dB de la ideal; 2do armonico -37 dB por la asimetria; salto de
    ~35 mV en ~0,95 V a confirmar (osciloscopio o salida del LM324); 2 de 6
    ciclos cortos con el pote al maximo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
2026-11-04 GPRv2: reorganizacion de docs/PWM y Max Hold de la salida del VCO
    docs/PWM/ se ordena en tres carpetas para no perderse: simulacion/ (los
    .asc con sus modelos al lado, porque los simbolos traen el SpiceModel sin
    ruta), pcb/ (el proyecto KiCad, que estaba en pcb/asdasd/) y mediciones/
    (una carpeta por tanda). README.md explica cada cosa.
    - mediciones/2026-11-02_tanda1 y _tanda2: osciloscopio de la triangular con
    LM324. analizar_mediciones.py toma la carpeta como argumento. Las
    "conmutaciones antes de tiempo" eran huecos en el registro del
    osciloscopio a >= 100 ms/div (huecos_registro.png).
    - mediciones/2026-11-02_vco_maxhold: salida del VCO en Max Hold con el
    SSA3032X. analizar_vco_m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
2026-11-04 GPRv2: simulacion MEEP de los armonicos del VCO contra las capturas del 28-09
    simulaciones_meep/armonicos/ extiende la corrida de Santiago (placa a
    0,7-1,2 m con la pared) sin tocar sus archivos: parametros, escena y radar
    son copias, con lo que cambia anotado arriba, asi queda el historial de como
    se fue simulando. MEEP 2D de banda ancha (0,9-6,25 GHz, resolucion 50),
    sonda adaptada y en corto; los .npz van al repo porque rehacerlos cuesta
    ~12 min de FDTD.
    sintesis.py lleva el batido de punta a punta: triangular (SDG830 ideal o
    LM324 medida / LTspice), curva del VCO, fundamental y 2o armonico del Max
    Hold, 3o como parametro, mezclador multiplicador o conmutado, filtro
    post-mezclador G=1, P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
2026-11-04 redaccion: plan de TPP (tex, pdf, figuras y bibliografia)
2026-11-05 tesis: seccion de distorsion armonica del VCO
    Nueva seccion 5.6 al final del capitulo del VCO:
    - la medicion en Max Hold del SSA3032X (fundamental 988-1991 MHz, 2o
    armonico desde 1976 MHz a -8 dBc), con la pantalla y las trazas;
    - el desarrollo de que sale del mezclador con armonicos en el LO y en el
    eco: solo el armonico n con el n llega a banda base, como un fantasma
    en n*f_b (placa a 1 m: 509 Hz -> 1018 y 1527 Hz);
    - por que no se corrige en banda base y los requisitos del filtro de RF:
    antes del splitter, atenuacion en 2f paso a paso (tabla con Delta G_2
    pesimista y simulado) y el tramo contaminado de la rampa que absorbe la
    ventana de Hann. Resumen: pasar hasta 2 GHz y atenu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
2026-11-06 plan TPP: secciones 1 y 2 escritas y desarrollo por subsistemas
    Se completan el objeto, los objetivos (general y particulares), el area,
    la motivacion, el contexto del proyecto (prototipo de Joaquin Rana, con
    su tesis en curso citada) y el marco normativo, ahora solo con lo que
    rige en la Argentina (ENACOM, Res. 202/95 y Res. 530/2000): las normas
    de emision de ETSI y FCC se sacaron porque no aplican aca.
    En la seccion 3 se escribieron el principio de funcionamiento, el
    enfoque, la caracterizacion de la cadena de RF y la simulacion
    electromagnetica. La 3.1 se reorganizo por subsistemas, con la
    simulacion entre los primeros para que no se lea como una validacion
    hecha al final. El desarrollo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
2026-11-06 plan TPP: generacion, filtrado, adquisicion y procesamiento
    Se escriben las subsecciones de generacion del barrido, filtrado,
    adquisicion y procesamiento. Ninguna dice como se implementa cada
    bloque (sin DAC, circuito analogico ni modelos de ADC): el plan fija la
    funcion y los requisitos, y la alinealidad del VCO se deja para el
    procesamiento.
    El filtrado se plantea como un analisis en dos puntos, banda base y
    RF, porque todavia no se sabe si hara falta un filtro de RF para los
    armonicos. El diagrama suma el bloque "Filtrado RF" despues del PA y
    antes del divisor (asi limpia tambien los armonicos del PA y la senal
    del LO), y el de abajo pasa a "Filtrado banda base". El filtro no es
    de Rana: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
2026-11-06 plan TPP: contexto sin el laboratorio ni el "en curso" de Rana
    El contexto ahora dice solo "en la Facultad de Ingenieria" y ya no
    aclara que la tesis de Rana esta en curso: para cuando se entregue el
    plan probablemente ya este terminada. Por lo mismo se saca "en curso"
    del tipo de la entrada Rana2026 del .bib.
2026-11-06 GPRv2: triangular con el Tektronix y zero span del VCO (2026-11-06)
    - Tektronix TBS1102B a 0,5 V/div, 20 / 100 / 273 ms: triangular de 0,12 a
    3,06 V con 0,1-0,3 % de no linealidad. El ~1 % y el escalon de 0,95 V del
    Siglent eran del osciloscopio. analizar_tektronix.py arma una figura por
    captura.
    - Zero span con el SSA3032X cada 25 MHz, disparado por el sync: el VCO barre
    985 a 1999 MHz, subida 50,5 ms y bajada 49,4 ms, df/dt de ~14 a ~27 MHz/ms
    y hasta ~78 MHz de desvio de una recta. El 2o armonico del vertice de abajo
    aparece en 1975-1995 MHz a ~-8 dBc. analizar_zerospan.py deja los puntos en
    zerospan_puntos.csv (base del mapa theta).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
